irec-duster/RORO/README.md

# Project RORO

RORO is the rocket project of the swiss team DUSTER participating at the 2017 IREC rocket competition.
