irec-duster/RORO/payload/Notes/notes.txt

CBRK_AIRSPD_CHK set to max value (not to look for airspeed)
CBRK_USB_CHK set to max value
CBRK_IO_SAFETY set to max value to disable the safety switch for arming

Building the JSBSIM xml model of the plane

http://jsbsim.sourceforge.net/aeromatic2.html

Carbon Fibre lamination test

1) Sample 1 - soacking 4 times with absorber sheet
Initial conditions:

After lamination:

2) Sample 2 - soaking 2 times with absorber sheet

Initial Conditions
layer 0.3
perimeter 2
top 3
bottom 3
inflill 10%
weight 25.6 g

After lamination
