irec-duster/RORO/iac-paper/abbr.tex

\newglossaryentry{COTS}{%
name={COTS},%
description={Commercial Off The Shelf}%
}
\newglossaryentry{IREC}{%
name={IREC},%
description={Intercollegiate Rocket Competition}%
}
\newglossaryentry{UWB}{%
name={UWB},%
description={Ultrawide Band}%
}

\newglossaryentry{FEM}{%
name={FEM},%
description={Finite Element Method}%
}

\newglossaryentry{CNC}{%
name={CNC},%
description={Computer Numerical Control}%
}

\newglossaryentry{AGL}{%
name={AGL},%
description={Above Ground Level}%
}

\newglossaryentry{IB}{%
name={IB},%
description={Interface Board }%
}

\newglossaryentry{PB}{%
name={PB},%
description={Power Board}%
}
\newglossaryentry{SAW}{%
name={SAW},%
description={Surface Acoustic Waves }%
}
\newglossaryentry{AD}{%
name={AD},%
description={Avionic Drawer }%
}

\newglossaryentry{AR}{%
name={AR},%
description={Avionic Rack }%
}

\newglossaryentry{GNSS}{%
name={GNSS},%
description={Global Navigation Satellite System}%
}
\newglossaryentry{RTK}{%
name={RTK},%
description={Real Time Kinematic }%
}
\newglossaryentry{IMU}{%
name={IMU},%
description={Inertial Measurement Unit }%
}
