irec-duster/RORO/Avionics_RORO/RORO_Avionics_PCB_.docx

Interface board 3: lost capacitor C23 (automotive grade with conductive epoxy).

/!\ It seems that all the capacitor of this type are not well soldered. So one should replace them!!!
