irec-duster/RORO/Avionics_RORO/Altium/Project/Rocket_PCB_Project_2017/Project Outputs for Rocket_PCB_Project_2017/Rocket_PCB_panelized/Interface_board_Board Stack Report.pdf

Layer | Board Layer Stack | Name | Material | Thickness

# Board Stack Report

Stack Up | Layer Stack

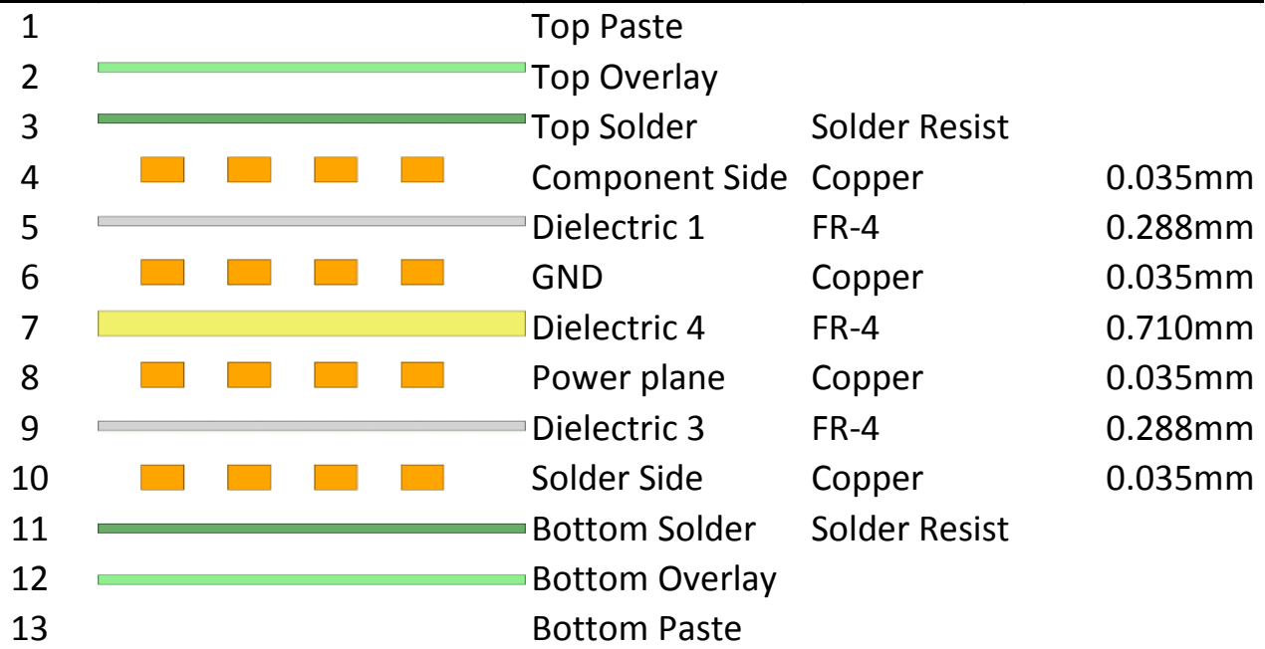
[picture p22: figure]
Top Paste; Top Overlay; Top Solder; Solder Resist; Component Side Copper; Dielectric 1; GND; Copper; Dielectric 4; Power plane; Dielectric 3; Solder Side; Bottom Solder; Bottom Overlay; Bottom Paste
