irec-duster/RORO/Avionics_RORO/Altium/Project/Rocket_PCB_Project_2017_Power_board/Project Outputs for Rocket_PCB_Project_2017_Power_board/Report Board Stack/Power_board.xls

Board Stack Report
Stack Up |  | Layer Stack
Layer | Board Layer Stack | Name | Material | Thickness | Constant
1 |  | Top Paste
2 |  | Top Overlay
3 |  | Top Solder | Solder Resist | 0.010mm | 3.5
4 |  | Component Side | Copper | 0.036mm
5 |  | Dielectric 1 | FR-4 | 0.200mm | 4.5
6 |  | GND | Copper | 0.018mm
7 |  | Dielectric 2 |  | 1.100mm | 4.5
8 |  | Power plane | Copper | 0.018mm
9 |  | Dielectric 3 | FR-4 | 0.200mm | 4.5
10 |  | Solder Side | Copper | 0.036mm
11 |  | Bottom Solder | Solder Resist | 0.010mm | 3.5
12 |  | Bottom Overlay
13 |  | Bottom Paste
 | Height : 1.626mm
