irec-duster/RORO/Avionics_RORO/TI simulation/export altium/Altium/2017-01-30_01-57-51/readme.txt

 

**********************************************************
*************  Important Instructions Follow  ************
**********************************************************
 
All files exported to: Z:\\48\\75\\4875907\\6\Altium\2017-01-30_01-57-51\2017-01-30_01-57-51

**********************************************************
***************** Schematic Instructions  ****************
**********************************************************

To import your new Schematic into Altium:

1. Unzip the downloaded folder files to a local directory and
Start the Altium program.
2. From the menu select "File"->"Open".
3. Select the file named in the path above ending with ".schdoc"
and "Open" the file.
4. Your Schematic should be viewable within Altium now.

For additional information, please visit this site:
http://www.accelerated-designs.com/help/Altium_BrdSch_import.html

**********************************************************
*******************  PCB Instructions  *******************
**********************************************************

To import your new BOARD into Altium:

1. Unzip the downloaded folder files to a local directory
	and Start the Altium program.
2. From the menu select "File"->"Open".
3. Select the file named in the path above ending with ".pcbdoc"
and "Open" the file.
4. Planes will need to be repoured to update the Copper Pour Polygons
	a. Once your board is loaded, select the Tools menu from the
	   top Menu Bar
	b. Scroll to the Polygon Pours item on the Tools Menu.
	c. The Polygon Pours item should expand to show more options
	d. Select Repour All Polygons, this will repour all of the
	   polygons.
5. Your board should be viewable within Altium now.

For additional information, please visit this site:
http://www.accelerated-designs.com/help/Altium_BrdSch_import.html

**********************************************************
*******************  LIB Instructions  *******************
**********************************************************

To import your new LIBRARY PARTS into Altium follow these steps:

1. After running the Ultra Librarian export for the first time,
you will need to copy the following files into an area where
they can be accessed for all future translations.  They are script
files that Altium will need to be able to find.
	a. UL_Form.dfm
	b. UL_Form.pas
	c. UL_Import.pas
	d. UL_Import.prjScr
2. The above script file will need to be run from within Altium.
This can be done by going to File, Open and selecting the
UL_Import.PrjScr file stored above.
3. Select the "DXP" dropdown menu in the top-left corner runfrom
the drop down menu and select "Run Script". Select "UL_Form.pas"
and click "OK"
4. When the script is run, it will ask you for the file name of the
Ultra Librarian file to run. Click "File...", select the latest file
produced with a date code (for instance 2010-02-17_23-12-34.txt), and
click "Start Import".
5. The script will open a new Integraged Library project and import
the Ultra Librarian data into it.  When complete a message box
will pop up saying that import is done.

For additional information, please visit this site:
http://www.accelerated-designs.com/help/Altium_import.html

For a video tutorial, please visit:
http://youtu.be/pih50yx9HYU

**********************************************************
**********************************************************
**********************************************************

Symbol "WB_PWL_CURRENT_LOAD" renamed to "WB_PWL_CURRENT_L"
Symbol "WB_PWL_VOLTAGE_SOURCE" renamed to "WB_PWL_VOLTAGE_S"
Symbol "WB_SOURCE_RESISTOR" renamed to "WB_SOURCE_RESIST"
Symbol "WB_PRIM_PWL_VOLTAGE_SOURCE" renamed to "WB_PRIM_PWL_VOLT"
Symbol "WB_PRIMITIVE_BATTERY" renamed to "WB_PRIMITIVE_BAT"
Symbol "WB_DIODE_SCHOTTKY" renamed to "WB_DIODE_SCHOTTK"
Symbol "WB_PRIM_AC_VOLTAGE_SOURCE" renamed to "WB_PRIM_AC_VOLTA"
Symbol "WB_SYNC_CAPACITOR" renamed to "WB_SYNC_CAPACITO"
Symbol "WB_PRIMITIVE_INDUCTOR" renamed to "WB_PRIMITIVE_IND"
Symbol "WB_PRIM_STARTUP_VOLTAGE_SOURCE" renamed to "WB_PRIM_STARTUP_"
Symbol "WB_STARTUP_VOLTAGE_SOURCE" renamed to "WB_STARTUP_VOLTA"
Component "CC0805KRX7R9BB103" renamed to "CC0805KRX7R9BB10"
Component "CL21C561JBANFNC" renamed to "CL21C561JBANFNC"
Component "CC0805JRNPO9BN820" renamed to "CC0805JRNPO9BN82"
Component "WB_CURRENT_LOAD" renamed to "WB_CURRENT_LOAD"
Component "08053C104KAT2A" renamed to "08053C104KAT2A"
Component "C3216X5R1E476M160AC" renamed to "C3216X5R1E476M16"
Component "EMK212B7105KG-T" renamed to "EMK212B7105KG-T"
Component "CDBK0520L" renamed to "CDBK0520L"
Component "WB_GND" renamed to "WB_GND"
Component "IHLP6767DZER3R3M11" renamed to "IHLP6767DZER3R3M"
Component "RJK0330DPB" renamed to "RJK0330DPB"
Component "PSMN4R0-40YS" renamed to "PSMN4R0-40YS"
Component "ERJ-6ENF1742V" renamed to "ERJ-6ENF1742V"
Component "ERJ-6ENF1004V" renamed to "ERJ-6ENF1004V"
Component "ERJ-6ENF1131V" renamed to "ERJ-6ENF1131V"
Component "RT0805BRD073K52L" renamed to "RT0805BRD073K52L"
Component "CSNL1206FT3L00" renamed to "CSNL1206FT3L00"
Component "ERJ-6ENF6191V" renamed to "ERJ-6ENF6191V"
Component "ERJ-6ENF1872V" renamed to "ERJ-6ENF1872V"
Component "LM25116MHX/NOPB" renamed to "LM25116MHX/NOPB"
Component "WB_BATTERY" renamed to "WB_BATTERY"
Component "GRM31CR60J107ME39L" renamed to "GRM31CR60J107ME3"
The Symbol WB_CONTINUATION was missing a RefDes attribute, a refdes was created for the symbol.
The Symbol WB_CONTINUATION was missing a Type attribute, a type was created for the symbol.
The Symbol WB_CONTINUATION was missing a Value attribute, a value was created for the symbol.
The Symbol WB_CURRENT_PROBE was missing a RefDes attribute, a refdes was created for the symbol.
The Symbol WB_CURRENT_PROBE was missing a Type attribute, a type was created for the symbol.
The Symbol WB_CURRENT_PROBE was missing a Value attribute, a value was created for the symbol.
The Symbol WB_PWL_CURRENT_L was missing a RefDes attribute, a refdes was created for the symbol.
The Symbol WB_PWL_CURRENT_L was missing a Type attribute, a type was created for the symbol.
The Symbol WB_PWL_CURRENT_L was missing a Value attribute, a value was created for the symbol.
The Symbol WB_BLOCK_IO was missing a RefDes attribute, a refdes was created for the symbol.
The Symbol WB_BLOCK_IO was missing a Type attribute, a type was created for the symbol.
The Symbol WB_BLOCK_IO was missing a Value attribute, a value was created for the symbol.
The Symbol WB_PWL_VOLTAGE_S was missing a RefDes attribute, a refdes was created for the symbol.
The Symbol WB_PWL_VOLTAGE_S was missing a Type attribute, a type was created for the symbol.
The Symbol WB_PWL_VOLTAGE_S was missing a Value attribute, a value was created for the symbol.
The Symbol WB_SOURCE_RESIST was missing a RefDes attribute, a refdes was created for the symbol.
The Symbol WB_SOURCE_RESIST was missing a Type attribute, a type was created for the symbol.
The Symbol WB_SOURCE_RESIST was missing a Value attribute, a value was created for the symbol.
The Symbol WB_PRIM_PWL_VOLT was missing a RefDes attribute, a refdes was created for the symbol.
The Symbol WB_PRIM_PWL_VOLT was missing a Type attribute, a type was created for the symbol.
The Symbol WB_PRIM_PWL_VOLT was missing a Value attribute, a value was created for the symbol.
The Symbol WB_PRIMITIVE_BAT was missing a RefDes attribute, a refdes was created for the symbol.
The Symbol WB_PRIMITIVE_BAT was missing a Type attribute, a type was created for the symbol.
The Symbol WB_PRIMITIVE_BAT was missing a Value attribute, a value was created for the symbol.
The Symbol WB_CAP_POLARIZED was missing a RefDes attribute, a refdes was created for the symbol.
The Symbol WB_CAP_POLARIZED was missing a Type attribute, a type was created for the symbol.
The Symbol WB_CAP_POLARIZED was missing a Value attribute, a value was created for the symbol.
The Symbol WB_N_MOSFET was missing a RefDes attribute, a refdes was created for the symbol.
The Symbol WB_N_MOSFET was missing a Type attribute, a type was created for the symbol.
The Symbol WB_N_MOSFET was missing a Value attribute, a value was created for the symbol.
The Symbol WB_LM25116 was missing a RefDes attribute, a refdes was created for the symbol.
The Symbol WB_LM25116 was missing a Type attribute, a type was created for the symbol.
The Symbol WB_LM25116 was missing a Value attribute, a value was created for the symbol.
The Symbol WB_PRIM_AC_VOLTA was missing a RefDes attribute, a refdes was created for the symbol.
The Symbol WB_PRIM_AC_VOLTA was missing a Type attribute, a type was created for the symbol.
The Symbol WB_PRIM_AC_VOLTA was missing a Value attribute, a value was created for the symbol.
The Symbol WB_SYNC_CAPACITO was missing a RefDes attribute, a refdes was created for the symbol.
The Symbol WB_SYNC_CAPACITO was missing a Type attribute, a type was created for the symbol.
The Symbol WB_SYNC_CAPACITO was missing a Value attribute, a value was created for the symbol.
The Symbol WB_PRIMITIVE_IND was missing a RefDes attribute, a refdes was created for the symbol.
The Symbol WB_PRIMITIVE_IND was missing a Type attribute, a type was created for the symbol.
The Symbol WB_PRIMITIVE_IND was missing a Value attribute, a value was created for the symbol.
The Symbol WB_VOLTAGE_PROBE was missing a RefDes attribute, a refdes was created for the symbol.
The Symbol WB_VOLTAGE_PROBE was missing a Type attribute, a type was created for the symbol.
The Symbol WB_VOLTAGE_PROBE was missing a Value attribute, a value was created for the symbol.
The Symbol WB_PRIM_STARTUP_ was missing a RefDes attribute, a refdes was created for the symbol.
The Symbol WB_PRIM_STARTUP_ was missing a Type attribute, a type was created for the symbol.
The Symbol WB_PRIM_STARTUP_ was missing a Value attribute, a value was created for the symbol.
The Symbol WB_STARTUP_VOLTA was missing a RefDes attribute, a refdes was created for the symbol.
The Symbol WB_STARTUP_VOLTA was missing a Type attribute, a type was created for the symbol.
The Symbol WB_STARTUP_VOLTA was missing a Value attribute, a value was created for the symbol.
The Symbol WB_LOAD_RESISTOR was missing a RefDes attribute, a refdes was created for the symbol.
The Symbol WB_LOAD_RESISTOR was missing a Type attribute, a type was created for the symbol.
The Symbol WB_LOAD_RESISTOR was missing a Value attribute, a value was created for the symbol.

Ultra Librarian Gold 8.1.204 Process Report

Message - Component "CC0805KRX7R9BB10" attribute "Cap" references text style "" that is not in the database.
The default pattern text style "H50s3" was substituted.
Message - Component "CC0805KRX7R9BB10" attribute "ESR" references text style "" that is not in the database.
The default pattern text style "H50s3" was substituted.
Message - Component "CC0805KRX7R9BB10" attribute "IRMS" references text style "" that is not in the database.
The default pattern text style "H50s3" was substituted.
Message - Component "CC0805KRX7R9BB10" attribute "VDC" references text style "" that is not in the database.
The default pattern text style "H50s3" was substituted.
Message - Component "CL21C561JBANFNC" attribute "Datasheet URL" references text style "" that is not in the database.
The default pattern text style "H50s3" was substituted.
Message - Component "CL21C561JBANFNC" attribute "Cap" references text style "" that is not in the database.
The default pattern text style "H50s3" was substituted.
Message - Component "CL21C561JBANFNC" attribute "ESR" references text style "" that is not in the database.
The default pattern text style "H50s3" was substituted.
Message - Component "CL21C561JBANFNC" attribute "IRMS" references text style "" that is not in the database.
The default pattern text style "H50s3" was substituted.
Message - Component "CL21C561JBANFNC" attribute "VDC" references text style "" that is not in the database.
The default pattern text style "H50s3" was substituted.
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
The default pattern text style "H50s3" was substituted.
Message - Component "GRM31CR60J107ME3" attribute "ESR" references text style "" that is not in the database.
The default pattern text style "H50s3" was substituted.
Message - Component "GRM31CR60J107ME3" attribute "IRMS" references text style "" that is not in the database.
The default pattern text style "H50s3" was substituted.
Message - Component "GRM31CR60J107ME3" attribute "VDC" references text style "" that is not in the database.
The default pattern text style "H50s3" was substituted.

TextStyle count:  24
Padstack count:   10
Pattern count:    7
Symbol count:     28
Component count:  22

Export

Footprint "0805" has no layer data mapped and will be skipped.
Component "CC0805KRX7R9BB10" requires footprint "0805" and will be skipped.
Component "CL21C561JBANFNC" requires footprint "0805" and will be skipped.
Component "CC0805JRNPO9BN82" requires footprint "0805" and will be skipped.
Component "08053C104KAT2A" requires footprint "0805" and will be skipped.
Component "EMK212B7105KG-T" requires footprint "0805" and will be skipped.
Component "ERJ-6ENF1742V" requires footprint "0805" and will be skipped.
Component "ERJ-6ENF1004V" requires footprint "0805" and will be skipped.
Component "ERJ-6ENF1131V" requires footprint "0805" and will be skipped.
Component "RT0805BRD073K52L" requires footprint "0805" and will be skipped.
Component "ERJ-6ENF6191V" requires footprint "0805" and will be skipped.
Component "ERJ-6ENF1872V" requires footprint "0805" and will be skipped.
Warning: Symbol "WB_CAPACITOR" attribute "TOL" references missing text style ""
Warning: Symbol "WB_CAPACITOR" attribute "VAL" references missing text style ""
Warning: Symbol "WB_CAPACITOR" attribute "DEV" references missing text style ""
Warning: Symbol "WB_CAPACITOR" attribute "PN" references missing text style ""
Warning: Symbol "WB_CAPACITOR" attribute "RefDes2" references missing text style ""
Warning: Symbol "WB_CAPACITOR" attribute "Cap" references missing text style ""
Warning: Symbol "WB_CAPACITOR" attribute "ESR" references missing text style ""
Warning: Symbol "WB_CAPACITOR" attribute "IRMS" references missing text style ""
Warning: Symbol "WB_CAPACITOR" attribute "VDC" references missing text style ""
Warning: Symbol "WB_DIODE_SCHOTTK" attribute "Io" references missing text style ""
Warning: Symbol "WB_DIODE_SCHOTTK" attribute "VRRM" references missing text style ""
Warning: Symbol "WB_DIODE_SCHOTTK" attribute "VFatIo" references missing text style ""
Warning: Symbol "WB_DIODE_SCHOTTK" attribute "TOL" references missing text style ""
Warning: Symbol "WB_DIODE_SCHOTTK" attribute "VAL" references missing text style ""
Warning: Symbol "WB_DIODE_SCHOTTK" attribute "DEV" references missing text style ""
Warning: Symbol "WB_DIODE_SCHOTTK" attribute "PN" references missing text style ""
Warning: Symbol "WB_INDUCTOR" attribute "L" references missing text style ""
Warning: Symbol "WB_INDUCTOR" attribute "DCR" references missing text style ""
Warning: Symbol "WB_INDUCTOR" attribute "IDC" references missing text style ""
Warning: Symbol "WB_INDUCTOR" attribute "PN" references missing text style ""
Warning: Symbol "WB_INDUCTOR" attribute "DEV" references missing text style ""
Warning: Symbol "WB_INDUCTOR" attribute "VAL" references missing text style ""
Warning: Symbol "WB_INDUCTOR" attribute "TOL" references missing text style ""
Warning: Symbol "WB_INDUCTOR" attribute "RefDes2" references missing text style ""
Warning: Symbol "RJK0330DPB" attribute "PN" references missing text style ""
Warning: Symbol "RJK0330DPB" attribute "DEV" references missing text style ""
Warning: Symbol "RJK0330DPB" attribute "VAL" references missing text style ""
Warning: Symbol "RJK0330DPB" attribute "TOL" references missing text style ""
Warning: Symbol "RJK0330DPB" attribute "RefDes2" references missing text style ""
Warning: Symbol "PSMN4R0-40YS" attribute "PN" references missing text style ""
Warning: Symbol "PSMN4R0-40YS" attribute "DEV" references missing text style ""
Warning: Symbol "PSMN4R0-40YS" attribute "VAL" references missing text style ""
Warning: Symbol "PSMN4R0-40YS" attribute "TOL" references missing text style ""
Warning: Symbol "PSMN4R0-40YS" attribute "RefDes2" references missing text style ""
Warning: Symbol "WB_RESISTOR" attribute "Resistance" references missing text style ""
Warning: Symbol "WB_RESISTOR" attribute "Power" references missing text style ""
Warning: Symbol "WB_RESISTOR" attribute "Tolerance" references missing text style ""
Warning: Symbol "WB_RESISTOR" attribute "TOL" references missing text style ""
Warning: Symbol "WB_RESISTOR" attribute "VAL" references missing text style ""
Warning: Symbol "WB_RESISTOR" attribute "DEV" references missing text style ""
Warning: Symbol "WB_RESISTOR" attribute "PN" references missing text style ""
Warning: Symbol "WB_RESISTOR" attribute "RefDes2" references missing text style ""
Warning: Symbol "LM25116MHX" attribute "PN" references missing text style ""
Warning: Symbol "LM25116MHX" attribute "DEV" references missing text style ""
Warning: Symbol "LM25116MHX" attribute "VAL" references missing text style ""
Warning: Symbol "LM25116MHX" attribute "TOL" references missing text style ""
Warning: Symbol "LM25116MHX" attribute "RefDes2" references missing text style ""
Warning: Symbol "WB_CAPACITOR" attribute "Cap" references missing text style ""
Warning: Symbol "WB_CAPACITOR" attribute "ESR" references missing text style ""
Warning: Symbol "WB_CAPACITOR" attribute "IRMS" references missing text style ""
Warning: Symbol "WB_CAPACITOR" attribute "VDC" references missing text style ""
Warning: Symbol "WB_CAPACITOR" attribute "PN" references missing text style ""
Warning: Symbol "WB_CAPACITOR" attribute "DEV" references missing text style ""
Warning: Symbol "WB_CAPACITOR" attribute "VAL" references missing text style ""
Warning: Symbol "WB_CAPACITOR" attribute "TOL" references missing text style ""
Warning: Symbol "WB_CAPACITOR" attribute "RefDes2" references missing text style ""
