irec-duster/RORO/iac-paper/main.tex

\documentclass[]{iac}
\usepackage[strings]{underscore}
\usepackage{bm} % used for bold math symbols
\usepackage{enumitem}
\usepackage{glossaries}

\DeclareMathOperator{\E}{E}
\DeclareMathOperator{\prob}{p}
\DeclareMathOperator{\tr}{tr}

\newcommand{\etalia}{\textit{et al.}}
\newcommand*{\vectornorm}[1]{\left\|#1\right\|}
\newcommand*\rfrac[2]{{{}^{#1}\!/_{#2}}} % running fraction with slash - requires math mode.
\newcommand*\T{\mathsf{T}}

\makeglossaries

\input{abbr.tex}

\glsaddall

\begin{document}

\IACpaperyear{17}
\IACpapernumber{E2.3}
\IACconference{67}
\IAClocation{Adelaide, Australia}
\IACcopyrightA{2017}{the authors}

\title{Technology demonstrator of a rocket carrying a deployable fleet of autonomous gliders}

%\author{Main~Author\\Affiliation, Country, email address\and
%		Co-Author\\Affiliation, Country, email address}
\IACauthor{Patrick Spieler}{Swiss Federal Institute of Technology, Lausanne, Switzerland, patrick.spieler@alumni.epfl.ch}

\IACauthor{Elena Sorina Lupu, Dalmir Hasic, Michael Spieler, Michael Pellet, Hassan Arif, Cyril Baumann, Quentin Talon, Emilio Lozano}{Swiss Federal Institute of Technology, Lausanne, Switzerland}

\IACauthor{Oliver Kirchhoff, Laurent Jung}{Swiss Federal Institute of Technology, Zurich, Switzerland}

\IACauthor{Stephane Teste}{John Hopkins University, United States of America}

\IACauthor{Christian Cardinaux}{Western Switzerland University of Applied Sciences - HEIG-VD, Switzerland}

\IACauthor{Dr. Anton Ivanov, Prof. Dario Floreano, Dr. Stefano Mintchev}{Swiss Federal Institute of Technology, Lausanne, Switzerland}

\abstract{%Rewrite: Dalmir, Sorina
%NOTE: Many of the structure of paper goes to the end of introduction
%The Intercollegiate Rocket Competition (IREC) aims to gather students from across the world to design and build a rocket that reaches an altitude of 3km or 10km, carrying a 4kg of payload. As part of this competition, the Team Duster, formed by students from Swiss universities developed a rocket with a payload targeting an apogee of 3km. \\ 
%Firstly, the rocket flying to 3km will be presented, along with its design and manufacturing processes. The rocket then follows a dual-event recovery process. Firstly, the drogue (small) parachute is deployed, reducing the speed of the rocket to about 30 m/s. At the same time the separation of the nosecone occurs thereby releasing the payload. After the rocket descends to an altitude of 457 meters, the second (main) parachute is deployed, reducing the speed to 6m/s. Throughout the launch, separation, and landing phases, we constantly received telemetry (information) provided by the custom-designed avionic components placed in the nosecone of the rocket. To ensure that the deployment occurs at predefined altitudes, the decision was made to use 2 redundant systems for altitude measurement -independent of the avionics placed in the recovery bay. The trajectory of the rocket was simulated in 3 varying environments, including our own developed simulator. The rocket made its first flight towards the end of March 2017 in Switzerland where its flight data was compared with the simulation data. Based on this data, the necessary trajectory corrections were performed in order to improve the competition Flight - which occured in mid-June. \\
%Secondly, an innovative payload that flew in the rocket will also be presented. A fleet of 3 gliders are deployed from the rocket at apogee using a release based on a spring mechanism. Equipped with an autopilot, differential GPS, and control surfaces using servomotors, the gliders autonomously fly in formation. Eventually, they land at a fixed point on the ground. The gliders have. During the flight, the gliders transmit information back to the groundstation and are tracked using custom-made ground station.  Potential video-recording of the flight will be investigated in the future.
%The results of the intermediary flight (end-of-March) as well as the competition flight - both in terms of rocket trajectory and flight of the gliders - is included in the paper, along with further recommendations for a more advanced technology demonstration in the future.

The Intercollegiate Rocket Competition (IREC) gathers students across the world to design and build a rocket that reaches an altitude of 10,000 ft (approximately 3 km) or 30,000 ft (approximately 9 km). The rocket needs to carry 8.8 lb (4 kg) of payload. As a part of this competition, team DUSTER, formed by students from three Swiss universities designed and built a rocket targeting an apogee of 3 km. The rocket's propulsion system is a Commercial-Off-The-Shelve solid motor. 
Custom avionics inside the rocket nosecone log and transmit telemetry back to the ground, control the ejection of the nosecone and the payload deployment.
A payload is placed in the rocket. This payload consists of an autonomous glider that is ejected at apogee.
The technology behind both the rocket and the payload, together with concepts for this year's glider and future autonomous fleet of gliders, are presented in this paper. The design process and manufacturing, along with tests done and issues faced over the course of the project are also outlined along with the solutions and recommendations for future iterations.
}

% Dalmir, can you add the abreviations? 
\maketitle
%Check for number of pages allowed, if any
\section{Introduction}

%Spaceport America Cup (formerly entitled Intercollegiate Rocket Competition (IREC)) gatheres students all over the world to participate at the biggest rocket challenge. Students are launching solid, liquid, and hybrid rockets to target altitudes of 10,000 feet (3048 meters) and 30,000 feet (9144 meters), carrying 8,8lb (3.9 kg) of payload.

%Team DUSTER, representing several Swiss universities, entered this contest to build a solid motor rocket flying to an apogee of 10,000 ft (3048 meters). The project received an honourable place 8$^th$, out of 83 teams.

%This paper contains the work developed by the team of students between November 2016 and June 2017. The first part of the article discusses the rocket design, manufacturing and flight data. The second part of the article reviews the payload placed inside the rocket. For this year, the team built a glider that was deployed at 10,000 ft and flew back to the ground. For the future, the aim is to develop a fleet of gliders that is deployed from the rocket at apogee and flies in formation back to the ground. As part of this article, the fleet of gliders will be only conceptually discussed.

Spaceport America Cup (formerly entitled Intercollegiate Rocket Competition (IREC)) gathers students from all over the world to participate at one of the biggest rocket competitions in the world. Students are launching solid, liquid, and hybrid rockets to target altitudes of 10,000 feet (3048 meters) and 30,000 feet (9144 meters), carrying 8.8 lb (4 kg) of payload. The teams are scored according to the flight performance on the competition day, technical implementation, the quality of the report and research done as a part of the project.

Team DUSTER, representing several Swiss universities, entered this contest to build a solid motor rocket flying to an apogee of 10,000 ft.
The main objective of the rocket is to achieve an apogee of 10,000 ft as accurately as possible. Deviations from this apogee result in point loss in the flight performance\cite{spaceport} category, as following:
\begin{align}
P = 350 - \frac{350}{2000}*|apogee_{target} - apogee_{actual}|
\end{align}

The rocket is designed to follow a dual-event recovery process. The first event is the rocket separation at apogee, after which the rocket descends rapidly on a drogue parachute. The second event happens at 457 meters, which is the release and opening of the main parachute.
At the apogee, shortly after separation another two other events occur: first the ejection of the nosecone followed by the payload release.

  \begin{figure}[h!]
    \centering
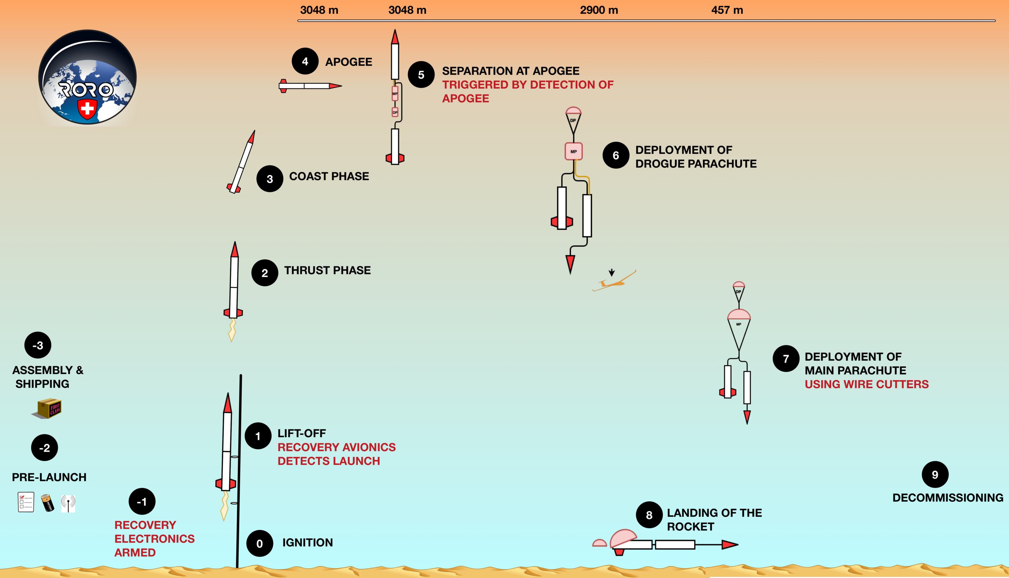
[picture p23: iac-paper/img/conops.jpg]
        
        \caption{Concept of Operations for rocket flight}
        \label{f:conops}
 \end{figure}

In the model flown at this year's competition, no control mechanisms were in place and also no air brakes were installed meaning once the rocket is launched the trajectory cannot be influenced. This increased the importance of simulation, as the only way to determine the altitude the rocket can obtain with a chosen motor and assuming  weather conditions.  The trajectory of the rocket was simulated in 3 varying environments, including our own developed simulator  \cite{sim_hassan}.

% Dalmir, we should cite the simulator of Hassan, here it is the link: https://github.com/irec-duster/RORO/blob/master/simulation/simulator%20docs/IdentificationandControlofaHighPowerRocket-HA.pdf

The second main component of the project is the payload consisting of a glider deployed at apogee. On long-term, our team wants to implement a fleet of gliders deployed from the rocket.

The structure of this paper is as follows: in Section 2 the rocket is presented together with 4 main subsystems: structure, avionics, propulsion and recovery. Section \ref{section:gliders}  covers the design and technology used in a glider and presents a concept of a fleet of gliders. Navigation and control, one of the main challenges in glider design, are briefly discussed in Section \ref{subsection:navcontrol}. The last part (Section \ref{subsection:flightTests}) contains the flight tests of the rocket and the glider. This part is followed by the conclusion and the outlook.

\section{Rocket}

\input{rocket}

\section{Gliders}
\label{section:gliders}

\input{gliders}

\input{result.tex}

\section{Conclusions}
This paper presented a technology necessary to construct a rocket capable of achieving 10,000 ft altitude and land safely on the ground. With the absence of control, the stability of the rocket was guaranteed by the extensive simulations done in 3 different simulators with one being developed by the team for the purpose of this project. The challenges with dynamic stability have also been explored and proper fins sizing done to dampen the oscillations. Throughout the subsystems presented, manufacturing process is also outlined to demonstrate the complete journey from the idea through the conceptual design to actual prototype.

The dual recovery process employed on the presented model composed of two parachutes and redundant electronics is capable of ensuring a safe landing even in presence of electronic faults. Custom made avionics, placed inside the nosecone of the rocket, provided necessary functionalities to control deployment of the payload and to log external parameters. It is designed to support further improvements such as airbrake or control system, possibly to be implemented in the following years.

Second part of the paper presented the glider constructed and placed inside the rocket as a payload. It has been deployed at the apogee with the goal of controlled landing on a fixed location and sending data to the ground station. Concepts for a fleet of autonomous gliders flying in formation and landing on a predefined position were also presented together with challenges in terms of navigation and control. Throughout the project, many tests have been performed on subsystem and system level to ensure compliance with requirements and to validate their functionalities, but due to the conciseness of this paper many results obtained are omitted.

Last but not least, Spaceport America Cup was a success for the Swiss team. The team was ranked 8$^{th}$ out of 83 teams flying rockets and 116 teams initially registered.

\section{Outlook}
The project presented above represents the first iteration and first prototype of both the rocket and the payload. The complete workload from the conceptual design to manufacturing has been done in the span of 7 months. Therefore, many of more advanced concepts which require time and thorough testing could not be implemented on this year's model. Some of those concepts are: implementation of the control system or the more simpler air brake system and the payload modifications to include the fleet of gliders. Even though they weren't implemented, many of these concepts have been researched and prototyped. The concept of the fleet of autonomous gliders has been presented in this paper, but also first iterations of the air brake systems have been developed and tested on one of the smaller models of the rocket. The test of this system was performed in a wind tunnel and subsequently the prototype was launched in Kaltbrunn, Switzerland on May the $20^{th} 2017$. Figure \ref{f:level1_airbrake} shows the smaller, so-called "Level 1" rocket with air brakes in a wind tunnel. 

  \begin{figure}[h!]
 	\centering
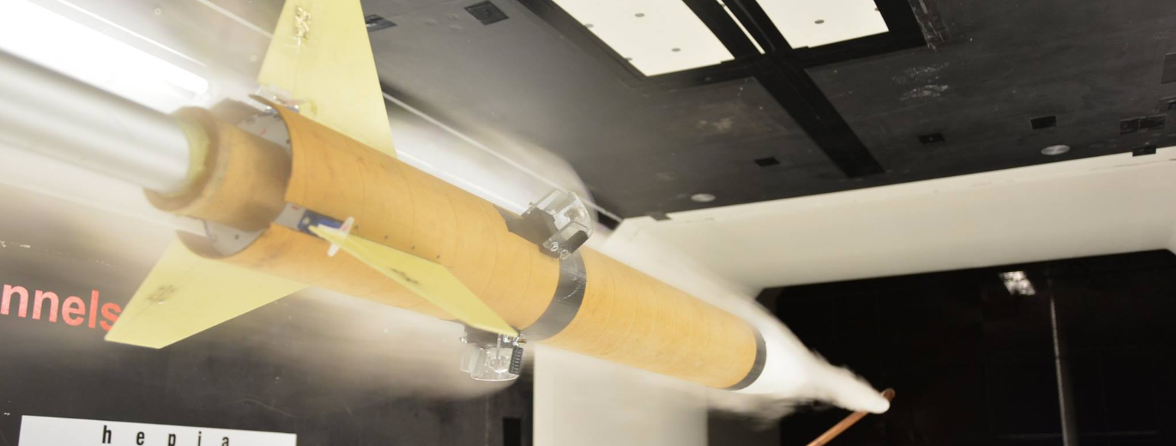
[picture p24: iac-paper/img/level1.png]
        
        \caption{Level 1 Rocket with Air Brakes in HEPIA Wind Tunnel}
        \label{f:level1_airbrake}
 \end{figure}

Following our success, there will be two Swiss teams participating at the competition next year, one from Swiss Federal Institute of Technology Lausanne (EPFL) and one from Swiss Federal Institute of Technology  Zürich (ETHZ).

\printglossary[nonumberlist] 

\bibliographystyle{ieeetr}
\bibliography{main}

\end{document}
