irec-duster/RORO/avionics/41002_GoproHero4.JPG

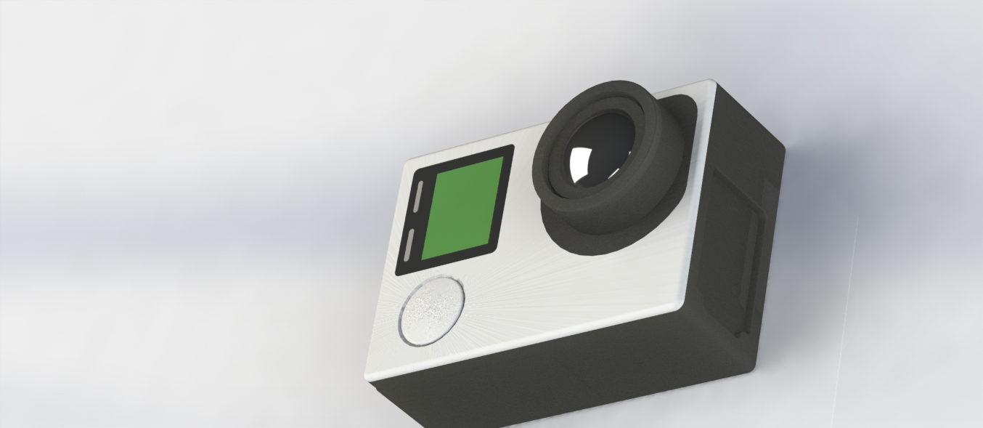
avionics/41002_GoproHero4.JPG
