irec-duster/RORO/flight-data/20170623_roro1_competition_flight/axes-definition.jpg

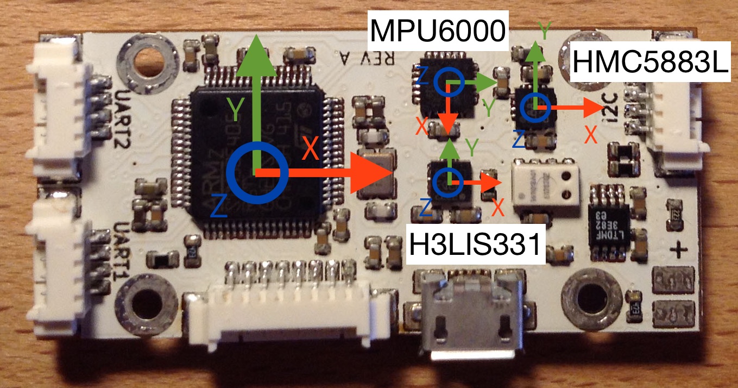
flight-data/20170623_roro1_competition_flight/axes-definition.jpg
