irec-duster/RORO/iac-paper/img/AV_FIG_CAD_lockingsystem_2.jpg

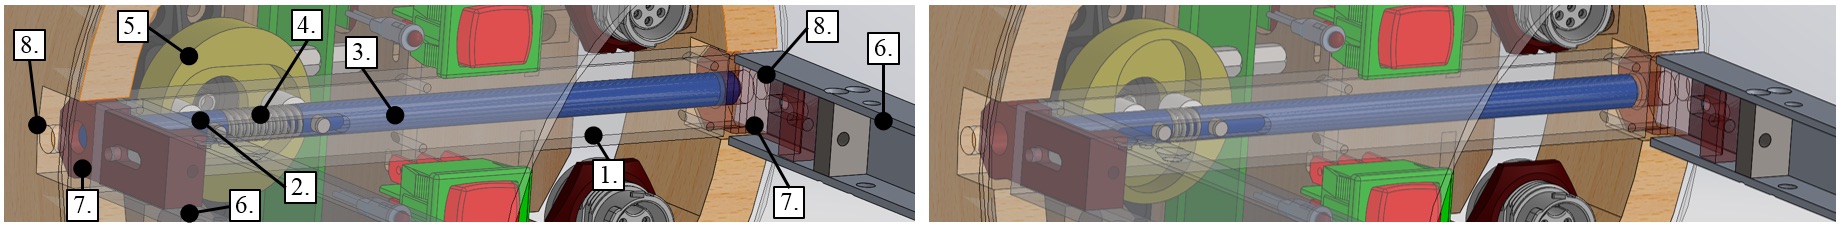
iac-paper/img/AV_FIG_CAD_lockingsystem_2.jpg
