irec-duster/RORO/iac-paper/img/prototype1.png

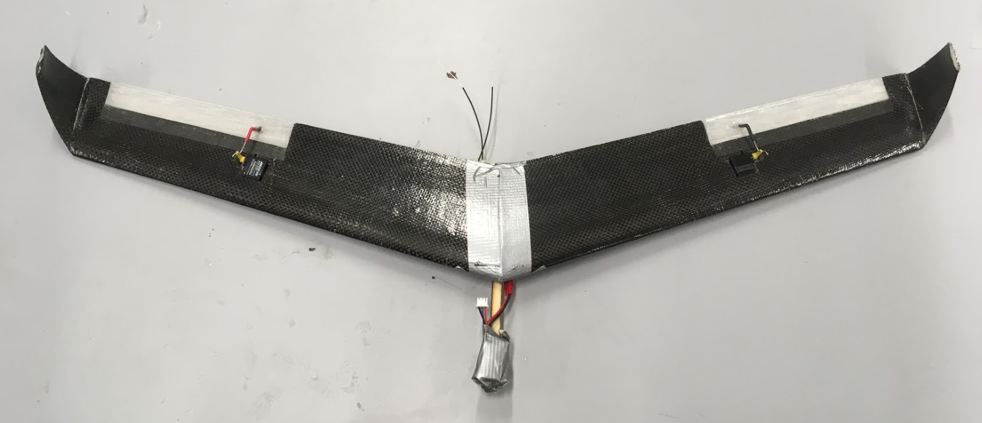
iac-paper/img/prototype1.png
