irec-duster/RORO/iac-paper/img/prototype2.png

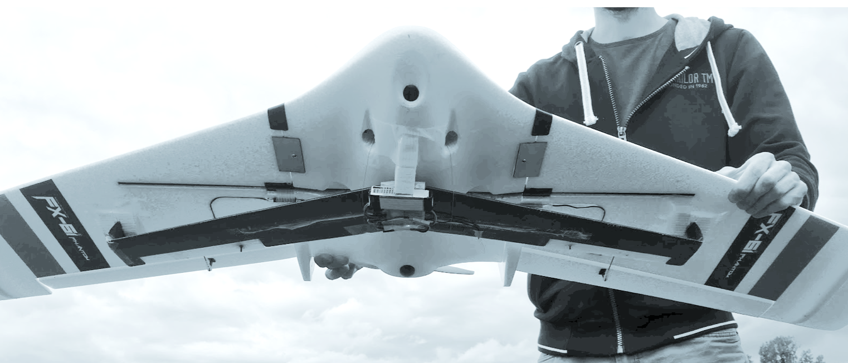
iac-paper/img/prototype2.png
