irec-duster/RORO/iac-paper/img/roro_takeoff_full.jpg

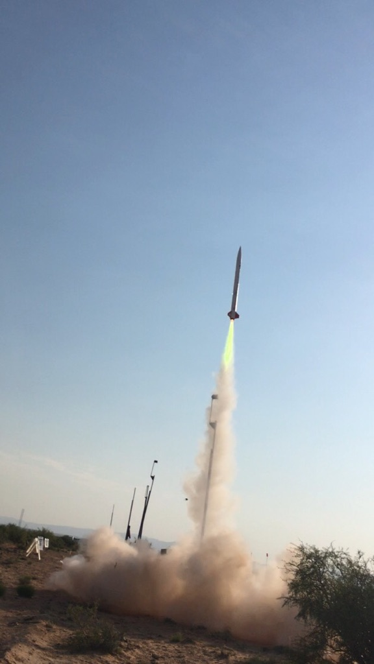
iac-paper/img/roro_takeoff_full.jpg
