irec-duster/RORO/payload/31004_tungsten_balas.PNG

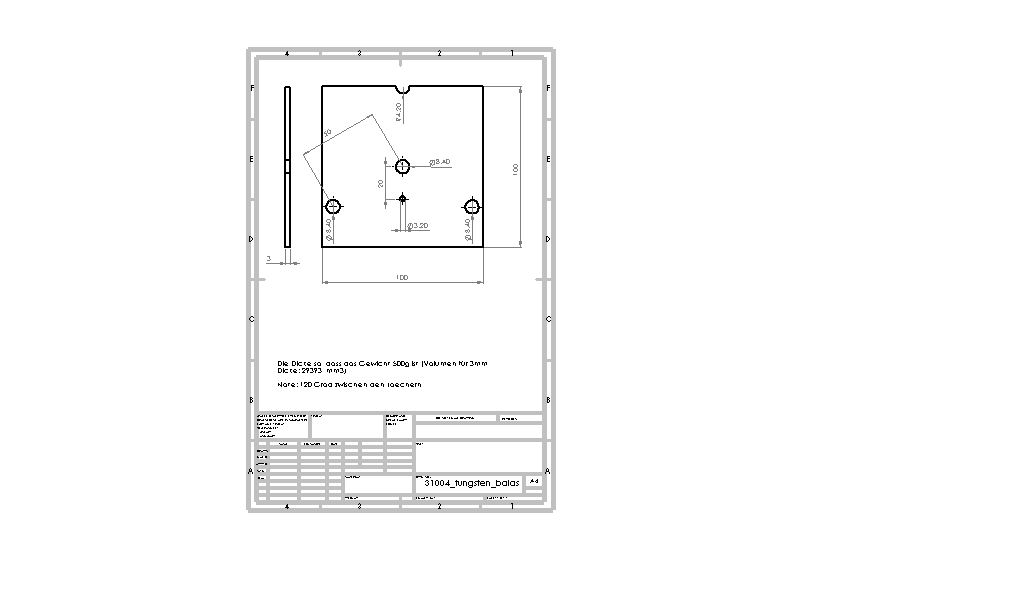
payload/31004_tungsten_balas.PNG
