irec-duster/RORO/payload/Screenshots/ejection_system.PNG

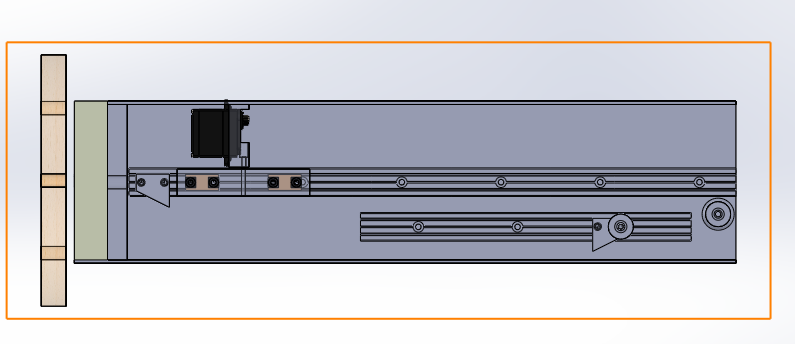
payload/Screenshots/ejection_system.PNG
