irec-duster/RORO/payload/Screenshots/ejectionsystem.png

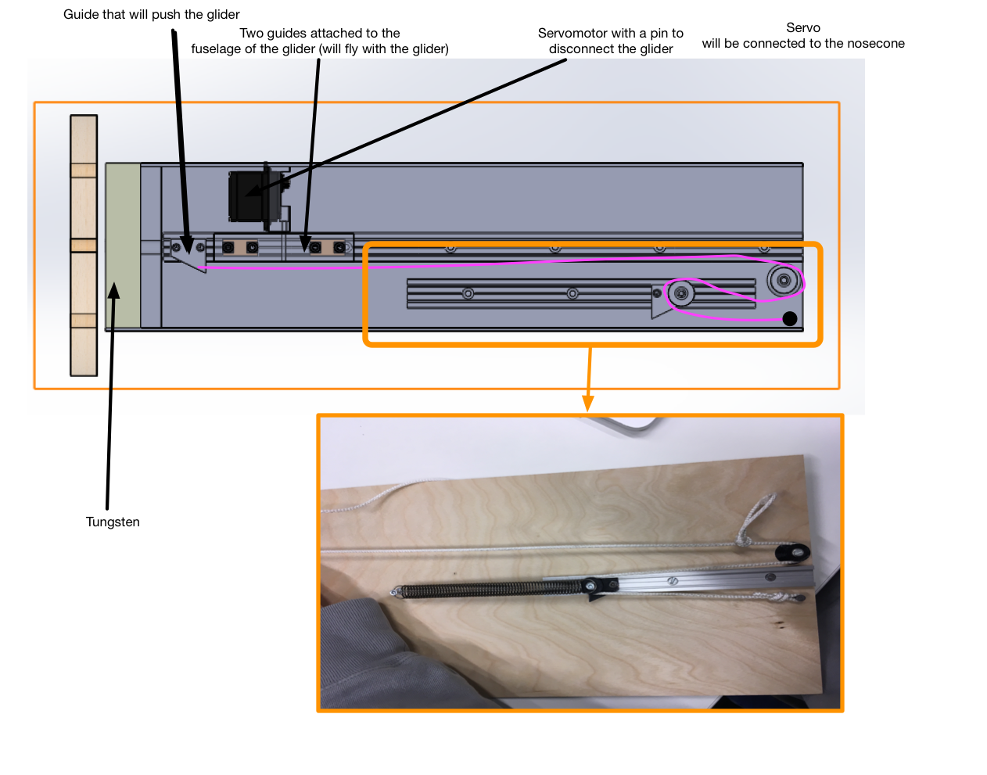
payload/Screenshots/ejectionsystem.png
