irec-duster/RORO/payload/Screenshots/glider.png

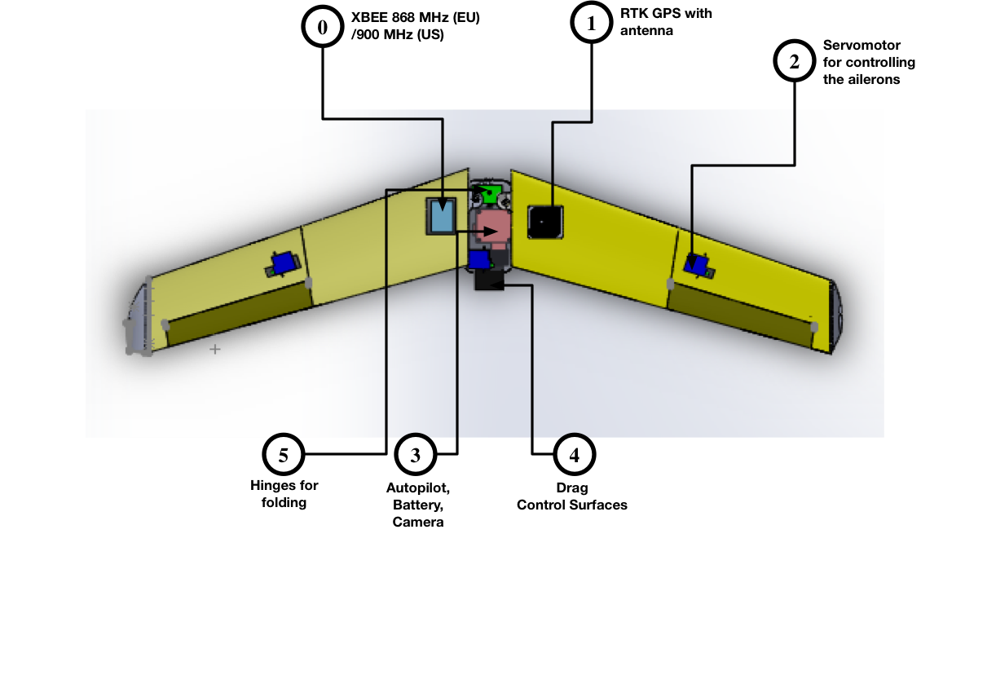
payload/Screenshots/glider.png
