irec-duster/RORO/payload/Screenshots/glider_equations.PNG

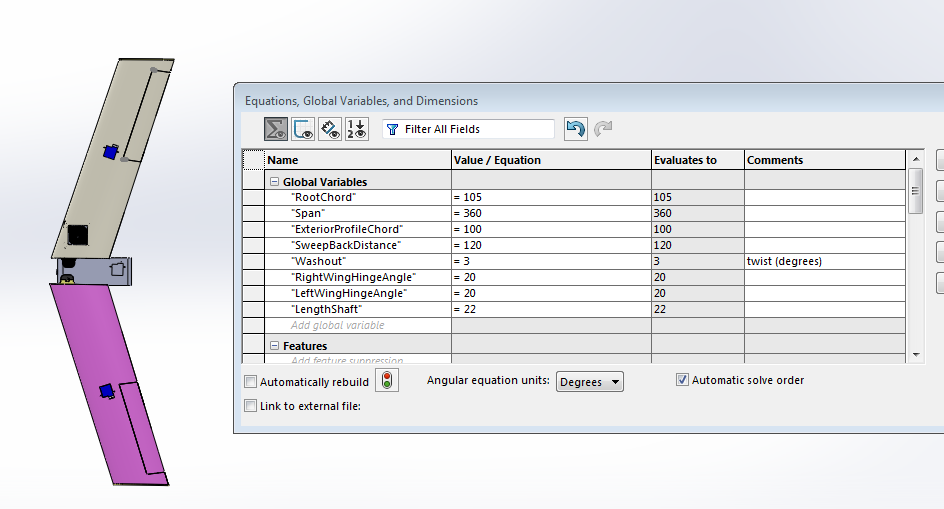
payload/Screenshots/glider_equations.PNG
