irec-duster/RORO/payload/Screenshots/glider_folded.PNG

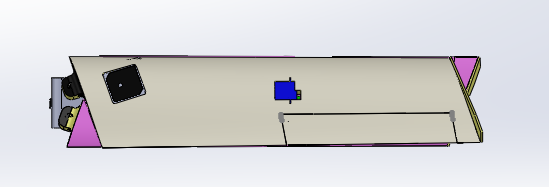
payload/Screenshots/glider_folded.PNG
