irec-duster/RORO/payload/Screenshots/glider_folded_back.PNG

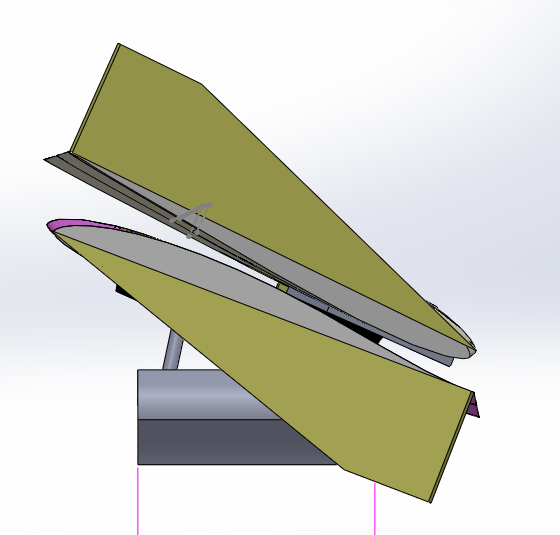
payload/Screenshots/glider_folded_back.PNG
