irec-duster/RORO/payload/Screenshots/glider_folded_lateral.PNG

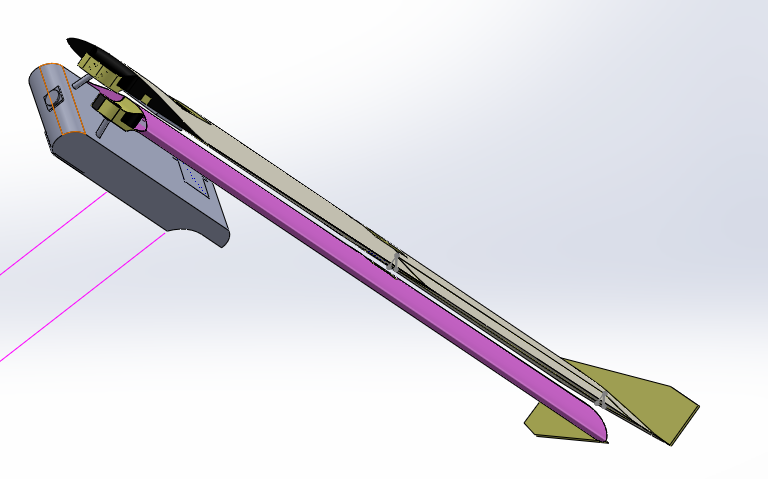
payload/Screenshots/glider_folded_lateral.PNG
