irec-duster/RORO/payload/Screenshots/glider_front_ballbearing_view.PNG

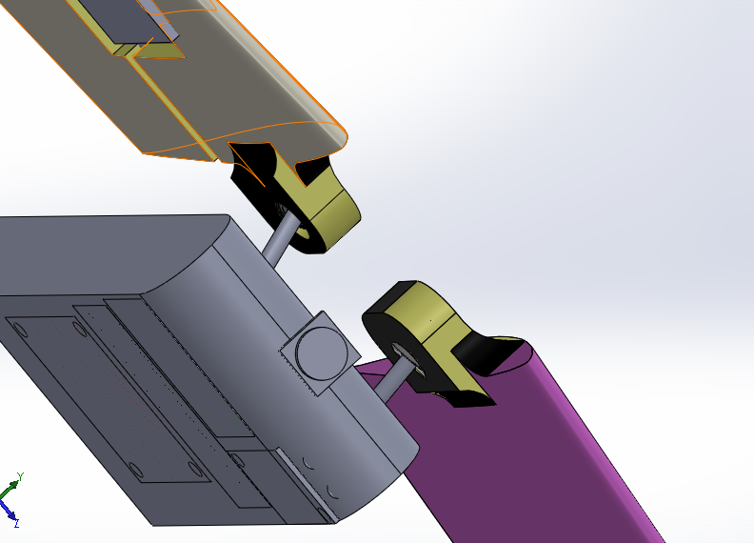
payload/Screenshots/glider_front_ballbearing_view.PNG
