irec-duster/RORO/payload/Screenshots/glider_inside_the_4U_cubesat_standard.PNG

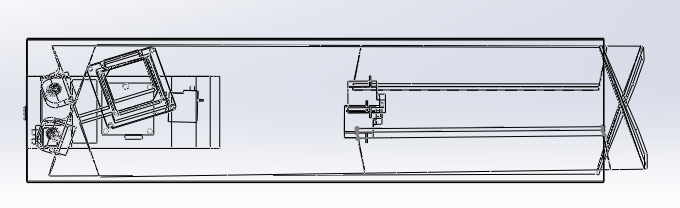
payload/Screenshots/glider_inside_the_4U_cubesat_standard.PNG
