irec-duster/RORO/payload/Screenshots/glider_lateral_view.PNG

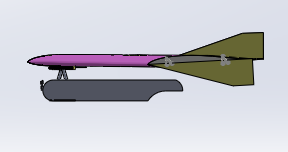
payload/Screenshots/glider_lateral_view.PNG
