irec-duster/RORO/payload/Screenshots/glider_simplified.PNG

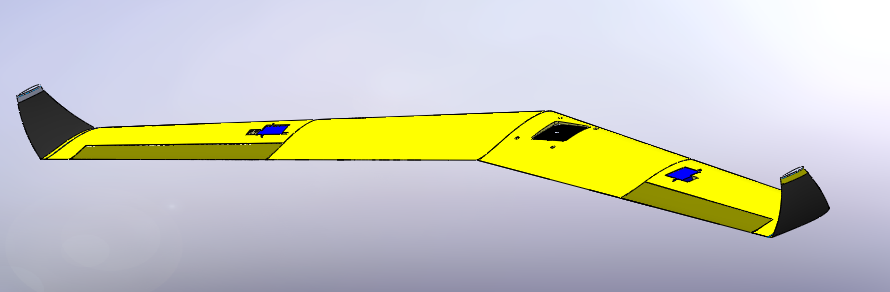
payload/Screenshots/glider_simplified.PNG
