irec-duster/RORO/payload/Screenshots/glider_span.PNG

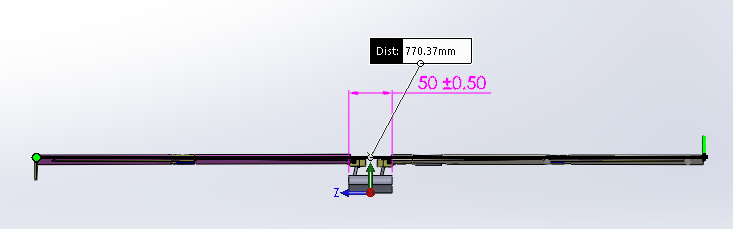
payload/Screenshots/glider_span.PNG
