irec-duster/RORO/payload/Screenshots/glider_top.PNG

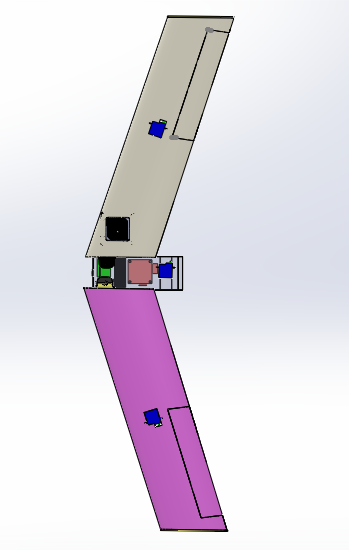
payload/Screenshots/glider_top.PNG
