irec-duster/RORO/payload/Screenshots/glider_top_span.PNG

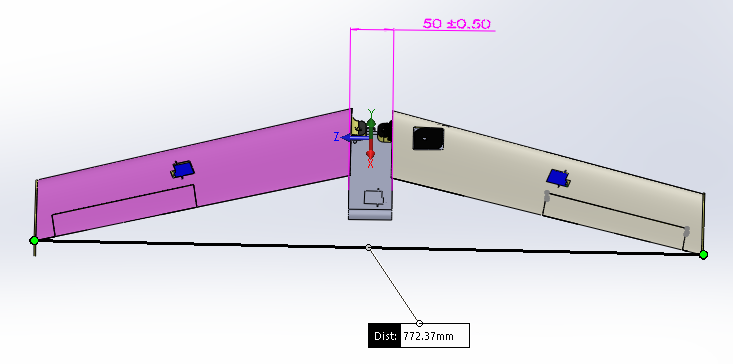
payload/Screenshots/glider_top_span.PNG
