irec-duster/RORO/payload/Screenshots/gliderFolded.PNG

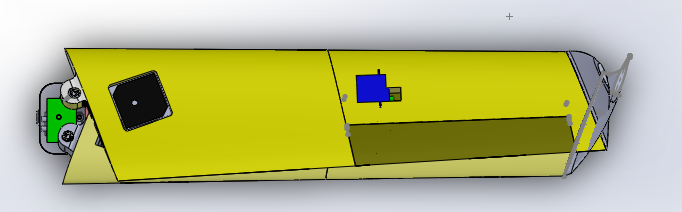
payload/Screenshots/gliderFolded.PNG
