irec-duster/RORO/payload/Screenshots/GliderIntheRocket.PNG

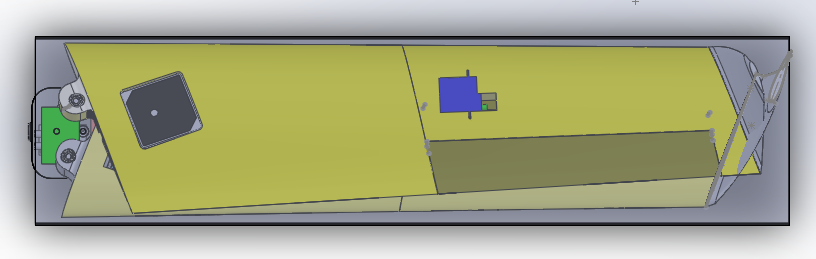
payload/Screenshots/GliderIntheRocket.PNG
