irec-duster/RORO/payload/Screenshots/winglets.PNG

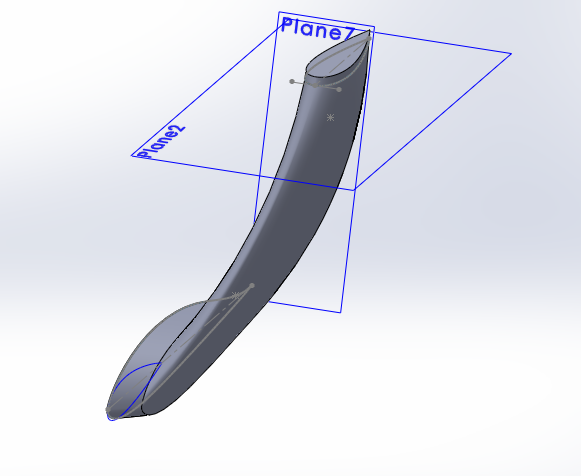
payload/Screenshots/winglets.PNG
