irec-duster/RORO/recovery/img/Parachute_opening_shock_system.jpg

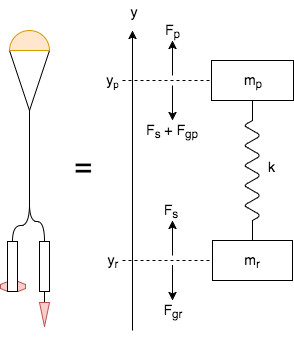
recovery/img/Parachute_opening_shock_system.jpg
