irec-duster/RORO/RORO_1/COTS drawings/80_20_rail_1515.png

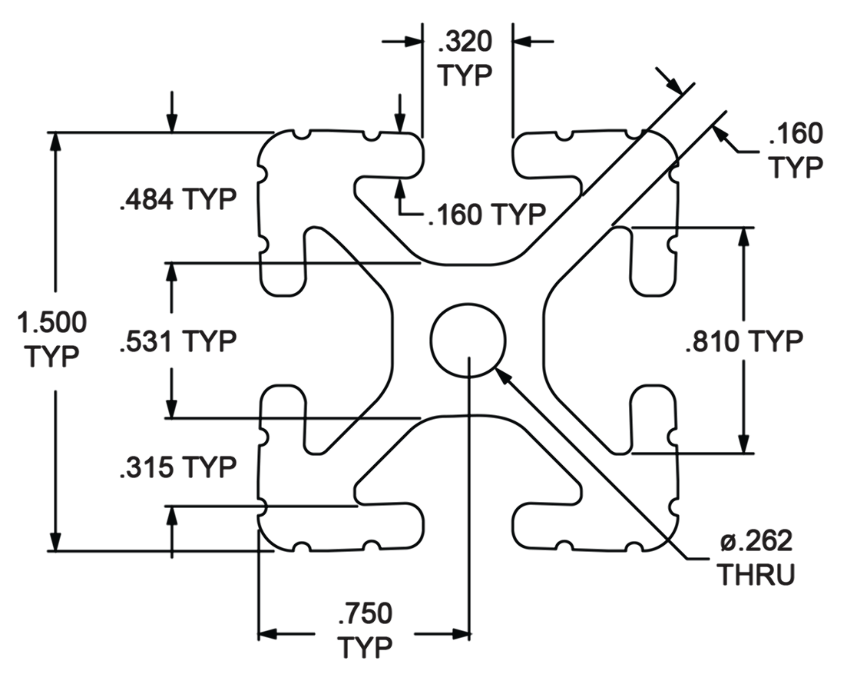
RORO_1/COTS drawings/80_20_rail_1515.png
