irec-duster/RORO/RORO_1/COTS drawings/AltimaxG3_mounting.png

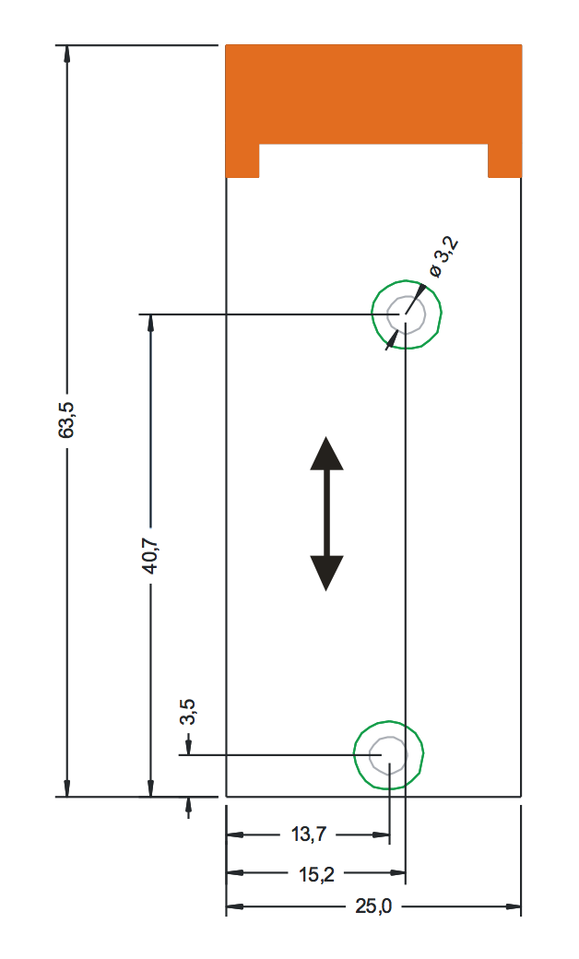
RORO_1/COTS drawings/AltimaxG3_mounting.png
