irec-duster/RORO/RORO_1/COTS drawings/RAVEN3_mounting.jpg

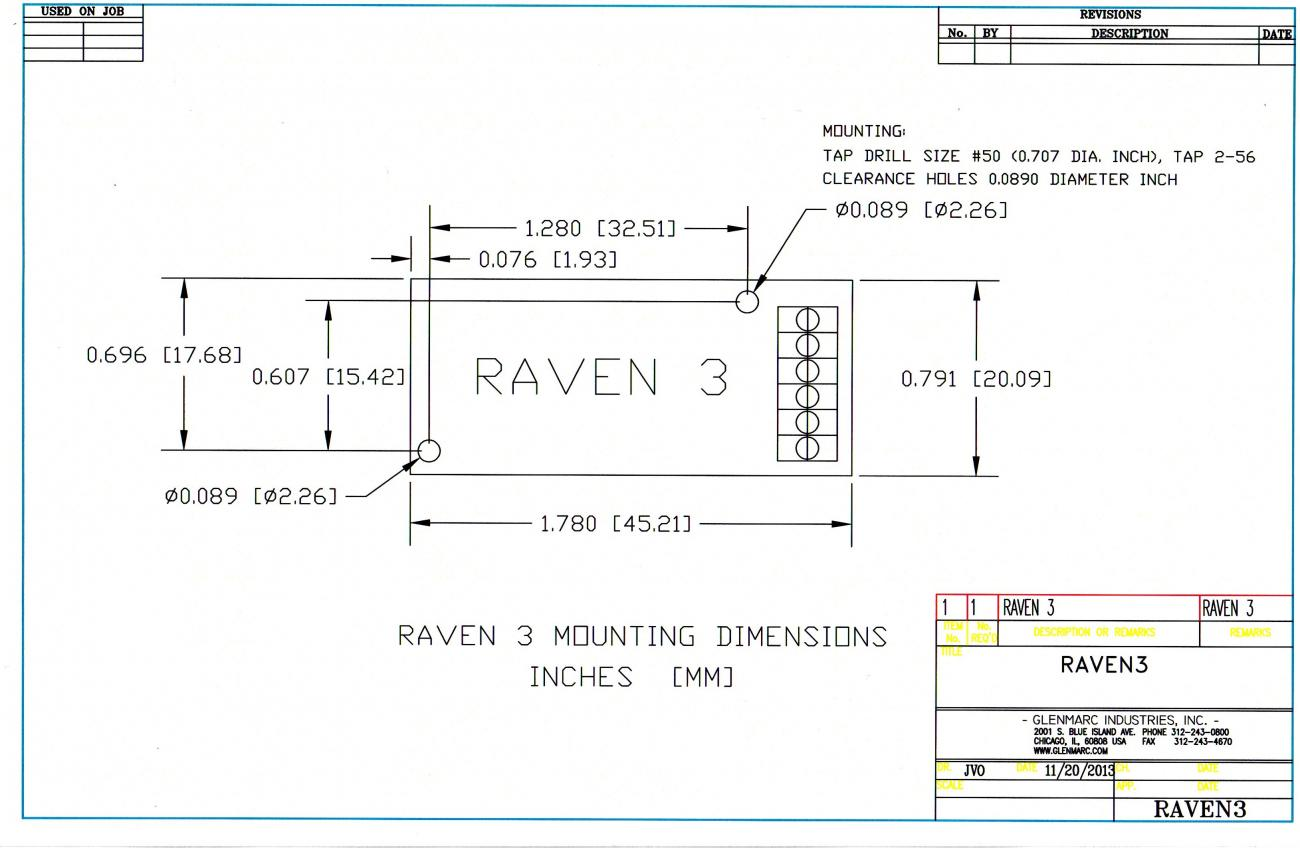
RORO_1/COTS drawings/RAVEN3_mounting.jpg
