irec-duster/RORO/RORO_1/Snapshots/lowerBody.PNG

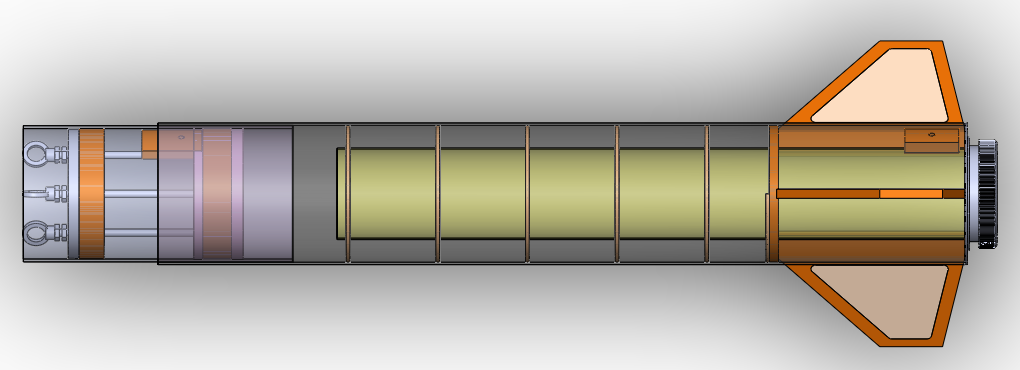
RORO_1/Snapshots/lowerBody.PNG
