irec-duster/RORO/RORO_1/Snapshots/upperandnosecone.PNG

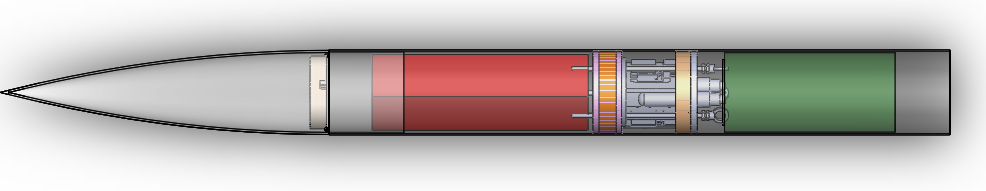
RORO_1/Snapshots/upperandnosecone.PNG
