irec-duster/RORO/NameParts.xlsx

RORO1
 | Assembly Number | Assembly Name | Subassembly Number | Subassembly Name | Part number | Part Name
 | 1000 | Lower body | 1100 | Propulsion | 1101 | Motor
 |  |  |  |  | 1102 | Thrustplate
 |  |  |  |  | 1103 | Motor Retainer
 |  |  |  |  | 1104 | Motor Retainer Lid
 |  |  | 1200 | Motor Tube | 1201 | Motor Tube
 |  |  |  |  | 1202 | Centering Ring
 |  |  |  |  | 1203 | Centering Fin
 |  |  |  |  | 1204 | Fin
 |  |  |  |  | 1001 | Lower body tube
 |  |  |  |  | 1002 | Coupling Tube
 | 2000 | Upper Body | 2100 | Recovery
 |  |  | 2200 | Payload
 | 3000 | Nosecone | 3100 | Avionics
RORO2 | 21000 | Lower body | 21100 | Propulsion | 21101 | Motor
 |  |  |  |  | 21102 | Thrustplate
 |  |  |  |  | 21103 | Motor Retainer
 |  |  |  |  | 21104 | Motor Retainer Lid
 |  |  | 21200 | Motor Tube | 21201 | Motor Tube
 |  |  |  |  | 21202 | Centering Ring
 |  |  |  |  | 21203 | Centering Fin
 |  |  |  |  | 21204 | Fin
 |  |  | 21400 | Active control | 21401 | Active control support
 |  |  |  |  | 21402 | Brake
 |  |  |  |  | 21403 | Servomotor
 |  |  |  |  | 21404 | Brake Rod
 |  |  |  |  | 21405 | Screw Rod
 |  |  |  |  | 21406 | Linear screw
 |  |  |  |  | 21407 | Linear bolt
 |  |  |  |  | 21001 | Lower body tube
 |  |  |  |  | 21002 | Coupling Tube
 | 22000 | Upper Body | 22100 | Recovery
 |  |  | 22200 | Payload
 |  |  |  |  | 22001 | Upper body tube
 | 23000 | Nosecone | 23100 | Avionics
 |  |  |  |  | 23001 | Nosecone
