irec-duster/RORO/Avionics_RORO/Altium/Project/BOM/Rocket_PCB_Project_2017.xlsx

Designator | Manufacturer 1 | Manufacturer Part Number 1 | Quantity | Supplier 1 | Supplier Currency 1 | Supplier Order Qty 1 | Supplier Part Number 1 | Supplier Stock 1 | Supplier Unit Price 1 | Comment | Footprint
P21 | JST Sales America Inc. | S02B-XASS-1(LF)(SN) | 1 | Digi-Key | CHF | 3 | 455-2044-ND | 21222 | 0.43696 |  | CON_JST_XA_ S02B-XASS-1
R51, R52 | Panasonic | ERJ-3GEY0R00V | 2 | Mouser | CHF | 10 | 667-ERJ-3GEY0R00V | 975092 | 0.012 | 0 | 0603
R29 | Panasonic | ERJ-3GEYJ105V | 1 | Mouser | CHF | 10 | 667-ERJ-3GEYJ105V | 159643 | 0.012 | 1M | 0603
C13, C26 | AVX | TAJA105K016RNJ | 2 | Mouser | CHF | 6 | 581-TAJA105K016 | 33395 | 0.591 | 1uF | CAP1206-case_A
C64, C65 | Murata Electronics | GRT188R61H105ME13D | 2 | Mouser | CHF | 10 | 81-GRT188R61H105ME3D | 3790 | 0.12 | 1uF | CAP0603R
R41, R42, R50, R72, R75 | Panasonic | ERJ-3EKF2001V | 5 | Mouser | CHF | 15 | 667-ERJ-3EKF2001V | 146623 | 0.014 | 2K | 0603
R1, R2, R6 | Panasonic | ERJ-3EKF2701V | 3 | Mouser | CHF | 10 | 667-ERJ-3EKF2701V | 108393 | 0.014 | 2K7 | 0603
C2, C3 | Murata Electronics | GCG31MR71E225JA12L | 2 | Mouser | CHF | 10 | 81-GCG31MR71E225JA2L | 2929 | 0.286 | 2.2uF | CAP1206W
R40, R77, R78, R79, R80, R81, R82 | Panasonic | ERJ-MP3PF3M0U | 7 | Mouser | CHF | 21 | 667-ERJ-MP3PF3M0U | 0 | 0.473 | 3m | 2010
D1, D2, D3, D4, D5, D6, D7, D8, D9, D10, D13, D15, D24, D26 | ON Semiconductor | MMBZ5227BLT1G | 14 | Mouser | CHF | 100 | 863-MMBZ5227BLT1G | 4362 | 0.045 | 3V6 | SOT23
L1 | Vishay / Dale | IHLP2525CZER3R3M01 | 1 | Mouser | CHF | 3 | 70-IHLP2525CZER3R3M0 | 3745 | 2.33 | 3.3uH | IHLP-2525CZ-01_Inductor
L2 | Vishay / Dale | IHLP6767DZER3R3M11 | 1 | Mouser | CHF | 3 | 70-IHLP6767DZER3R3M1 | 634 | 6.03 | 3.3uH | IHLP_Inductor
C42 | Murata Electronics | GCG188R92A472KA01D | 1 | Mouser | CHF | 3 | 81-GCG188R92A472KA1D | 7700 | 0.193 | 4.7nF | CAP0603R
C11, C12, C40, C90, C93 | Murata Electronics | GCG21BR71C475KA12L | 5 | Mouser | CHF | 15 | 81-GCG21BR71C475KA2L | 2779 | 0.243 | 4.7uF | CAP0805W
D27 | ON Semiconductor | ESD9L5.0ST5G | 1 | Mouser | CHF | 3 | 863-ESD9L5.0ST5G | 0 | 0.519 | 5V | SOD-923
R5, R37, R43 | Panasonic | ERJ-3EKF6191V | 3 | Mouser | CHF | 10 | 667-ERJ-3EKF6191V | 77434 | 0.014 | 6K19 | 0603
R4, R30, R31, R32, R69, R70, R84 | Panasonic | ERJ-PA3J100V | 7 | Mouser | CHF | 21 | 667-ERJ-PA3J100V | 18784 | 0.053 | 10 | 0603
R3, R10, R11, R12, R13, R14, R15, R17, R18, R19, R20, R21, R22, R23, R24, R25, R26, R27, R28, R36, R38, R49, R71, R74 | Panasonic | ERJ-3GEYJ103V | 24 | Mouser | CHF | 72 | 667-ERJ-3GEYJ103V | 700970 | 0.012 | 10K | 0603
C68, C71 | Murata Electronics | GCG188R91H103KA03D | 2 | Mouser | CHF | 10 | 81-GCG188R91H103KA3D | 0 | 0.098 | 10nF | CAP0603R
C5, C6, C14, C15, C20, C21, C35, C39, C58, C85, C86, C96, C98, C100, C102, C104, C106, C119 | Murata Electronics | GRT21BC81C106ME01L | 18 | Mouser | CHF | 54 | 81-GRT21BC81C106ME1L | 4767 | 0.108 | 10uF | CAP0805W
R33, R34, R35, R39, R44, R45, R48, R61, R62, R63, R64, R65, R66, R83, R89 | Panasonic | ERJ-3EKF1872V | 15 | Mouser | CHF | 100 | 667-ERJ-3EKF1872V | 76331 | 0.006 | 18K7 | 0603
D12, D14, D23, D25 | Micro Commercial Components (MCC) | SMBJ5357B-TP | 4 | Mouser | CHF | 12 | 833-SMBJ5357B-TP | 1117 | 0.632 | 20V | DO-214AA
R7, R8, R9, R16, R46, R47, R53, R54, R55, R56, R57, R58, R59, R60, R67, R68, R73, R76, R85, R86, R87, R88 | Panasonic | ERJ-PA3J220V | 22 | Mouser | CHF | 100 | 667-ERJ-PA3J220V | 357 | 0.024 | 22 | 0603
U2 | Microchip Technology / Micrel | DSC1001CI2-025.0000T | 1 | Mouser | CHF | 3 | 998-1001CI2025.0000T | 277 | 1.77 | 25MHz | SMD_3.2X2.5MM_4P
L3, L4, L5, L6 | Murata Electronics | LQG15HS27NJ02D | 4 | Mouser | CHF | 12 | 81-LQG15HS27NJ02D | 35765 | 0.05 | 27nH | 0402
C113, C114, C115 | TDK | CGA2B2C0G1H470J050BA | 3 | Mouser | CHF | 10 | 810-CGA2B2C0G1H470J | 30444 | 0.063 | 47pF | 0402
C88 | Vishay / Vitramon | VJ0603A470JXXPW1BC | 1 | Mouser | CHF | 3 | 77-VJ0603A470JXXPBC | 40983 | 0.102 | 47pF | CAP0603R
C31, C32, C33, C34, C37, C38, C43, C56, C57, C61, C75, C79, C89, C92, C107, C108, C109, C110, C111 | TDK | C3216X5R1E476M160AC | 19 | Mouser | CHF | 57 | 810-C3216X5R1E476M | 114900 | 1.05 | 47uF | CAP1206W
FB1, FB2, FB3, FB4, FB5, FB6, FB7, FB8, FB9, FB10, FB11, FB12 | Murata Electronics | BLM18KG601SZ1D | 12 | Mouser | CHF | 36 | 81-BLM18KG601SZ1D | 24648 | 0.075 | 81-BLM18KG601SZ1D | 0603
C30, C69 | Murata Electronics | GCM1885C1H820JA16D | 2 | Mouser | CHF | 10 | 81-GCM1885C1H820JA6D | 0 | 0.027 | 82pF | CAP0603R
C1, C4, C7, C8, C9, C10, C16, C17, C18, C19, C22, C23, C24, C25, C27, C28, C36, C59, C62, C63, C66, C70, C72, C73, C74, C77, C78, C81, C82, C83, C84, C91, C94, C112, C116, C117, C118, C120 | Murata Electronics | GCG188R91H104KA01D | 38 | Mouser | CHF | 114 | 81-GCG188R91H104KA1D | 3140 | 0.057 | 100nF | CAP0603R
C41, C44, C45, C46, C47, C48, C49, C50, C51, C52, C53, C54, C76, C80, C87 | Murata Electronics | GCG188R91H224KA01D | 15 | Mouser | CHF | 45 | 81-GCG188R91H224KA1D | 3978 | 0.119 | 220nF | CAP0603R
C29 | Murata Electronics | GRT188R61E474KE13D | 1 | Mouser | CHF | 3 | 81-GRT188R61E474KE3D | 15390 | 0.234 | 470nF | CAP0603R
C55, C60, C95, C97, C99, C101, C103, C105 | Nichicon | UWT1E471MNL1GS | 8 | Mouser | CHF | 24 | 647-UWT1E471MNL1S | 5196 | 0.33 | 470uF | PCV_10x10
C67 | Murata Electronics | GCM1885C1H561JA16D | 1 | Mouser | CHF | 3 | 81-GCM1885C1H561JA6D | 10192 | 0.173 | 560pF | CAP0603R
P1 | Amphenol FCI | 61082-042402LF | 1 | Mouser | CHF | 3 | 649-61082-042402LF | 737 | 4.83 | 61082-042402LF | 61082-042402LF
P25 | Amphenol FCI | 61083-043400LF | 1 | Mouser | CHF | 3 | 649-61083-043400LF | 236 | 3.94 | 61083-043400LF | 61083-043400LF
U16 | Measurement Specialties | MS563702BA03-50 | 1 | Mouser | CHF | 3 | 824-MS563702BA03-50 | 1084 | 2.73 | Abs. pres. sensor | SMD_3.0X3.0MM_4P
LS1 | CUI | CT-1205C-SMT-TR | 1 | Mouser | CHF | 3 | 490-CT-1205C-SMT-TR | 2425 | 2.91 | Buzzer | CT-1205C-SMT
U17, U18 | Honeywell | HSCMRRN001PD2A3, SSCMRNN015PG5A3 | 2 | Mouser | CHF | 6 | 785-HSCMRRN001PD2A3, 785-SSCMRNN015PG5A3 |  |  | Dif. pres. sensor | HSCMRRN060PDSA3
D11 | ON Semiconductor | NRVB0530T3G | 1 | Mouser | CHF | 3 | 863-NRVB0530T3G | 9998 | 0.448 | DS_NRVB0530T3G | SOD123
U4 | Adesto Technologies | AT25DF641A-SH-B | 1 | Mouser | CHF | 3 | 988-AT25DF641A-SH-B | 2159 | 4.18 | Flash 64MB | SOIC-8
P10, P23 |  |  | 2 |  |  |  |  |  |  | Header 2 | Con Prov 2P Power
P26, P27, P28, P29, P30, P31 | JST Sales America Inc. | B03B-XASK-1(LF)(SN) | 6 | Digi-Key | CHF | 18 | 455-1990-ND | 26459 | 0.23536 | Header 3p JST XA 3A | CON_JST_XA_ B03B-XASK
P8, P9 | JST Sales America Inc. | B04B-XASK-1(LF)(SN) | 2 | Digi-Key | CHF | 6 | 455-1994-ND | 39877 | 0.28799 | Header 4p JST XA 3A | CON_JST_XA_ B04B-XASK
P2 | JST Sales America Inc. | B06B-XASK-1(LF)(SN) | 1 | Digi-Key | CHF | 3 | 455-1996-ND | 24586 | 0.42703 | Header 6p JST XA 3A | CON_JST_XA_ B06B-XASK
P3 |  |  | 1 |  |  |  |  |  |  | Header 8 | HDR1X8
P11, P12 | Molex | 43045-0412 | 2 | Mouser | CHF | 6 | 538-43045-0412 | 8424 | 1.07 | Header MicroFit 2 | Con 2P Power and MicroFit 4P
H1, H2, H3, H4, H5, H6, H7, H8, H9, H10, H11, H12, H13, H14, H15, H16, H17, H18, H19, H20, H21, H22 |  |  | 22 |  |  |  |  |  |  | Hole_3.2mm | HOLE_3.2mm
U19 | Supplier disabled | Supplier disabled | 1 | Yost Labs | Supplier disabled |  | 3-Space!22 Embedded High-G (24g) |  |  | IMU | Yost Labs 3-Spac Embedded
D16, D17, D18, D19, D20, D21, D22, D28, D29 | Wurth Electronics | 150060GS75000 | 9 | Mouser | CHF | 27 | 710-150060GS75000 | 12636 | 0.127 | LED | WL-SMCW
P5, P6, P7, P13, P14, P15, P16, P17, P18, P19, P22, P24, P35, P36 | JST Sales America Inc. | S02B-XASS-1(LF)(SN) | 14 | Digi-Key | CHF | 42 | 455-2044-ND | 21222 | 0.40915 | LED connector | CON_JST_XA_ S02B-XASS-1
U10 | Texas Instruments | LM25116MHX/NOPB | 1 | Mouser | CHF | 3 | 926-LM25116MHX/NOPB | 4631 | 4.13 | LM25116MHX/NOPB | HTSSOP 20
U3 | Texas Instruments | LMR23630ADDAR | 1 | Mouser | CHF | 3 | 595-LMR23630ADDAR | 2378 | 3.74 | LMR23630 | HSOIC-8
U9, U11 | Linear Technology | LTC4352IMS#PBF | 2 | Digi-Key | CHF | 6 | LTC4352IMS#PBF-ND | 3310 | 6.16704 | LTC4352 | TSOP612
U7, U8 | Maxim Integrated | MAX3232EUE+ | 2 | Mouser | CHF | 6 | 700-MAX3232EUE | 1887 | 3.63 | MAX3232EUE | TSSOP 16
Q1, Q2, Q3, Q10, Q11, Q12, Q13, Q18 | Infineon Technologies | BSS816NWH6327XTSA1 | 8 | Mouser | CHF | 24 | 726-SP000917562 | 17828 | 0.214 | MOSFET_N | SOT-323-3
Q4, Q7 | Infineon Technologies | IPP029N06NAKSA1 | 2 | Mouser | CHF | 6 | 726-IPP029N06NAKSA1 | 0 | 1.79 | MOSFET_N | TO220
Q5, Q6 | Diodes Incorporated | DMTH4007LK3-13 | 2 | Mouser | CHF | 6 | 621-DMTH4007LK3-13 | 2480 | 0.927 | MOSFET_N | TO252
Q8, Q9, Q14, Q15, Q16, Q17 | Nexperia | PMV250EPEAR | 6 | Mouser | CHF | 18 | 771-PMV250EPEAR | 7190 | 0.262 | MOSFET_P | SOT23
U25 | Supplier disabled | Supplier disabled | 1 | uBlox | Supplier disabled |  | NEO_M8N |  |  | NEO_M8 | NEO-8
FL1 | Murata Electronics | NFE31PT222Z1E9L | 1 | Mouser | CHF | 3 | 81-NFE31PT222Z1E9L | 9252 | 0.55 | NFE31P Series (1206 Size) Chip EMIFILr LC Combined Type | LCL_NFE31P
U24 | Peregrine Semiconductor | 4259-63 | 1 | Digi-Key | CHF | 3 | 1046-1011-1-ND | 338083 | 0.6455 | PE4259 | SC-70
U23 | Murata Electronics North America | SF1186G | 1 | Digi-Key | CHF | 3 | 583-1198-6-ND | 6055 | 1.18177 | SF1186G | SMD_2.5X2MM_4P
P32, P33, P34 | Amphenol RF | 132291 | 3 | Mouser | CHF | 9 | 523-132291 | 25 | 6 | SMA | SMA_TH_VERTICAL_LONG
U14 | Texas Instruments | SN74LVC4245APWR | 1 | Mouser | CHF | 3 | 595-SN74LVC4245APWR | 3619 | 0.998 | SN74LVC4245A | TSSOP 24
U1 | STMicroelectronics (https://octopart-clicks.com/click/altium?sku=511-STM32F405VGT6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) | STM32F405VGT6 (https://octopart-clicks.com/click/altium?sku=511-STM32F405VGT6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) | 1 | Digi-Key | CHF | 3 | 497-11910-ND (https://octopart-clicks.com/click/altium?sku=511-STM32F405VGT6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) | 1092 | 11.19203 | STM32F405VGT6 | STM-LQFP100_N
S1, S2 |  |  | 2 |  |  |  |  |  |  | SW DPDT | SMD Slide Switches ON-ON
B1 | C&K Components | KSC461JST2LFS | 1 | Mouser | CHF | 3 | 611-KSC461JST2LFS | 10725 | 0.306 | Switch OFF-(ON) | Switch CK
TP1, TP2, TP3, TP5, TP6, TP7, TP8, TP9, TP10, TP11, TP12, TP13, TP14, TP15, TP16, TP17, TP20, TP21, TP22, TP23, TP24, TP25, TP26, TP27, TP28, TP29, TP30, TP31, TP32, TP33, TP34, TP35, TP36, TP37, TP38, TP39, TP40, TP41, TP42 |  |  | 39 |  |  |  |  |  |  | Test point | TP
U21, U22 | Texas Instruments | TPS7B6950DBVR | 2 | Mouser | CHF | 6 | 595-TPS7B6950DBVR | 4292 | 1.14 | TPS7B6950D | SOT-23-5
U5, U12, U13, U15 | STMicroelectronics | USBLC6-2SC6Y | 4 | Mouser | CHF | 12 | 511-USBLC6-2SC6Y | 0 | 0.505 | USBLC6-2SC6Y | SOT23-6L
U6 | Molex | 67643-3911 | 1 | Mouser | CHF | 3 | 538-67643-3911 | 2848 | 1.57 | USB_type_A | USB type A Right angle
U20 | Digi International | XB8-DMUS-002 | 1 | Mouser | CHF | 3 | 888-XB8-DMUS-002 | 510 | 23.58 | XBee 868LP RF Module | XBee 868LP RF Module
P20 |  |  | 1 |  |  |  |  |  |  | XBee pin | XBEE PIN
P4 | Harwin | M22-7131042 | 1 | Mouser | CHF | 3 | 855-M22-7131042 | 6581 | 1.51 | XBee receptacle | XBee receptacle
