irec-duster/RORO/Avionics_RORO/Altium/Project/BOM/Rocket_PCB_Project_2017_BOM_v230317.xlsx

Designator | Value |  | Manufacturer Part Number 1 | Quantity per PCB | Supplier Order Qty 1 | Supplier Part Number 1 | Supplier Unit Price 1 | Supplier Price for one rocket | Supplier Total Price 1 | Comment
P20 | XBee pin |  |  | 1 |  |  |  | 0 | 0
NA |  |  | XAP-06V-1 | 1 | 3 | 455-2152-ND | 0.2 | 0.2 | 0.6
NA |  |  | XAP-04V-1 | 2 | 6 | 455-2150-ND | 0.15 | 0.3 | 0.9
NA |  |  | XAP-03V-1 | 6 | 18 | 455-2149-ND | 0.11 | 0.66 | 1.98
NA |  |  | XAP-02V-1 | 12 | 36 | 455-1903-ND | 0.1 | 1.2 | 3.6
NA | 20-24 AWG |  | SXA-01T-P0.6 | 60 | 200 | 455-2051-1-ND | 0.1 | 6 | 20
P21 |  |  | S02B-XASS-1(LF)(SN) | 1 | 3 | 455-2044-ND | 0.43696 | 0.43696 | 1.31088
P26, P27, P28, P29, P30, P31 | Header 3p JST XA 3A |  | B03B-XASK-1(LF)(SN) | 6 | 18 | 455-1990-ND | 0.23536 | 1.41216 | 4.23648
P8, P9 | Header 4p JST XA 3A |  | B04B-XASK-1(LF)(SN) | 2 | 6 | 455-1994-ND | 0.28799 | 0.57598 | 1.72794
P2 | Header 6p JST XA 3A |  | B06B-XASK-1(LF)(SN) | 1 | 4 | 455-1996-ND | 0.42703 | 0.42703 | 1.70812
P5, P6, P7, P13, P14, P15, P16, P17, P18, P19, P22, P24, P35, P36 | LED connector |  | S02B-XASS-1(LF)(SN) | 14 | 42 | 455-2044-ND | 0.40915 | 5.7281 | 17.1843
U9, U11 | LTC4352 |  | LTC4352IMS#PBF | 2 | 6 | LTC4352IMS#PBF-ND | 6.16704 | 12.33408 | 37.00224
U24 | PE4259 |  | 4259-63 | 1 | 3 | 1046-1011-1-ND | 0.6455 | 0.6455 | 1.9365
U23 | SF1186G |  | SF1186G | 1 | 3 | 583-1198-6-ND | 1.18177 | 1.18177 | 3.54531
U1 | STM32F405VGT6 | https://octopart-clicks.com/click/altium?sku=511-STM32F405VGT6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 | STM32F405VGT6 (https://octopart-clicks.com/click/altium?sku=511-STM32F405VGT6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) | 1 | 3 | 497-11910-ND (https://octopart-clicks.com/click/altium?sku=511-STM32F405VGT6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) | 11.19203 | 11.19203 | 33.57609
NA | 18AWG |  | 430300038 | 10 | 50 | WM13070TR-ND | 0.05 | 0.5 | 2.5
NA | Conn 4p |  | 43025-0400 | 4 | 15 | WM1784-ND | 0.32 | 1.28 | 4.8
NA | 20-24AWG |  | 462350001 | 8 | 25 | WM7082CT-ND | 0.15 | 1.2 | 3.75
NA | CONN PLUG 4POS |  | 430200401 | 3 | 10 | WM2772-ND | 0.39 | 1.17 | 3.9
NA | MALE 20-24AWG |  | 430310002 | 10 | 30 | WM1127CT-ND | 0.16 | 1.6 | 4.8
NA | CONN HEADER 10POS 2MM VERT SMD |  | 951110-2530-AR-PR | 2 | 6 | 3M9344CT-ND | 1.93 | 3.86 | 11.58
NA | CONN SOCKET 10POS 2MM VERT T/H |  | 950510-6102-AR | 2 | 6 | 3M9405-ND | 1.7 | 3.4 | 10.2
NA |  |  | HSB-9485SH | 1 | 2 | 17941 | 119 | 119 | 238
NA |  |  | L77SDE09S | 1 | 2 | 523-L77SDE09S | 0.9 | 0.9 | 1.8
NA |  |  | GRS-4011-0140 | 2 | 4 | 629-GRS-4011-0140 | 0.9 | 1.8 | 3.6
NA |  |  | 908 | 1 | 2 | 485-908 | 4.02 | 4.02 | 8.04
NA |  |  | 558-0101-007F | 5 | 10 | 645-558-0101-007F | 1.5 | 7.5 | 15
NA |  |  | 558-0201-007F | 5 | 10 | 645-558-0201-007F | 1.5 | 7.5 | 15
NA |  |  | BD-06PMFS-QC8001 | 2 | 4 | 523-BD-06PMFS-QC8001 | 3.95 | 7.9 | 15.8
NA |  |  | A08-HASM-560 | 1 | 2 | 888-A08-HASM-560 | 9.17 | 9.17 | 18.34
NA |  |  | 43045-0200 | 6 | 20 | 538-43045-0200 | 1.5 | 9 | 30
NA |  |  | BD-06AFMM-QL8D01 | 2 | 3 | 523-BD-06AFMM-QL8D01 | 18.84 | 37.68 | 56.52
R51, R52 | 0 |  | ERJ-3GEY0R00V | 2 | 10 | 667-ERJ-3GEY0R00V | 0.012 | 0.024 | 0.12
R29 | 1M |  | ERJ-3GEYJ105V | 1 | 10 | 667-ERJ-3GEYJ105V | 0.012 | 0.012 | 0.12
C13, C26 | 1uF |  | TAJA105K016RNJ | 2 | 6 | 581-TAJA105K016 | 0.591 | 1.182 | 3.546
C64, C65 | 1uF |  | GRT188R61H105ME13D | 2 | 10 | 81-GRT188R61H105ME3D | 0.12 | 0.24 | 1.2
R41, R42, R50, R72, R75 | 2K |  | ERJ-3EKF2001V | 5 | 15 | 667-ERJ-3EKF2001V | 0.014 | 0.07 | 0.21
R1, R2, R6 | 2K7 |  | ERJ-3EKF2701V | 3 | 10 | 667-ERJ-3EKF2701V | 0.014 | 0.042 | 0.14
C2, C3 | 2.2uF |  | GCG31MR71E225JA12L | 2 | 10 | 81-GCG31MR71E225JA2L | 0.286 | 0.572 | 2.86
R40, R77, R78, R79, R80, R81, R82 | 3m |  | ERJ-MP3PF3M0U | 7 | 21 | 667-ERJ-MP3PF3M0U | 0.473 | 3.311 | 9.933
D1, D2, D3, D4, D5, D6, D7, D8, D9, D10, D13, D15, D24, D26 | 3V6 |  | MMBZ5227BLT1G | 14 | 100 | 863-MMBZ5227BLT1G | 0.045 | 0.63 | 4.5
L1 | 3.3uH |  | IHLP2525CZER3R3M01 | 1 | 3 | 70-IHLP2525CZER3R3M0 | 2.33 | 2.33 | 6.99
L2 | 3.3uH |  | IHLP6767DZER3R3M11 | 1 | 3 | 70-IHLP6767DZER3R3M1 | 6.03 | 6.03 | 18.09
C42 | 4.7nF |  | GCG188R92A472KA01D | 1 | 3 | 81-GCG188R92A472KA1D | 0.193 | 0.193 | 0.579
C11, C12, C40, C90, C93 | 4.7uF |  | GCG21BR71C475KA12L | 5 | 15 | 81-GCG21BR71C475KA2L | 0.243 | 1.215 | 3.645
D27 | 5V |  | ESD9L5.0ST5G | 1 | 3 | 863-ESD9L5.0ST5G | 0.519 | 0.519 | 1.557
R5, R37, R43 | 6K19 |  | ERJ-3EKF6191V | 3 | 10 | 667-ERJ-3EKF6191V | 0.014 | 0.042 | 0.14
R4, R30, R31, R32, R69, R70, R84 | 10 |  | ERJ-PA3J100V | 7 | 21 | 667-ERJ-PA3J100V | 0.053 | 0.371 | 1.113
R3, R10, R11, R12, R13, R14, R15, R17, R18, R19, R20, R21, R22, R23, R24, R25, R26, R27, R28, R36, R38, R49, R71, R74 | 10K |  | ERJ-3GEYJ103V | 24 | 72 | 667-ERJ-3GEYJ103V | 0.012 | 0.288 | 0.864
C68, C71 | 10nF |  | GCG188R91H103KA03D | 2 | 10 | 81-GCG188R91H103KA3D | 0.098 | 0.196 | 0.98
C5, C6, C14, C15, C20, C21, C35, C39, C58, C85, C86, C96, C98, C100, C102, C104, C106, C119 | 10uF |  | GRT21BC81C106ME01L | 18 | 54 | 81-GRT21BC81C106ME1L | 0.108 | 1.944 | 5.832
R33, R34, R35, R39, R44, R45, R48, R61, R62, R63, R64, R65, R66, R83, R89 | 18K7 |  | ERJ-3EKF1872V | 15 | 100 | 667-ERJ-3EKF1872V | 0.006 | 0.09 | 0.6
D12, D14, D23, D25 | 20V |  | SMBJ5357B-TP | 4 | 12 | 833-SMBJ5357B-TP | 0.632 | 2.528 | 7.584
R7, R8, R9, R16, R46, R47, R53, R54, R55, R56, R57, R58, R59, R60, R67, R68, R73, R76, R85, R86, R87, R88 | 22 |  | ERJ-PA3J220V | 22 | 100 | 667-ERJ-PA3J220V | 0.024 | 0.528 | 2.4
U2 | 25MHz |  | DSC1001CI2-025.0000T | 1 | 3 | 998-1001CI2025.0000T | 1.77 | 1.77 | 5.31
L3, L4, L5, L6 | 27nH |  | LQG15HS27NJ02D | 4 | 12 | 81-LQG15HS27NJ02D | 0.05 | 0.2 | 0.6
C113, C114, C115 | 47pF |  | CGA2B2C0G1H470J050BA | 3 | 10 | 810-CGA2B2C0G1H470J | 0.063 | 0.189 | 0.63
C88 | 47pF |  | VJ0603A470JXXPW1BC | 1 | 3 | 77-VJ0603A470JXXPBC | 0.102 | 0.102 | 0.306
C31, C32, C33, C34, C37, C38, C43, C56, C57, C61, C75, C79, C89, C92, C107, C108, C109, C110, C111 | 47uF |  | C3216X5R1E476M160AC | 19 | 57 | 810-C3216X5R1E476M | 1.05 | 19.95 | 59.85
FB1, FB2, FB3, FB4, FB5, FB6, FB7, FB8, FB9, FB10, FB11, FB12 | 81-BLM18KG601SZ1D |  | BLM18KG601SZ1D | 12 | 36 | 81-BLM18KG601SZ1D | 0.075 | 0.9 | 2.7
C30, C69 | 82pF |  | GCM1885C1H820JA16D | 2 | 10 | 81-GCM1885C1H820JA6D | 0.027 | 0.054 | 0.27
C1, C4, C7, C8, C9, C10, C16, C17, C18, C19, C22, C23, C24, C25, C27, C28, C36, C59, C62, C63, C66, C70, C72, C73, C74, C77, C78, C81, C82, C83, C84, C91, C94, C112, C116, C117, C118, C120 | 100nF |  | GCG188R91H104KA01D | 38 | 114 | 81-GCG188R91H104KA1D | 0.057 | 2.166 | 6.498
C41, C44, C45, C46, C47, C48, C49, C50, C51, C52, C53, C54, C76, C80, C87 | 220nF |  | GCG188R91H224KA01D | 15 | 45 | 81-GCG188R91H224KA1D | 0.119 | 1.785 | 5.355
C29 | 470nF |  | GRT188R61E474KE13D | 1 | 3 | 81-GRT188R61E474KE3D | 0.234 | 0.234 | 0.702
C55, C60, C95, C97, C99, C101, C103, C105 | 470uF |  | UWT1E471MNL1GS | 8 | 24 | 647-UWT1E471MNL1S | 0.33 | 2.64 | 7.92
C67 | 560pF |  | GCM1885C1H561JA16D | 1 | 3 | 81-GCM1885C1H561JA6D | 0.173 | 0.173 | 0.519
P1 | 61082-042402LF |  | 61082-042402LF | 1 | 3 | 649-61082-042402LF | 4.83 | 4.83 | 14.49
P25 | 61083-043400LF |  | 61083-043400LF | 1 | 3 | 649-61083-043400LF | 3.94 | 3.94 | 11.82
U16 | Abs. pres. sensor |  | MS563702BA03-50 | 1 | 3 | 824-MS563702BA03-50 | 2.73 | 2.73 | 8.19
LS1 | Buzzer |  | CT-1205C-SMT-TR | 1 | 3 | 490-CT-1205C-SMT-TR | 2.91 | 2.91 | 8.73
U17 | Dif. pres. sensor |  | HSCMRRN001PD2A3 | 1 | 2 | 785-HSCMRRN001PD2A3 |  | 0 | 0
U18 | Dif. pres. sensor |  | SSCMRNN015PG5A3 | 1 | 2 | 785-SSCMRNN015PG5A3 |  | 0 | 0
D11 | DS_NRVB0530T3G |  | NRVB0530T3G | 1 | 3 | 863-NRVB0530T3G | 0.448 | 0.448 | 1.344
U4 | Flash 64MB |  | AT25DF641A-SH-B | 1 | 3 | 988-AT25DF641A-SH-B | 4.18 | 4.18 | 12.54
P11, P12 | Header MicroFit 2 |  | 43045-0412 | 2 | 6 | 538-43045-0412 | 1.07 | 2.14 | 6.42
D16, D17, D18, D19, D20, D21, D22, D28, D29 | LED |  | 150060GS75000 | 9 | 27 | 710-150060GS75000 | 0.127 | 1.143 | 3.429
U10 | LM25116MHX/NOPB |  | LM25116MHX/NOPB | 1 | 3 | 926-LM25116MHX/NOPB | 4.13 | 4.13 | 12.39
U3 | LMR23630 |  | LMR23630ADDAR | 1 | 3 | 595-LMR23630ADDAR | 3.74 | 3.74 | 11.22
U7, U8 | MAX3232EUE |  | MAX3232EUE+ | 2 | 6 | 700-MAX3232EUE | 3.63 | 7.26 | 21.78
Q1, Q2, Q3, Q10, Q11, Q12, Q13, Q18 | MOSFET_N |  | BSS816NWH6327XTSA1 | 8 | 24 | 726-SP000917562 | 0.214 | 1.712 | 5.136
Q4, Q7 | MOSFET_N |  | IPP029N06NAKSA1 | 2 | 6 | 726-IPP029N06NAKSA1 | 1.79 | 3.58 | 10.74
Q5, Q6 | MOSFET_N |  | DMTH4007LK3-13 | 2 | 6 | 621-DMTH4007LK3-13 | 0.927 | 1.854 | 5.562
Q8, Q9, Q14, Q15, Q16, Q17 | MOSFET_P |  | PMV250EPEAR | 6 | 18 | 771-PMV250EPEAR | 0.262 | 1.572 | 4.716
FL1 | NFE31P Series (1206 Size) Chip EMIFILr LC Combined Type |  | NFE31PT222Z1E9L | 1 | 3 | 81-NFE31PT222Z1E9L | 0.55 | 0.55 | 1.65
P32, P33, P34 | SMA |  | 132291 | 3 | 9 | 523-132291 | 6 | 18 | 54
U14 | SN74LVC4245A |  | SN74LVC4245APWR | 1 | 3 | 595-SN74LVC4245APWR | 0.998 | 0.998 | 2.994
S1, S2 | SW DPDT |  | SSSS820101 | 2 | 5 | 688-SSSS820101 | 1.5 | 3 | 7.5
B1 | Switch OFF-(ON) |  | KSC461JST2LFS | 1 | 3 | 611-KSC461JST2LFS | 0.306 | 0.306 | 0.918
U21, U22 | TPS7B6950D |  | TPS7B6950DBVR | 2 | 6 | 595-TPS7B6950DBVR | 1.14 | 2.28 | 6.84
U5, U12, U13, U15 | USBLC6-2SC6Y |  | USBLC6-2SC6Y | 4 | 12 | 511-USBLC6-2SC6Y | 0.505 | 2.02 | 6.06
U6 | USB_type_A |  | 67643-3911 | 1 | 3 | 538-67643-3911 | 1.57 | 1.57 | 4.71
U20 | XBee 868LP RF Module |  | XB8-DMUS-002 | 1 | 3 | 888-XB8-DMUS-002 | 23.58 | 23.58 | 70.74
P4 | XBee receptacle |  | M22-7131042 | 1 | 3 | 855-M22-7131042 | 1.51 | 1.51 | 4.53
NA | 120 |  | CR0603-JW-121ELF | 10 | 30 | 652-CR0603-JW-121ELF | 0.016 | 0.16 | 0.48
NA |  |  | Sway-TRX LiPo 3S 11.1V 1800mAh 45C/90C TRX | 2 | 4 | 7640159368151 | 23.9 | 47.8 | 95.6
NA |  |  | ANN-MS-0 | 4 | 4 | ANN-MS-0 | 29 | 116 | 116
U25 | NEO_M8 |  | NEO-M8N | 1 | 3 | NEO-M8N | 29 | 29 | 87
U19 | IMU |  | 3-Space Embedded High-G (24g) | 1 | 3 | 3-Space Embedded High-G (24g) | 140 | 140 | 420
