irec-duster/RORO/Avionics_RORO/Datasheet/stm32373C-eval_sch/NUCLEO-144pins_Altium_Schematics-Layout/MB1137_Assembly-F207ZG.xlsx

Sheet: BOM Report
Bill of Materials
Source Data From:
Project:
Variant: |  | None
Creation Date: | 11/27/2014 | 13:33:45
Print Date: | 2016-03-03 | 16:38:18
MB1137B-01 BOM & components order and assembly
Select MCU Reference in follow list: |  |  | Select Socket option:
F207ZG |  |  | without socket
Board name:NUCLEO-F207ZG
Comment | Designator | Footprint | Quantity | Assembly | Ordered by | Comments | Description | Manufacturer 1 | Part#1 | Manufacturer 2 | Part#2 | ECCN US | ECCN EU | Info source
USER (Blue) | B1 | PB-6X6mm-Blue | 1 | Blue | Subcon | Blue | touch switch,BLUE,6*6,SMT,TD-0341X-GO0 | XIEJIA | CTSM-644B-V-T/R |  |  | NA | NA
TD-0341 [RESET/Black] | B2 | PB-6X6mm-Black | 1 | Black | Subcon | Black | touch switch,BLACK,6*6,SMT,TD-0341X-A00 | XIEJIA | CTSM-644N-V-T/R |  |  | NA | NA
100nF | C1, C2, C3, C4, C8, C10, C11, C12, C13, C19, C22, C24, C25, C26, C27, C28, C29, C30, C31, C32, C33, C34, C39, C40, C44, C47, C48, C49, C50, C53, C58 | 0603C | 31 |  | Subcon |  | capacitor,100nF,10%,16V,X7R,0603,YAGEO | YAGEO | CC0603KRX7R7BB104 |  |  | NA | NA
10pF | C5, C6 | 0603C | 2 |  | Subcon |  | capacitor,10pF,5%,50V,NPO,0603,YAGEO | YAGEO | CC0603JRNPO9BN100 |  |  | NA | NA
20pF[N/A] | C7 | 0603C | 1 | [N/A] | Subcon |  |  |  |  |  |  | NA | NA
1uF_X5R_0603 | C9, C14, C20, C23, C41, C57 | 0603C | 6 |  | Subcon |  | capacitor,1uF,0603,16V,10%,X5R,YAGEO | YAGEO | CC0603KRX5R7BB105 |  |  | NA | NA
10nF_X7R_0603 | C15 | 0603C | 1 |  | Subcon |  | capacitor,10nF,0603,50V,10%,X7R,YAGEO; | YAGEO | CC0603KRX7R9BB103 |  |  | NA | NA
4.7uF | C16, C54 | TAN-A | 2 |  | Subcon |  | TAN capacitor,4.7uF,10%,16V,Atype,AVX | AVX | TAJA475K016R |  |  | NA | NA
10uF(25V) | C17 | TAN-B | 1 |  | Subcon |  | TAN capacitor,10uF,10%,25V,Btype,AVX | AVX | TAJB106K025RNJ |  |  | NA | NA
10uF | C18, C46 | TAN-A | 2 |  | Subcon |  | TAN capacitor,10uF,10%,16V,Atype,AVX | AVX | TAJA106K016R |  |  | NA | NA
4.7uF_X5R_0603 | C21 | 0603C | 1 |  | Subcon |  | capacitor,4.7uF,16V, X5R,10%,0603 | YAGEO | CC0603KRX5R7BB475 |  |  | NA | NA
2.7pF | C35, C36 | 0603C | 2 |  | Subcon |  | capacitor,2.7PF,0603,50V,NPO,+-0.1PF,YAGEO | YAGEO | CC0603BRNPO9BN2R7 |  |  | NA | NA
4.3pF[N/A] | C37, C38 | 0603C | 2 | [N/A] | Subcon |  |  |  |  |  |  | NA | NA
470pF | C42 | 0603C | 1 |  | Subcon |  | capacitor,470pF,5%,50V,NPO,0603,YAGEO | YAGEO | CC0603JRNPO9BN471 |  |  | NA | NA
30pF | C43, C45 | 0603C | 2 |  | Subcon |  | capacitor,30pF,5%,50V,NPO,0603 | YAGEO | CC0603JRNPO9BN300 |  |  | NA | NA
TC1206KKX7RDBB102 | C51 | 1206C | 1 |  | Subcon |  | capacitor,1nF,X7R,2000V,1206,CC1206KKX7RDBB102 | YAGEO | CC1206KKX7RDBB102 |  |  | NA | NA
[N/A] | C52 | 0603C | 1 | [N/A] | Subcon |  |  |  |  |  |  | NA | NA
2.2uF_X7R | C55, C56 | TAN-A | 2 |  | Subcon | VCAP,Capacitor,2.2uF,10%,16V,X7R,1206 | capacitor,2.2uF,10%,16V,X7R,1206 | YAGEO | CC1206KKX7R7BB225 |  |  | NA | NA
1050170001 | CN1 | Molex_1050170001 | 1 |  | Subcon | USB Micro-B Connector | MicroUSB,1050170001,Btype,SMT,MOLEX | MOLEX | 1050170001 |  |  | NA | NA
 | CN2, CN3 | HDR_1x2_2R54_V_M | 2 |  | Subcon | CN2,CN3 long headers on bottom layer same as CN7-10 | pin header male,PH2.54 1*2P 6.0(2.5)6.0 PA6T 1U' | latconn | PH254102D1598 |  |  | NA | NA
Header 4 | CN4 | HDR_1x4_2R54_V_M | 1 |  | Subcon | Closed by default | pin header male,2.54mm,1*4,L=11.6,180,1U,DIP | lyconn | 313104S111116 |  |  | NA | NA
 | CN5 | HDR_1x2_2R54_V_M_S | 1 |  | Subcon |  | pin header male,2.54mm,1*2,L=11.6,180,1U,DIP | lyconn | 313102S111116 |  |  | NA | NA
Header 6X1 | CN6 | HDR_1x6_2R54_V_M | 1 |  | Subcon |  | pin header male,2.54mm,1*6,L=11.6,180,1U,DIP, | lyconn | 313106S111116 |  |  | NA | NA
Header 10X2_Female | CN7 | HDR_10x2_2R54_V_F | 1 |  | Subcon | long headers on bottom layer | long pin header female2.54 2*10P H8.5 PC9.4 PC104 0.6*0.6 PA6T | latconn | PF254210D1531 |  |  | NA | NA
Header 8X2_Female | CN8 | HDR_8x2_2R54_V_F | 1 |  | Subcon | long headers on bottom layer | long pin header female2.54 2*8P H8.5 PC9.4 PC104 0.6*0.6 PA6T | latconn | PF254208D1531 |  |  | NA | NA
Header 15X2_Female | CN9 | HDR_15x2_2R54_V_F | 1 |  | Subcon | long headers on bottom layer | long pin header female2.54 2*15P H8.5 PC9.4 PC104 0.6*0.6 PA6T | latconn | PF254215D1531 |  |  | NA | NA
Header 17X2_Female | CN10 | HDR_17x2_2R54_V_F | 1 |  | Subcon | long headers on bottom layer | long pin header female2.54 2*17P H8.5 PC9.4 PC104 0.6*0.6 PA6T | latconn | PF254217D1531 |  |  | NA | NA
Header 36X2 | CN11, CN12 | HDR_2x36_2R54_V_M | 2 | [N/A], Pin 71-72 long headers as CN2/CN3 | Subcon |  | pin header male,PH2.54 1*2P 6.0(2.5)6.0 PA6T 1U' | latconn | PH254102D1598 |  |  | NA | NA
475900001 | CN13 | MOLEX_47590001 | 1 |  | Subcon | USB Micro-AB Connector | MicroUSB-AB,47590-0001,SMT,MOLEX,MB784 | MOLEX | 47590-0001 |  |  | NA | NA
KRJ-CB4.2GYZNL | CN14 | RJ45_KRJ-CB4.2GYZNL | 1 |  | Subcon | Ethernet RJ45 Connector | RJ45,connector,KRJ-CB4.2GYZNL,DIP | DGKYD | KRJ-CB4.2GYZNL |  |  | NA | NA
BAT60JFILM | D1, D2, D3, D4, D5 | SOD-323 | 5 |  | STM |  | diode,BAT60JFILM,SOD-323,ST | STM | BAT60JFILM |  |  | EAR99 | NEC | http://tcdr.sgp.st.com:23000/tcdr/app?page=tcdr/productList
ESDA6V1BC6 | D6 | SOT23-6L | 1 |  | STM |  | TVS diode array,ESDA6V1BC6, SOT-23-6 | STM | ESDA6V1BC6 |  |  | EAR99 | NEC | http://tcdr.sgp.st.com:23000/tcdr/app?page=tcdr/productList
 | JP1, JP4, JP5, JP6, JP7 | HDR_1x2_2R54_V_M_S | 5 |  | Subcon |  | pin header male,2.54mm,1*2,L=11.6,180,1U,DIP | lyconn | 313102S111116 |  |  | NA | NA
 | JP2 | HDR_1x2_2R54_V_M_S | 1 | [N/A] | Subcon |  |  |  |  |  |  | NA | NA
Header 3X2 | JP3 | HDR_3x2_2R54_V_M | 1 |  | Subcon |  | pin header male,2.54mm,2*3,L=11.6,180,1U,DIP | lyconn |  |  |  | NA | NA
BEAD | L1, L2 | 0603L | 2 |  | Subcon |  | bead,600R,350mA,0603,FCM1608KF-601T05, | Tai-tech | FCM1608KF-601T05 |  |  | NA | NA
Green | LD1, LD6, LD8 | 0603D-G | 3 |  | Subcon |  | LED,green,0603 | everlight | 19-213SY6C/S530-E2/TR8LED |  |  | EAR99 | NEC | Sub Co
Blue | LD2 | 0603D-B | 1 |  | Subcon |  | LED,blue,0603 | everlight | 19-217/BHC-ZL1M2RY/3T |  |  | EAR99 | NEC | Sub Co
Red | LD3, LD5, LD7 | 0603D-R | 3 |  | Subcon |  | LED,red,0603 | everlight | 19-217/R6C-AL1M2VY/3T |  |  | EAR99 | NEC | Sub Co
LD_BICOLOR_CMS | LD4 | HSMF-A201 | 1 |  | Subcon |  | LED,bi-color,red-green,3.2 mm x 2.8 mm,LE-RGW35280,SMT, | everluck | LE-RGW35280 |  |  | EAR99 | NEC | Sub Co
100[N/A] | R1 | 0603R | 1 | [N/A] | Subcon |  |  |  |  |  |  | NA | NA
10K | R2, R4, R12, R27, R34, R35, R36, R39, R41, R43, R44, R47, R66, R72 | 0603R | 14 |  | Subcon |  | resistor,10K,0603,1% | YAGEO | RC0603FR-0710KL |  |  | NA | NA
10K[N/A] | R3 | 0603R | 1 | [N/A] | Subcon |  |  |  |  |  |  | NA | NA
100K | R5, R6, R11, R73 | 0603R | 4 |  | Subcon |  | resistor,100K,0603,1% | YAGEO | RC0603FR-07100KL |  |  | NA | NA
4K7 | R7, R24, R25 | 0603R | 3 |  | Subcon |  | resistor,4.7K,0603,1% | YAGEO | RC0603FR-074K7L |  |  | NA | NA
2K7 | R8, R28 | 0603R | 2 |  | Subcon |  | resistor,2.7K,0603,1%,YAGEO | YAGEO | RC0603FR-072K7L |  |  | NA | NA
1K5 | R9, R46 | 0603R | 2 |  | Subcon |  | resistor,1.5K,0603,1%,YAGEO | YAGEO | RC0603FR-071K5L |  |  | NA | NA
1K5[N/A] | R70 | 0603R | 1 | [N/A] | Subcon |  |  |  |  |  |  | NA | NA
22 | R10, R19, R22, R23 | 0603R | 4 |  | Subcon |  | resistor,22R,0603,1% | YAGEO | RC0603FR-0722RL |  |  | NA | NA
100 | R13, R15, R17, R20, R26, R60 | 0603R | 6 |  | Subcon |  | resistor,100R,0603,1% | YAGEO | RC0603FR-07100RL |  |  | NA | NA
0 | R14, R37, R38 | 0603R | 3 |  | Subcon |  | resistor,0R,0603,5%,YAGEO | YAGEO | RC0603JR-070RL |  |  | NA | NA
36K | R16 | 0603R | 1 |  | Subcon |  | resistor,36K,0603,1% | YAGEO | RC0603FR-0736KL |  |  | NA | NA
[N/A] | R18 | 0603R | 1 | [N/A] | Subcon |  |  |  |  |  |  | NA | NA
1K | R21, R29, R30 | 0603R | 3 |  | Subcon |  | resistor,1K,0603,1%,YAGEO | YAGEO | RC0603FR-071KL |  |  | NA | NA
680 | R31 | 0603R | 1 |  | Subcon |  | resistor,680R,0603,1% | YAGEO | RC0603FR-07680RL |  |  | NA | NA
510 | R32 | 0603R | 1 |  | Subcon |  | resistor,510R,0603,1% | YAGEO | RC0603FR-07510RL |  |  | NA | NA
200K | R33 | 0603R | 1 |  | Subcon |  | resistor,200K,0603,1%,YAGEO | YAGEO | RC0603FR-07200KL |  |  | NA | NA
33 | R40, R42, R45, R48 | 0603R | 4 |  | Subcon |  | resistor,33R,0603,1%,YAGEO | YAGEO | RC0603FR-0733RL |  |  | NA | NA
12K1 | R49 | 0603R | 1 |  | Subcon |  | resistor,12.1K,0603,1% | YAGEO | RC0603FR-0712K1L |  |  | NA | NA
50 | R50, R51, R52, R53 | 0603R | 4 |  | Subcon |  | resistor,49.9R,0603,1%,YAGEO | YAGEO | RC0603FR-0749R9L |  |  | NA | NA
75 | R54, R55, R56, R57 | 0603R | 4 |  | Subcon |  | resistor,75R,0603,1% | YAGEO | RC0603FR-0775RL |  |  | NA | NA
220K | R58 | 0603R | 1 |  | Subcon |  | resistor,220K,0603,1% | YAGEO | RC0603FR-07220KL |  |  | NA | NA
330 | R59, R64 | 0603R | 2 |  | Subcon |  | resistor,330R,0603,1% | YAGEO | RC0603FR-07330RL |  |  | NA | NA
620 | R61 | 0603R | 1 |  | Subcon |  | resistor,620R,0603,1% | YAGEO | RC0603FR-07620RL |  |  | NA | NA
430K[N/A] | R62 | 0603R | 1 |  | Subcon |  |  |  |  |  |  | NA | NA
620K[N/A] | R63 | 0603R | 1 |  | Subcon |  |  |  |  |  |  | NA | NA
270 | R65, R67 | 0603R | 2 |  | Subcon |  | resistor,270R,0603,1% | YAGEO | RC0603FR-07270RL |  |  | NA | NA
47K | R68, R71 | 0603R | 2 |  | Subcon |  | resistor,47K,0603,1%,YAGEO | YAGEO | RC0603FR-0747KL |  |  | NA | NA
22K | R69 | 0603R | 1 |  | Subcon |  | resistor,22K,0603,1% | YAGEO | RC0603FR-0722KL |  |  | NA | NA
Open | SB1, SB8, SB9, SB16, SB17, SB102, SB104, SB106, SB107, SB109, SB113, SB119, SB122, SB138, SB142, SB143, SB144, SB145, SB148, SB152, SB180 | SB_0603 | 21 | [N/A] | Subcon |  |  |  |  |  |  | NA | NA
Closed | SB2, SB3, SB4, SB5, SB6, SB7, SB12, SB13, SB101, SB103, SB105, SB108, SB110, SB111, SB112, SB114, SB116, SB117, SB118, SB120, SB121, SB132, SB133, SB139, SB149, SB155, SB156, SB160, SB162, SB163, SB164, SB173, SB177, SB178, SB179, SB181, SB182, SB183 | SB_0603 | 38 |  | Subcon |  | resistor,0R,0603,5%,YAGEO | YAGEO | RC0603JR-070RL |  |  | NA | NA
Circuit Breaker | SB10, SB11, SB14, SB15, SB115, SB123, SB124, SB126, SB128, SB129, SB130, SB135, SB136, SB137, SB140, SB141, SB150, SB151, SB153, SB154, SB159, SB165, SB166, SB167, SB171, SB174, SB184, SB186 | SB_0603 | 28 | [N/A] | Subcon |  |  |  |  |  |  | NA | NA
Circuit Breaker | SB125, SB127, SB131, SB134, SB146, SB147, SB157, SB158, SB161, SB168, SB169, SB170, SB172, SB175, SB176, SB185, SB187 | SB_0603 | 17 |  | Subcon |  | resistor,0R,0603,5%,YAGEO | YAGEO | RC0603JR-070RL |  |  | NA | NA
9013 | T1, T2 | SOT-23 | 2 |  | Subcon |  | transistor,MMBT9013,SOT-23, | ST | MMBT9013 |  |  | EAR99 | NEC | Sub Co
USB_SOF | TP1 | TP | 1 | [N/A] | Subcon |  |  |  |  |  |  | NA | NA
USBLC6-2SC6 | U1 | SOT23-6L | 1 |  | STM |  | diode,USBLC6-2SC6,SOT23-6L | STM | USBLC6-2SC6 |  |  | EAR99 | NEC | http://tcdr.sgp.st.com:23000/tcdr/app?page=tcdr/productList
STM32F103CBT6 | U2 | LQFP48_0R5_7x7 | 1 |  | STM |  | ARM microcontroller, STM32F103CBT6, LQFP-48 | STM | STM32F103CBT6 |  |  | 3A991A2 | NEC | http://tcdr.sgp.st.com:23000/tcdr/app?page=tcdr/productList
LD3985M33R | U3 | SOT-23-5L | 1 |  | STM |  | LDO Regulator,LD3985M33R,SOT23-5 | STM | LD3985M33R |  |  | EAR99 | NEC | http://tcdr.sgp.st.com:23000/tcdr/app?page=tcdr/productList
ST890CDR | U4 | SOIC8_1R27_4R9X6 | 1 |  | STM |  | IC PWR SWITCH MOSFET,ST890CDR,SO-8 | STM | ST890CDR |  |  | EAR99 | NEC | http://tcdr.sgp.st.com:23000/tcdr/app?page=tcdr/productList
LD1117S50TR | U5 | SOT-223 | 1 |  | STM |  | LDO Regulator IC,LD1117S50TR,SOT-223 | STM | LD1117S50TR |  |  | EAR99 | NEC | http://tcdr.sgp.st.com:23000/tcdr/app?page=tcdr/productList
LD39050PU33R | U6 | DFN6_0R95_3x3_TP | 1 |  | STM |  | LDO Regulator IC,LD39050PU33R,DFN6 | STM | LD39050PU33R |  |  | EAR99 | NEC | http://tcdr.sgp.st.com:23000/tcdr/app?page=tcdr/productList
TSV631AILT | U7 | SOT-23-5L | 1 |  | STM |  | IC OPAMP GP 880KHZ,TSV631AILT,SOT-23-5L | STM | TSV631AILT |  |  | EAR99 | NEC | http://tcdr.sgp.st.com:23000/tcdr/app?page=tcdr/productList
STM32F207ZGT6 | U8 | LQFP144_0R5_SKT | 1 |  | STM |  | IC,STM32F207ZGT6,LQFP144 | STM | STM32F207ZGT6 |  |  | 3A991A2 | NEC | http://tcdr.sgp.st.com:23000/tcdr/app?page=tcdr/productList
LAN8742A-CZ-TR | U9 | QFN24_0R5_4X4 | 1 |  | Subcon |  | internet IC,LAN8742A-CZ-TR,SQFN-24,MICROCHIP | MICROCHIP | LAN8742A-CZ-TR |  |  | EAR99 | NEC | Avnet express
USBLC6-4SC6 | U10 | SOT23-6L | 1 |  | STM |  | diode array,USBLC6-4SC6,SOT23-6L | STM | USBLC6-4SC6 |  |  | EAR99 | NEC | http://tcdr.sgp.st.com:23000/tcdr/app?page=tcdr/productList
KMS-1102NL | U11 | Transformer | 1 |  | Subcon |  | transformer,KMS-1102NL,SMT | DGKYD | KMS-1102NL |  |  | NA | NA
STMPS2151STR | U12 | SOT-23-5L | 1 |  | STM |  | IC PWR SWITCH,STMPS2151STR,SOT23-5 | STM | STMPS2151STR |  |  | EAR99 | NEC | http://tcdr.sgp.st.com:23000/tcdr/app?page=tcdr/productList
NX3225GD-8.000M-EXS00A-CG04874 | X1 | OSC_2SM_3R2x2R5 | 1 |  | STM |  | Osccillator,NX3225GD-8MHz-EXS00A-CG04874,8MHz,8pF,SMT | NDK | NX3225GD-8MHz-EXS00A-CG04874 |  |  | NA | NA
NX3215SA-32.768KHZ-EXS00A-MU00525 | X2 | XTAL_2SM_3R2X1R5 | 1 |  | STM |  | Cystal,NX3215SA-32.768KHZ-EXS00A-MU00525,32.768K,6PF,3215,20PPM | NDK | NX3215SA-32.768KHZ-EXS00A-MU00525 |  |  | NA | NA
NX3225GD-8.000M-EXS00A-CG04874[N/A] | X3 | OSC_2SM_3R2x2R5 | 1 | [N/A] | STM |  |  |  |  |  |  | NA | NA
X53T-C20SSA-25.000MHz | X4 | XTAL_2SM_5R0X3R2 | 1 |  | Subcon |  | Cystal,5032,25MHZ,20PF,30PPM,ESR<30R,X53T-C20SSA-25.000MHz,SMT | Jfvny | X53T-C20SSA-25.000MHz |  |  | NA | NA
IC149-144-045-B5 | MCU socket |  | 1 | [N/A] | Subcon |  |  |  |  |  |  | NA | NA
Stick for Board name |  |  | 1 | Board name:NUCLEO-F207ZG | Subcon |  | serils label,6mm width,8m long | brother |  |  |  | NA | NA
blister |  |  | 1 |  | Subcon |  | blister,MB1137,25.3cm*2*16.5cm |  |  |  |  | NA | NA
insert card |  |  | 1 |  | Subcon |  | insert card,MB1137,20cm*13.5cm |  |  |  |  | NA | NA
short linker |  |  | 10 |  | Subcon |  | short linker,2.54MM,1U, | Harwin | M7566-05/M7571-05 |  |  | NA | NA
PCB |  |  | 1 |  | Subcon |  | PCB,MB1137,RevB,6layers,70*134mm, white solder,blue silkscreen | HopeSearch |  |  |  | NA | NA
button hat,BLUE, |  |  | 1 |  | Subcon |  | button hat,BLUE, |  |  |  |  | NA | NA
button hat,BLACK, |  |  | 1 |  | Subcon |  | button hat,BLACK, |  |  |  |  | NA | NA
test label |  |  | 1 |  | Subcon |  | test label,five cells, T1,T2,T3,T4,QA, |  |  |  |  | NA | NA

Sheet: Assembly req.
Bill of Materials
Source Data From:
Project:
Variant: |  | None
Creation Date: | 08/27/2012 | 13:33:45
Print Date: | 2016-03-03 | 16:38:18
MB1137B-01 Assembly Requirement
Comment | Designator | Footprint | Quantity | Assembly | Ordered by | Comments
 | JP1 | HDR_1x2_2R54_V_M_S | 1 | open | Subcon | PWR_EXT not connected to 3.3V STLINK
 | JP3 | HDR_3x2_2R54_V_M | 1 | 3<->4 | Subcon | Power source from U5V
 | JP4 | HDR_1x2_2R54_V_M_S | 1 | close | Subcon | USB GPIO on PG7
 | JP5 | HDR_1x2_2R54_V_M_S | 1 | close | Subcon | Idd measurment disable
 | JP6 | HDR_1x2_2R54_V_M_S | 1 | close | Subcon | RMII or COMP function on PA7
 | JP7 | HDR_1x2_2R54_V_M_S | 1 | close | Subcon | RMII_TXD1 on PB13
 | CN2, CN3 | HDR_1x2_2R54_V_M | 2 | close on bottom side | Subcon | GOUND PINS
 | CN4 | HDR_1x4_2R54_V_M | 1 | close | Subcon | Nucleo selected
 | CN11, CN12 | HDR_2x36_2R54_V_M | 2 | Pin71,72 closed | Subcon | GOUND PINS, as CN2,CN3
