irec-duster/RORO/mass-budget.xlsx

Sheet: Measured Mass budget RORO1
 |  | weitght [kg] |  | margin | weight with margin [kg]
Nosecone | nosecone | 0.915 | measured | 1 | 0.915 |  | 3.341 | nose
 | electronics | 1.611 | measured | 1 | 1.611
 | cable with connector | 0.15 | measured | 1 | 0.15
 | rail | 0.442 | measured | 1 | 0.442
 | slider | 0.169 | measured | 1 | 0.169
 | central M8 bolt with nuts | 0.054 | measured | 1 | 0.054
Upper body | Upper body with threaded rods | 2.455 | measured | 1 | 2.455 |  | 6.258 | upper
 | parachute | 1.6 | measured | 1 | 1.6
 | payload box | 0.611 | measured | 1 | 0.611 |  | 1.017 | payload glider
 | payload glider | 0.406 | measured | 1 | 0.406
 | Recovery bay with batteries & co2 | 0.994 | measured | 1 | 0.994
 | Recovery bulkhead screws and parachute eyebolts | 0.192 | measured | 1 | 0.192
lower body | Lower Body with retainer, threaded rods | 4.292 | measured | 1 | 4.292 |  | 8.316 | lower
 | gopro bulkhead with gopro and backup battery | 0.354 | measured | 1 | 0.354
 | gopro bulkhead screws | 0.04 | measured | 1 | 0.04
 | eybolts for recovery | 0.152 | measured | 1 | 0.152
 | payload tungsten block | 3.089 | measured | 1 | 3.089 |  | 3.333 | 1U payload total
 | payload battery & imu | 0.217 | measured | 1 | 0.217
 | payload nuts | 0.015 | measured | 1 | 0.015
 | small camera | 0.012 | measured | 1 | 0.012
 | railguides | 0.04 | measured | 1 | 0.04
Color |  | 0.105 | measured | 1 | 0.105
 | Total | 17.915 |  |  | 17.9 | total with margin
 |  |  |  |  | 1.05 | system margin
 |  |  |  |  | 18.8 | total with system margin
 |  |  |  |  | 0.9 | estimated trim weight
 |  |  |  |  |  |  |  |  | RockSim | Thurstcurve.org
 |  |  |  | M2400T | 20 | ideal weight |  | Motor weight | 6.483 | 6.451
 |  |  |  |  | 1.19 | trim weight |  | propellant weight | 3.693 | 3.693
 |  |  |  |  | 2.09 | trim weight plus margin |  | case (difference) | 2.79 | 2.758
 |  |  |  |  | 26.48 | Lift off weight
 |  |  |  |  | 22.79 | After burnout
 |  |  |  |  |  |  |  |  | RockSim | Thurstcurve.org
 | Total weight without payload & motor | 18.983 |  | M2100G |  |  |  | Motor weight | 7.030 | 6.918
 |  |  |  |  |  |  |  | Propellant weight | 3.000 | 3.948
 |  |  |  |  |  |  |  | burnout weight | 4.030 | 2.970

Sheet: Initial Mass budget RORO1
Component | weight | source
Nose | 1.994
Structure | 0.994
Nosecone | 0.594 | measured
Nosecone Bulkhead & electronics mount | 0.4 | estimate
Avionics | 1
total with batteries | 1 | estimate, TBC
Upper Body | 9.563
Structure | 2.143
Phenolic tube, 115cm with carbon reinforcement | 1.563 | measured
Recovery/payload bulkhead | 0.48 | estimated
Nosecone release bars | 0.1 | estimated
Recovery | 1.42
Recovery structure/bulkhead | 0.3 | estimate
Recovery batteries 4x 2s 300mAh | 0.1 | estimated based on 2200mAh battery
Recovery avionics (altimax & Raven) | 0.02 | datasheet
Cables, including cables going to wirecutter | 0.1 | estimate
CO2 system 25g CO2, 2x | 0.2 | estimate based on measured 12g CO2 cartridge
Parachutes Main + drogue + bag | 0.7 | measured
Payload | 4 | Requirement
Trim Weight | 2
Lower Body
Structure | 3.323
Phenolic tube, 90cm with carbon reinforcement | 1.154 | measured
upper bulkhead | 0.441 | measured
coupler tube with carbon reinforcement | 0.46 | measured
motor tube 70cm | 0.311 | measured, scaled
centering rings 5x, 4mm plywood | 0.07 | measured
fin forward bulkhead 12mm plywood (with nuts) | 0.116 | measured
thrust plate 3mm aluminium | 0.08 | measured
fins, 9mm plywood with balsa core, + cfrp reinforcemnt | 0.371 | measured | 124, 125, 122g
fins carbon fiber reinforced attachement | 0.2 | estimated
aeropack retainer with screws | 0.12 | forum, scaled
Total (without motor) | 14.880
Motor options: |  | http://www.aerotech-rocketry.com/images/09-10_aerotech_catalog.pdf
K1999N-PS | 2.989
propellant | 1.195
RMS-98/2560 | 1.794 | 1.14 | 0.654
L1300R-PS | 4.884
propellant | 2.508
RMS-98/5120 | 2.376 | 1.53 | 0.846
M2100G-PS | 6.912
propellant | 3.948
RMS-98/7680 | 2.964 | 1.926 | 1.038
 |  | tube weights | rest

Sheet: Payload Budget
Component | Mass (g) | Cost (EUR)
Autopilot | 10.54 | 100
Pitot tube | 6 | 20
Servomotors x 3 | 13.5 | 90
UBLOX | 23 | 350 | https://drotek.com/shop/en/drotek-parts/792-xl-rtk-gps-neo-m8p-rover.html
Xbee | 4 | 50 | http://www.mouser.ch/ProductDetail/Digi-International/XB8-DMUS-002/
Battery | 36 | 5
Cabling | 2 | 2
Mounting | 10 | 3
Antenna | 1 | 10
Wing | 100 | 30
Hinges + locking mech | 10 | 4
Camera | 20 | 30
Total without margin | 236.04 | 694
Total with 20% margin | 283.248 | 832.8
Ground Station GPS RTK |  | 350

Sheet: Component weights
Component | weight (kg) | how | comments/dimensions
Structure
tube 10cm | 0.407 | measured | 91.5cm long
tube 10cm gfk reinforced | 0.8 | measured | 91.5cm long
tube 15cm | 1.022 | measured | 122cm long
nosecone 15cm gfk | 0.594 | measured
nosecone bulkhead with lug | 0.232 | measured
coupler 15cm | 0.301 | measured | 30cm long
coupler 10 | 0.072 | measured | 18cm long
nosecone 10chm plastic | 0.295 | measured
lipo 2cell 2200mAh | 0.13 | measured | found at espace
Aeropack Retainer 75mm | 0.09 | http://www.rocketryforum.com/showthread.php?131551-Aero-Pack-75mm-Retainer-P
Recovery
parachute assembly (main+drogue) | 0.721 | measured | with 2 rings, 1 coupler, 1cable cutter
CO2 charge
Recovery System (Altimax G3) | 0.013 | datasheet
Backup recovery system (Raven3) | 0.0066 | datasheet
Chord 3m | 0.038 | measured
Chord 5m | 0.062 | measured
16g CO2 | 0.059 | measured
m8 threaded rod: 87.3g / 283mm | 0.3084805654 | g/mm
plywood birch (thick) | 0.000654929855 | g/mm3
