irec-duster/RORO/RORO_1/Snapshots/PartsOfRocket.png

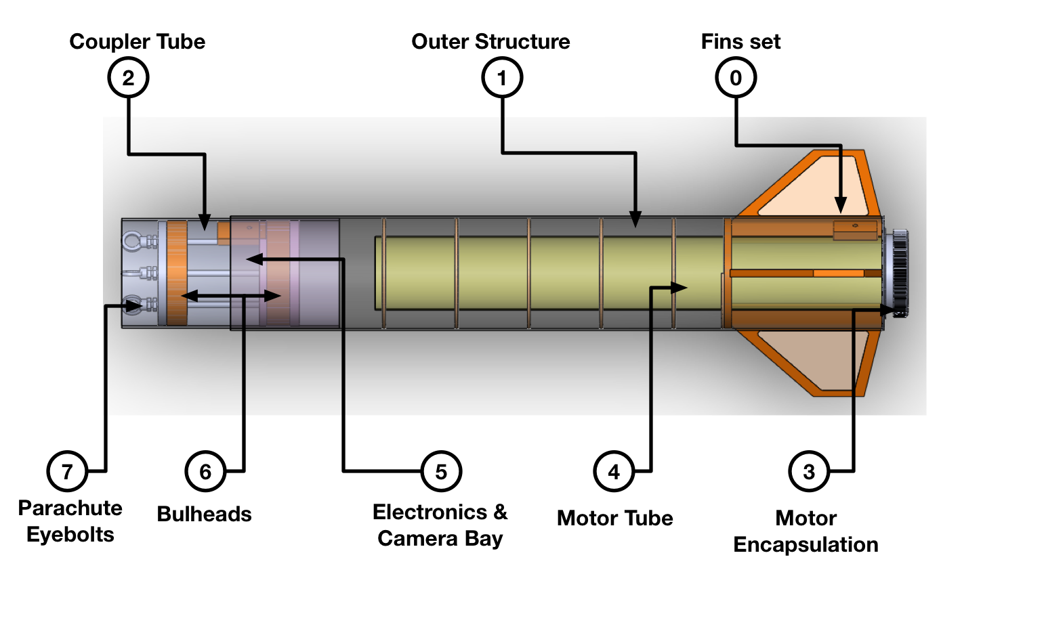
RORO_1/Snapshots/PartsOfRocket.png
