irec-duster/RORO/Avionics_RORO/CAD/Nosecone/3100_Locking system/3100_Assembly_locking_system.SLDASM

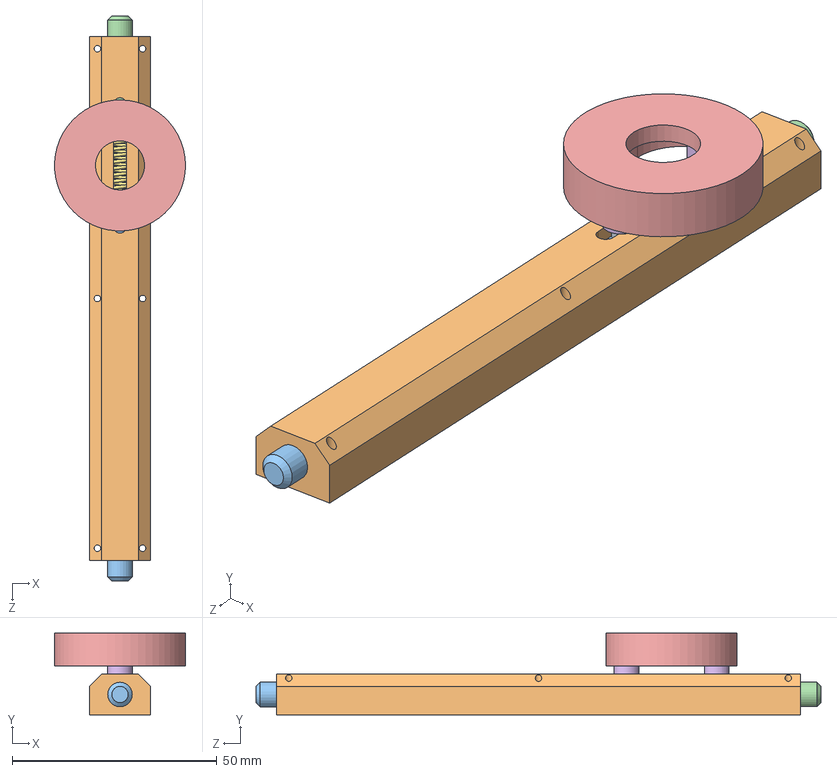
[picture p56: CAD file, 2017-05-22]
Avionics_RORO/CAD/Nosecone/3100_Locking system/3100_Assembly_locking_system.SLDASM
32.0 x 20.0 x 138.0 mm
parallel pin hardened_din x 2
3101_Guide
3102_Rod_big
3103_Rod_small
3104_Came
3105_Wheel x 2
compression_spring_d21680-x
