irec-duster/RORO/Avionics_RORO/CAD/Nosecone/3400_Rail/3400_Assembly_rail.SLDASM

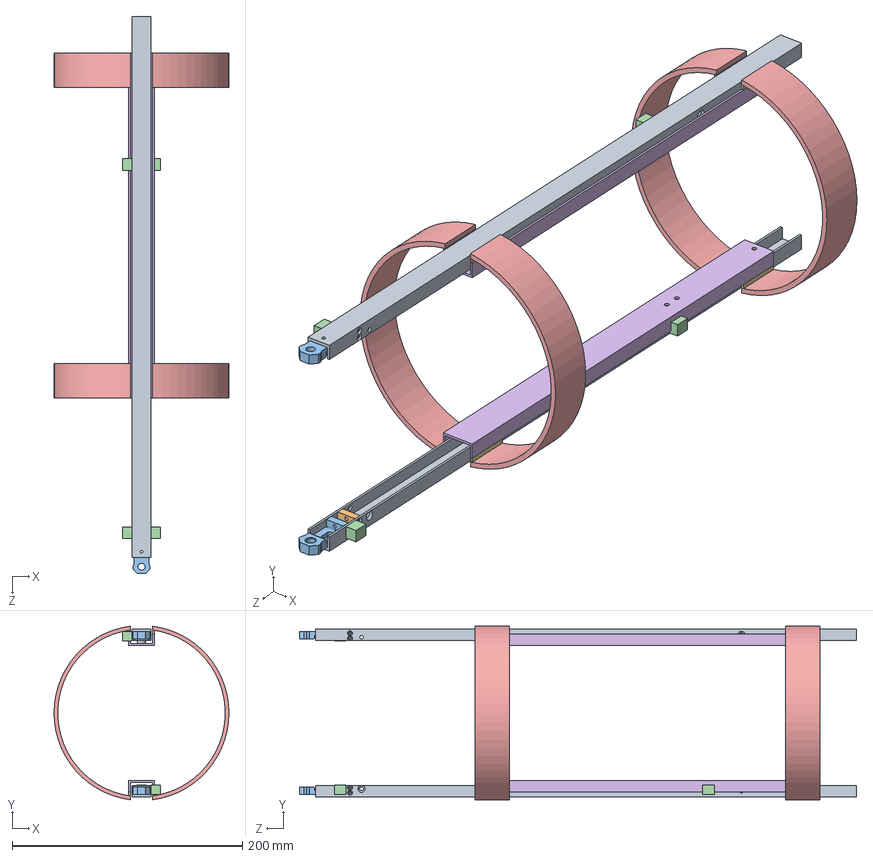
[picture p57: CAD file, 2017-05-22]
Avionics_RORO/CAD/Nosecone/3400_Rail/3400_Assembly_rail.SLDASM
152.0 x 150.7 x 484.0 mm
3401_U_rail x 2
3403_Suport_hook x 2
3404_Hook x 2
Upper rail screws mass x 4
3501_Coupler x 2
3503_Support_2 x 2
3504_woodplate x 8
3502_Support_1 x 2
nylon_bumper
flat head screw_am x 2
hex nut style 1_am
