irec-duster/RORO/Avionics_RORO/CAD/Nosecone/3500_Gliding_structure/3550_gliding_structure_assembly.SLDASM

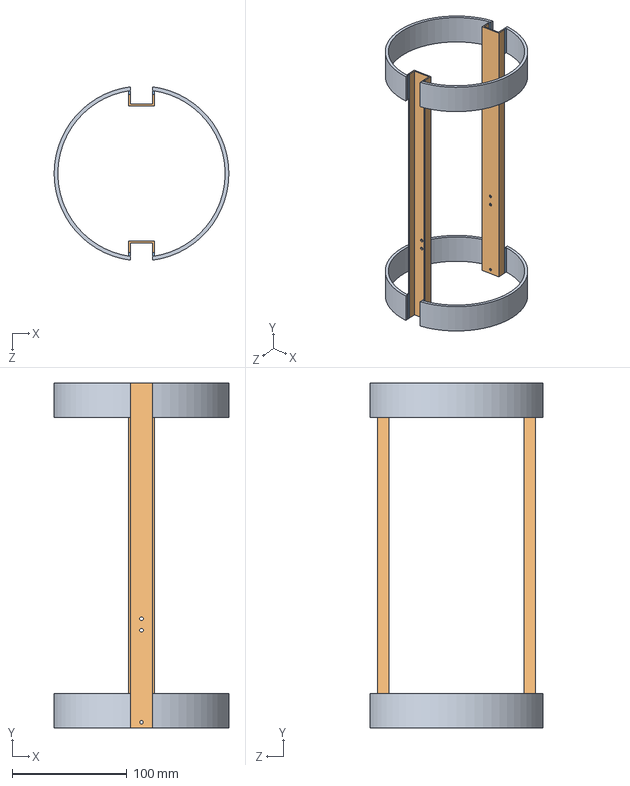
[picture p58: CAD file, 2017-05-19]
Avionics_RORO/CAD/Nosecone/3500_Gliding_structure/3550_gliding_structure_assembly.SLDASM
152.0 x 300.0 x 150.7 mm
3501_Coupler x 2
3503_Support_2 x 2
3504_woodplate x 8
