irec-duster/RORO/payload/for3dprinting/10May/assembly_trailing_edge.SLDASM

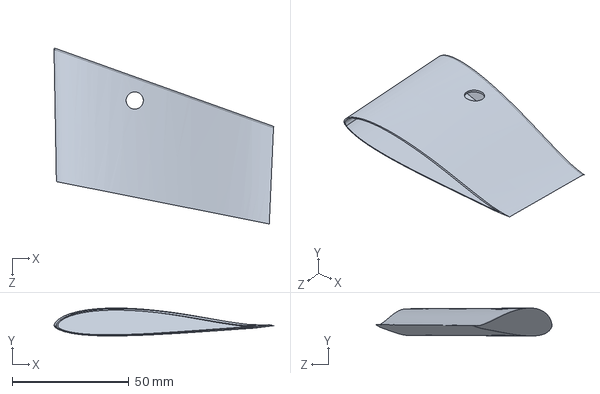
[picture p59: CAD file, 2017-05-12]
payload/for3dprinting/10May/assembly_trailing_edge.SLDASM
94.4 x 12.0 x 75.5 mm
