irec-duster/RORO/RORO_1/GoPro_Hero5_SW/GoPro_Hero5_1.SLDASM

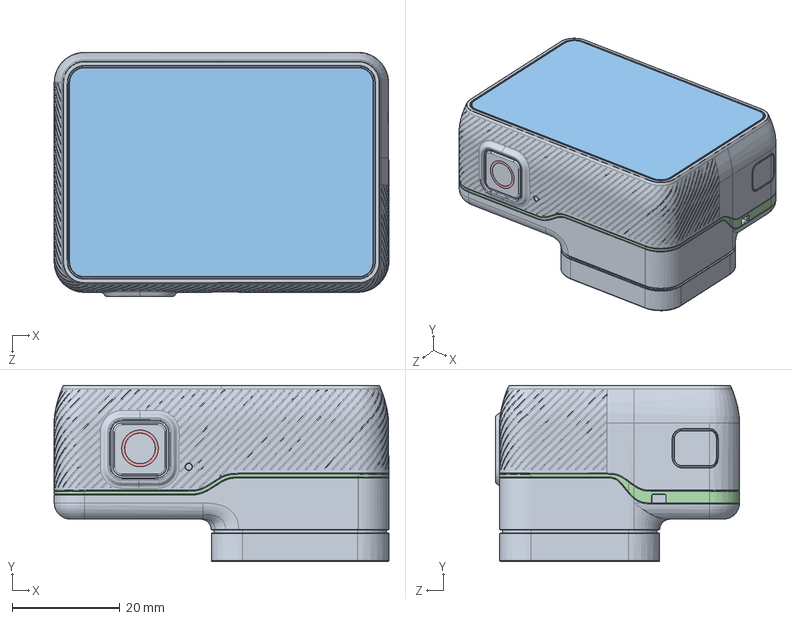
[picture p61: CAD file, 2017-05-17]
RORO_1/GoPro_Hero5_SW/GoPro_Hero5_1.SLDASM
62.1 x 32.7 x 45.3 mm
GoPro_Hero5Hero5
GoPro_Hero5Hero5_LCD
GoPro_Hero5Hero5_screen
GoPro_Hero5Hero5_seal
GoPro_Hero5Hero5_shotring
