irec-duster/RORO/RORO_2/GA_RORO2.SLDASM

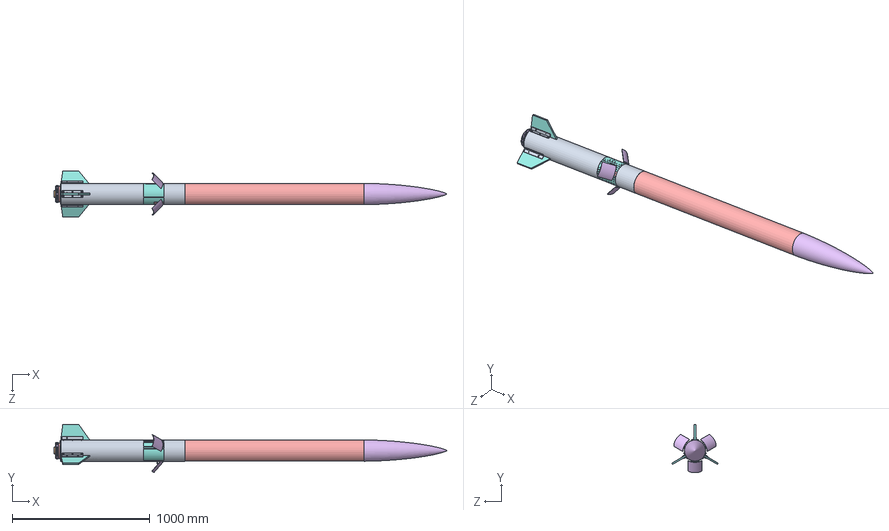
[picture p62: CAD file, 2017-03-23]
RORO_2/GA_RORO2.SLDASM
2849.2 x 351.5 x 336.3 mm
21001_LOWER BODY TUBE
21101_MOTOR
21201_MOTOR TUBE
21106_thrust-plate-custom
21103_MOTOR RETAINER
21104 _MOTOR RETAINER LID
21002_COUPLING TUBE
Fin_2 x 3
Fin guide x 6
Under fin part x 3
socket countersunk head screw_din x 24
socket head cap screw 4762_din x 5
21401_BRAKE x 3
21402_ACTIVE CONTROL INNER SUPPORT
21405_Screw Rod x 3
21403_SERVOMOTOR
21406_LINEAR SCREW
21407_LINEAR BOLT
22001_UPPER BODY TUBE
23001_NOSECONE
