irec-duster/RORO/payload/BallBearingMacros/W 619_3-2Z.sldasm

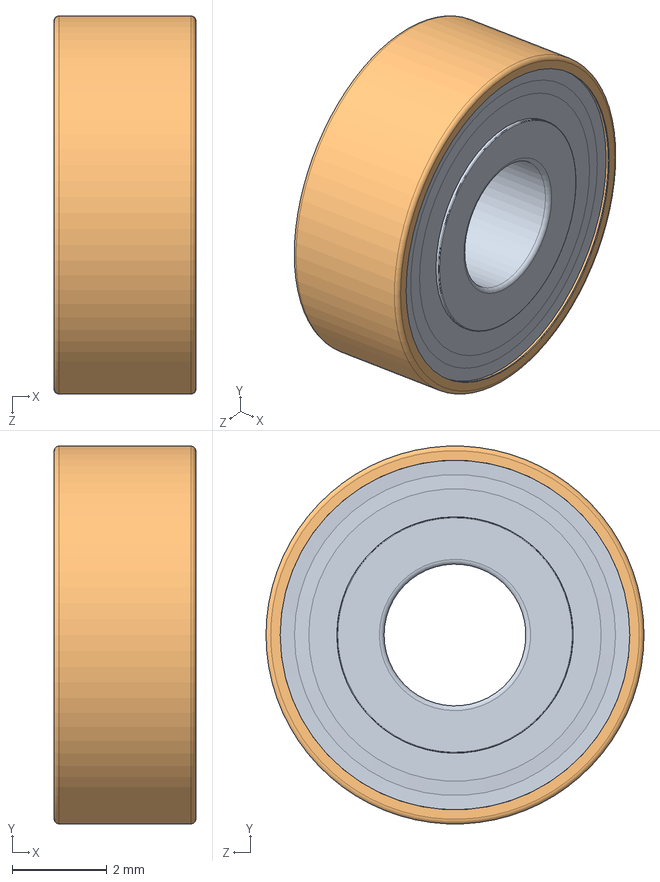
[picture p63: CAD file, 2017-04-27]
payload/BallBearingMacros/W 619_3-2Z.sldasm
3.00 x 7.99 x 8.00 mm
W 619_3-2Z_PART1
W 619_3-2Z_PART2
W 619_3-2Z_PART3 x 7
