irec-duster/RORO/payload/forTesting(Simplifiedmodels)/test1_main.SLDPRT

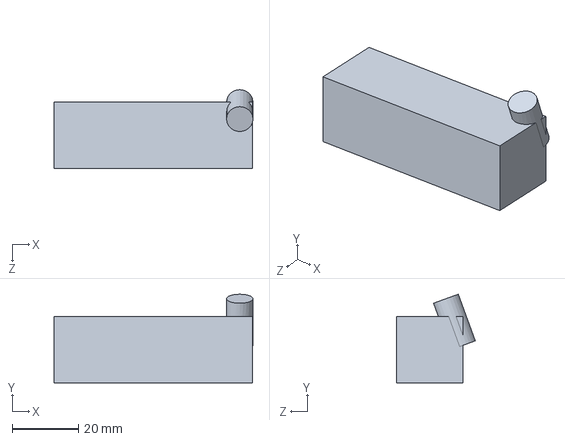
[picture p64: CAD file, 2017-04-11]
payload/forTesting(Simplifiedmodels)/test1_main.SLDPRT
60.1 x 26.8 x 23.8 mm
