irec-duster/RORO/payload/forTesting(Simplifiedmodels)/test_assembly.SLDASM

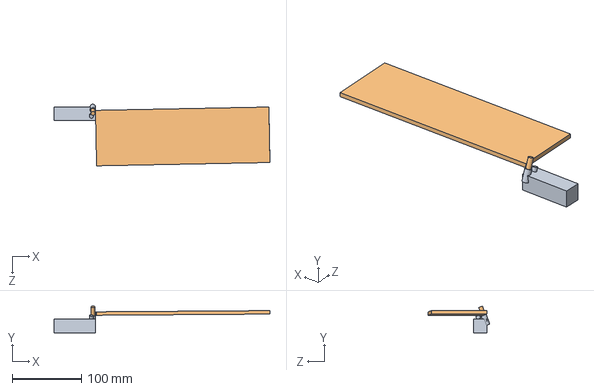
[picture p65: CAD file, 2017-04-11]
payload/forTesting(Simplifiedmodels)/test_assembly.SLDASM
311.3 x 38.7 x 88.9 mm
test1_main
test1
