irec-duster/RORO/payload/prototyping/wing_bb_asm.SLDASM

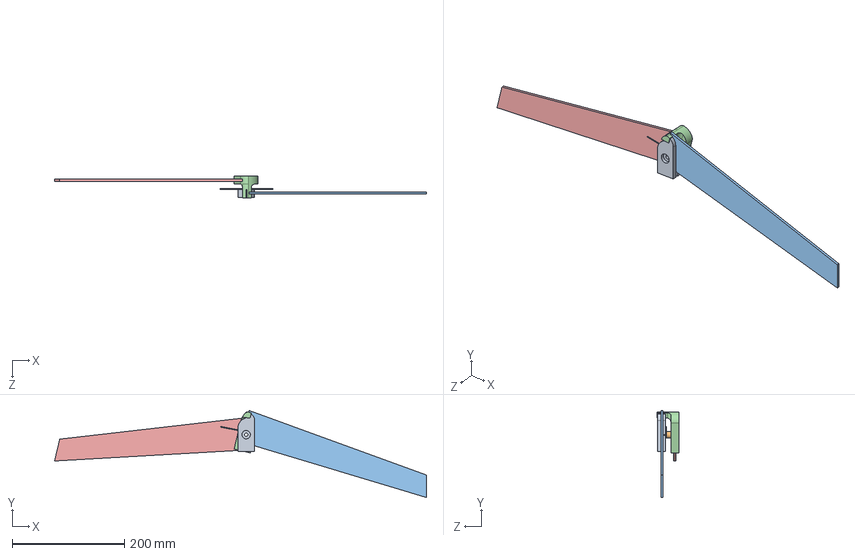
[picture p66: CAD file, 2017-06-02]
payload/prototyping/wing_bb_asm.SLDASM
662.3 x 155.0 x 40.0 mm
wing_up
spring
wing_right
wing_down
wing_left
