irec-duster/RORO/RORO_1/3000_nose.SLDASM

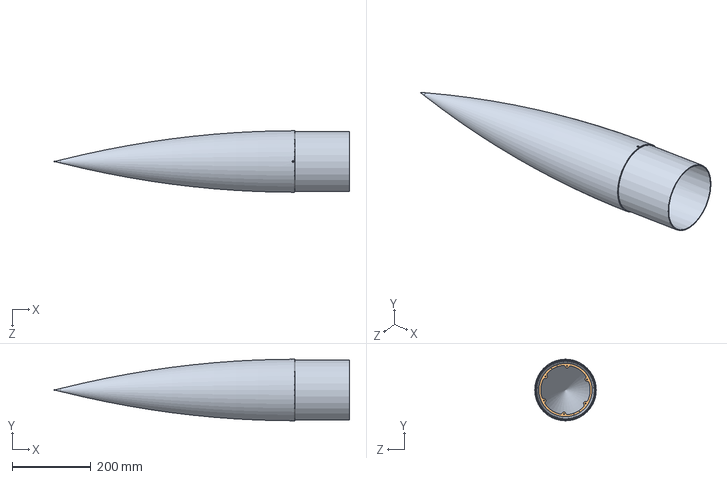
[picture p67: CAD file, 2017-07-04]
RORO_1/3000_nose.SLDASM
747.6 x 156.0 x 156.0 mm
3001_NOSECONE
3002_bulkhead
