irec-duster/RORO/Avionics_RORO/CAD/Nosecone/3500_Gliding_structure/3500_Gliding_structure_assembly.SLDASM

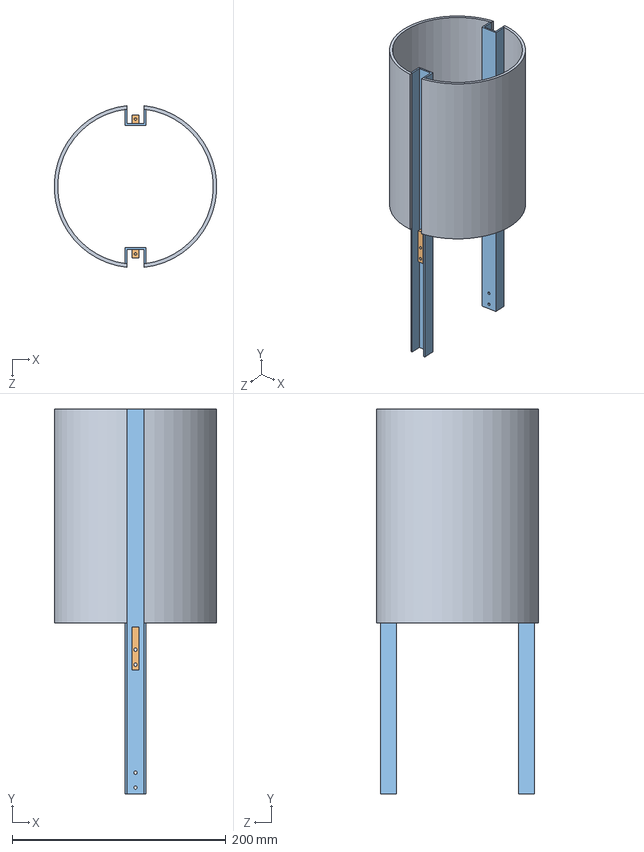
[picture p68: CAD file, 2017-05-07]
Avionics_RORO/CAD/Nosecone/3500_Gliding_structure/3500_Gliding_structure_assembly.SLDASM
151.7 x 360.0 x 151.2 mm
3501_Coupler
3502_Support_1 x 2
3503_Support_2 x 2
