irec-duster/RORO/payload/HS85MG/HS85MG.SLDASM

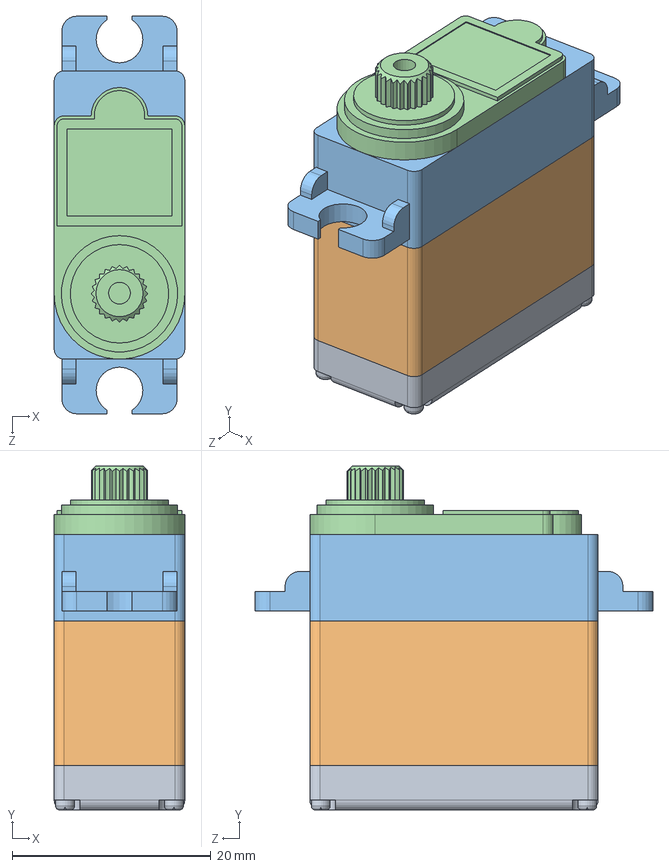
[picture p69: CAD file, 2017-05-07]
payload/HS85MG/HS85MG.SLDASM
13.1 x 34.6 x 40.0 mm
HS85MG_bottom
HS85MG_midle
HS85MG_upper
HS85MG_top
