irec-duster/RORO/RORO_2/Active control/1400_ACTIVE CONTROL.SLDASM

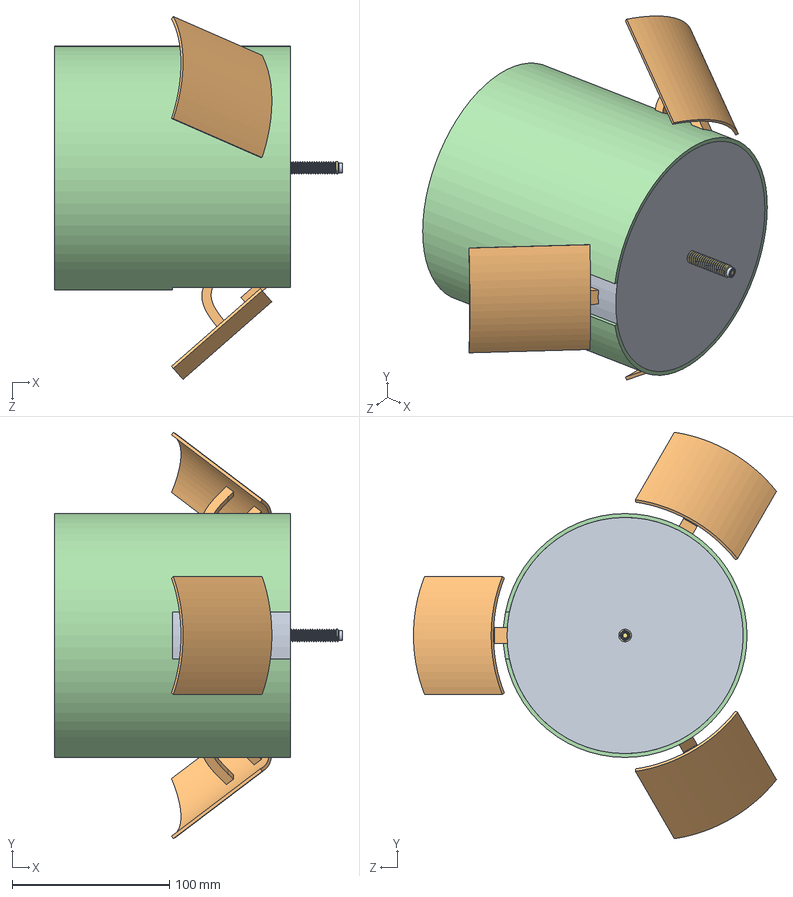
[picture p70: CAD file, 2017-05-17]
RORO_2/Active control/1400_ACTIVE CONTROL.SLDASM
183.0 x 258.2 x 230.6 mm
21401_BRAKE x 3
21402_ACTIVE CONTROL INNER SUPPORT
21405_Screw Rod x 3
21403_SERVOMOTOR
21406_LINEAR SCREW
21407_LINEAR BOLT
instrument ball bearing_ai x 2
