irec-duster/RORO/RORO_1/1100_PROPULSION.sldasm

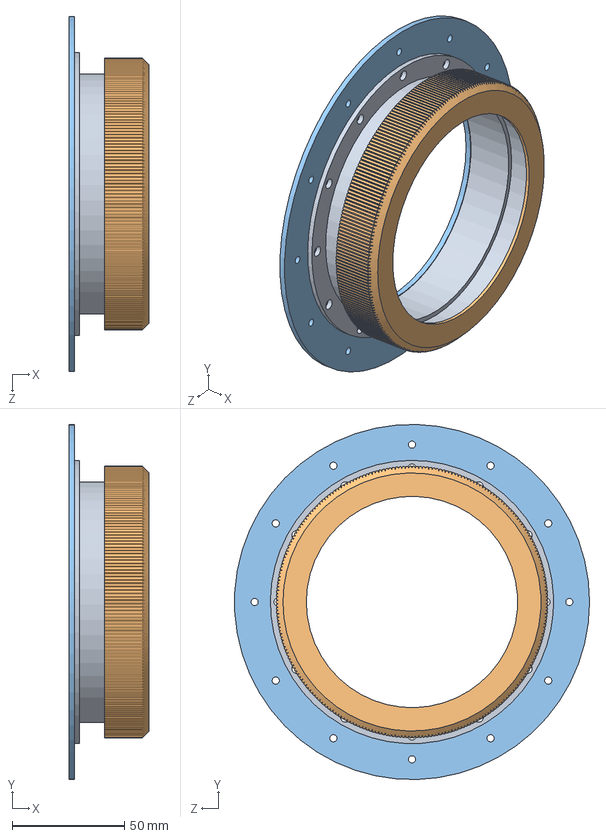
[picture p71: CAD file, 2017-07-04]
RORO_1/1100_PROPULSION.sldasm
35.8 x 157.9 x 158.0 mm
1103_MOTOR RETAINER
1104 _MOTOR RETAINER LID
1107_thrust-plate-custom-with-retainer-holes
