irec-duster/RORO/payload/BallBearingMacros/604-2Z.sldasm

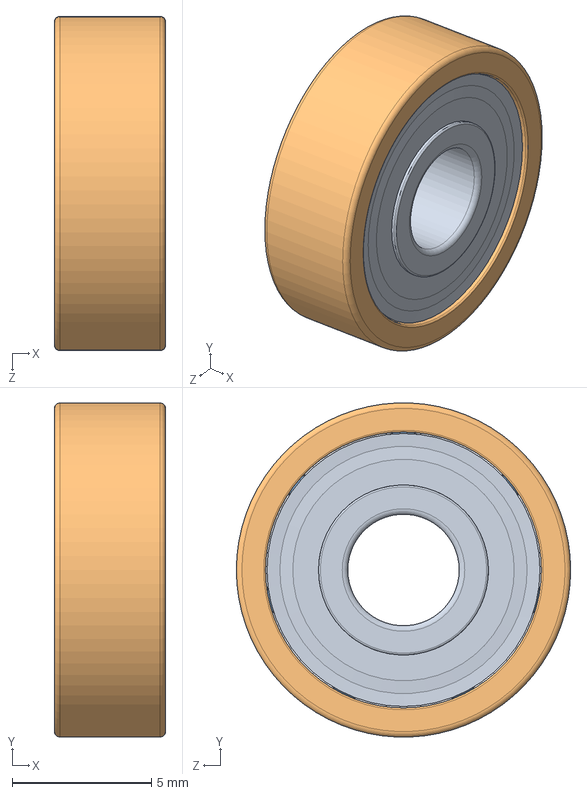
[picture p72: CAD file, 2017-04-16]
payload/BallBearingMacros/604-2Z.sldasm
4.00 x 12.0 x 12.0 mm
604-2Z_PART1
604-2Z_PART2
604-2Z_PART3 x 7
