irec-duster/RORO/RORO_1/0000_RORO1.SLDASM

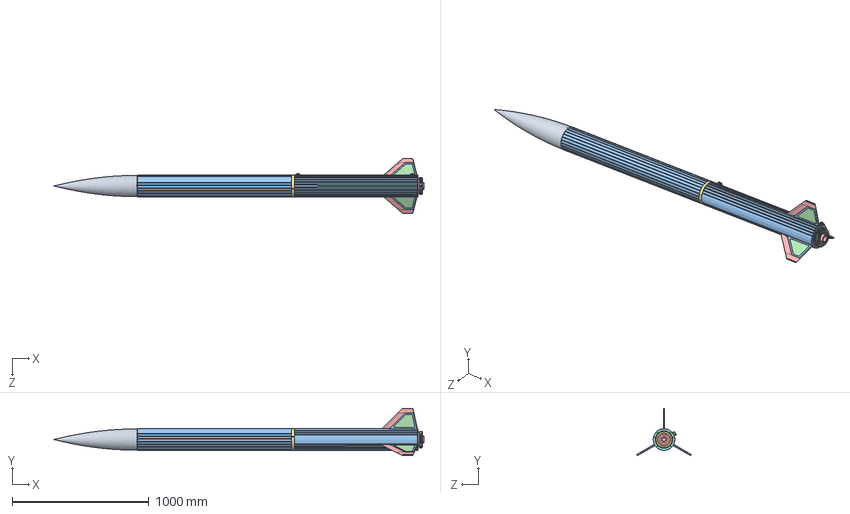
[picture p73: CAD file, 2017-07-04]
RORO_1/0000_RORO1.SLDASM
2707.8 x 347.3 x 400.6 mm
3001_NOSECONE
3002_bulkhead
2001_upper-body-tube
2002_parachutes
2003_upper_body_bulkhead
bulkhead glue & reinforcement^2000_upper_body
2101_Recovery_bulkhead
2103_Peregrine_Raptor_CO2 x 2
2105_AltimaxG3_avionics
2107_AltimaxG3_mount
2106_Raven3_avionics
2110_Switch_SCHURTER_33-4504 x 3
2109_9V_battery x 4
2113_upper_mountign_plate
2108_Raven3_mount
2111_Switch_mount
2114_mounting_reinforcement
2004_threaded_rod_recovery_attachment x 3
2005_parachute_eyebolt x 6
2102_Recovery_bulkhead_mount
2006_payload_placeholder
carbon reinforcement^2000_upper_body
1001_LOWER BODY TUBE
1201_MOTOR TUBE
1202_CENTERING RING x 5
1302_CENTERING RING M
1303_fin_forward_bulkhead_nuts_fixation
1101_AeroTech_RM98_7680
1103_MOTOR RETAINER
1104 _MOTOR RETAINER LID
1107_thrust-plate-custom-with-retainer-holes
1401_coupler_tube
1402_lower-body-bulkhead
1403_coupler_lid
1407_GoPro_case
1406_coupler_lid_mount
1003_upper_launch_lug_attachment
1409_threaded_rod_recovery_attachment x 3
lower-body-bulkhead-glue^1400_coupler
1405_lower-body-bulkhead-nut-fixation
1506_payload_1U_weight
1204_FIN x 3
1205_fin_core x 3
1206_fin_extension x 3
1002_lower_launch_lug_attachment
coupler glue^1000_lower_body
fin_glue_and_reinforcement^1000_lower_body
1108_thrust_plate_inner_alignment x 3
1004_launch_lug x 2
paint^0000_RORO1
