irec-duster/RORO/payload/prototyping/wing_bb_cutout_gps.SLDASM

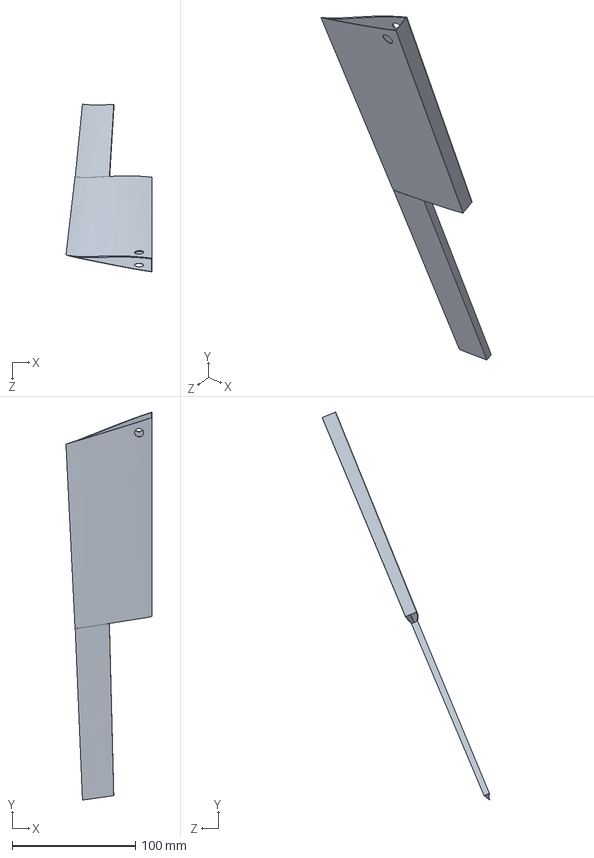
[picture p74: CAD file, 2017-05-31]
payload/prototyping/wing_bb_cutout_gps.SLDASM
70.0 x 315.4 x 136.4 mm
