irec-duster/RORO/RORO_2/Fin assembly_2.SLDASM

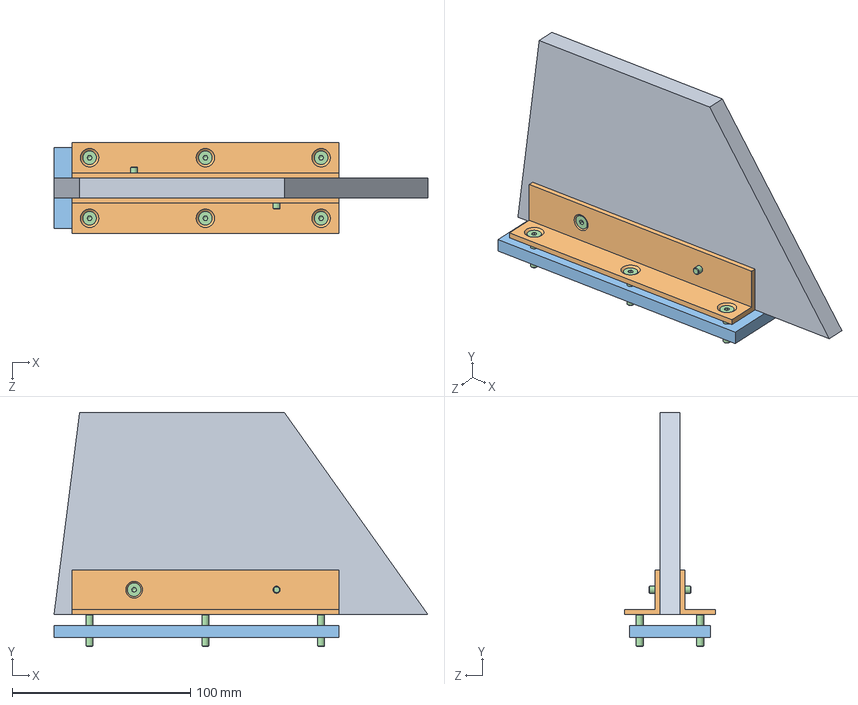
[picture p75: CAD file, 2017-03-22]
RORO_2/Fin assembly_2.SLDASM
210.0 x 131.4 x 51.0 mm
Fin_2
Fin guide x 2
Under fin part
socket countersunk head screw_din x 8
