irec-duster/RORO/payload/for3dprinting/10May/assembly_leading_edge.SLDASM

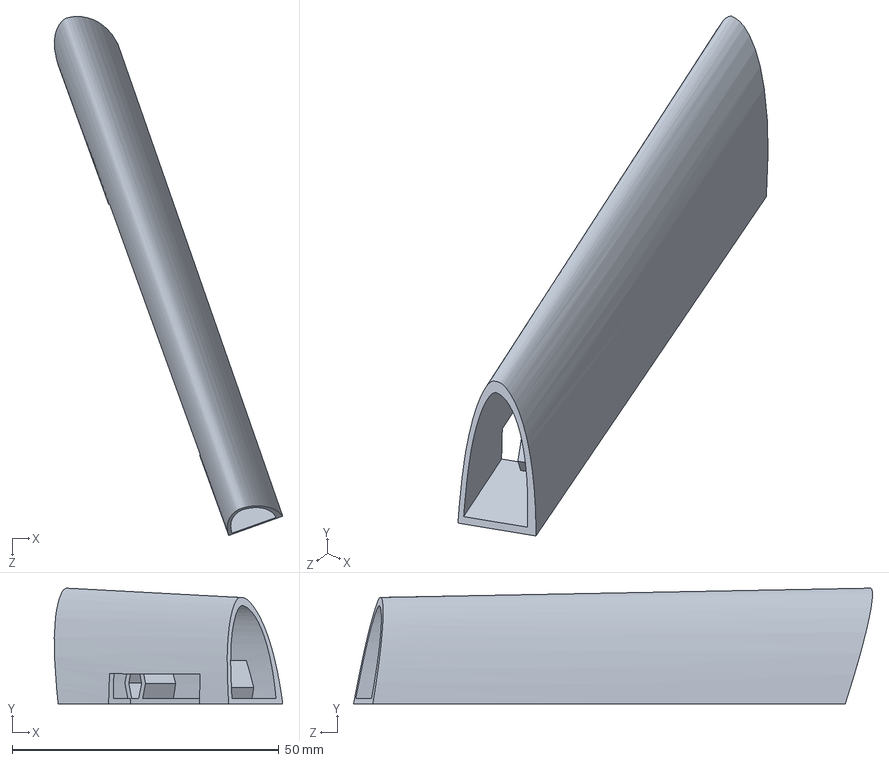
[picture p76: CAD file, 2017-05-12]
payload/for3dprinting/10May/assembly_leading_edge.SLDASM
42.9 x 21.7 x 97.4 mm
