irec-duster/RORO/payload/prototyping/trailing_edge_fixed_on_planes.SLDASM

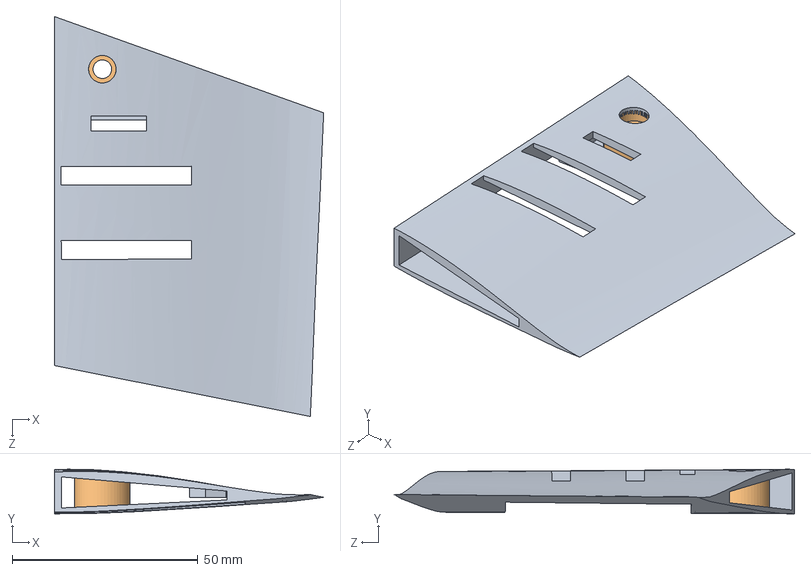
[picture p77: CAD file, 2017-05-31]
payload/prototyping/trailing_edge_fixed_on_planes.SLDASM
72.4 x 12.0 x 107.6 mm
32001_wing_left
320023_two_bb_mounting_in_the_wing
