irec-duster/RORO/RORO_2/active control/active control fin.SLDASM

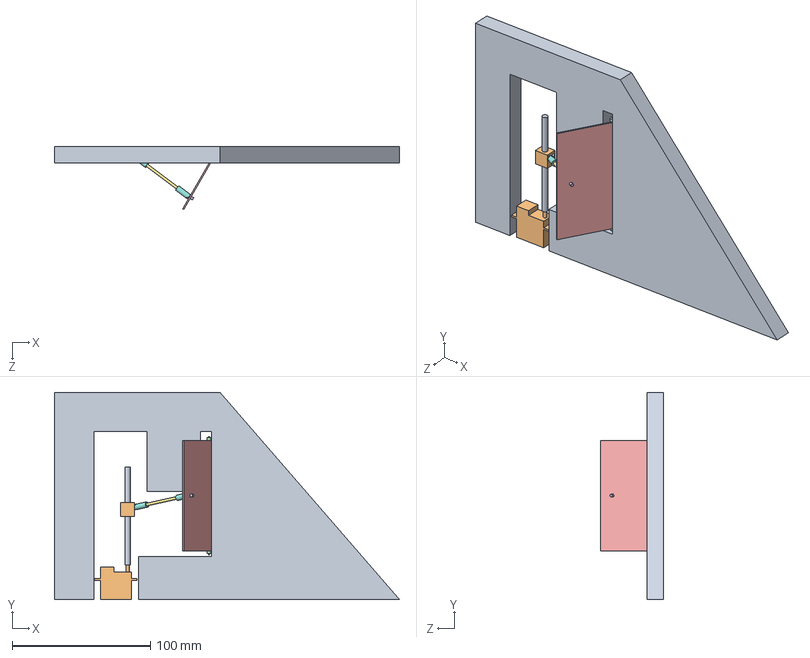
[picture p78: CAD file, 2017-03-07]
RORO_2/active control/active control fin.SLDASM
250.0 x 150.0 x 45.6 mm
fin empty
Servo motor MKS DS6100
Pièce5 x 2
Copie de Pièce1 x 2
flaps_symetry
tête à bille x 2
tige d'ouverture
rotule x 2
vis sans fin
écrou mobile
