irec-duster/RORO/RORO_1/2000_upper_body.SLDASM

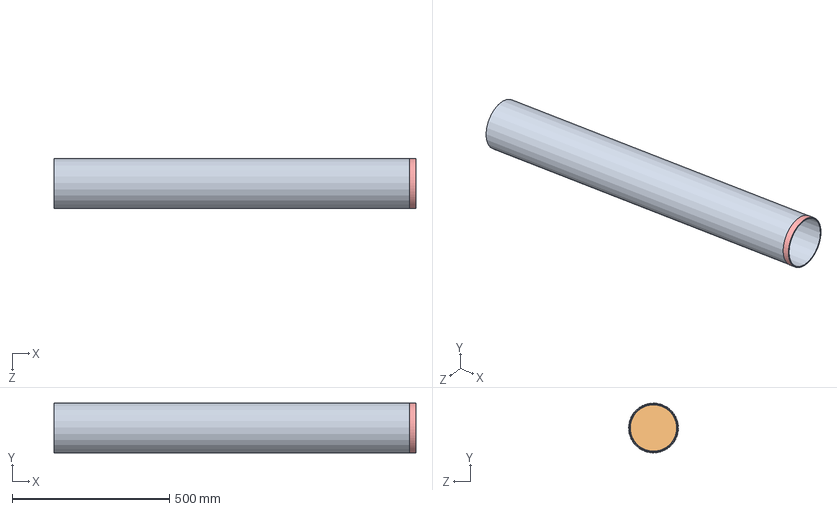
[picture p79: CAD file, 2017-07-04]
RORO_1/2000_upper_body.SLDASM
1150.0 x 158.5 x 158.5 mm
2001_upper-body-tube
2002_parachutes
2003_upper_body_bulkhead
bulkhead glue & reinforcement^2000_upper_body
2101_Recovery_bulkhead
2103_Peregrine_Raptor_CO2 x 2
2105_AltimaxG3_avionics
2107_AltimaxG3_mount
2106_Raven3_avionics
2110_Switch_SCHURTER_33-4504 x 3
2109_9V_battery x 4
2113_upper_mountign_plate
2108_Raven3_mount
2111_Switch_mount
2114_mounting_reinforcement
2004_threaded_rod_recovery_attachment x 3
2005_parachute_eyebolt x 3
2102_Recovery_bulkhead_mount
2006_payload_placeholder
carbon reinforcement^2000_upper_body
