irec-duster/RORO/RORO_1/1200_fin.SLDASM

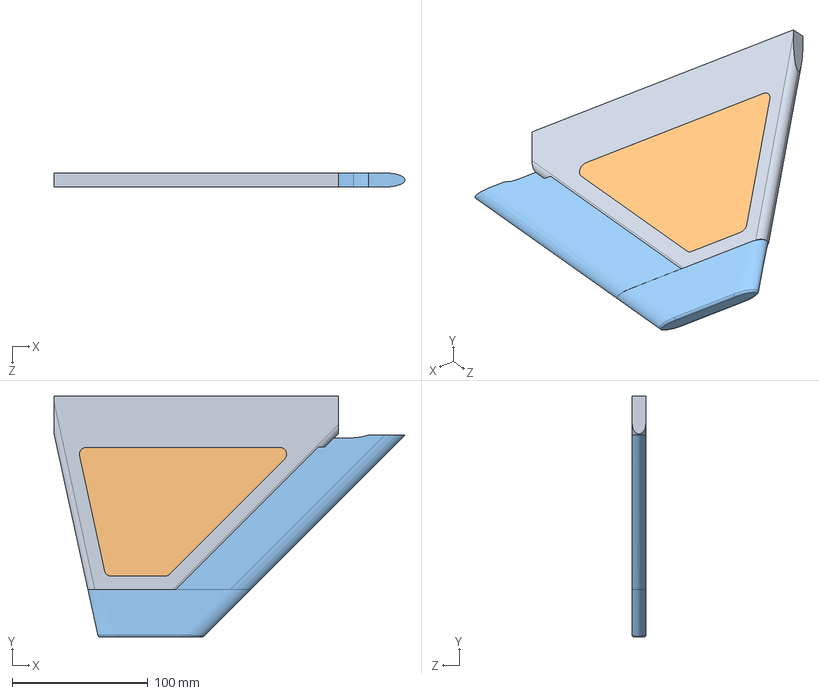
[picture p80: CAD file, 2017-06-10]
RORO_1/1200_fin.SLDASM
259.0 x 177.8 x 10.5 mm
1204_FIN
1205_fin_core
1206_fin_extension
