irec-duster/RORO/RORO_1/1400_coupler.SLDASM

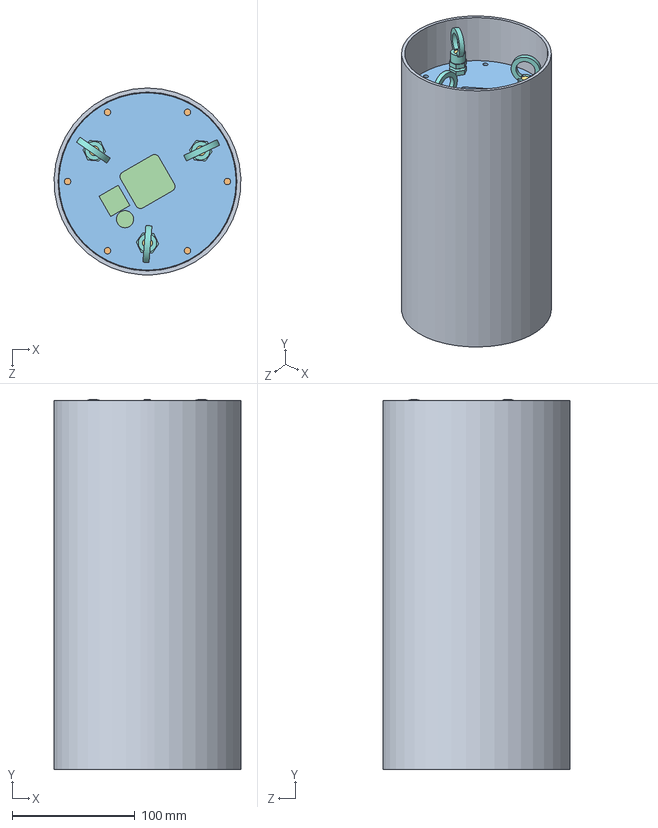
[picture p81: CAD file, 2017-06-10]
RORO_1/1400_coupler.SLDASM
151.9 x 300.9 x 152.0 mm
1401_coupler_tube
1402_lower-body-bulkhead
1403_coupler_lid
1407_GoPro_case
1406_coupler_lid_mount
1003_upper_launch_lug_attachment
1409_threaded_rod_recovery_attachment x 3
2005_parachute_eyebolt x 3
lower-body-bulkhead-glue^1400_coupler
1405_lower-body-bulkhead-nut-fixation
1506_payload_1U_weight
