irec-duster/RORO/RORO_1/1300_CENTERING FIN.SLDASM

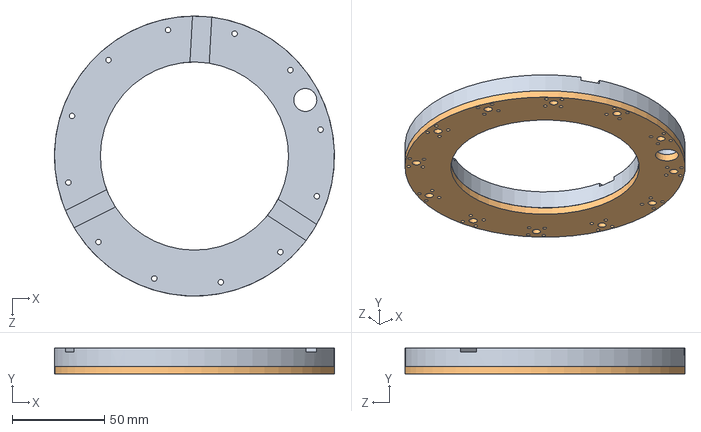
[picture p82: CAD file, 2017-05-22]
RORO_1/1300_CENTERING FIN.SLDASM
152.1 x 14.0 x 152.1 mm
1302_CENTERING RING M
1303_fin_forward_bulkhead_nuts_fixation
