irec-duster/RORO/Avionics_RORO/CAD/Nosecone/3300_Assemblage_PCB_power_board.SLDPRT

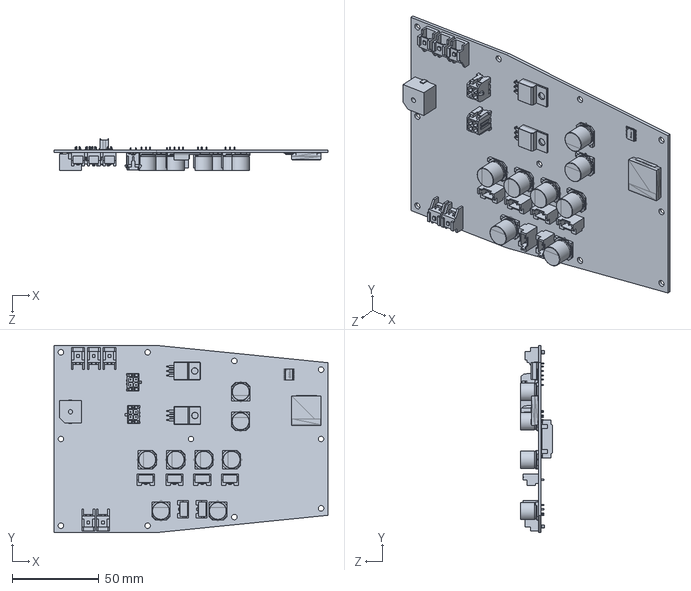
[picture p83: CAD file, 2017-04-27]
Avionics_RORO/CAD/Nosecone/3300_Assemblage_PCB_power_board.SLDPRT
158.0 x 108.0 x 18.6 mm
