irec-duster/RORO/RORO_1/1500_logging_electronics_lower_body.SLDASM

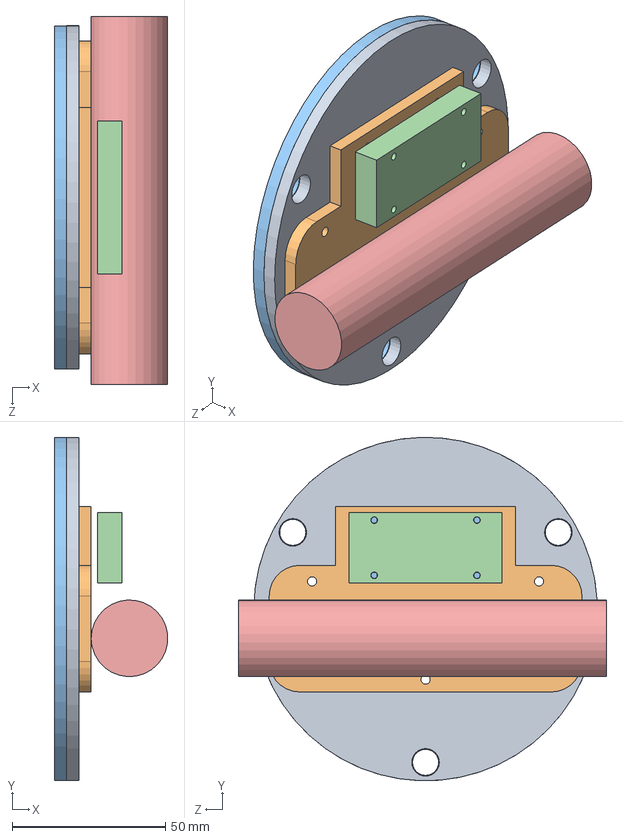
[picture p84: CAD file, 2017-05-22]
RORO_1/1500_logging_electronics_lower_body.SLDASM
36.9 x 112.0 x 120.0 mm
1501_gopro_and_avionics_bulkhead
1503_avionics_with_battery
1502_gopro_and_avionics_bulkhead_with_hexagon_holes
1504_ins_board
1505_5V_battery
