irec-duster/RORO/RORO_1/2200_payload_dummy.SLDASM

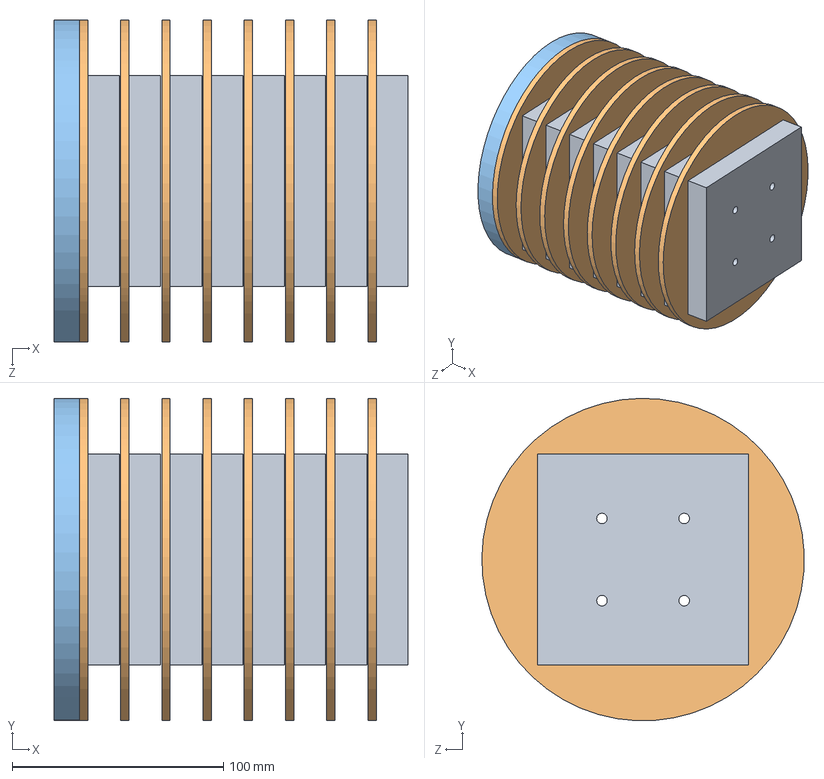
[picture p85: CAD file, 2017-05-22]
RORO_1/2200_payload_dummy.SLDASM
167.5 x 152.5 x 152.5 mm
2201_alu_weight x 8
2202_wood_separator_between_alu_weights x 8
2203_adapter_3holes_to_4holes
