irec-duster/RORO/RORO_1/GoPro Mount.SLDASM

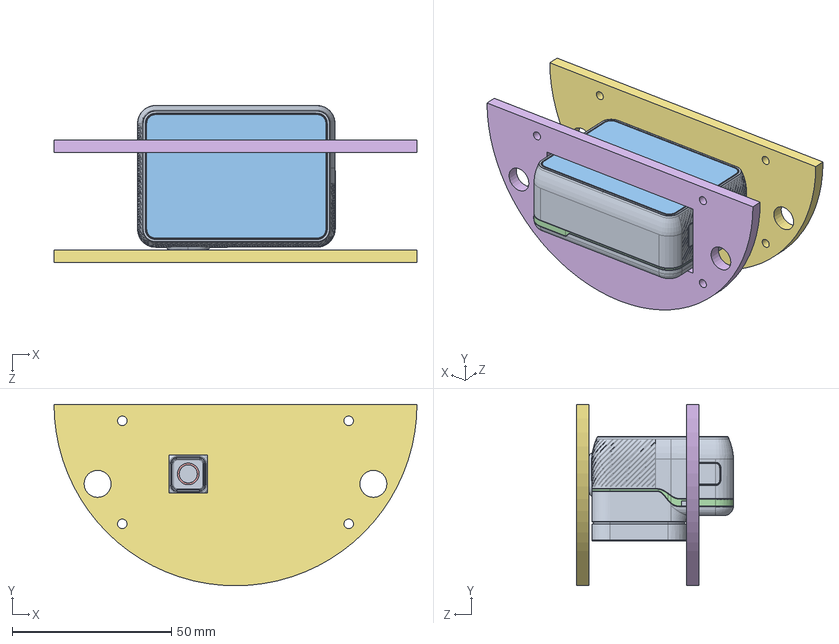
[picture p86: CAD file, 2017-05-17]
RORO_1/GoPro Mount.SLDASM
114.0 x 57.0 x 49.3 mm
GoPro_Hero5Hero5
GoPro_Hero5Hero5_LCD
GoPro_Hero5Hero5_screen
GoPro_Hero5Hero5_seal
GoPro_Hero5Hero5_shotring
GoPro Under Mount_2
GoPro Upper Mount_2
