irec-duster/RORO/Avionics_RORO/CAD/Nosecone/3006_Support_PCB_1.SLDPRT

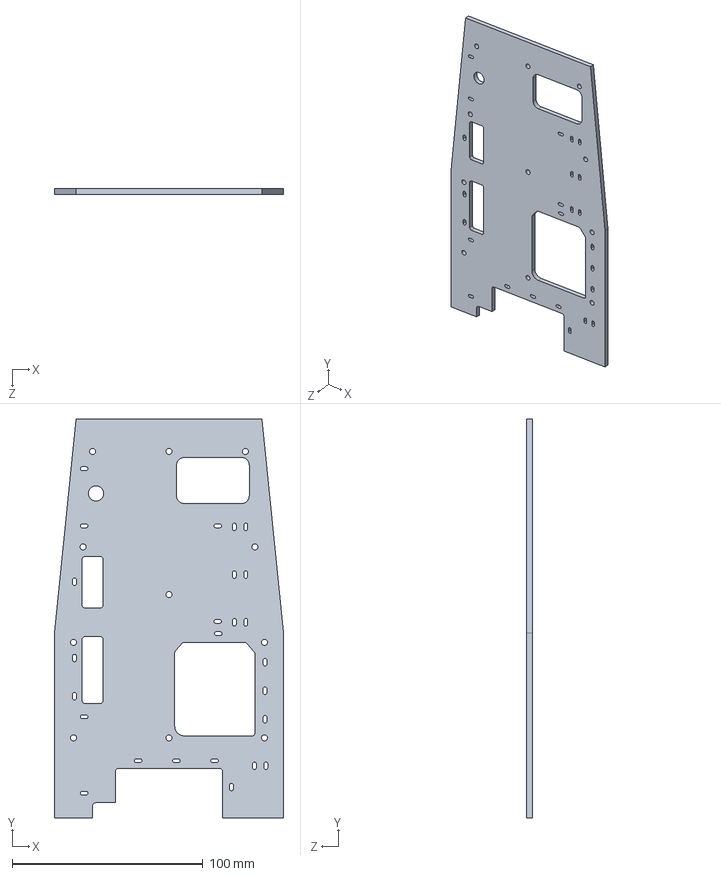
[picture p87: CAD file, 2017-05-22]
Avionics_RORO/CAD/Nosecone/3006_Support_PCB_1.SLDPRT
120.0 x 209.0 x 3.00 mm
