irec-duster/RORO/Avionics_RORO/CAD/Nosecone/3100_Locking system/Part/compression_spring_d21680-x.SLDPRT

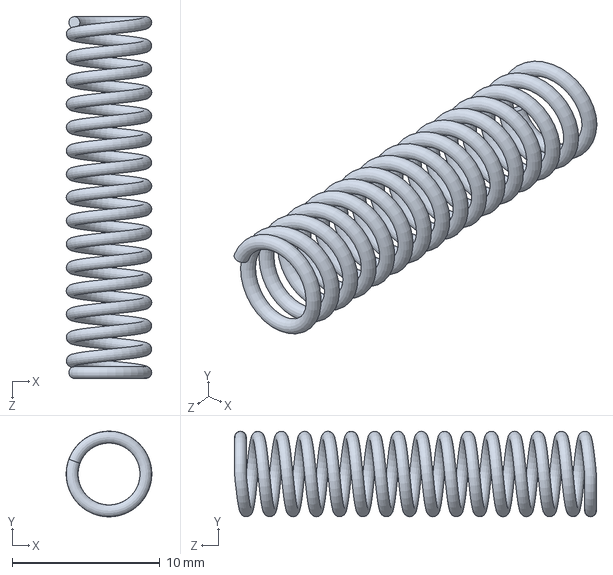
[picture p88: CAD file, 2017-04-27]
Avionics_RORO/CAD/Nosecone/3100_Locking system/Part/compression_spring_d21680-x.SLDPRT
5.80 x 5.80 x 24.5 mm
