irec-duster/RORO/Avionics_RORO/CAD/Nosecone/Mass budget parts/Flex_tube+tube connextion.SLDPRT

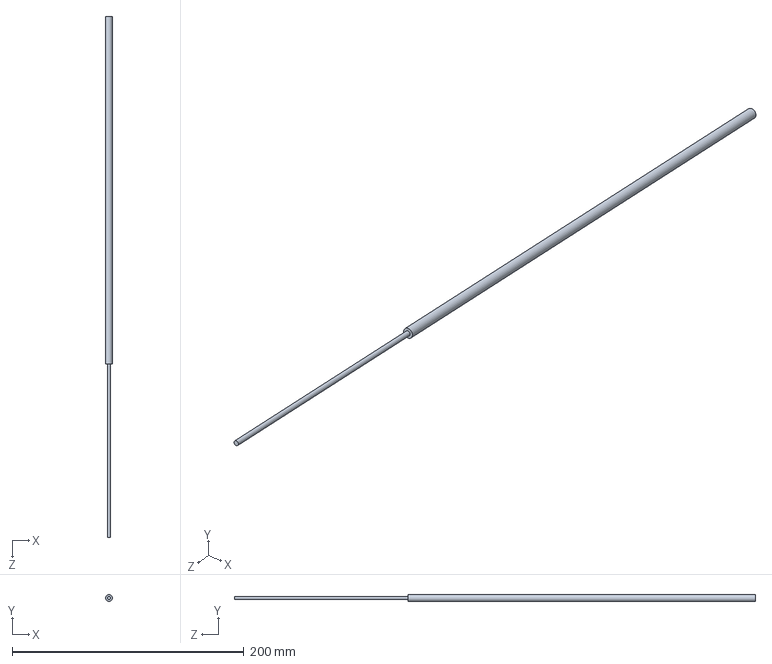
[picture p89: CAD file, 2017-04-27]
Avionics_RORO/CAD/Nosecone/Mass budget parts/Flex_tube+tube connextion.SLDPRT
6.00 x 6.00 x 450.0 mm
