irec-duster/RORO/Avionics_RORO/TI simulation/export altium/Altium/2017-01-30_01-57-48/1206_190.stp

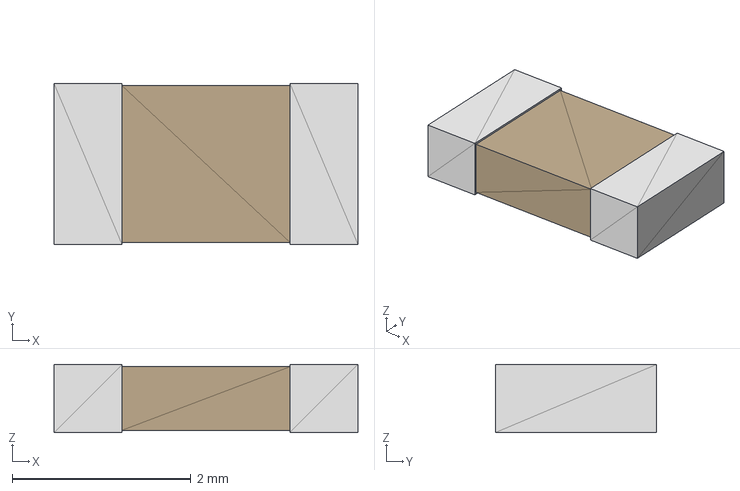
[picture p90: CAD file, 2017-04-09]
Avionics_RORO/TI simulation/export altium/Altium/2017-01-30_01-57-48/1206_190.stp
3.40 x 1.80 x 0.762 mm
