irec-duster/RORO/Avionics_RORO/TI simulation/export altium/Altium/2017-01-30_01-57-51/0805.stp

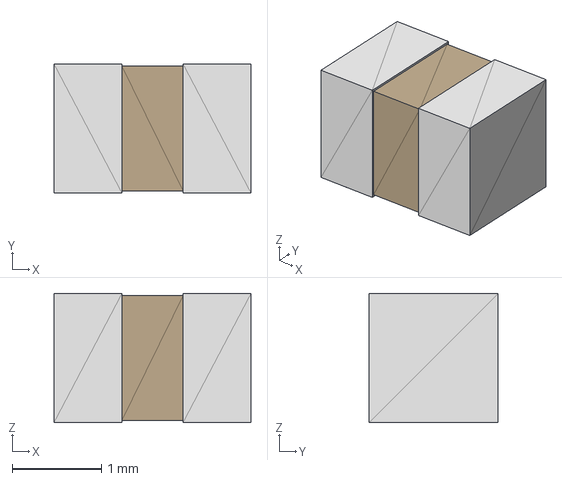
[picture p91: CAD file, 2017-04-09]
Avionics_RORO/TI simulation/export altium/Altium/2017-01-30_01-57-51/0805.stp
2.21 x 1.45 x 1.45 mm
