irec-duster/RORO/misc/YAGI-connection.SLDPRT

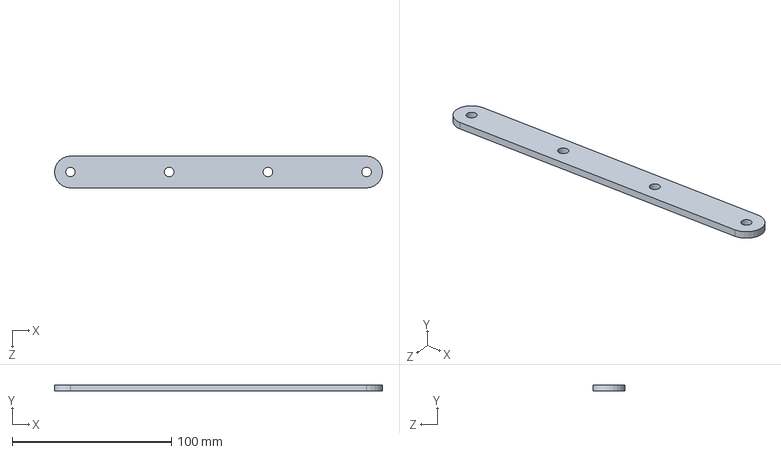
[picture p92: CAD file, 2017-06-16]
misc/YAGI-connection.SLDPRT
206.1 x 4.00 x 20.0 mm
