irec-duster/RORO/payload/BallBearingMacros/W 619_3-2Z_PART2.sldprt

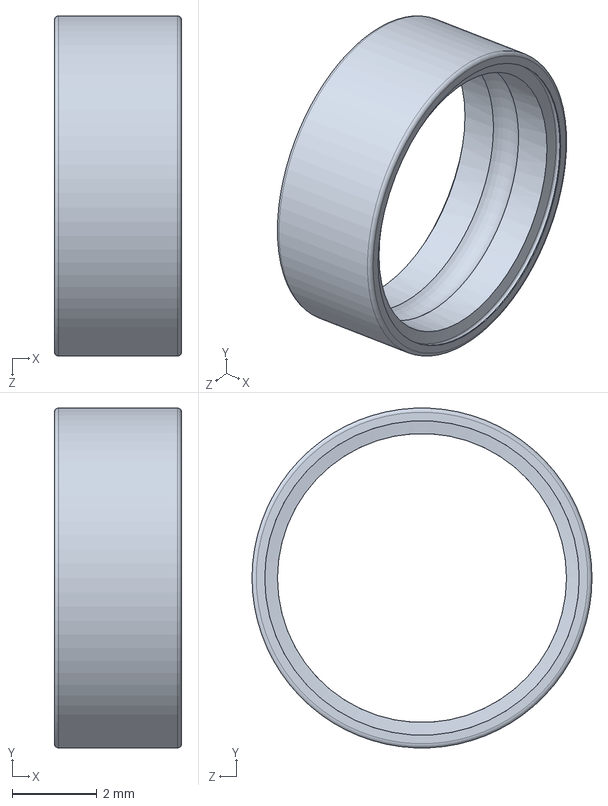
[picture p93: CAD file, 2017-04-27]
payload/BallBearingMacros/W 619_3-2Z_PART2.sldprt
3.00 x 7.99 x 8.00 mm
