irec-duster/RORO/payload/for3dprinting/11May/motor_mounting.STL

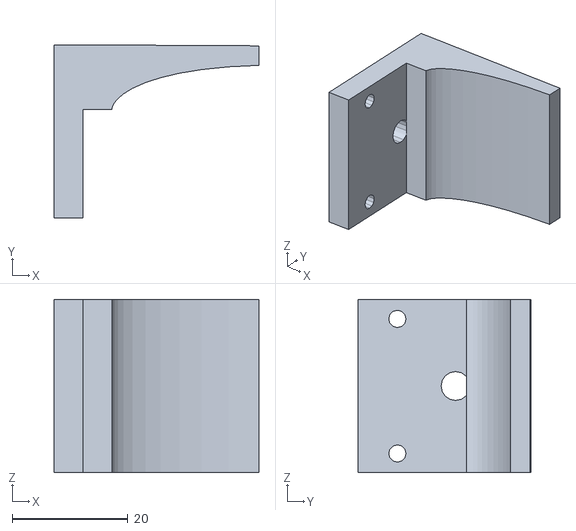
[picture p94: CAD file, 2017-05-12]
payload/for3dprinting/11May/motor_mounting.STL
35.5 x 30.0 x 30.0
