irec-duster/RORO/payload/forTesting(Simplifiedmodels)/test1.SLDPRT

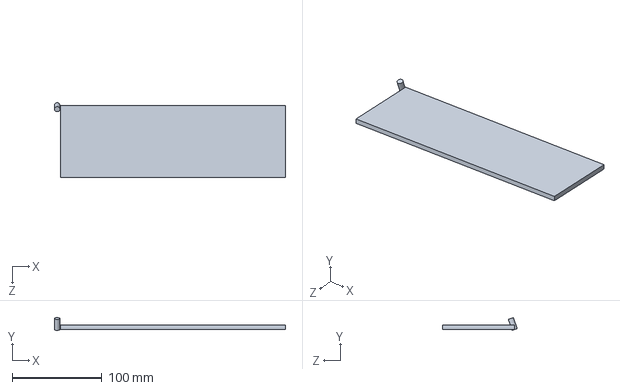
[picture p97: CAD file, 2017-04-11]
payload/forTesting(Simplifiedmodels)/test1.SLDPRT
256.7 x 14.3 x 83.0 mm
