irec-duster/RORO/payload/HS85MG/HS85MG_bottom.SLDPRT

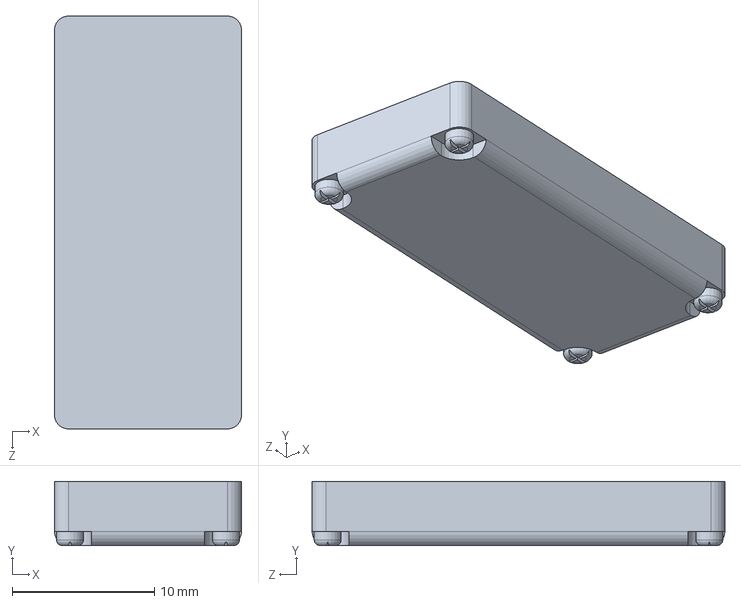
[picture p98: CAD file, 2017-05-07]
payload/HS85MG/HS85MG_bottom.SLDPRT
13.1 x 4.50 x 29.0 mm
