irec-duster/RORO/payload/prototyping/ball_bearing_block.SLDPRT

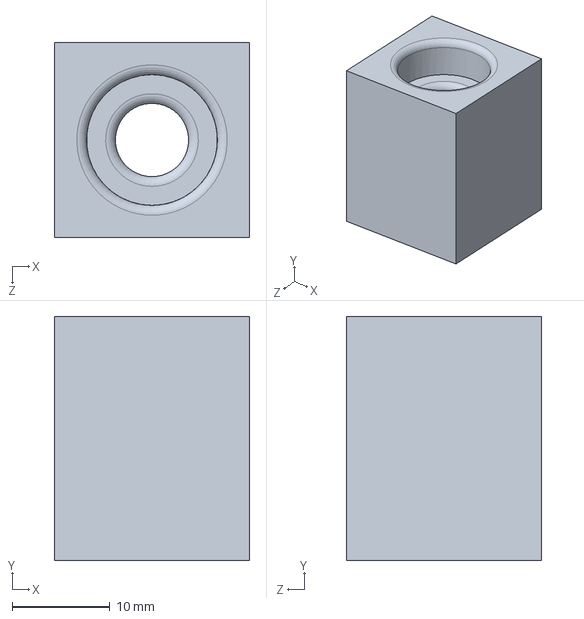
[picture p99: CAD file, 2017-06-08]
payload/prototyping/ball_bearing_block.SLDPRT
20.0 x 25.0 x 20.0 mm
