irec-duster/RORO/payload/Software/Datalogging/pythonScript3dAnimation/plane.STL

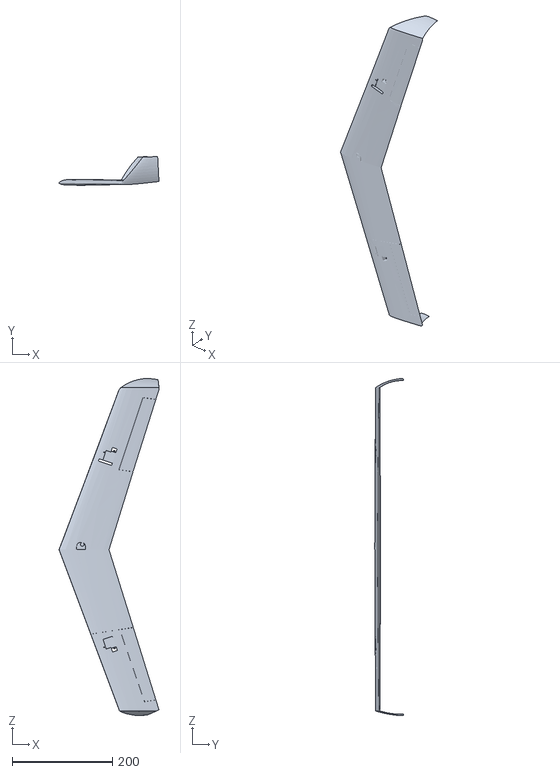
[picture p100: CAD file, 2017-05-15]
payload/Software/Datalogging/pythonScript3dAnimation/plane.STL
199.9 x 58.1 x 673.8
