irec-duster/RORO/RORO_1/3dprint/1206_fin_extension_upper.STL

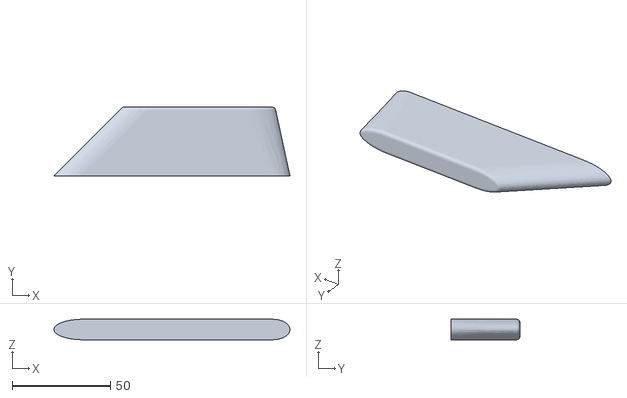
[picture p101: CAD file, 2017-06-12]
RORO_1/3dprint/1206_fin_extension_upper.STL
119.9 x 34.9 x 10.5
