irec-duster/RORO/RORO_1/cnc/2101_Recovery_bulkhead_v2_mirrored.DXF

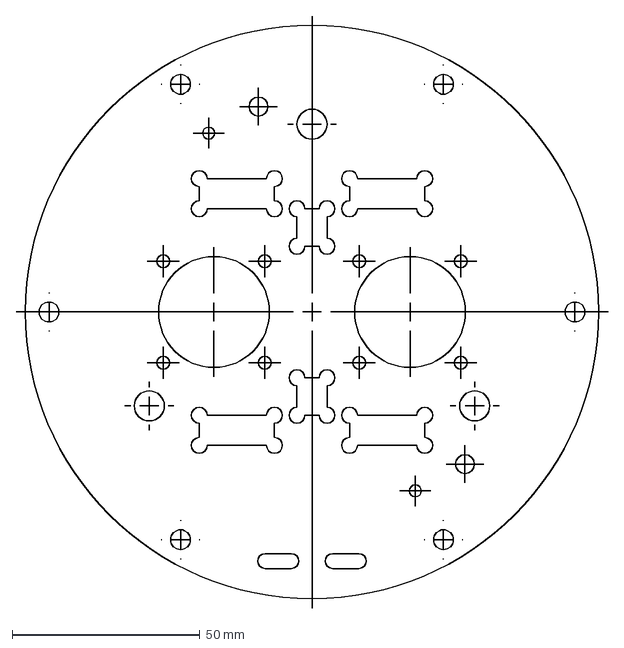
[picture p102: CAD file, 2017-06-15]
RORO_1/cnc/2101_Recovery_bulkhead_v2_mirrored.DXF
157.6 x 157.6 mm
