irec-duster/RORO/RORO_1/Lasercutter/lower-body-bulkhead-drill-alignment.SLDPRT

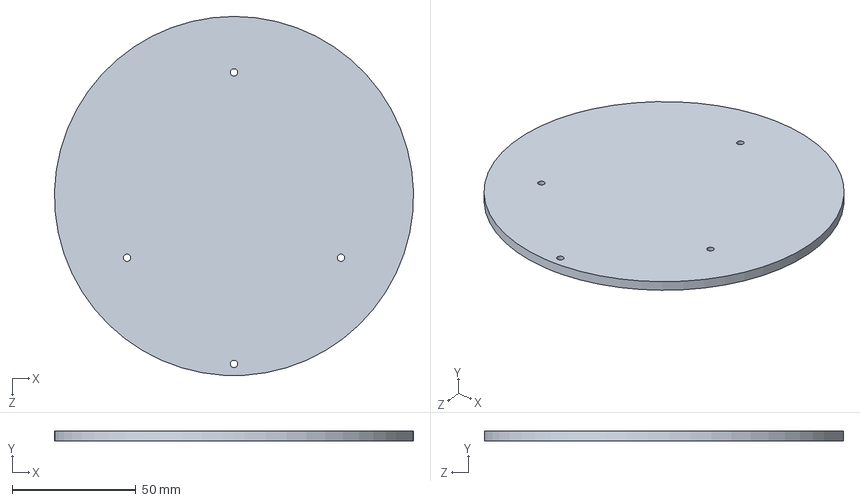
[picture p103: CAD file, 2017-03-27]
RORO_1/Lasercutter/lower-body-bulkhead-drill-alignment.SLDPRT
145.3 x 4.00 x 145.4 mm
