irec-duster/RORO/Avionics_RORO/CAD/Nosecone/3007_Battery_Cover.SLDPRT

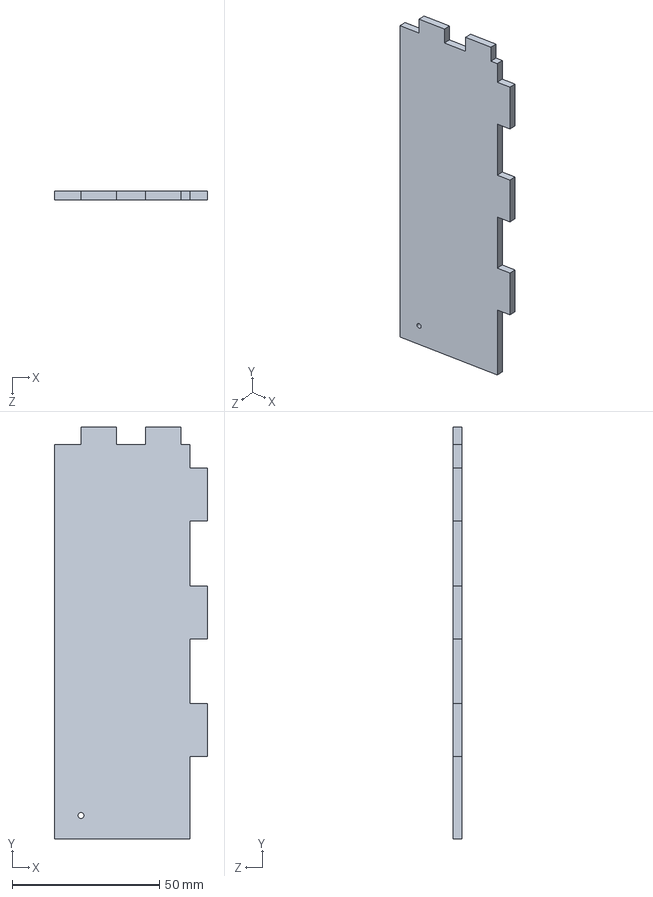
[picture p104: CAD file, 2017-05-22]
Avionics_RORO/CAD/Nosecone/3007_Battery_Cover.SLDPRT
52.0 x 140.0 x 3.00 mm
