irec-duster/RORO/Avionics_RORO/CAD/Nosecone/3100_Locking system/Part/3102_Rod_big.SLDPRT

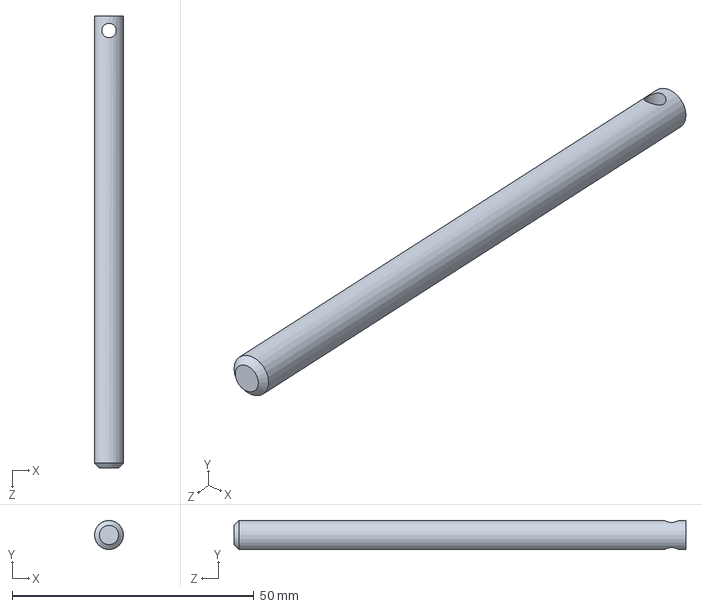
[picture p105: CAD file, 2017-04-27]
Avionics_RORO/CAD/Nosecone/3100_Locking system/Part/3102_Rod_big.SLDPRT
6.00 x 6.00 x 93.5 mm
