irec-duster/RORO/Avionics_RORO/CAD/Nosecone/3400_Rail/3404_Hook.SLDPRT

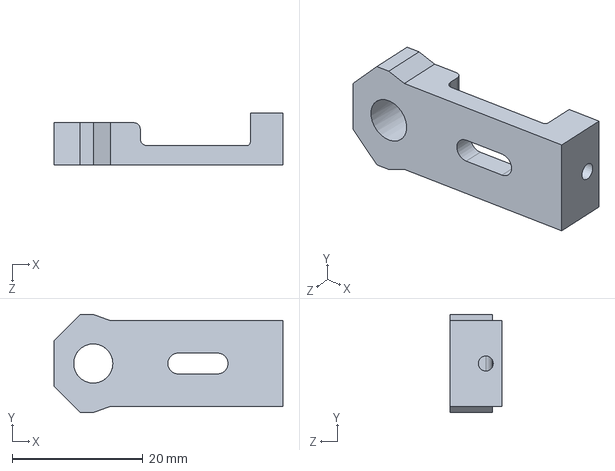
[picture p106: CAD file, 2017-05-19]
Avionics_RORO/CAD/Nosecone/3400_Rail/3404_Hook.SLDPRT
35.0 x 15.0 x 8.00 mm
