irec-duster/RORO/Avionics_RORO/CAD/Nosecone/3500_Gliding_structure/3503_Support_2.SLDPRT

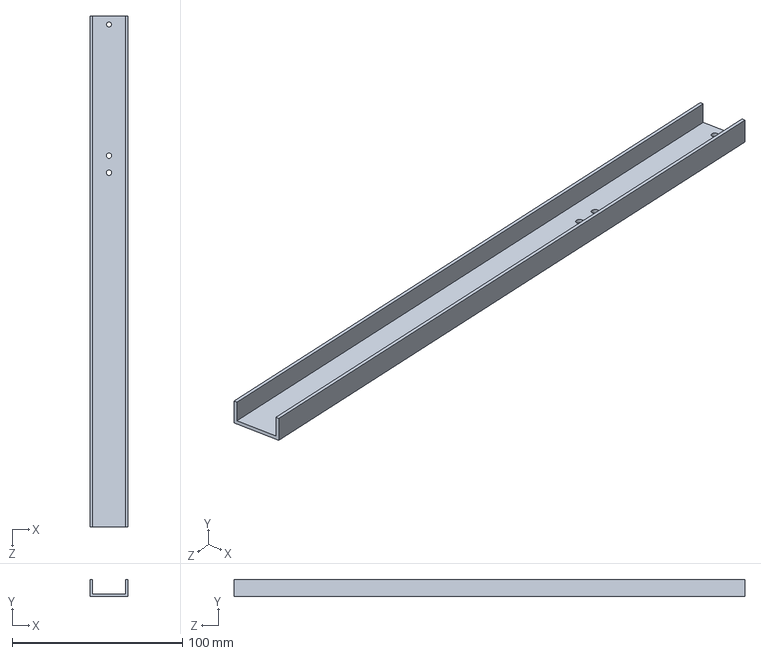
[picture p107: CAD file, 2017-05-19]
Avionics_RORO/CAD/Nosecone/3500_Gliding_structure/3503_Support_2.SLDPRT
22.5 x 10.0 x 300.0 mm
