irec-duster/RORO/payload/for3dprinting/11May/0-3mmthickoffsetwing.STL

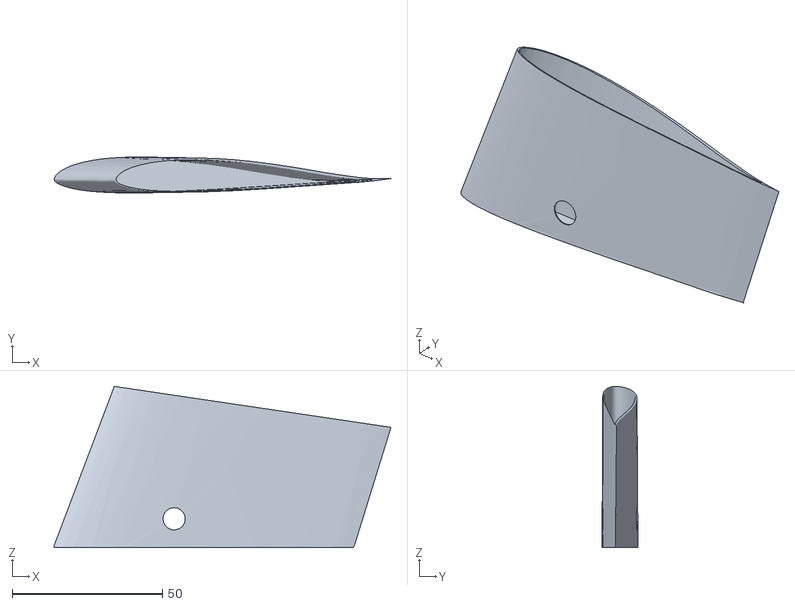
[picture p108: CAD file, 2017-05-12]
payload/for3dprinting/11May/0-3mmthickoffsetwing.STL
112.2 x 12.0 x 53.7
