irec-duster/RORO/payload/for3dprinting/27April/hinge_left_wing.STL

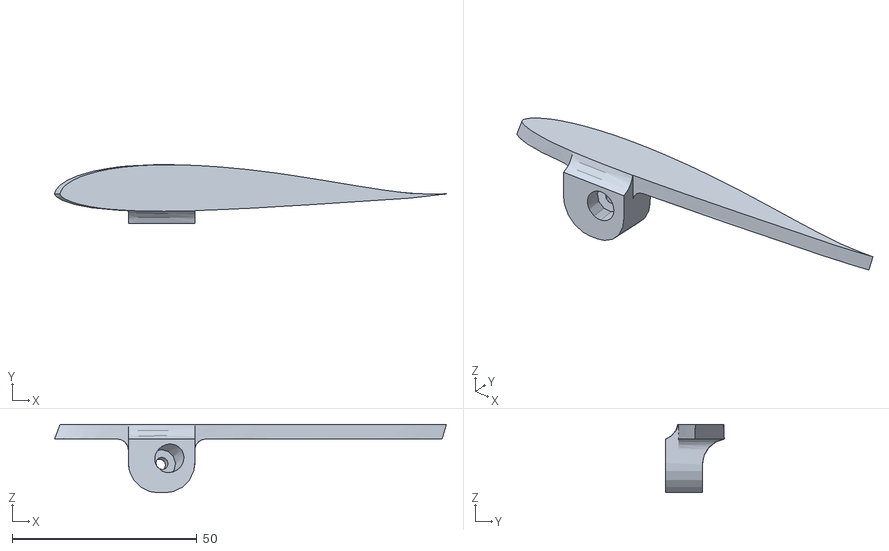
[picture p109: CAD file, 2017-04-27]
payload/for3dprinting/27April/hinge_left_wing.STL
106.2 x 15.9 x 18.5
