irec-duster/RORO/payload/for3dprinting/5may/motormounting.STL

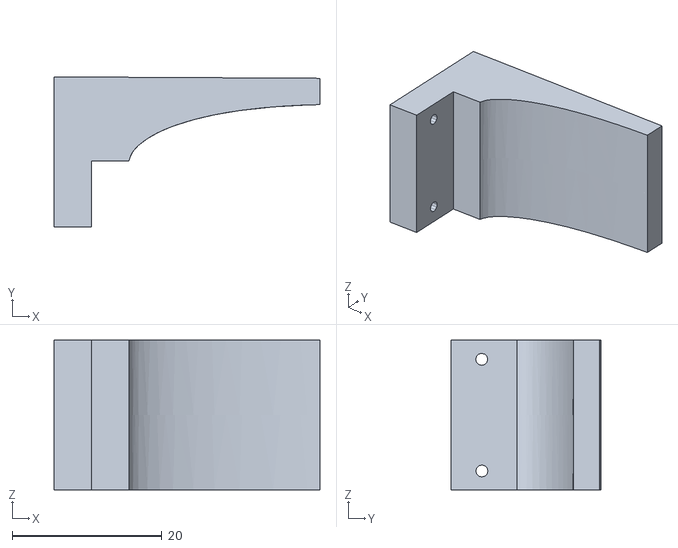
[picture p110: CAD file, 2017-05-08]
payload/for3dprinting/5may/motormounting.STL
35.5 x 20.0 x 20.0
