irec-duster/RORO/payload/for3dprinting/ball_bearing_block.STL

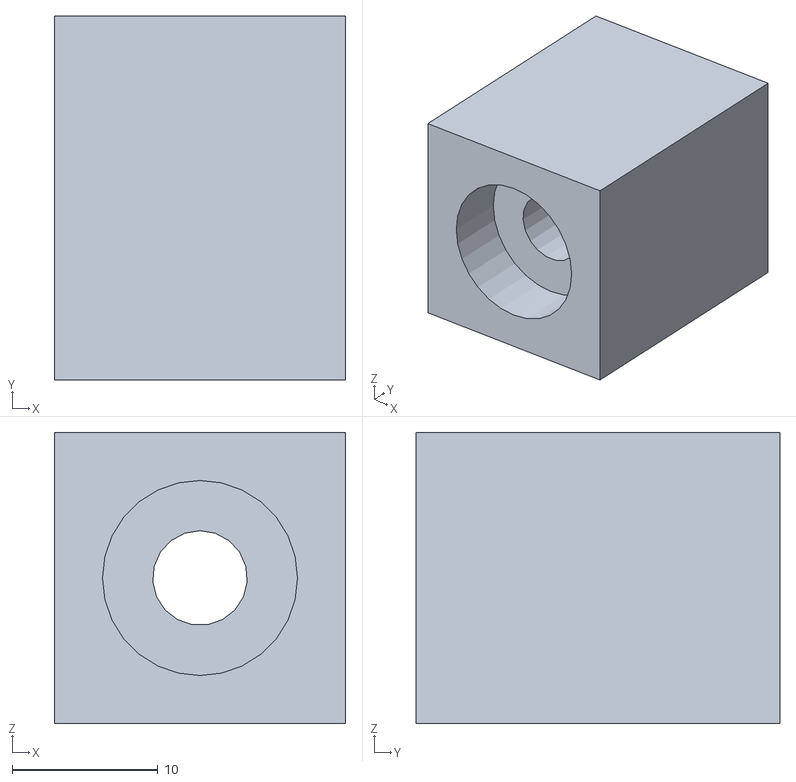
[picture p111: CAD file, 2017-06-08]
payload/for3dprinting/ball_bearing_block.STL
20.0 x 25.0 x 20.0
