irec-duster/RORO/payload/HS85MG/HS85MG - HS85MG_top-1.STL

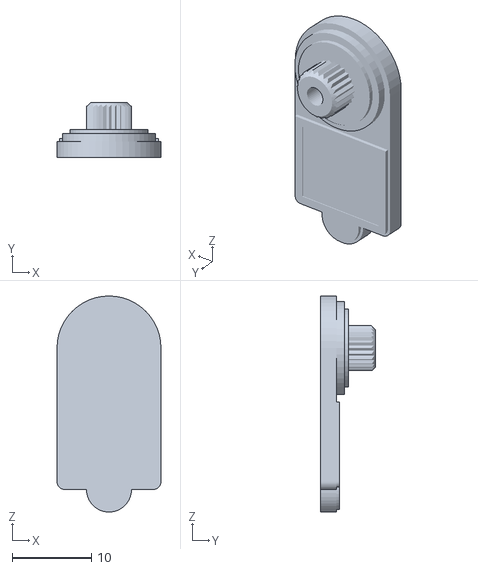
[picture p112: CAD file, 2017-05-07]
payload/HS85MG/HS85MG - HS85MG_top-1.STL
13.2 x 6.90 x 27.3
