irec-duster/RORO/payload/prototyping/ball_bearing_spacer_tube.SLDPRT

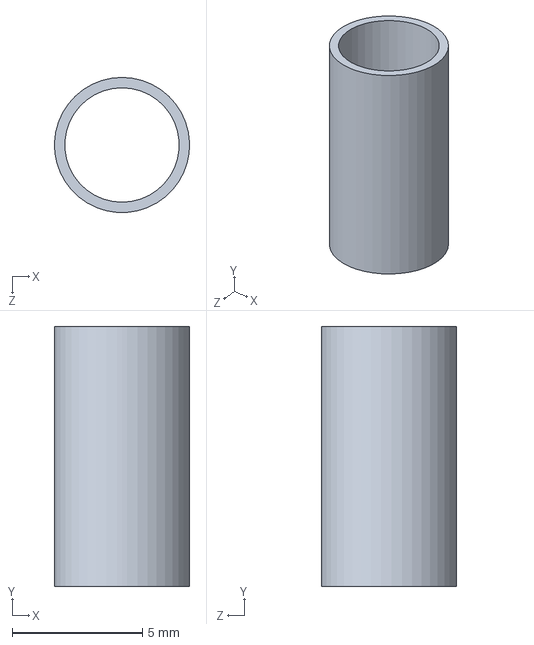
[picture p113: CAD file, 2017-06-08]
payload/prototyping/ball_bearing_spacer_tube.SLDPRT
5.20 x 10.0 x 5.20 mm
