irec-duster/RORO/RORO_1/1506_payload_1U_weight.SLDPRT

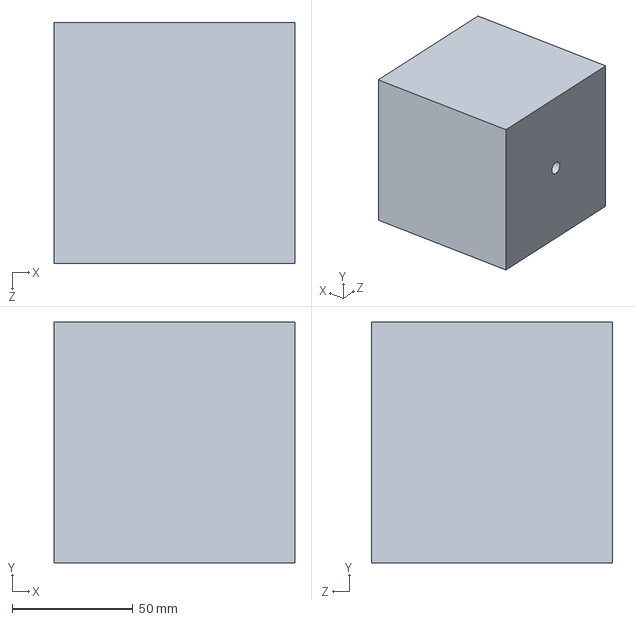
[picture p114: CAD file, 2017-07-04]
RORO_1/1506_payload_1U_weight.SLDPRT
100.0 x 100.0 x 100.0 mm
