irec-duster/RORO/RORO_1/3dprint/fin_core.STL

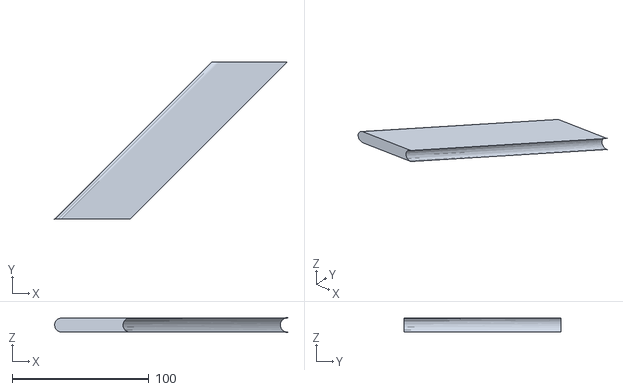
[picture p115: CAD file, 2017-06-12]
RORO_1/3dprint/fin_core.STL
170.2 x 115.0 x 10.5
