irec-duster/RORO/RORO_1/cnc/2101_Recovery_bulkhead_v2.DXF

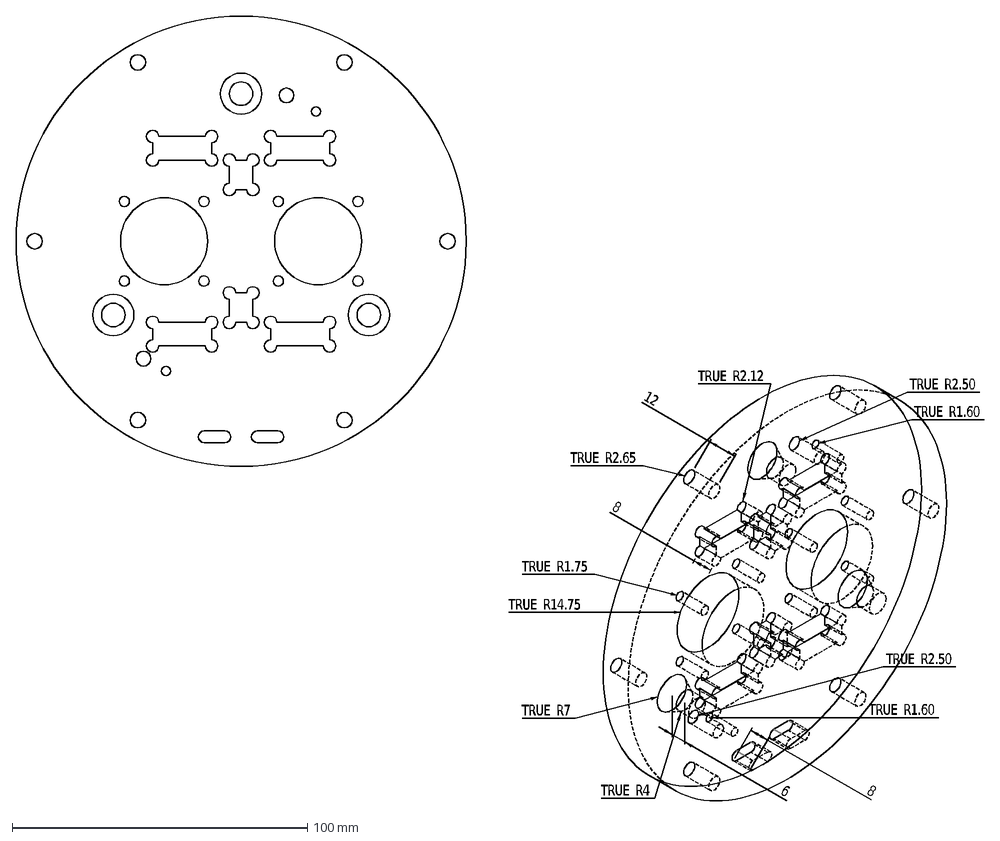
[picture p116: CAD file, 2017-06-12]
RORO_1/cnc/2101_Recovery_bulkhead_v2.DXF
TRUE
R2.65
R14.75
R1.75
8
12
R2.12
R7
R4
6
R2.50
R1.60
