irec-duster/RORO/RORO_1/GoPro_Hero5_SW/GoPro_Hero5Hero5_screen.SLDPRT

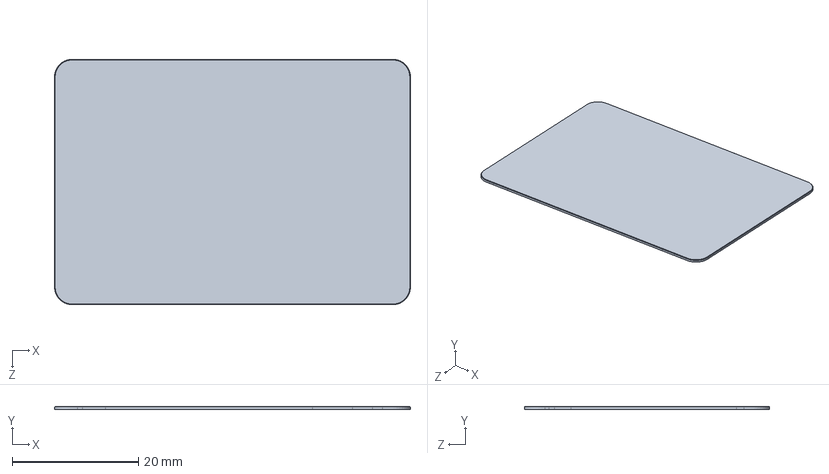
[picture p117: CAD file, 2017-05-17]
RORO_1/GoPro_Hero5_SW/GoPro_Hero5Hero5_screen.SLDPRT
56.5 x 0.5 x 38.9 mm
