irec-duster/RORO/RORO_1/Lasercutter/thrust_plate_retainer_drill_positioning.SLDPRT

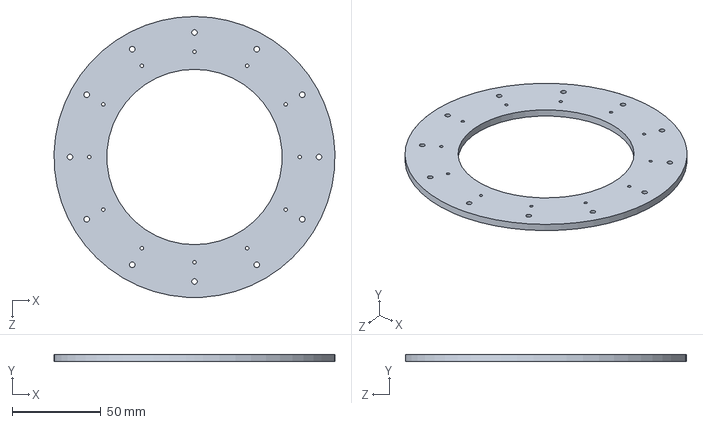
[picture p118: CAD file, 2017-03-26]
RORO_1/Lasercutter/thrust_plate_retainer_drill_positioning.SLDPRT
157.9 x 4.00 x 158.0 mm
