irec-duster/RORO/Avionics_RORO/CAD/Nosecone/3007_Support_PCB_4.SLDPRT

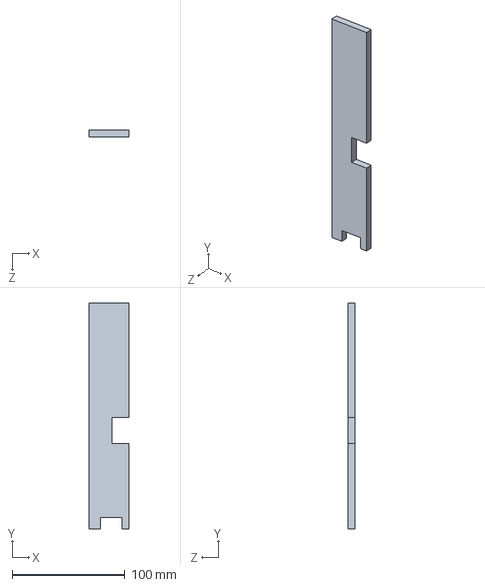
[picture p119: CAD file, 2017-05-22]
Avionics_RORO/CAD/Nosecone/3007_Support_PCB_4.SLDPRT
35.0 x 200.0 x 6.00 mm
