irec-duster/RORO/Avionics_RORO/CAD/Nosecone/3100_Locking system/Part/3103_Rod_small.SLDPRT

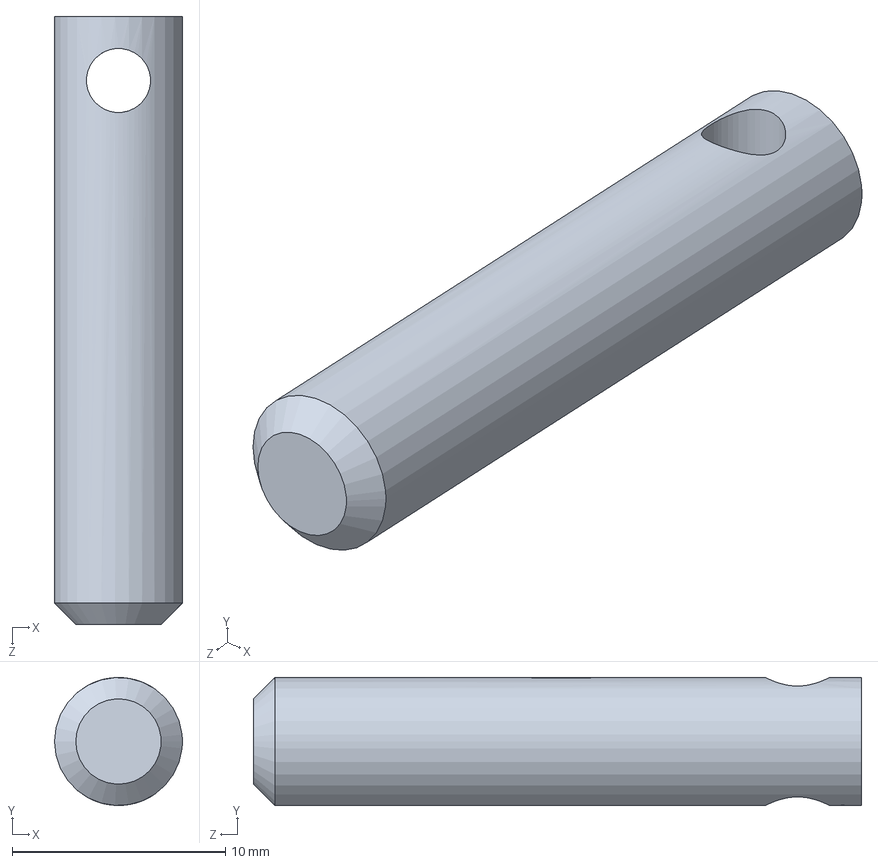
[picture p120: CAD file, 2017-04-27]
Avionics_RORO/CAD/Nosecone/3100_Locking system/Part/3103_Rod_small.SLDPRT
6.00 x 6.00 x 28.5 mm
