irec-duster/RORO/Avionics_RORO/CAD/Nosecone/3400_Rail/3401_U_rail.SLDPRT

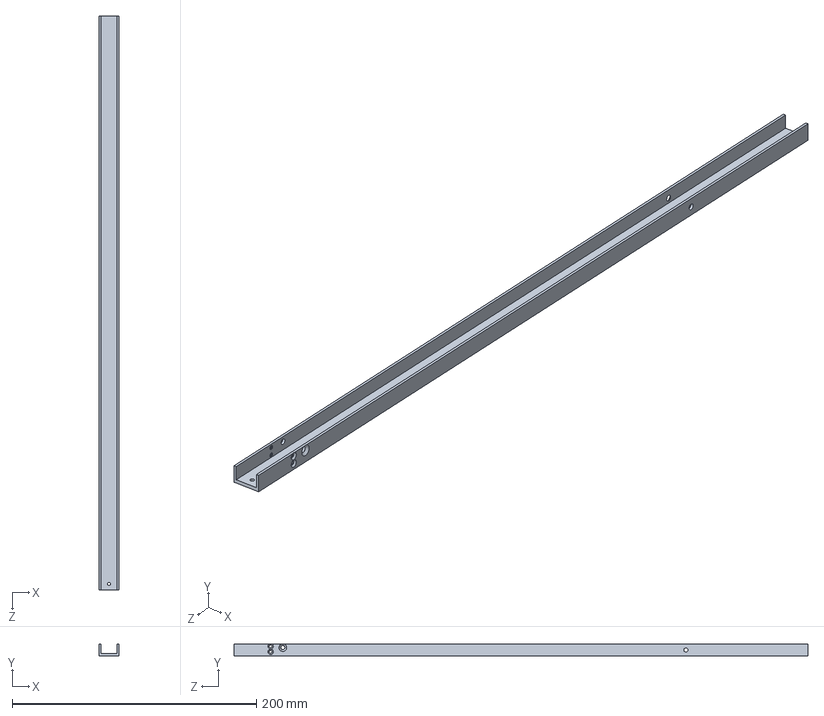
[picture p121: CAD file, 2017-05-19]
Avionics_RORO/CAD/Nosecone/3400_Rail/3401_U_rail.SLDPRT
16.5 x 10.0 x 470.0 mm
