irec-duster/RORO/Avionics_RORO/CAD/Nosecone/3500_Gliding_structure/3502_Support_1.SLDPRT

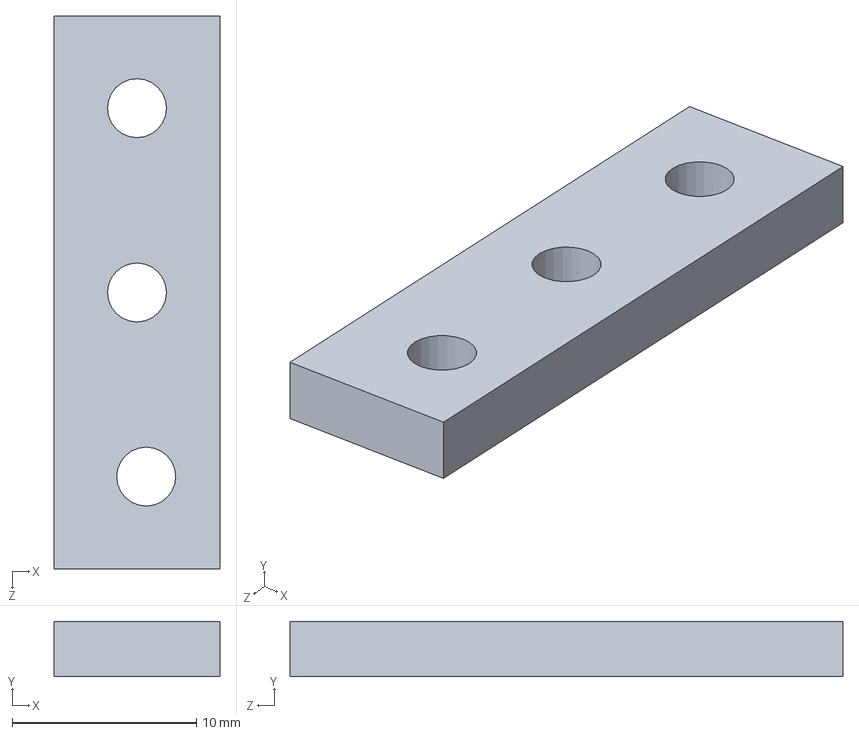
[picture p122: CAD file, 2017-05-07]
Avionics_RORO/CAD/Nosecone/3500_Gliding_structure/3502_Support_1.SLDPRT
9.00 x 3.00 x 30.0 mm
