irec-duster/RORO/Avionics_RORO/TI simulation/export altium/Altium/2017-01-30_01-57-48/MXA20A.stp

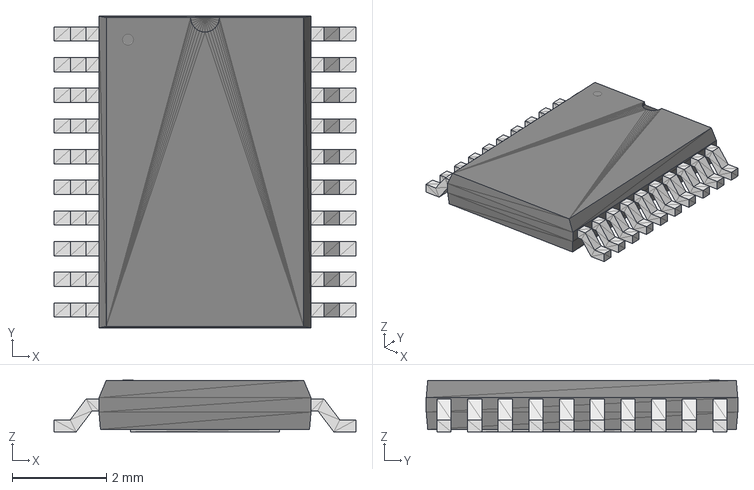
[picture p123: CAD file, 2017-04-09]
Avionics_RORO/TI simulation/export altium/Altium/2017-01-30_01-57-48/MXA20A.stp
6.40 x 6.60 x 1.09 mm
