irec-duster/RORO/payload/BallBearingMacros/W 619_3-2Z_PART1.sldprt

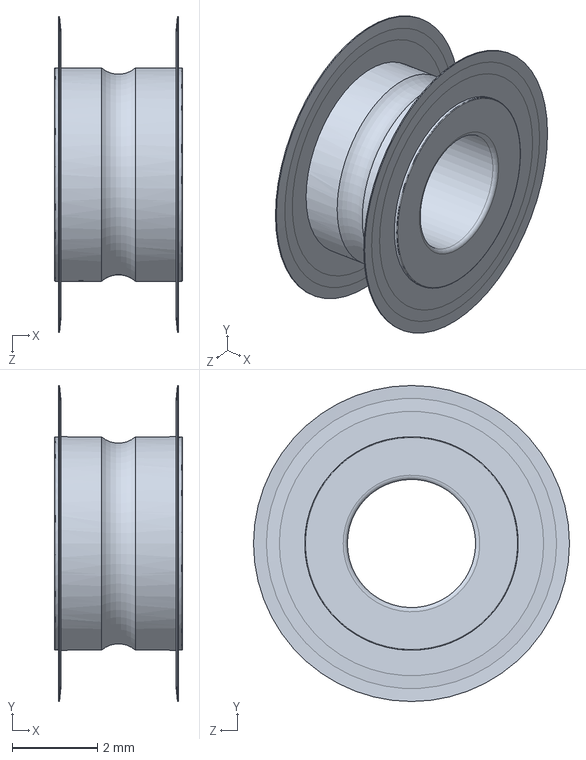
[picture p124: CAD file, 2017-04-17]
payload/BallBearingMacros/W 619_3-2Z_PART1.sldprt
3.00 x 7.40 x 7.40 mm
