irec-duster/RORO/payload/for3dprinting/17June/Cut-Extrude13.sldprt

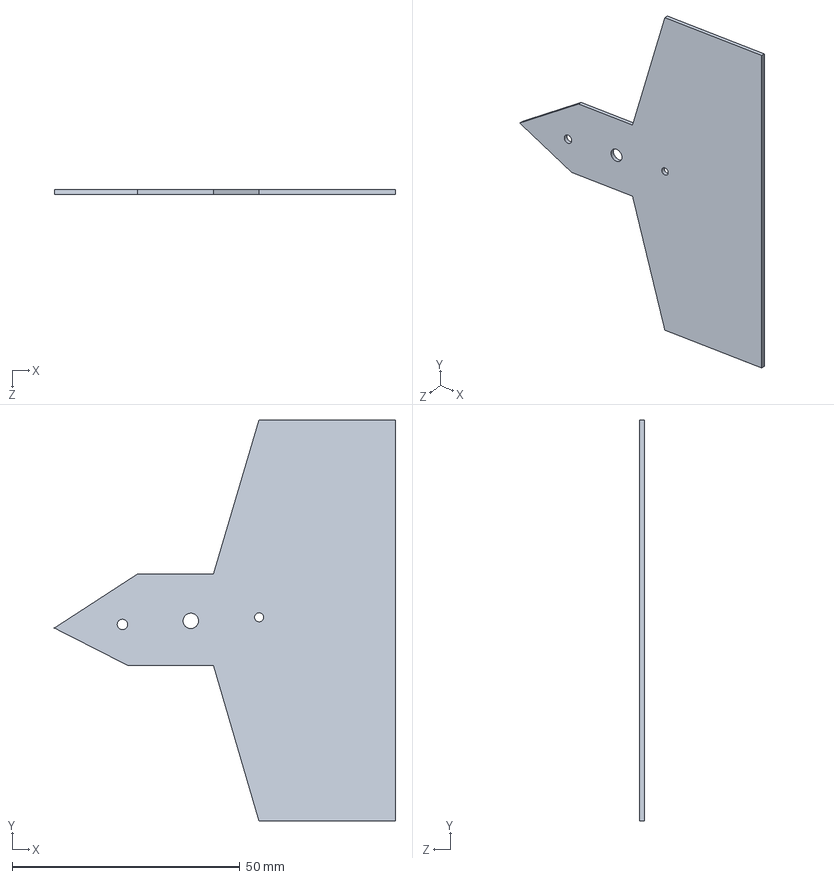
[picture p125: CAD file, 2017-06-16]
payload/for3dprinting/17June/Cut-Extrude13.sldprt
74.9 x 88.0 x 1 mm
