irec-duster/RORO/payload/for3dprinting/ball_bearing_spacer_tube.STL

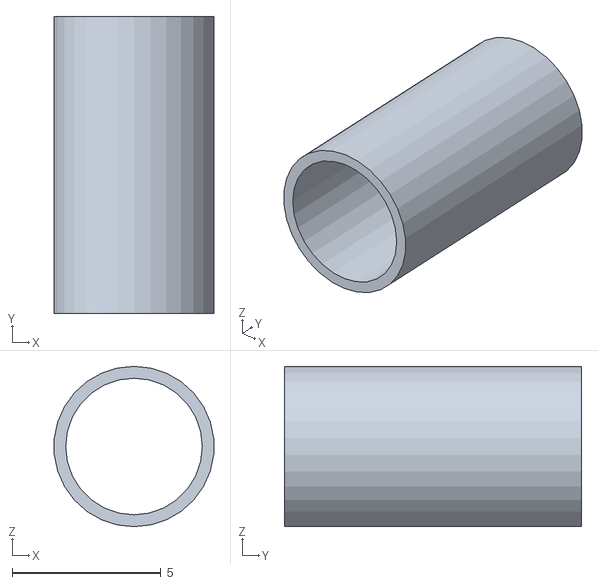
[picture p126: CAD file, 2017-06-08]
payload/for3dprinting/ball_bearing_spacer_tube.STL
5.37 x 10.0 x 5.40
