irec-duster/RORO/payload/HS85MG/HS85MG_midle.SLDPRT

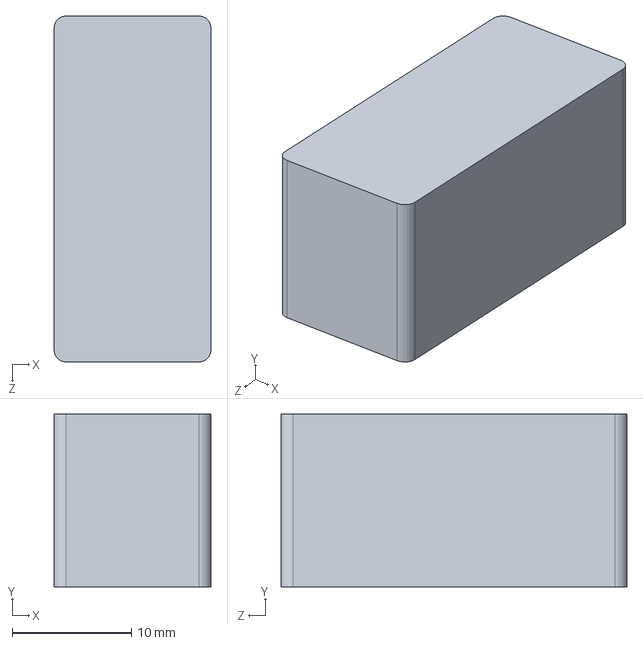
[picture p127: CAD file, 2017-05-07]
payload/HS85MG/HS85MG_midle.SLDPRT
13.1 x 14.5 x 29.0 mm
