irec-duster/RORO/RORO_1/3dprint/1206_fin_extension_lower.STL

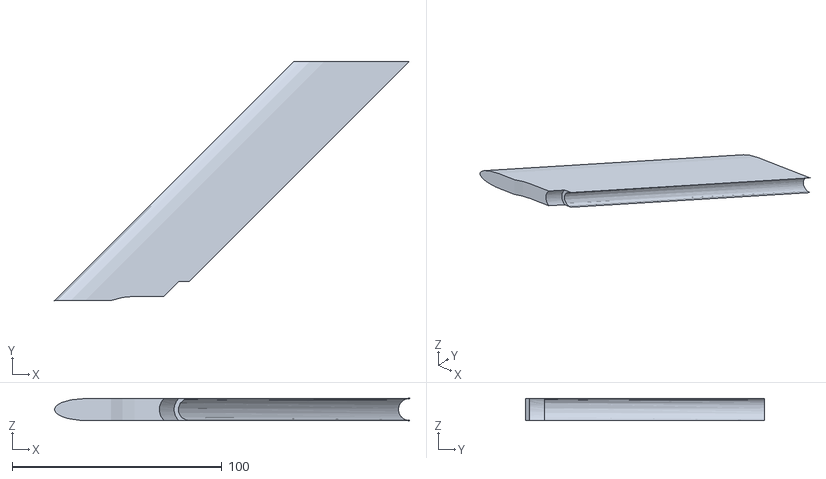
[picture p128: CAD file, 2017-06-12]
RORO_1/3dprint/1206_fin_extension_lower.STL
169.2 x 114.0 x 10.5
