irec-duster/RORO/RORO_1/GoPro_Hero5_SW/GoPro_Hero5Hero5_LCD.SLDPRT

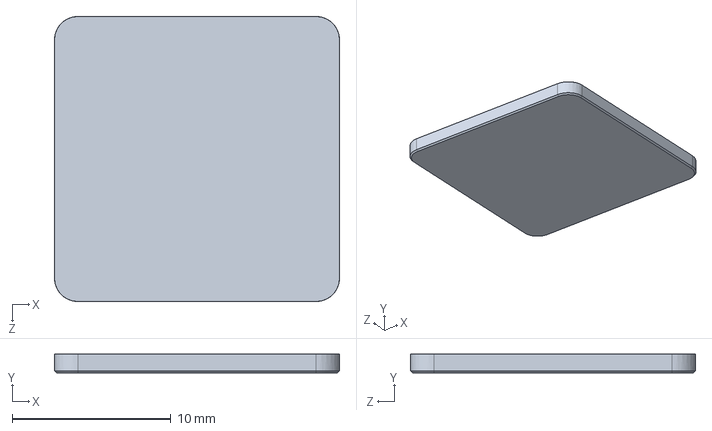
[picture p129: CAD file, 2017-05-17]
RORO_1/GoPro_Hero5_SW/GoPro_Hero5Hero5_LCD.SLDPRT
17.9 x 1.18 x 17.9 mm
