irec-duster/RORO/RORO_1/Lasercutter/FinsRoundingThingy.SLDPRT

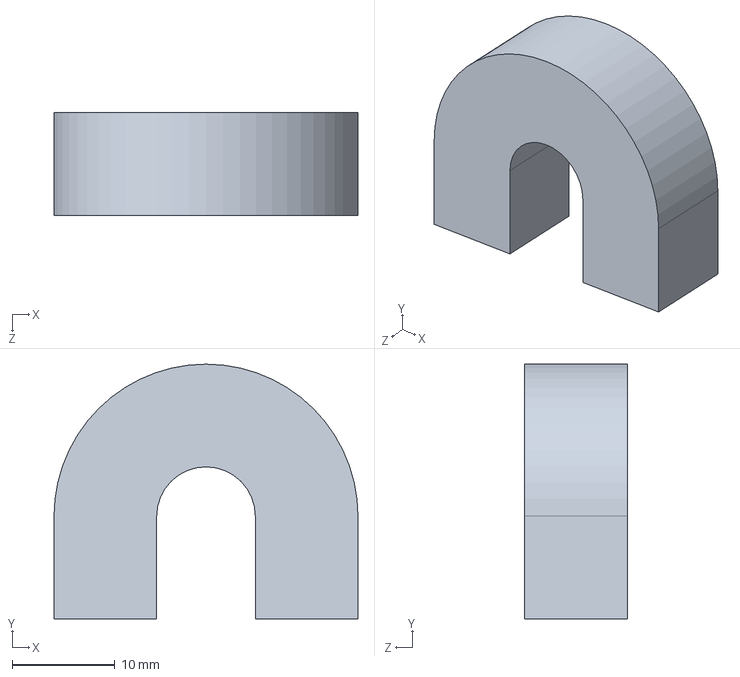
[picture p130: CAD file, 2017-03-22]
RORO_1/Lasercutter/FinsRoundingThingy.SLDPRT
29.6 x 24.8 x 10.0 mm
