irec-duster/RORO/Avionics_RORO/CAD/Nosecone/3007_Support_PCB_6.SLDPRT

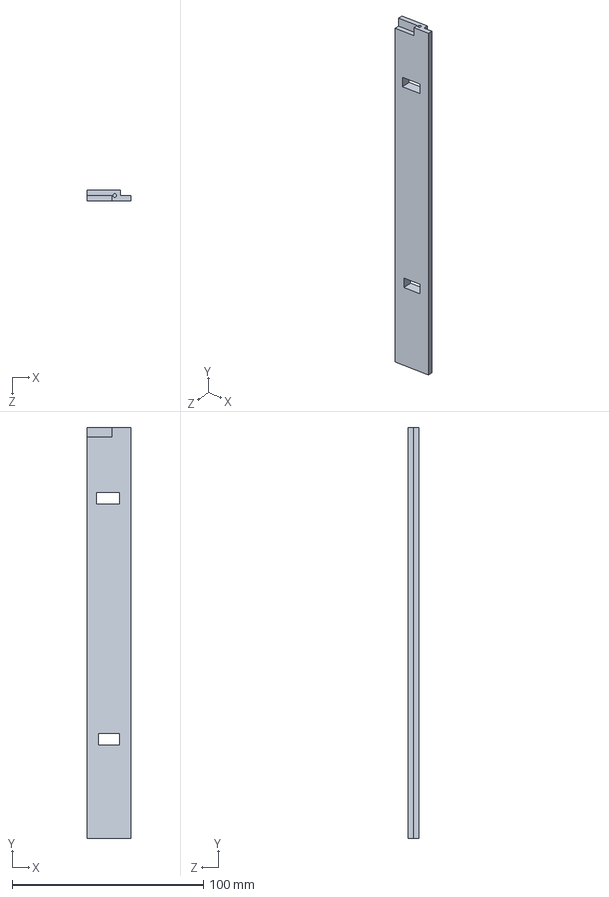
[picture p131: CAD file, 2017-05-22]
Avionics_RORO/CAD/Nosecone/3007_Support_PCB_6.SLDPRT
23.0 x 215.0 x 6.00 mm
