irec-duster/RORO/Avionics_RORO/CAD/Nosecone/3100_Locking system/Part/Small Servo.SLDPRT

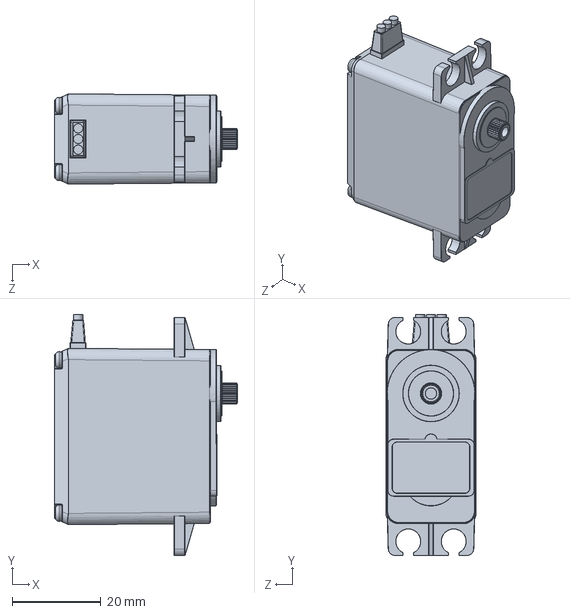
[picture p132: CAD file, 2017-04-27]
Avionics_RORO/CAD/Nosecone/3100_Locking system/Part/Small Servo.SLDPRT
41.3 x 54.2 x 20.3 mm
