irec-duster/RORO/Avionics_RORO/CAD/Nosecone/3400_Rail/3403_Suport_hook.SLDPRT

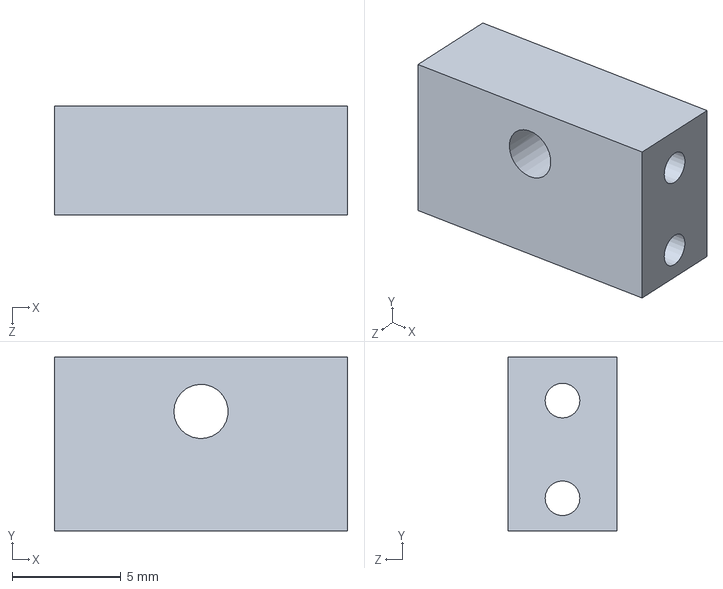
[picture p133: CAD file, 2017-05-07]
Avionics_RORO/CAD/Nosecone/3400_Rail/3403_Suport_hook.SLDPRT
13.5 x 8.00 x 5.00 mm
