irec-duster/RORO/Avionics_RORO/CAD/Nosecone/Mass budget parts/Wire and glue mass.SLDPRT

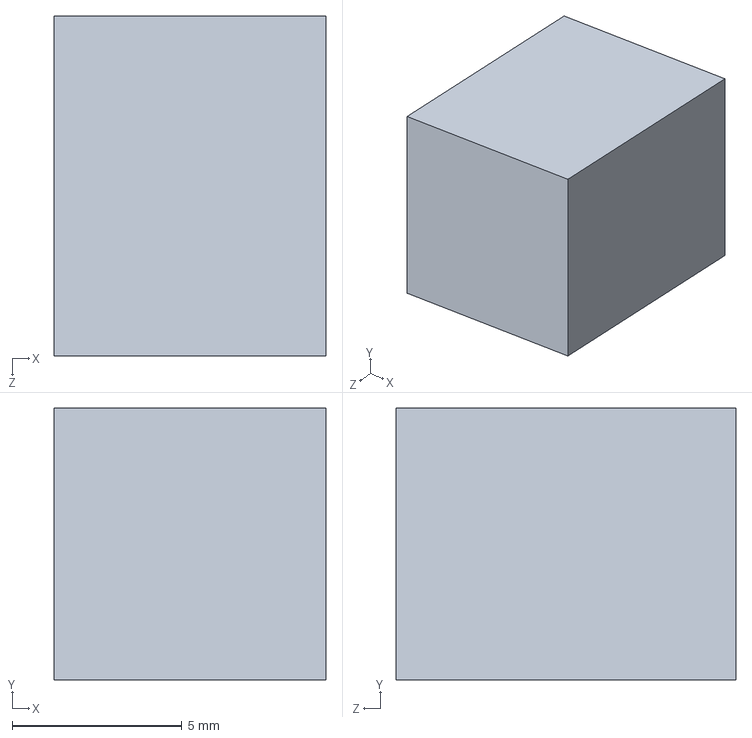
[picture p134: CAD file, 2017-04-27]
Avionics_RORO/CAD/Nosecone/Mass budget parts/Wire and glue mass.SLDPRT
8.00 x 8.00 x 10.0 mm
