irec-duster/RORO/Avionics_RORO/TI simulation/export altium/Altium/2017-01-30_01-57-48/IHLP-6767DZ.stp

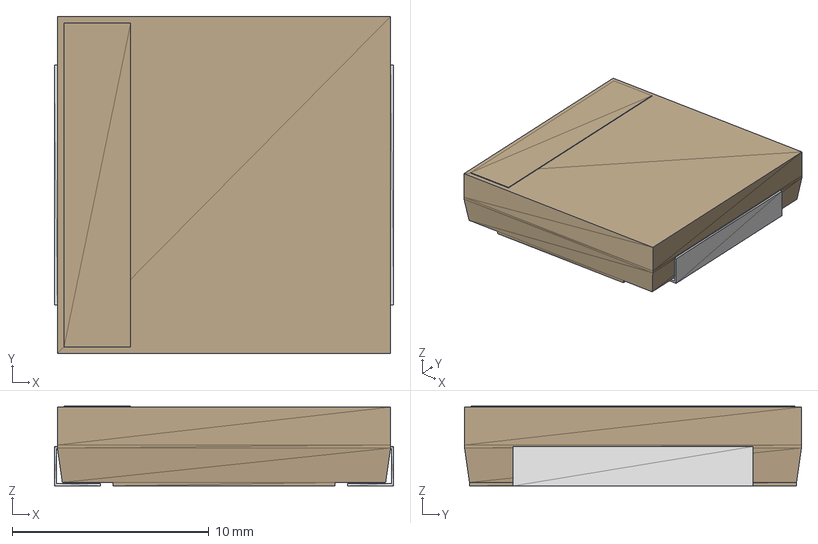
[picture p135: CAD file, 2017-04-09]
Avionics_RORO/TI simulation/export altium/Altium/2017-01-30_01-57-48/IHLP-6767DZ.stp
17.3 x 17.1 x 4.06 mm
