irec-duster/RORO/payload/BallBearingMacros/W 619_3-2Z_PART3.sldprt

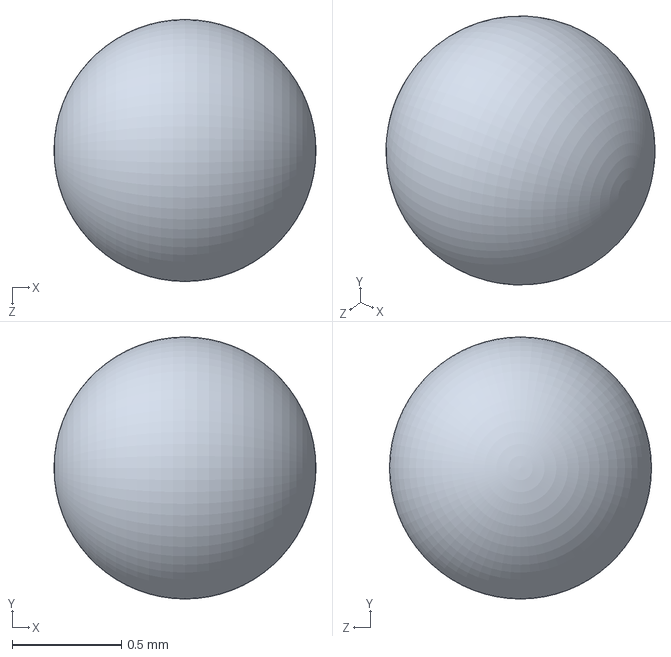
[picture p136: CAD file, 2017-04-17]
payload/BallBearingMacros/W 619_3-2Z_PART3.sldprt
1.20 x 1.20 x 1.20 mm
