irec-duster/RORO/payload/for3dprinting/10May/Cut-Extrude11.sldprt

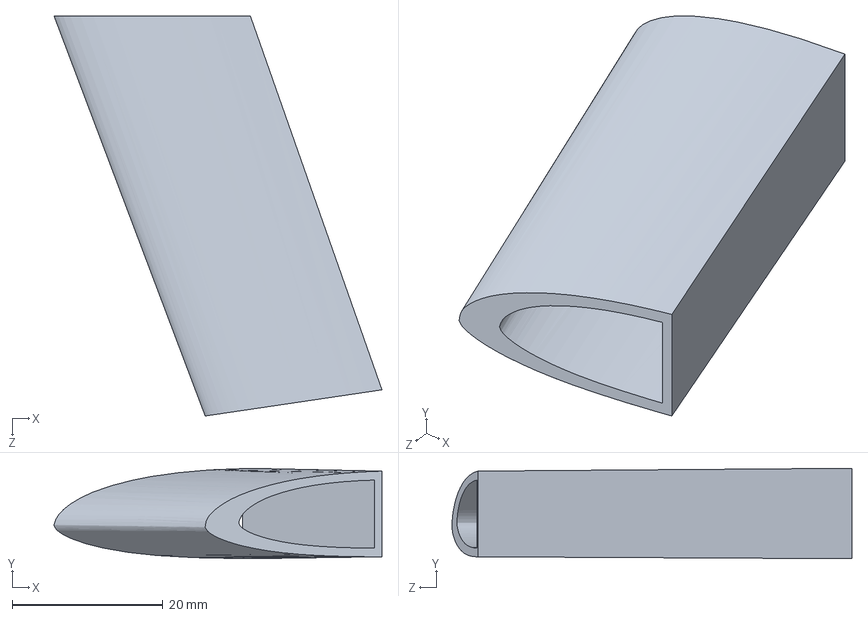
[picture p137: CAD file, 2017-05-12]
payload/for3dprinting/10May/Cut-Extrude11.sldprt
43.5 x 12.0 x 53.1 mm
