irec-duster/RORO/payload/for3dprinting/11May/trailing edge.STL

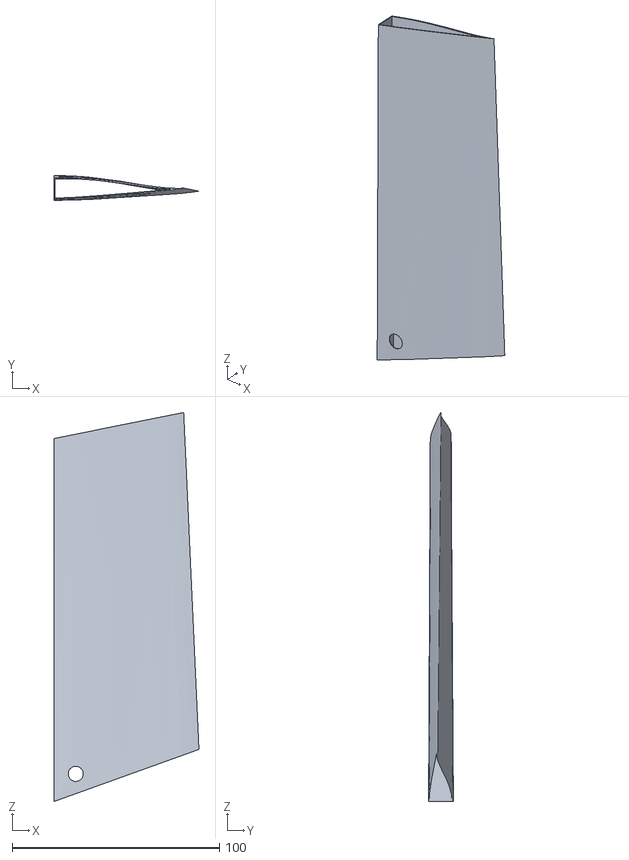
[picture p138: CAD file, 2017-05-12]
payload/for3dprinting/11May/trailing edge.STL
70.0 x 12.0 x 187.9
