irec-duster/RORO/payload/for3dprinting/14June/Part10.SLDPRT

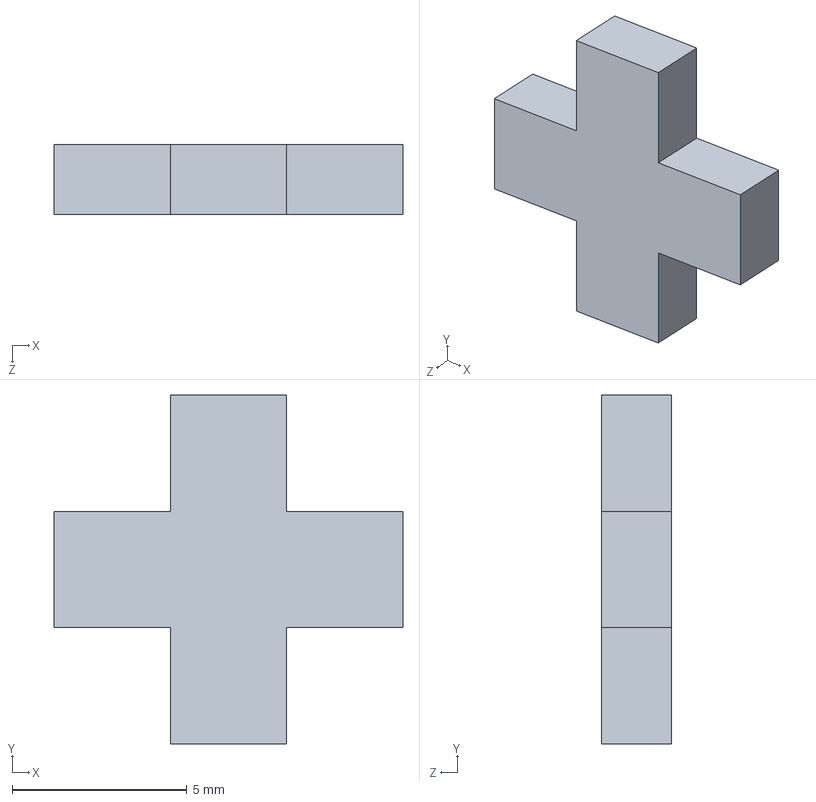
[picture p139: CAD file, 2017-06-14]
payload/for3dprinting/14June/Part10.SLDPRT
10.0 x 10.0 x 2.00 mm
