irec-duster/RORO/payload/prototyping/wing_down.SLDPRT

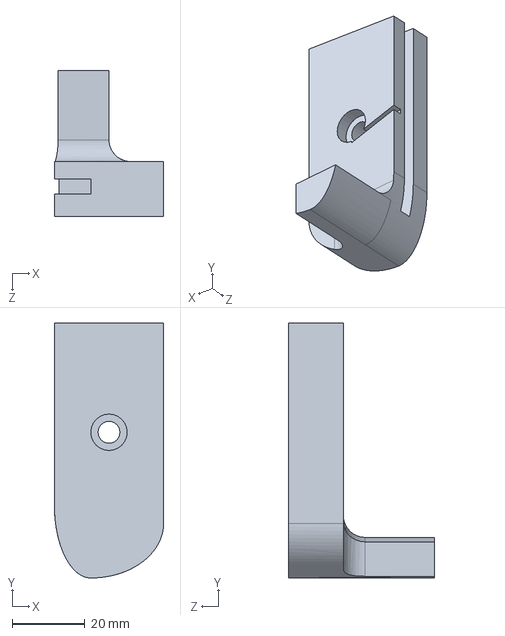
[picture p140: CAD file, 2017-06-02]
payload/prototyping/wing_down.SLDPRT
30.0 x 70.0 x 40.0 mm
