irec-duster/RORO/RORO_1/2113_upper_mountign_plate.SLDPRT

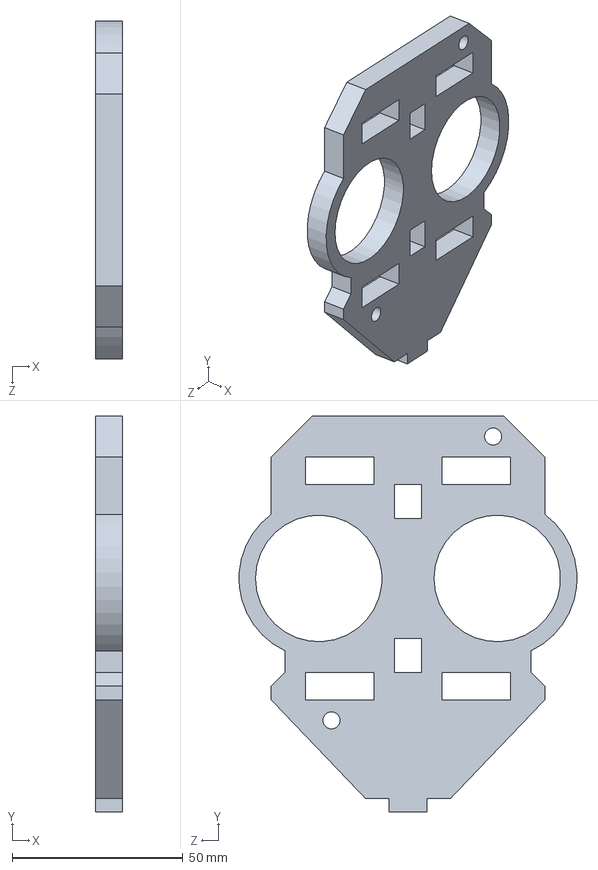
[picture p141: CAD file, 2017-07-04]
RORO_1/2113_upper_mountign_plate.SLDPRT
8.00 x 115.8 x 98.8 mm
