irec-duster/RORO/RORO_1/GoPro_Hero5_SW/GoPro_Hero5Hero5_shotring.SLDPRT

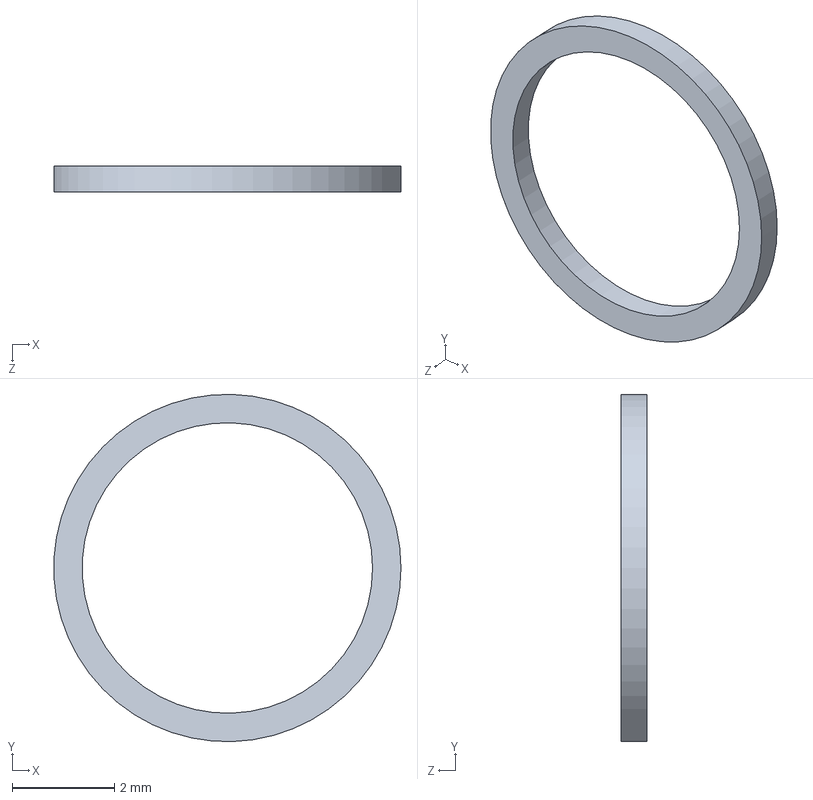
[picture p142: CAD file, 2017-05-17]
RORO_1/GoPro_Hero5_SW/GoPro_Hero5Hero5_shotring.SLDPRT
6.80 x 6.80 x 0.5 mm
