irec-duster/RORO/Avionics_RORO/CAD/Nosecone/3003_Control_panel.SLDPRT

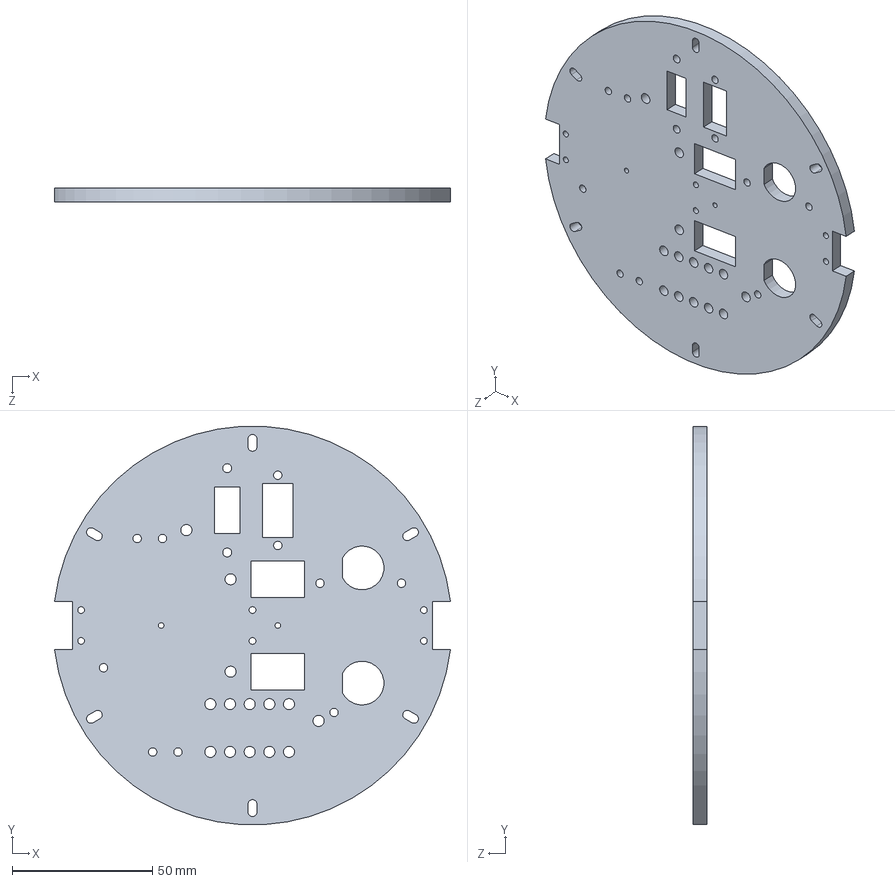
[picture p143: CAD file, 2017-05-22]
Avionics_RORO/CAD/Nosecone/3003_Control_panel.SLDPRT
141.0 x 141.8 x 5.00 mm
