irec-duster/RORO/Avionics_RORO/CAD/Nosecone/3100_Locking system/Part/Horn.SLDPRT

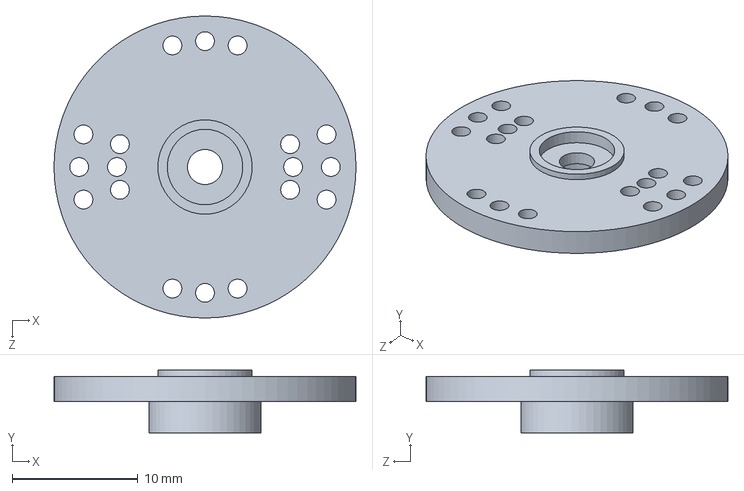
[picture p144: CAD file, 2017-04-27]
Avionics_RORO/CAD/Nosecone/3100_Locking system/Part/Horn.SLDPRT
24.0 x 5.00 x 24.0 mm
