irec-duster/RORO/Avionics_RORO/CAD/Nosecone/3400_Rail/nylon_bumper.SLDPRT

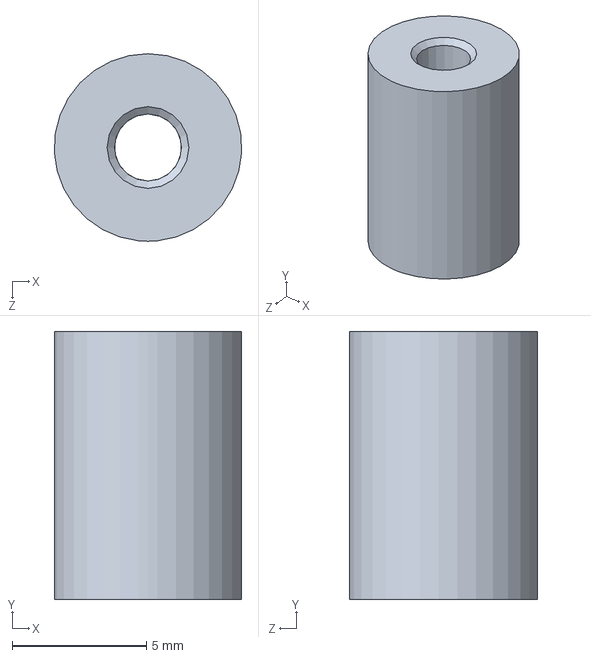
[picture p145: CAD file, 2017-05-07]
Avionics_RORO/CAD/Nosecone/3400_Rail/nylon_bumper.SLDPRT
6.99 x 10.0 x 7.00 mm
