irec-duster/RORO/Avionics_RORO/CAD/Nosecone/3500_Gliding_structure/3504_woodplate.SLDPRT

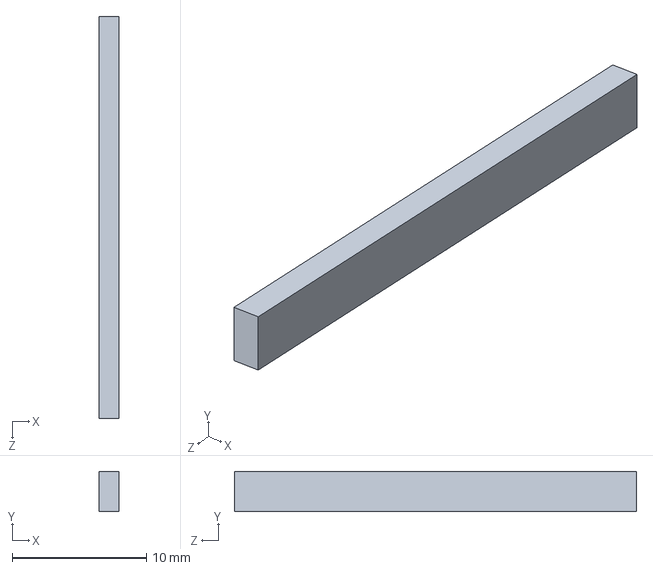
[picture p146: CAD file, 2017-05-07]
Avionics_RORO/CAD/Nosecone/3500_Gliding_structure/3504_woodplate.SLDPRT
1.50 x 3.00 x 30.0 mm
