irec-duster/RORO/payload/BallBearingMacros/604-2Z_PART3.sldprt

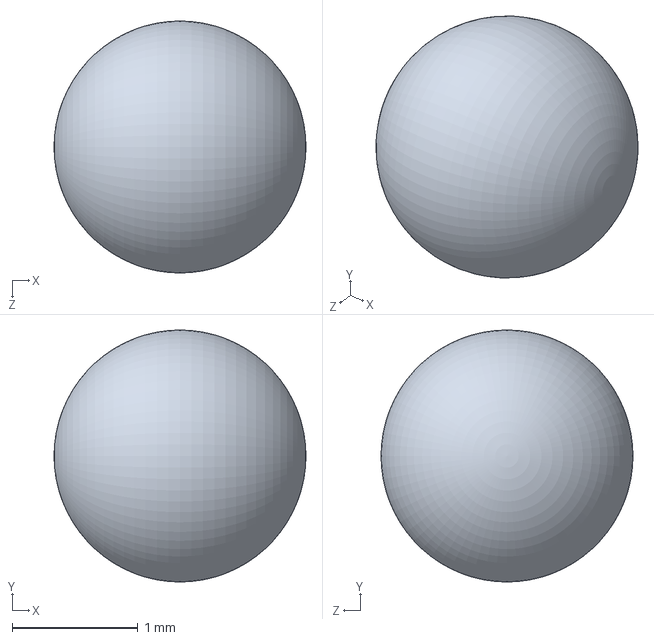
[picture p147: CAD file, 2017-04-16]
payload/BallBearingMacros/604-2Z_PART3.sldprt
2.00 x 2.00 x 2.00 mm
