irec-duster/RORO/payload/HS85MG/HS85MG_upper.SLDPRT

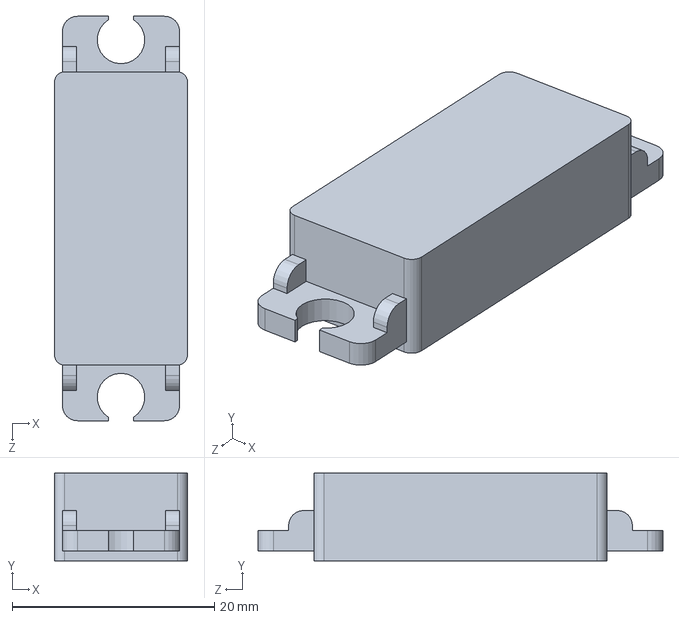
[picture p148: CAD file, 2017-05-07]
payload/HS85MG/HS85MG_upper.SLDPRT
13.1 x 8.70 x 40.0 mm
