irec-duster/RORO/payload/prototyping/wing_up.SLDPRT

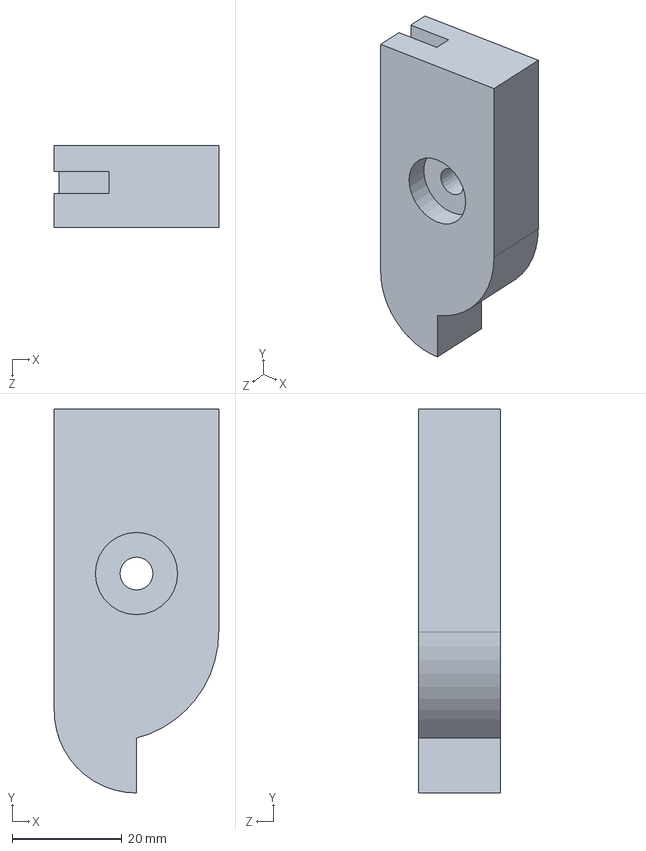
[picture p149: CAD file, 2017-06-02]
payload/prototyping/wing_up.SLDPRT
30.0 x 70.0 x 15.0 mm
