irec-duster/RORO/RORO_1/1101_AeroTech_RM98_7680.SLDPRT

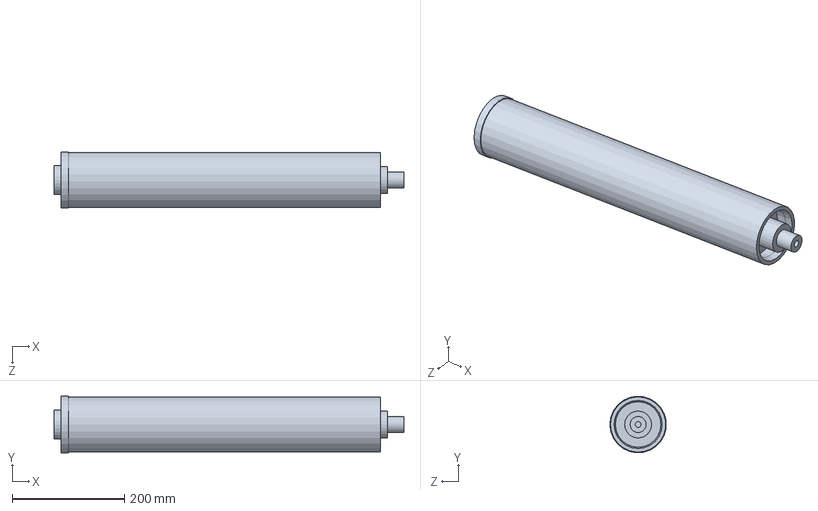
[picture p150: CAD file, 2017-07-04]
RORO_1/1101_AeroTech_RM98_7680.SLDPRT
623.3 x 100.6 x 100.4 mm
