irec-duster/RORO/RORO_1/GoPro_Hero5_SW/GoPro_Hero5Hero5_seal.SLDPRT

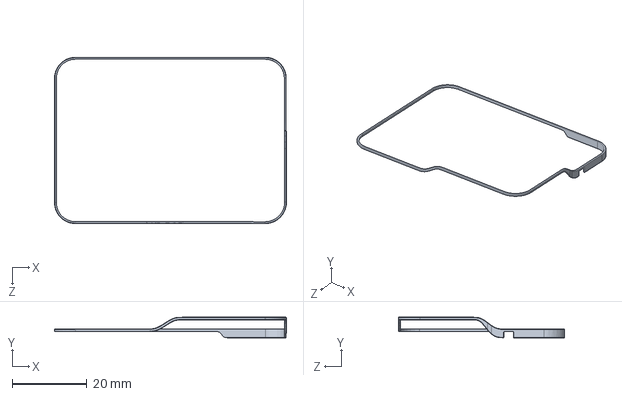
[picture p151: CAD file, 2017-05-17]
RORO_1/GoPro_Hero5_SW/GoPro_Hero5Hero5_seal.SLDPRT
62.1 x 5.49 x 44.5 mm
