irec-duster/RORO/Avionics_RORO/CAD/Nosecone/3007_Support_Battery_1.SLDPRT

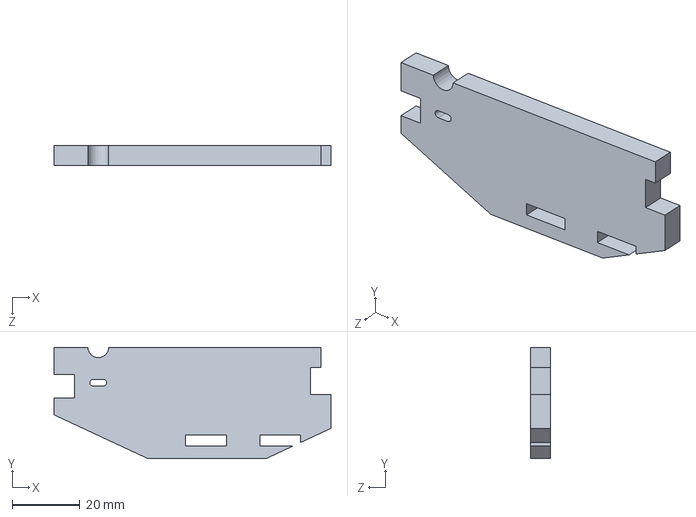
[picture p152: CAD file, 2017-05-22]
Avionics_RORO/CAD/Nosecone/3007_Support_Battery_1.SLDPRT
82.0 x 33.0 x 6.00 mm
