irec-duster/RORO/Avionics_RORO/CAD/Nosecone/3100_Locking system/Part/Support_servo_1.SLDPRT

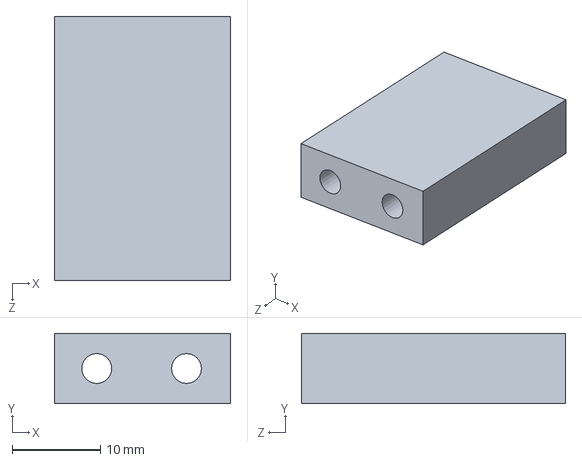
[picture p153: CAD file, 2017-04-27]
Avionics_RORO/CAD/Nosecone/3100_Locking system/Part/Support_servo_1.SLDPRT
20.0 x 8.00 x 30.0 mm
