irec-duster/RORO/Avionics_RORO/CAD/Nosecone/3400_Rail/3406_Lower_link.SLDPRT

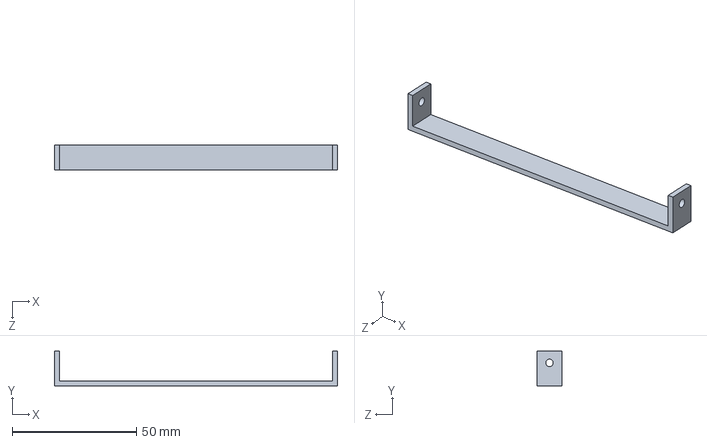
[picture p154: CAD file, 2017-05-07]
Avionics_RORO/CAD/Nosecone/3400_Rail/3406_Lower_link.SLDPRT
114.0 x 14.0 x 10.0 mm
