irec-duster/RORO/Avionics_RORO/CAD/Nosecone/3500_Gliding_structure/3501_Coupler.SLDPRT

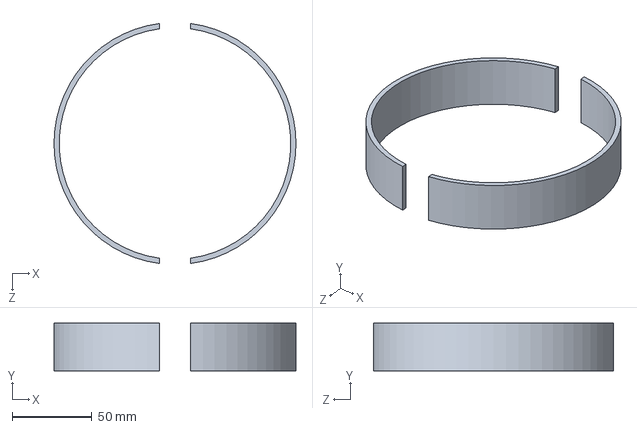
[picture p155: CAD file, 2017-05-07]
Avionics_RORO/CAD/Nosecone/3500_Gliding_structure/3501_Coupler.SLDPRT
152.0 x 30.0 x 150.7 mm
