irec-duster/RORO/payload/BallBearingMacros/604-2Z_PART2.sldprt

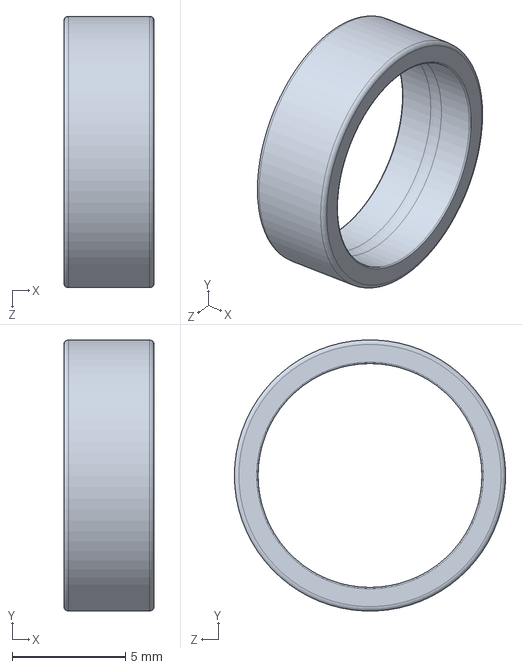
[picture p156: CAD file, 2017-04-16]
payload/BallBearingMacros/604-2Z_PART2.sldprt
4.00 x 12.0 x 12.0 mm
