irec-duster/RORO/payload/for3dprinting/11May/Cut-Extrude16[1].sldprt

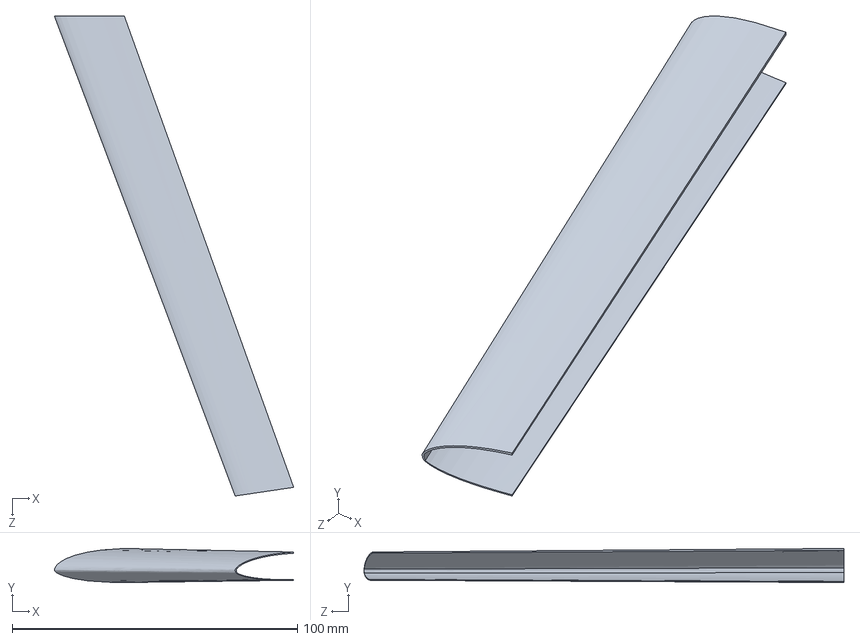
[picture p157: CAD file, 2017-05-12]
payload/for3dprinting/11May/Cut-Extrude16[1].sldprt
83.9 x 12.0 x 168.2 mm
