irec-duster/RORO/RORO_2/Active control/enveloppe active control.SLDPRT

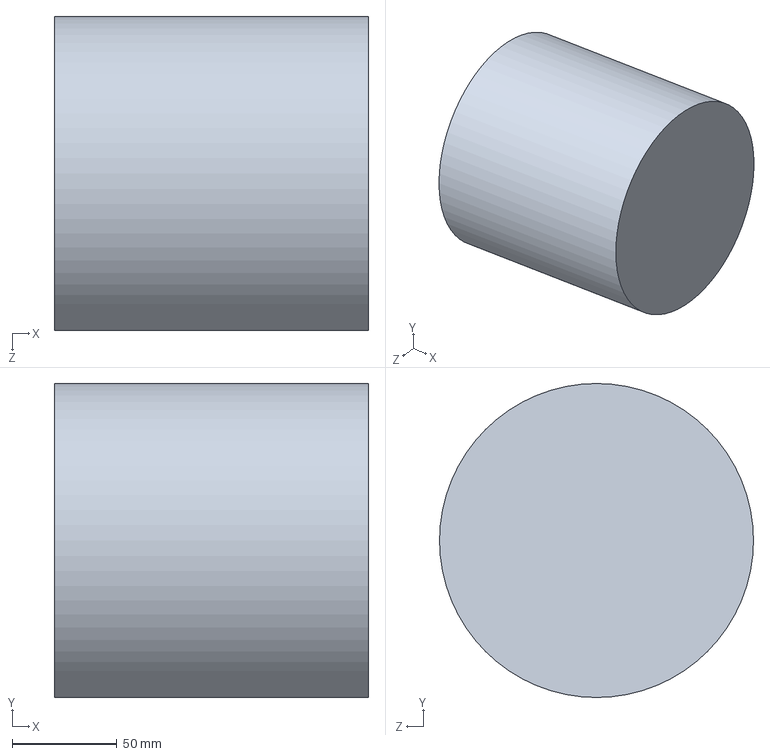
[picture p158: CAD file, 2017-03-22]
RORO_2/Active control/enveloppe active control.SLDPRT
150.0 x 150.0 x 150.0 mm
