irec-duster/RORO/Avionics_RORO/CAD/Nosecone/3008_Support_PCB_foam_3.SLDPRT

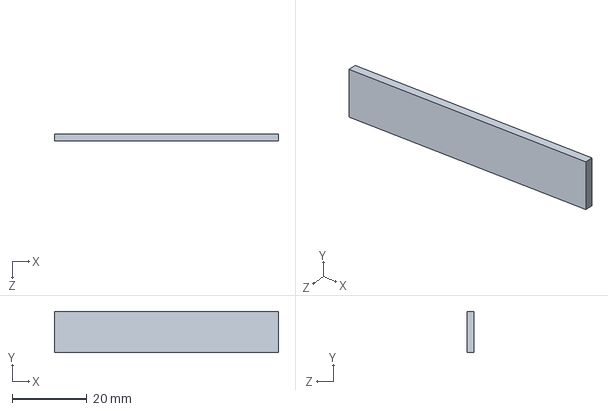
[picture p159: CAD file, 2017-05-22]
Avionics_RORO/CAD/Nosecone/3008_Support_PCB_foam_3.SLDPRT
60.0 x 11.0 x 2.00 mm
