irec-duster/RORO/Avionics_RORO/CAD/Nosecone/3100_Locking system/Part/Spline.SLDPRT

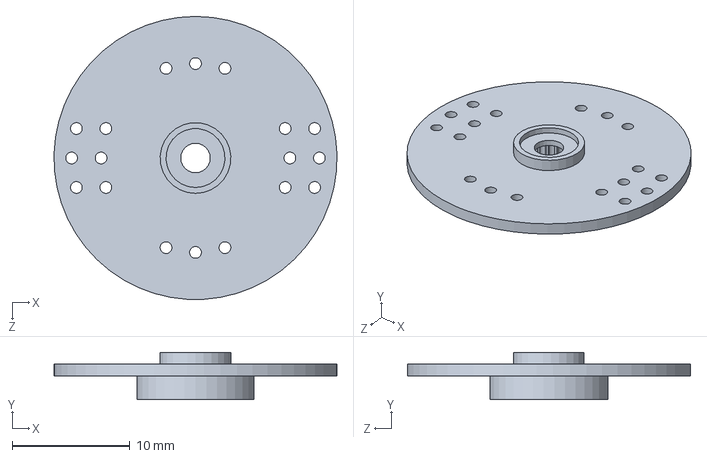
[picture p160: CAD file, 2017-04-27]
Avionics_RORO/CAD/Nosecone/3100_Locking system/Part/Spline.SLDPRT
24.0 x 4.00 x 24.0 mm
