irec-duster/RORO/Avionics_RORO/CAD/Nosecone/Mass budget parts/USB cable.SLDPRT

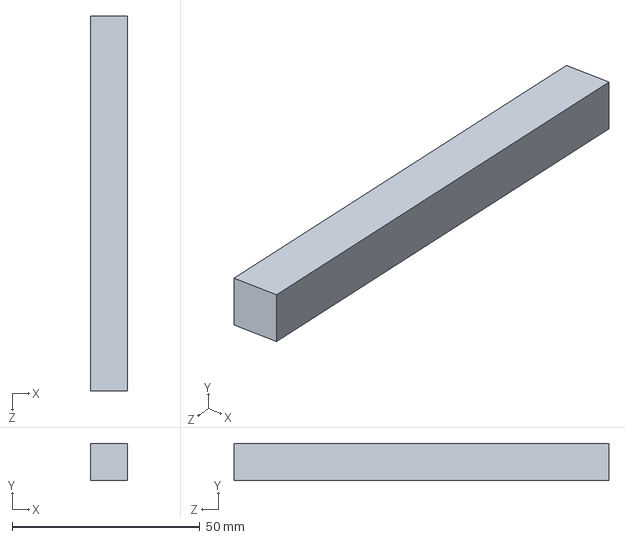
[picture p161: CAD file, 2017-04-27]
Avionics_RORO/CAD/Nosecone/Mass budget parts/USB cable.SLDPRT
10.0 x 10.0 x 100.0 mm
