irec-duster/RORO/payload/for3dprinting/11May/leading edge.STL

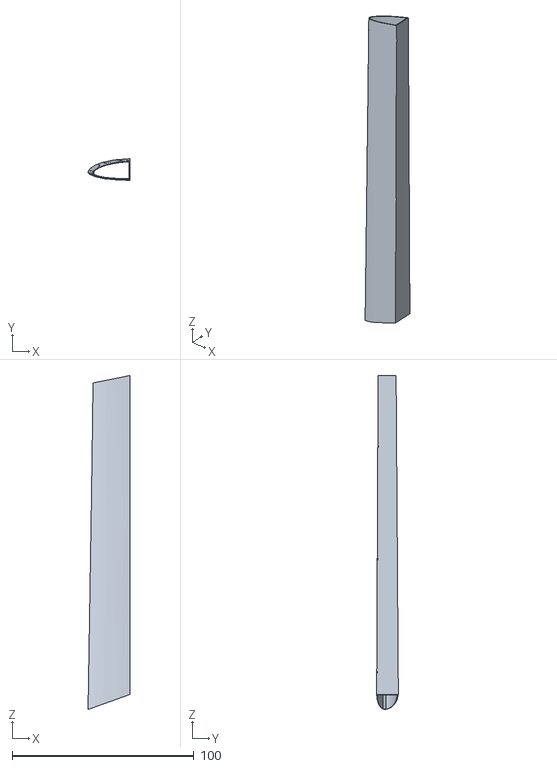
[picture p162: CAD file, 2017-05-12]
payload/for3dprinting/11May/leading edge.STL
23.1 x 12.0 x 183.8
