irec-duster/RORO/payload/prototyping/spring.SLDPRT

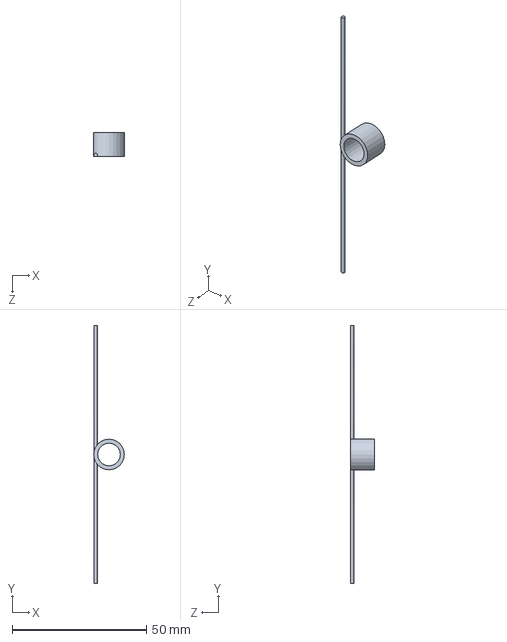
[picture p163: CAD file, 2017-05-31]
payload/prototyping/spring.SLDPRT
11.4 x 96.0 x 9.10 mm
