irec-duster/RORO/RORO_1/cnc/1302_CENTERING RING M.DXF

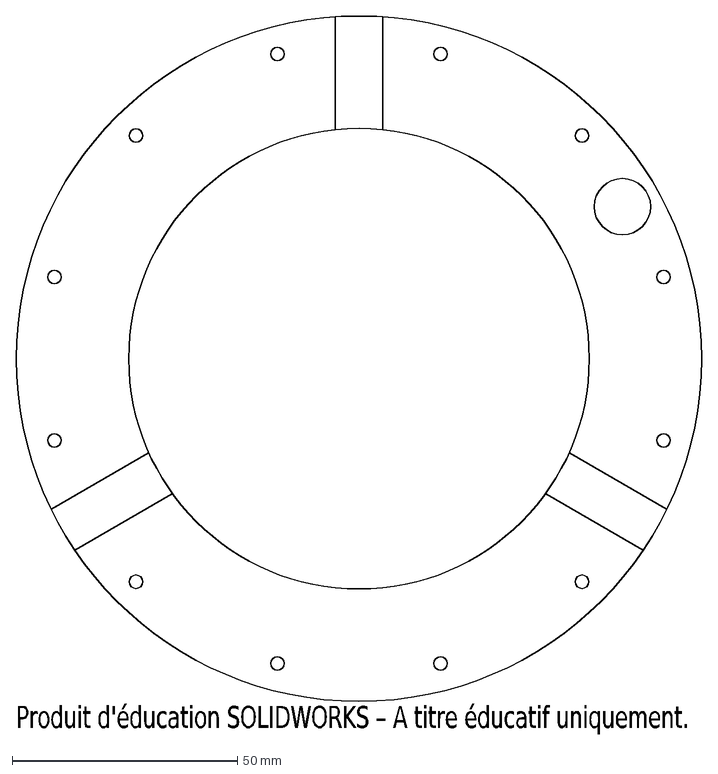
[picture p164: CAD file, 2017-03-27]
RORO_1/cnc/1302_CENTERING RING M.DXF
Produit d'éducation SOLIDWORKS – A titre éducatif uniquement.
