irec-duster/RORO/Avionics_RORO/CAD/Nosecone/3007_Support_PCB_9.SLDPRT

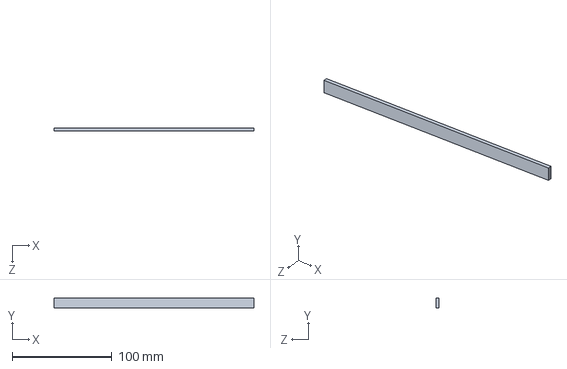
[picture p165: CAD file, 2017-05-22]
Avionics_RORO/CAD/Nosecone/3007_Support_PCB_9.SLDPRT
200.0 x 10.0 x 3.00 mm
