irec-duster/RORO/Avionics_RORO/CAD/Nosecone/3100_Locking system/Part/3104_Came.SLDPRT

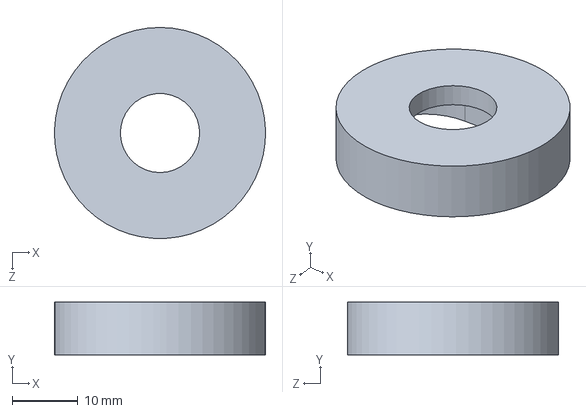
[picture p166: CAD file, 2017-04-27]
Avionics_RORO/CAD/Nosecone/3100_Locking system/Part/3104_Came.SLDPRT
32.0 x 8.00 x 32.0 mm
