irec-duster/RORO/Avionics_RORO/CAD/Nosecone/3400_Rail/3405_Hook_holder.SLDPRT

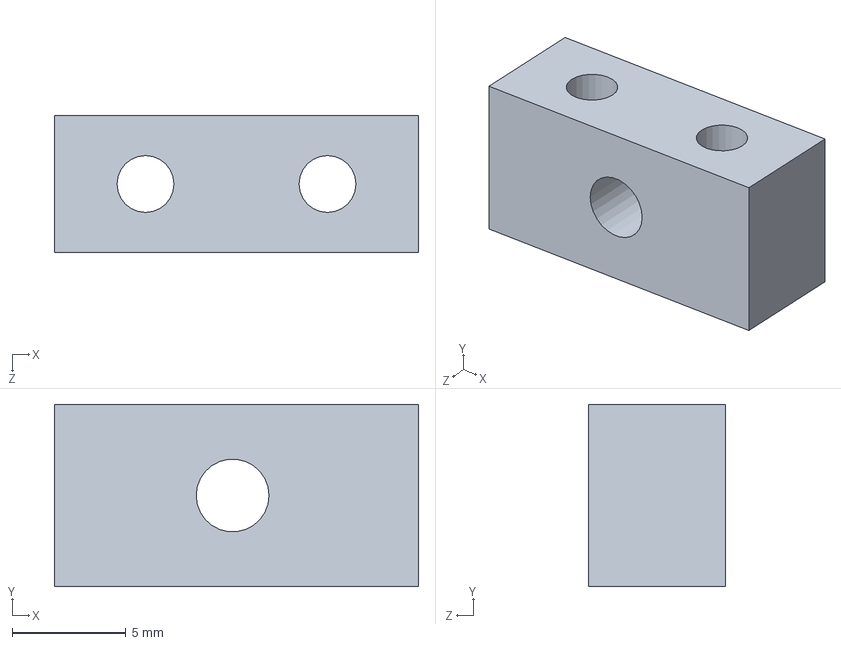
[picture p167: CAD file, 2017-04-27]
Avionics_RORO/CAD/Nosecone/3400_Rail/3405_Hook_holder.SLDPRT
16.0 x 8.00 x 6.00 mm
