irec-duster/RORO/payload/BallBearingMacros/604-2Z_PART1.sldprt

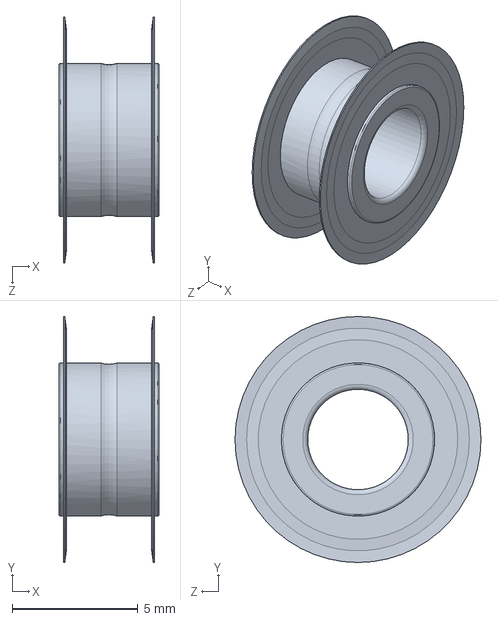
[picture p168: CAD file, 2017-04-16]
payload/BallBearingMacros/604-2Z_PART1.sldprt
4.00 x 9.80 x 9.80 mm
