irec-duster/RORO/payload/for3dprinting/10May/Cut-Extrude10[1].sldprt

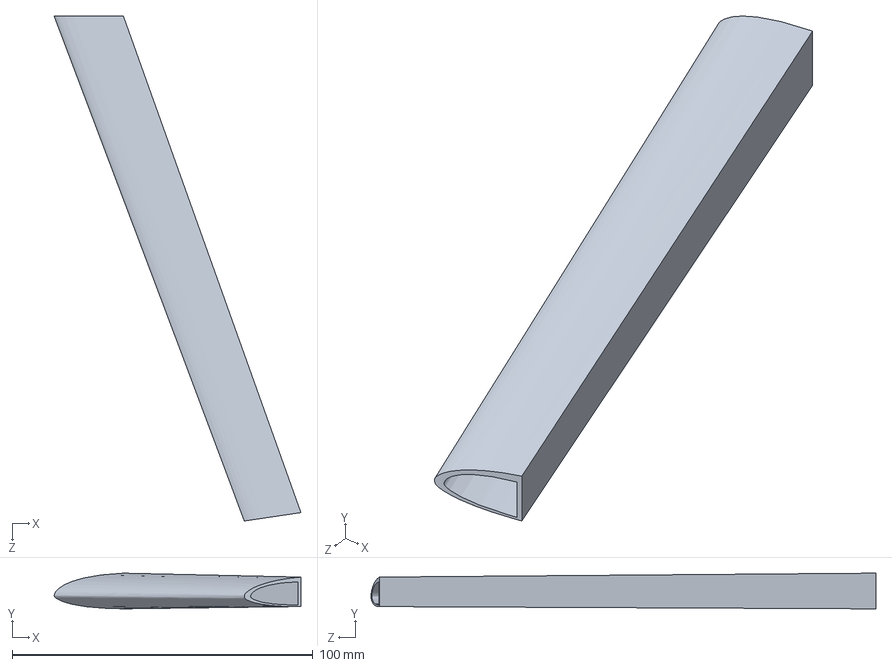
[picture p169: CAD file, 2017-05-12]
payload/for3dprinting/10May/Cut-Extrude10[1].sldprt
82.1 x 11.9 x 168.0 mm
