irec-duster/RORO/RORO_1/1105_AeroTech_M2100G.sldprt

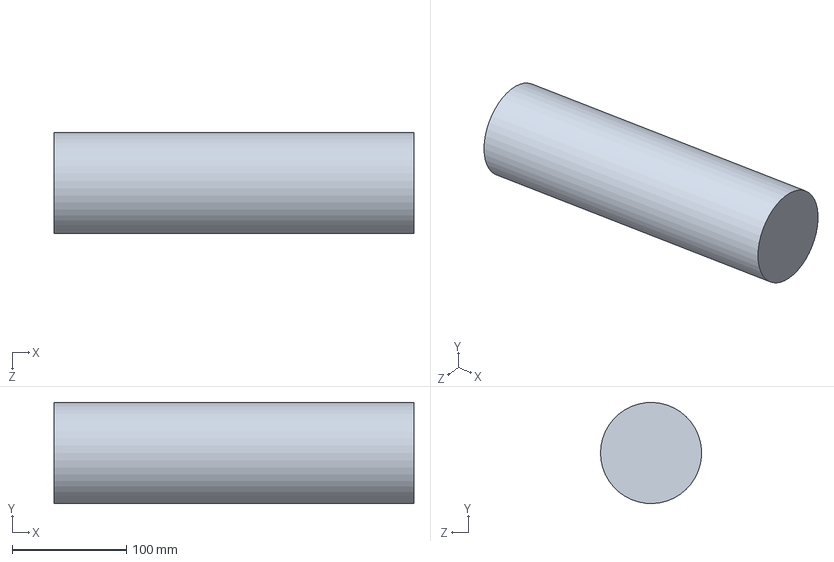
[picture p170: CAD file, 2017-07-04]
RORO_1/1105_AeroTech_M2100G.sldprt
315.2 x 88.5 x 88.4 mm
