irec-duster/RORO/Avionics_RORO/CAD/Nosecone/3007_Support_PCB_2.SLDPRT

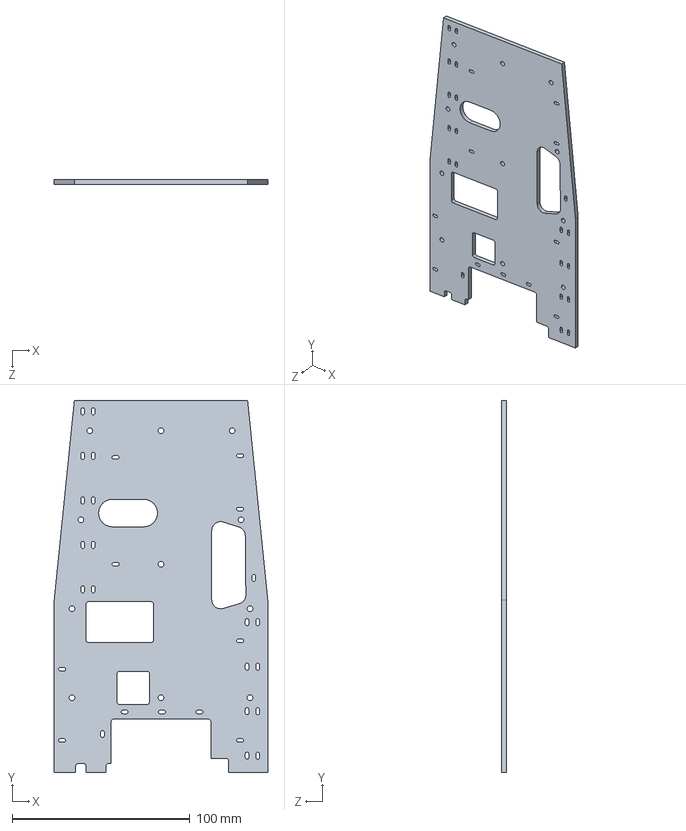
[picture p171: CAD file, 2017-05-22]
Avionics_RORO/CAD/Nosecone/3007_Support_PCB_2.SLDPRT
120.0 x 209.0 x 3.00 mm
