irec-duster/RORO/Avionics_RORO/CAD/Nosecone/3100_Locking system/Part/3101_Guide.SLDPRT

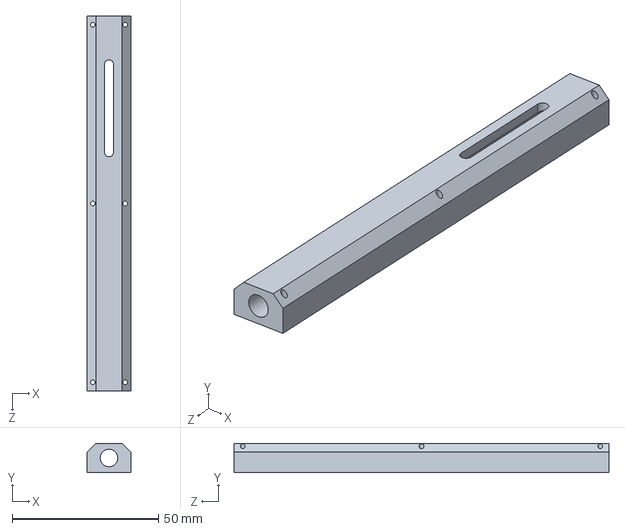
[picture p172: CAD file, 2017-04-27]
Avionics_RORO/CAD/Nosecone/3100_Locking system/Part/3101_Guide.SLDPRT
15.0 x 10.0 x 128.0 mm
