irec-duster/RORO/payload/for3dprinting/wing_left_outer_side.sldprt

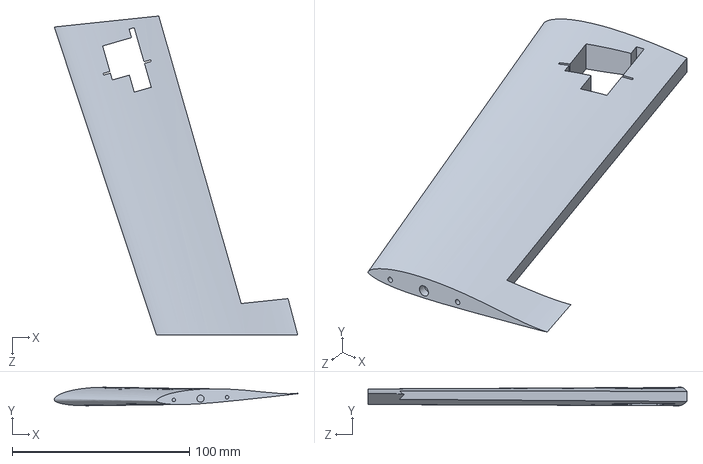
[picture p173: CAD file, 2017-04-21]
payload/for3dprinting/wing_left_outer_side.sldprt
137.6 x 10.5 x 180.2 mm
