irec-duster/RORO/payload/HS85MG/HS85MG - HS85MG_midle-1.STL

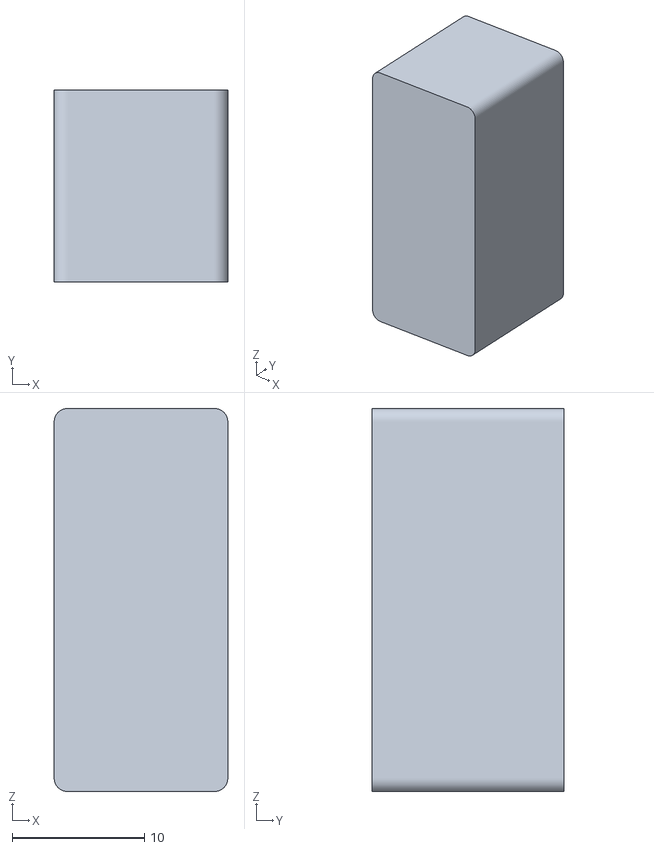
[picture p174: CAD file, 2017-05-07]
payload/HS85MG/HS85MG - HS85MG_midle-1.STL
13.2 x 14.5 x 29.0
