irec-duster/RORO/payload/prototyping/wing_left.SLDPRT

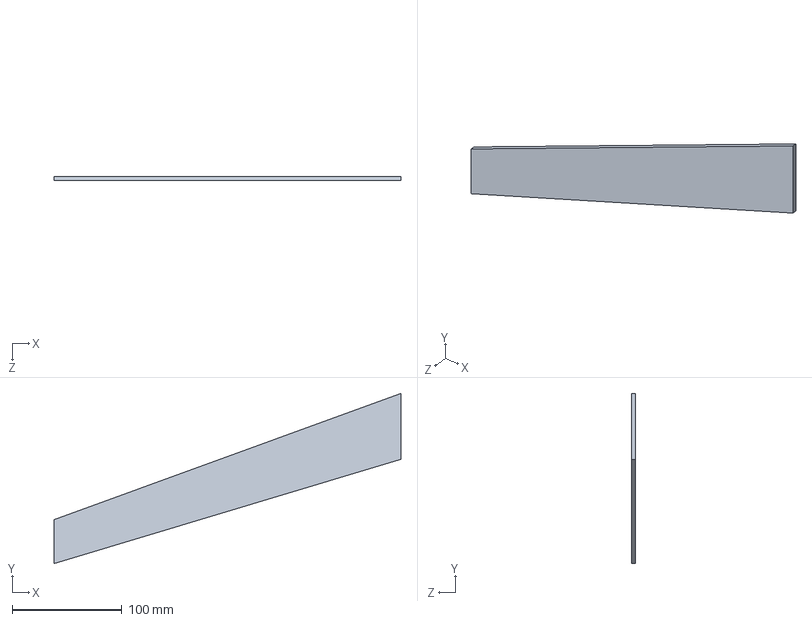
[picture p175: CAD file, 2017-05-31]
payload/prototyping/wing_left.SLDPRT
316.0 x 155.0 x 4.00 mm
