irec-duster/RORO/RORO_1/2006_payload_placeholder.SLDPRT

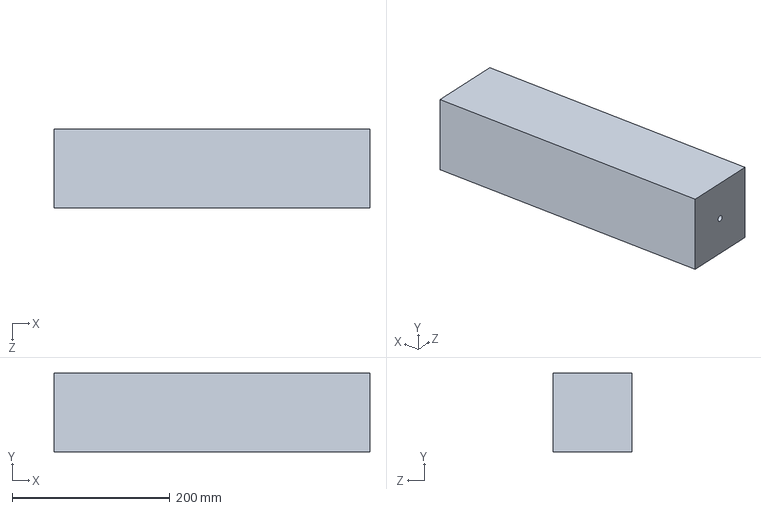
[picture p176: CAD file, 2017-07-04]
RORO_1/2006_payload_placeholder.SLDPRT
400.0 x 100.0 x 100.0 mm
