irec-duster/RORO/Avionics_RORO/CAD/Nosecone/3007_Support_PCB_7.SLDPRT

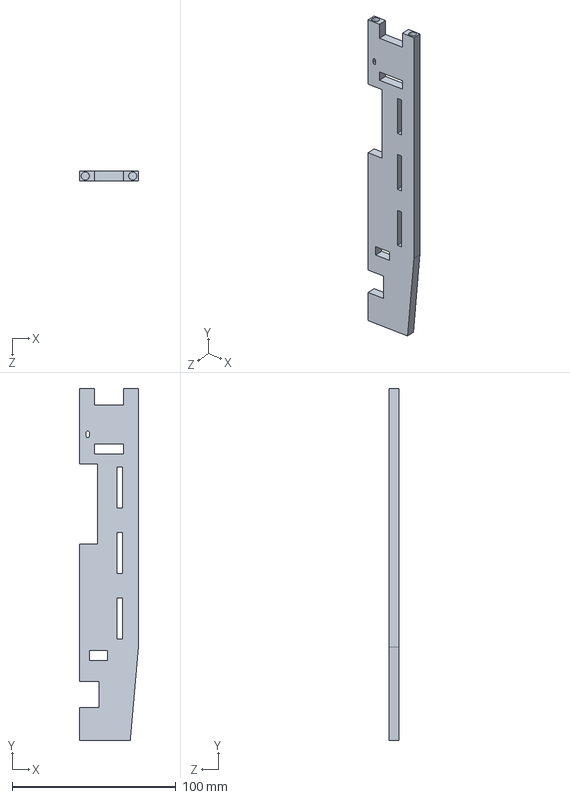
[picture p177: CAD file, 2017-05-22]
Avionics_RORO/CAD/Nosecone/3007_Support_PCB_7.SLDPRT
36.0 x 215.0 x 6.00 mm
