irec-duster/RORO/payload/for3dprinting/Boss-Extrude2.sldprt

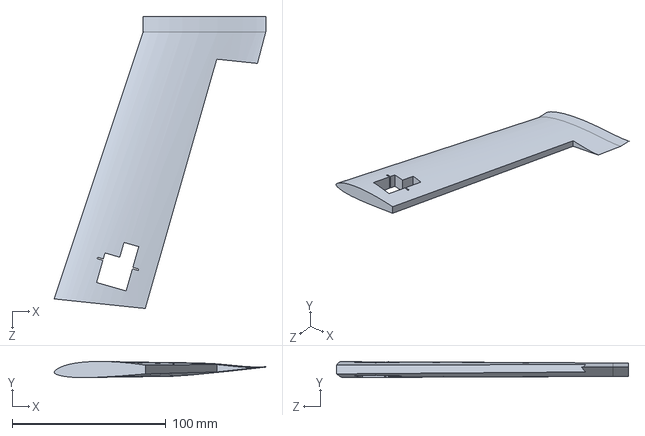
[picture p178: CAD file, 2017-04-21]
payload/for3dprinting/Boss-Extrude2.sldprt
137.8 x 10.5 x 190.2 mm
