irec-duster/RORO/RORO_1/1407_GoPro_case.SLDPRT

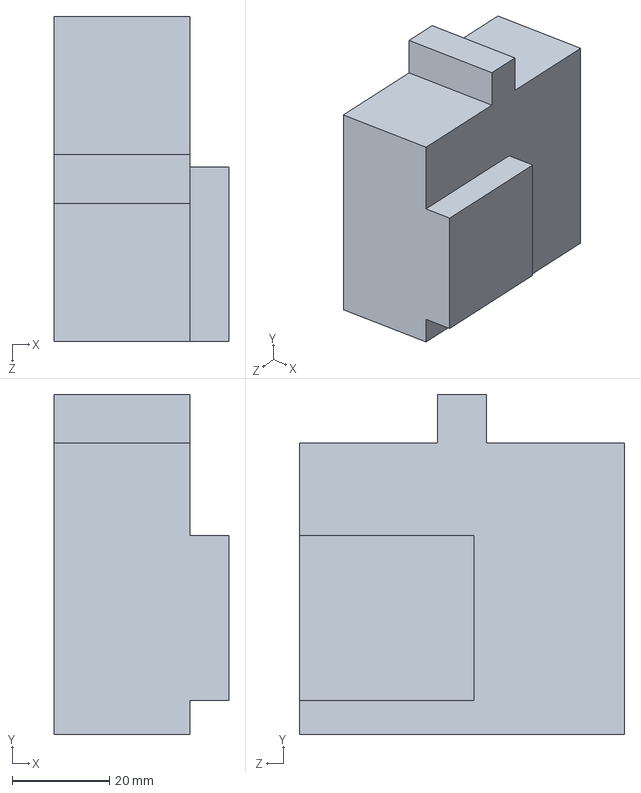
[picture p179: CAD file, 2017-07-04]
RORO_1/1407_GoPro_case.SLDPRT
36.0 x 70.0 x 67.0 mm
