irec-duster/RORO/Avionics_RORO/CAD/Nosecone/3007_Support_PCB_5_1.DXF

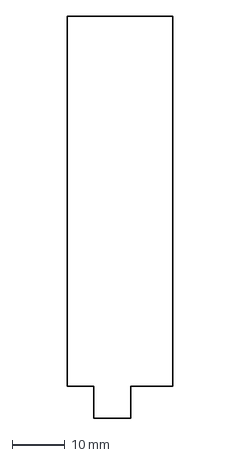
[picture p180: CAD file, 2017-05-22]
Avionics_RORO/CAD/Nosecone/3007_Support_PCB_5_1.DXF
20.0 x 76.0 mm
