irec-duster/RORO/Avionics_RORO/CAD/Nosecone/3100_Locking system/Part/3105_Wheel.SLDPRT

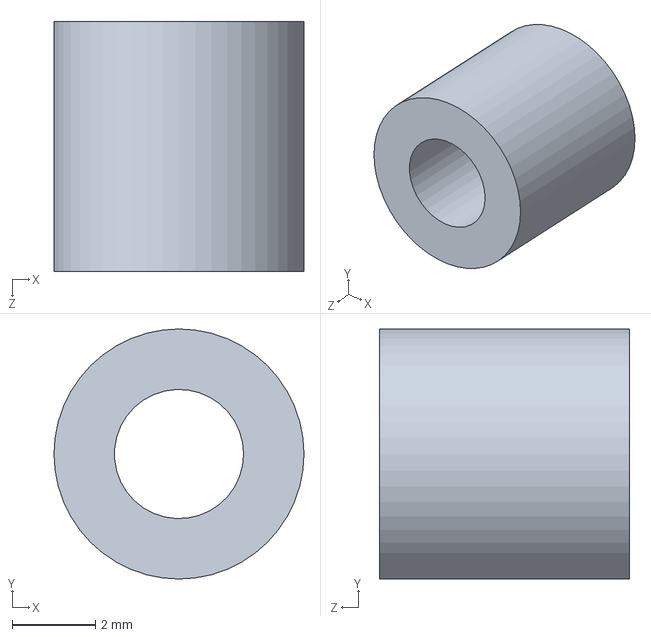
[picture p181: CAD file, 2017-04-27]
Avionics_RORO/CAD/Nosecone/3100_Locking system/Part/3105_Wheel.SLDPRT
6.00 x 6.00 x 6.00 mm
