irec-duster/RORO/payload/for3dprinting/10May/Cut-Extrude14[1].sldprt

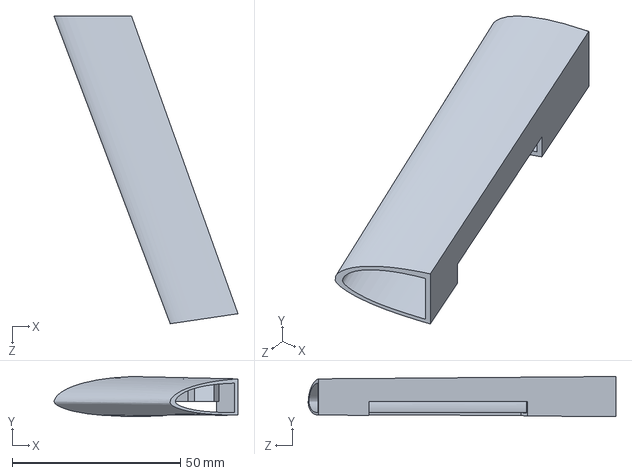
[picture p182: CAD file, 2017-05-12]
payload/for3dprinting/10May/Cut-Extrude14[1].sldprt
54.7 x 11.9 x 91.4 mm
