irec-duster/RORO/payload/for3dprinting/winglet_left_wing.STL

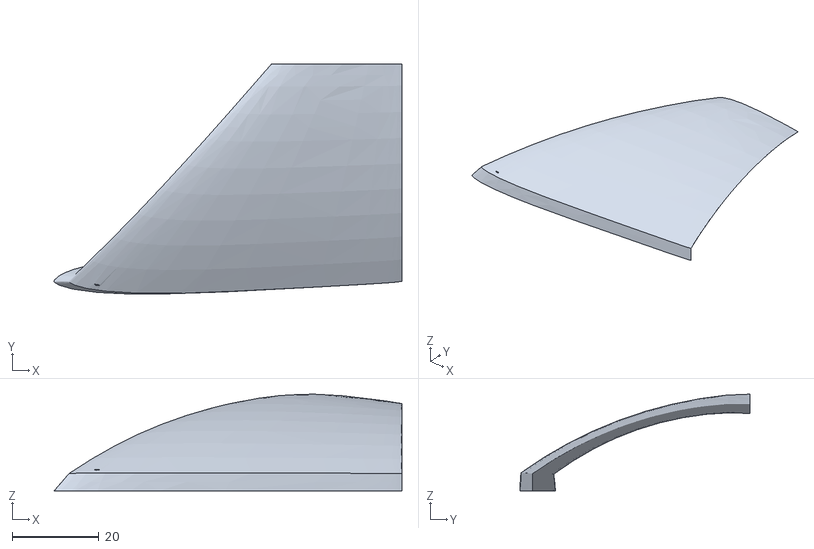
[picture p183: CAD file, 2017-04-21]
payload/for3dprinting/winglet_left_wing.STL
80.0 x 52.9 x 22.2
