irec-duster/RORO/RORO_2/active control/flaps_symetry.SLDPRT

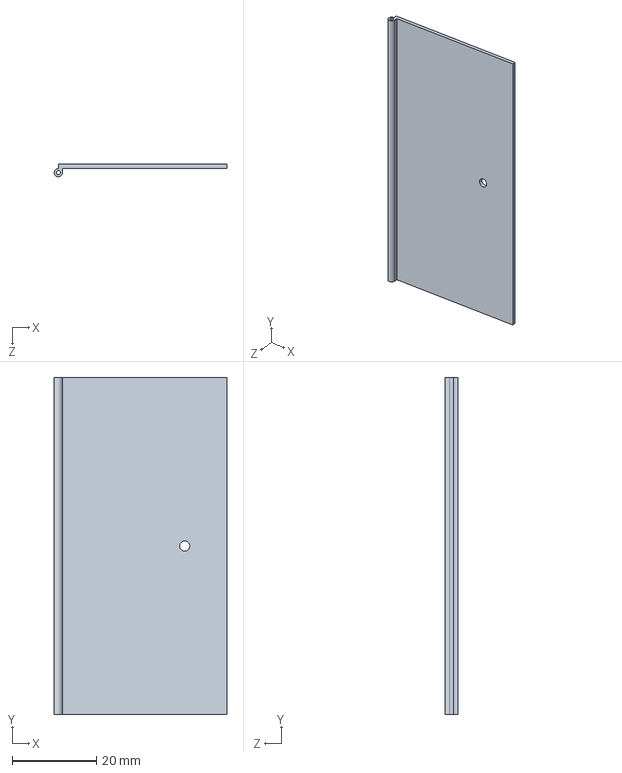
[picture p184: CAD file, 2017-03-07]
RORO_2/active control/flaps_symetry.SLDPRT
41.0 x 80.0 x 3.00 mm
