irec-duster/RORO/(list of files, cad)

Other CAD files:
RORO_1/1600_1U_weight_payload.SLDASM
payload/Airfoil/mh60.SLDPRT
payload/for3dprinting/14June/outer_leading.sldprt
Avionics_RORO/TI simulation/export altium/Altium/2017-01-30_01-57-48/0805.stp
Avionics_RORO/TI simulation/export altium/Altium/2017-01-30_01-57-51/1206_190.stp
payload/for3dprinting/14June/aileron.sldprt
Avionics_RORO/TI simulation/export altium/Altium/2017-01-30_01-57-51/MXA20A.stp
payload/for3dprinting/11May/Cut-Loft2.sldprt
RORO_1/cnc/1403_coupler_lid.DXF
RORO_1/cnc/1406_coupler_lid_mount.DXF
payload/for3dprinting/11May/0-3mmthickoffsetwing2.STL
payload/for3dprinting/14June/outer_trailing.sldprt
RORO_1/cnc/2102_Recovery_bulkhead_mount.DXF
payload/HS85MG/HS85MG - HS85MG_upper-1.STL
Avionics_RORO/CAD/Nosecone/3400_Rail/3402_Rail_drylin_N.sldprt
Avionics_RORO/CAD/Nosecone/3500_Gliding_structure/Gliding element.sldprt
payload/HS85MG/HS85MG_top.SLDPRT
payload/HS85MG/HS85MG - HS85MG_bottom-1.STL
RORO_1/cnc/1204_FIN.DXF
Avionics_RORO/CAD/Nosecone/3100_Locking system/Part/HiTEC HS-5645MG.SLDPRT
payload/prototyping/wing_right.SLDPRT
Avionics_RORO/CAD/For laser cutter/Support pitot tube.SLDDRW
Avionics_RORO/CAD/Nosecone/3001_Nosecone.SLDPRT
Avionics_RORO/CAD/Nosecone/3002_Crown.SLDPRT
Avionics_RORO/CAD/Nosecone/3004_Front_GNSS_ant_plane.SLDPRT
Avionics_RORO/CAD/Nosecone/3005_Pitot_tube.SLDPRT
Avionics_RORO/CAD/Nosecone/3007_Support_Battery_2.SLDPRT
Avionics_RORO/CAD/Nosecone/3007_Support_PCB_3.SLDPRT
Avionics_RORO/CAD/Nosecone/3007_Support_PCB_5.SLDPRT
Avionics_RORO/CAD/Nosecone/3007_Support_PCB_8.SLDPRT
Avionics_RORO/CAD/Nosecone/3007_Support_Servo.SLDPRT
Avionics_RORO/CAD/Nosecone/3008_Support_PCB_foam_1.SLDPRT
Avionics_RORO/CAD/Nosecone/3008_Support_PCB_foam_2.SLDPRT
Avionics_RORO/CAD/Nosecone/Bought/4000 full assembly_4-05-13.SLDPRT
Avionics_RORO/CAD/Nosecone/Bought/430250400.SLDPRT
Avionics_RORO/CAD/Nosecone/Bought/430250400.stp
Avionics_RORO/CAD/Nosecone/Bought/Battery 3S 1.8Ah.SLDPRT
Avionics_RORO/CAD/Nosecone/Bought/DB9RA_F.SLDPRT
Avionics_RORO/CAD/Nosecone/Bought/DB9RA_M.SLDPRT
Avionics_RORO/CAD/Nosecone/Bought/DB9_M.SLDPRT
Avionics_RORO/CAD/Nosecone/Bought/DryLin__NK_02_17_2__500_1.SLDASM
Avionics_RORO/CAD/Nosecone/Bought/Equerre_Keystone_4335.SLDPRT
Avionics_RORO/CAD/Nosecone/Bought/GNSS_Ant.SLDPRT
Avionics_RORO/CAD/Nosecone/Bought/Hex Spacer FF M3 L11mm.SLDPRT
Avionics_RORO/CAD/Nosecone/Bought/Hex Spacer MF M3 L8mm.SLDPRT
Avionics_RORO/CAD/Nosecone/Bought/LED_558XXXX007F.SLDPRT
Avionics_RORO/CAD/Nosecone/Bought/Tige_filtee.SLDPRT
Avionics_RORO/CAD/Nosecone/Bought/bd-06pmfs-qc8001_sw0001.SLDPRT
Avionics_RORO/CAD/Nosecone/Bought/kq2l08-99a.SLDPRT
Avionics_RORO/CAD/Nosecone/Dim_Ressort_E03600456000S.SLDPRT
Avionics_RORO/CAD/Nosecone/Drawing/3003_Control_panel.SLDDRW
Avionics_RORO/CAD/Nosecone/Drawing/3004_Front_GNSS_ant_plane.SLDDRW
Avionics_RORO/CAD/Nosecone/Drawing/3101_Guide.SLDDRW
Avionics_RORO/CAD/Nosecone/Drawing/3103_Rod_small.SLDDRW
Avionics_RORO/CAD/Nosecone/GNSS_Ant.SLDPRT
Avionics_RORO/CAD/Nosecone/Half tube upper boddy.SLDPRT
Avionics_RORO/CAD/Nosecone/HiTEC HS-5645MG.SLDPRT
Avionics_RORO/CAD/Nosecone/Mass budget parts/Control panel screws mass.SLDPRT
Avionics_RORO/CAD/Nosecone/Mass budget parts/GND plane screws mass.SLDPRT
Avionics_RORO/CAD/Nosecone/Mass budget parts/PCB screws mass.SLDPRT
Avionics_RORO/CAD/Nosecone/Mass budget parts/Upper rail screws mass.SLDPRT
Avionics_RORO/CAD/Nosecone/Playload_vol.SLDPRT
Avionics_RORO/CAD/Nosecone/Rail.SLDPRT
Avionics_RORO/CAD/Nosecone/Spiral_flex_tube.SLDPRT
Avionics_RORO/CAD/Nosecone/Support pitot tube.SLDPRT
Avionics_RORO/CAD/Nosecone/Support_flextube_1.SLDPRT
Avionics_RORO/CAD/Nosecone/Support_flextube_2.SLDPRT
Avionics_RORO/CAD/Nosecone/Switch_cover.SLDPRT
Avionics_RORO/CAD/Nosecone/Tube_brass.SLDPRT
Avionics_RORO/CAD/Nosecone/U_rail.SLDPRT
Avionics_RORO/CAD/Nosecone/XBee_Ant.SLDPRT
Avionics_RORO/CAD/Nosecone/spacer_m3_2mm.SLDPRT
Avionics_RORO/CAD/Nosecone/spacer_m3_5mm.SLDPRT
Avionics_RORO/CAD/Nosecone/spacer_rail_tube.SLDPRT
RORO-II/20000_RORO-II.SLDASM
RORO-II/21000_LOWER BODY RORO-II.SLDASM
RORO-II/21001_LOWER BODY TUBE.SLDPRT
RORO-II/21002_Lower launch lug attachment.SLDPRT
RORO-II/21003_Upper Launch Lug Attachment.SLDPRT
RORO-II/21004_launch_lug.SLDPRT
RORO-II/21100_PROPULSION ASSEMBLY.SLDASM
RORO-II/21100_PROPULSION.sldasm
RORO-II/21101_Motor Housing Aerotech RM98 7680.SLDPRT
RORO-II/21103_MOTOR RETAINER.SLDPRT
RORO-II/21104 _MOTOR RETAINER LID.sldprt
RORO-II/21105_Motor Aerotech M2400 T.sldprt
RORO-II/21107_Thrust Plate.SLDPRT
RORO-II/21108_Centering Ring Thrust Plate.SLDPRT
RORO-II/21109_Threaded_rod_M3.SLDPRT
RORO-II/21110_Nut_M3.SLDPRT
RORO-II/21111_M4 x 25 Screw.SLDPRT
RORO-II/21112_M4 Nut.SLDPRT
RORO-II/21200_FIN ASSEMBLY.SLDASM
RORO-II/21200_FIN.SLDASM
RORO-II/21201_MOTOR TUBE.sldprt
RORO-II/21202_CENTERING RING.sldprt
RORO-II/21204_FIN.SLDPRT
RORO-II/21205_fin_core.SLDPRT
RORO-II/21206_Fin Glue.SLDPRT
RORO-II/21206_fin_alignment.SLDPRT
RORO-II/21207_FIN_SW-Panel RORO II.SLDPRT
RORO-II/21300_CENTERING FIN.SLDASM
RORO-II/21302_CENTERING RING M.sldprt
RORO-II/21400_COUPLER.SLDASM
RORO-II/21401_Coupler Tube.SLDPRT
RORO-II/21402_Bulkhead lower body.SLDPRT
RORO-II/21403_Coupler Lid.SLDPRT
RORO-II/21404_Glue Lower Bulkhead.SLDPRT
RORO-II/21406_Lid Mount Coupler_1.SLDPRT
RORO-II/21406_Lid Mount Coupler_2.SLDPRT
RORO-II/21407_GoPro Fixation Assembly.SLDASM
RORO-II/21407_GoPro_case.SLDPRT
RORO-II/21408_Body Coupler Glue.SLDPRT
RORO-II/21409_M8 Threaded Rod_Recovery.SLDPRT
RORO-II/21410_Bulkhead support disk lower body.SLDPRT
RORO-II/21410_Lower Body Bulkhead Fixation.SLDPRT
RORO-II/21410_trim_weight_coupler.SLDPRT
RORO-II/21411_GoPro-Attachment_lower plate.SLDPRT
RORO-II/21412_Plastic Tube Piece - Damper.SLDPRT
RORO-II/21413_M3 x 30 Screw Hexagonal.SLDPRT
RORO-II/21500_logging_electronics_lower_body.SLDASM
RORO-II/21501_gopro_and_avionics_bulkhead.SLDPRT
RORO-II/21502_gopro_and_avionics_bulkhead_with_hexagon_holes.SLDPRT
RORO-II/21503_avionics_with_battery.SLDPRT
RORO-II/21504_ins_board.SLDPRT
RORO-II/21505_5V_battery.SLDPRT
RORO-II/22000_Upper_Body.SLDASM
RORO-II/22001_Upper Body Tube.SLDPRT
RORO-II/22002_parachutes.SLDPRT
RORO-II/22003_Upper_Body_Bulkhead.SLDPRT
RORO-II/22005_Threaded Rod.SLDPRT
RORO-II/22006_Parachute_Eyebolt.SLDPRT
RORO-II/22006_payload_placeholder.SLDPRT
RORO-II/22007_M8 Nut.SLDPRT
RORO-II/22008_Bulkhead Support.SLDPRT
RORO-II/22100_RECOVERY_BAY.SLDASM
RORO-II/22101_Recovery_bulkhead.SLDPRT
RORO-II/22102_Recovery_bulkhead_mount.SLDPRT
RORO-II/22103_Peregrine_Raptor_CO2.SLDPRT
RORO-II/22104_CO2_Cartridge_23g.SLDPRT
RORO-II/22105_AltimaxG3_avionics.SLDPRT
RORO-II/22106_Raven3_avionics.SLDPRT
RORO-II/22107_AltimaxG3_mount.SLDPRT
RORO-II/22108_Raven3_mount.SLDPRT
RORO-II/22109_9V_battery.SLDPRT
RORO-II/22110_Switch_SCHURTER_33-4504.sldprt
RORO-II/22111_Switch_mount.SLDPRT
RORO-II/22113_Upper_mounting_plate.SLDPRT
RORO-II/22114_Mounting_Reinforcement.SLDPRT
RORO-II/22200_payload_dummy.SLDASM
RORO-II/22201_alu_weight.SLDPRT
RORO-II/22202_wood_separator_between_alu_weights.SLDPRT
RORO-II/22203_adapter_3holes_to_4holes.SLDPRT
RORO-II/23000_Nosecone.SLDASM
RORO-II/23025_Nosecone Coupler.SLDPRT
RORO-II/23100_Nosecone.SLDPRT
RORO-II/23101_NC-Crown.SLDPRT
RORO-II/240000_avionics.SLDASM
RORO-II/240001_mounting_plate.SLDPRT
RORO-II/240002_tube.SLDPRT
RORO-II/240003_ins_board.SLDPRT
RORO-II/240004_pixracer.SLDPRT
RORO-II/240005_xbee_parallax_adapter.SLDPRT
RORO-II/240006_battery.SLDPRT
RORO-II/240007_mounting_plate_for_screwing.SLDPRT
RORO-II/240008_mounting_battery.SLDPRT
RORO-II/240009_bulkhead.SLDPRT
RORO-II/24007_switch.SLDPRT
RORO_1/0000_RORO1.STL
RORO_1/0000_RORO1_simple.STL
RORO_1/1001_LOWER BODY TUBE.SLDPRT
RORO_1/1002_lower_launch_lug_attachment.SLDPRT
RORO_1/1003_upper_launch_lug_attachment.SLDPRT
RORO_1/1004_launch_lug.SLDPRT
RORO_1/1005_downward_camera_holder.SLDPRT
RORO_1/1102_THRUSTPLATE.sldprt
RORO_1/1103_MOTOR RETAINER.SLDPRT
RORO_1/1104 _MOTOR RETAINER LID.sldprt
RORO_1/1106_thrust-plate-custom.SLDPRT
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
