irec-duster/RORO/simulation/ROROsim/rocket_prop_test.txt

Lenght,         2.626
Cone Lenght, 	0.61
Diameter,       0.158
Number of Fins, 3
Fin height, 	11.5e-2
Fin base length,21e-2
Fin top length,	7e-2
Fin Sweep angle,45
Fin thickness, 	1e-2
Mass,           16.7
Ixx,            0.056 
Iyy,            7.422
Izz,            7.422
Xcm,            1.490
Launchpin height, 17e-3
Launchpin Dia,    30e-3
Rail angle,       84
AeroTech_K1275.eng, 0
