irec-duster/RORO/payload/Software/Datalogging/log14MayStaticTest_1.csv

ATT_qw | ATT_qx | ATT_qy | ATT_qz | ATT_Roll | ATT_Pitch | ATT_Yaw | ATT_RollRate | ATT_PitchRate | ATT_YawRate | ATSP_RollSP | ATSP_PitchSP | ATSP_YawSP | ATSP_ThrustSP | ATSP_qw | ATSP_qx | ATSP_qy | ATSP_qz | IMU_AccX | IMU_AccY | IMU_AccZ | IMU_GyroX | IMU_GyroY | IMU_GyroZ | IMU_MagX | IMU_MagY | IMU_MagZ | IMU_tA | IMU_tG | IMU_tM | IMU1_AccX | IMU1_AccY | IMU1_AccZ | IMU1_GyroX | IMU1_GyroY | IMU1_GyroZ | IMU1_MagX | IMU1_MagY | IMU1_MagZ | IMU1_tA | IMU1_tG | IMU1_tM | IMU2_AccX | IMU2_AccY | IMU2_AccZ | IMU2_GyroX | IMU2_GyroY | IMU2_GyroZ | IMU2_MagX | IMU2_MagY | IMU2_MagZ | IMU2_tA | IMU2_tG | IMU2_tM | SENS_BaroPres | SENS_BaroAlt | SENS_BaroTemp | AIR1_BaroPa | AIR1_BaroAlt | AIR1_BaroTmp
0.617181063 | 0.299082845 | -0.620436549 | 0.380388647 | -1.108728051 | -1.455657244 | 2.112902641 | 0.002756862 | 0.001043495 | -4.39E-05 |  |  |  |  |  |  |  |  | -9.75057888 | 0.993001819 | -0.219359383 | 0.002015273 | 0.000250027 | -0.002272002 | 0.812029243 | -0.169399232 | 0.013546076 | 0 | 0 | 0 |  |  |  |  |  |  |  |  |  |  |  |  |  |  |  |  |  |  |  |  |  |  |  |  | 0 | 305.0170288 | 38.77000046
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
