irec-duster/RORO/payload/Software/Datalogging/log15MayStaticTest_1.csv

ATT_qw | ATT_qx | ATT_qy | ATT_qz | ATT_Roll | ATT_Pitch | ATT_Yaw | ATT_RollRate | ATT_PitchRate | ATT_YawRate | ATSP_RollSP | ATSP_PitchSP | ATSP_YawSP | ATSP_ThrustSP | ATSP_qw | ATSP_qx | ATSP_qy | ATSP_qz | IMU_AccX | IMU_AccY | IMU_AccZ | IMU_GyroX | IMU_GyroY | IMU_GyroZ | IMU_MagX | IMU_MagY | IMU_MagZ | IMU_tA | IMU_tG | IMU_tM | IMU1_AccX | IMU1_AccY | IMU1_AccZ | IMU1_GyroX | IMU1_GyroY | IMU1_GyroZ | IMU1_MagX | IMU1_MagY | IMU1_MagZ | IMU1_tA | IMU1_tG | IMU1_tM | IMU2_AccX | IMU2_AccY | IMU2_AccZ | IMU2_GyroX | IMU2_GyroY | IMU2_GyroZ | IMU2_MagX | IMU2_MagY | IMU2_MagZ | IMU2_tA | IMU2_tG | IMU2_tM | SENS_BaroPres | SENS_BaroAlt | SENS_BaroTemp | AIR1_BaroPa | AIR1_BaroAlt | AIR1_BaroTmp
 |  |  |  |  |  |  |  |  |  |  |  |  |  |  |  |  |  | 9.3563337326 | 1.16142332554 | -2.98214459419 | -0.0435339286923 | 0.153394564986 | 0.0136913629249 | -0.288672506809 | -0.301578491926 | -0.0831451937556 | 0.0 | 0.0 | 0.0 |  |  |  |  |  |  |  |  |  |  |  |  |  |  |  |  |  |  |  |  |  |  |  |  | 0.0 | 258.744171143 | 40.3899993896
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
