irec-duster/RORO/flight-data/20170520_roro1_testflight/axes_rocket.jpg

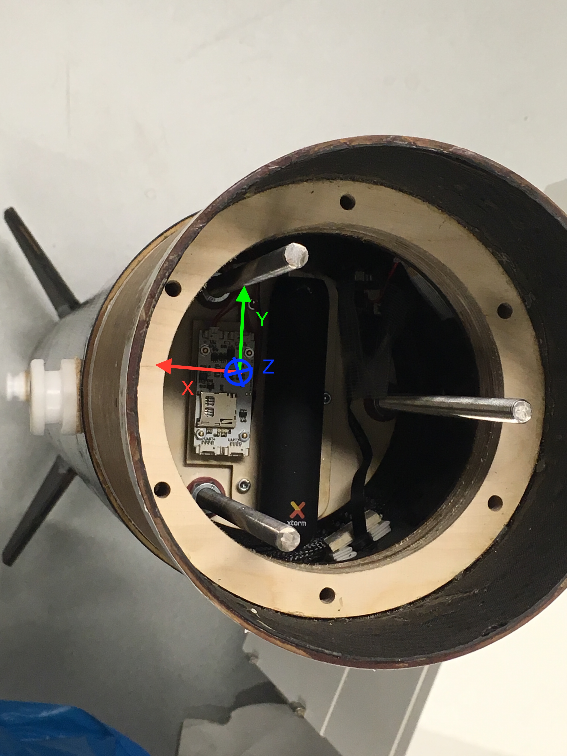
flight-data/20170520_roro1_testflight/axes_rocket.jpg
