irec-duster/RORO/payload/XFLR Simulations/MH-60/Graphs_performance.png

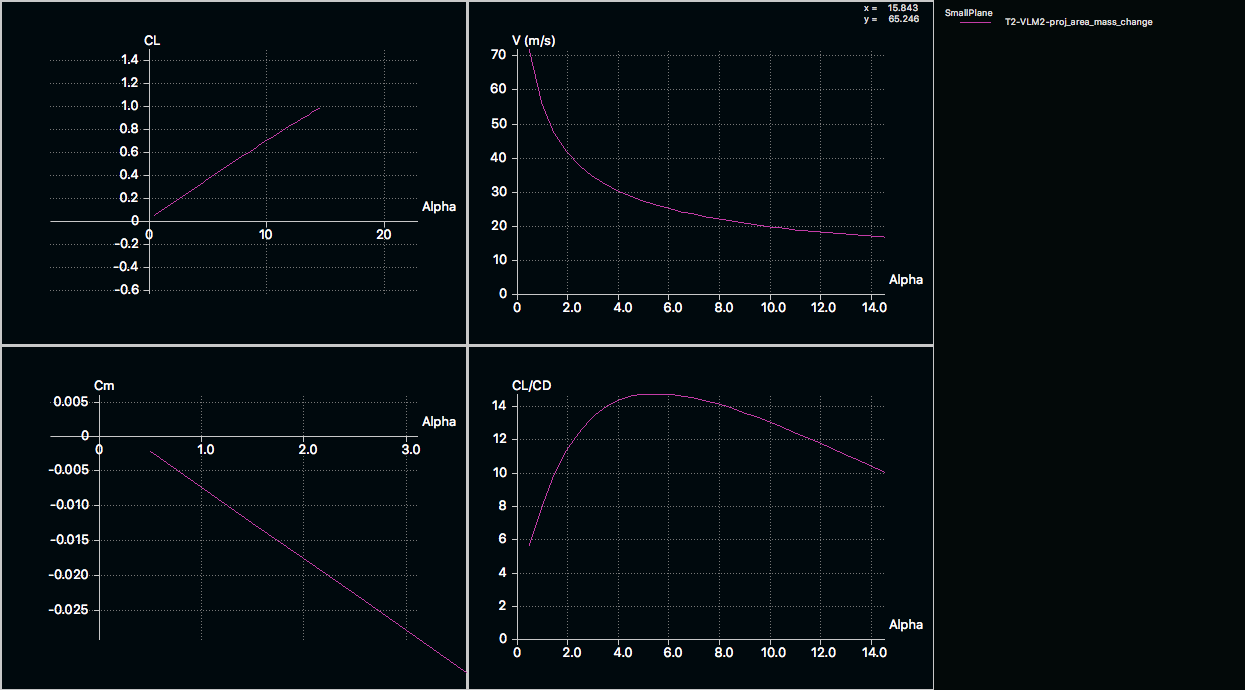
payload/XFLR Simulations/MH-60/Graphs_performance.png
