irec-duster/RORO/payload/XFLR Simulations/Results_comparision_MH_60_E_186.png

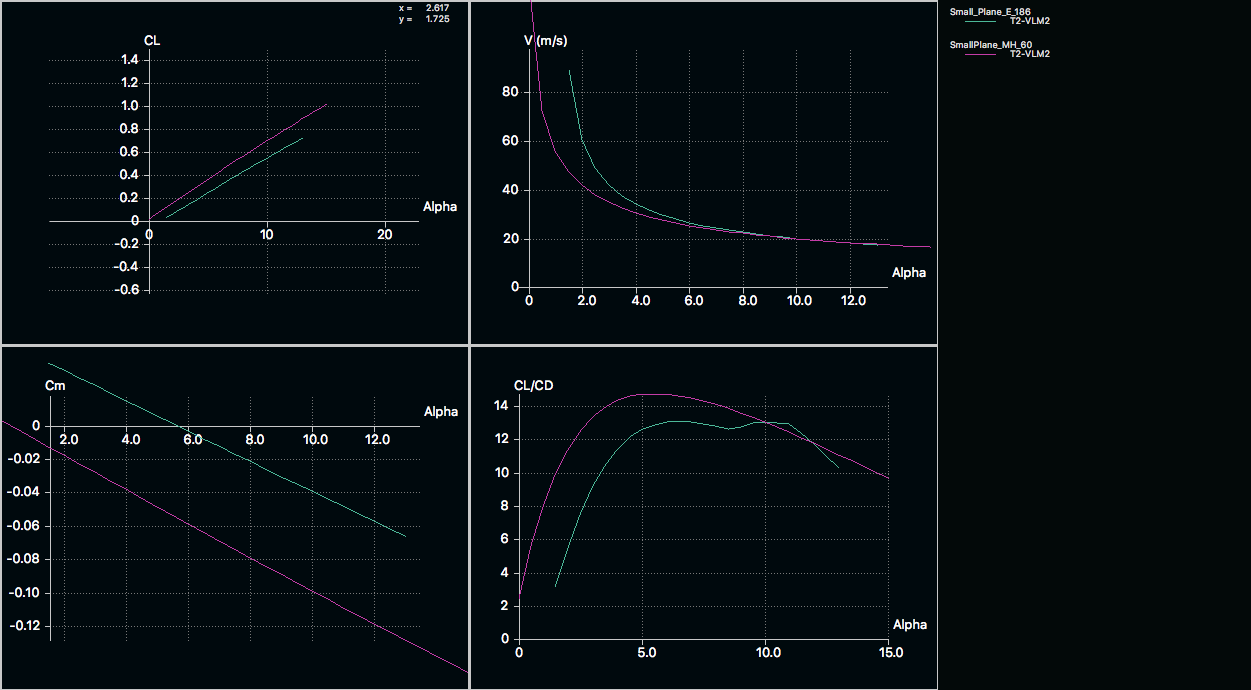
payload/XFLR Simulations/Results_comparision_MH_60_E_186.png
