irec-duster/RORO/Avionics_RORO/TI simulation/webench_design_17V-6V to 5V at 15A.pdf

## WEBENCH ® Design Report

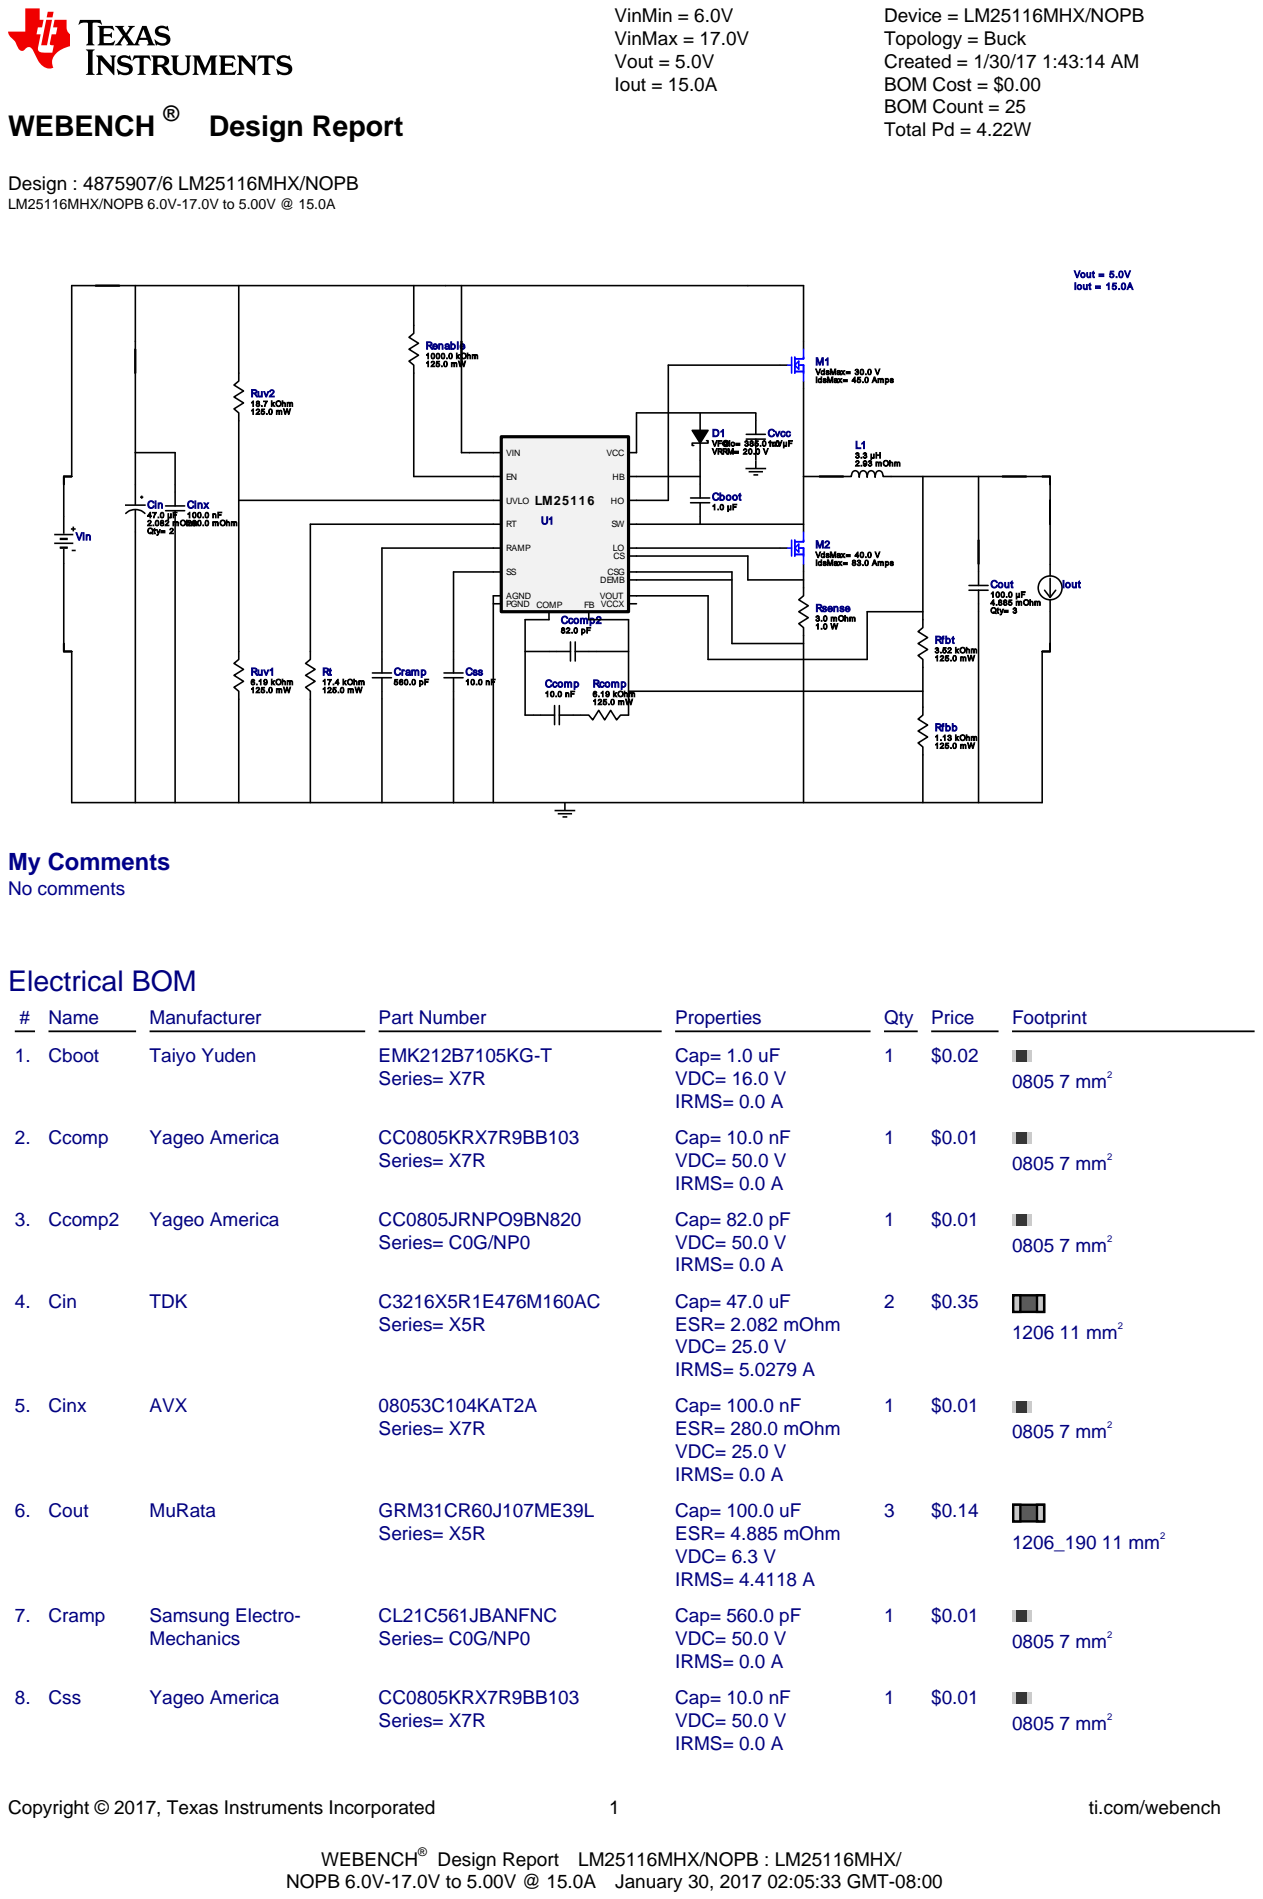
[picture p196: page 1]
Copyright © 2017, Texas Instruments Incorporated; ti.com/webench; Design : 4875907/6 LM25116MHX/NOPB LM25116MHX/NOPB 6.0V-17.0V to 5.00V @ 15.0A; VinMin = 6.0V VinMax = 17.0V Vout = 5.0V Iout = 15.0A; Device = LM25116MHX/NOPB Topology = Buck Created = 1/30/17 1:43:14 AM BOM Cost = $0.00 BOM Count = 25 Total Pd = 4.22W; Cboot 1.0 µF; Ccomp 10.0 nF; Ccomp2 82.0 pF; Cin 47.0 µF 2.082 mOhm Qty= 2; Cinx 100.0 nF 280.0 mOhm; Cout 100.0 µF; 4.885 mOhm Qty= 3; Cramp; Css; Cvcc; VRRM= 20.0 V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

WEBENCH®
NOPB 6.0V-17.0V to 5.00V @ 15.0A January 30, 2017 02:05:33 GMT-08:00

Design Report LM25116MHX/NOPB : LM25116MHX/

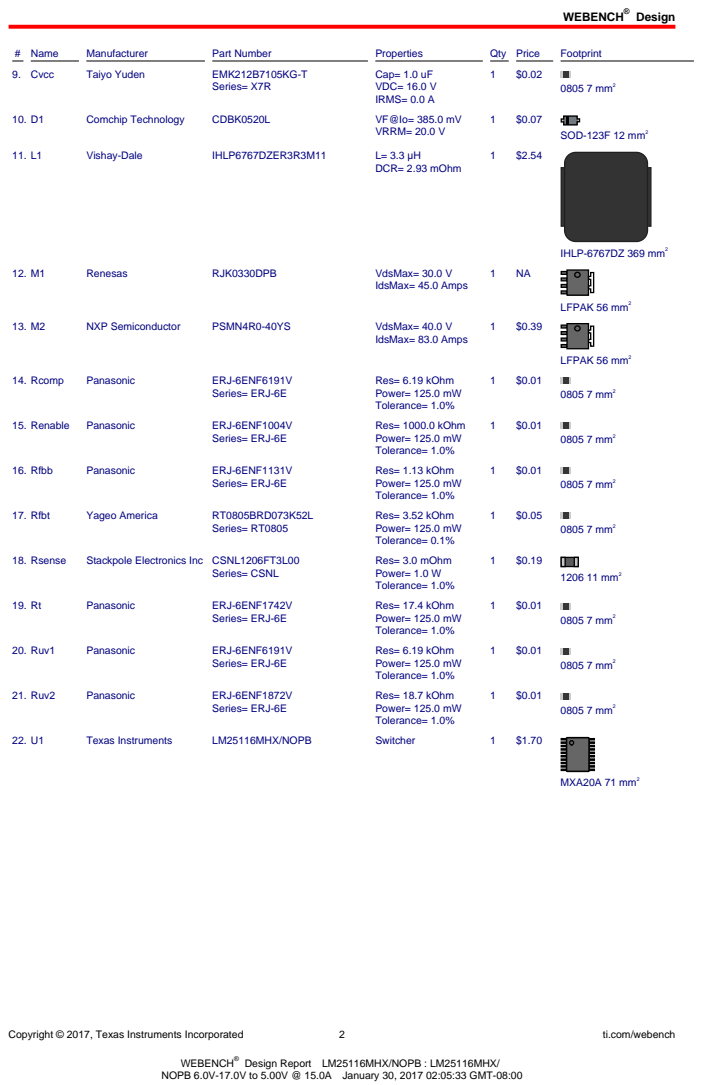
[picture p197: page 2]
Design; Copyright © 2017, Texas Instruments Incorporated; ti.com/webench; # Name; Manufacturer; Part Number; Properties; Qty Price; Footprint; 9. Cvcc; Taiyo Yuden; EMK212B7105KG-T; Series= X7R; Cap= 1.0 uF VDC= 16.0 V IRMS= 0.0 A; 0805 7 mm²; Comchip Technology; CDBK0520L; VRRM= 20.0 V; SOD-123F 12 mm²; Vishay-Dale; IHLP6767DZER3R3M11; DCR= 2.93 mOhm; IHLP-6767DZ 369 mm²; Renesas; RJK0330DPB; VdsMax= 30.0 V; IdsMax= 45.0 Amps; LFPAK 56 mm²; NXP Semiconductor; PSMN4R0-40YS; VdsMax= 40.0 V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

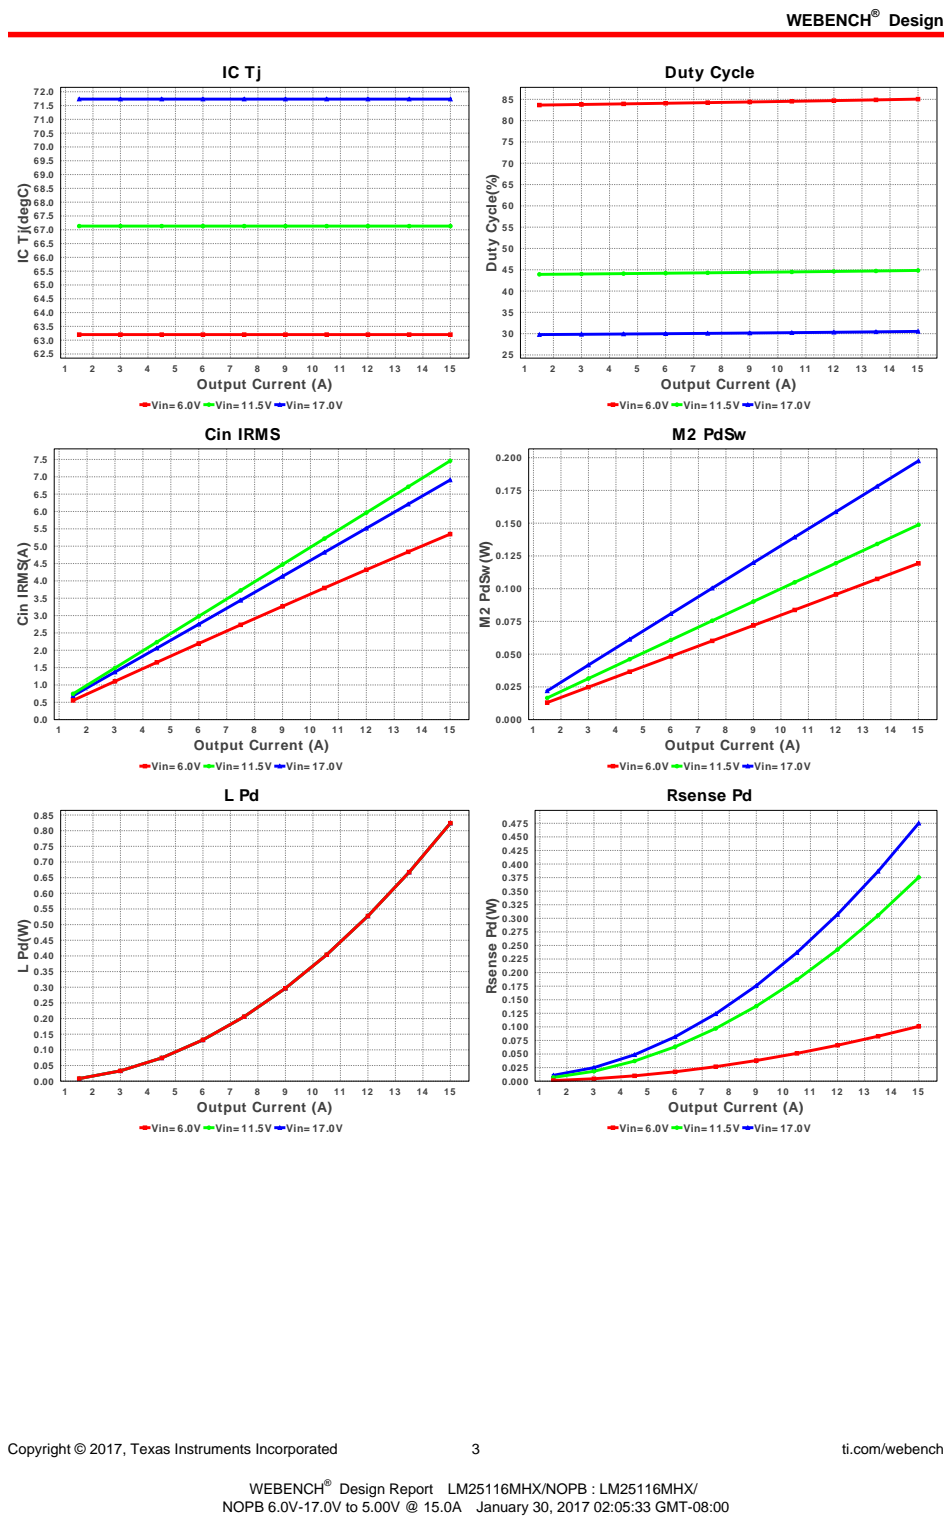
[picture p198: page 3]
Copyright © 2017, Texas Instruments Incorporated; ti.com/webench; 15 Output Current (A); Duty Cycle; Duty Cycle(%); Cin IRMS(A); M2 PdSw(W); Rsense Pd(W)

IC Tj(degC)

Vin= 6.0V Vin= 11.5V Vin= 17.0V
Cin IRMS

M2 PdSw

Rsense Pd

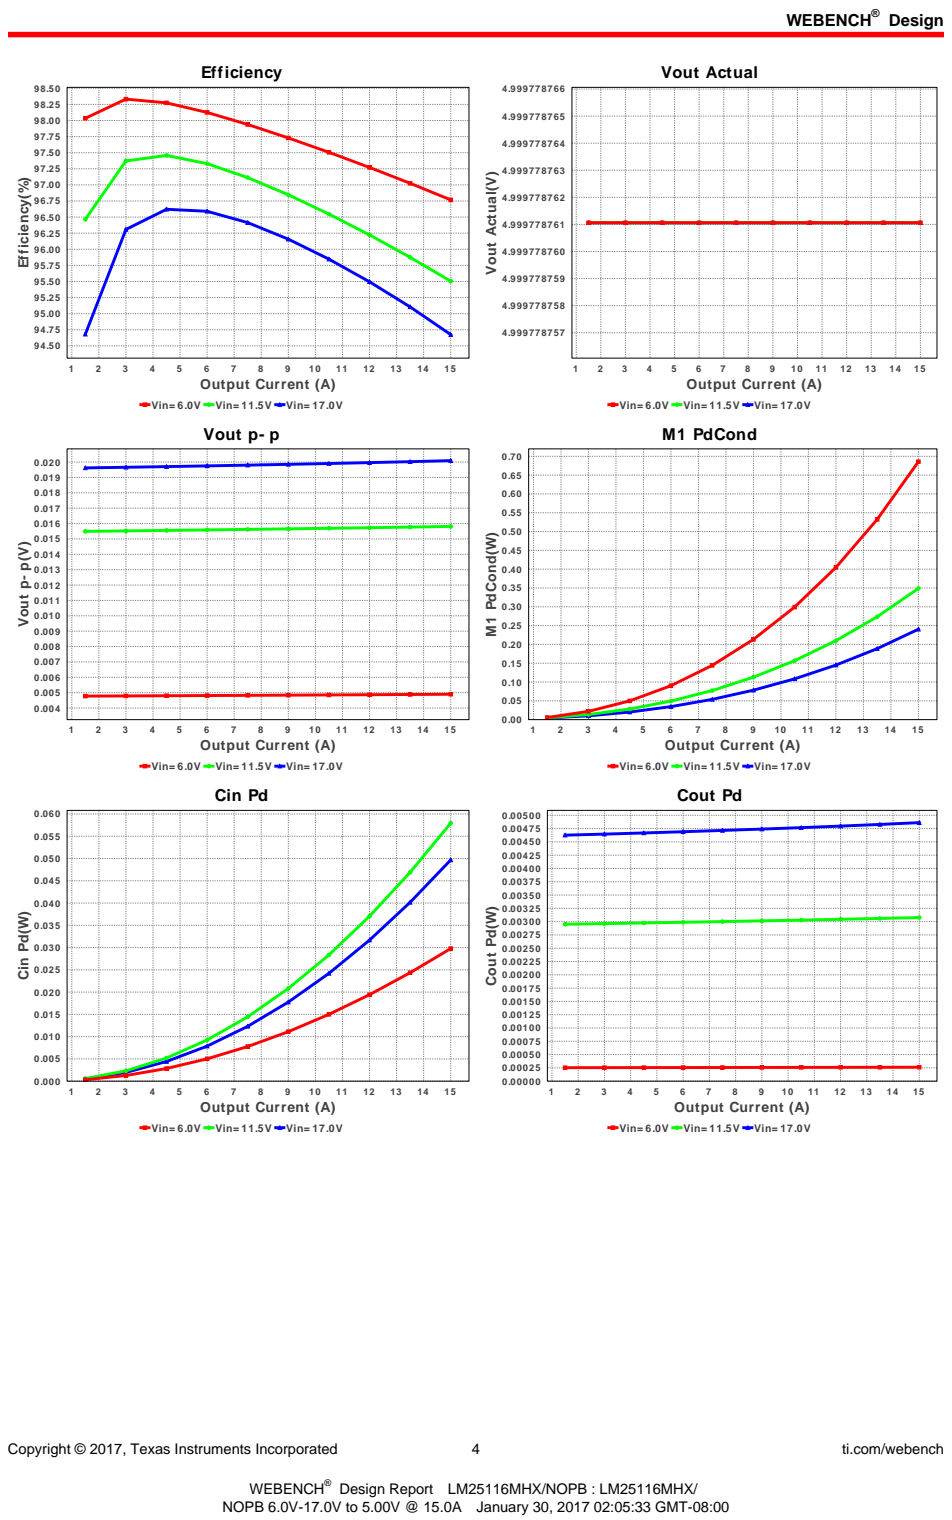
[picture p199: page 4]
Copyright © 2017, Texas Instruments Incorporated; ti.com/webench; Efficiency; 15 Output Current (A); Efficiency(%); Vout Actual; 10 11 12 13 14 15 Output Current (A); Vout Actual(V); Vout p- p(V); M1 PdCond(W); Cin Pd; Cin Pd(W); Cout Pd(W)

Vin= 6.0V Vin= 11.5V Vin= 17.0V
Vout p- p

M1 PdCond

Cout Pd

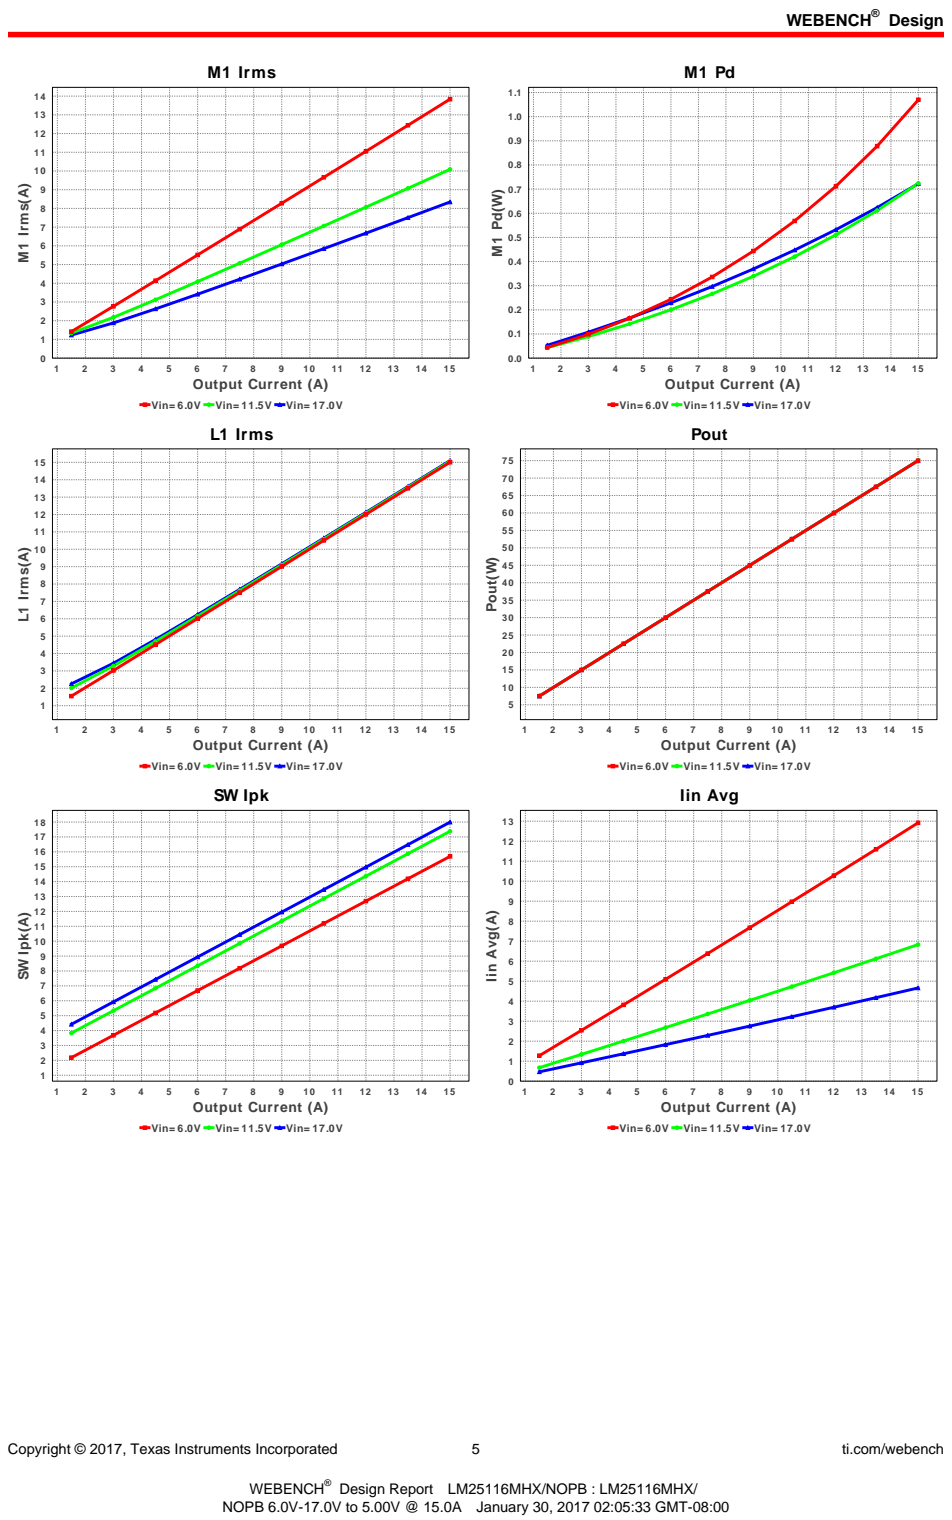
[picture p200: page 5]
Copyright © 2017, Texas Instruments Incorporated; ti.com/webench; M1 Irms; 15 Output Current (A); M1 Irms(A); L1 Irms; L1 Irms(A); Pout; Pout(W); SW Ipk; SW Ipk(A); Iin Avg; Iin Avg(A)

Vin= 6.0V Vin= 11.5V Vin= 17.0V

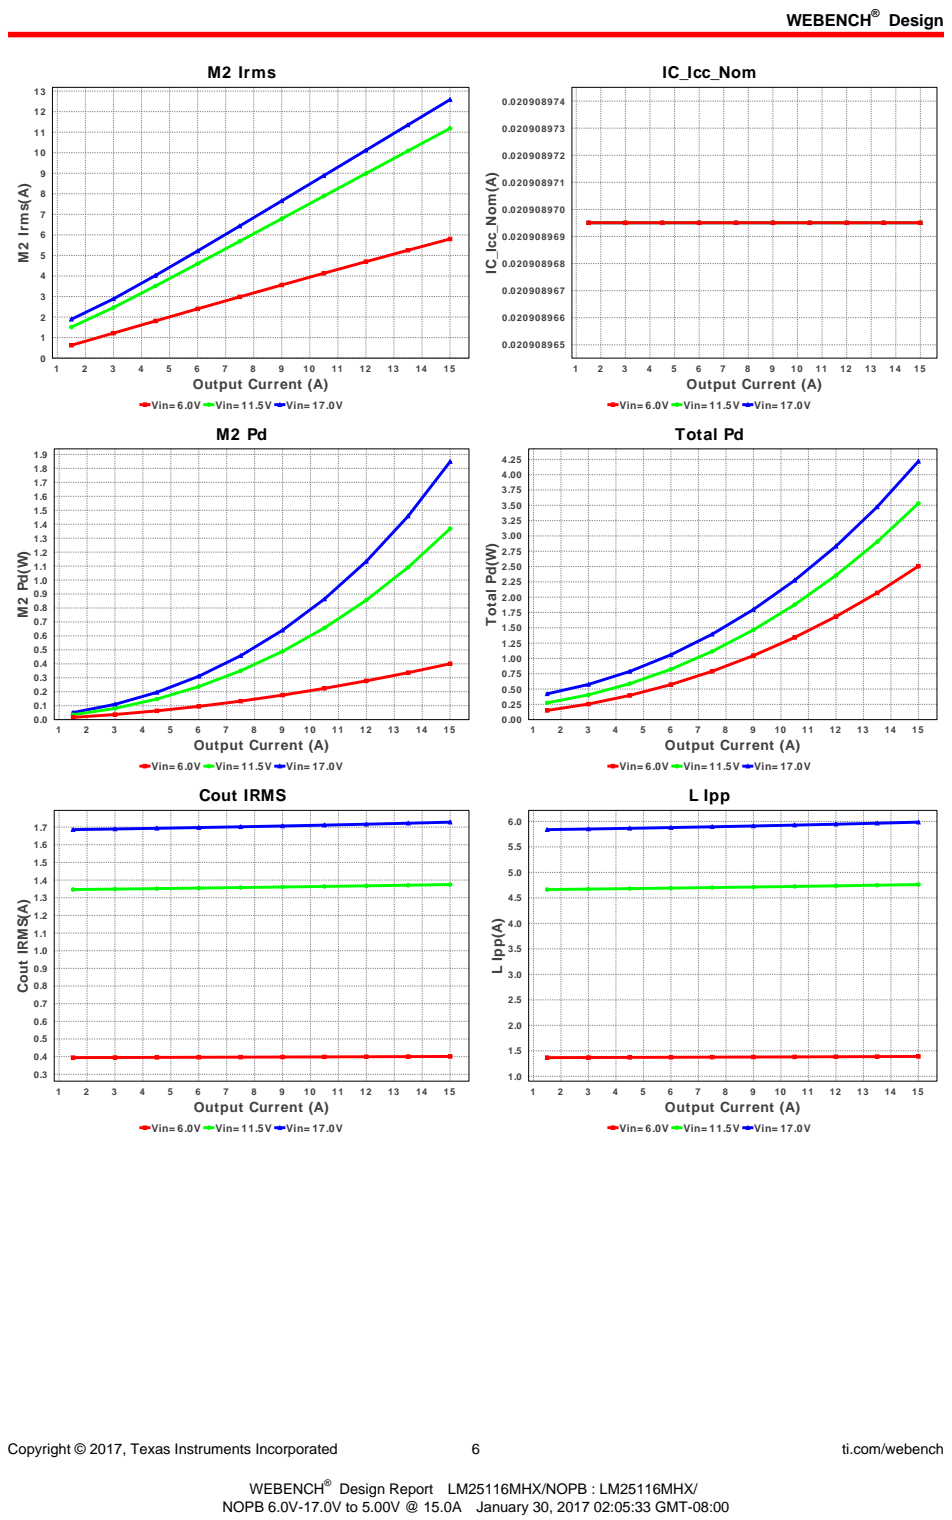
[picture p201: page 6]
Copyright © 2017, Texas Instruments Incorporated; ti.com/webench; M2 Irms; 15 Output Current (A); M2 Irms(A); IC_Icc_Nom; 10 11 12 13 14 15 Output Current (A); IC_Icc_Nom(A); Total Pd(W); Cout IRMS(A); L Ipp; L Ipp(A)

Vin= 6.0V Vin= 11.5V Vin= 17.0V

Total Pd

Cout IRMS

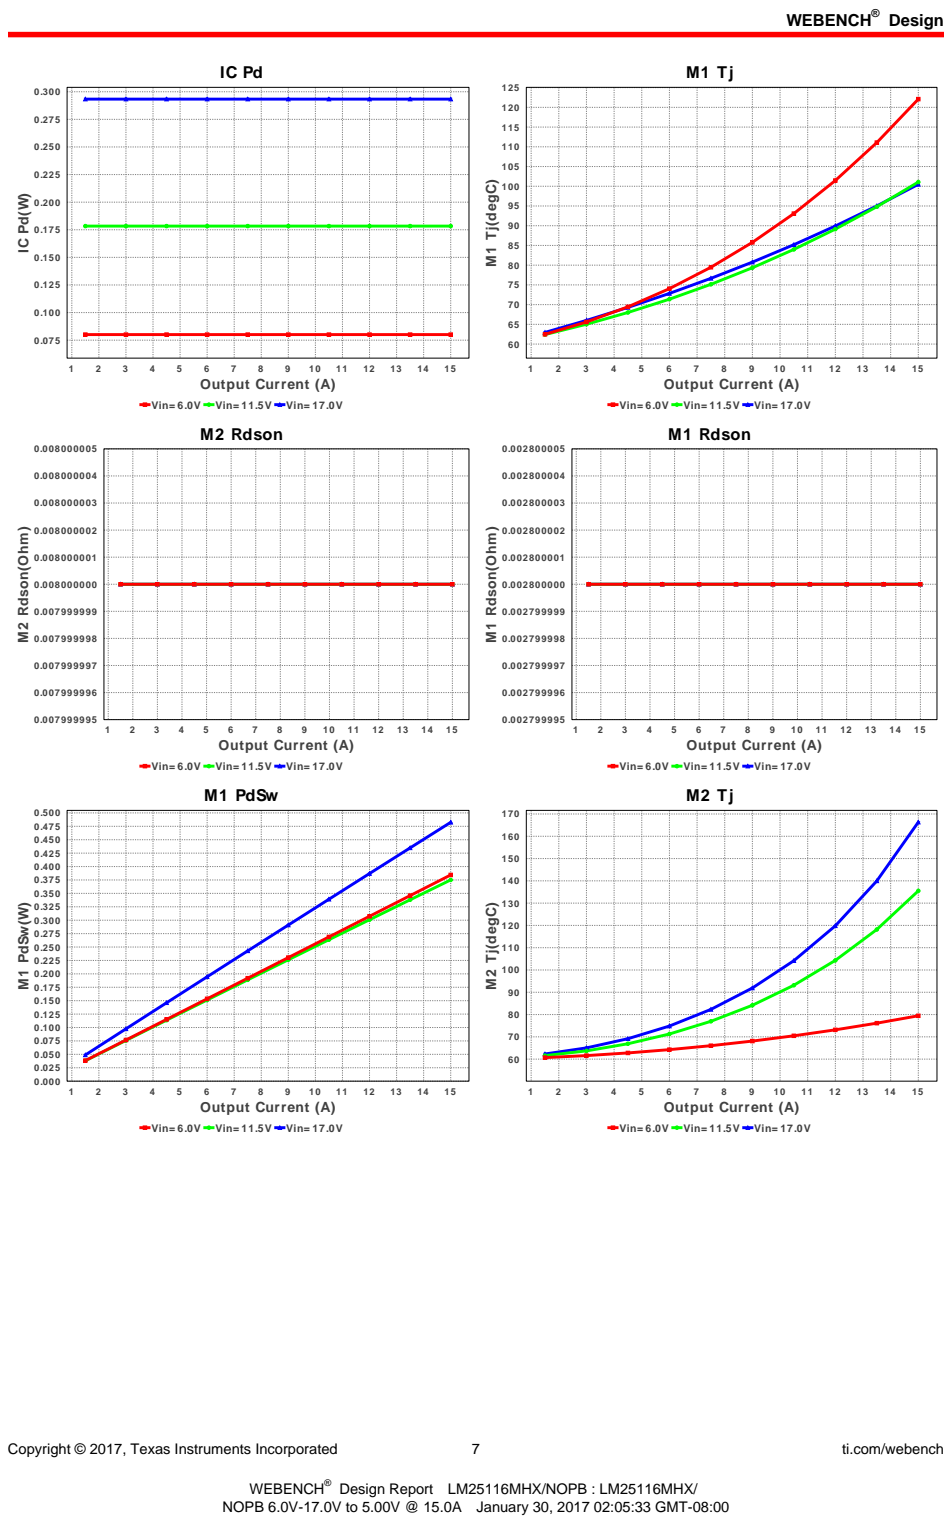
[picture p202: page 7]
Copyright © 2017, Texas Instruments Incorporated; ti.com/webench; 15 Output Current (A); M1 Tj(degC); 10 11 12 13 14 15 Output Current (A); M2 Rdson(Ohm); M1 Rdson(Ohm); M1 PdSw(W); M2 Tj(degC)

Vin= 6.0V Vin= 11.5V Vin= 17.0V
M2 Rdson

M1 Rdson

M1 PdSw

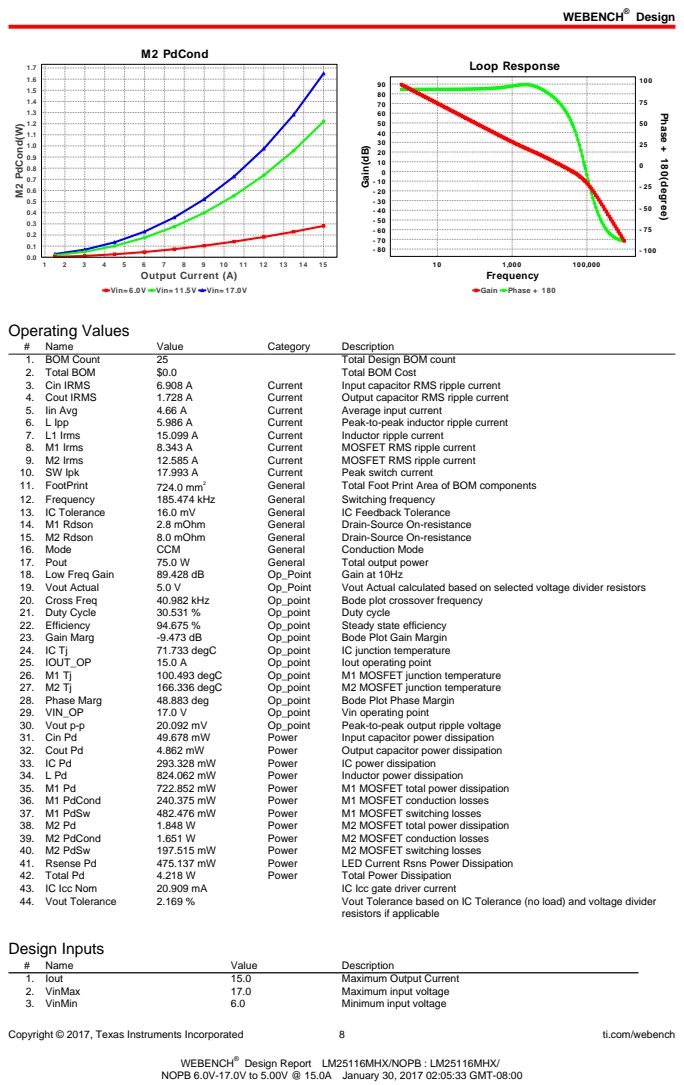
[picture p203: page 8]
Copyright © 2017, Texas Instruments Incorporated; ti.com/webench; M2 PdCond; 15 Output Current (A); M2 PdCond(W); Loop Response; Gain Phase + 180; 100,000 Frequency; Gain(dB); Phase + 180(degree); Operating Values; Name; Value; Category; Description; 1. BOM Count; Total Design BOM count; 2. Total BOM; Total BOM Cost; 3. Cin IRMS; Current; Input capacitor RMS ripple current; 4. Cout IRMS; Output capacitor RMS ripple current; 5. Iin Avg; Average input current; 6. L Ipp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

Vin= 6.0V Vin= 11.5V Vin= 17.0V

resistors if applicable

Copyright © 2017, Texas Instruments Incorporated | 9 | ti.com/webench
# | Name | Value | Description

4. Vout | 5.0 | Output Voltage
5. base_pn | LM25116 | Base Product Number
6. source | DC | Input Source Type
7. Ta | 60.0 | Ambient temperature

## Design Assistance

1. LM25116 Product Folder : http://www.ti.com/product/LM25116 : contains the data sheet and other resources.

Texas Instruments' WEBENCH simulation tools attempt to recreate the performance of a substantially equivalent physical implementation
of the design. Simulations are created using Texas Instruments' published specifications as well as the published specifications of other device manufacturers. While Texas Instruments does update this information periodically, this information may not be current at the time the simulation is built. Texas Instruments does not warrant the accuracy or completeness of the specifications or any information contained therein. Texas Instruments does not warrant that any designs or recommended parts will meet the specifications you entered, will be suitable for your application or fit for any particular purpose, or will operate as shown in the simulation in a physical implementation. Texas Instruments does not warrant that the designs are production worthy.
You should completely validate and test your design implementation to confirm the system functionality for your application prior to production.
Use of Texas Instruments' WEBENCH simulation tools is subject to Texas Instruments' Site Terms and Conditions of Use. (http://www.ti.com/corp/docs/legal/termsofuse.shtml) Prototype boards based on WEBENCH created designs are provided AS IS without warranty of any kind for evaluation and testing purposes and are subject to the terms of the Evaluation License Agreement. (http://www.ti.com/corp/docs/legal/termsofuse_estore.shtml)
