irec-duster/RORO/Avionics_RORO/TI simulation/webench_design_4875907_3_664624753.pdf

## WEBENCH ® Design Report

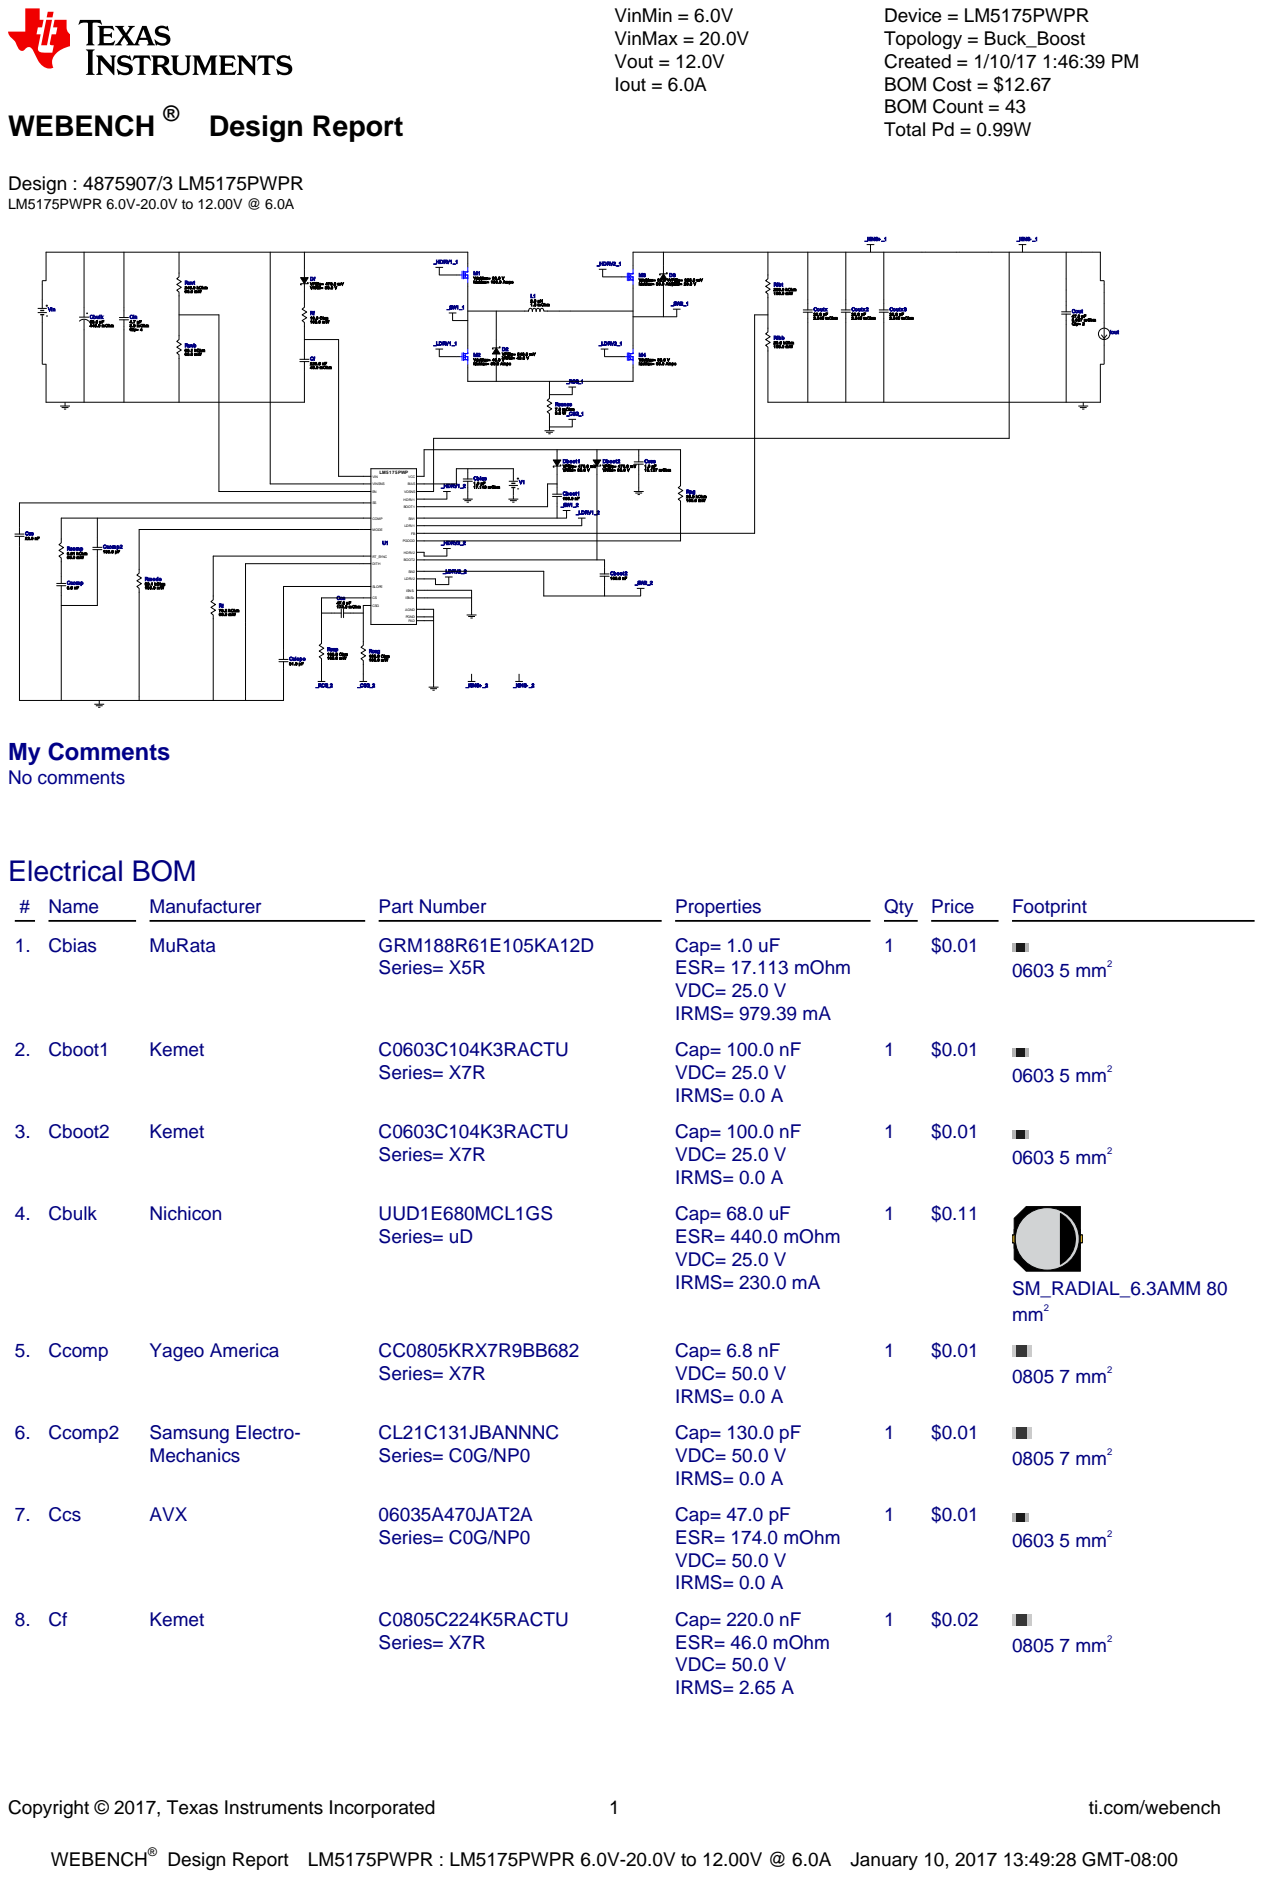
[picture p204: page 1]
Copyright © 2017, Texas Instruments Incorporated; ti.com/webench; WEBENCH®; Design : 4875907/3 LM5175PWPR LM5175PWPR 6.0V-20.0V to 12.00V @ 6.0A; VinMin = 6.0V VinMax = 20.0V Vout = 12.0V Iout = 6.0A; Device = LM5175PWPR Topology = Buck_Boost Created = 1/10/17 1:46:39 PM BOM Cost = $12.67 BOM Count = 43 Total Pd = 0.99W; Cbias 1.0 µF; 17.113 mOhm; Cboot1; Cboot2 100.0 nF; Cbulk 68.0 µF 440.0 mOhm; Ccomp 6.8 nF; Ccomp2 130.0 pF; Ccs 47.0 pF 174.0 mOhm; 46.0 mOhm; Cin 4.7 µF 3.0 mOhm Qty= 4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

Dboot1

VRRM= 30.0 V

Design Report LM5175PWPR : LM5175PWPR 6.0V-20.0V to 12.00V @ 6.0A January 10, 2017 13:49:28 GMT-08:00

Design

Copyright © 2017, Texas Instruments Incorporated | 2 | ti.com/webench
# Name | Manufacturer | Part Number | Properties | Qty Price | Footprint

9. Cin | MuRata | GRM31CR71H475KA12L (http://search.murata.co.jp/Ceramy/PnsearchViewAction.do) Series= X7R | Cap= 4.7 uF ESR= 3.0 mOhm VDC= 50.0 V IRMS= 4.98 A
4 | $0.07
| | | | | 1206 11 mm²
10. Cout | MuRata | GRM32ER61C476ME15L (http://psearch.en.murata.com/capacitor/result/smd/?status%3Dall%26pid%3DGRM32ER61C476ME15L) Series= X5R | Cap= 47.0 uF ESR= 3.037 mOhm VDC= 16.0 V IRMS= 4.59346 A
2 | $0.24
| | | | | 1210_280 15 mm²
11. Coutx | TDK | C3216JB1E226M (http://www.tdk.co.jp/tefe02/e3892%5Fc.pdf) Series= JB | Cap= 22.0 uF ESR= 2.246 mOhm VDC= 25.0 V IRMS= 0.0 A
1 | $0.55
| | | | | 1206 11 mm²
12. Coutx2 | TDK | C3216JB1E226M (http://www.tdk.co.jp/tefe02/e3892%5Fc.pdf) Series= JB | Cap= 22.0 uF ESR= 2.246 mOhm VDC= 25.0 V IRMS= 0.0 A
1 | $0.55
| | | | | 1206 11 mm²
13. Coutx3 | TDK | C3216JB1E226M (http://www.tdk.co.jp/tefe02/e3892%5Fc.pdf) Series= JB | Cap= 22.0 uF ESR= 2.246 mOhm VDC= 25.0 V IRMS= 0.0 A
1 | $0.55
| | | | | 1206 11 mm²
14. Cslope | Samsung Electro- Mechanics | CL10C910JB8NCNC (http://www.samsungsem.com/servlet/FileDownload?type%3Dspec%26file%3DCL10C910JB8NCNC.pdf) Series= C0G/NP0 | Cap= 91.0 pF VDC= 50.0 V IRMS= 0.0 A
1 | $0.01
| | | | | 0603 5 mm²
15. Css | Kemet | C0603C223K3RACTU (http://www.kemet.com/kemet/web/homepage/kechome.nsf/vapubfiles/F3102%5FY5V.pdf/%24file/F3102%5FY5V.pdf) Series= X7R | Cap= 22.0 nF VDC= 25.0 V IRMS= 0.0 A
1 | $0.01
| | | | | 0603 5 mm²
16. Cvcc | MuRata | GRM188R61C105KA93D (http://psearch.en.murata.com/capacitor/result/smd/?status%3Dall%26pid%3DGRM188R61C105KA93D) Series= X5R | Cap= 1.0 uF ESR= 10.127 mOhm VDC= 16.0 V IRMS= 994.63 mA
1 | $0.01
| | | | | 0603 5 mm²
17. D2 | Torex USA Corporation | XBS104S13R-G | VF@Io= 540.0 mV VRRM= 40.0 V
1 | $0.12
SOD-323 9 mm²
18. D3 | Comchip Technology | CDBK0520L (http://www.comchiptech.com/cms/UserFiles/CDBK0520L%2DRevA795741.pdf) | VF@Io= 385.0 mV VRRM= 20.0 V
1 | $0.07
SOD-123F 12 mm²
19. Dboot1 | Torex USA Corporation | XBS053V15R-G | VF@Io= 470.0 mV VRRM= 30.0 V
1 | $0.12
SOD-523 5 mm²
20. Dboot2 | Torex USA Corporation | XBS053V15R-G | VF@Io= 470.0 mV VRRM= 30.0 V
1 | $0.12
SOD-523 5 mm²
21. Df | Torex USA Corporation | XBS053V15R-G | VF@Io= 470.0 mV VRRM= 30.0 V
1 | $0.12
SOD-523 5 mm²
22. L1 | Wurth Elektronik | 7443556260 (http://www.we%2Donline.com/eisos/pdf/7443556260.pdf) | L= 2.6 µH DCR= 1.6 mOhm
1 | $4.43

WE-HCB-18X8.9 410 mm²
23. M1 | Texas Instruments | CSD17310Q5A (http://www.ti.com/lit/ds/symlink/csd17310q5a.pdf) | VdsMax= 30.0 V IdsMax= 100.0 Amps
1 | $0.31

TRANS_NexFET_Q5A 55
mm²
24. M2 | Texas Instruments | CSD18504Q5A (http://www.ti.com/lit/ds/symlink/csd18504q5a.pdf) | VdsMax= 40.0 V IdsMax= 50.0 Amps
1 | $0.33

TRANS_NexFET_Q5A 55
mm²
25. M3 | Texas Instruments | CSD17577Q3A (http://www.ti.com/lit/ds/symlink/csd17577q3a.pdf) | VdsMax= 30.0 V IdsMax= 35.0 Amps
1 | $0.21

DNH0008A 18 mm²

Copyright © 2017, Texas Instruments Incorporated | 3 | ti.com/webench
# Name | Manufacturer | Part Number | Properties | Qty Price | Footprint

26. M4 | Texas Instruments | CSD17575Q3 (http://www.ti.com/lit/ds/symlink/csd17575q3.pdf) | VdsMax= 30.0 V IdsMax= 60.0 Amps
1 | $0.35
| | | | | DQG0008A 18 mm²
27. Rcomp | Vishay-Dale | CRCW04026K81FKED (http://www.vishay.com/docs/20035/dcrcwe3.pdf) Series= CRCW..e3 | Res= 6.81 kOhm Power= 63.0 mW Tolerance= 1.0%
1 | $0.01
| | | | | 0402 3 mm²
28. Rcsg | Vishay-Dale | CRCW0603100RFKEA (http://www.vishay.com/docs/20035/dcrcwe3.pdf) Series= CRCW..e3 | Res= 100.0 Ohm Power= 100.0 mW Tolerance= 1.0%
1 | $0.01
| | | | | 0603 5 mm²
29. Rcsp | Vishay-Dale | CRCW0603100RFKEA (http://www.vishay.com/docs/20035/dcrcwe3.pdf) Series= CRCW..e3 | Res= 100.0 Ohm Power= 100.0 mW Tolerance= 1.0%
1 | $0.01
| | | | | 0603 5 mm²
30. Rf | Vishay-Dale | CRCW060310R0FKEA (http://www.vishay.com/docs/20035/dcrcwe3.pdf) Series= CRCW..e3 | Res= 10.0 Ohm Power= 100.0 mW Tolerance= 1.0%
1 | $0.01
| | | | | 0603 5 mm²
31. Rfbb | Vishay-Dale | CRCW060320K0FKEA (http://www.vishay.com/docs/20035/dcrcwe3.pdf) Series= CRCW..e3 | Res= 20.0 kOhm Power= 100.0 mW Tolerance= 1.0%
1 | $0.01
| | | | | 0603 5 mm²
32. Rfbt | Vishay-Dale | CRCW0603280KFKEA (http://www.vishay.com/docs/20035/dcrcwe3.pdf) Series= CRCW..e3 | Res= 280.0 kOhm Power= 100.0 mW Tolerance= 1.0%
1 | $0.01
| | | | | 0603 5 mm²
33. Rmode | Vishay-Dale | CRCW060393K1FKEA (http://www.vishay.com/docs/20035/dcrcwe3.pdf) Series= CRCW..e3 | Res= 93.1 kOhm Power= 100.0 mW Tolerance= 1.0%
1 | $0.01
| | | | | 0603 5 mm²
34. Rpg | Vishay-Dale | CRCW060320K0FKEA (http://www.vishay.com/docs/20035/dcrcwe3.pdf) Series= CRCW..e3 | Res= 20.0 kOhm Power= 100.0 mW Tolerance= 1.0%
1 | $0.01
| | | | | 0603 5 mm²
35. Rsense | Vishay-Dale | WSR37L000FEA (http://www.vishay.com/doc?30101) Series= WSR | Res= 7.0 mOhm Power= 3.0 W Tolerance= 1.0%
1 | $0.64

4527 122 mm²
36. Rt | Vishay-Dale | CRCW040273K2FKED (http://www.vishay.com/docs/20035/dcrcwe3.pdf) Series= CRCW..e3 | Res= 73.2 kOhm Power= 63.0 mW Tolerance= 1.0% | 1 | $0.01
0402 3 mm²
37. Ruvb | Vishay-Dale | CRCW040268K1FKED (http://www.vishay.com/docs/20035/dcrcwe3.pdf) Series= CRCW..e3 | Res= 68.1 kOhm Power= 63.0 mW Tolerance= 1.0% | 1 | $0.01
0402 3 mm²
38. Ruvt | Vishay-Dale | CRCW0402249KFKED (http://www.vishay.com/docs/20035/dcrcwe3.pdf) Series= CRCW..e3 | Res= 249.0 kOhm Power= 63.0 mW Tolerance= 1.0% | 1 | $0.01
0402 3 mm²
39. U1 | Texas Instruments | LM5175PWPR (http://www.ti.com/product/LM5175) | Switcher | 1 | $3.10

PWP0028F_N 98 mm²

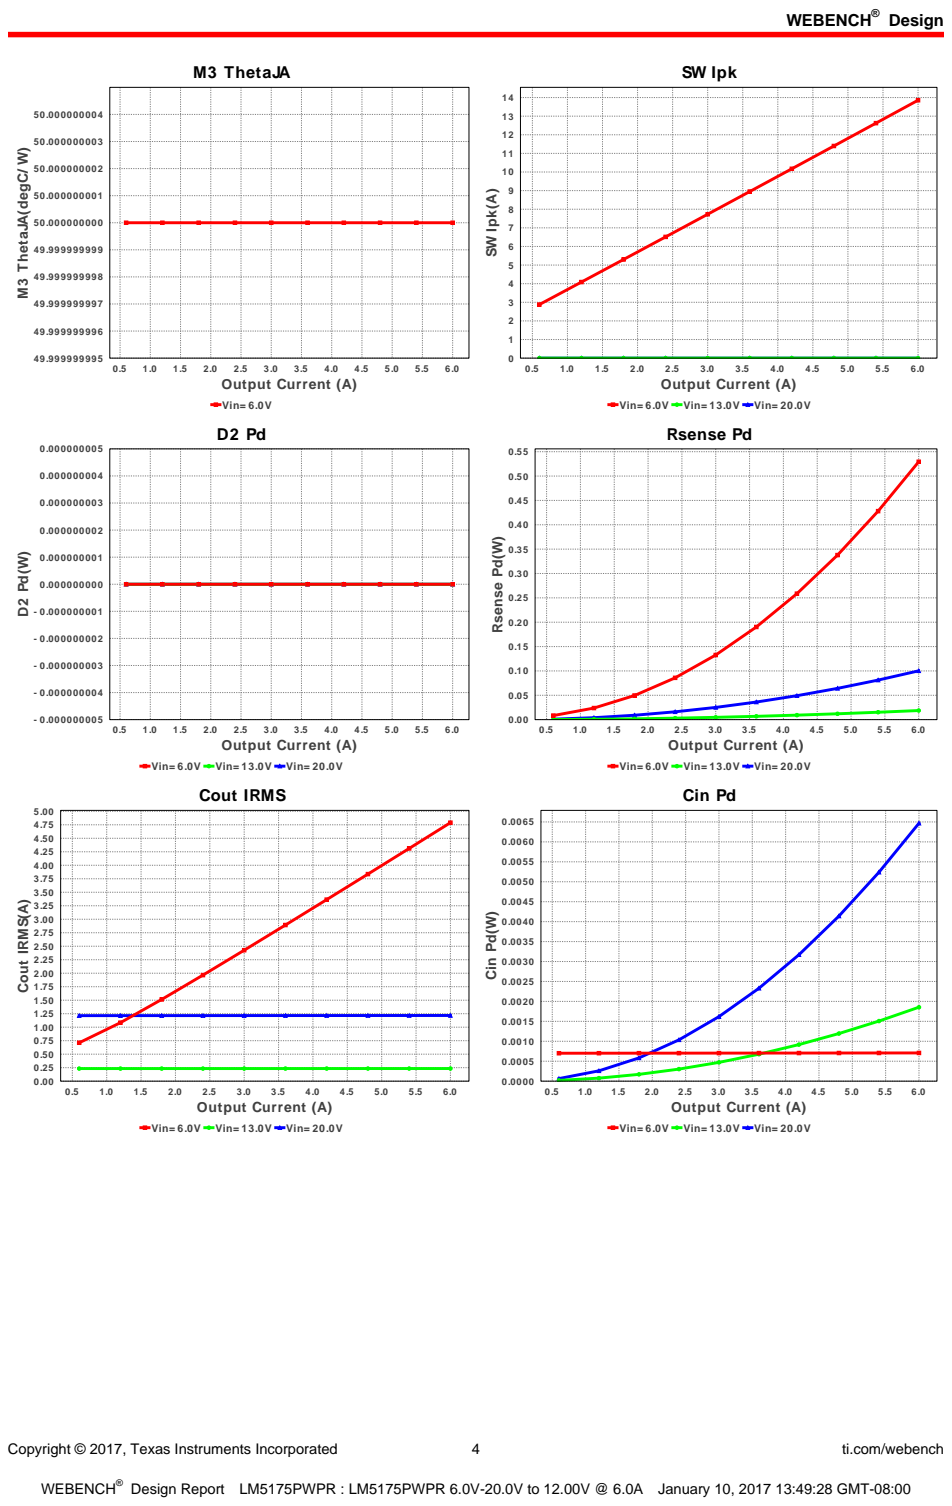
[picture p205: page 4]
Copyright © 2017, Texas Instruments Incorporated; ti.com/webench; M3 ThetaJA; Vin= 6.0V; 6.0 Output Current (A); M3 ThetaJA(degC/ W); SW Ipk; SW Ipk(A); Rsense Pd(W); Cout IRMS(A); Cin Pd; Cin Pd(W)

Vin= 6.0V Vin= 13.0V Vin= 20.0V
Rsense Pd

Cout IRMS

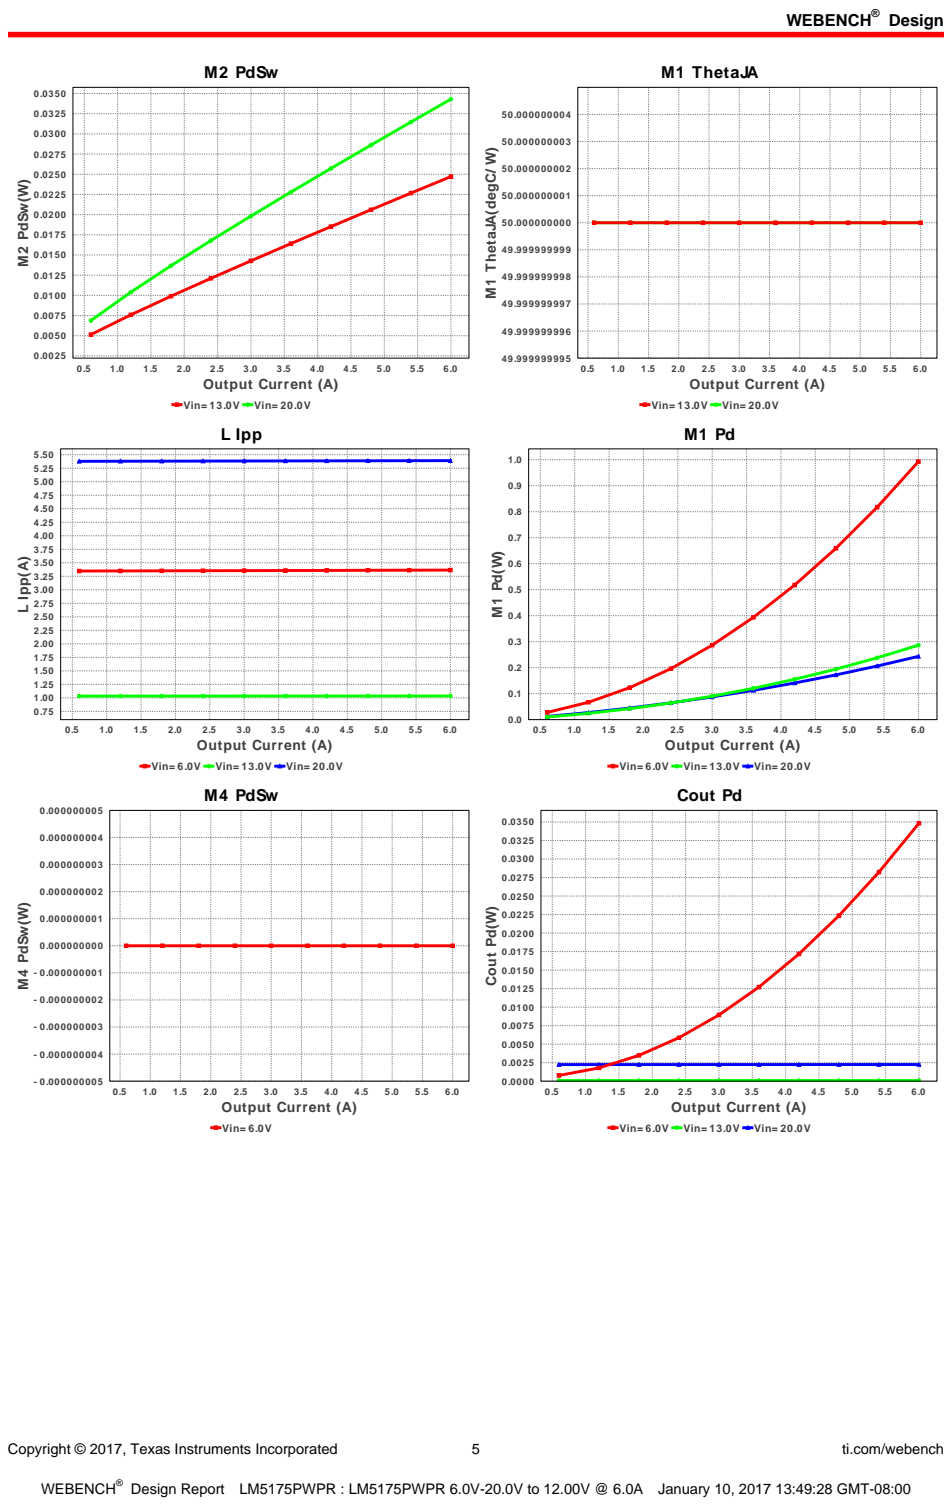
[picture p206: page 5]
Copyright © 2017, Texas Instruments Incorporated; ti.com/webench; M2 PdSw; Vin= 13.0V Vin= 20.0V; 6.0 Output Current (A); M2 PdSw(W); M1 ThetaJA; M1 ThetaJA(degC/ W); L Ipp; L Ipp(A); Vin= 6.0V; M4 PdSw(W); Cout Pd(W)

Vin= 6.0V Vin= 13.0V Vin= 20.0V
M4 PdSw

Cout Pd

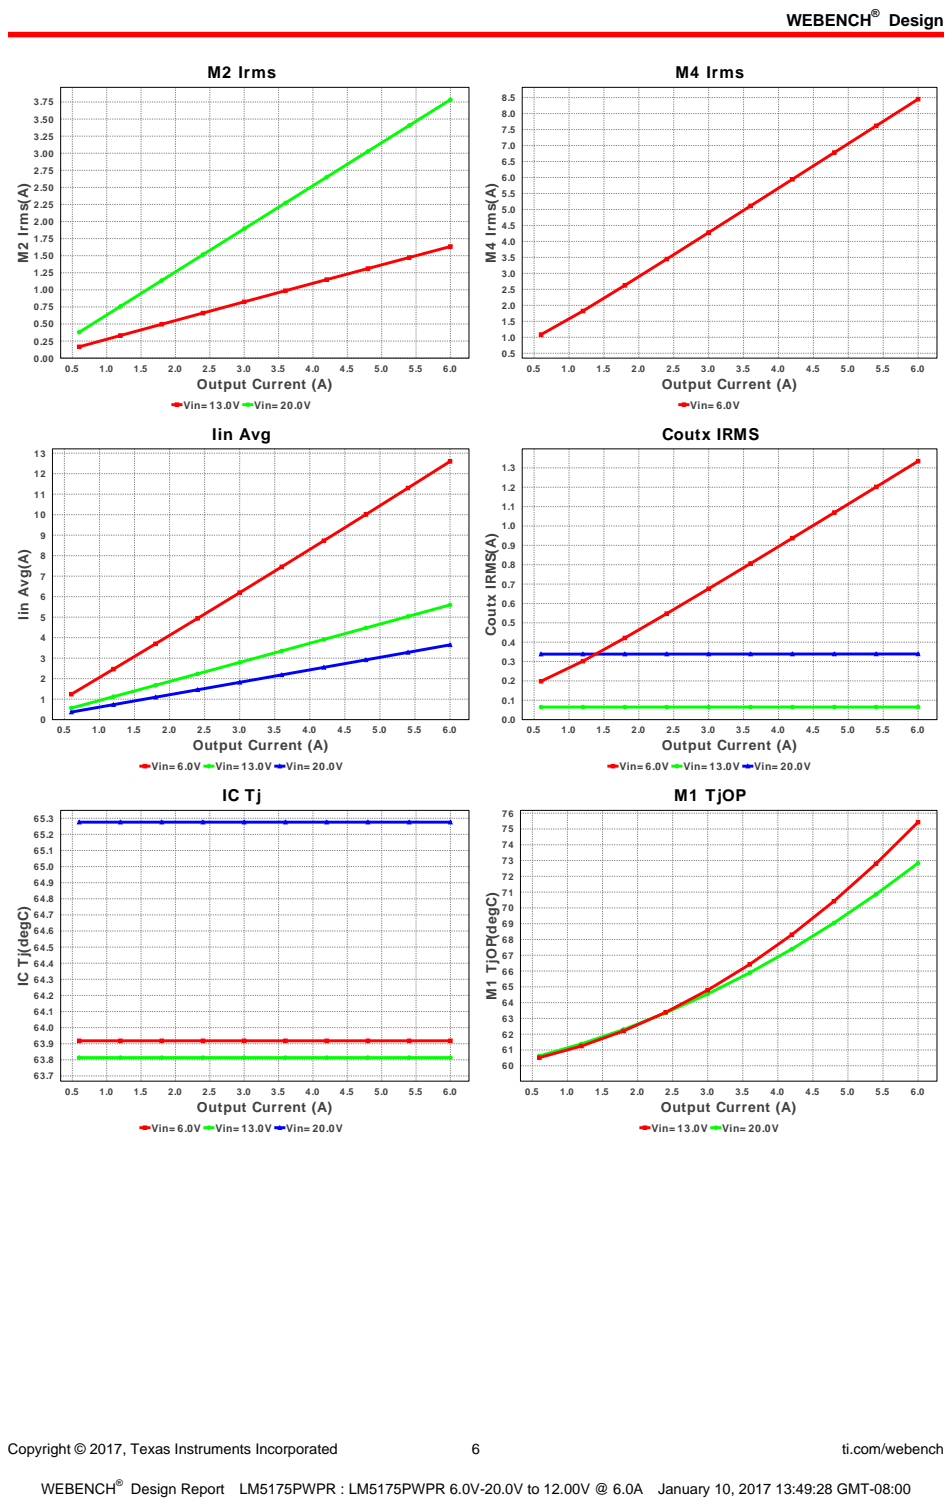
[picture p207: page 6]
Copyright © 2017, Texas Instruments Incorporated; ti.com/webench; M2 Irms; Vin= 13.0V Vin= 20.0V; 6.0 Output Current (A); M2 Irms(A); M4 Irms; Vin= 6.0V; M4 Irms(A); Iin Avg; Iin Avg(A); Coutx IRMS; Coutx IRMS(A); M1 TjOP(degC)

Vin= 6.0V Vin= 13.0V Vin= 20.0V

M1 TjOP

IC Tj(degC)

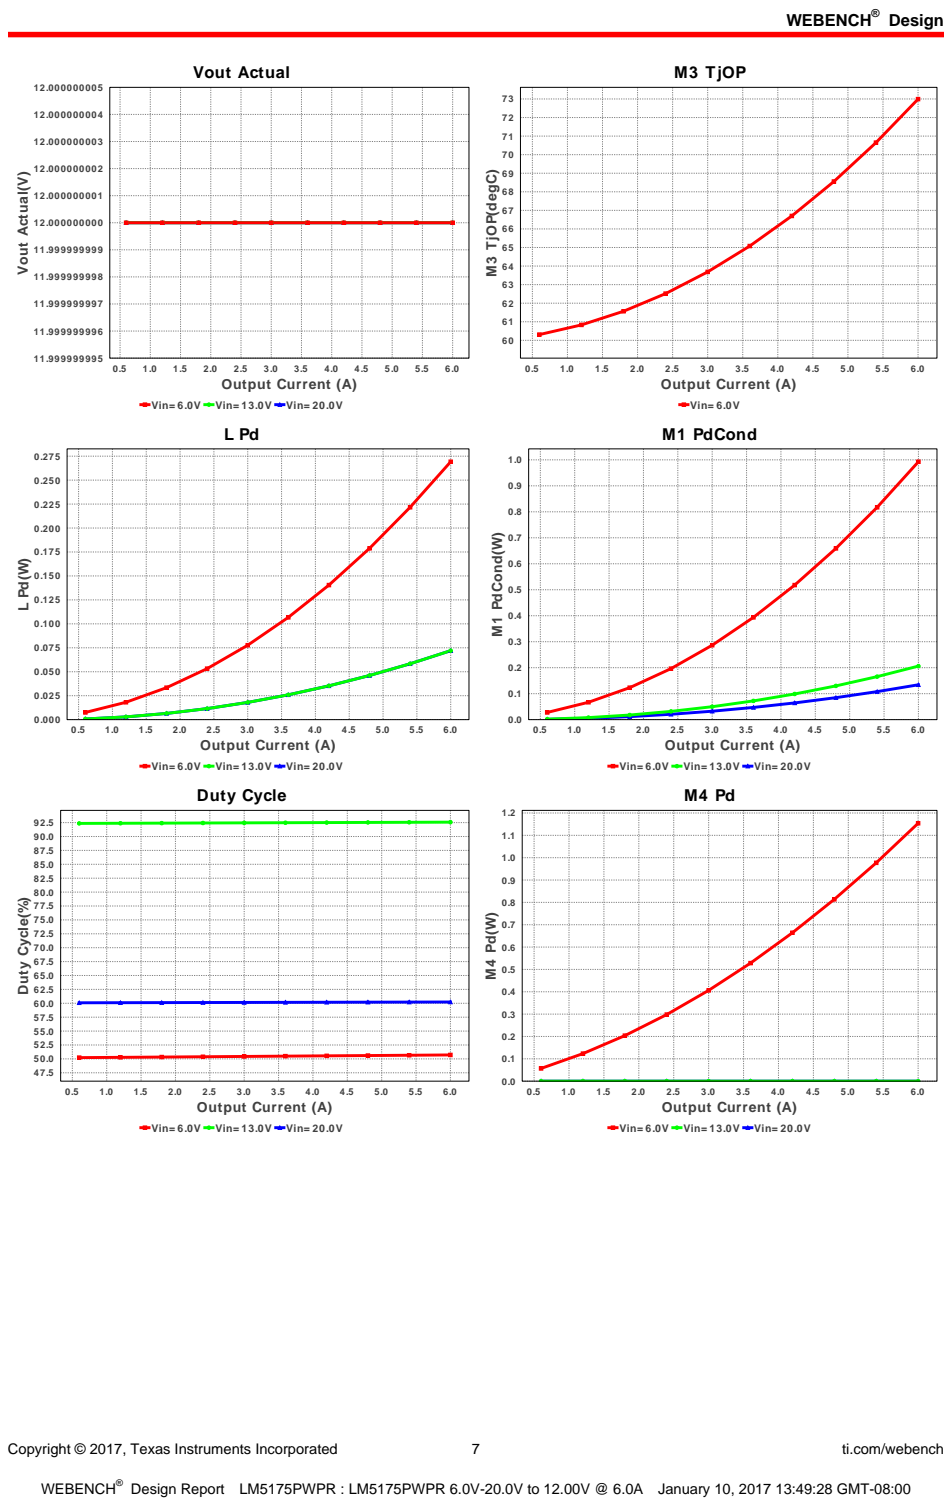
[picture p208: page 7]
Copyright © 2017, Texas Instruments Incorporated; ti.com/webench; Vout Actual; 6.0 Output Current (A); Vout Actual(V); M3 TjOP; Vin= 6.0V; M3 TjOP(degC); M1 PdCond; M1 PdCond(W); Duty Cycle(%)

Vin= 6.0V Vin= 13.0V Vin= 20.0V

Duty Cycle

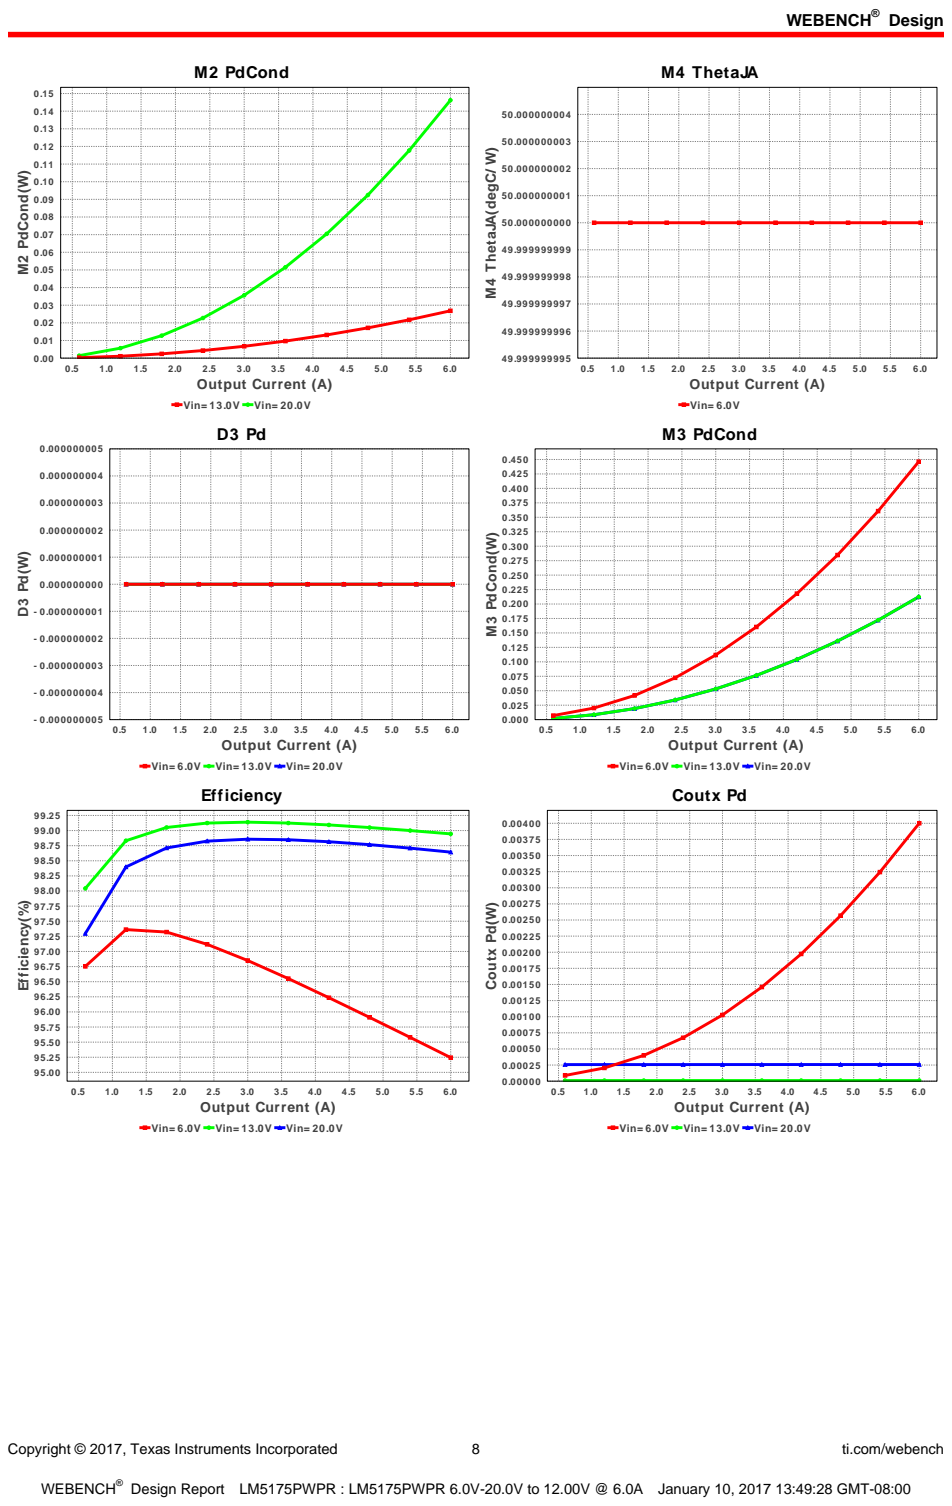
[picture p209: page 8]
Copyright © 2017, Texas Instruments Incorporated; ti.com/webench; M2 PdCond; Vin= 13.0V Vin= 20.0V; 6.0 Output Current (A); M2 PdCond(W); M4 ThetaJA; Vin= 6.0V; M4 ThetaJA(degC/ W); M3 PdCond; M3 PdCond(W); Efficiency(%); Coutx Pd(W)

Vin= 6.0V Vin= 13.0V Vin= 20.0V
Efficiency

Coutx Pd

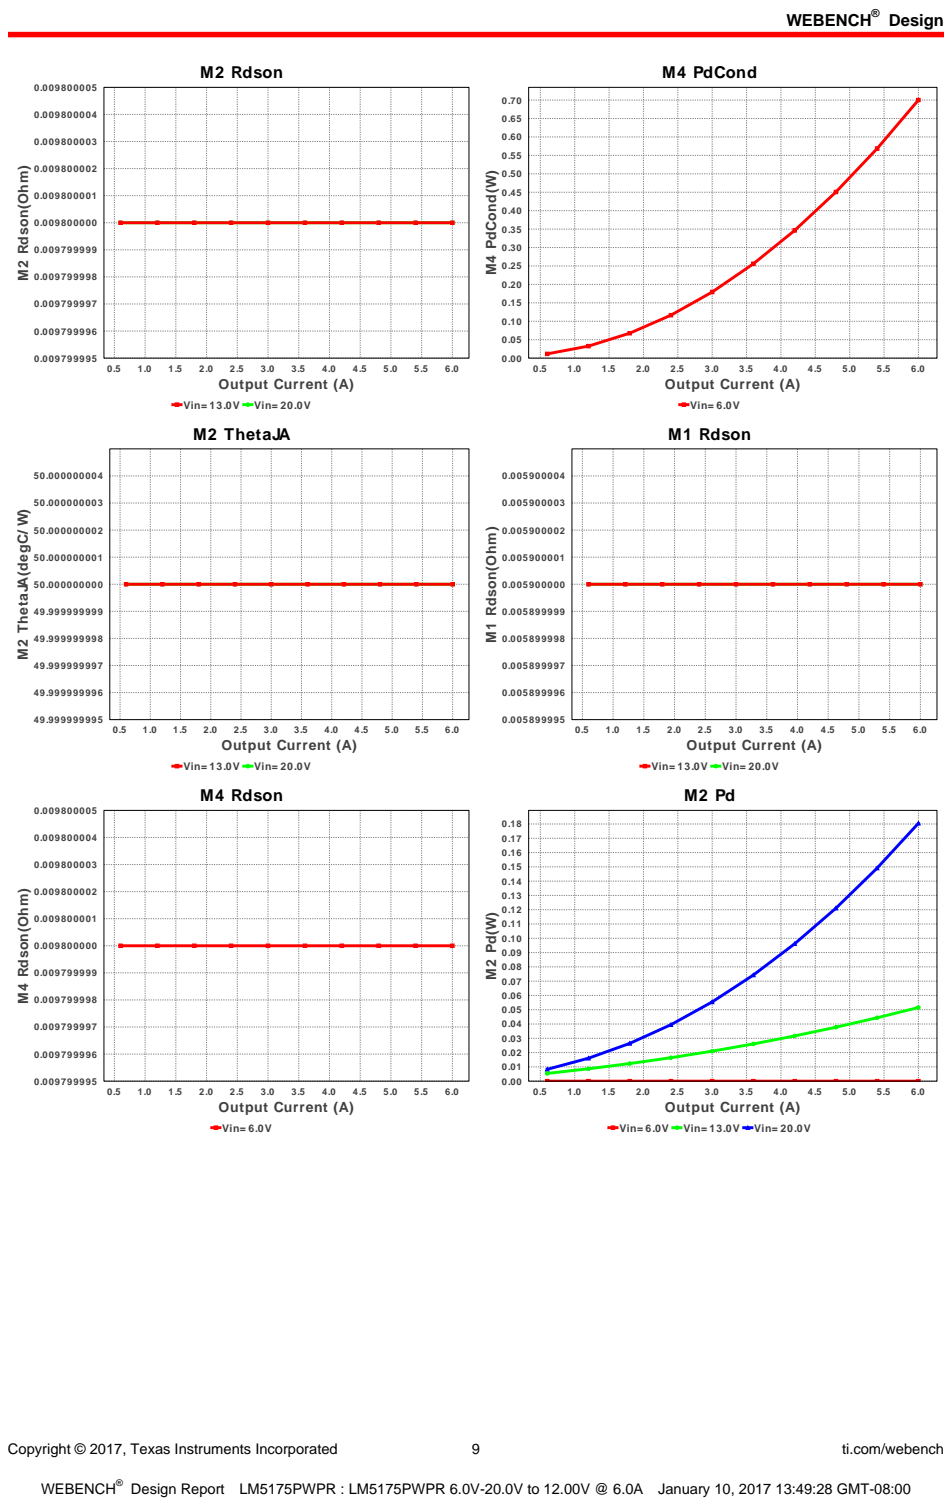
[picture p210: page 9]
Copyright © 2017, Texas Instruments Incorporated; ti.com/webench; M2 Rdson; Vin= 13.0V Vin= 20.0V; 6.0 Output Current (A); M2 Rdson(Ohm); M4 PdCond; Vin= 6.0V; M4 PdCond(W); M2 ThetaJA; M2 ThetaJA(degC/ W); M1 Rdson; M1 Rdson(Ohm); M4 Rdson; M4 Rdson(Ohm)

Vin= 6.0V Vin= 13.0V Vin= 20.0V

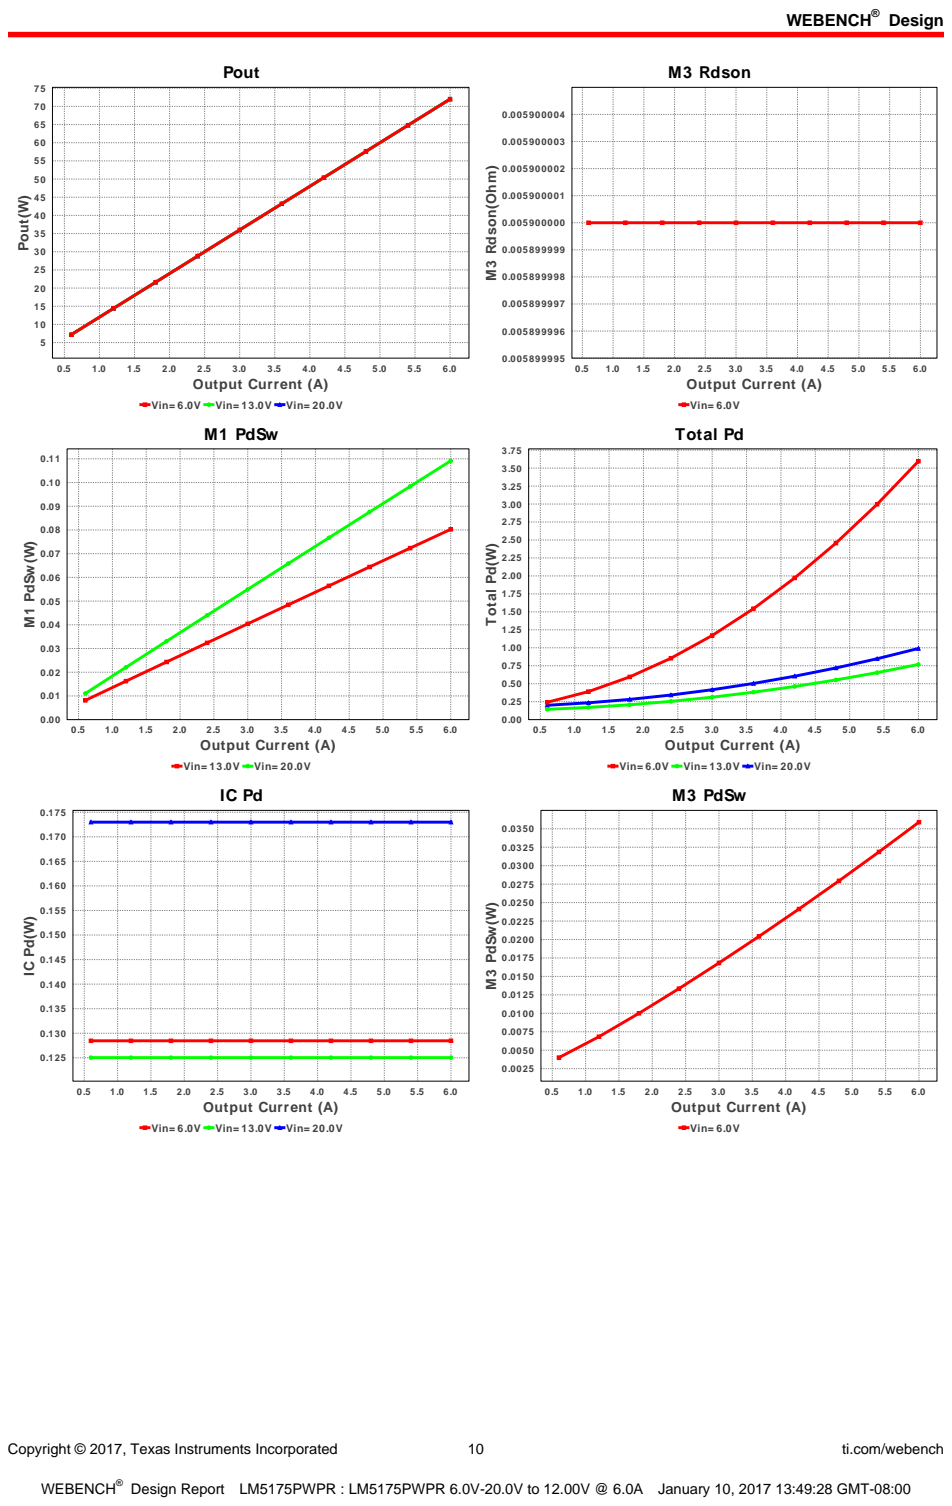
[picture p211: page 10]
Copyright © 2017, Texas Instruments Incorporated; ti.com/webench; Pout; 6.0 Output Current (A); Pout(W); M3 Rdson; Vin= 6.0V; M3 Rdson(Ohm); Vin= 13.0V Vin= 20.0V; M1 PdSw(W); Total Pd; Total Pd(W); M3 PdSw(W)

Vin= 6.0V Vin= 13.0V Vin= 20.0V
M1 PdSw

M3 PdSw

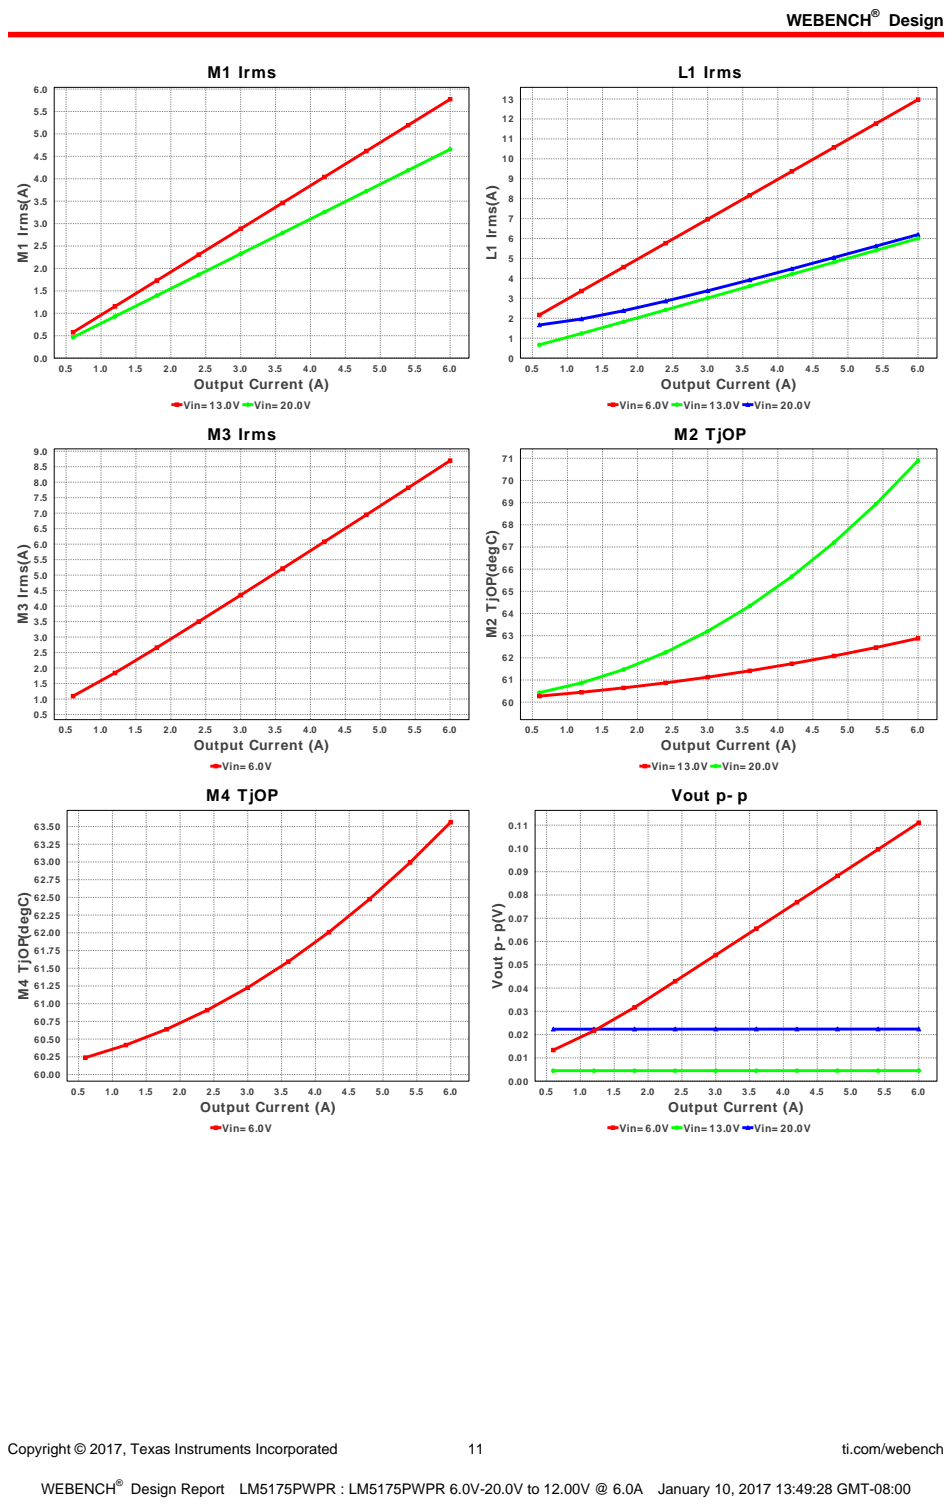
[picture p212: page 11]
Copyright © 2017, Texas Instruments Incorporated; ti.com/webench; M1 Irms; Vin= 13.0V Vin= 20.0V; 6.0 Output Current (A); M1 Irms(A); L1 Irms; L1 Irms(A); M3 Irms; Vin= 6.0V; M3 Irms(A); M2 TjOP(degC); M4 TjOP; M4 TjOP(degC); Vout p- p; Vout p- p(V)

Vin= 6.0V Vin= 13.0V Vin= 20.0V
M2 TjOP

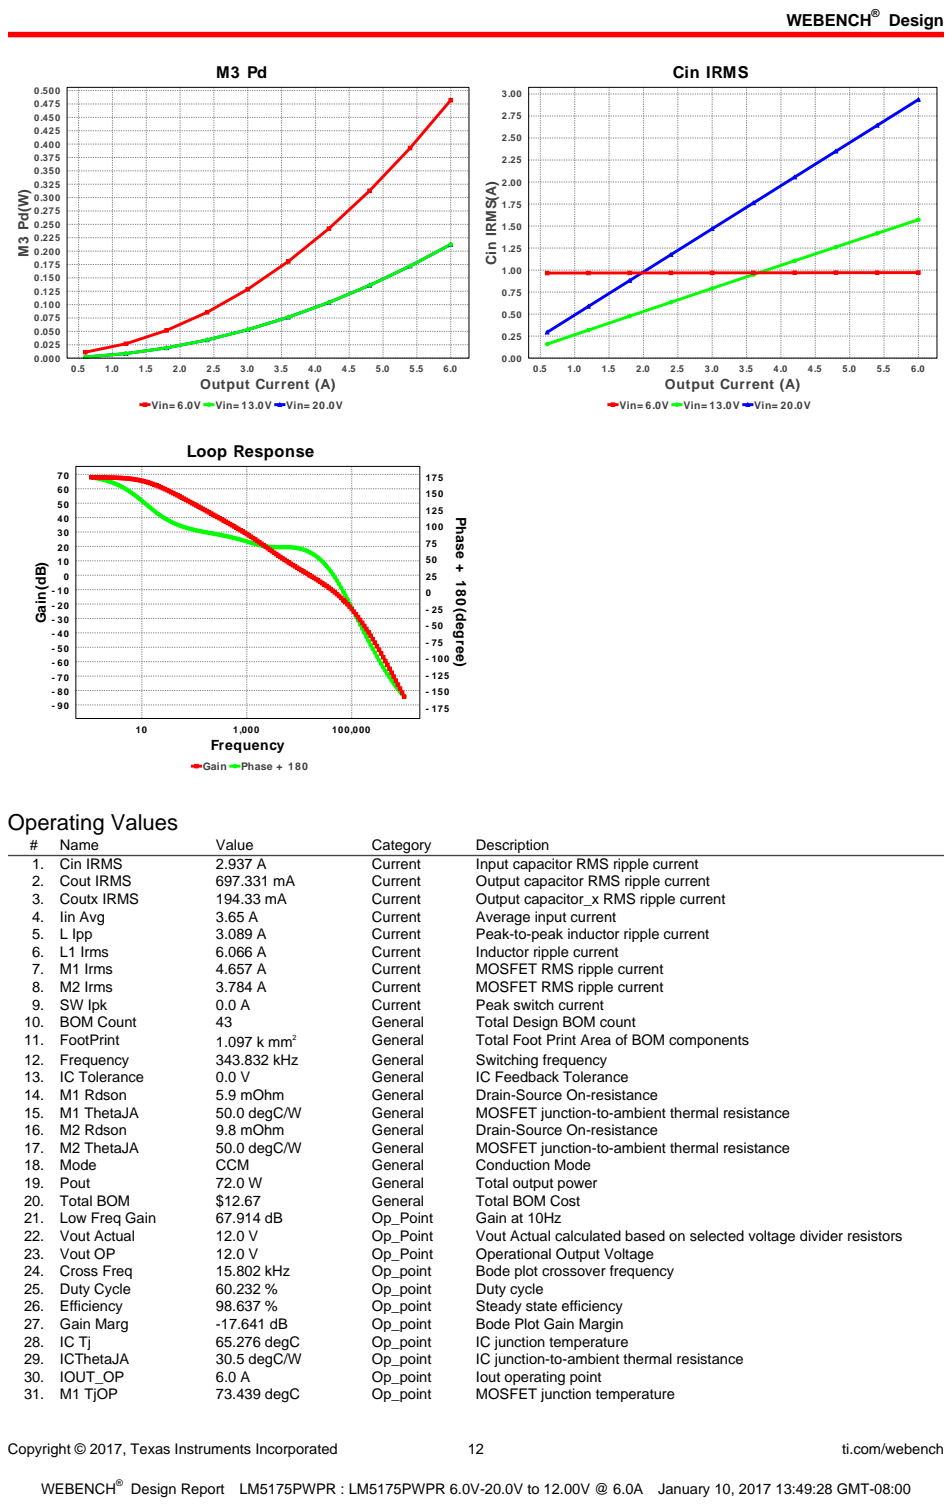
[picture p213: page 12]
Copyright © 2017, Texas Instruments Incorporated; ti.com/webench; 6.0 Output Current (A); Cin IRMS; Cin IRMS(A); Loop Response; Gain Phase + 180; 100,000 Frequency; Gain(dB); Phase + 180(degree); Operating Values; Name; Value; Category; Description; 1. Cin IRMS; Current; Input capacitor RMS ripple current; 2. Cout IRMS; Output capacitor RMS ripple current; 3. Coutx IRMS; Output capacitor_x RMS ripple current; 4. Iin Avg; Average input current; 5. L Ipp; Peak-to-peak inductor ripple current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

Vin= 6.0V Vin= 13.0V Vin= 20.0V

Copyright © 2017, Texas Instruments Incorporated | 13 | ti.com/webench
# | Name | Value | Category | Description

32. M2 TjOP | 70.558 degC | Op_point | MOSFET junction temperature
33. Operating Topology | Buck | Op_point | The current operating topology of the device
34. Phase Marg | 61.42 deg | Op_point | Bode Plot Phase Margin
35. VIN_OP | 20.0 V | Op_point | Vin operating point
36. Vout p-p | 12.827 mV | Op_point | Peak-to-peak output ripple voltage
37. Cin Pd | 6.467 mW | Power | Input capacitor power dissipation
38. Cout Pd | 738.401 µW | Power | Output capacitor power dissipation
39. Coutx Pd | 84.819 µW | Power | Output capacitor_x power loss
40. D2 Pd | 0.0 W | Power | Diode power dissipation
41. D3 Pd | 0.0 W | Power | Diode power dissipation
42. IC Pd | 172.983 mW | Power | IC power dissipation
43. L Pd | 72.0 mW | Power | Inductor power dissipation
44. M1 Pd | 256.509 mW | Power | MOSFET power dissipation
45. M1 PdCond | 135.488 mW | Power | M1 MOSFET conduction losses
46. M1 PdSw | 121.021 mW | Power | M1 MOSFET switching losses
47. M2 Pd | 173.793 mW | Power | MOSFET power dissipation
48. M2 PdCond | 145.891 mW | Power | M2 MOSFET conduction losses
49. M2 PdSw | 27.902 mW | Power | M2 MOSFET switching losses
50. M3 Pd | 212.4 mW | Power | M3 MOSFET total power dissipation
51. M3 PdCond | 212.4 mW | Power | M3 MOSFET conduction losses
52. M4 Pd | 0.0 W | Power | M4 MOSFET total power dissipation
53. Rsense Pd | 100.216 mW | Power | LED Current Rsns Power Dissipation
54. Total Pd | 994.935 mW | Power | Total Power Dissipation
55. Vout Tolerance | 1.886 % | Vout Tolerance based on IC Tolerance (no load) and voltage divider
| | | | resistors if applicable

## Design Inputs

# | Name | Value | Description

1. Iout | 6.0 | Maximum Output Current
2. VinMax | 20.0 | Maximum input voltage
3. VinMin | 6.0 | Minimum input voltage
4. Vout | 12.0 | Output Voltage
5. base_pn | LM5175 | Base Product Number
6. source | DC | Input Source Type
7. Ta | 60.0 | Ambient temperature

## Design Assistance

1. Tip: Snubbers and/or gate resistors may be required to limit the SW1,2 node switching spikes below the IC and FET abs max ratings.
2. Tip: Slope Capacitor: smaller slope capacitors provide better transition region behavior.
3. LM5175 Product Folder : http://www.ti.com/product/LM5175 : contains the data sheet and other resources.

Texas Instruments' WEBENCH simulation tools attempt to recreate the performance of a substantially equivalent physical implementation
of the design. Simulations are created using Texas Instruments' published specifications as well as the published specifications of other device manufacturers. While Texas Instruments does update this information periodically, this information may not be current at the time the simulation is built. Texas Instruments does not warrant the accuracy or completeness of the specifications or any information contained therein. Texas Instruments does not warrant that any designs or recommended parts will meet the specifications you entered, will be suitable for your application or fit for any particular purpose, or will operate as shown in the simulation in a physical implementation. Texas Instruments does not warrant that the designs are production worthy.
You should completely validate and test your design implementation to confirm the system functionality for your application prior to production.
Use of Texas Instruments' WEBENCH simulation tools is subject to Texas Instruments' Site Terms and Conditions of Use. (http://www.ti.com/corp/docs/legal/termsofuse.shtml) Prototype boards based on WEBENCH created designs are provided AS IS without warranty of any kind for evaluation and testing purposes and are subject to the terms of the Evaluation License Agreement. (http://www.ti.com/corp/docs/legal/termsofuse_estore.shtml)
