irec-duster/RORO/Avionics_RORO/TI simulation/webench_design_5.5V-4.5V to 3.3V at 3A_v2.pdf

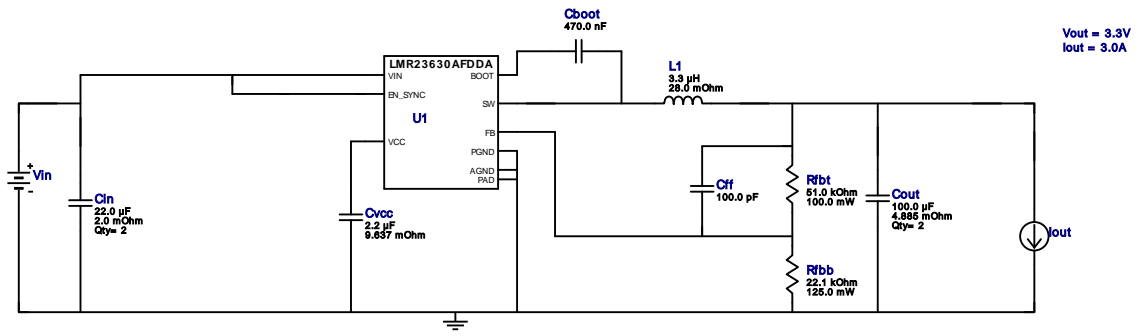
[picture p219: figure]
Cboot 470.0 nF; Cin 22.0 µF 2.0 mOhm Qty= 2; Cout 100.0 µF 4.885 mOhm; Qty= 2 Cvcc 2.2 µF 9.637 mOhm; L1 3.3 µH 28.0 mOhm; Rfbb 22.1 kOhm 125.0 mW; Rfbt 51.0 kOhm 100.0 mW; LMR23630AFDDA; BOOT; VCC; EN_SYNC; AGND; VIN; PGND; PAD; Vout = 3.3V Iout = 3.0A; Cff 100.0 pF; Vin; Iout

Copyright © 2017, Texas Instruments Incorporated | 1 | ti.com/webench

WEBENCH®
Design Report LMR23630AFDDAR : LMR23630AFDDAR 4.5V-5.5V to 3.30V @ 3.0A February 2, 2017 03:20:38 GMT-08:00

## WEBENCH ® Design Report

Design : 4875907/22 LMR23630AFDDAR
LMR23630AFDDAR 4.5V-5.5V to 3.30V @ 3.0A

VinMin = 4.5V
VinMax = 5.5V
Vout = 3.3V
Iout = 3.0A

Device = LMR23630AFDDAR
Topology = Buck
Created = 2/2/17 3:16:08 AM BOM Cost = $2.94
BOM Count = 11
Total Pd = 1.83W
1. The input capacitor included in the BOM only contains a small filter capacitor that should be placed near the IC. Depending on where the power supply is laid out in the system additional bulk capacitance may need to be added to filter the line ripple.
2. If there is no VinTyp specified, WEBENCH will use the VinMax value. To change the VinTyp value, click on the "Change Design Inputs" button under the Optimization Tuning knob. In some applications, while the design requires the input voltage to be a wide range, for a majority of the time, it is operating at a much lower voltage than the maximum input voltage. Sizing the inductor based on the maximum input voltage may yield an inductance much larger than typically needed, causing a larger footprint for the overall design. At the same time, components such as the input capacitor must be rated based on the maximum input voltage. WEBENCH now supports the use of this additional input voltage specification.

### My Comments

No comments

## Electrical BOM

# Name | Manufacturer | Part Number | Properties | Qty Price | Footprint

1. Cboot | Kemet | C0603C474K8PACTU (http://www.kemet.com/kemet/web/homepage/kechome.nsf/vapubfiles/F3102%5FY5V.pdf/%24file/F3102%5FY5V.pdf) Series= X5R | Cap= 470.0 nF VDC= 10.0 V IRMS= 0.0 A
1 | $0.02
| | | | | 0603 5 mm²
2. Cff | Kemet | C0603C101J3GACTU (http://www.kemet.com/docfinder?Partnumber%3DC0603C101J3GACTU) Series= C0G/NP0 | Cap= 100.0 pF VDC= 25.0 V IRMS= 0.0 A
1 | $0.01
| | | | | 0603 5 mm²
3. Cin | MuRata | GRM32ER61C226KE20L (http://search.murata.co.jp/Ceramy/PnsearchViewAction.do) Series= X5R | Cap= 22.0 uF ESR= 2.0 mOhm VDC= 16.0 V IRMS= 3.68 A
2 | $0.12
| | | | | 1210 15 mm²
4. Cout | MuRata | GRM31CR60J107ME39L (http://psearch.en.murata.com/capacitor/result/smd/?status%3Dall%26pid%3DGRM31CR60J107ME39L) Series= X5R | Cap= 100.0 uF ESR= 4.885 mOhm VDC= 6.3 V IRMS= 4.4118 A
2 | $0.14
| | | | | 1206_190 11 mm²
5. Cvcc | MuRata | GRM188R60J225KE19D (http://psearch.en.murata.com/capacitor/result/smd/?status%3Dall%26pid%3DGRM188R60J225KE19D) Series= X5R | Cap= 2.2 uF ESR= 9.637 mOhm VDC= 6.3 V IRMS= 1.32271 A
1 | $0.02
| | | | | 0603 5 mm²
6. L1 | Vishay-Dale | IHLP2525CZER3R3M01 (http://www.vishay.com/docs/34104/lp25cz01.pdf) | L= 3.3 µH DCR= 28.0 mOhm
1 | $0.95

IHLP-2525CZ 75 mm²
7. Rfbb | Panasonic | ERJ-6ENF2212V (http://www.panasonic.com/industrial/components/pdf/AOA0000CE2.pdf) Series= ERJ-6E | Res= 22.1 kOhm Power= 125.0 mW Tolerance= 1.0%
1 | $0.01
0805 7 mm²
8. Rfbt | Yageo America | RC0603FR-0751KL (http://www.yageo.com/documents/recent/PYu%2DRC0603%5F51%5FRoHS%5FL%5F7.pdf) Series= ? | Res= 51.0 kOhm Power= 100.0 mW Tolerance= 1.0%
1 | $0.01
0603 5 mm²

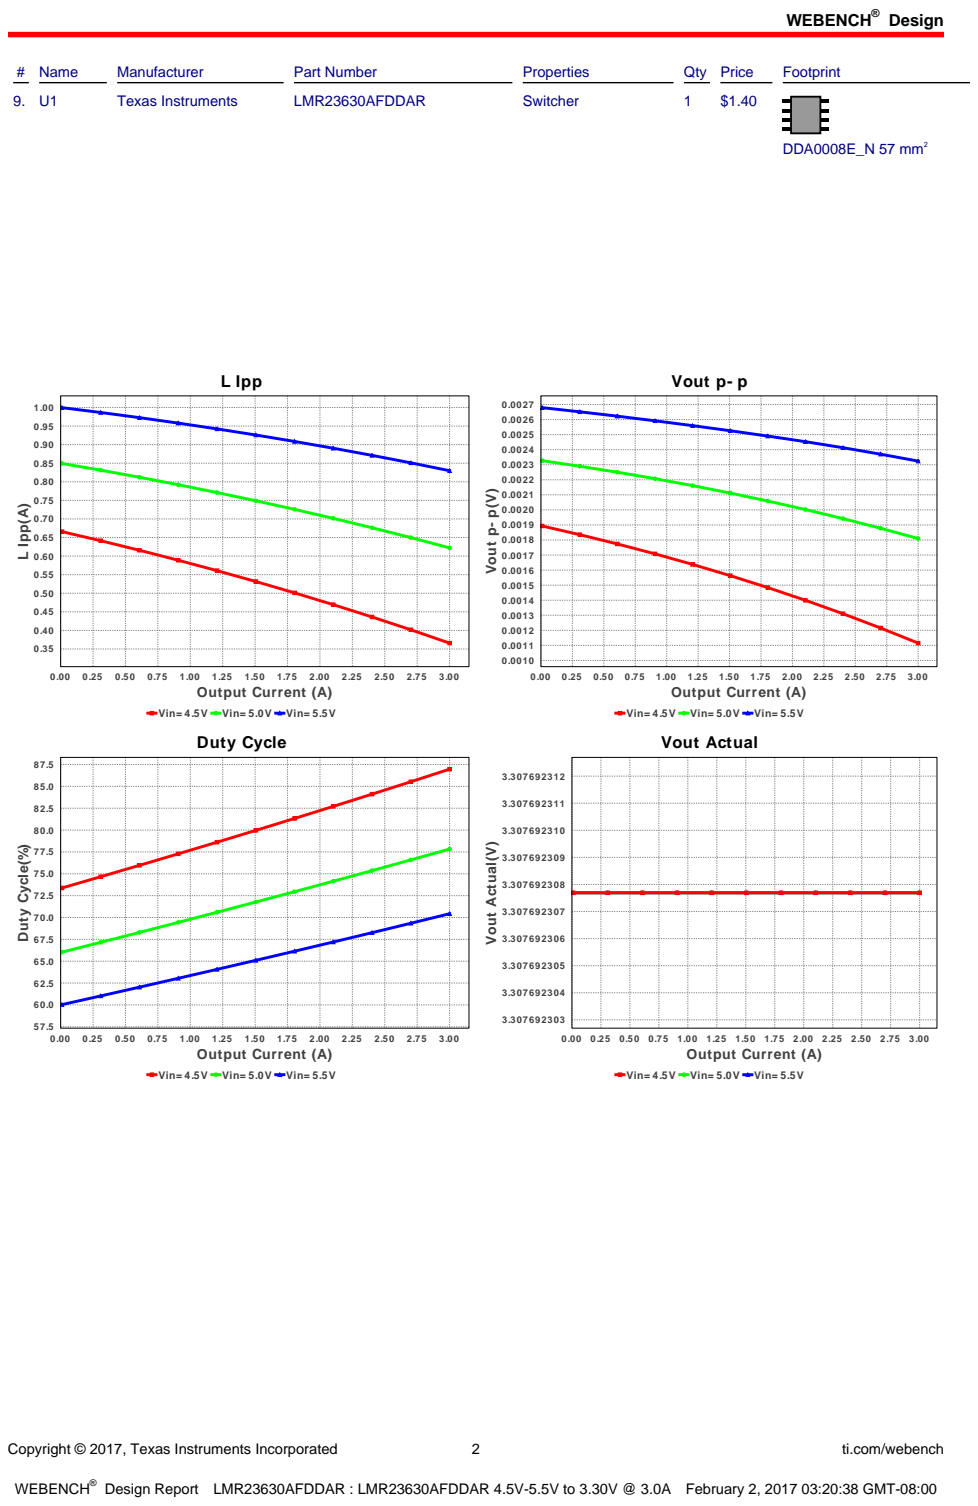
[picture p220: page 2]
Design; Copyright © 2017, Texas Instruments Incorporated; ti.com/webench; # Name; Manufacturer; Part Number; Properties; Qty Price; Footprint; Texas Instruments; LMR23630AFDDAR; Switcher; DDA0008E_N 57 mm²; L Ipp; 0.00 0.25 0.50 0.75 1.00 1.25 1.50 1.75 2.00 2.25 2.50 2.75 3.00 Output Current (A); L Ipp(A); Vout p- p; Vout p- p(V); Duty Cycle(%); Vout Actual(V)

Vin= 4.5V Vin= 5.0V Vin= 5.5V
Duty Cycle

Vout Actual

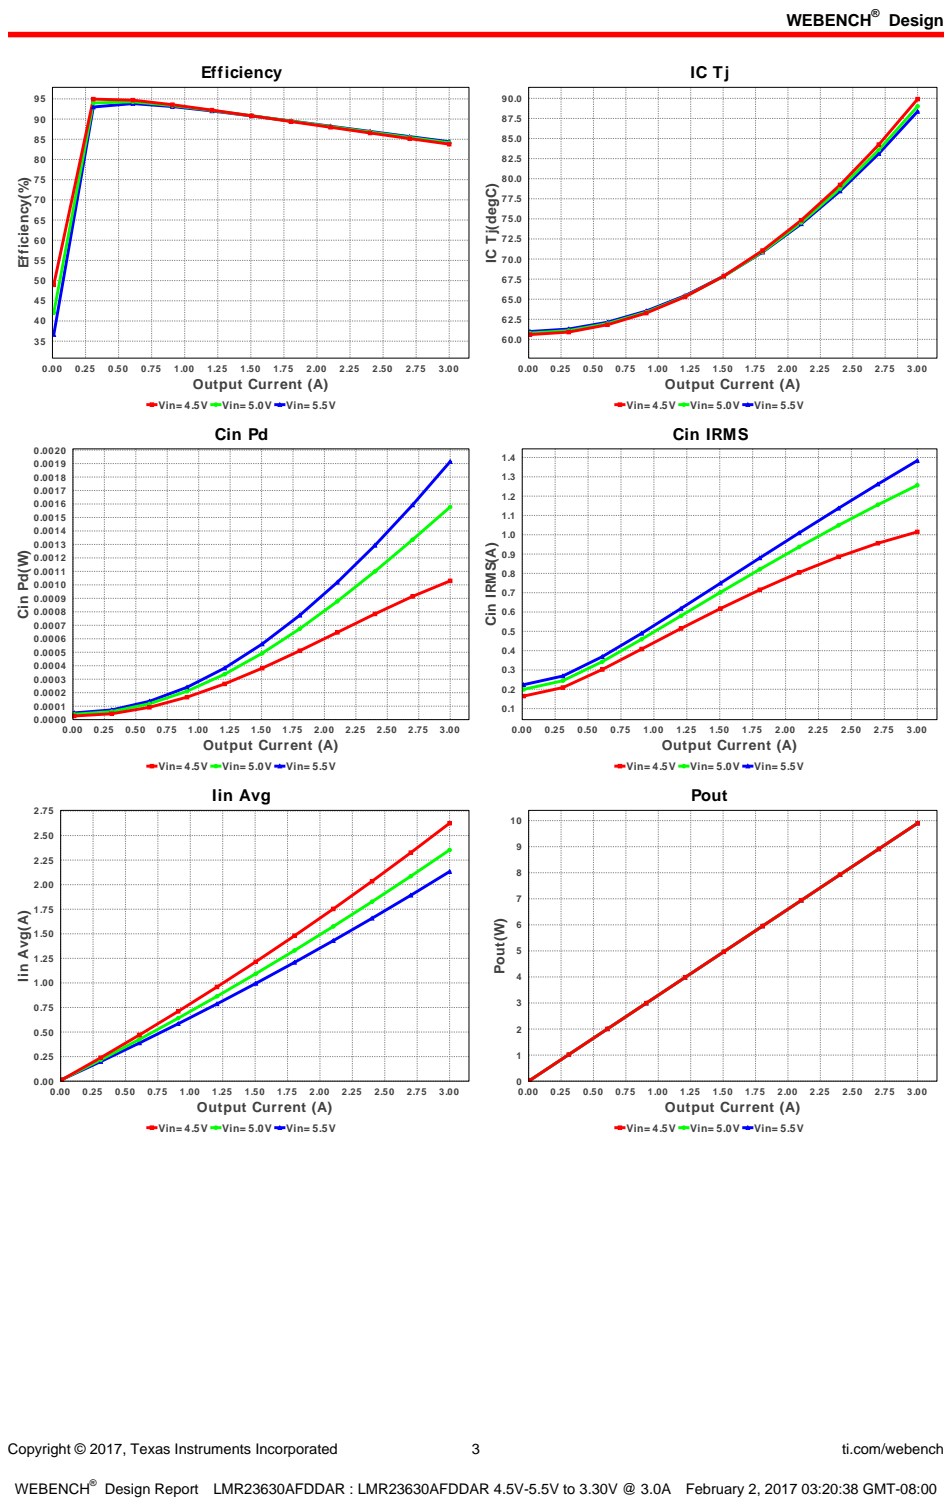
[picture p221: page 3]
Copyright © 2017, Texas Instruments Incorporated; ti.com/webench; Efficiency; 0.00 0.25 0.50 0.75 1.00 1.25 1.50 1.75 2.00 2.25 2.50 2.75 3.00 Output Current (A); Efficiency(%); Cin Pd(W); Cin IRMS(A); Iin Avg(A); Pout; Pout(W)

IC Tj(degC)

Vin= 4.5V Vin= 5.0V Vin= 5.5V
Cin Pd

Cin IRMS

Iin Avg

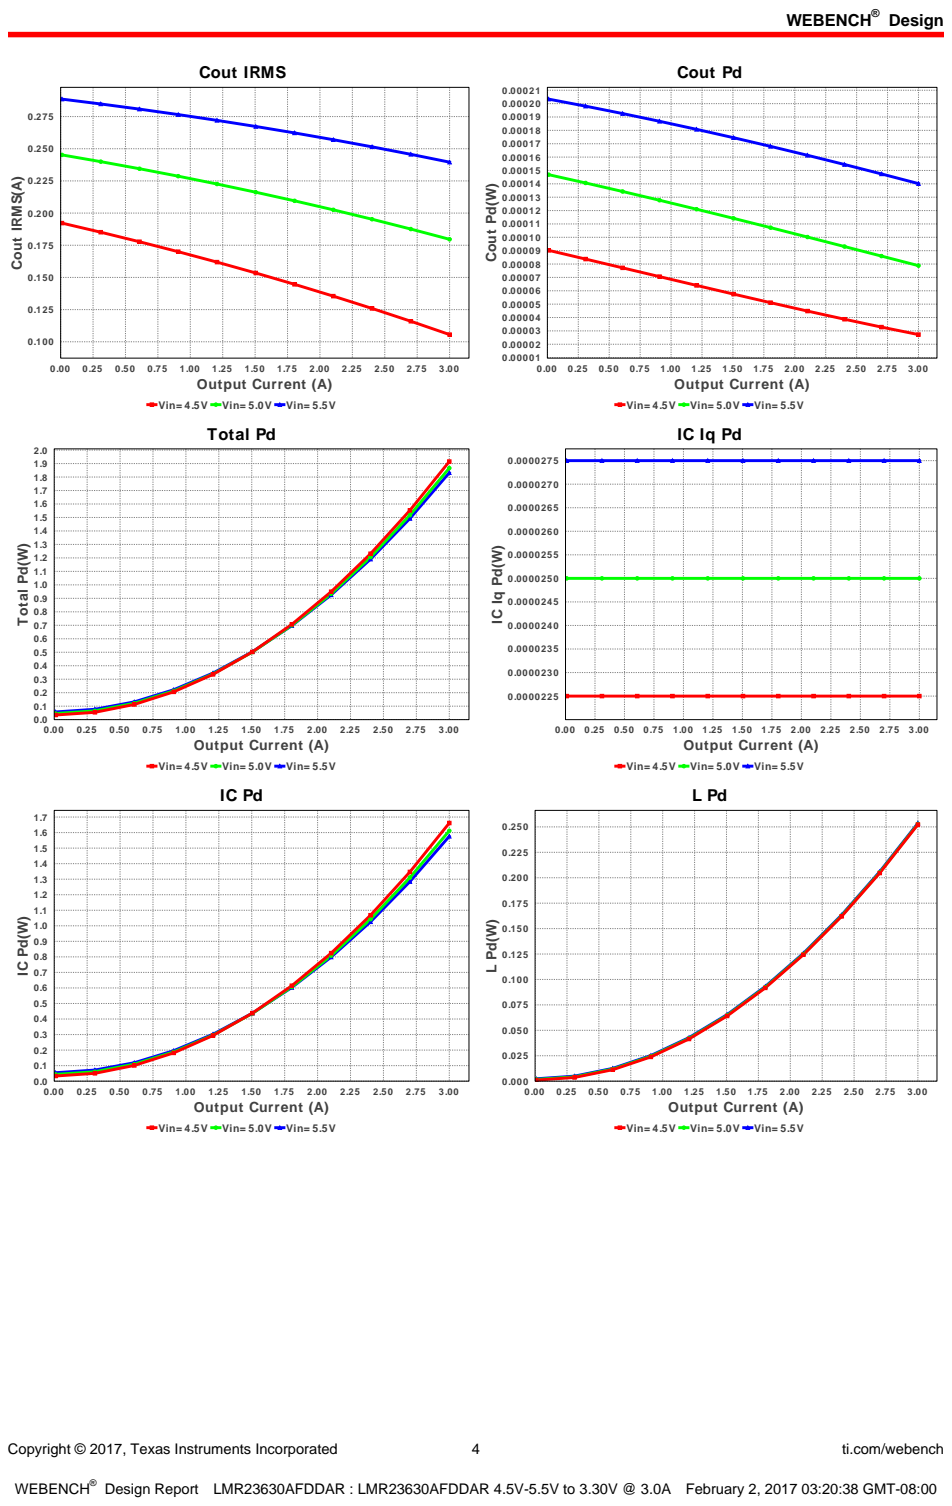
[picture p222: page 4]
Copyright © 2017, Texas Instruments Incorporated; ti.com/webench; Cout IRMS; 0.00 0.25 0.50 0.75 1.00 1.25 1.50 1.75 2.00 2.25 2.50 2.75 3.00 Output Current (A); Cout IRMS(A); Cout Pd; Cout Pd(W); Total Pd(W)

Vin= 4.5V Vin= 5.0V Vin= 5.5V
Total Pd

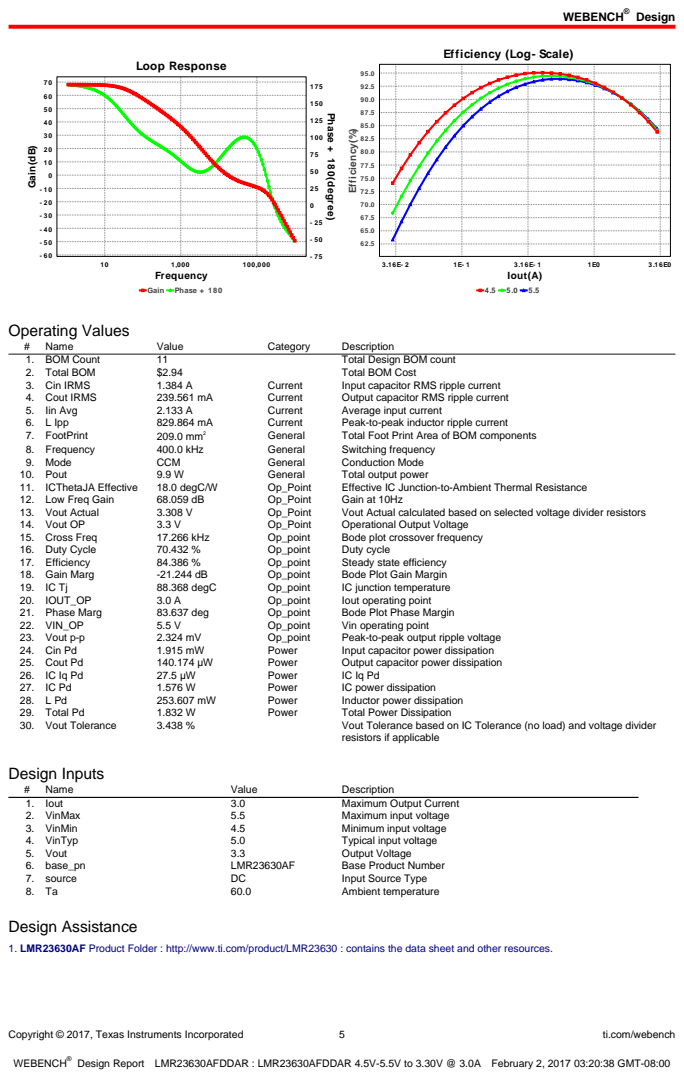
[picture p223: page 5]
Copyright © 2017, Texas Instruments Incorporated; ti.com/webench; Loop Response; Gain Phase + 180; 100,000 Frequency; Gain(dB); Phase + 180(degree); Iout(A); Efficiency(%); Operating Values; Name; Value; Category; Description; 1. BOM Count; Total Design BOM count; 2. Total BOM; Total BOM Cost; 3. Cin IRMS; Current; Input capacitor RMS ripple current; 4. Cout IRMS; Output capacitor RMS ripple current; 5. Iin Avg; Average input current; 6. L Ipp; Peak-to-peak inductor ripple current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

Efficiency (Log- Scale)

resistors if applicable

1. LMR23630AF Product Folder : http://www.ti.com/product/LMR23630 : contains the data sheet and other resources.

Copyright © 2017, Texas Instruments Incorporated | 6 | ti.com/webench

Texas Instruments' WEBENCH simulation tools attempt to recreate the performance of a substantially equivalent physical implementation
of the design. Simulations are created using Texas Instruments' published specifications as well as the published specifications of other device manufacturers. While Texas Instruments does update this information periodically, this information may not be current at the time the simulation is built. Texas Instruments does not warrant the accuracy or completeness of the specifications or any information contained therein. Texas Instruments does not warrant that any designs or recommended parts will meet the specifications you entered, will be suitable for your application or fit for any particular purpose, or will operate as shown in the simulation in a physical implementation. Texas Instruments does not warrant that the designs are production worthy.
You should completely validate and test your design implementation to confirm the system functionality for your application prior to production.
Use of Texas Instruments' WEBENCH simulation tools is subject to Texas Instruments' Site Terms and Conditions of Use. (http://www.ti.com/corp/docs/legal/termsofuse.shtml) Prototype boards based on WEBENCH created designs are provided AS IS without warranty of any kind for evaluation and testing purposes and are subject to the terms of the Evaluation License Agreement. (http://www.ti.com/corp/docs/legal/termsofuse_estore.shtml)
