irec-duster/RORO/Avionics_RORO/TI simulation/webench_design_5.5V-4.5V to 3.3V at 5A.pdf

## WEBENCH ® Design Report

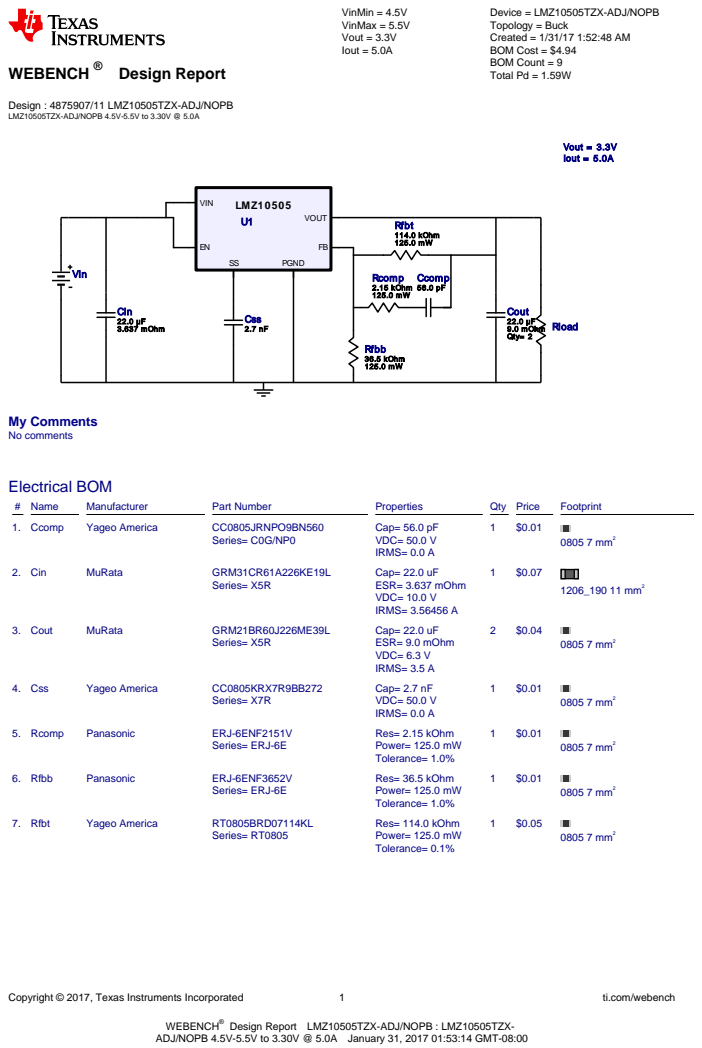
[picture p224: page 1]
Copyright © 2017, Texas Instruments Incorporated; ti.com/webench; VinMin = 4.5V VinMax = 5.5V Vout = 3.3V Iout = 5.0A; Ccomp 56.0 pF; Cin 22.0 µF 3.637 mOhm; Cout 22.0 µF 9.0 mOhm Qty= 2; Css 2.7 nF; Rcomp 2.15 kOhm 125.0 mW; Rfbb 36.5 kOhm 125.0 mW; Rfbt 114.0 kOhm 125.0 mW; LMZ10505; VOUT; VIN; PGND; Vout = 3.3V Iout = 5.0A; Vin; Rload; My Comments No comments; Electrical BOM; # Name; Manufacturer; Part Number; Properties; Qty Price; Footprint; 1. Ccomp; Yageo America; CC0805JRNPO9BN560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

Device = LMZ10505TZX-ADJ/NOPB
Topology = Buck
Created = 1/31/17 1:52:48 AM
BOM Cost = $4.94
BOM Count = 9
Total Pd = 1.59W

Design : 4875907/11 LMZ10505TZX-ADJ/NOPB
LMZ10505TZX-ADJ/NOPB 4.5V-5.5V to 3.30V @ 5.0A

WEBENCH®
ADJ/NOPB 4.5V-5.5V to 3.30V @ 5.0A January 31, 2017 01:53:14 GMT-08:00

Design Report LMZ10505TZX-ADJ/NOPB : LMZ10505TZX-

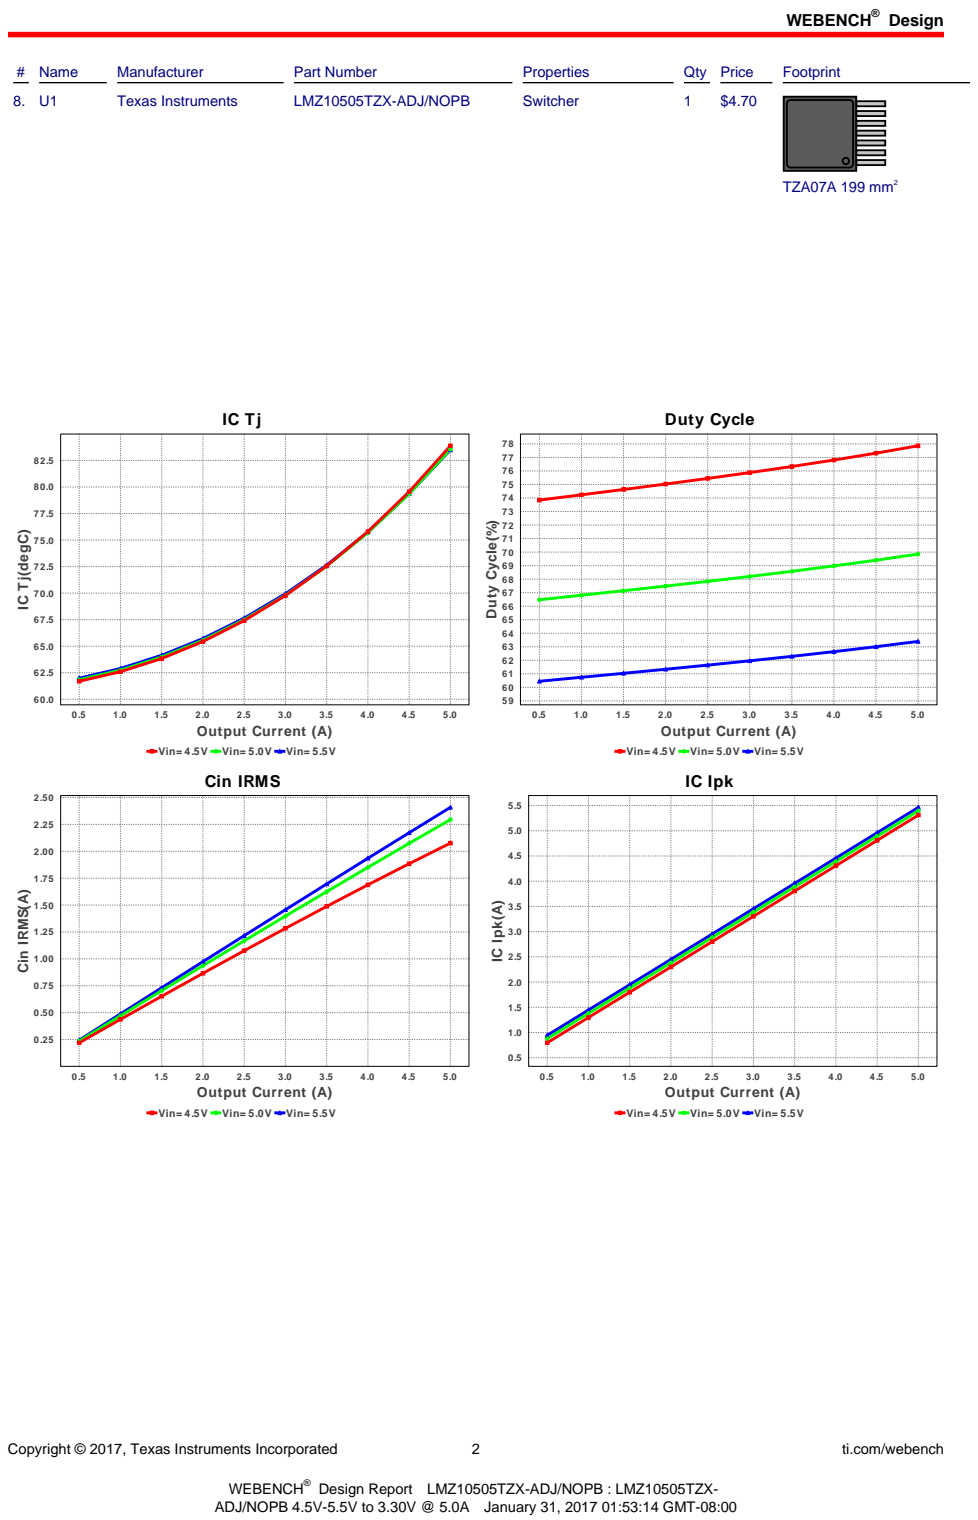
[picture p225: page 2]
Design; Copyright © 2017, Texas Instruments Incorporated; ti.com/webench; # Name; Manufacturer; Part Number; Properties; Qty Price; Footprint; Texas Instruments; LMZ10505TZX-ADJ/NOPB; Switcher; TZA07A 199 mm²; 5.0 Output Current (A); Duty Cycle; Duty Cycle(%); Cin IRMS(A); IC Ipk; IC Ipk(A)

IC Tj(degC)

Vin= 4.5V Vin= 5.0V Vin= 5.5V
Cin IRMS

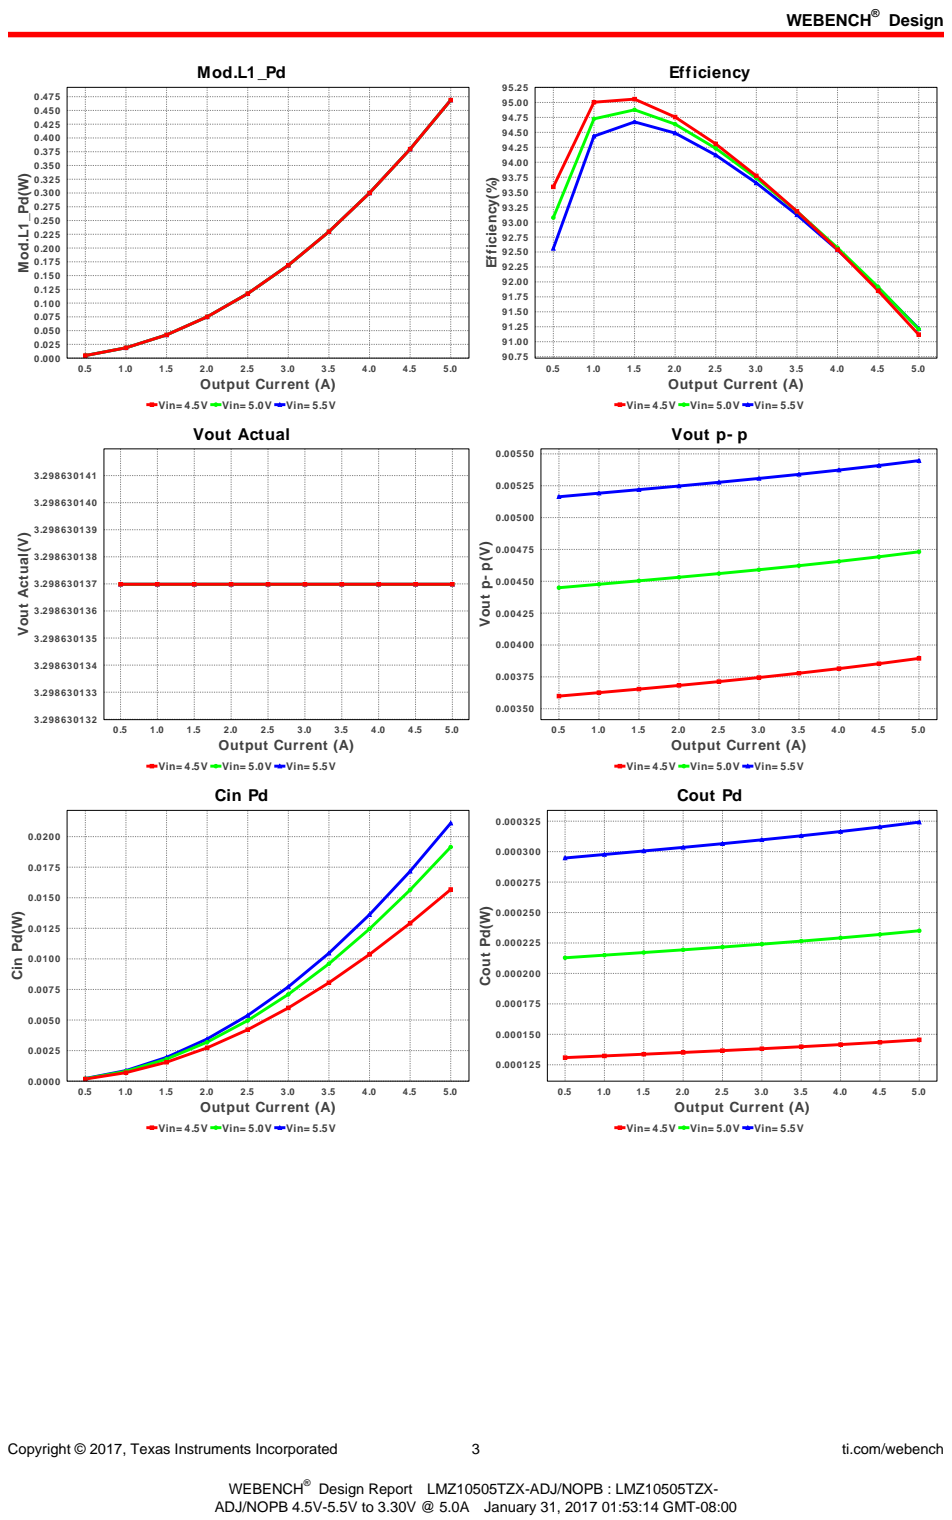
[picture p226: page 3]
Copyright © 2017, Texas Instruments Incorporated; ti.com/webench; Mod.L1_Pd; 5.0 Output Current (A); Mod.L1_Pd(W); Efficiency; Efficiency(%); Vout Actual(V); Vout p- p(V); Cin Pd(W); Cout Pd(W)

Vin= 4.5V Vin= 5.0V Vin= 5.5V
Vout Actual

Vout p- p

Cin Pd

Cout Pd

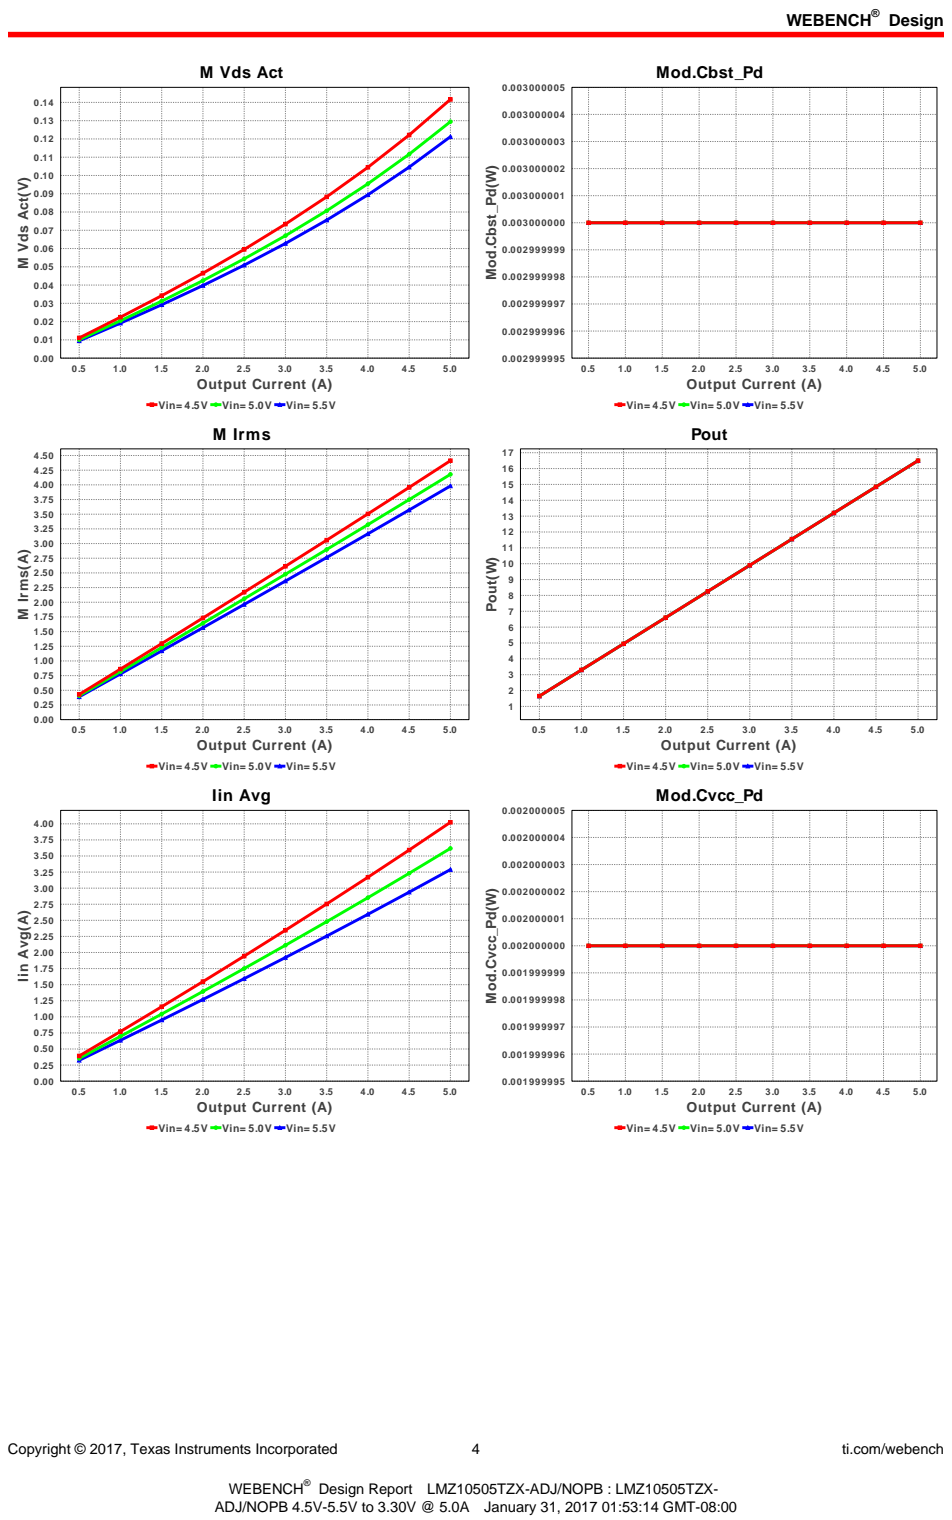
[picture p227: page 4]
Copyright © 2017, Texas Instruments Incorporated; ti.com/webench; M Vds Act; 5.0 Output Current (A); M Vds Act(V); Mod.Cbst_Pd; Mod.Cbst_Pd(W); M Irms(A); Pout; Pout(W); Iin Avg(A); Mod.Cvcc_Pd(W)

Vin= 4.5V Vin= 5.0V Vin= 5.5V
M Irms

Iin Avg

Mod.Cvcc_Pd

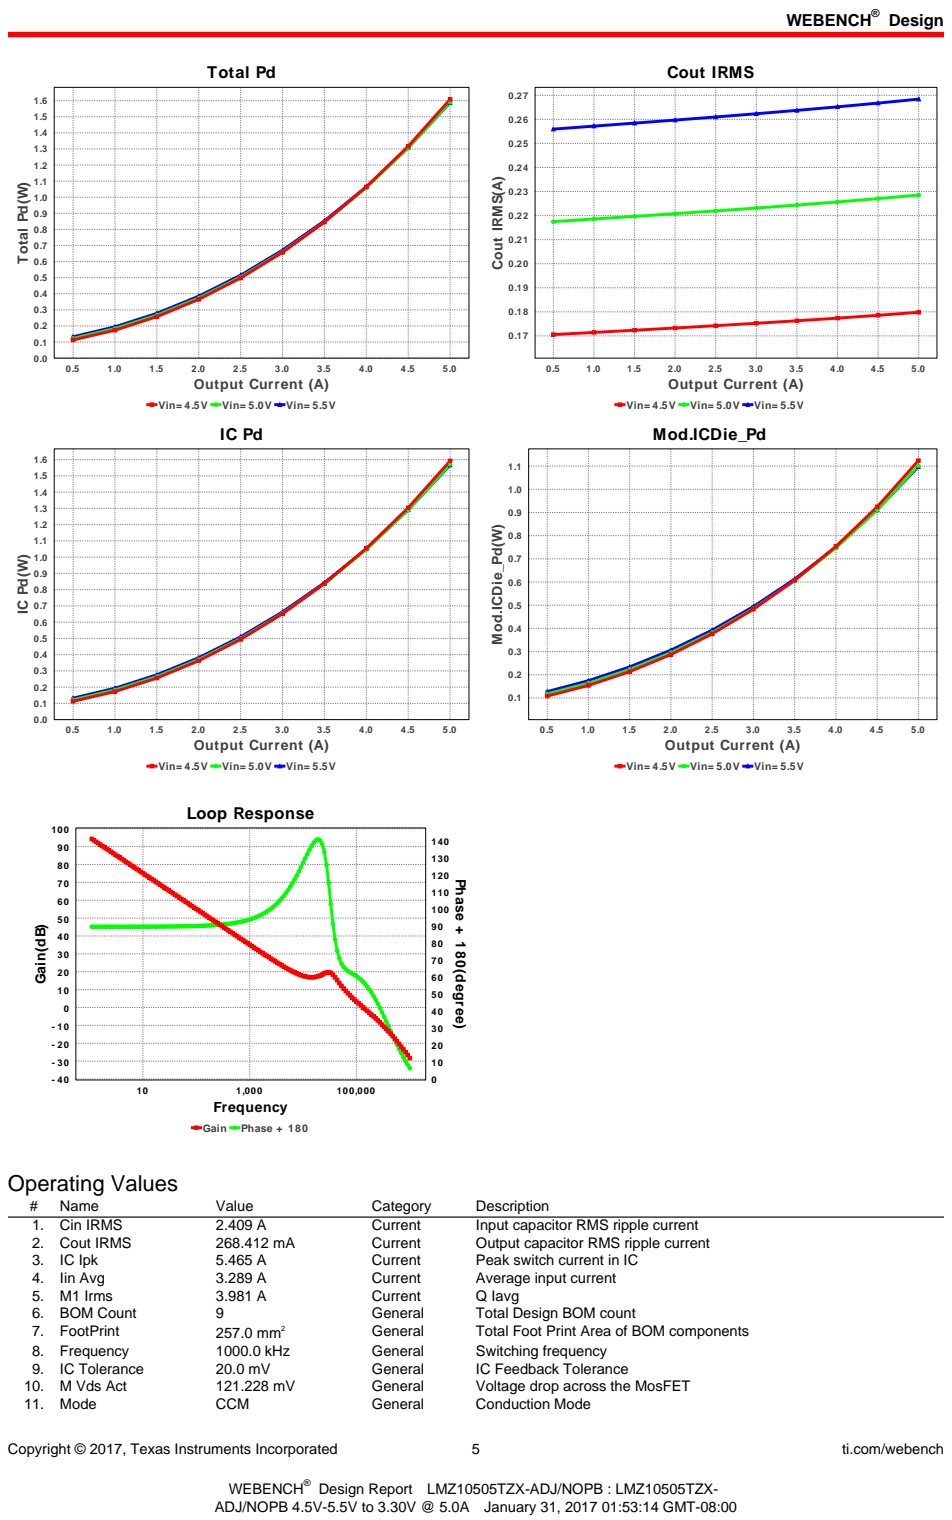
[picture p228: page 5]
Copyright © 2017, Texas Instruments Incorporated; ti.com/webench; Total Pd; 5.0 Output Current (A); Total Pd(W); Cout IRMS; Cout IRMS(A); Mod.ICDie_Pd(W); Loop Response; Gain Phase + 180; 100,000 Frequency; Gain(dB); Phase + 180(degree); Operating Values; Name; Value; Category; Description; 1. Cin IRMS; Current; Input capacitor RMS ripple current; 2. Cout IRMS; Output capacitor RMS ripple current; 3. IC Ipk; Peak switch current in IC; 4. Iin Avg; Average input current; 5. M1 Irms; Q Iavg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

Vin= 4.5V Vin= 5.0V Vin= 5.5V

Mod.ICDie_Pd

Copyright © 2017, Texas Instruments Incorporated | 6 | ti.com/webench
# | Name | Value | Category | Description

12. Pout | 16.5 W | General | Total output power
13. Total BOM | $4.94 | General | Total BOM Cost
14. Low Freq Gain | 94.316 dB | Op_Point | Gain at 10Hz
15. Vout Actual | 3.299 V | Op_Point | Vout Actual calculated based on selected voltage divider resistors
16. Vout OP | 3.3 V | Op_Point | Operational Output Voltage
17. Cross Freq | 134.424 kHz | Op_point | Bode plot crossover frequency
18. Duty Cycle | 63.396 % | Op_point | Duty cycle
19. Efficiency | 91.22 % | Op_point | Steady state efficiency
20. Gain Marg | -33.226 dB | Op_point | Bode Plot Gain Margin
21. IC Tj | 83.5 degC | Op_point | IC junction temperature
22. ICThetaJA | 15.0 degC/W | Op_point | IC junction-to-ambient thermal resistance
23. IOUT_OP | 5.0 A | Op_point | Iout operating point
24. Phase Marg | 57.539 deg | Op_point | Bode Plot Phase Margin
25. VIN_OP | 5.5 V | Op_point | Vin operating point
26. Vout p-p | 5.447 mV | Op_point | Peak-to-peak output ripple voltage
27. Cin Pd | 21.1 mW | Power | Input capacitor power dissipation
28. Cout Pd | 324.203 µW | Power | Output capacitor power dissipation
29. IC Pd | 1.567 W | Power | IC power dissipation
30. Module CbstPd | 3.0 mW | Power | Internal Module Cbst Power Dissipation
31. Module CvccPd | 2.0 mW | Power | Internal Module Cvcc Power Dissipation
32. Module ICPd | 1.098 W | Power | Internal Module IC Power Dissipation
33. Module L1Pd | 468.75 mW | Power | Internal Module Inductor Power Dissipation
34. Total Pd | 1.588 W | Power | Total Power Dissipation
35. Vout Tolerance | 3.363 % | Vout Tolerance based on IC Tolerance (no load) and voltage divider
| | | | resistors if applicable

## Design Inputs

# | Name | Value | Description

1. Iout | 5.0 | Maximum Output Current
2. SoftStart | 1.0 ms | Soft Start Time (ms)
3. VinMax | 5.5 | Maximum input voltage
4. VinMin | 4.5 | Minimum input voltage
5. Vout | 3.3 | Output Voltage
6. base_pn | LMZ10505 | Base Product Number
7. source | DC | Input Source Type
8. Ta | 60.0 | Ambient temperature

## Design Assistance

1. LMZ10505 Product Folder : http://www.ti.com/product/LMZ10505 : contains the data sheet and other resources.

Texas Instruments' WEBENCH simulation tools attempt to recreate the performance of a substantially equivalent physical implementation
of the design. Simulations are created using Texas Instruments' published specifications as well as the published specifications of other device manufacturers. While Texas Instruments does update this information periodically, this information may not be current at the time the simulation is built. Texas Instruments does not warrant the accuracy or completeness of the specifications or any information contained therein. Texas Instruments does not warrant that any designs or recommended parts will meet the specifications you entered, will be suitable for your application or fit for any particular purpose, or will operate as shown in the simulation in a physical implementation. Texas Instruments does not warrant that the designs are production worthy.
You should completely validate and test your design implementation to confirm the system functionality for your application prior to production.
Use of Texas Instruments' WEBENCH simulation tools is subject to Texas Instruments' Site Terms and Conditions of Use. (http://www.ti.com/corp/docs/legal/termsofuse.shtml) Prototype boards based on WEBENCH created designs are provided AS IS without warranty of any kind for evaluation and testing purposes and are subject to the terms of the Evaluation License Agreement. (http://www.ti.com/corp/docs/legal/termsofuse_estore.shtml)
