irec-duster/RORO/Avionics_RORO/CAD/Nosecone/Drawing/3101_Guide.PDF

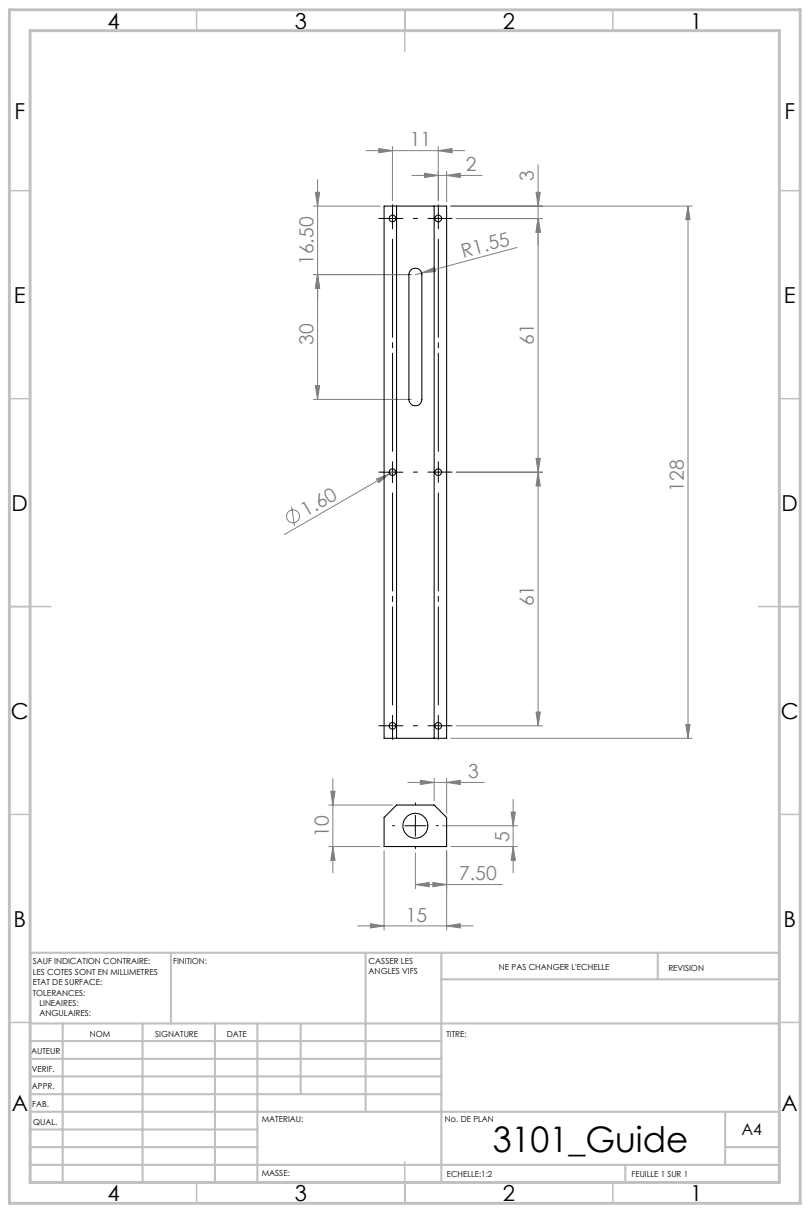
[picture p229: page 1]
FINITION:; CASSER LES; ANGLES VIFS; NE PAS CHANGER L'ECHELLE; REVISION; ECHELLE:1:2; FEUILLE 1 SUR 1

SAUF INDICATION CONTRAIRE:
LES COTES SONT EN MILLIMETRES
ETAT DE SURFACE:
TOLERANCES:
LINEAIRES:
ANGULAIRES:

NOM | SIGNATURE | DATE | | | | TITRE:

AUTEUR
VERIF.
APPR.
FAB.
QUAL. | | | | MATERIAU: | No. DE PLAN 3101_Guide | A4
