irec-duster/RORO/Avionics_RORO/Altium/Project/Rocket_PCB_Project_2017/Avionics_electrical_schematics.pdf

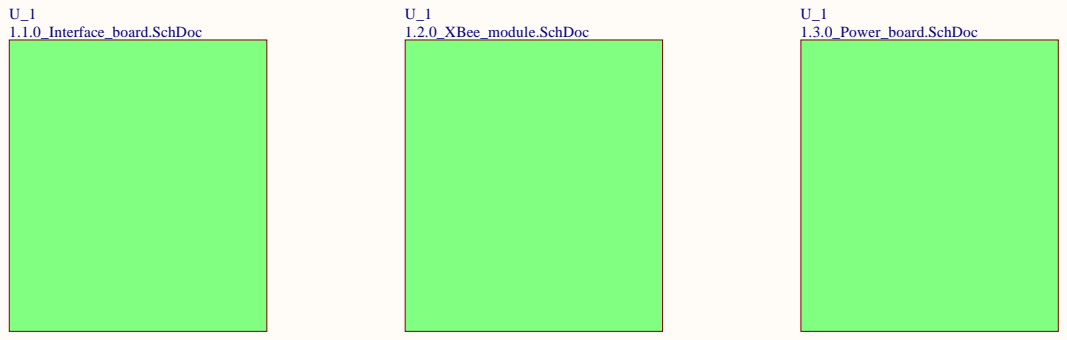
[picture p230: page 1]

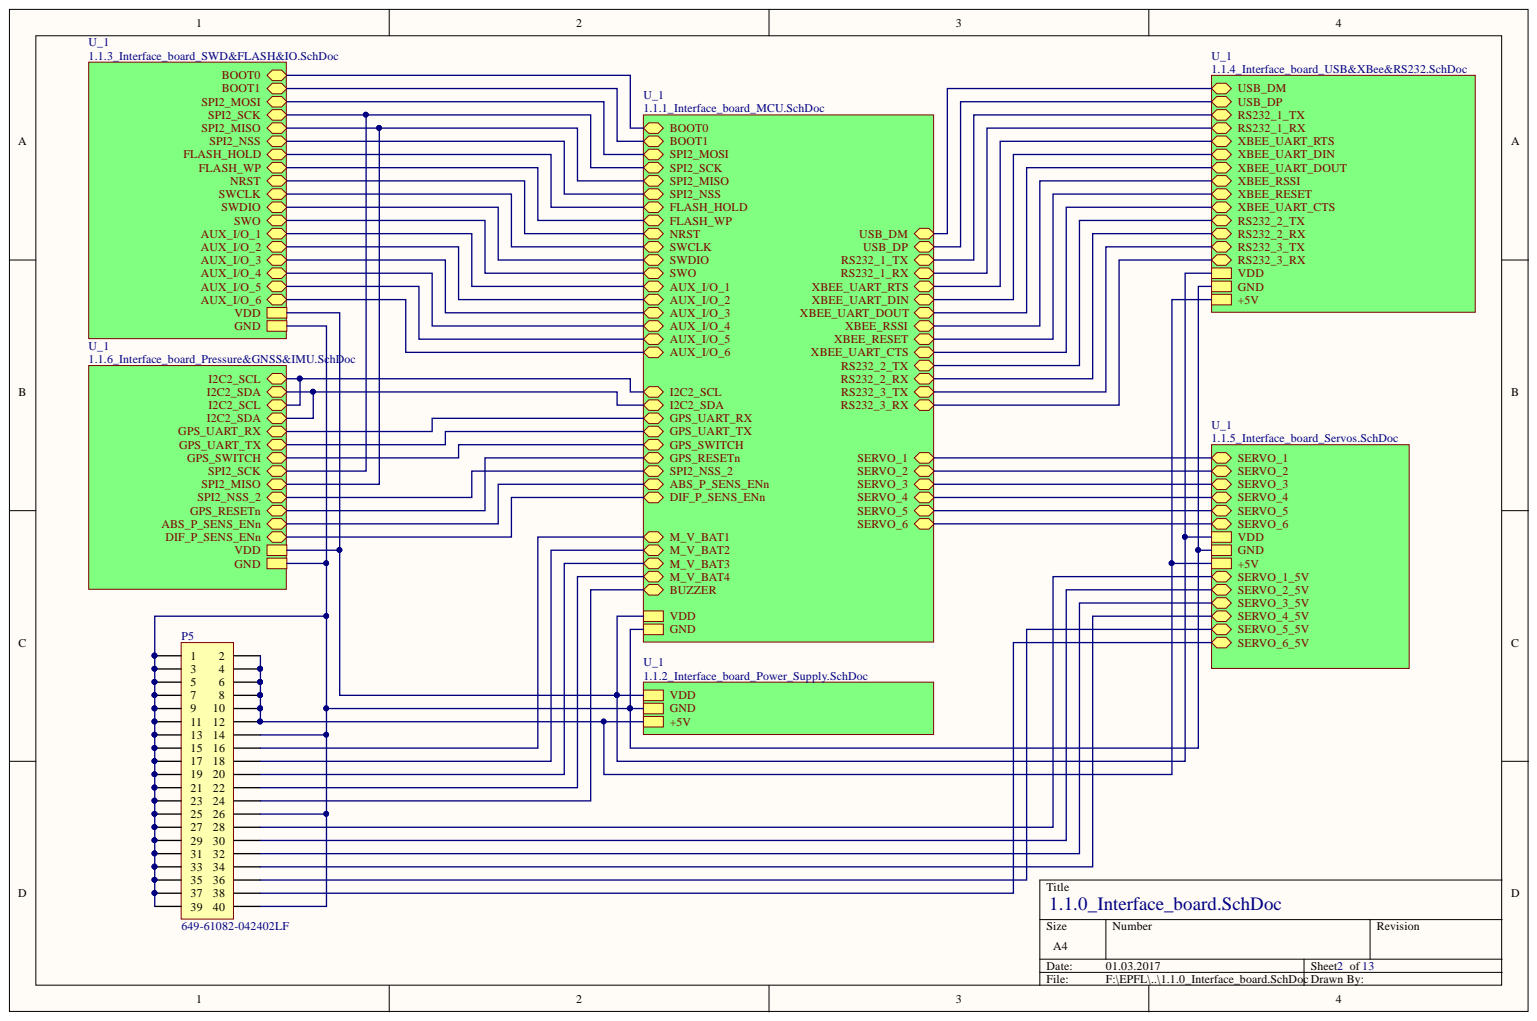
[picture p231: page 2]

M_V_BAT1 M_V_BAT2

M_V_BAT3 M_V_BAT4

BUZZER

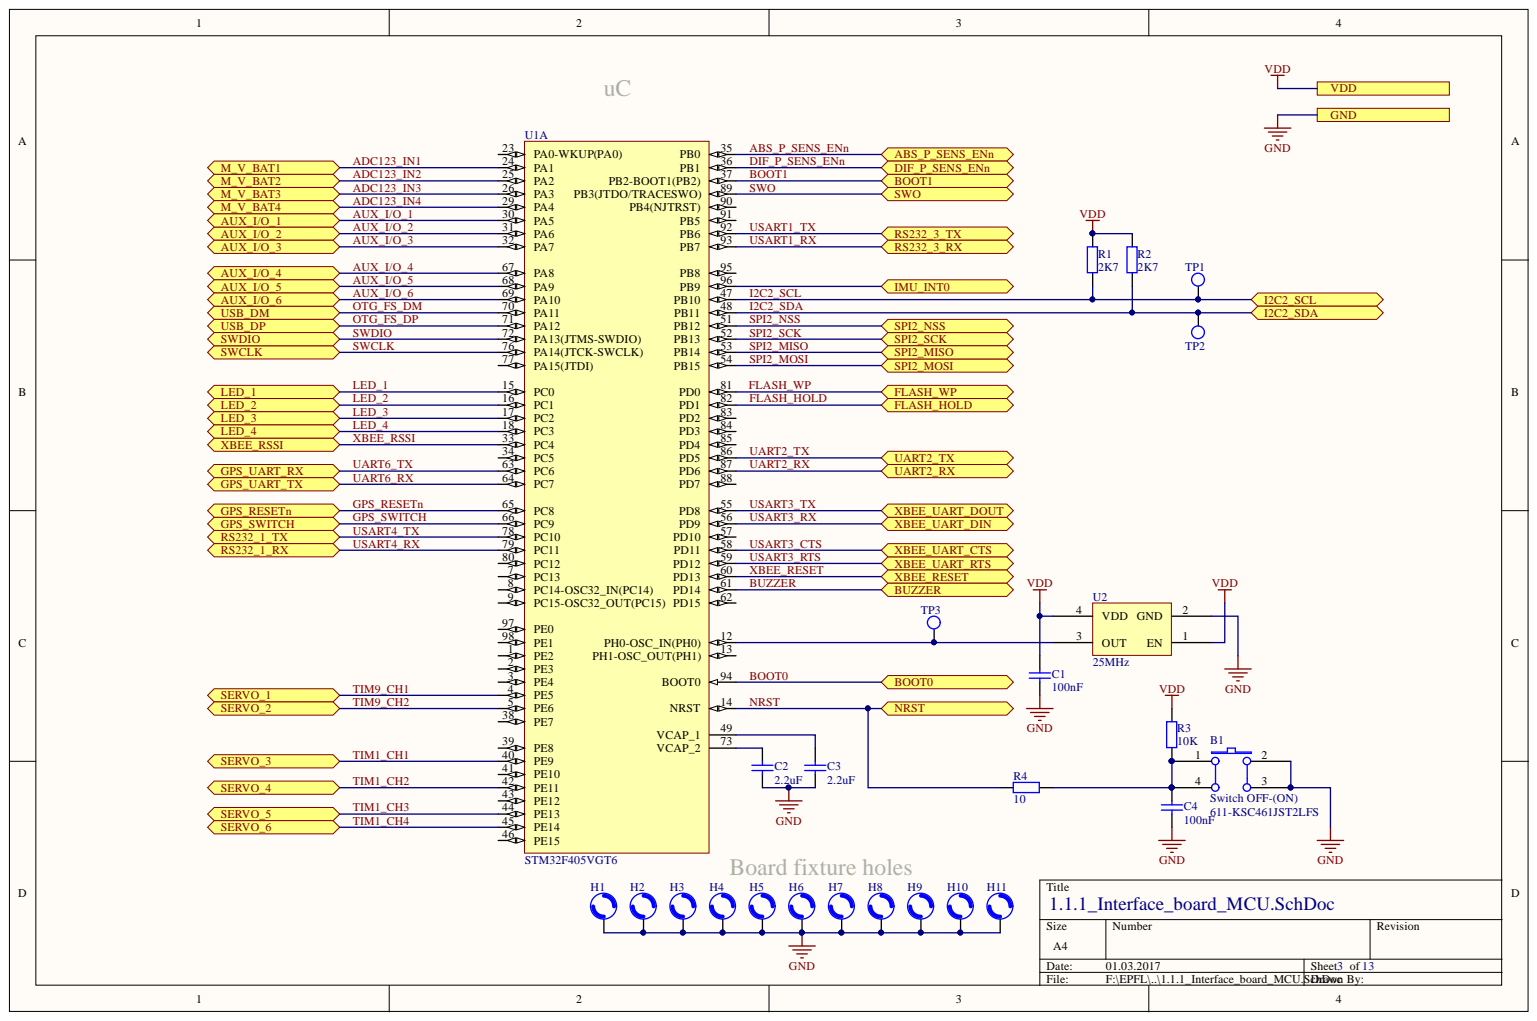
[picture p232: page 3]

4 9
7 3

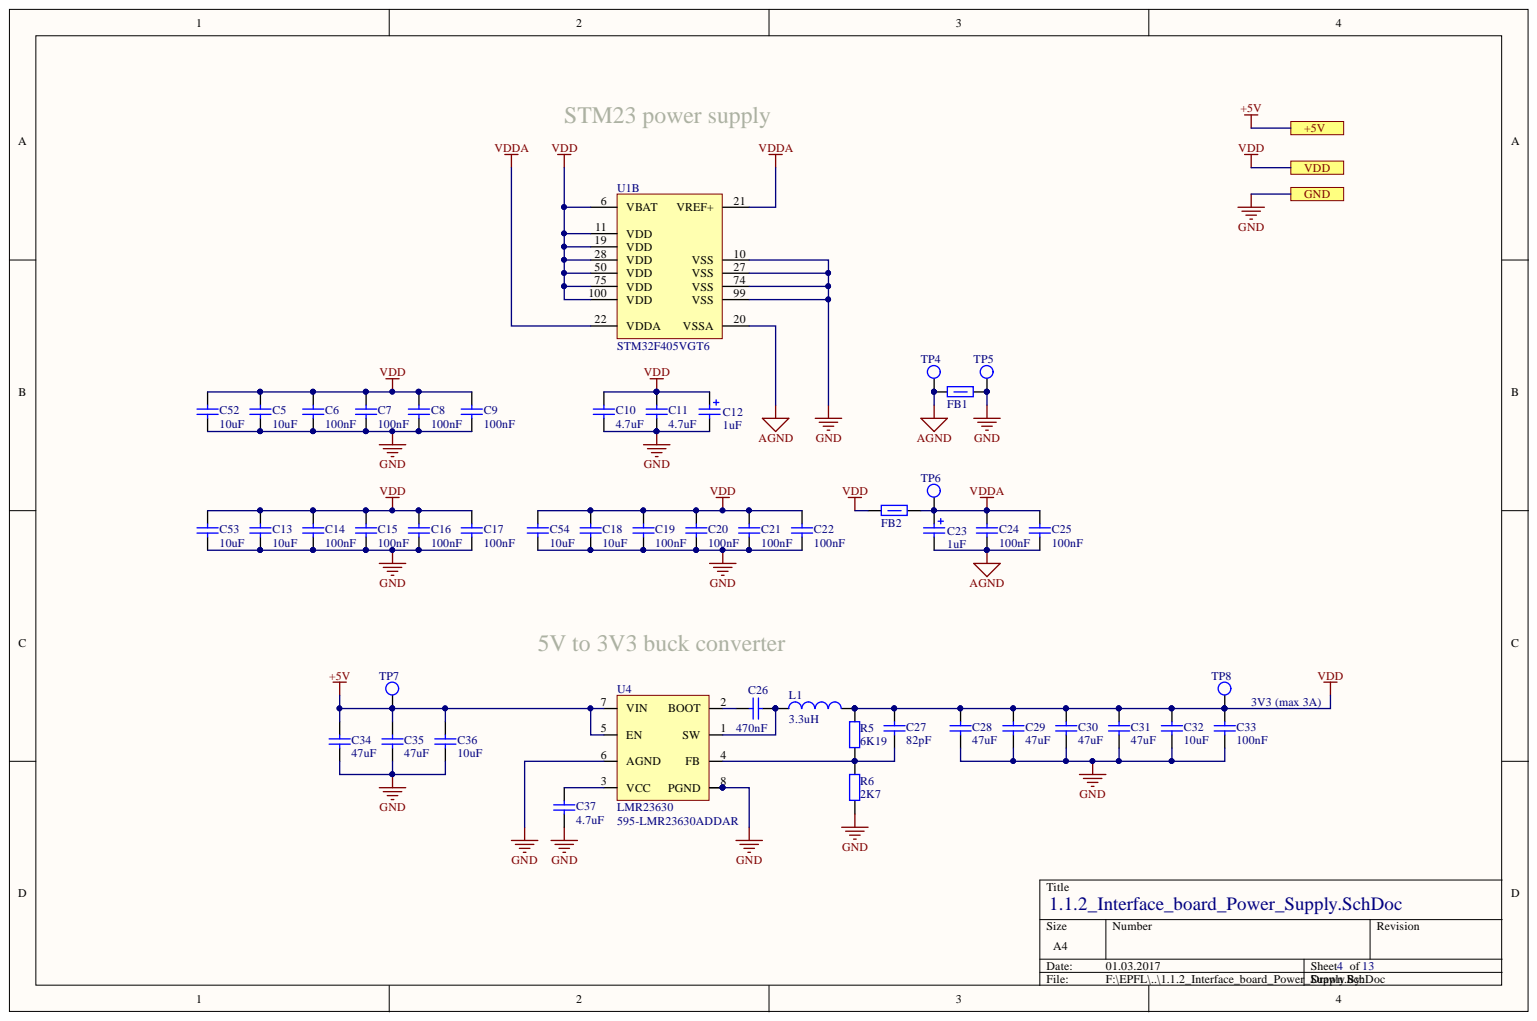
[picture p233: page 4]

VDD 19

VDD 50

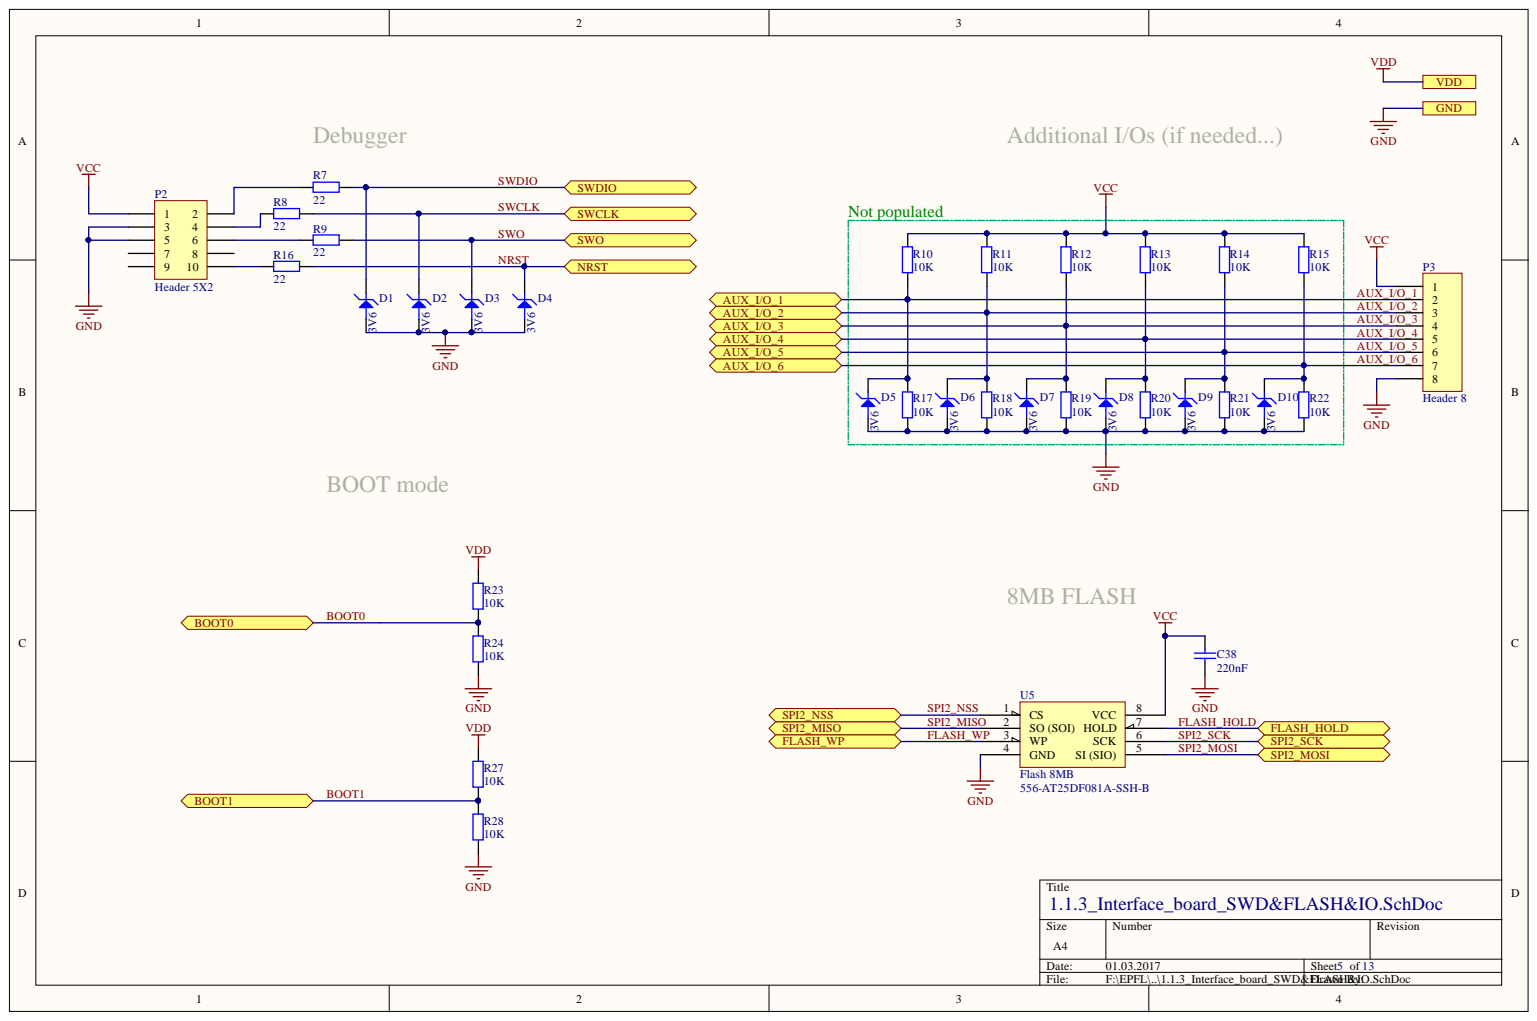
[picture p234: page 5]

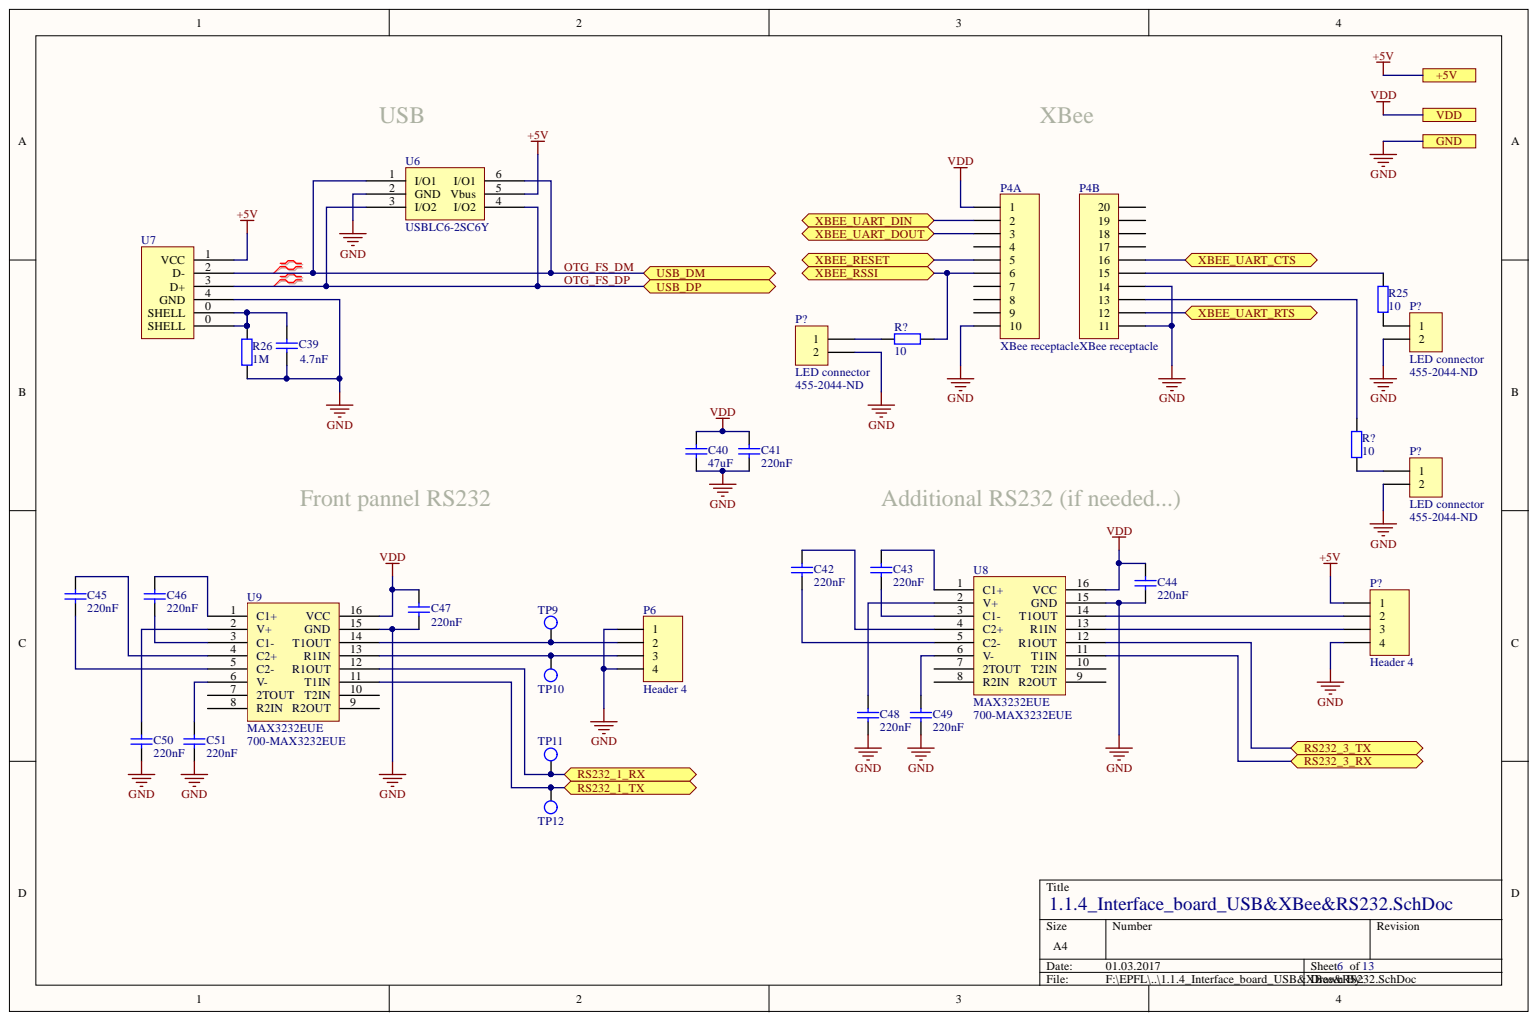
[picture p235: page 6]

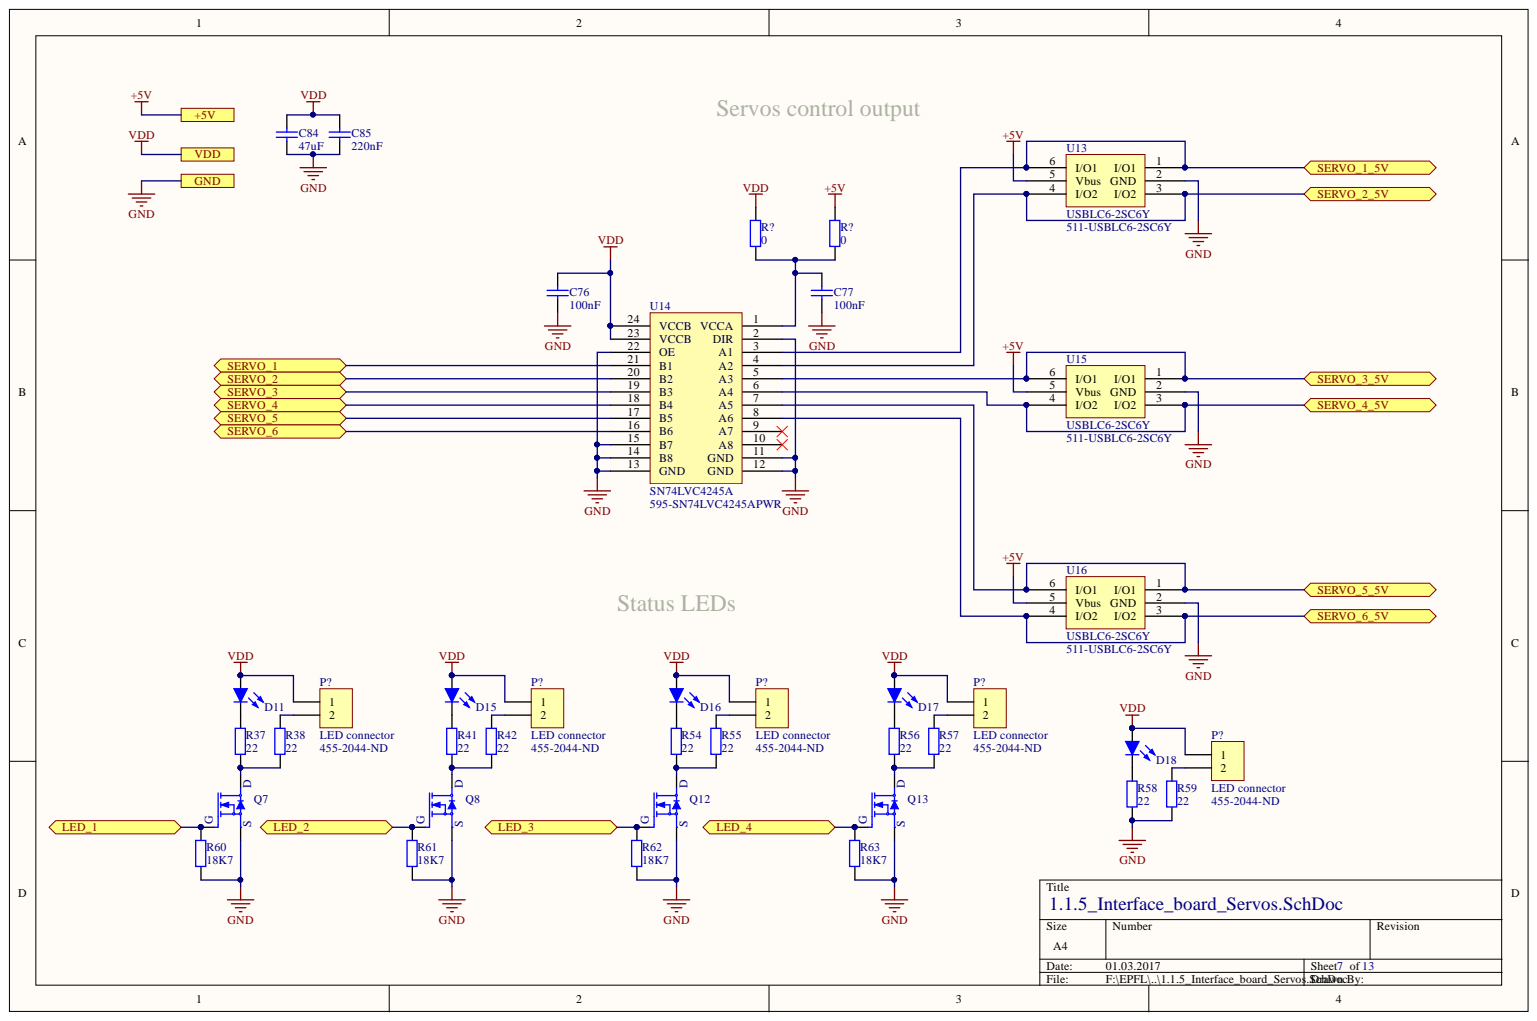
[picture p236: page 7]

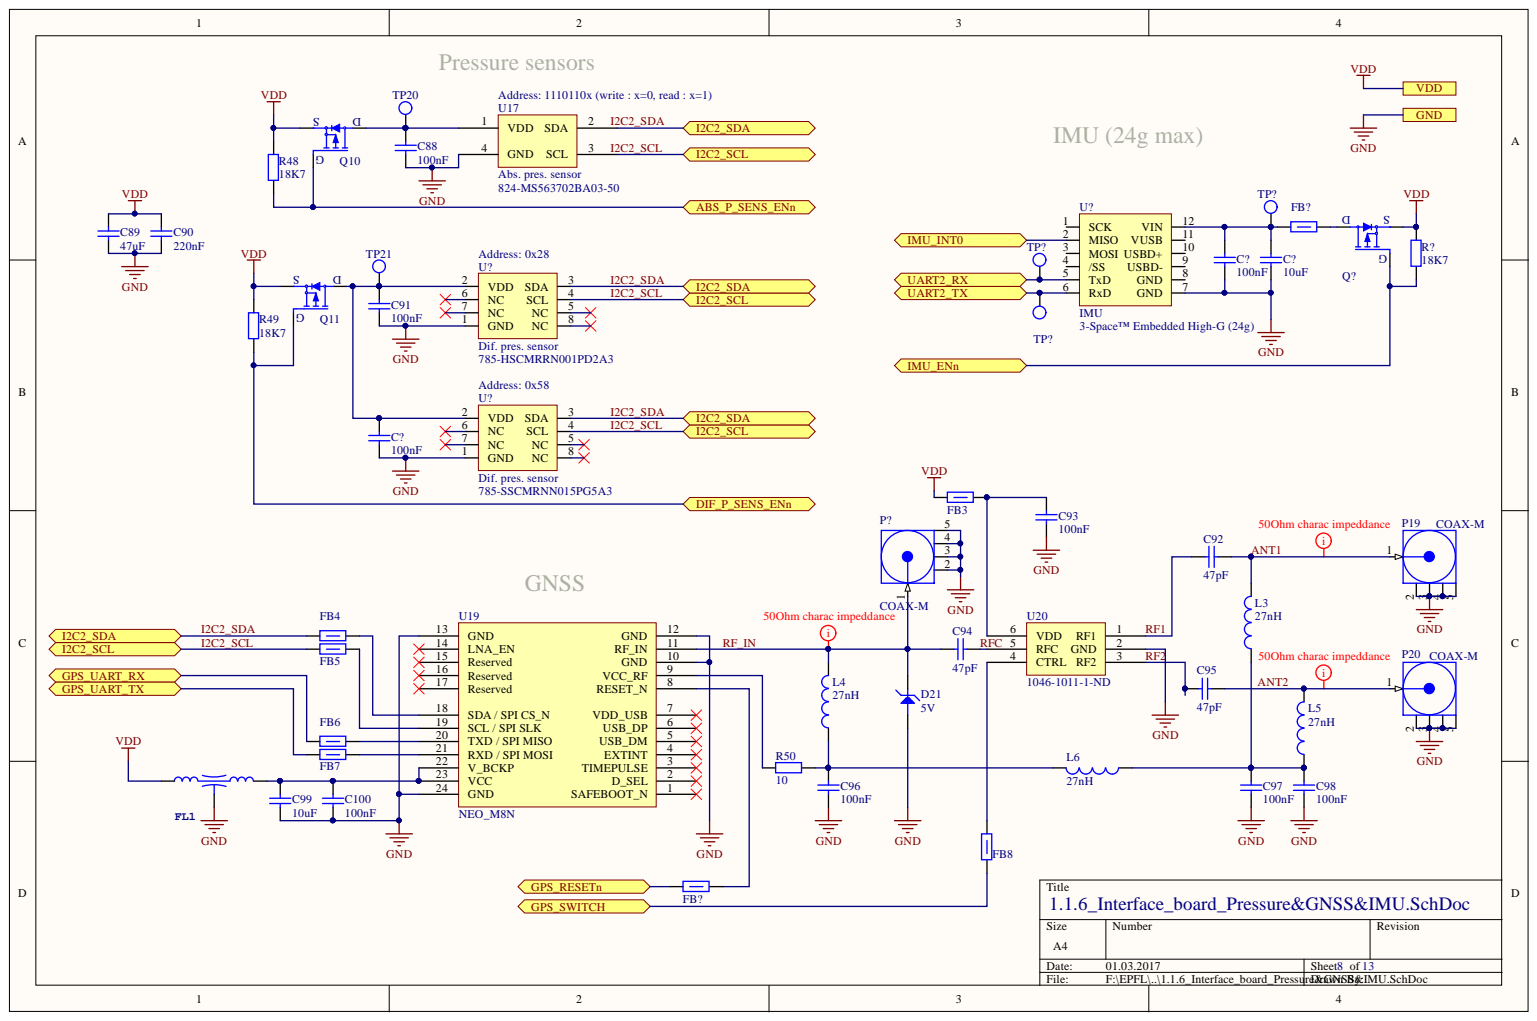
[picture p237: page 8]

SCL / SPI SLK 19

RXD / SPI MOSI 21
V_BCKP 22
VCC 23
GND 24

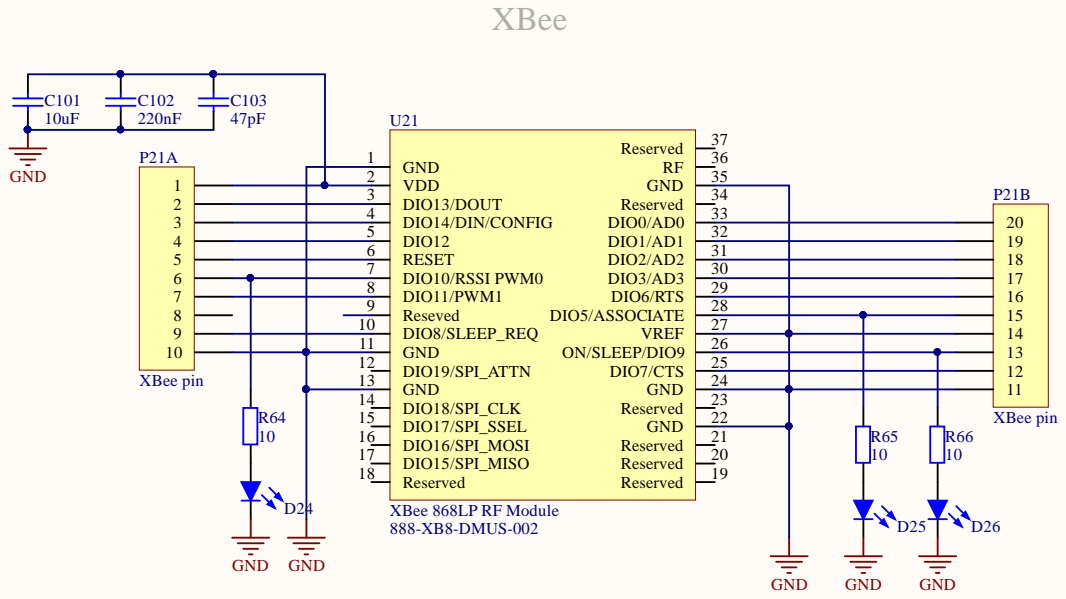
[picture p238: page 9]

5 | | 3 2
6 | | 3 1
7 | | 3 0
8 | | 2 9
1 | 9 0 | | 2 8

1 | 1 | | 2 6
1 1 | 2 | | 2 5

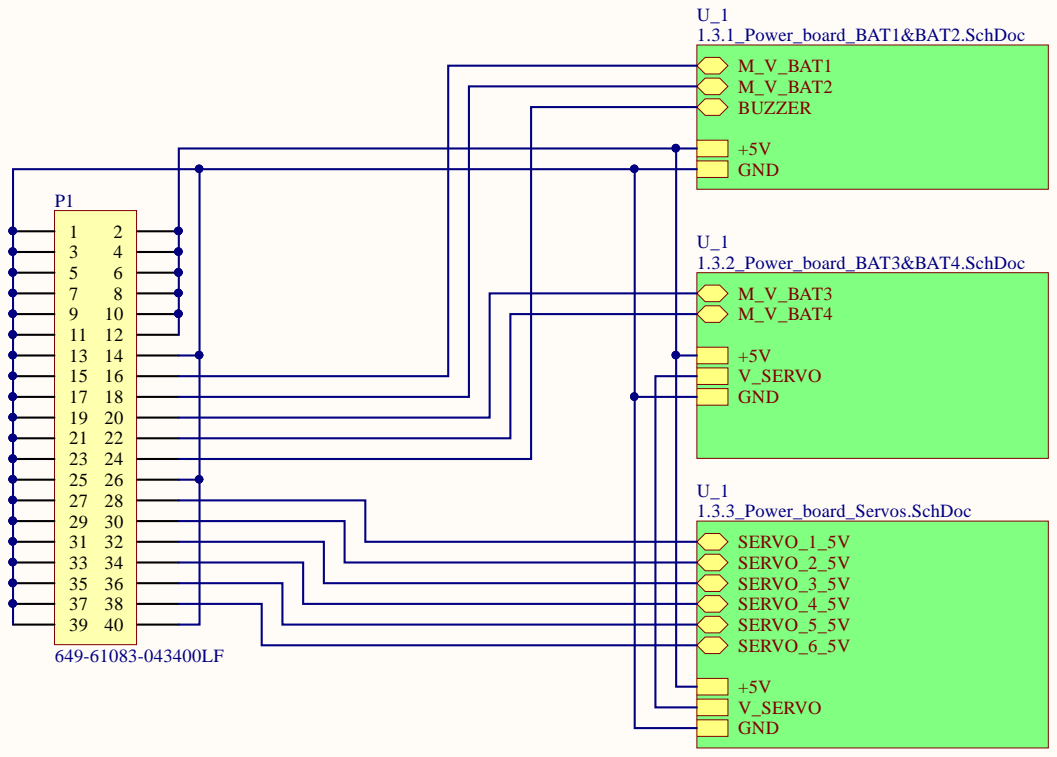
[picture p239: page 10]

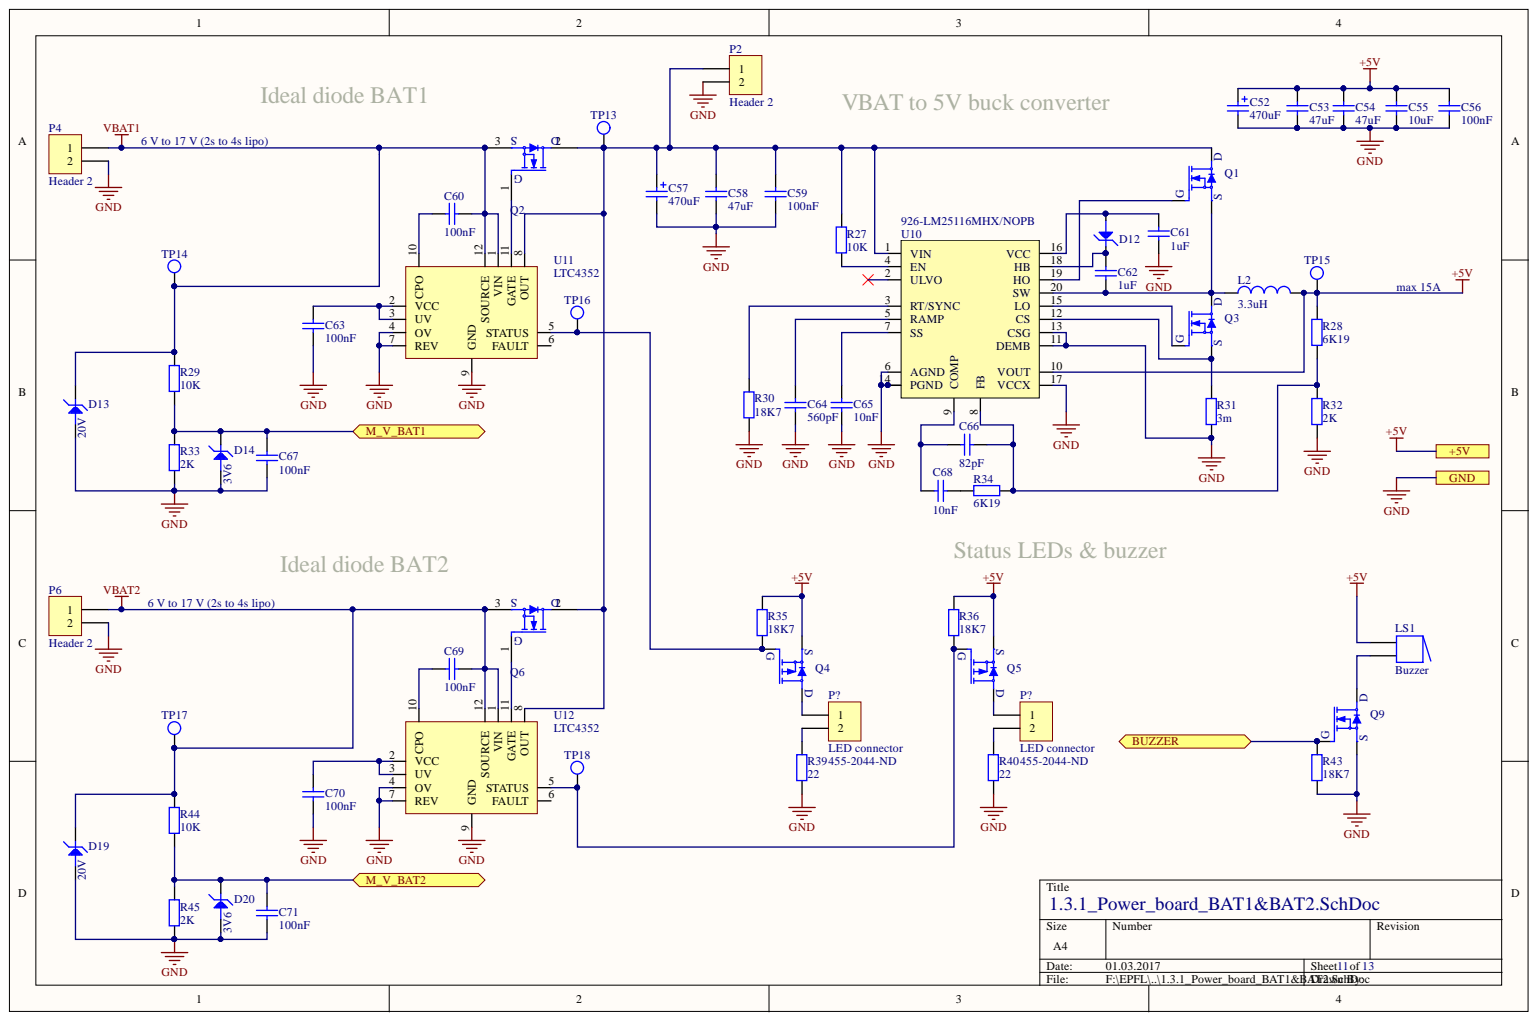
[picture p240: page 11]

VBAT to 5V buck converter

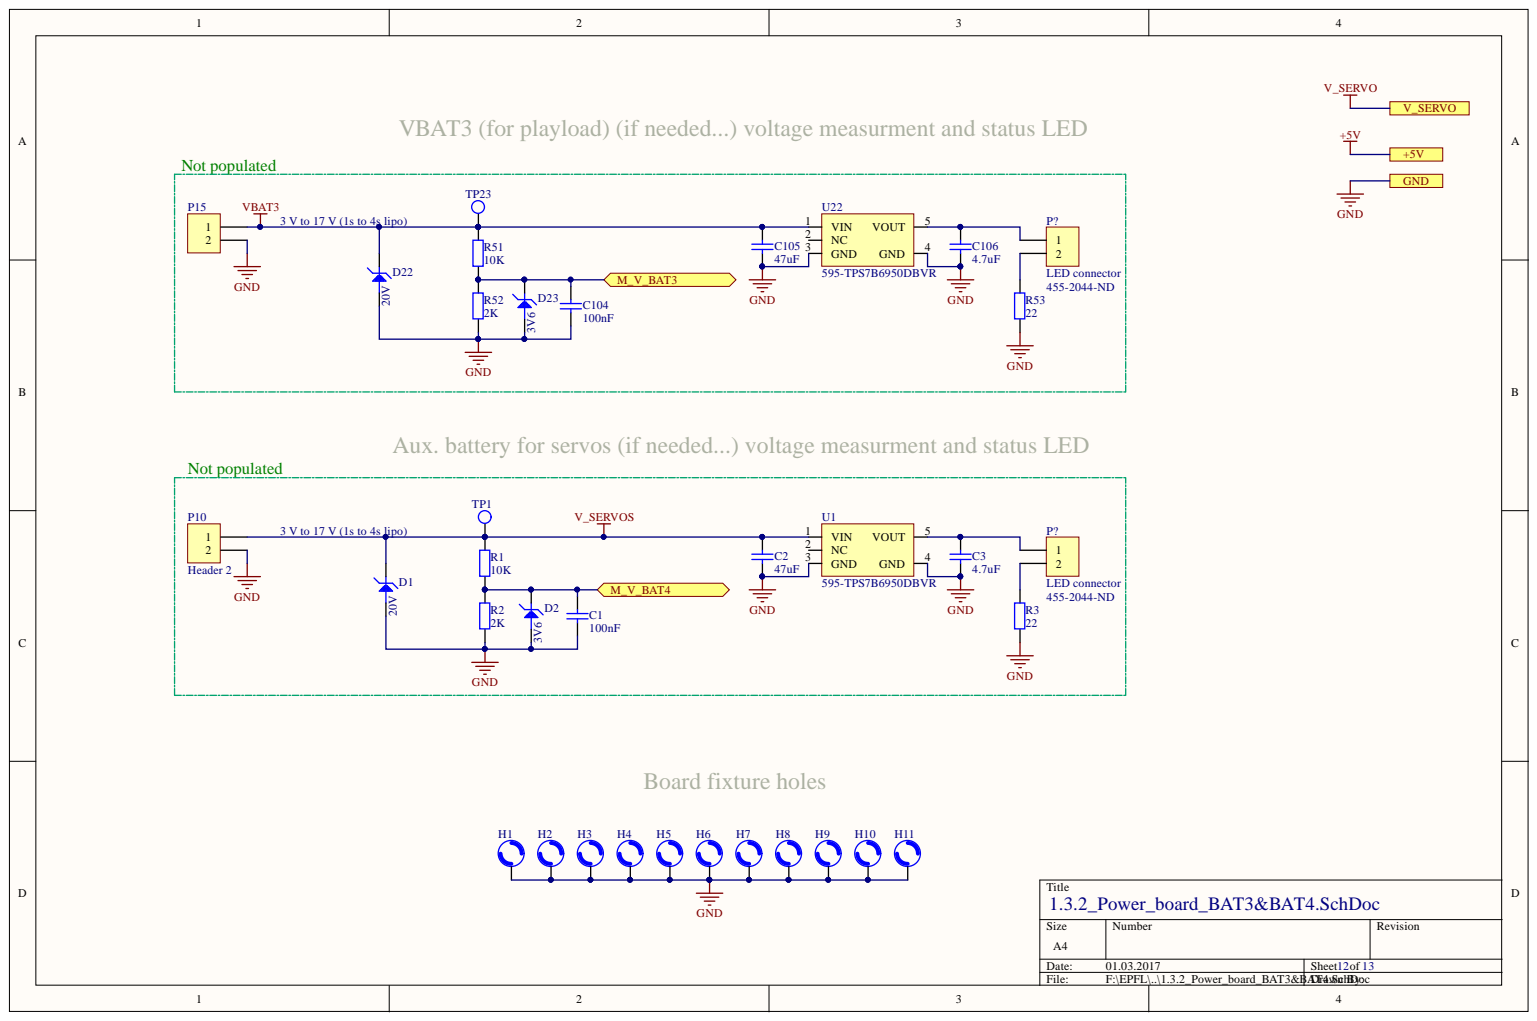
[picture p241: page 12]

VBAT3 (for playload) (if needed...) voltage measurment and status LED

Aux. battery for servos (if needed...) voltage measurment and status LED

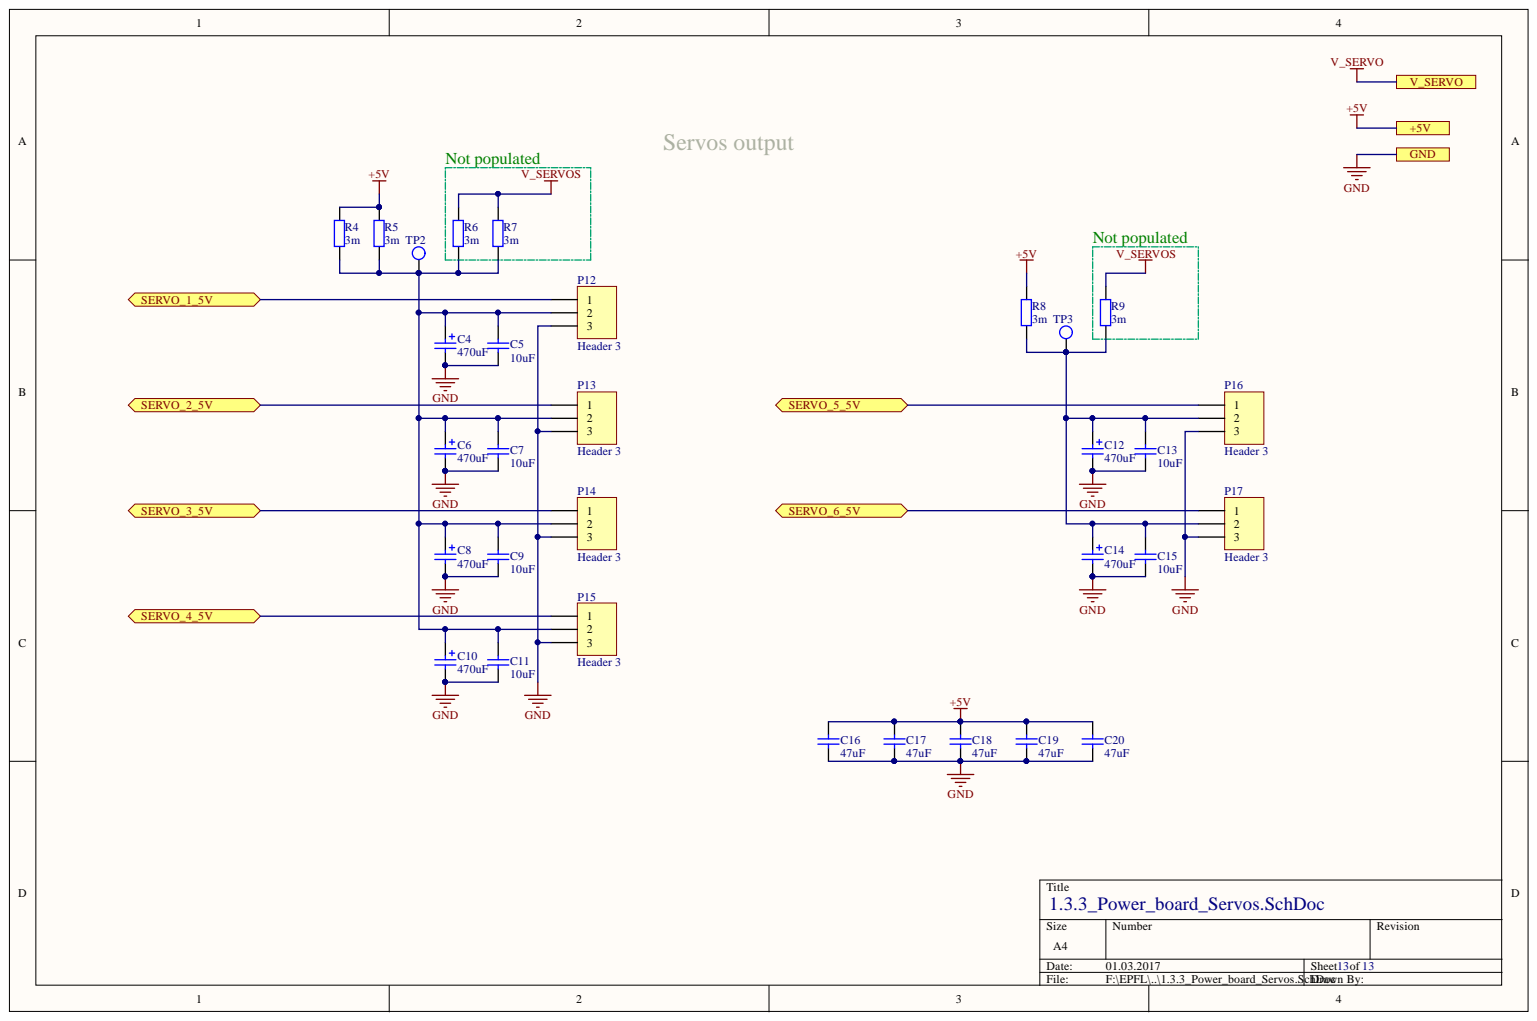
[picture p242: page 13]
