irec-duster/RORO/RORO_2/Body Tube .PDF

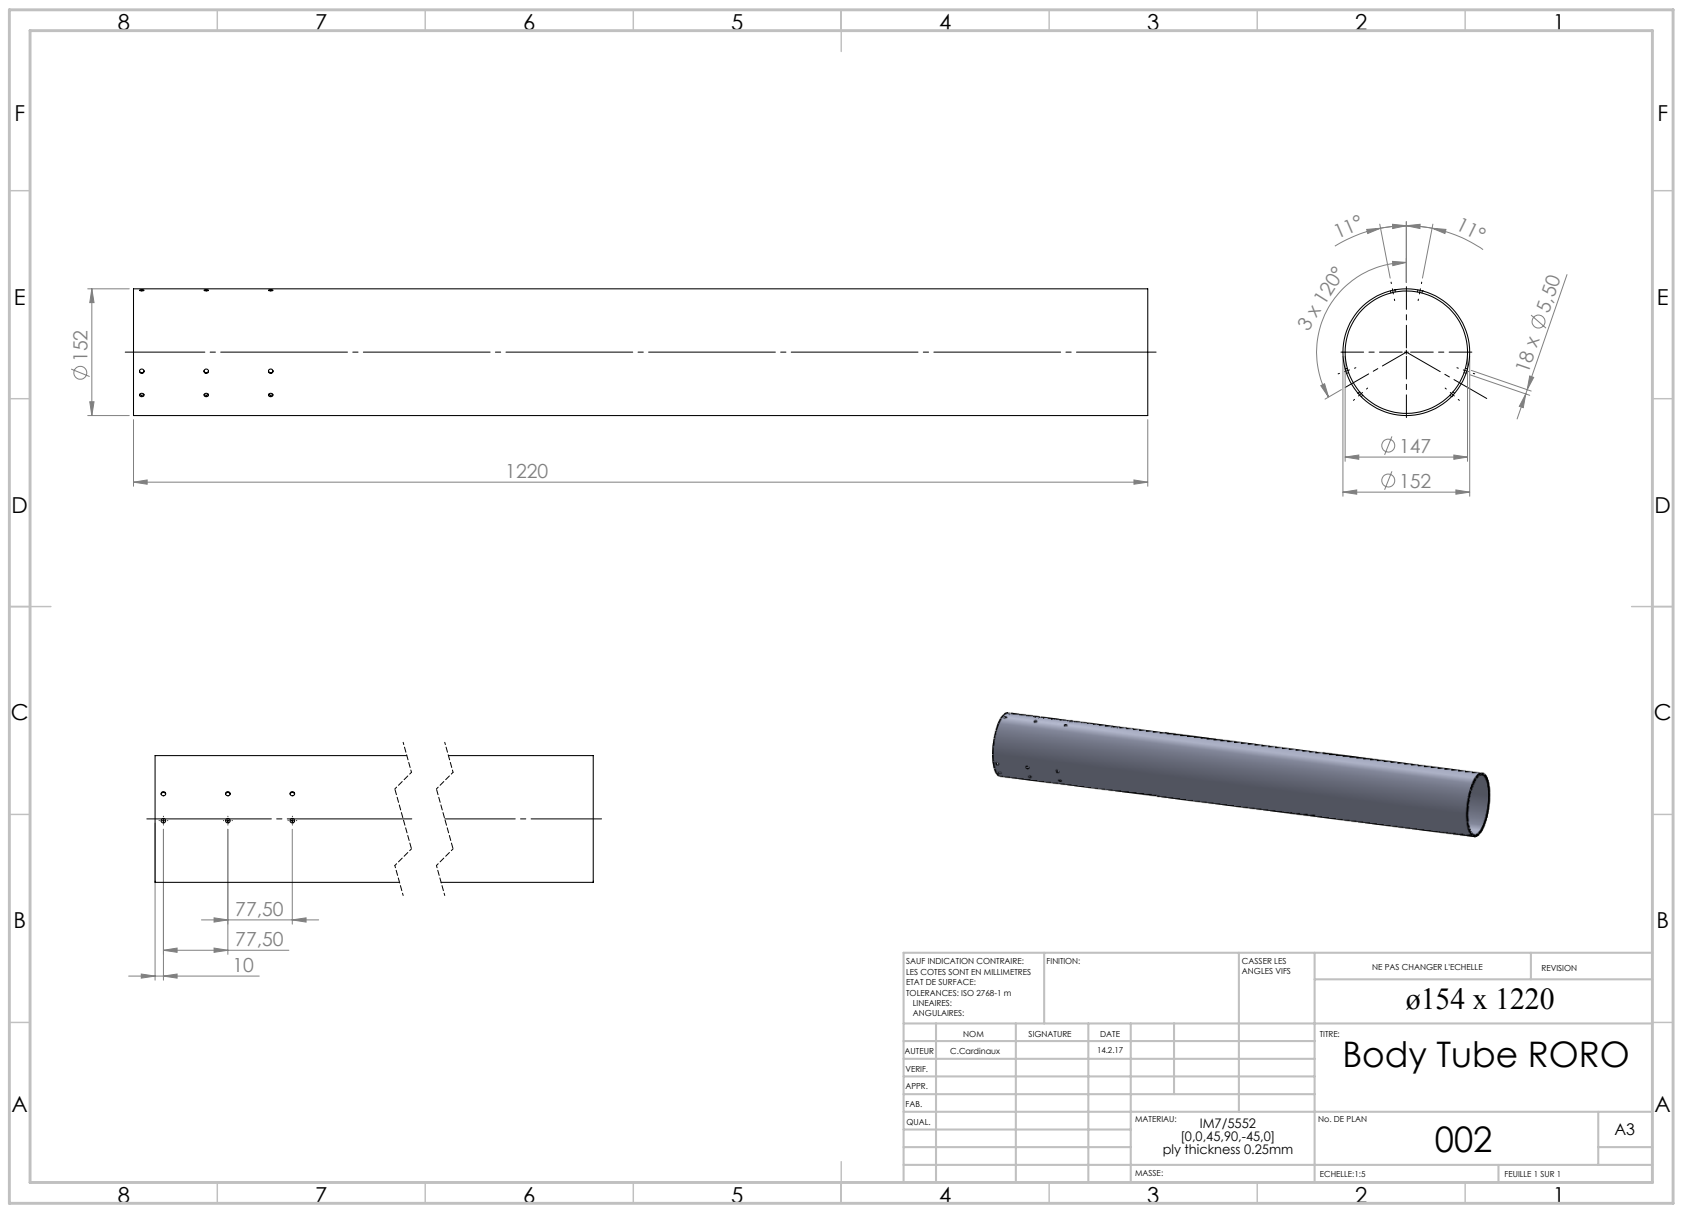
[picture p243: page 1]
FINITION:; CASSER LES; ANGLES VIFS; NE PAS CHANGER L'ECHELLE; REVISION; ECHELLE:1:5; FEUILLE 1 SUR 1

SAUF INDICATION CONTRAIRE:
LES COTES SONT EN MILLIMETRES
ETAT DE SURFACE:
TOLERANCES: ISO 2768-1 m
LINEAIRES:
ANGULAIRES:

NOM | SIGNATURE | DATE | | | | TITRE: Body Tube RORO

AUTEUR | C.Cardinaux | | 14.2.17
VERIF.
APPR.
FAB.
QUAL. | | | | MATERIAU: IM7/5552 [0,0,45,90,-45,0] ply thickness 0.25mm | No. DE PLAN 002 | A3
