irec-duster/RORO/RORO_2/Fin_001.PDF

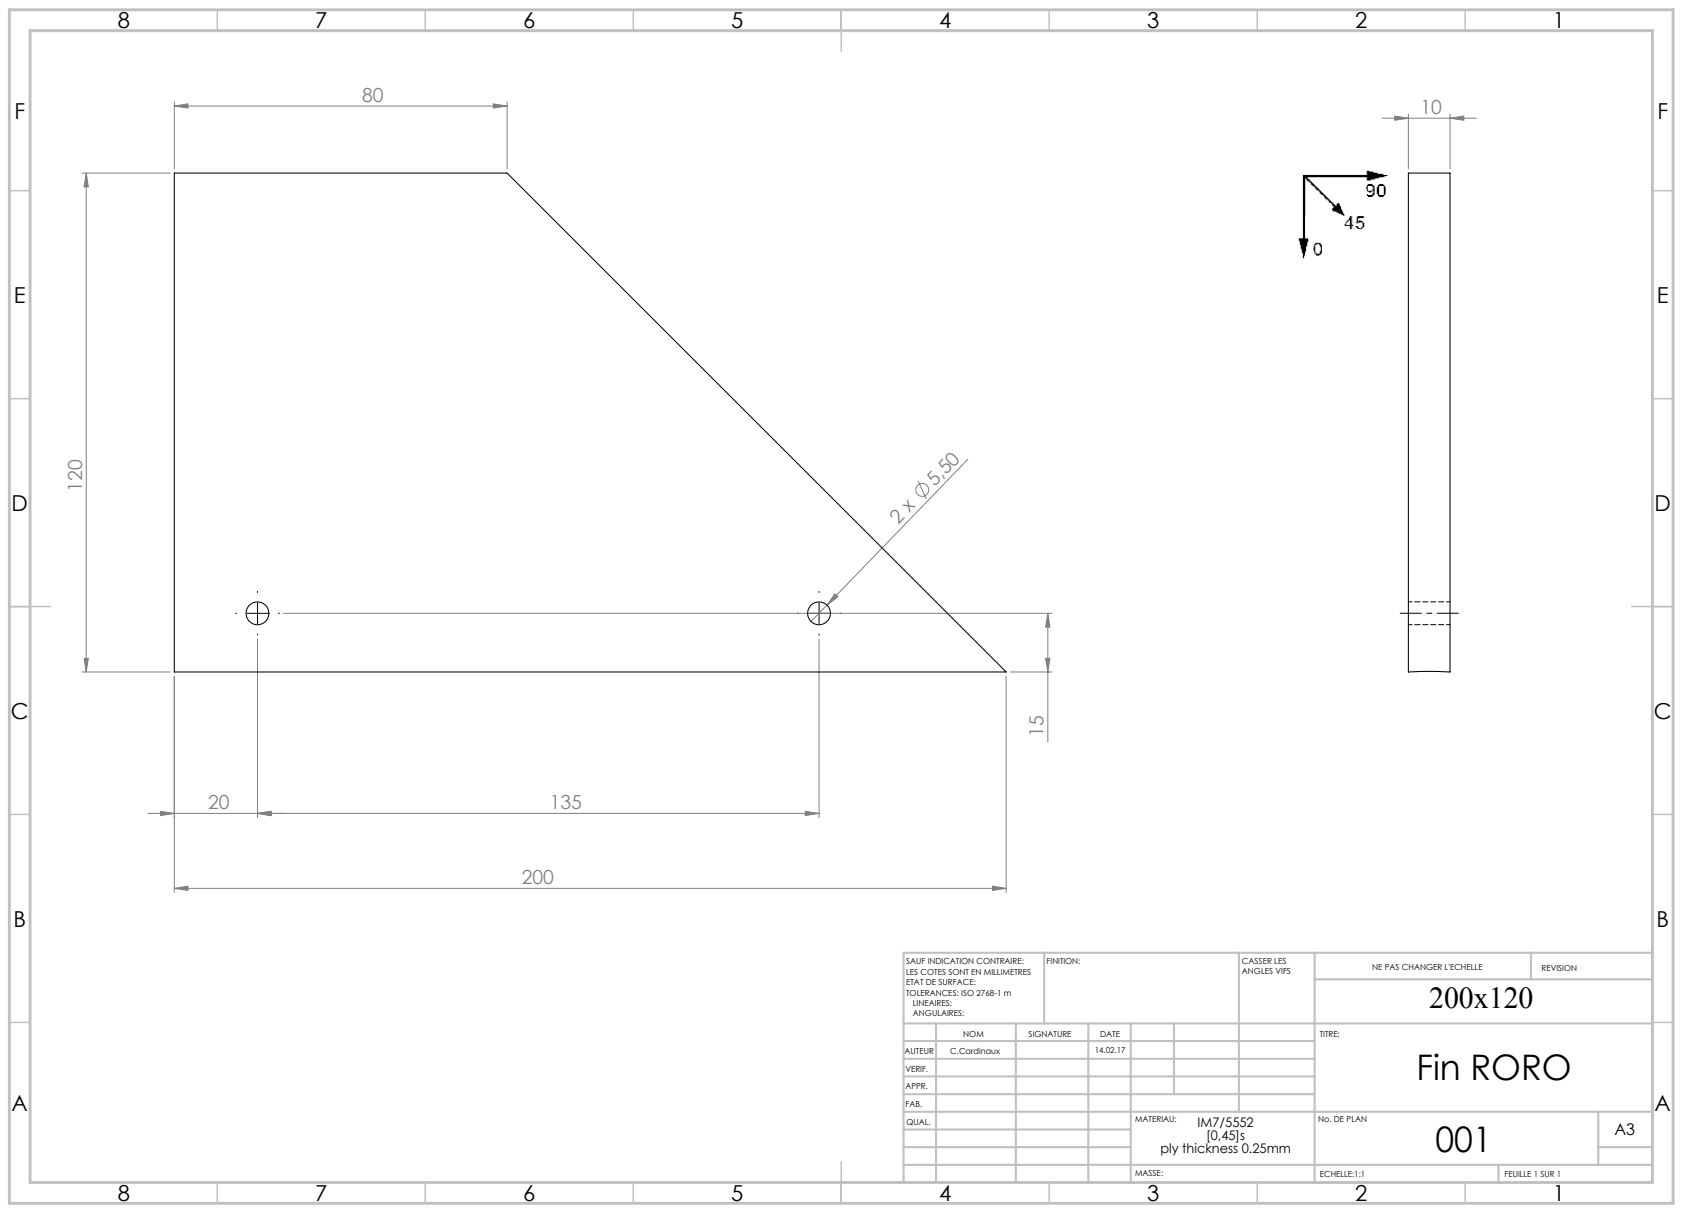
[picture p244: page 1]
FINITION:; CASSER LES; ANGLES VIFS; NE PAS CHANGER L'ECHELLE; REVISION; ECHELLE:1:1; FEUILLE 1 SUR 1

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

NOM | SIGNATURE | DATE | | | | TITRE: Fin RORO

AUTEUR | C.Cardinaux | | 14.02.17
VERIF.
APPR.
FAB.
QUAL. | | | | MATERIAU: [0,45]s ply thickness 0.25mm | No. DE PLAN 001 | A3 IM7/5552
