irec-duster/RORO/payload/for3dprinting/31004_tungsten.pdf

8.40

E E

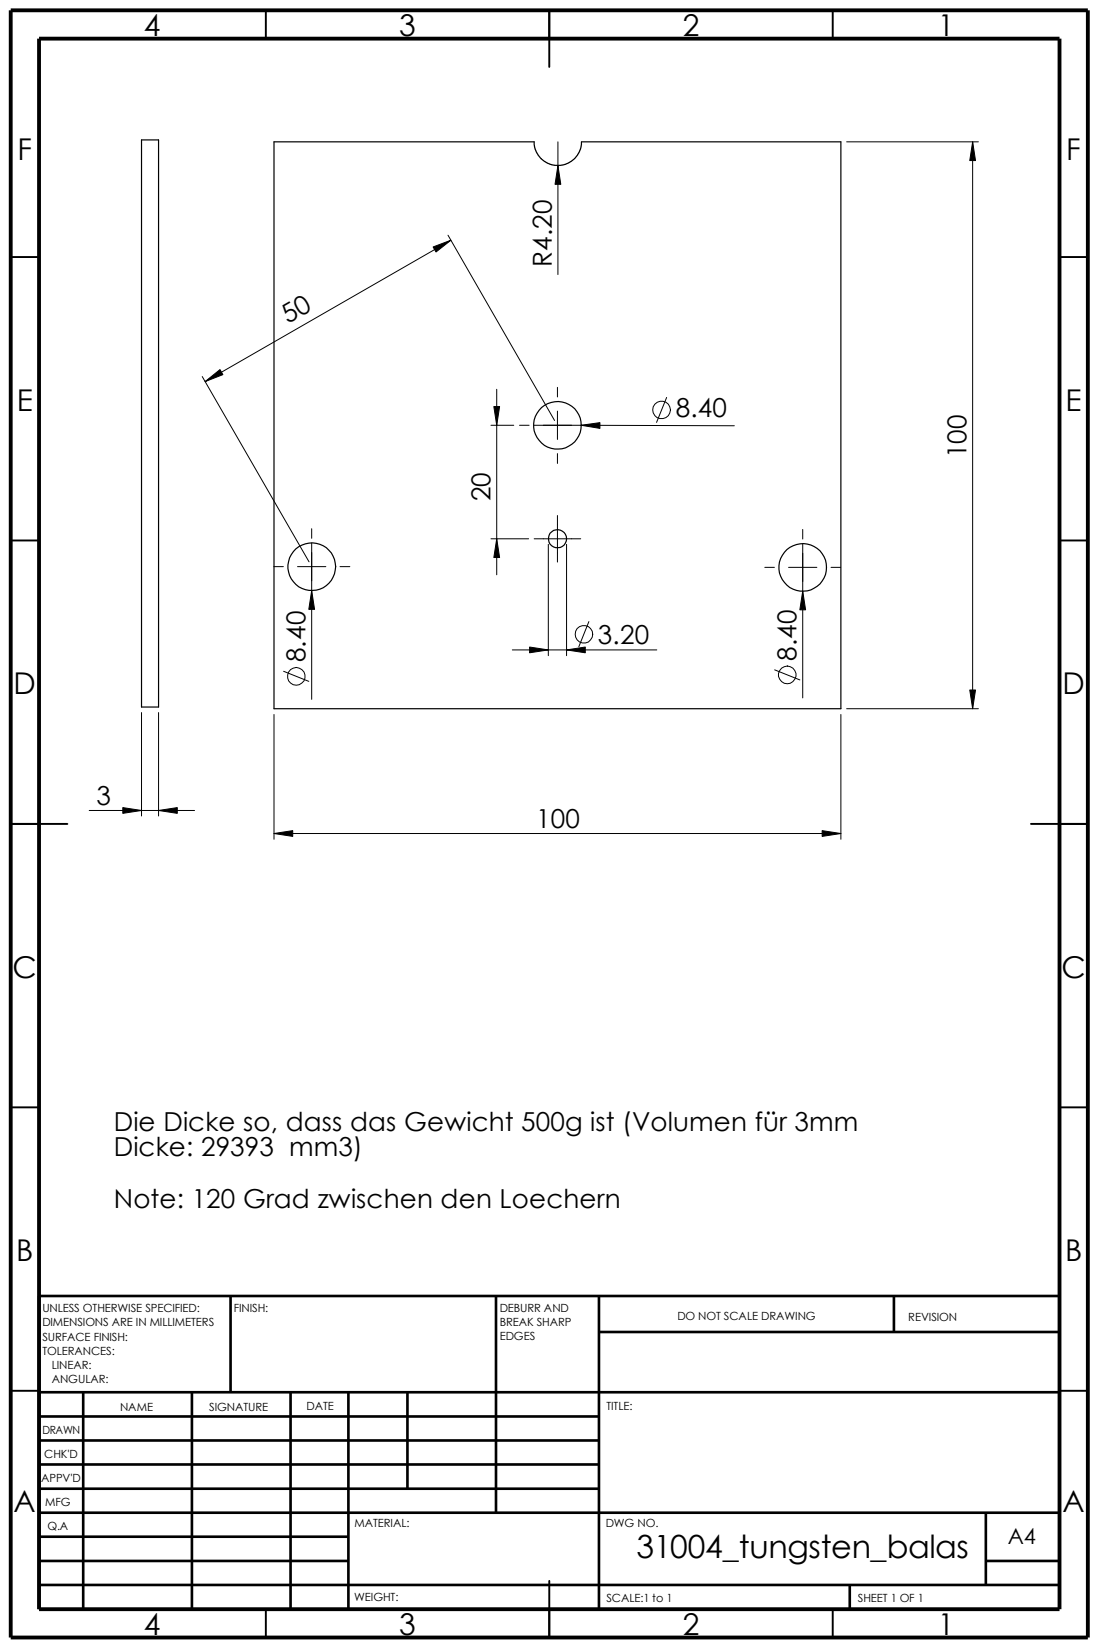
[picture p245: page 1]
WEIGHT:; MFG; SCALE:1 to 1; SHEET 1 OF 1; DWG NO.; FINISH:; EDGES; MATERIAL:; DO NOT SCALE DRAWING; REVISION; DEBURR AND BREAK SHARP; 31004_tungsten_balas

Die Dicke so, dass das Gewicht 500g ist (Volumen für 3mm
Dicke: 29393 mm3)

Note: 120 Grad zwischen den Loechern

UNLESS OTHERWISE SPECIFIED:
DIMENSIONS ARE IN MILLIMETERS
SURFACE FINISH:
TOLERANCES:
LINEAR:
ANGULAR:

NAME | SIGNATURE | DATE | TITLE:

DRAWN

CHK'D

APPV'D
