irec-duster/RORO/payload/forLaserCut/31004_tungsten_balas - Blatt1.pdf

8.40

E E

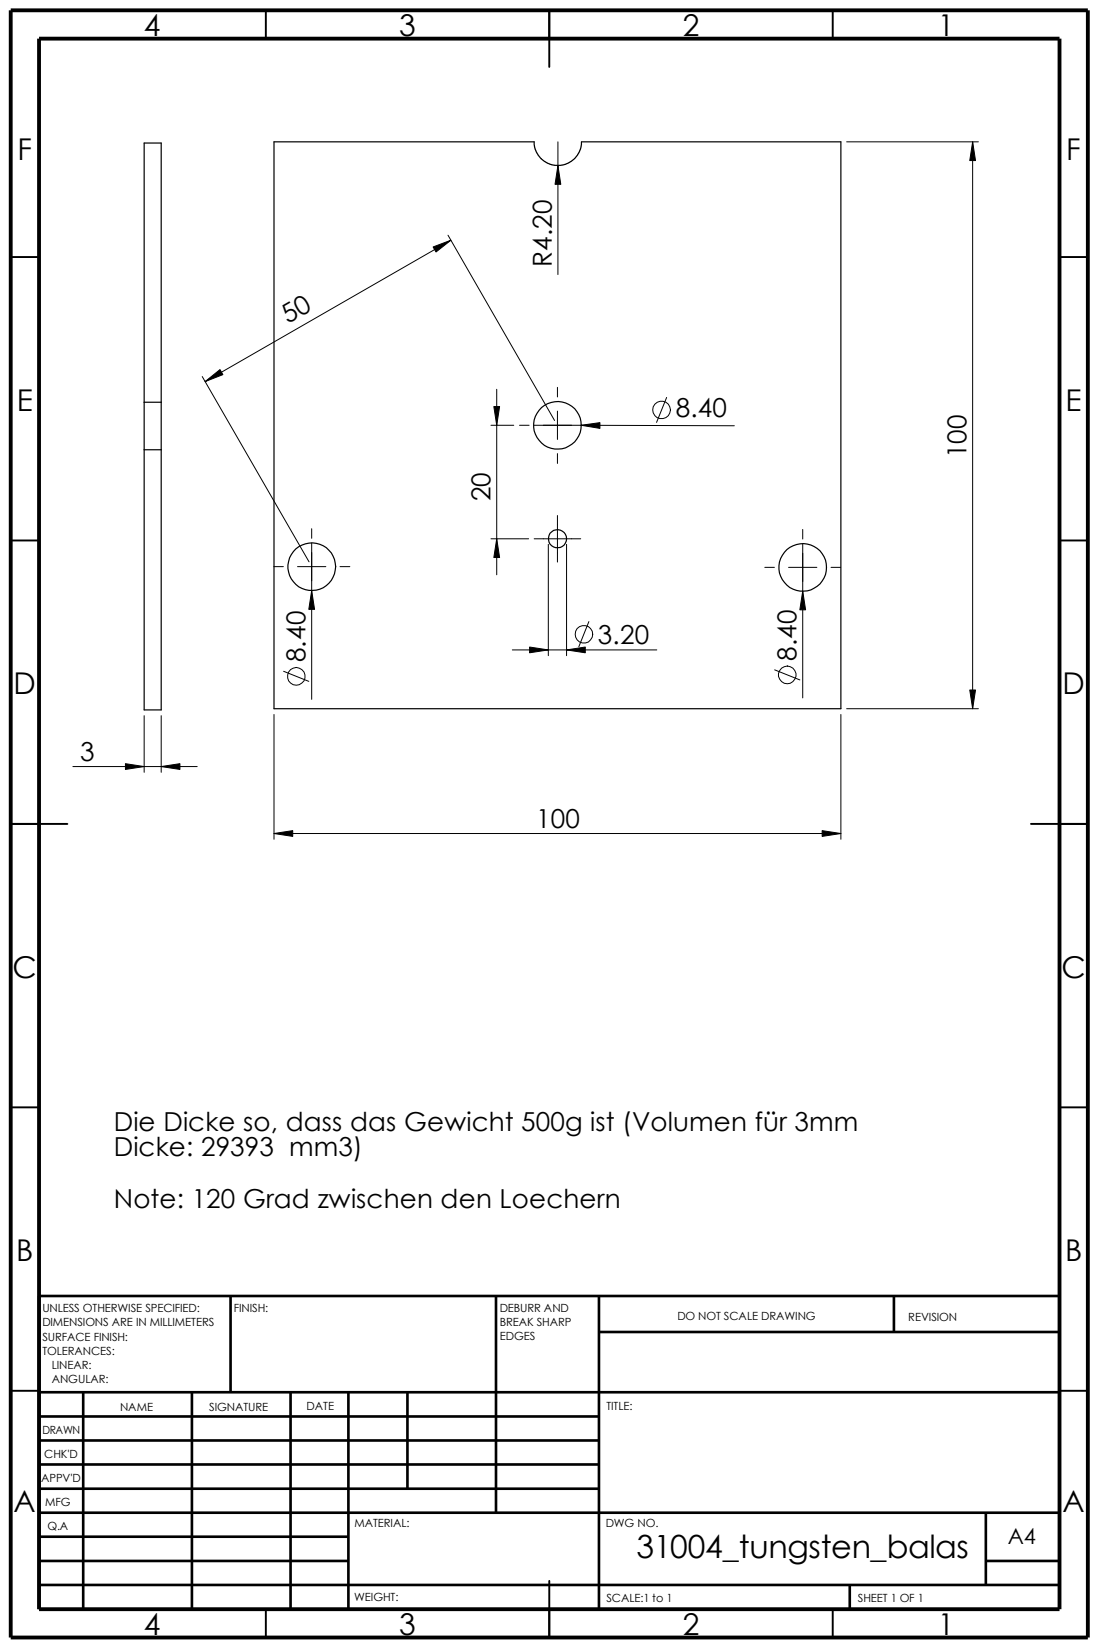
[picture p246: page 1]
DWG NO.; SCALE:1 to 1; SHEET 1 OF 1; WEIGHT:; REVISION; MATERIAL:; MFG; FINISH:; EDGES; DEBURR AND BREAK SHARP; 31004_tungsten_balas

Die Dicke so, dass das Gewicht 500g ist (Volumen für 3mm
Dicke: 29393 mm3)

Note: 120 Grad zwischen den Loechern

UNLESS OTHERWISE SPECIFIED:
DIMENSIONS ARE IN MILLIMETERS
SURFACE FINISH:
TOLERANCES:
LINEAR:
ANGULAR:

DO NOT SCALE DRAWING

NAME | SIGNATURE | DATE | TITLE:

DRAWN

CHK'D

APPV'D
