irec-duster/RORO/Avionics_RORO/CAD/Nosecone/Drawing/3004_Front_GNSS_ant_plane.PDF

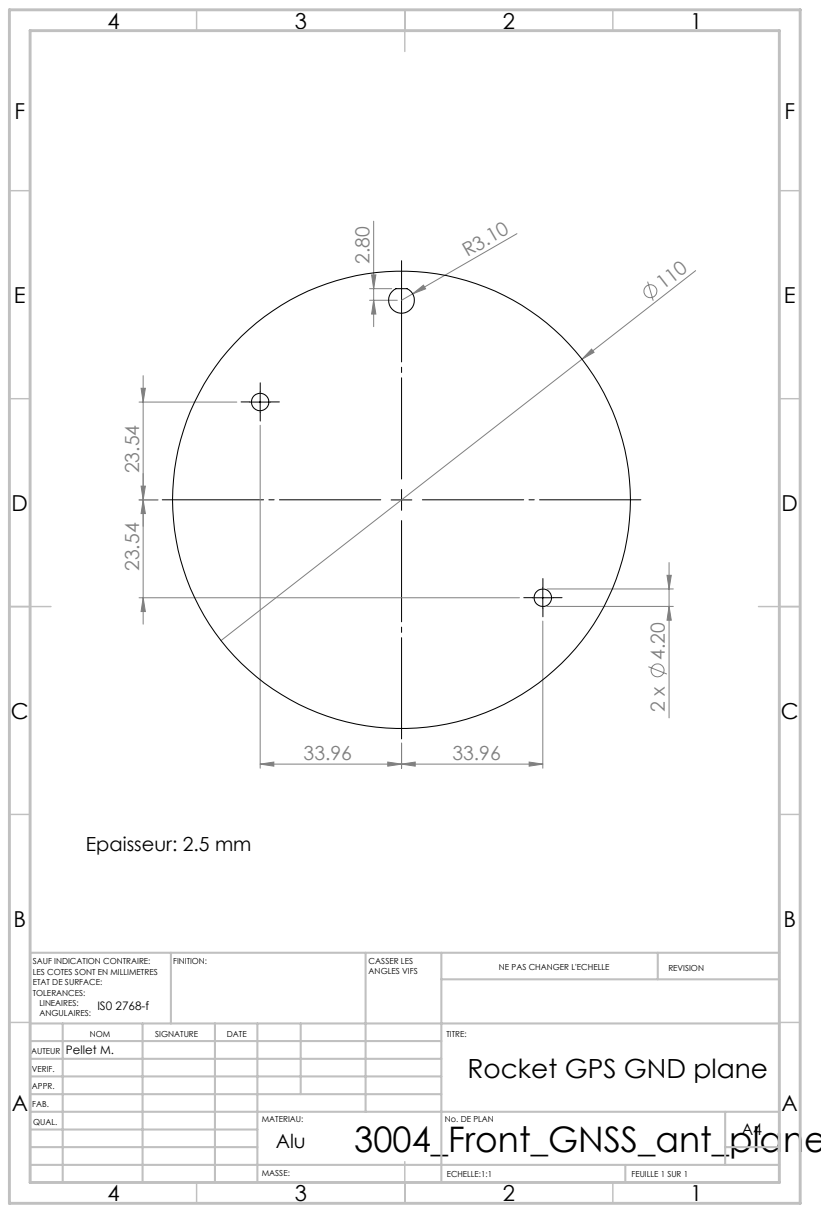
[picture p247: page 1]
Epaisseur: 2.5 mm; FINITION:; CASSER LES; ANGLES VIFS; NE PAS CHANGER L'ECHELLE; REVISION; ECHELLE:1:1; FEUILLE 1 SUR 1

SAUF INDICATION CONTRAIRE:
LES COTES SONT EN MILLIMETRES
ETAT DE SURFACE:
TOLERANCES:
LINEAIRES:
ANGULAIRES:

NOM | SIGNATURE | DATE | | | | TITRE: Rocket GPS GND plane

AUTEUR | Pellet M.

VERIF.
APPR.
FAB.
QUAL. | | | | MATERIAU: Alu | No. DE PLAN | A4
