irec-duster/RORO/Avionics_RORO/Altium/Project/Rocket_PCB_Project_2017/Rocket_PCB_Project_2017_v020217.pdf

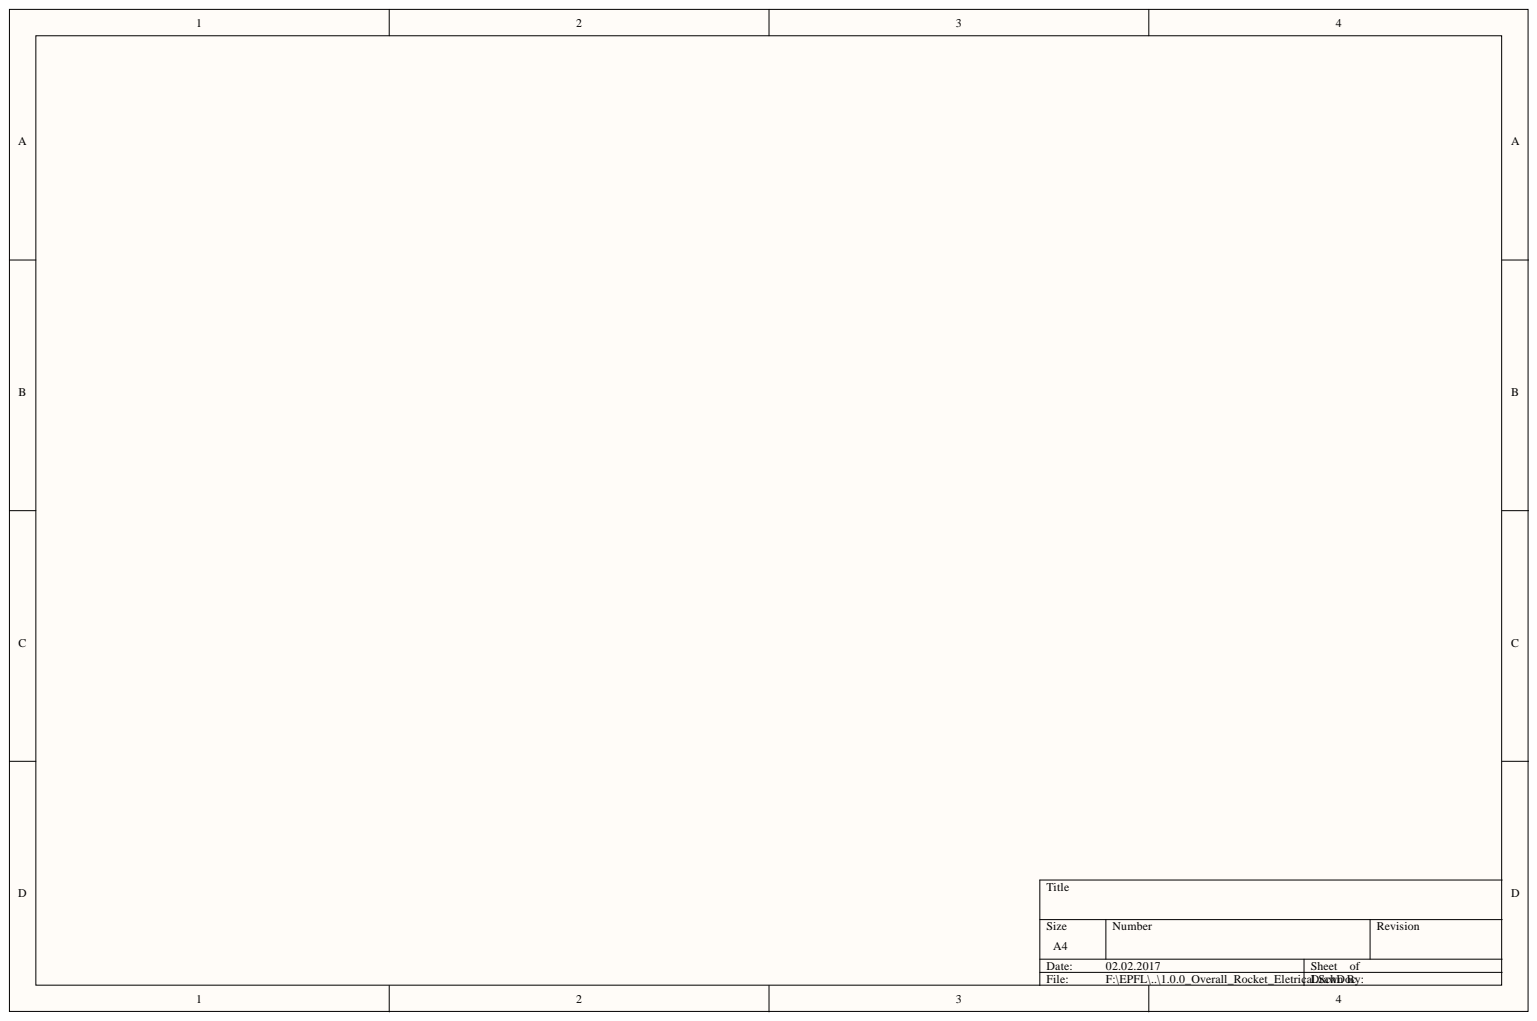
[picture p248: page 1]

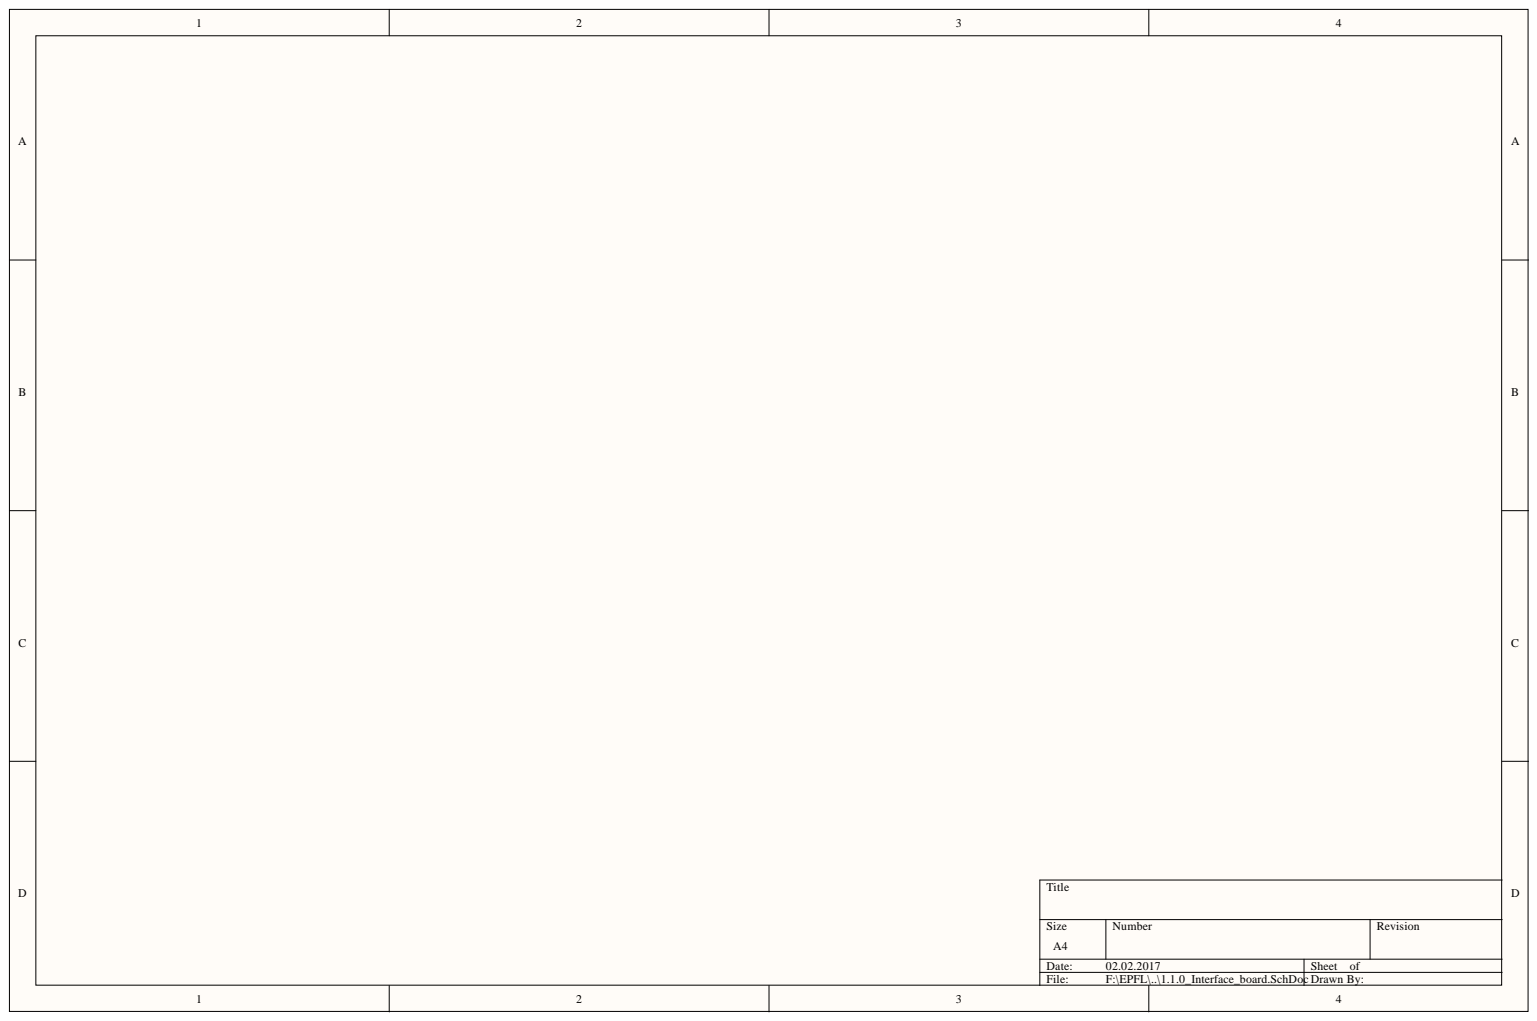
[picture p249: page 2]

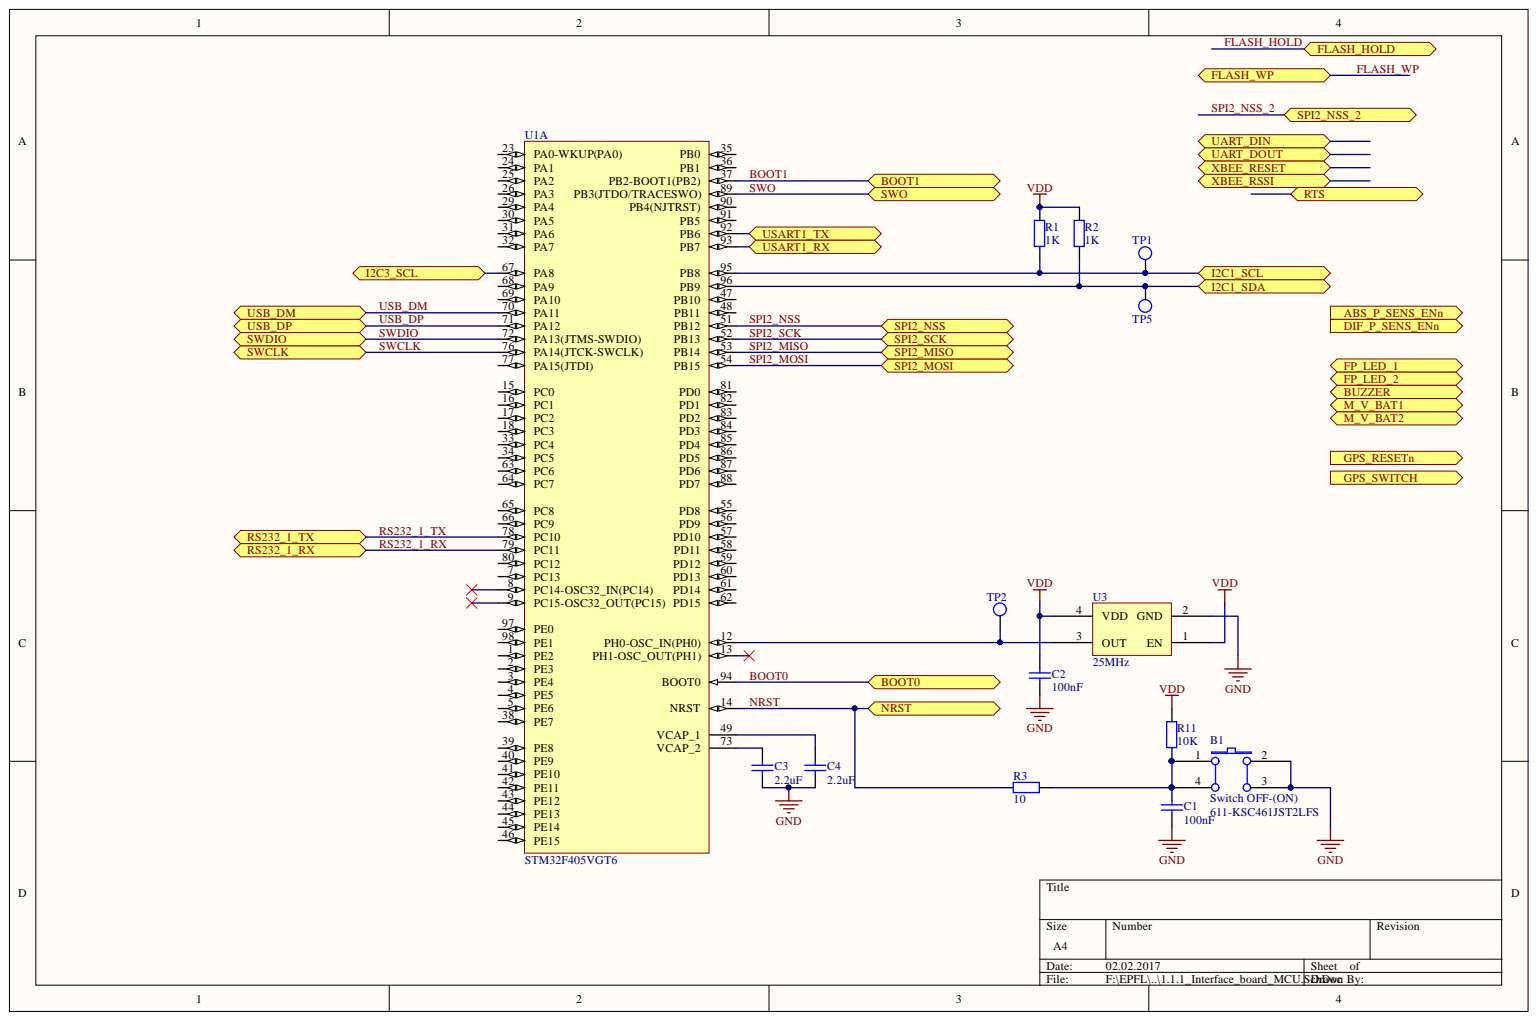
[picture p250: page 3]

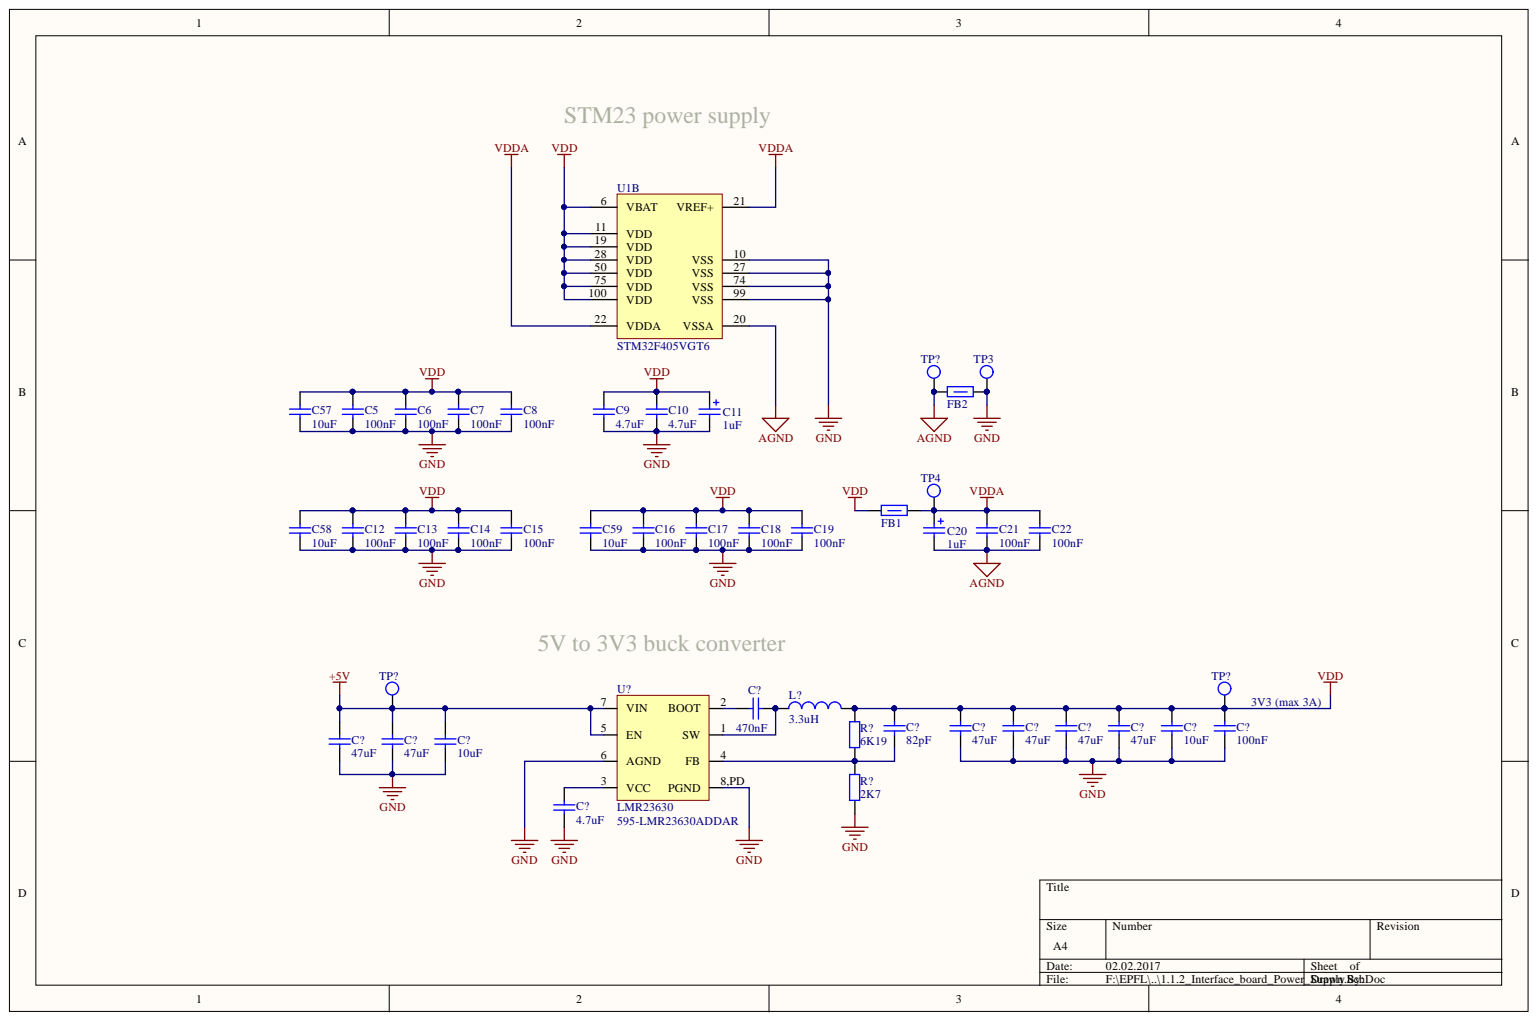
[picture p251: page 4]

VDD 19

VDD 50

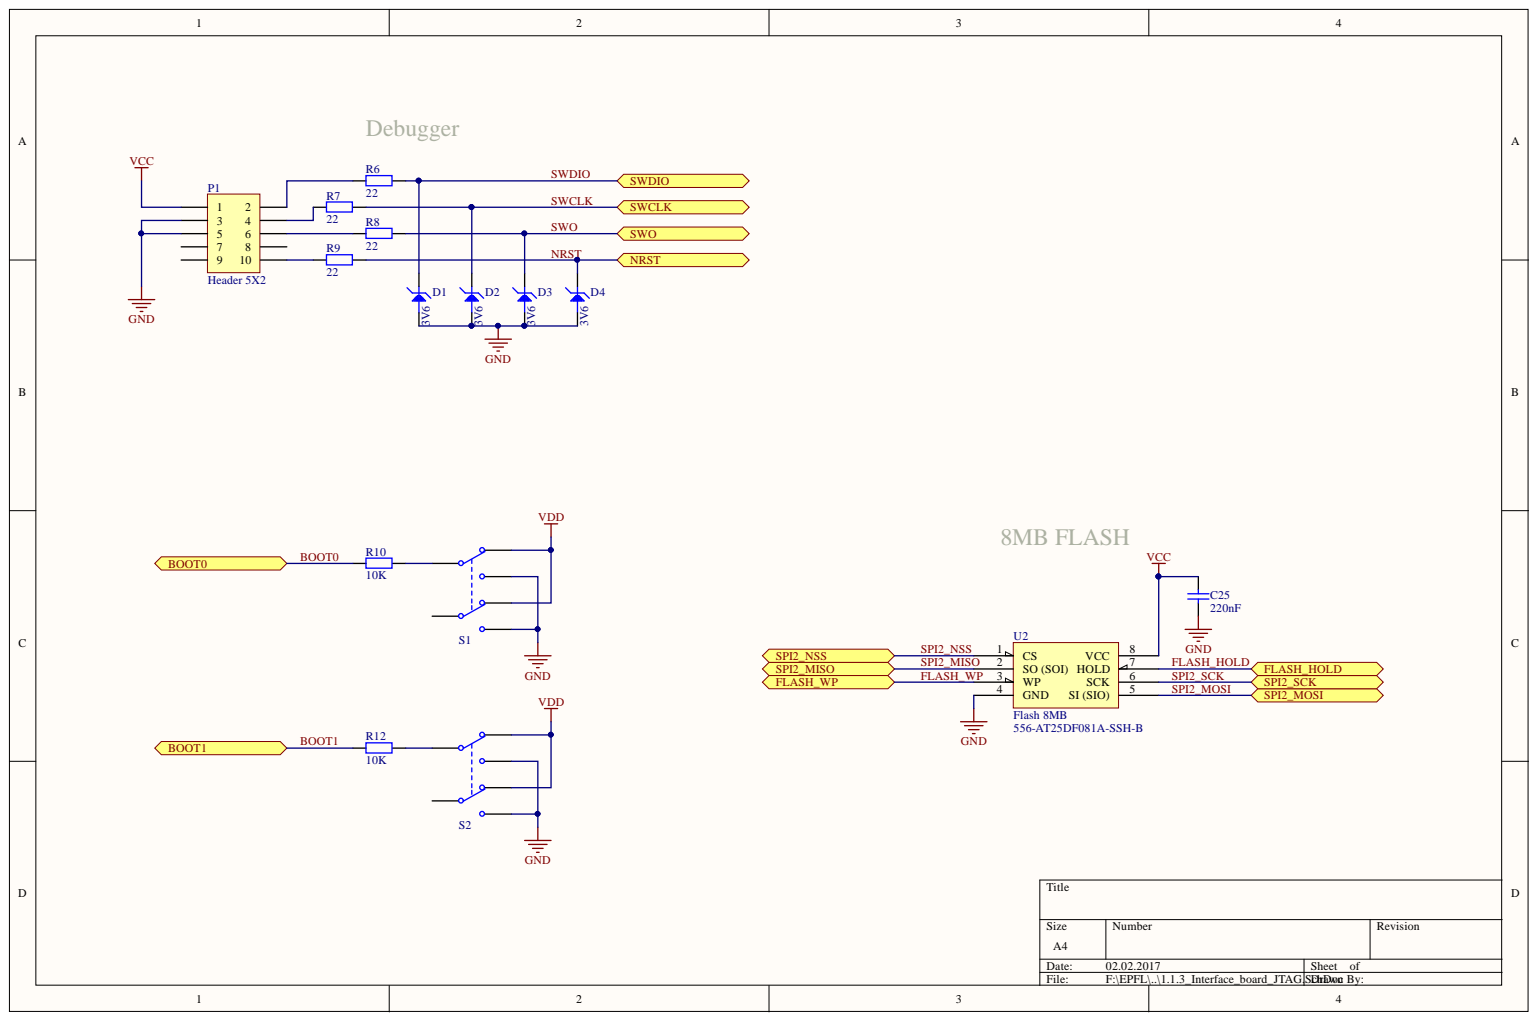
[picture p252: page 5]

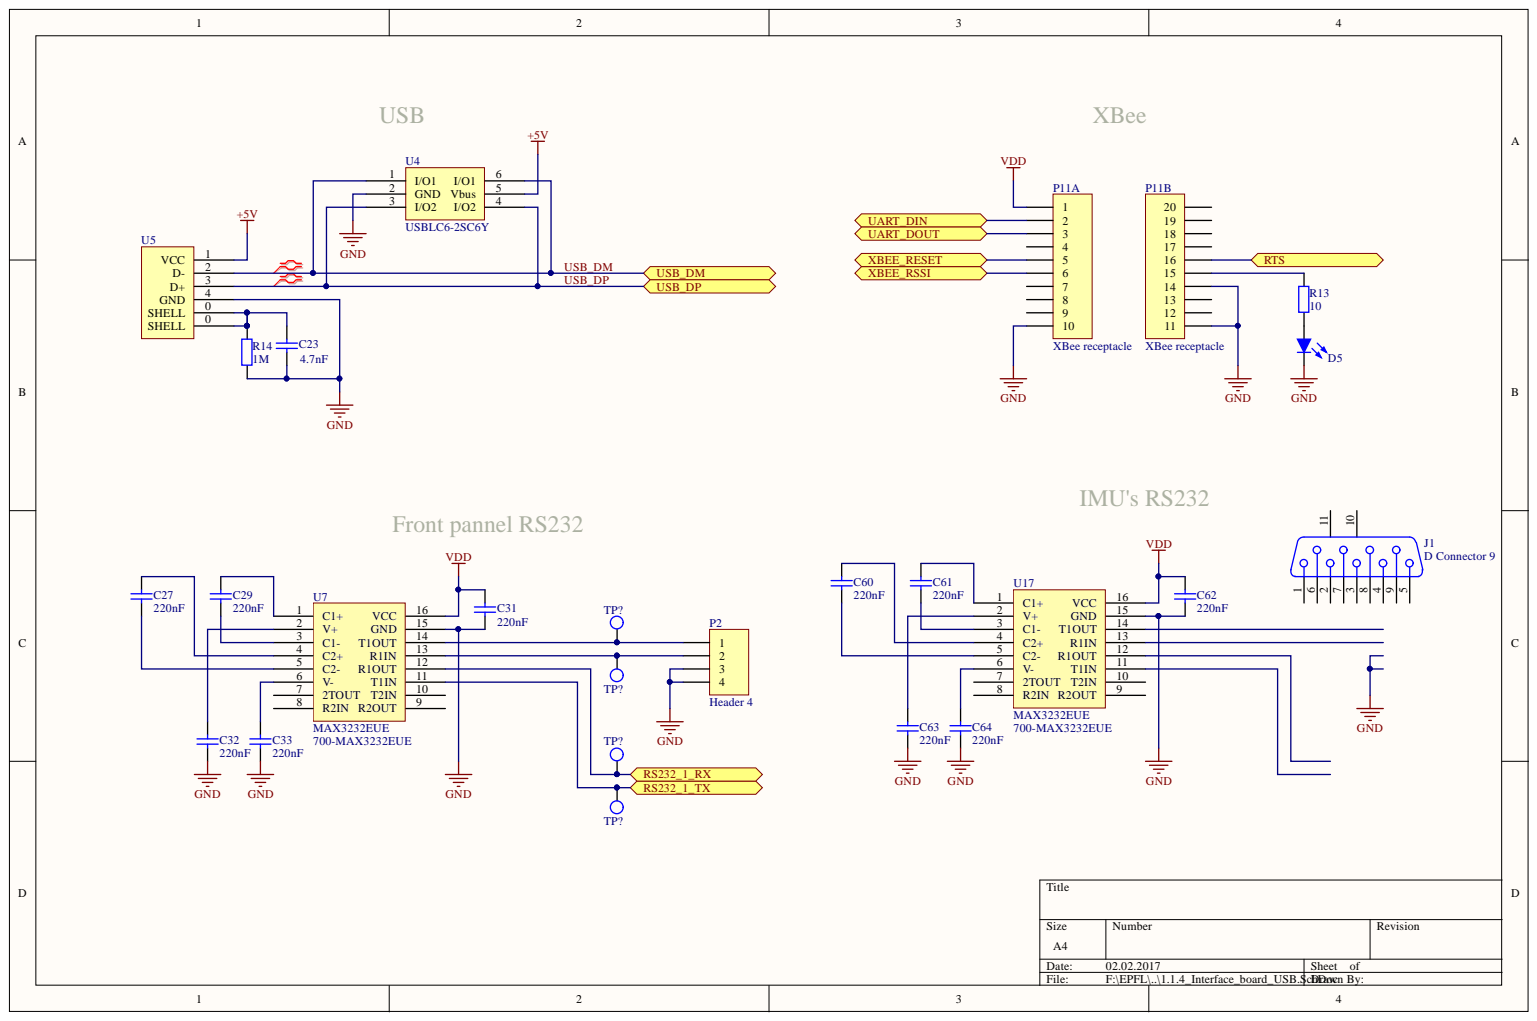
[picture p253: page 6]

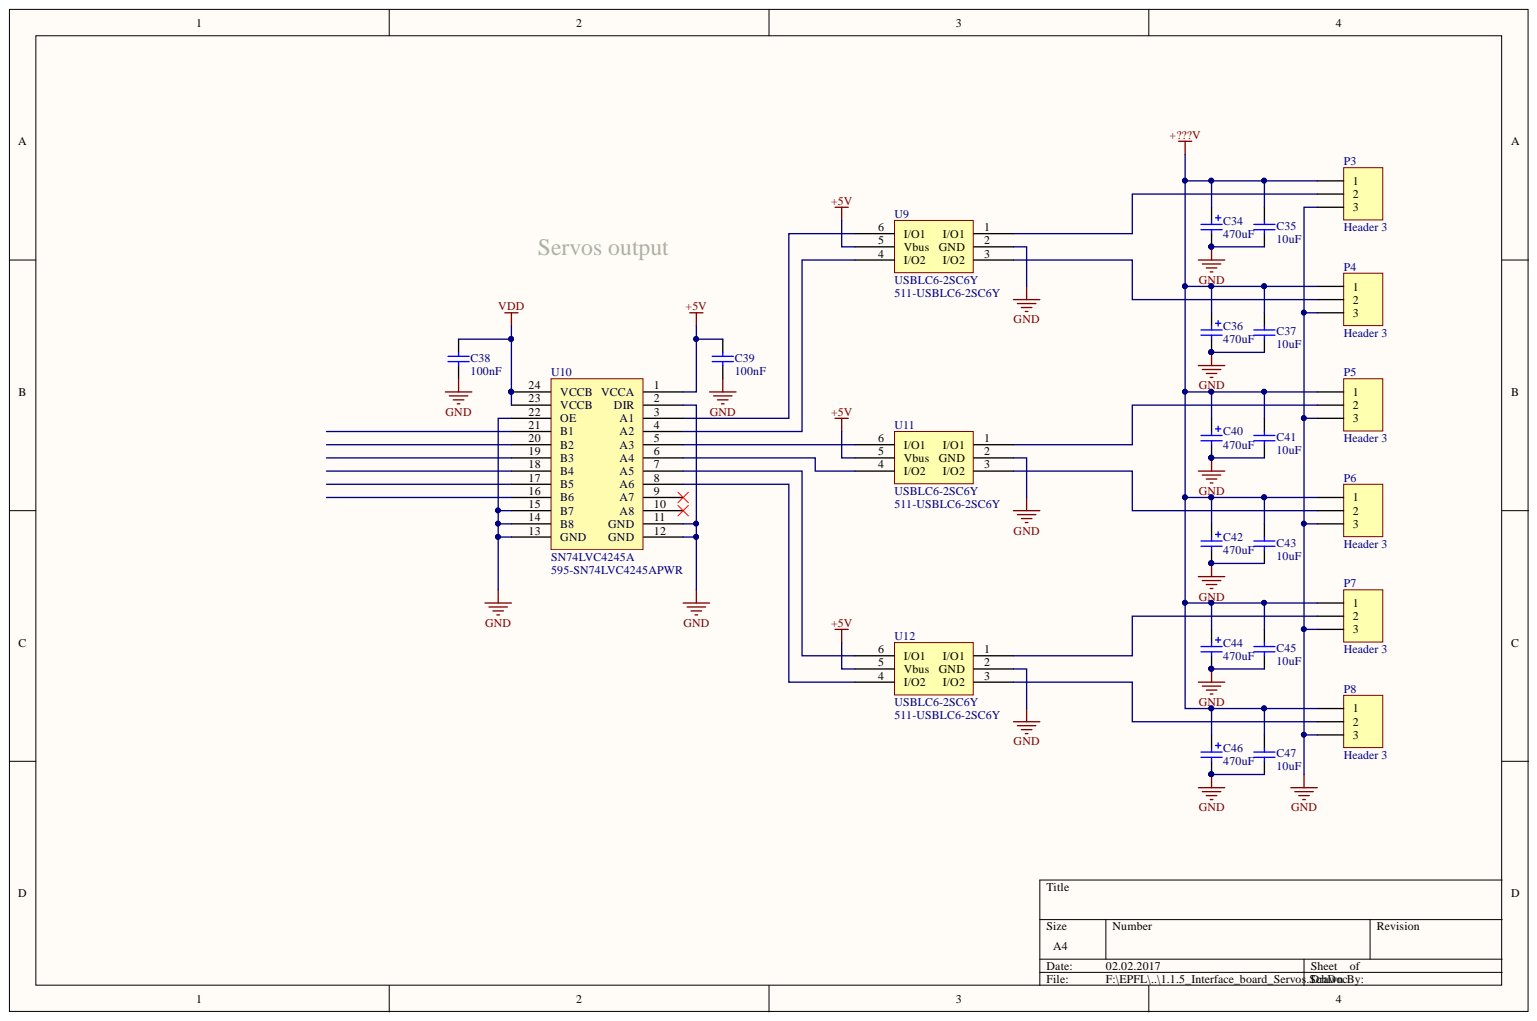
[picture p254: page 7]

8 | | | G N D
9 | D +5 V

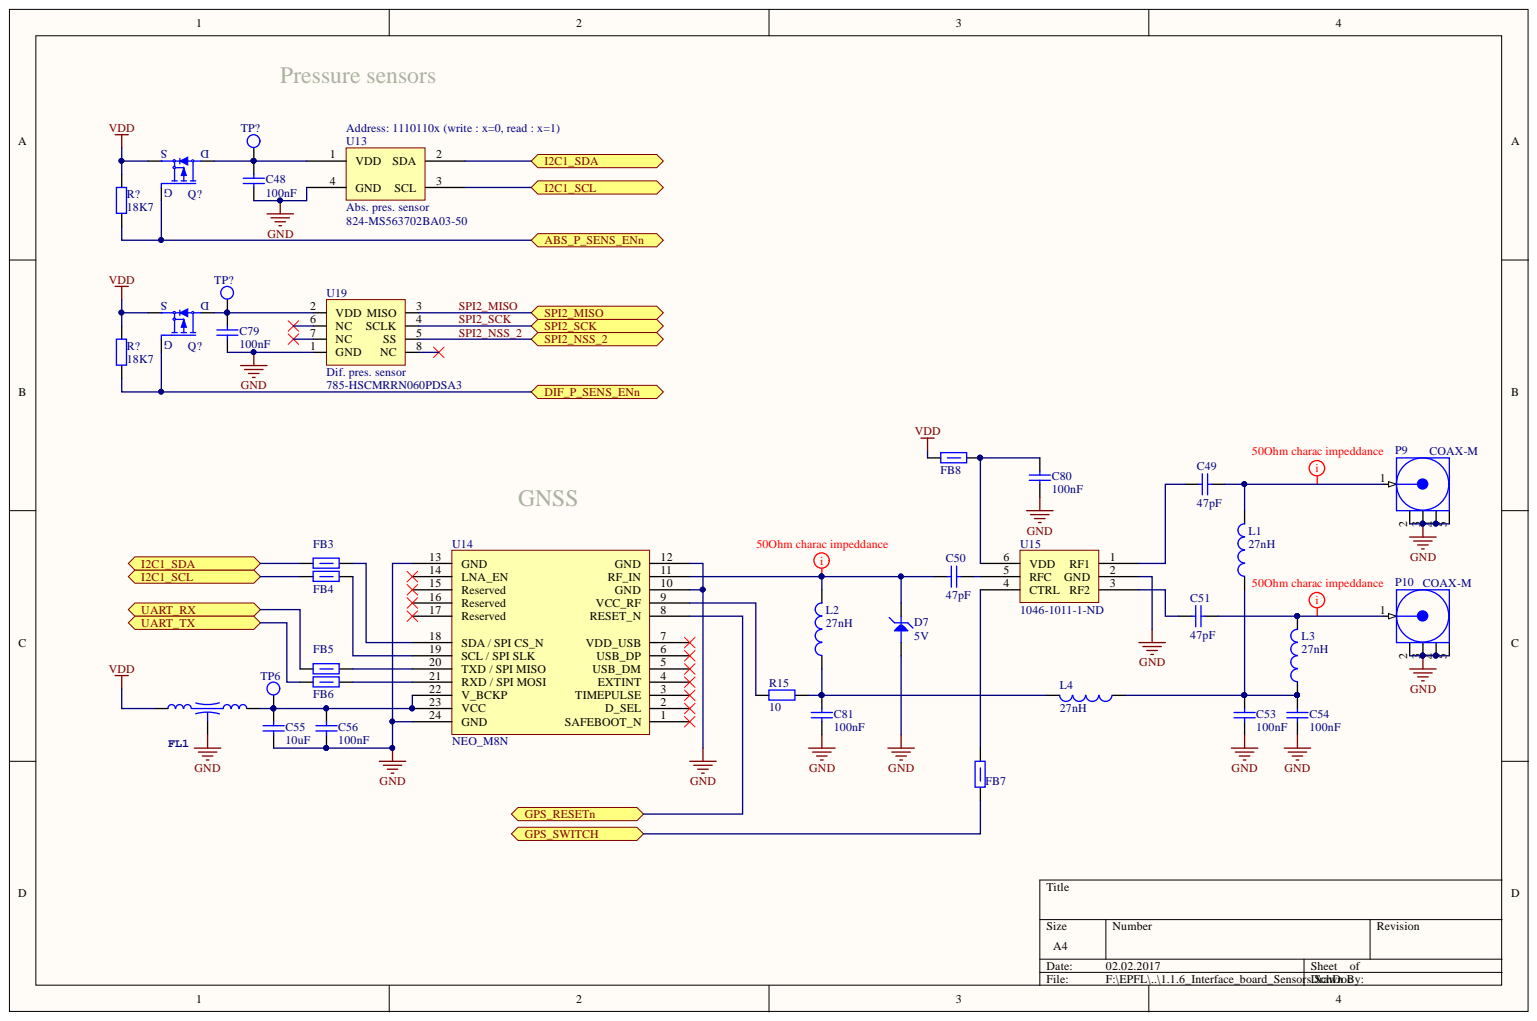
[picture p255: page 8]

SCL / SPI SLK 19
TXD / SPI MISO 20

TP6 | | RXD / SPI MOSI 21

V_BCKP 22
VCC 23 GND 24

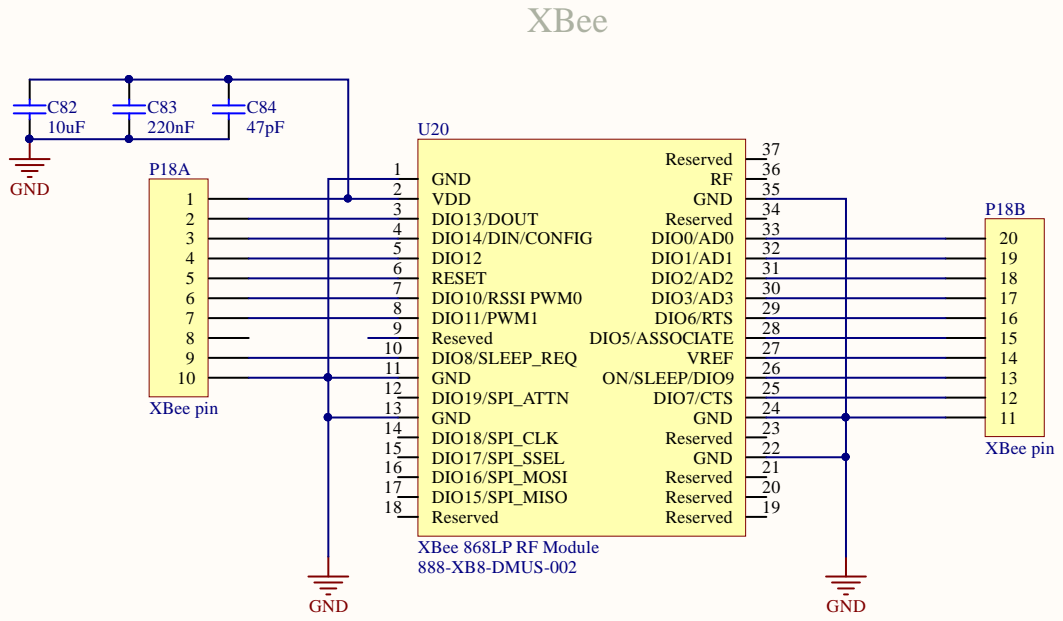
[picture p256: page 9]

5 | 3 2
6 | 3 1
7 | 3 0
8 | 2 9
1 | 9 0 | 2 8

1 | 1 | 2 6
1 1 | 2 | 2 5
1 1 1 1 1 | 4 | 24

5 | 20 Reserved 21 GND 22 Reserved 23 GND 9 Reserved

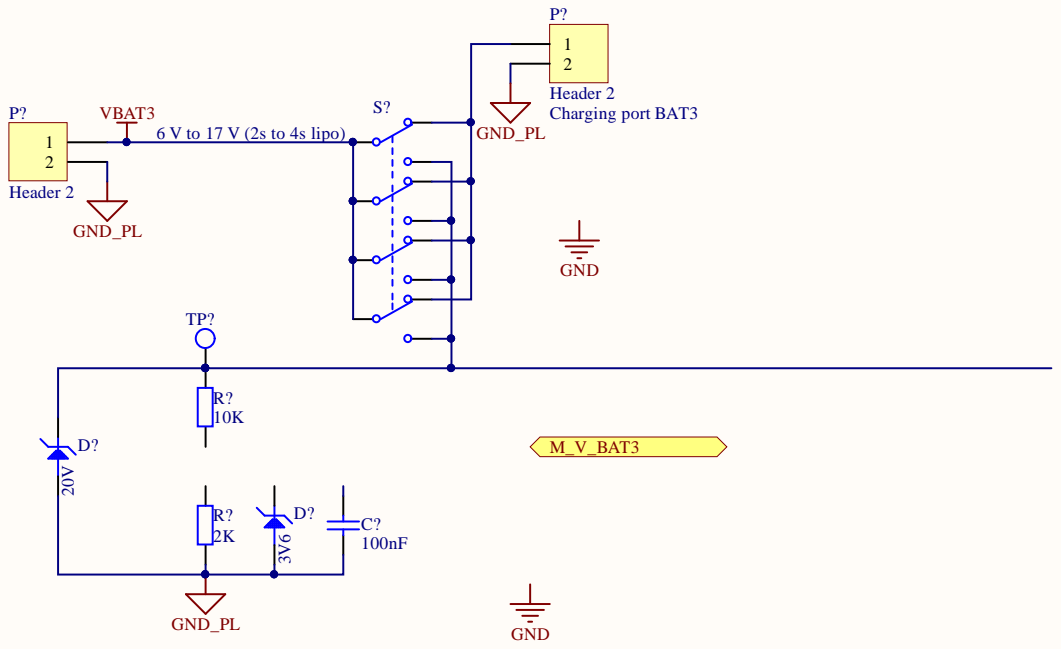
[picture p257: page 10]

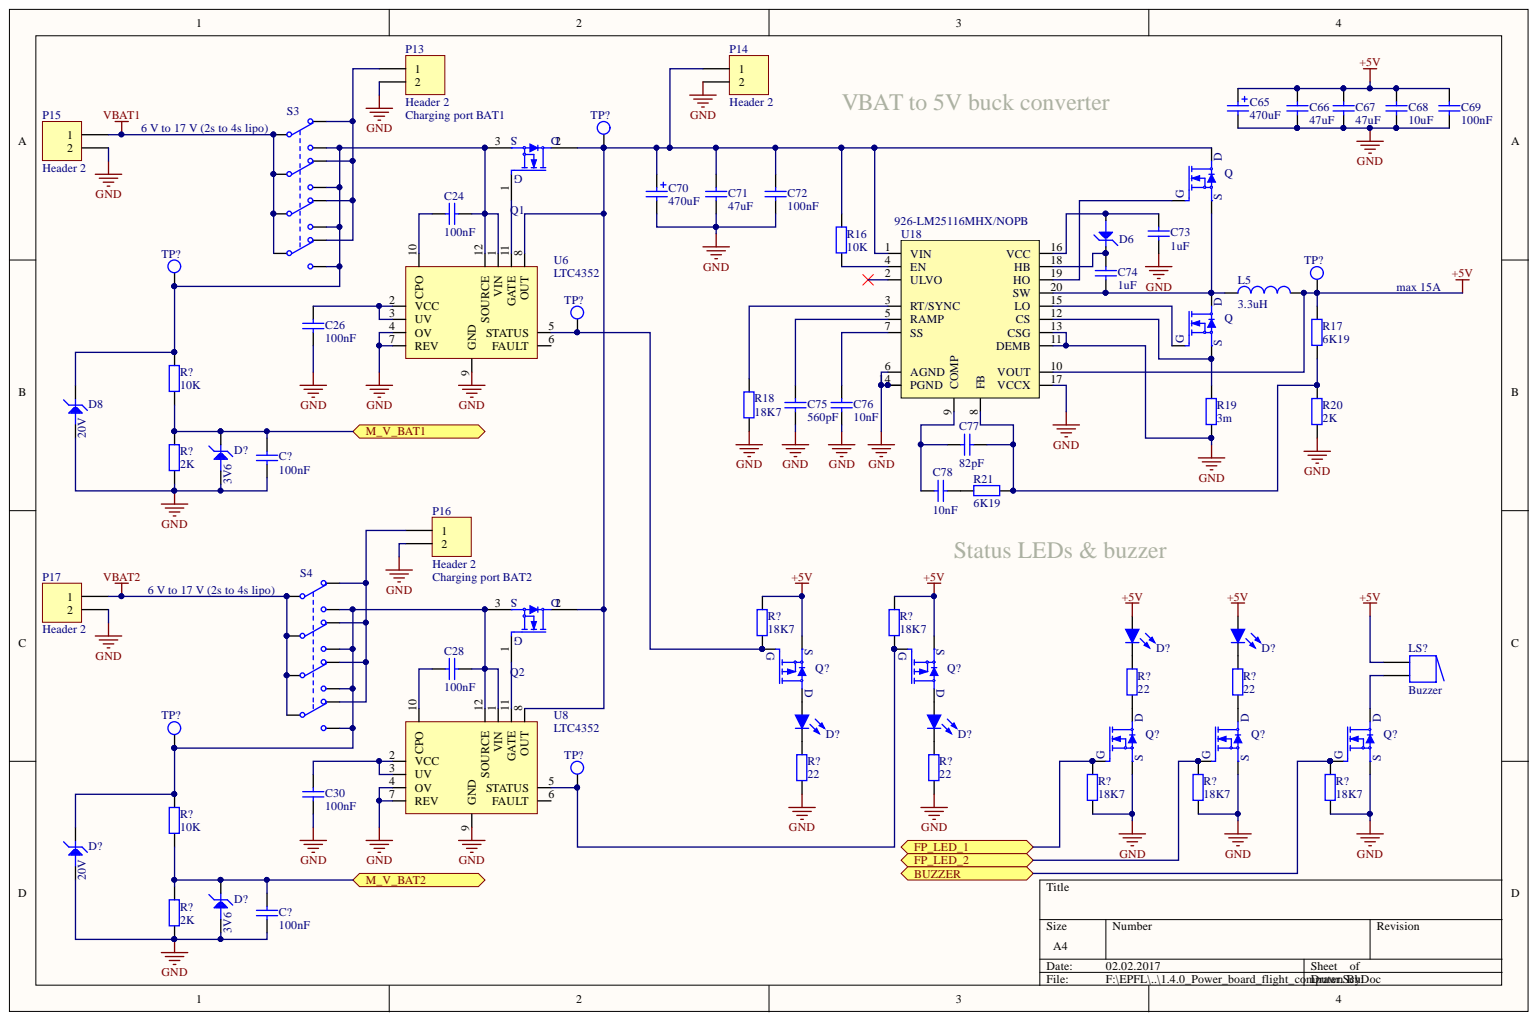
[picture p258: page 11]

VBAT to 5V buck converter

2 0 | 1 u F G N D
1 5
