irec-duster/RORO/Avionics_RORO/Altium/Project/Rocket_PCB_Project_2017/Rocket_PCB_Project_2017_v090217.pdf

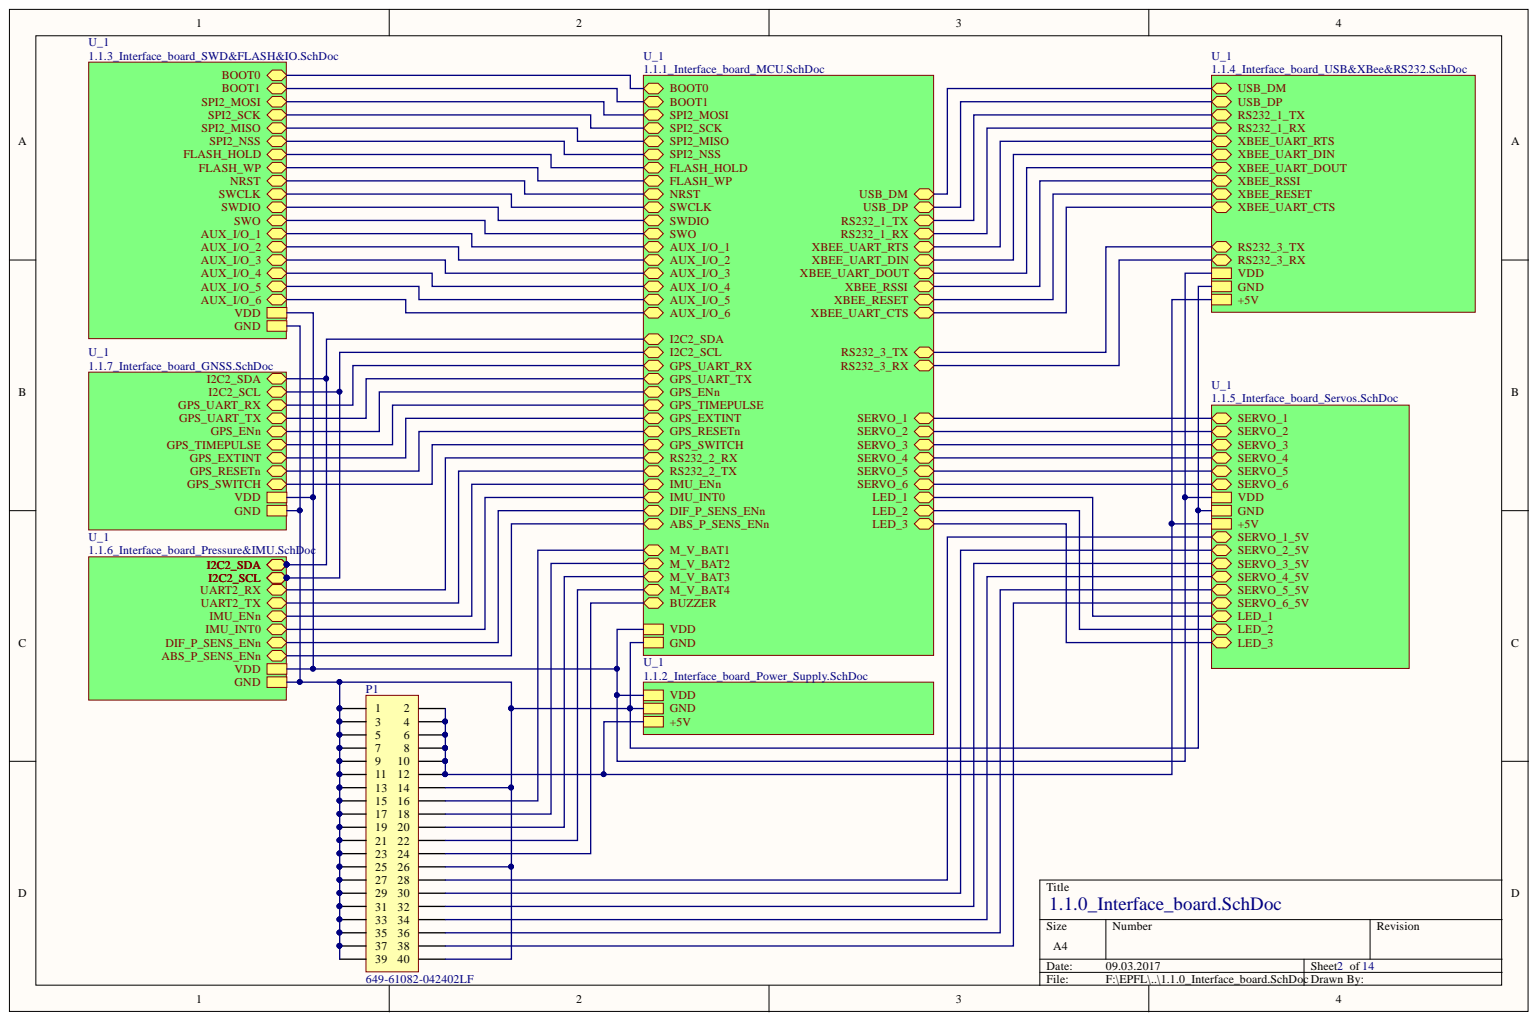
[picture p271: page 2]

DIF_P_SENS_ENn LED_2
ABS_P_SENS_ENn LED_3

M_V_BAT1
M_V_BAT2
M_V_BAT3
M_V_BAT4
BUZZER

U_1 1.1.2_Interface_board_Power_Supply.SchDoc

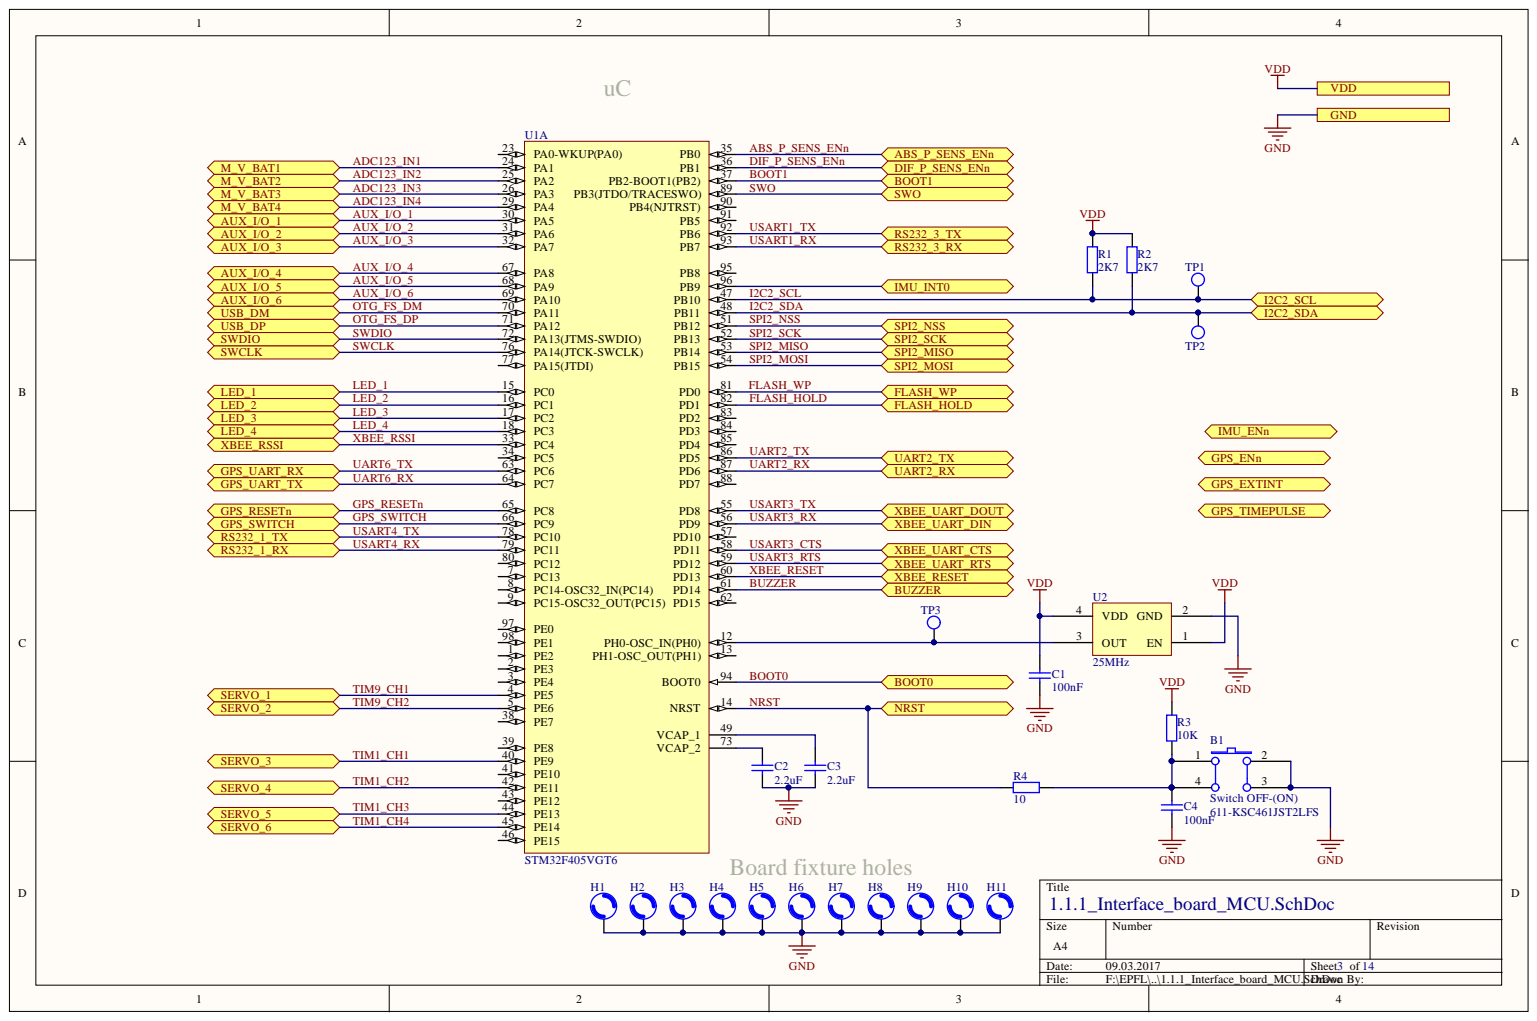
[picture p272: page 3]

4 9
7 3

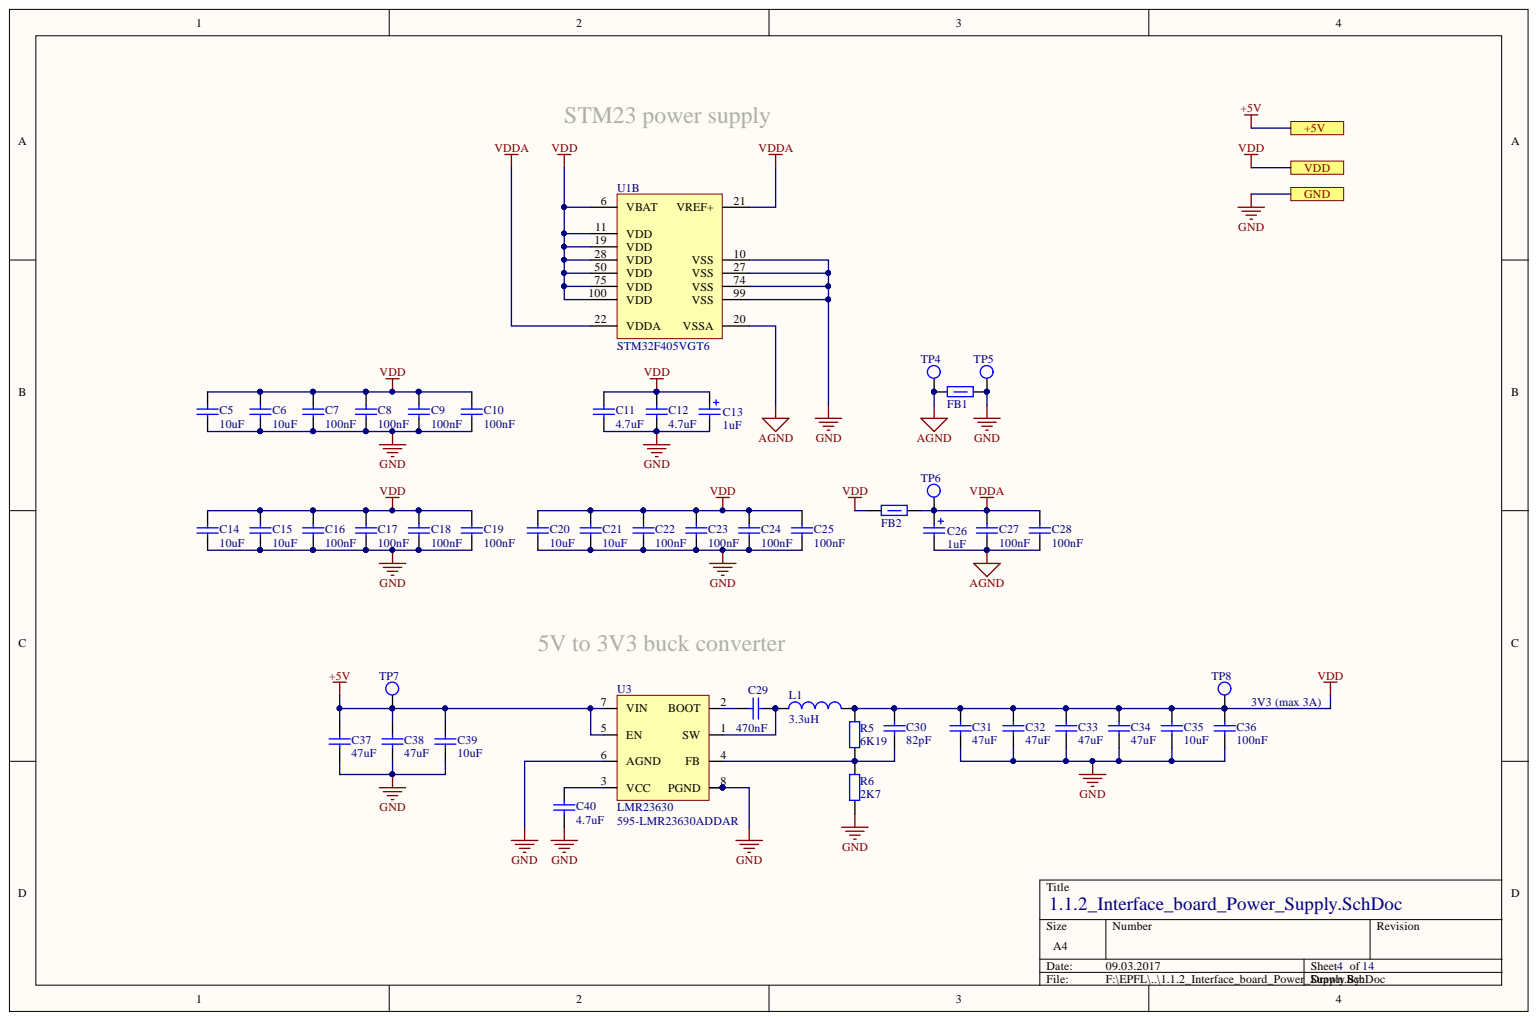
[picture p273: page 4]

VDD 19

VDD 50

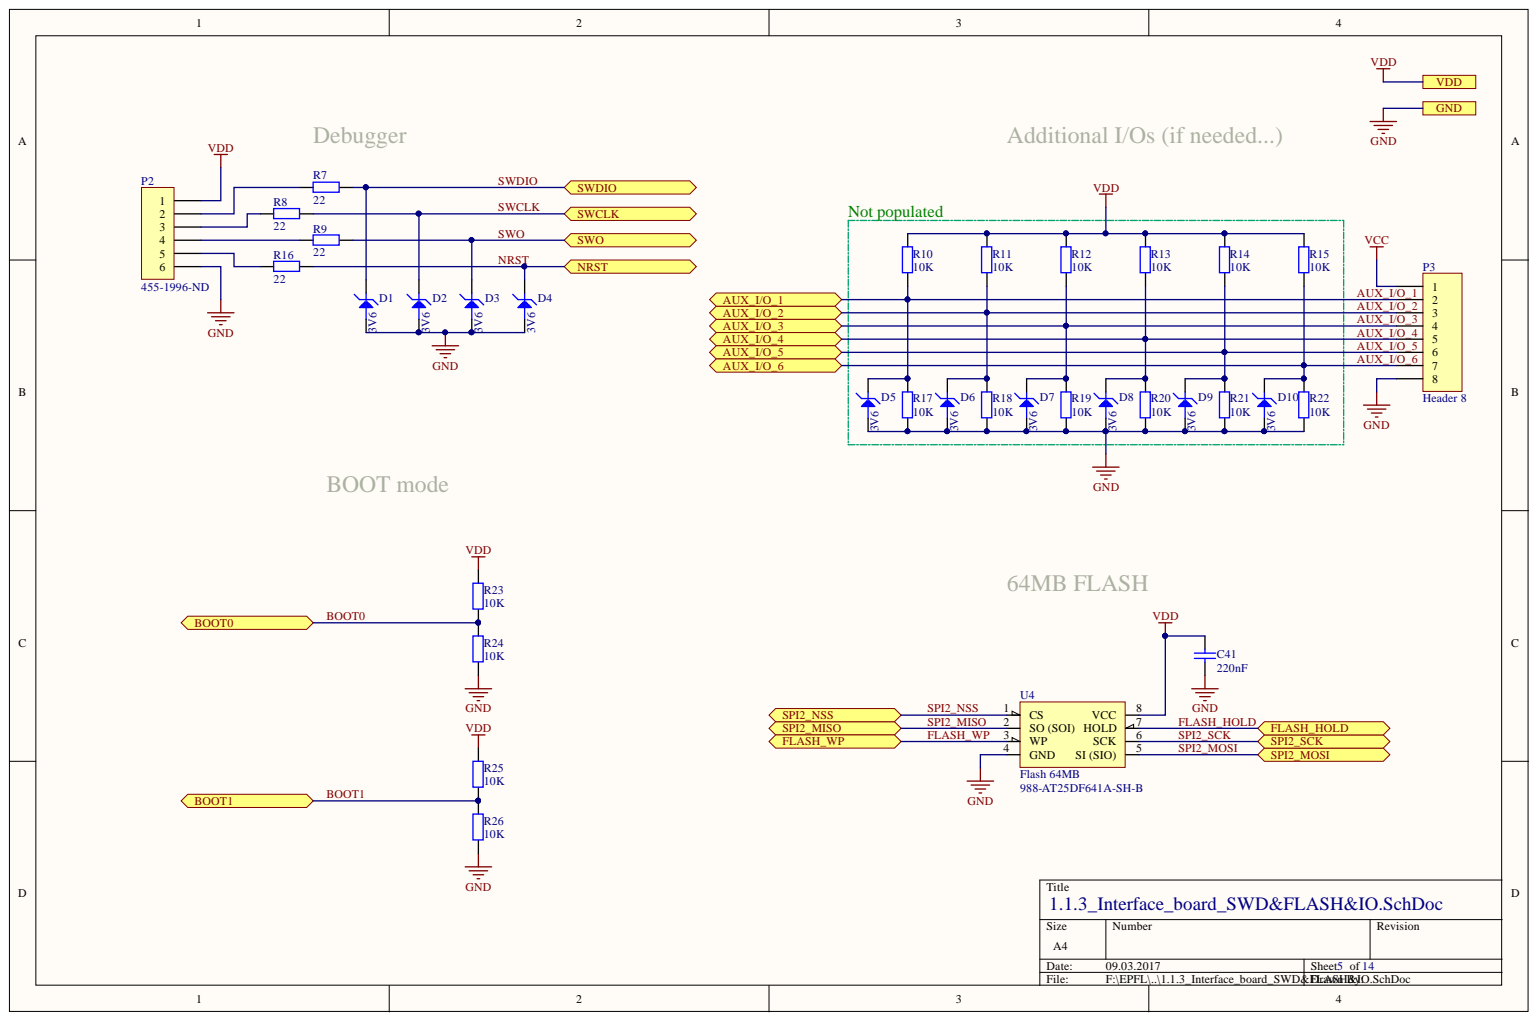
[picture p274: page 5]

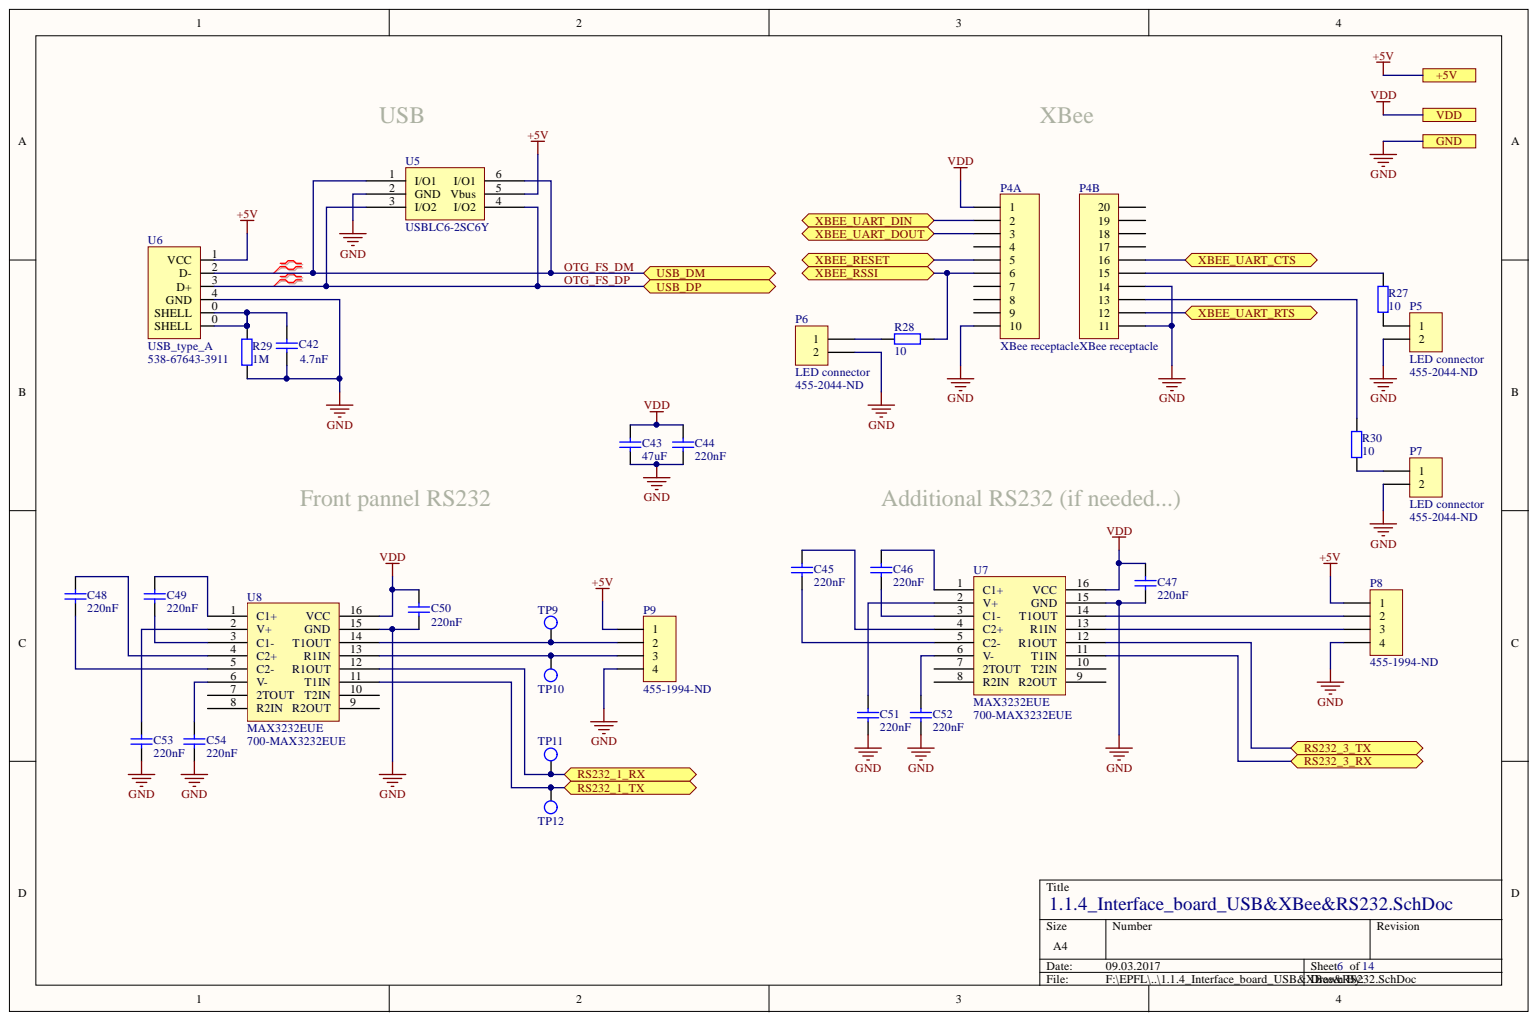
[picture p275: page 6]

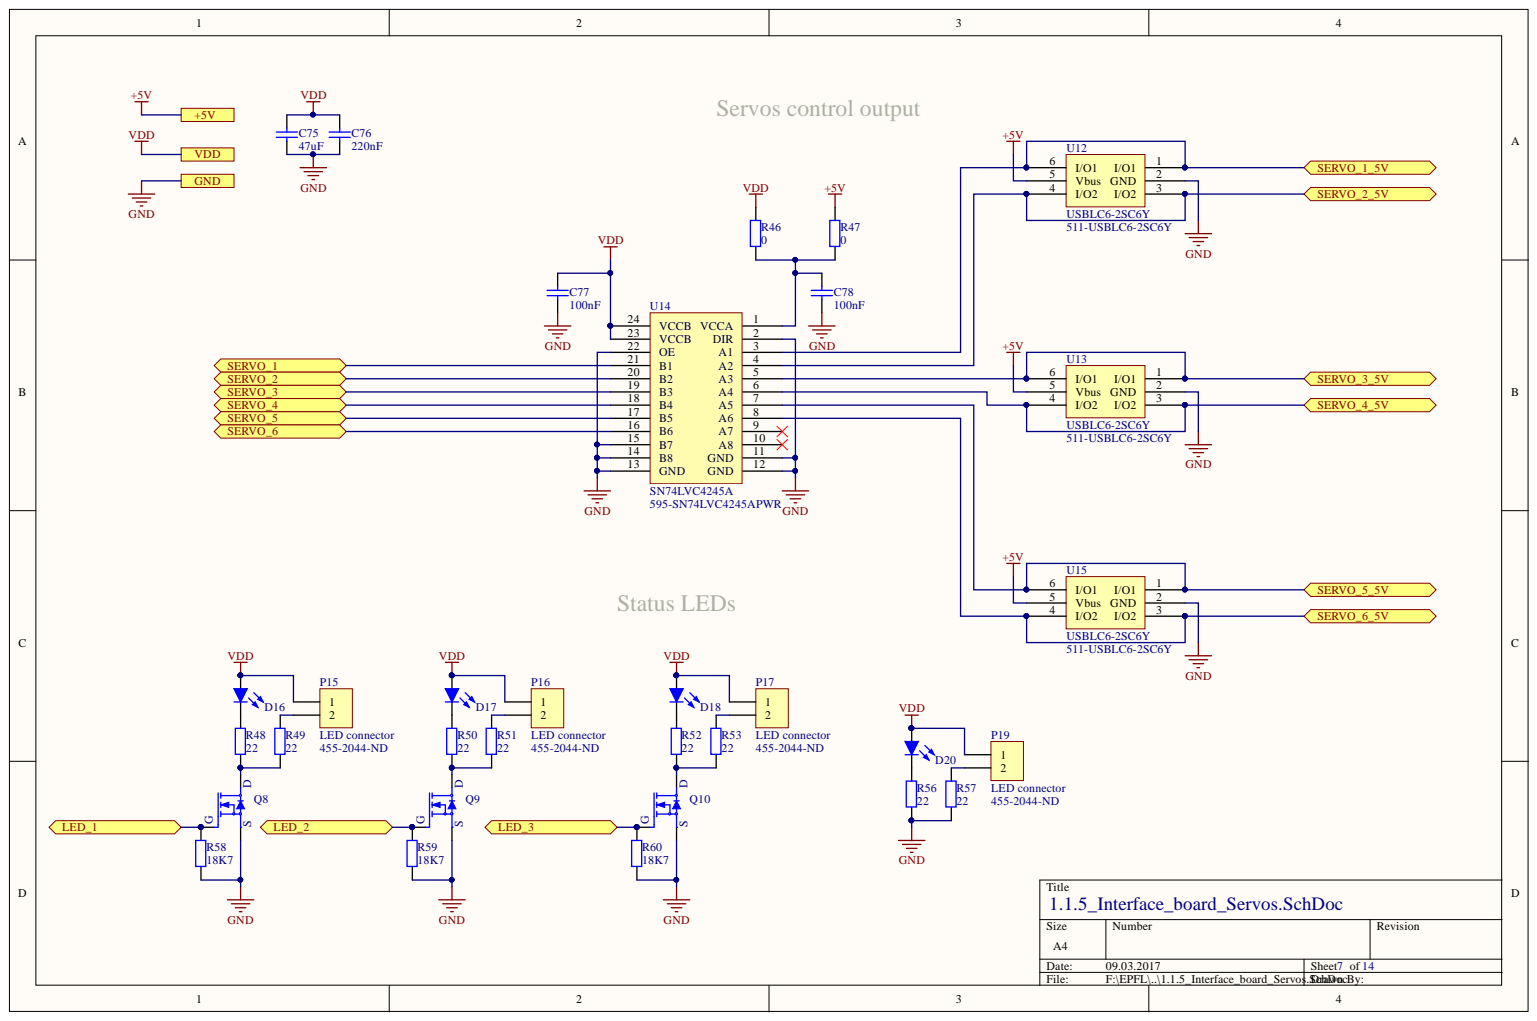
[picture p276: page 7]

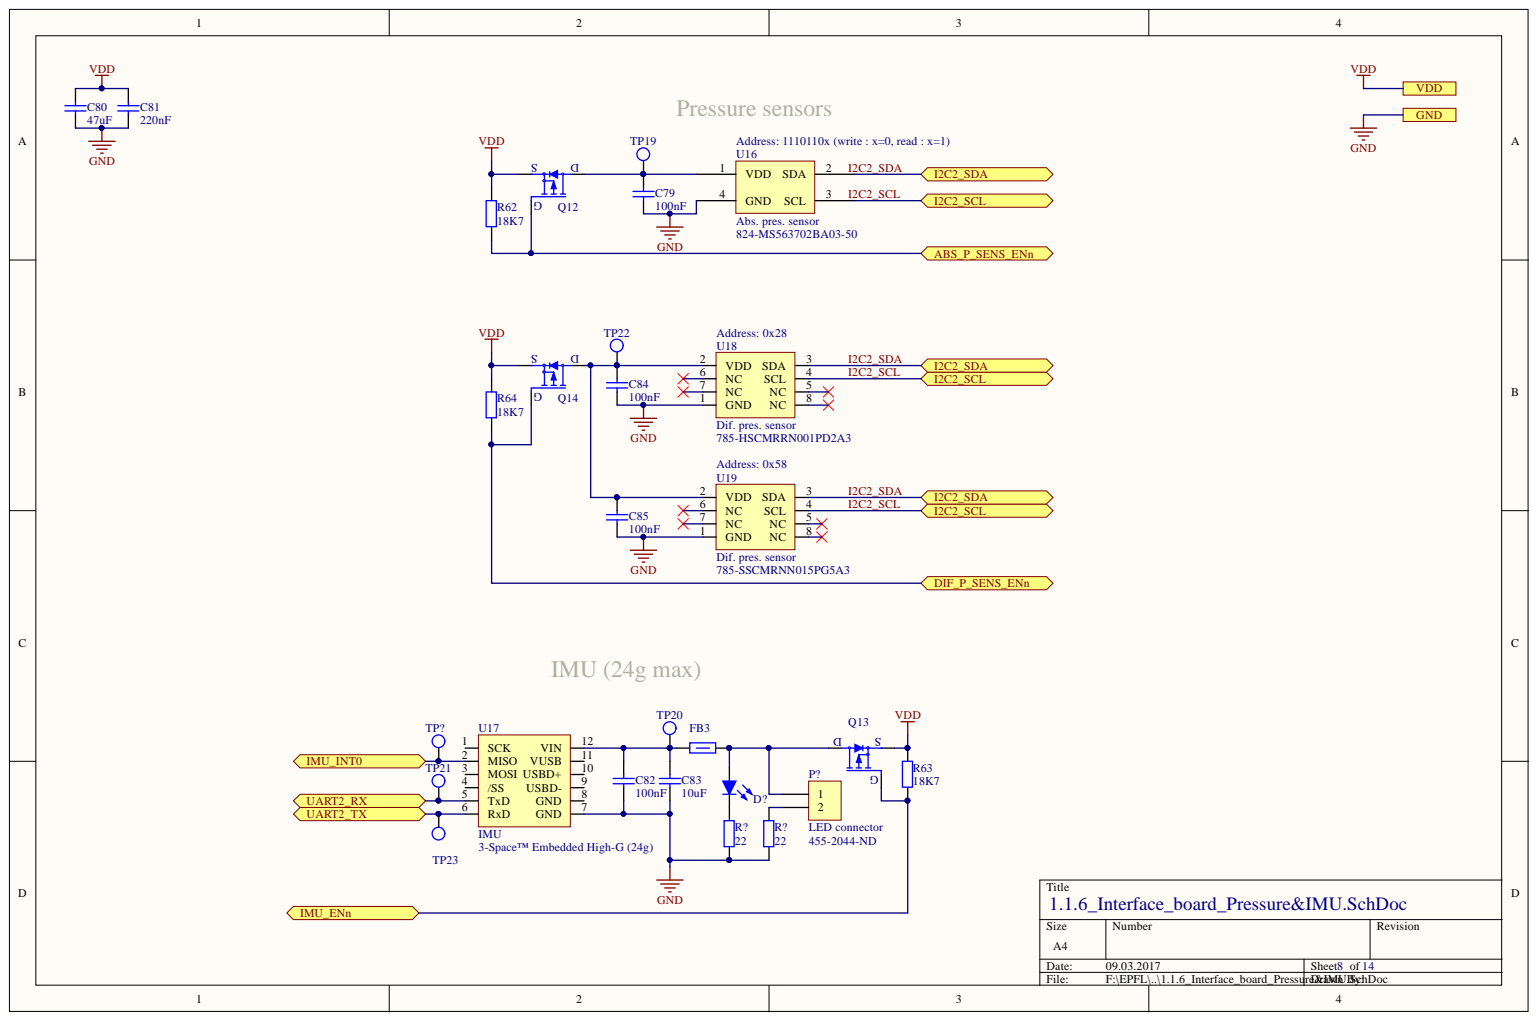
[picture p277: page 8]

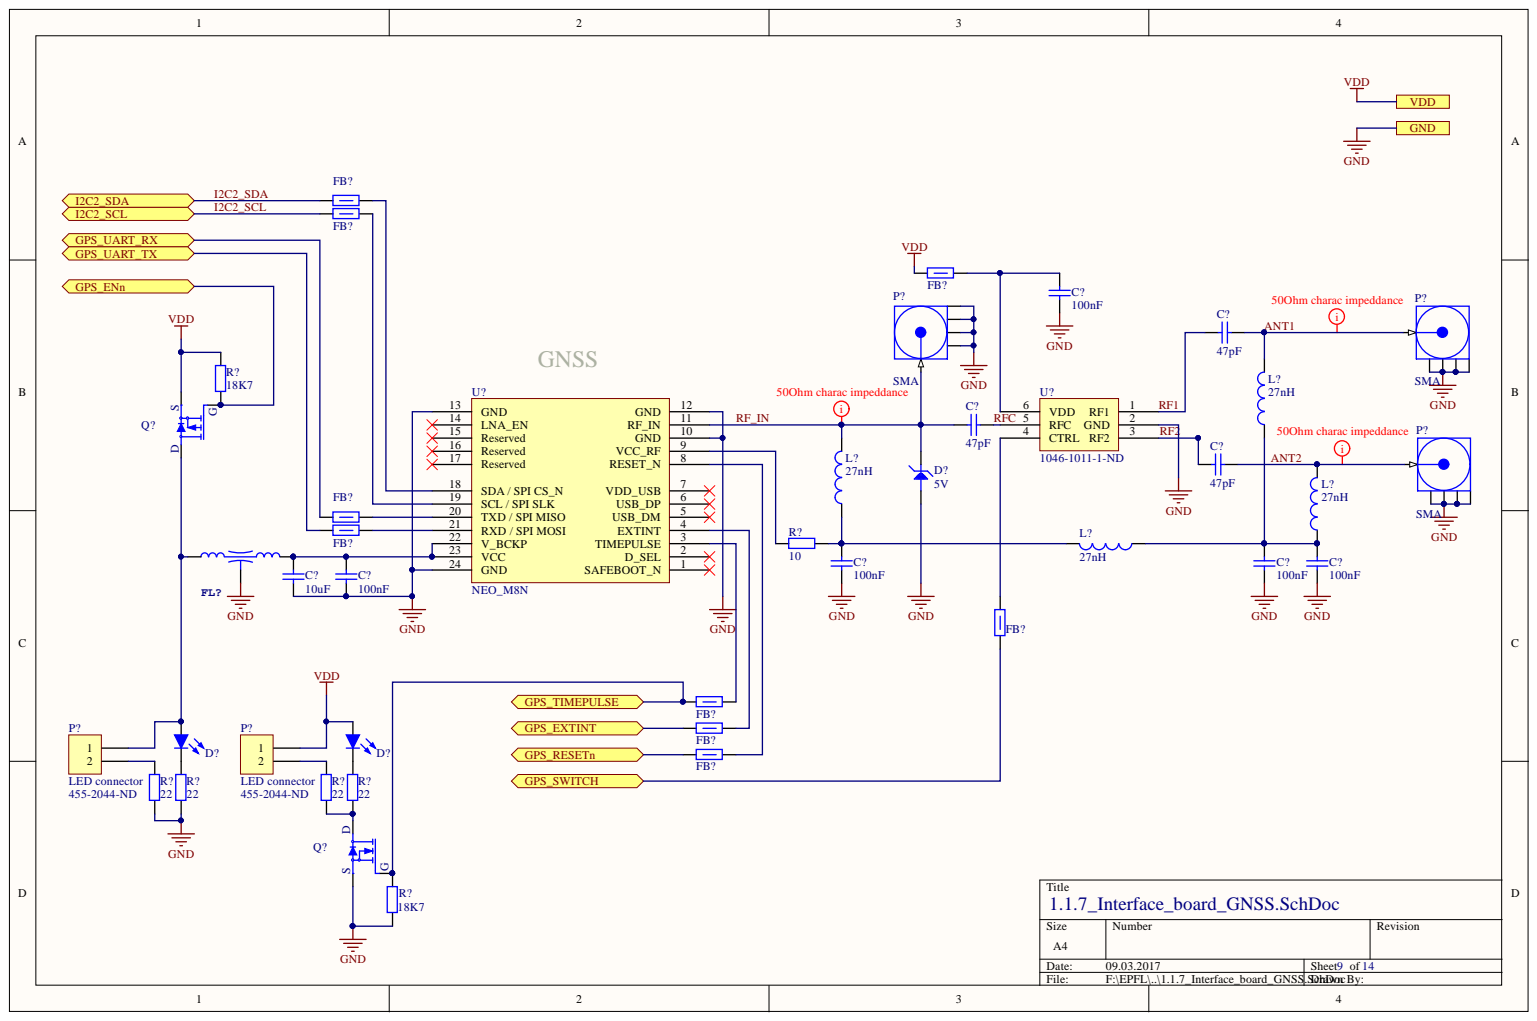
[picture p278: page 9]

SCL / SPI SLK 19

RXD / SPI MOSI 21

VCC 23 GND 24

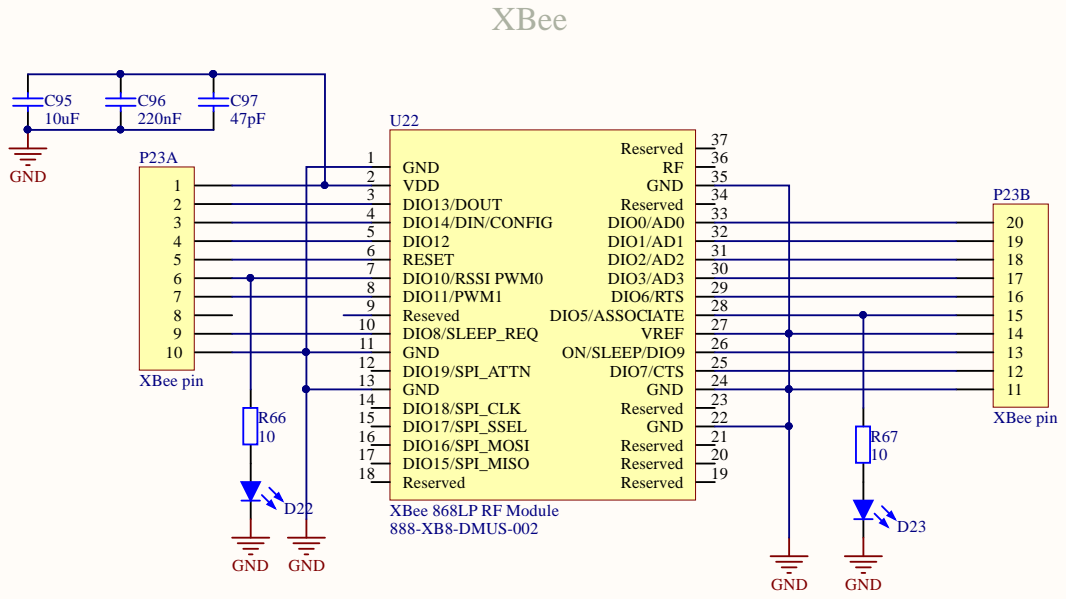
[picture p279: page 10]

5 | | 3 2
6 | | 3 1
7 | | 3 0
8 | | 2 9
1 | 9 0 | | 2 8

1 | 1 | | 2 6
1 1 | 2 | | 2 5

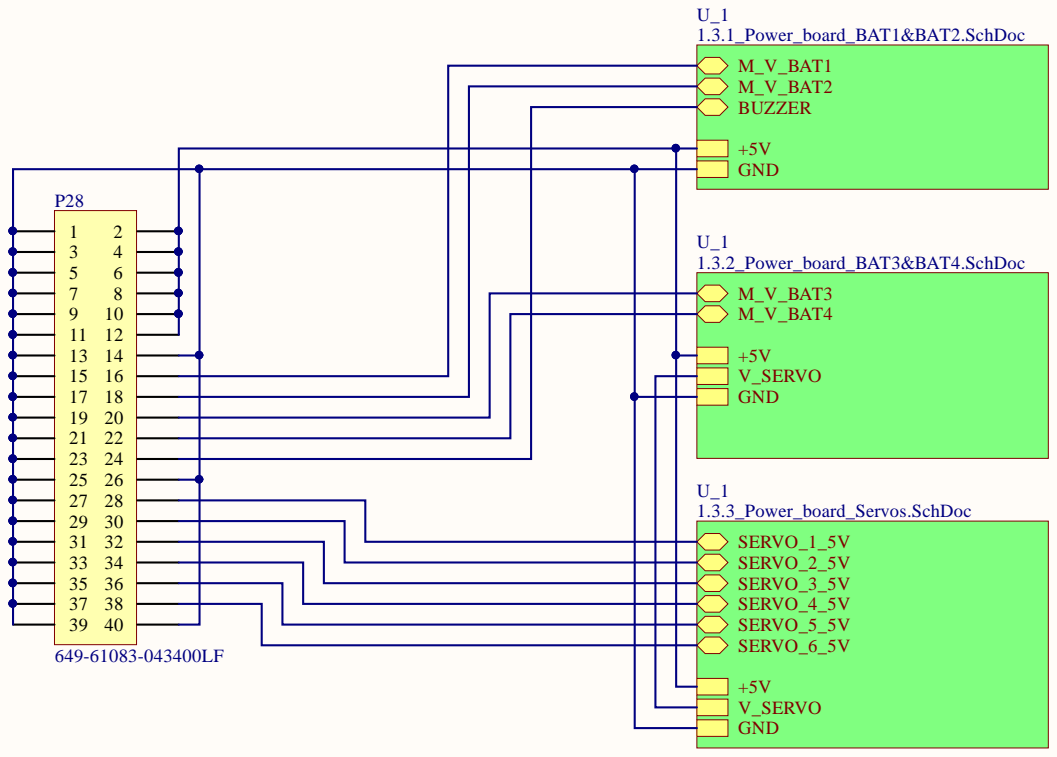
[picture p280: page 11]

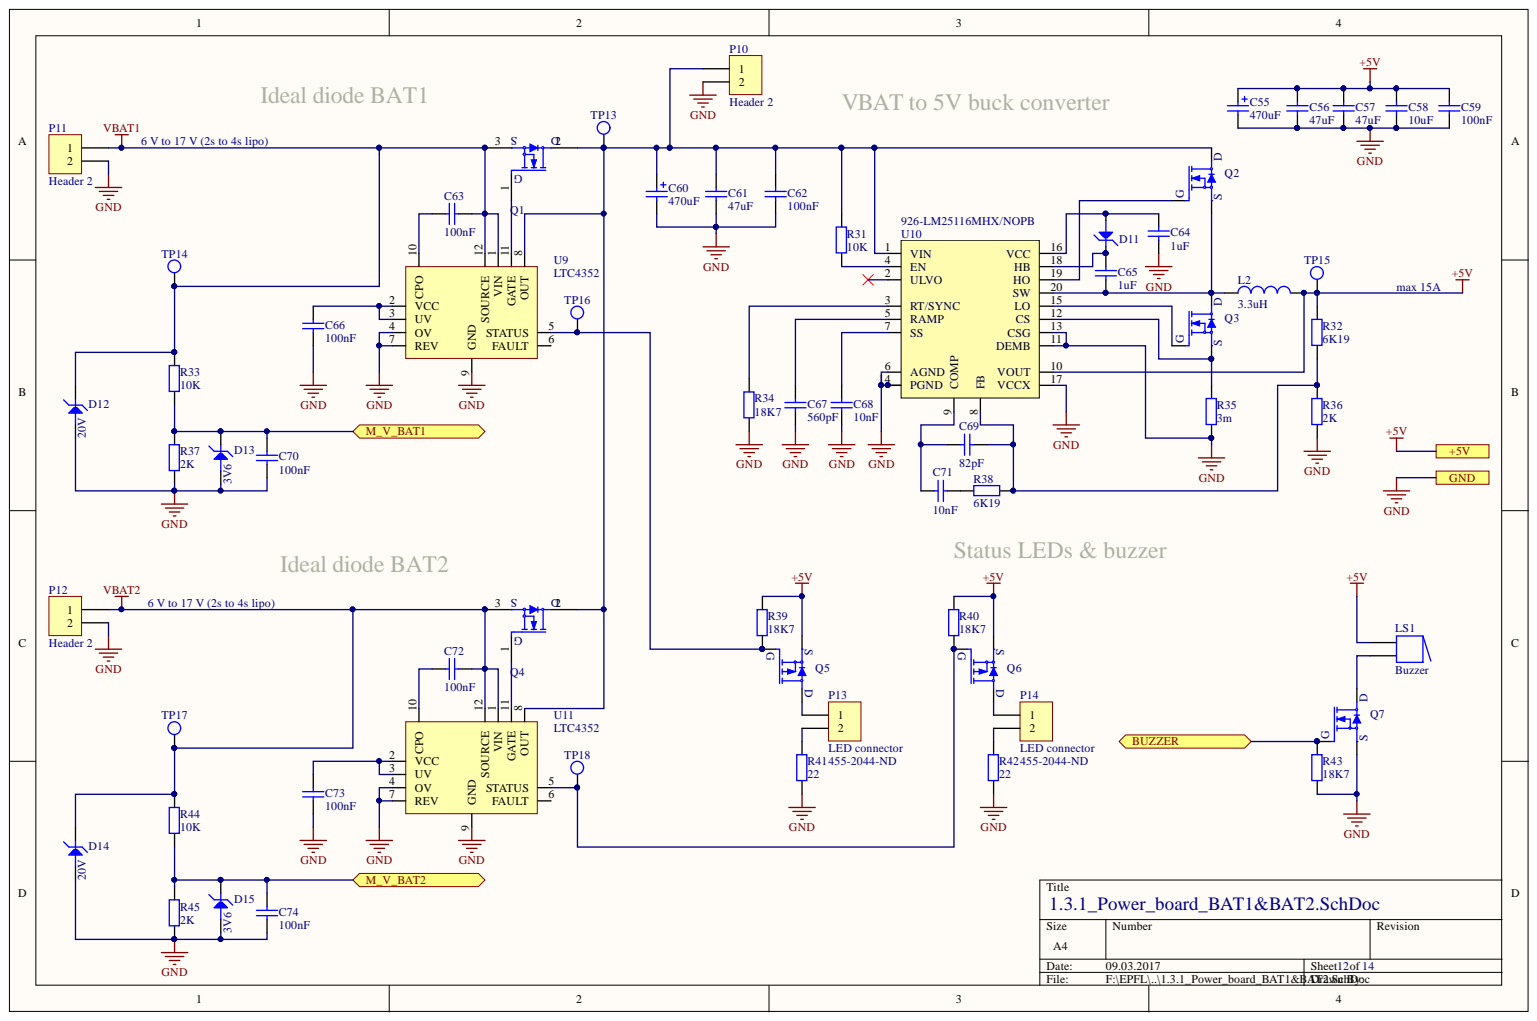
[picture p281: page 12]

VBAT to 5V buck converter

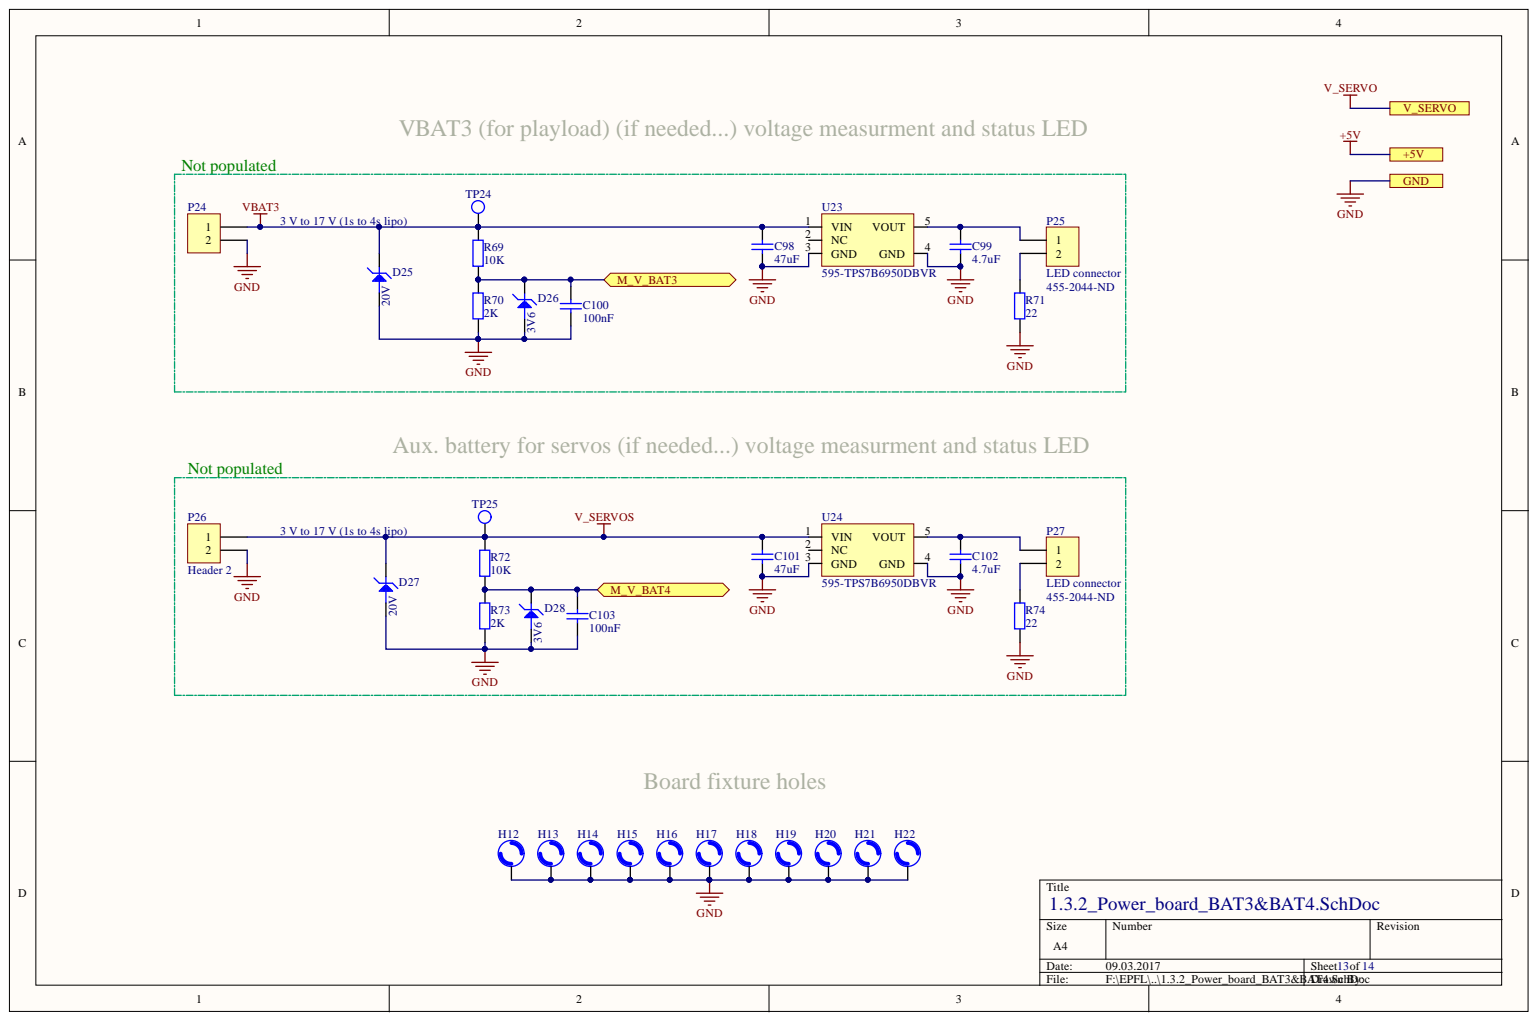
[picture p282: page 13]

VBAT3 (for playload) (if needed...) voltage measurment and status LED

Aux. battery for servos (if needed...) voltage measurment and status LED

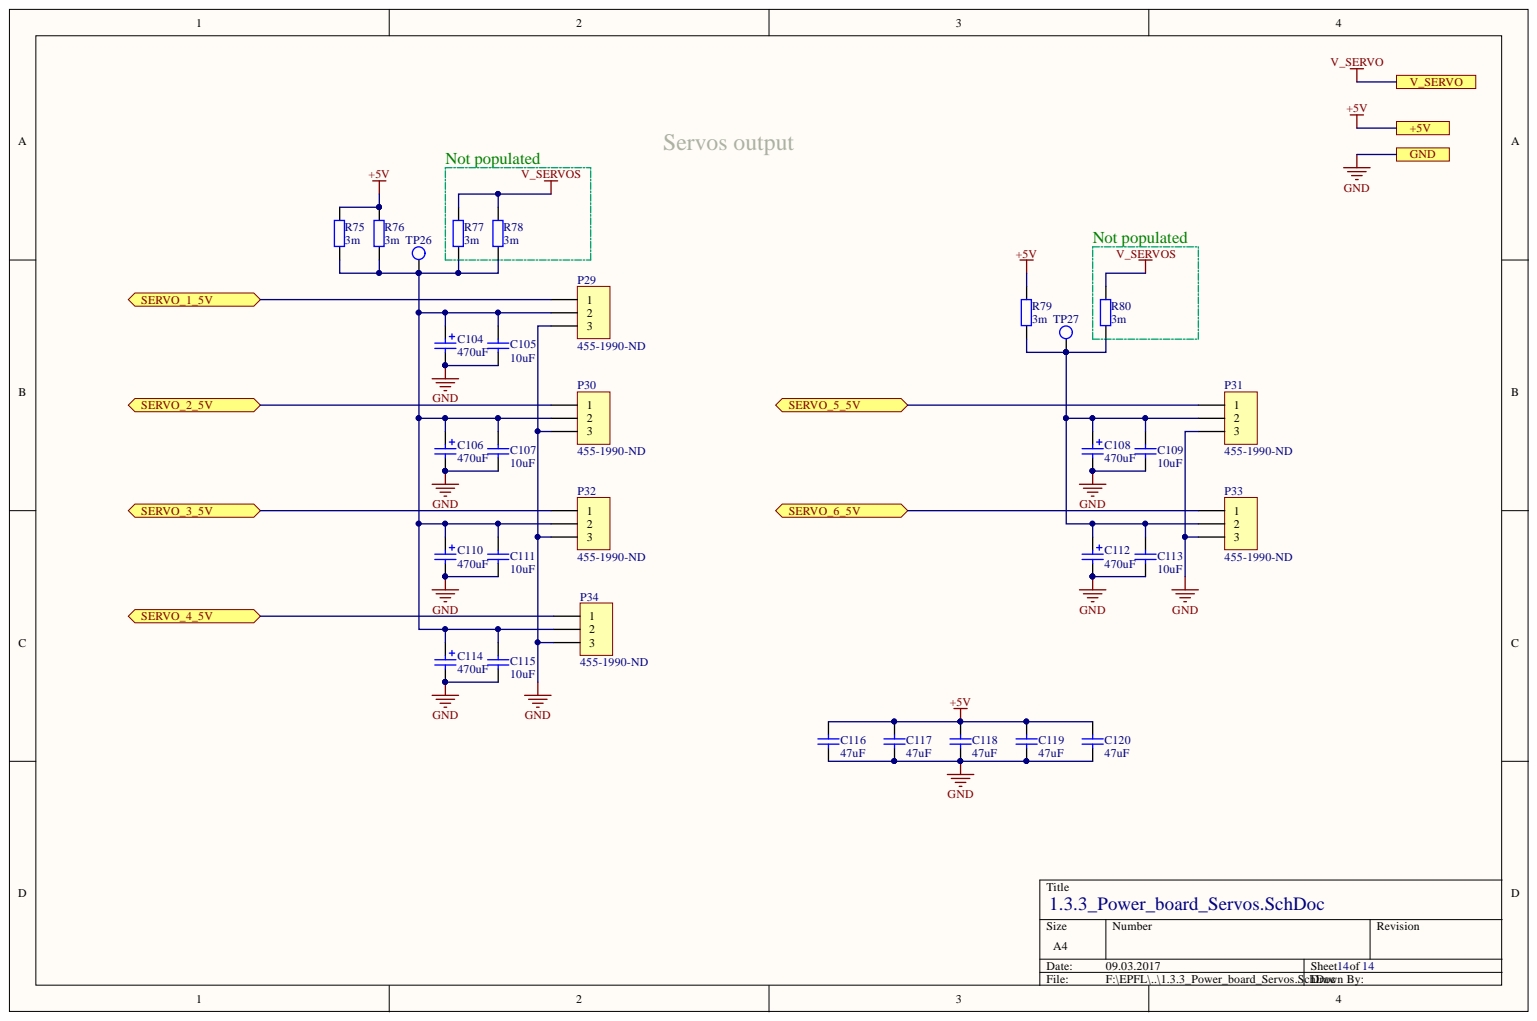
[picture p283: page 14]
