irec-duster/RORO/Avionics_RORO/Altium/Project/Rocket_PCB_Project_2017/Rocket_PCB_Project_2017_v090417.pdf

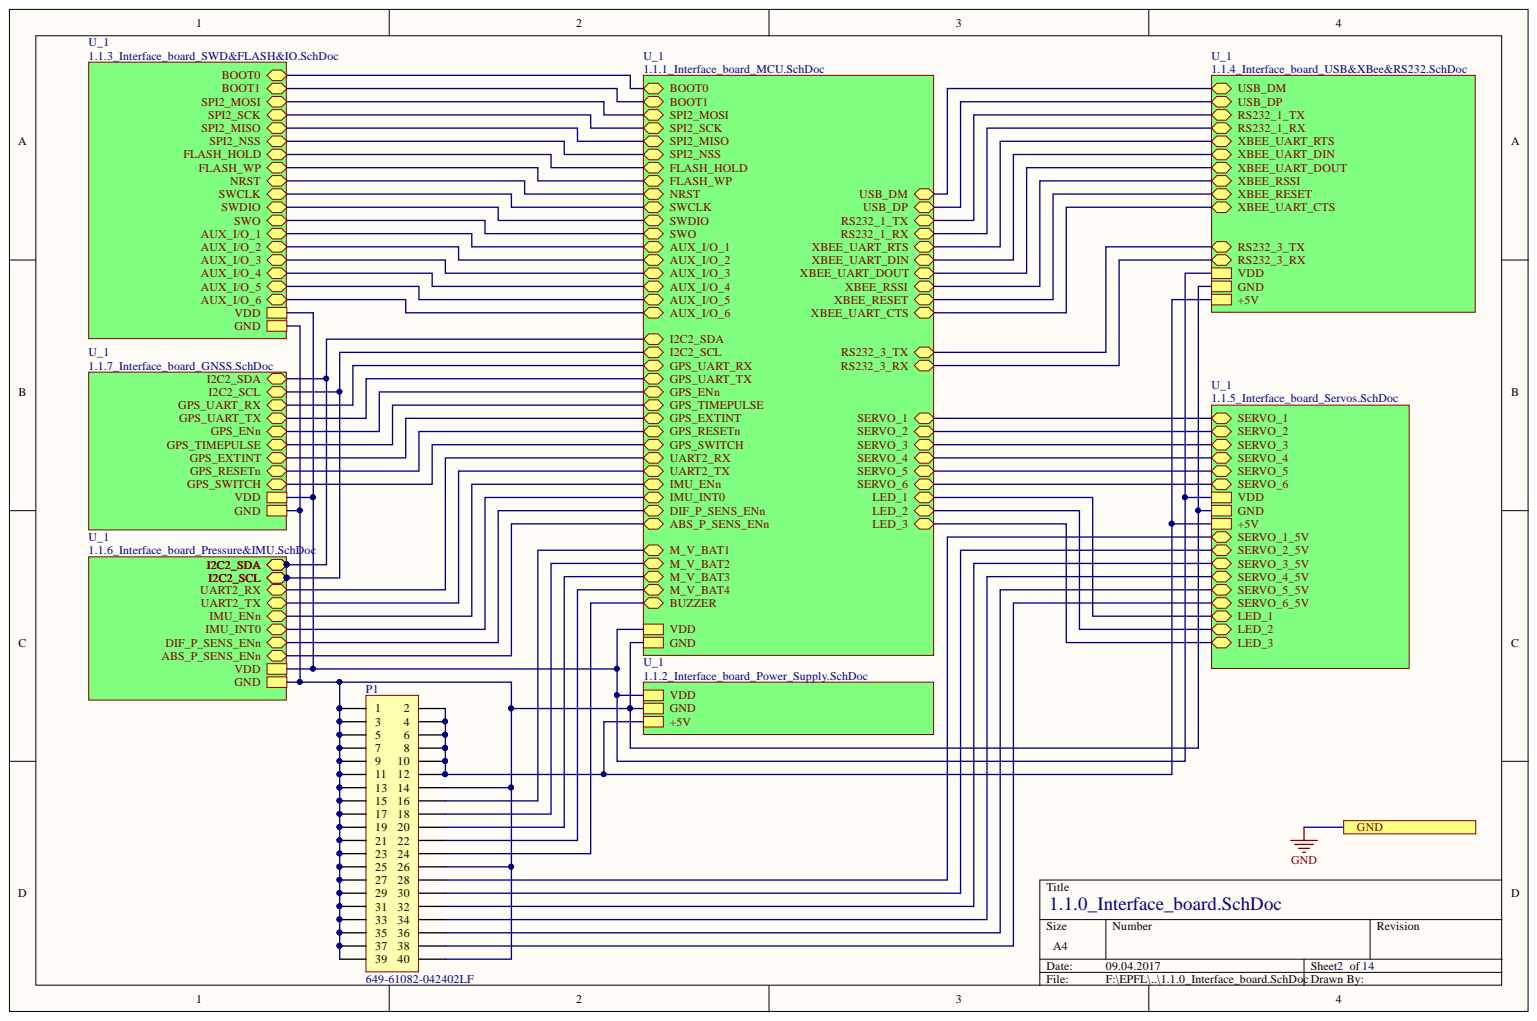
[picture p284: page 2]

DIF_P_SE NS_ E N n L E D _ 2

D | o | c | | | ABS_P_SE NS_ E N n L E D _ 3

M_ V _BAT 1
M_ V _BAT 2
M_ V _BAT 3
M_ V _BAT 4
BU Z Z E R

U _ 1 1.1.2 _In terface_ b oard _Po wer_Su p p l y.Sch D o c

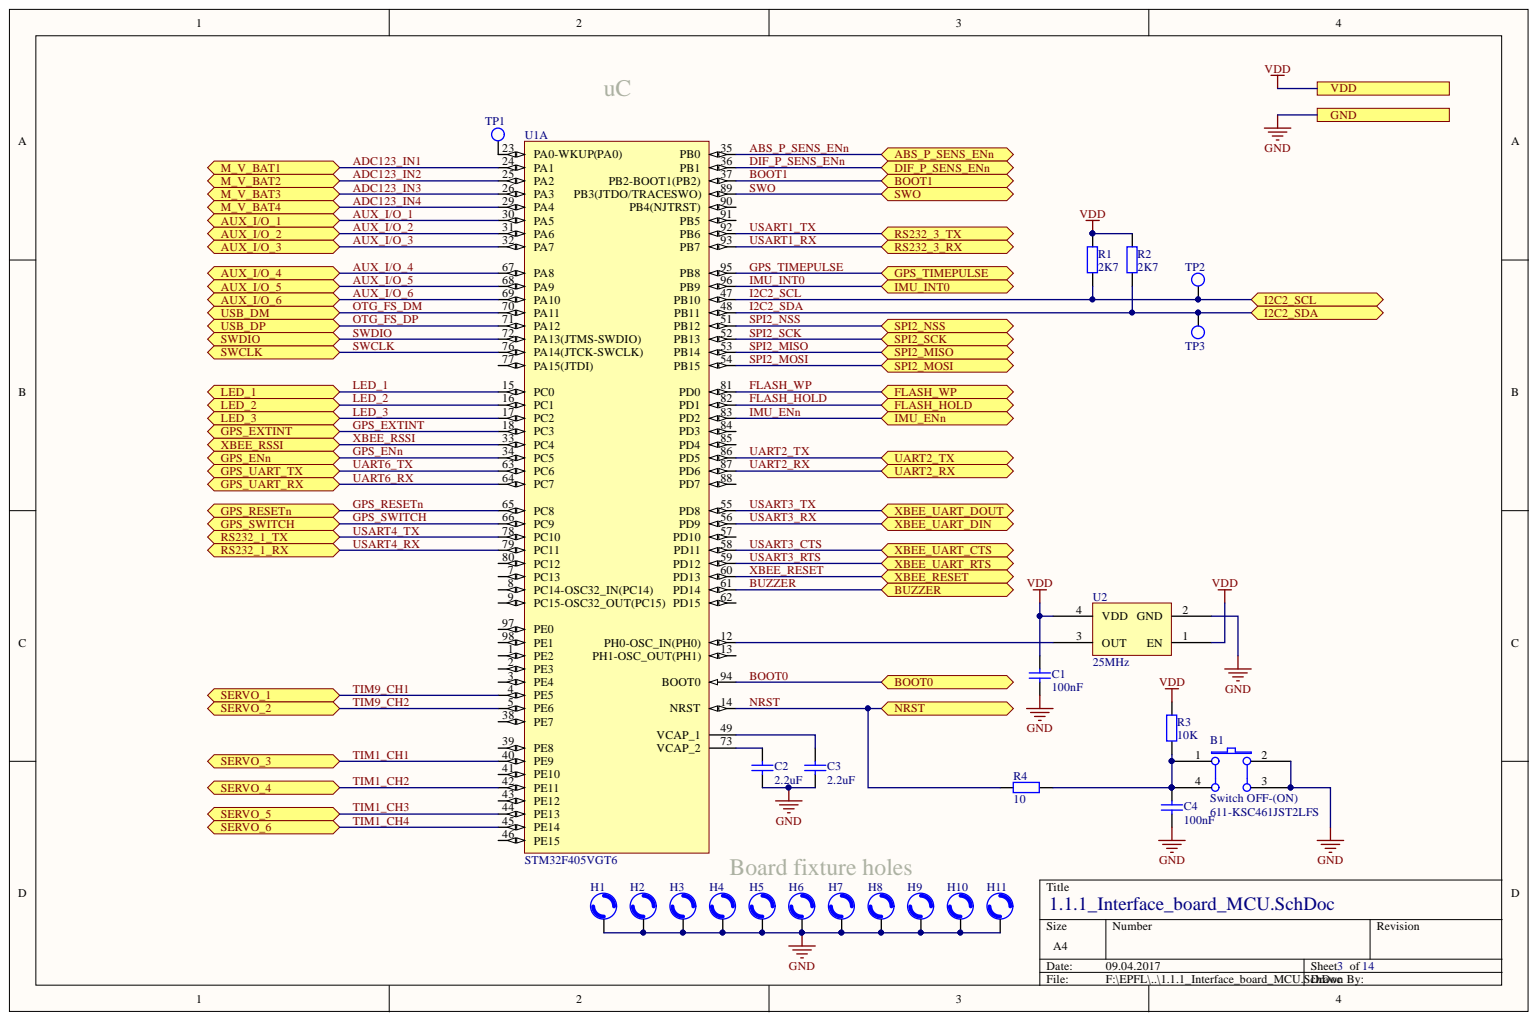
[picture p285: page 3]

4 9
7 3

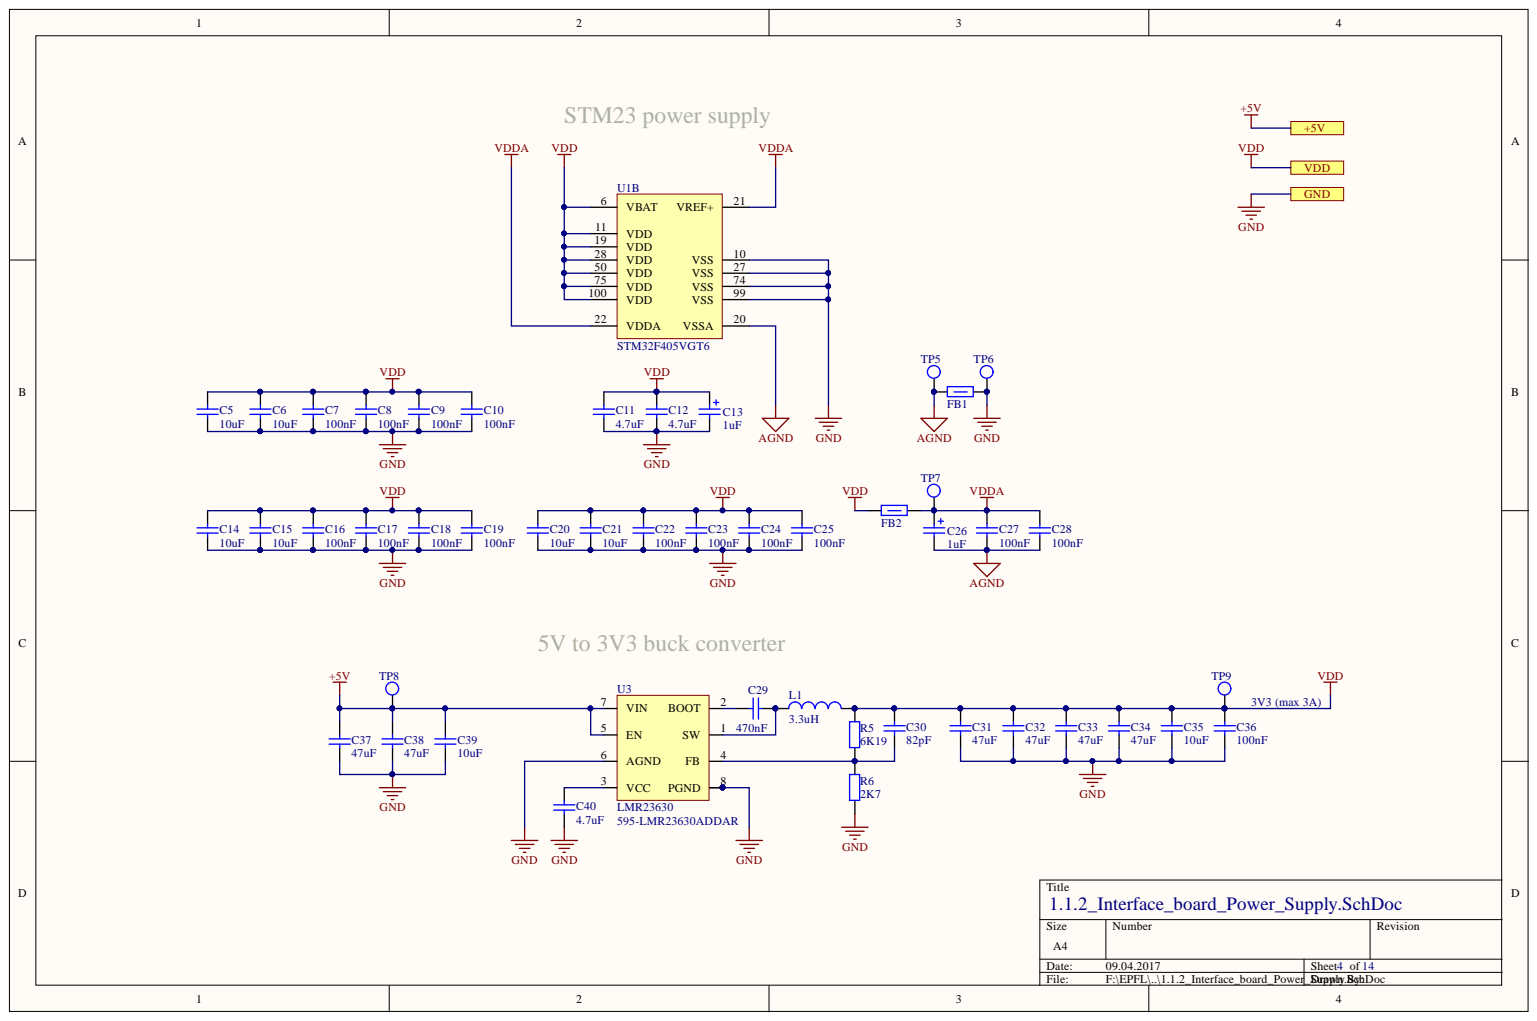
[picture p286: page 4]

VDD 19

VDD 50

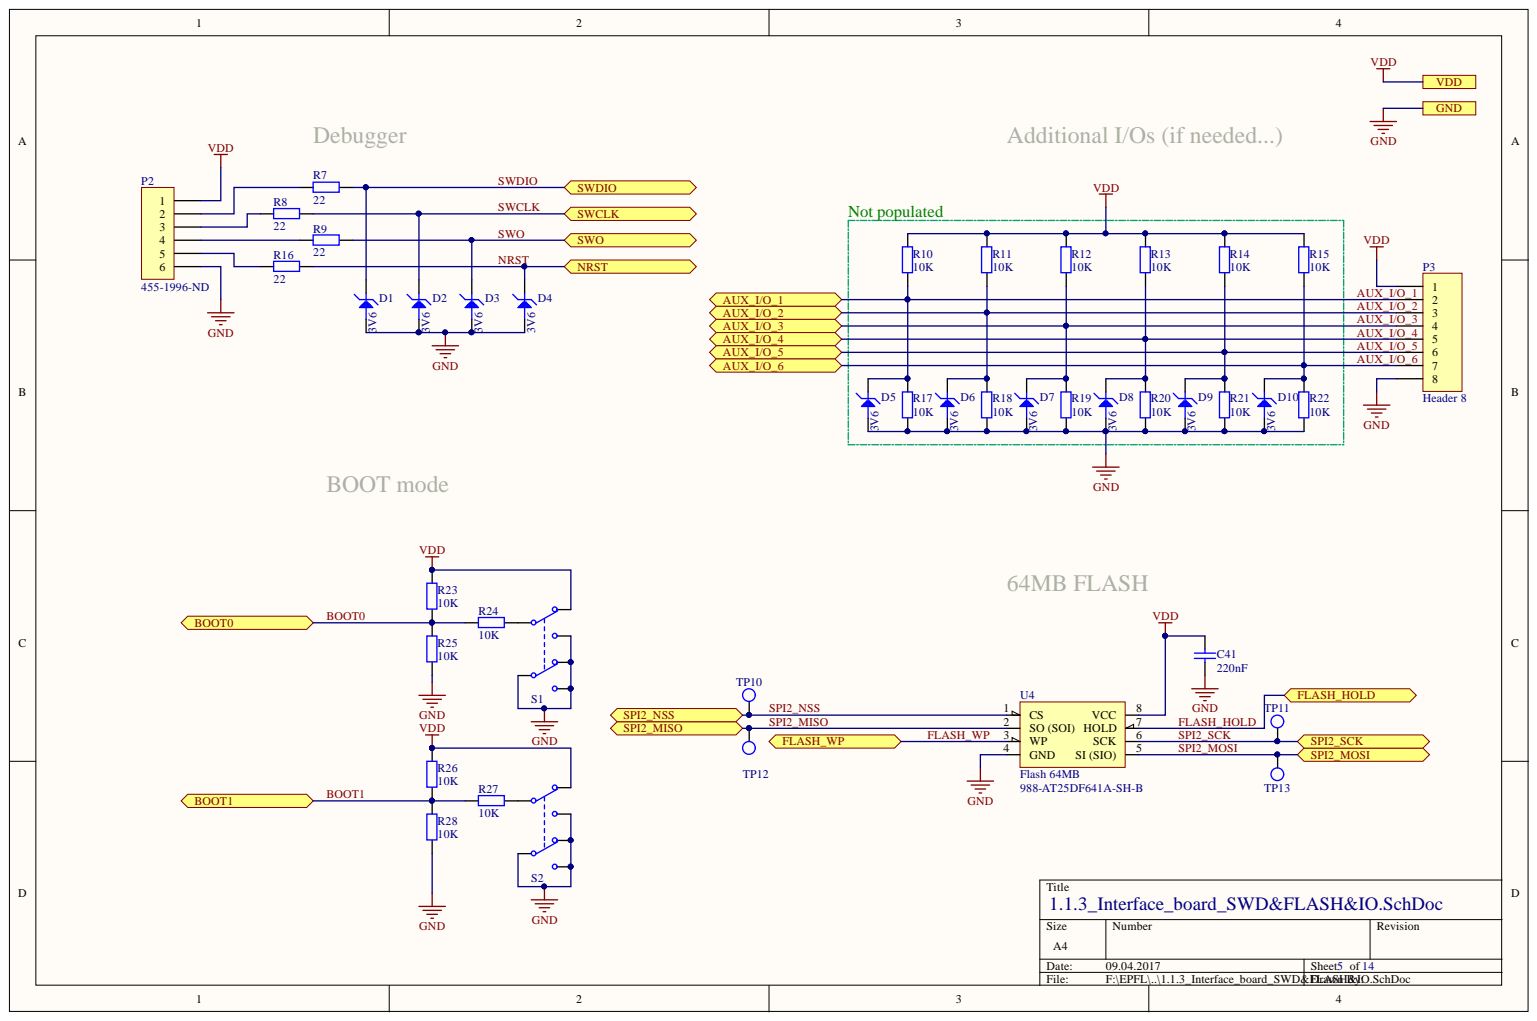
[picture p287: page 5]

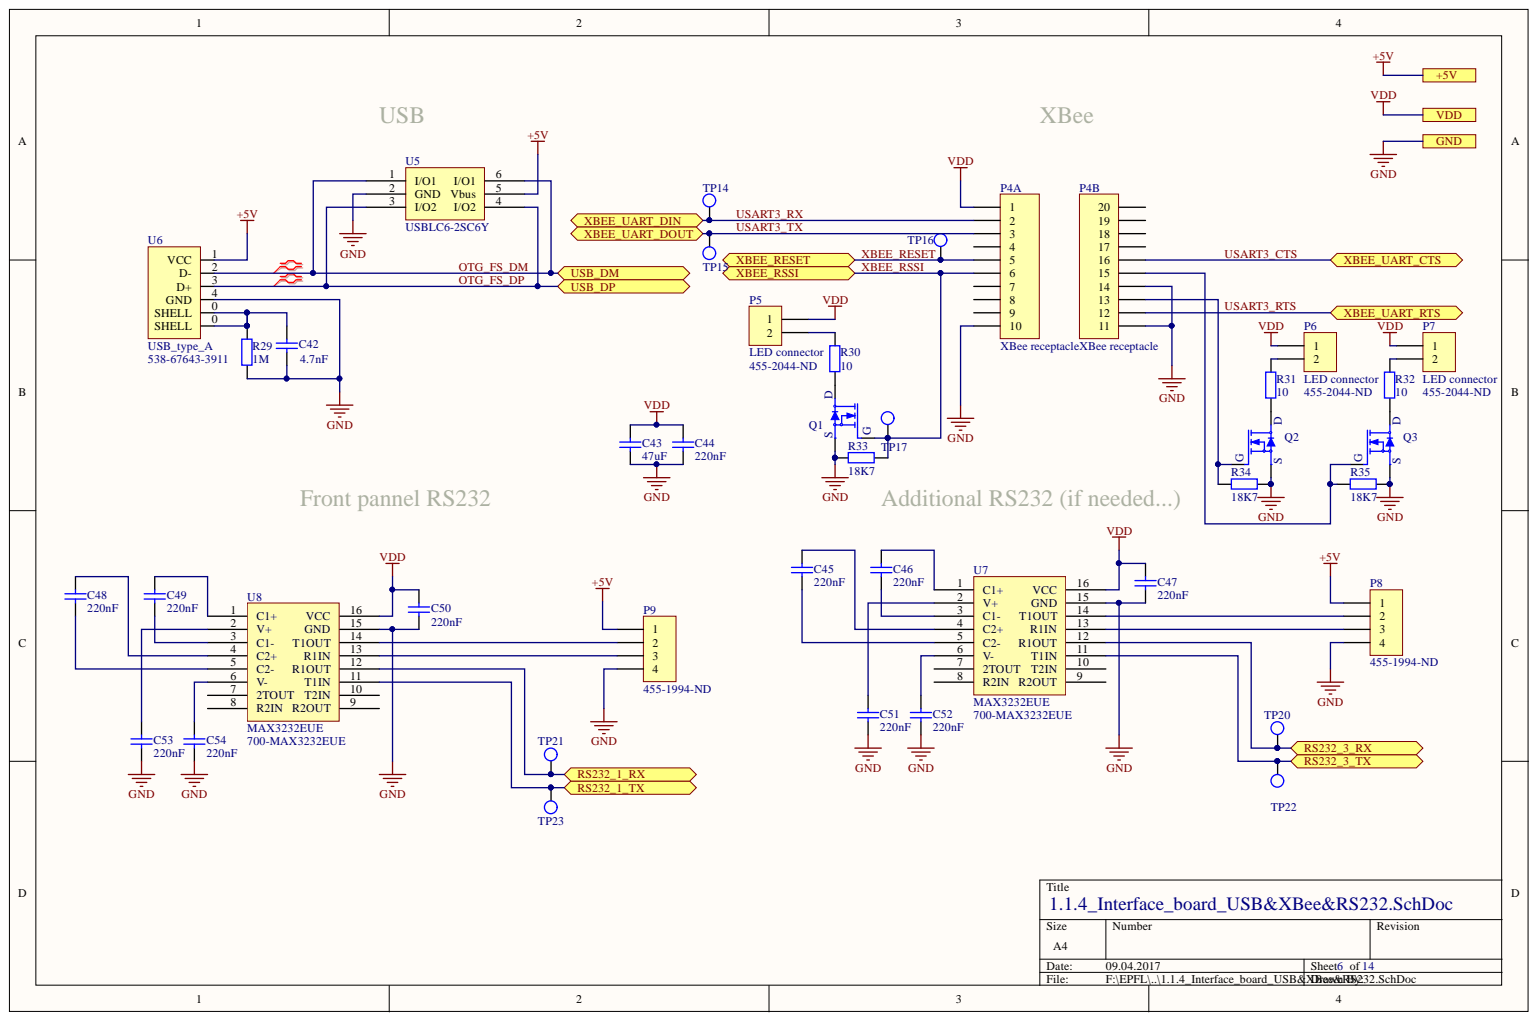
[picture p288: page 6]

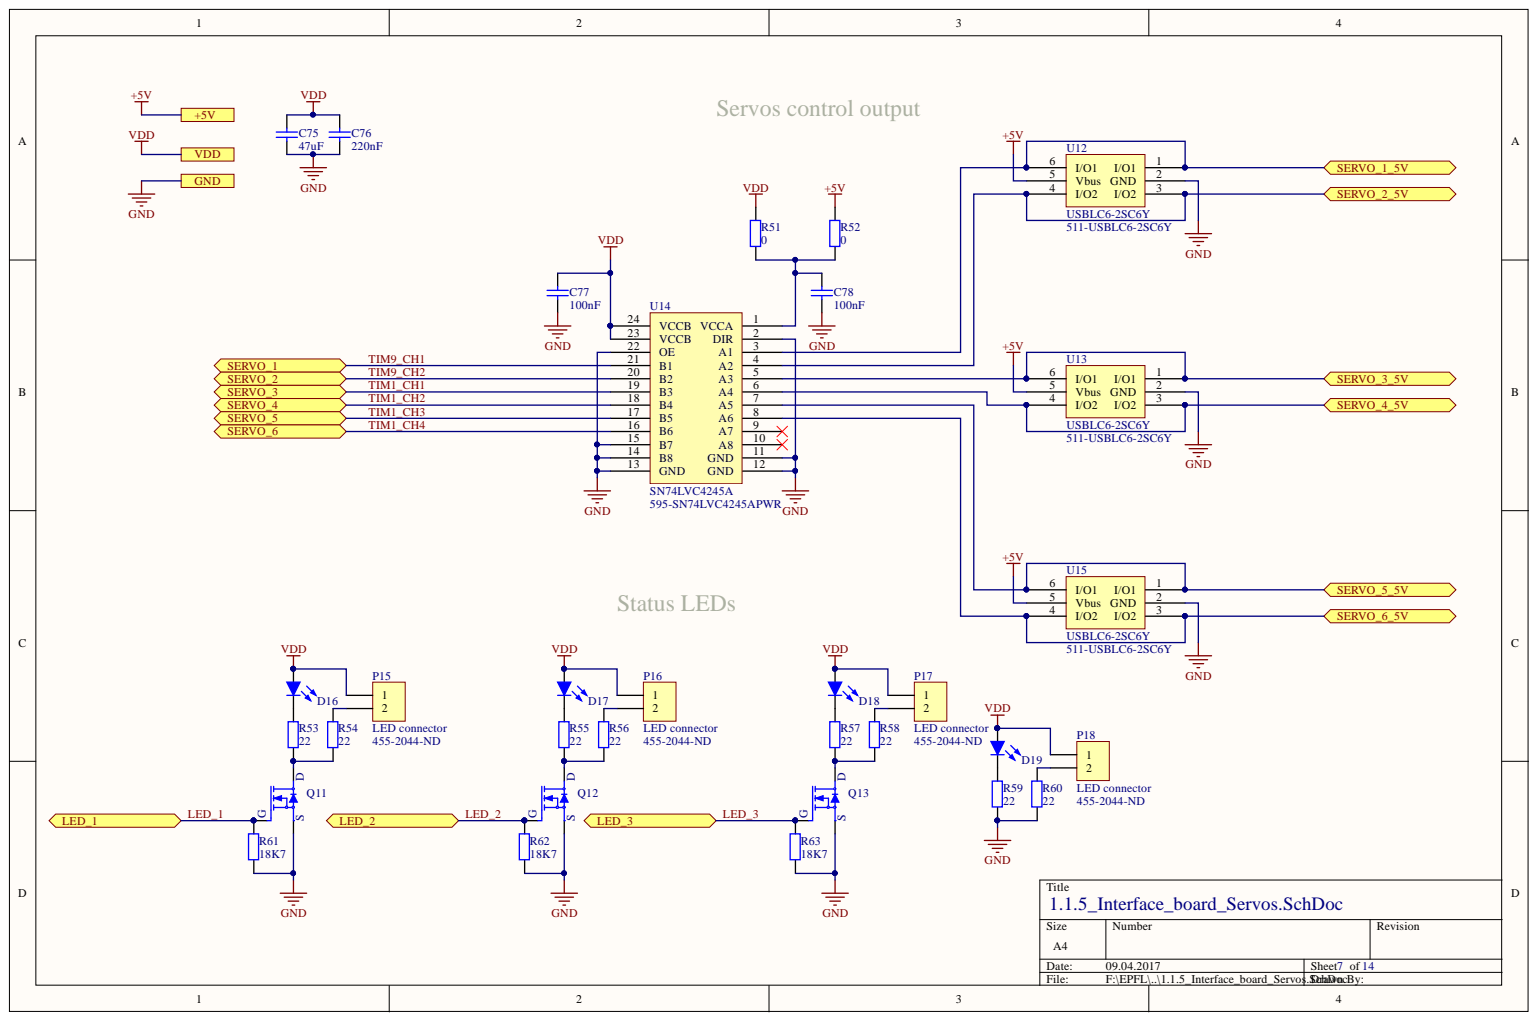
[picture p289: page 7]

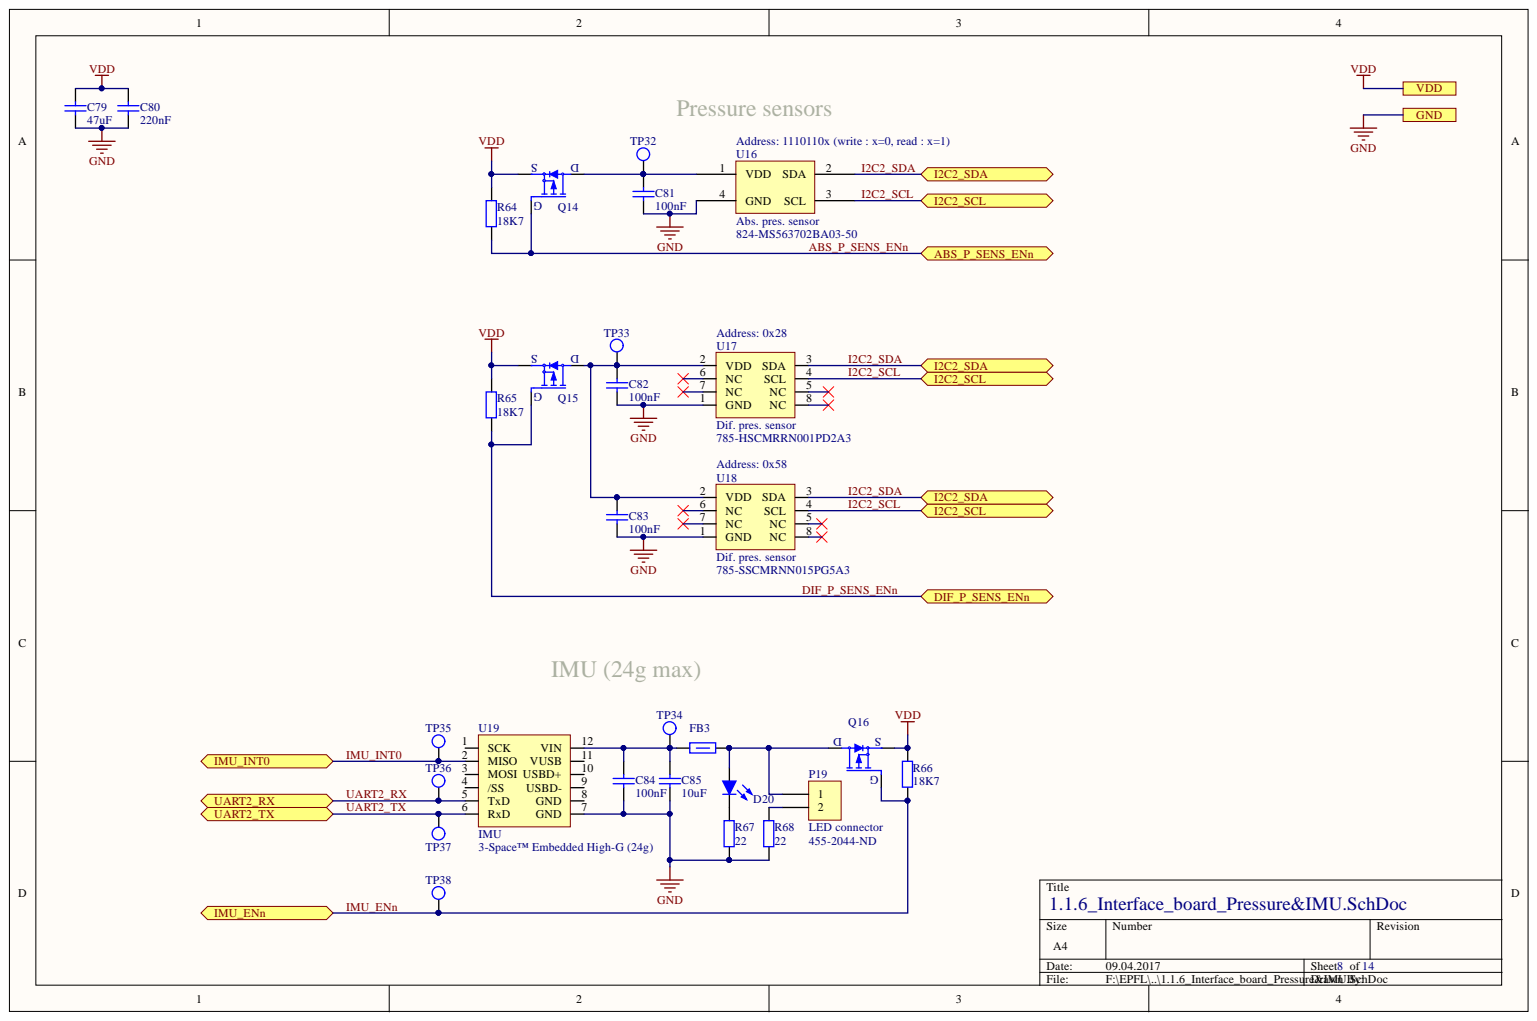
[picture p290: page 8]

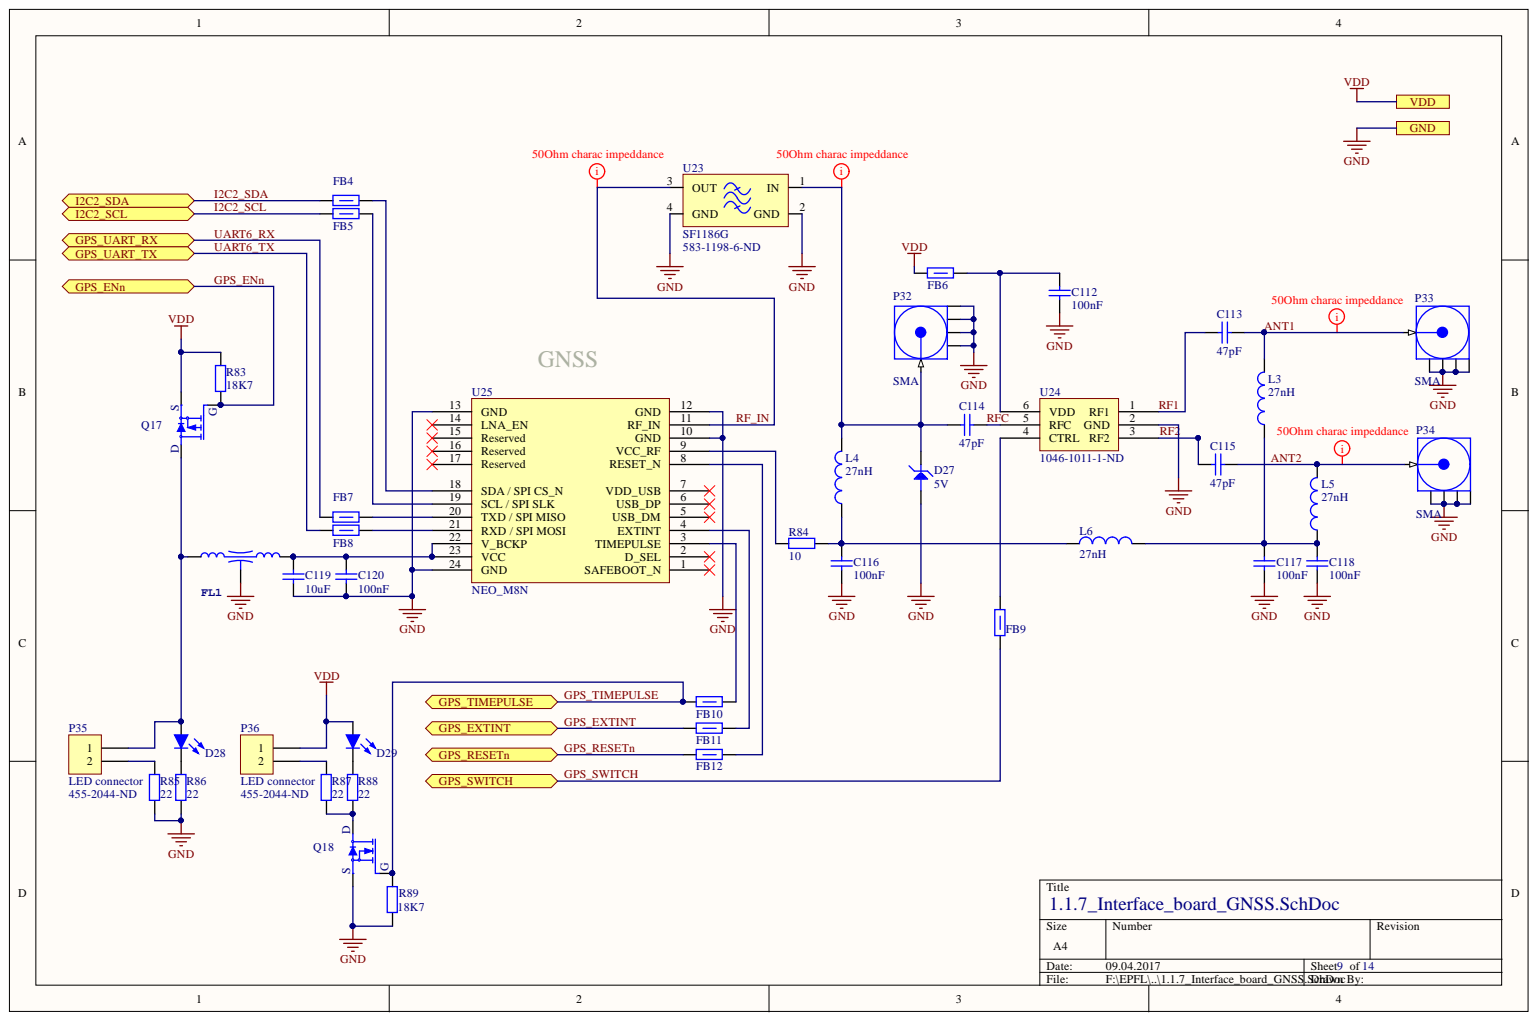
[picture p291: page 9]

SCL / SPI SLK 19

RXD / SPI MOSI 21

VCC 23 GND 24

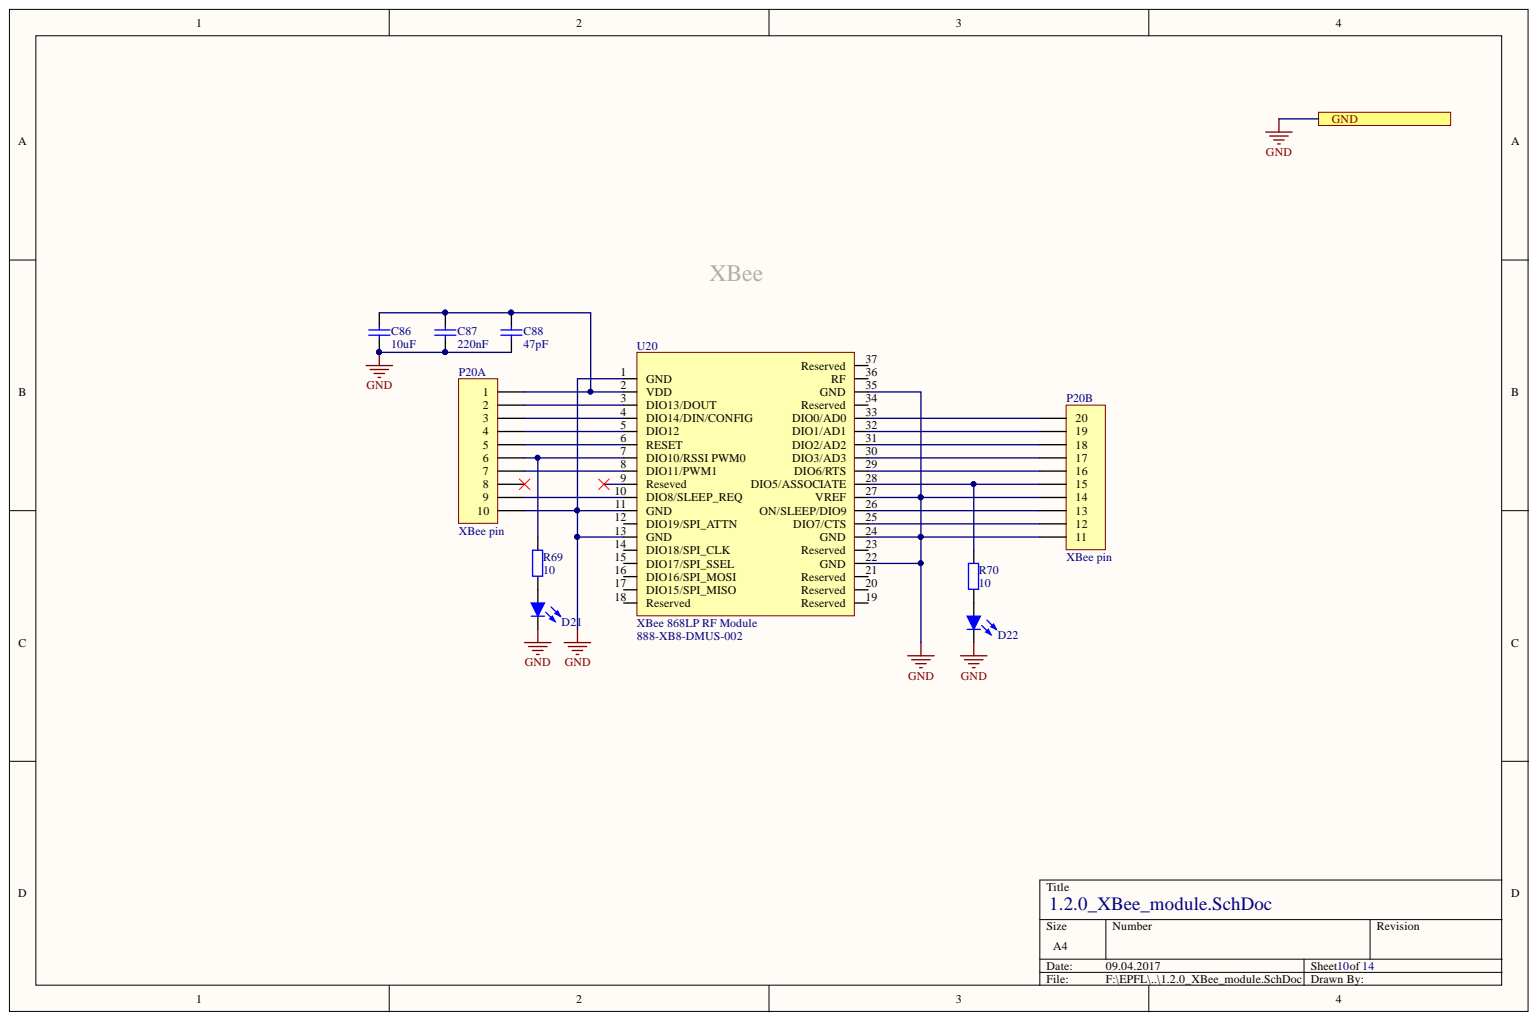
[picture p292: page 10]

5 | | 3 2
6 | | 3 1
7 | | 3 0
8 | | 2 9
1 | 9 0 | | 2 8

1 | 1 | | 2 6
1 1 | 2 | | 2 5

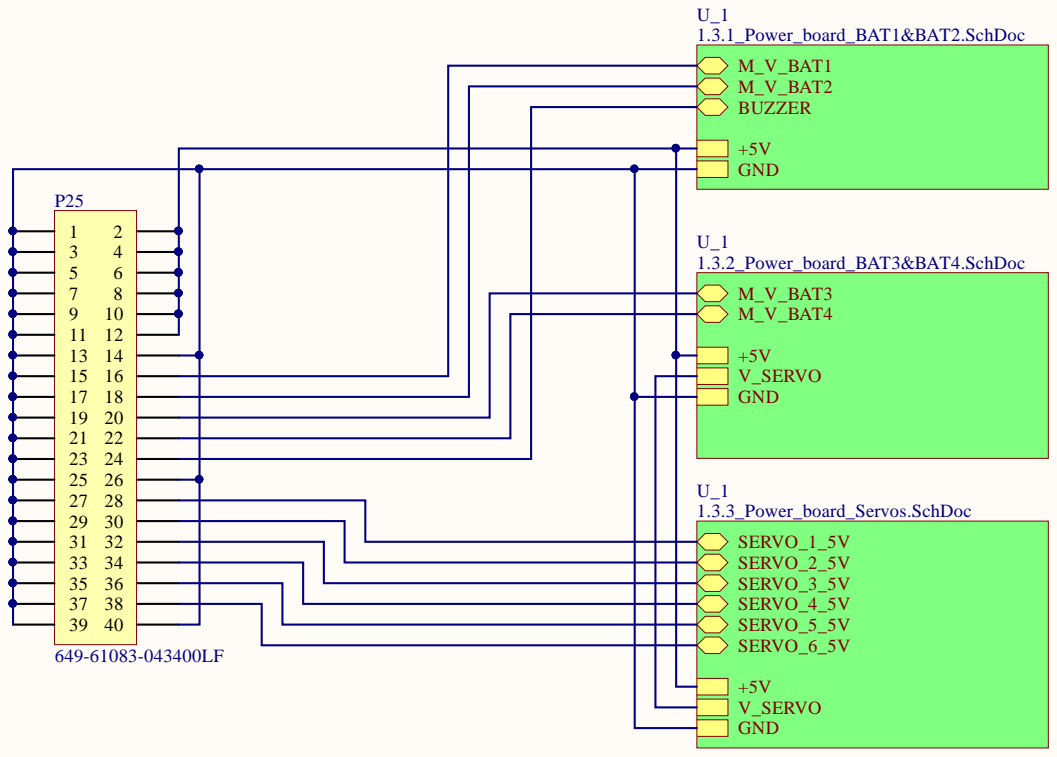
[picture p293: page 11]

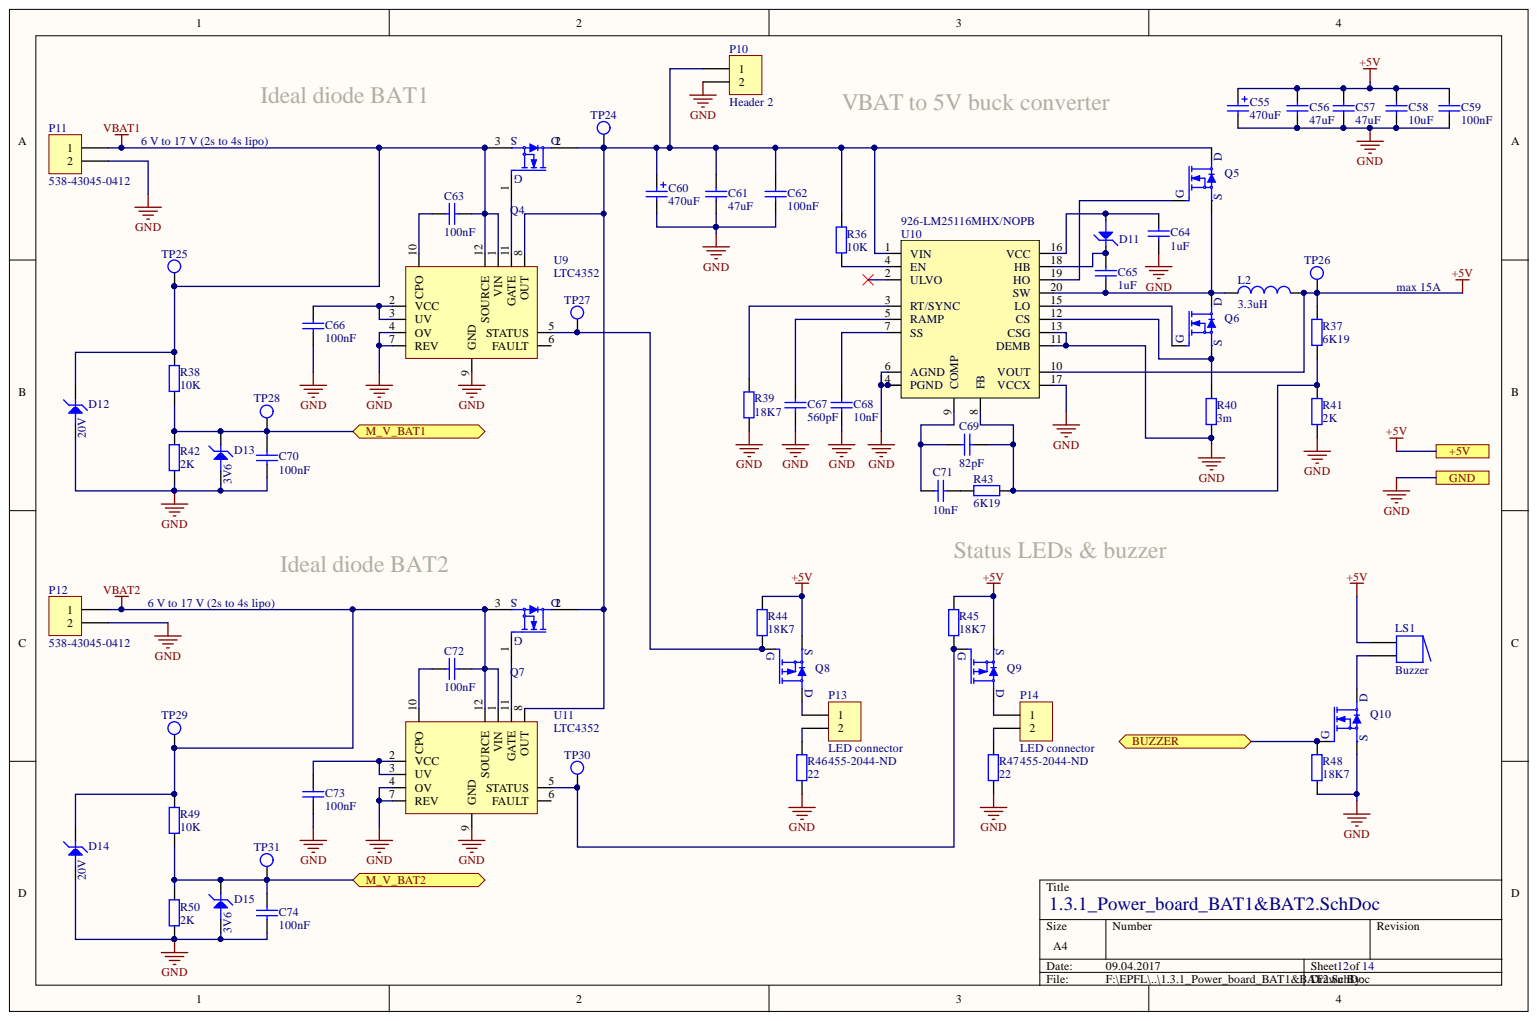
[picture p294: page 12]

VBAT to 5V buck converter

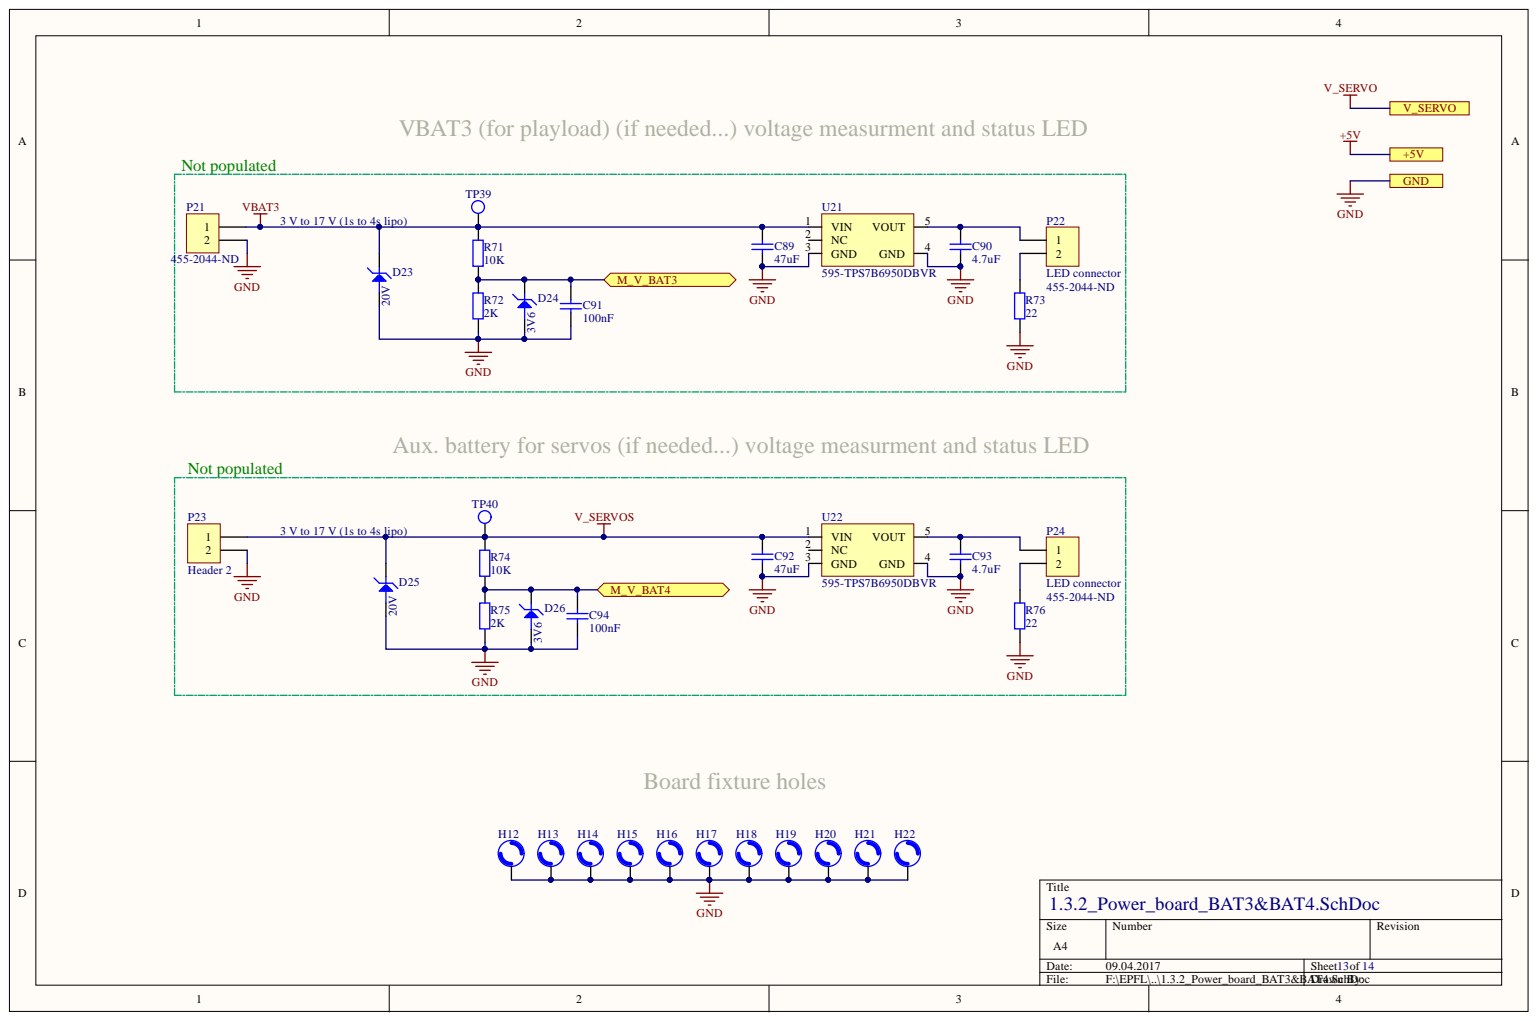
[picture p295: page 13]

VBAT3 (for playload) (if needed...) voltage measurment and status LED

Aux. battery for servos (if needed...) voltage measurment and status LED

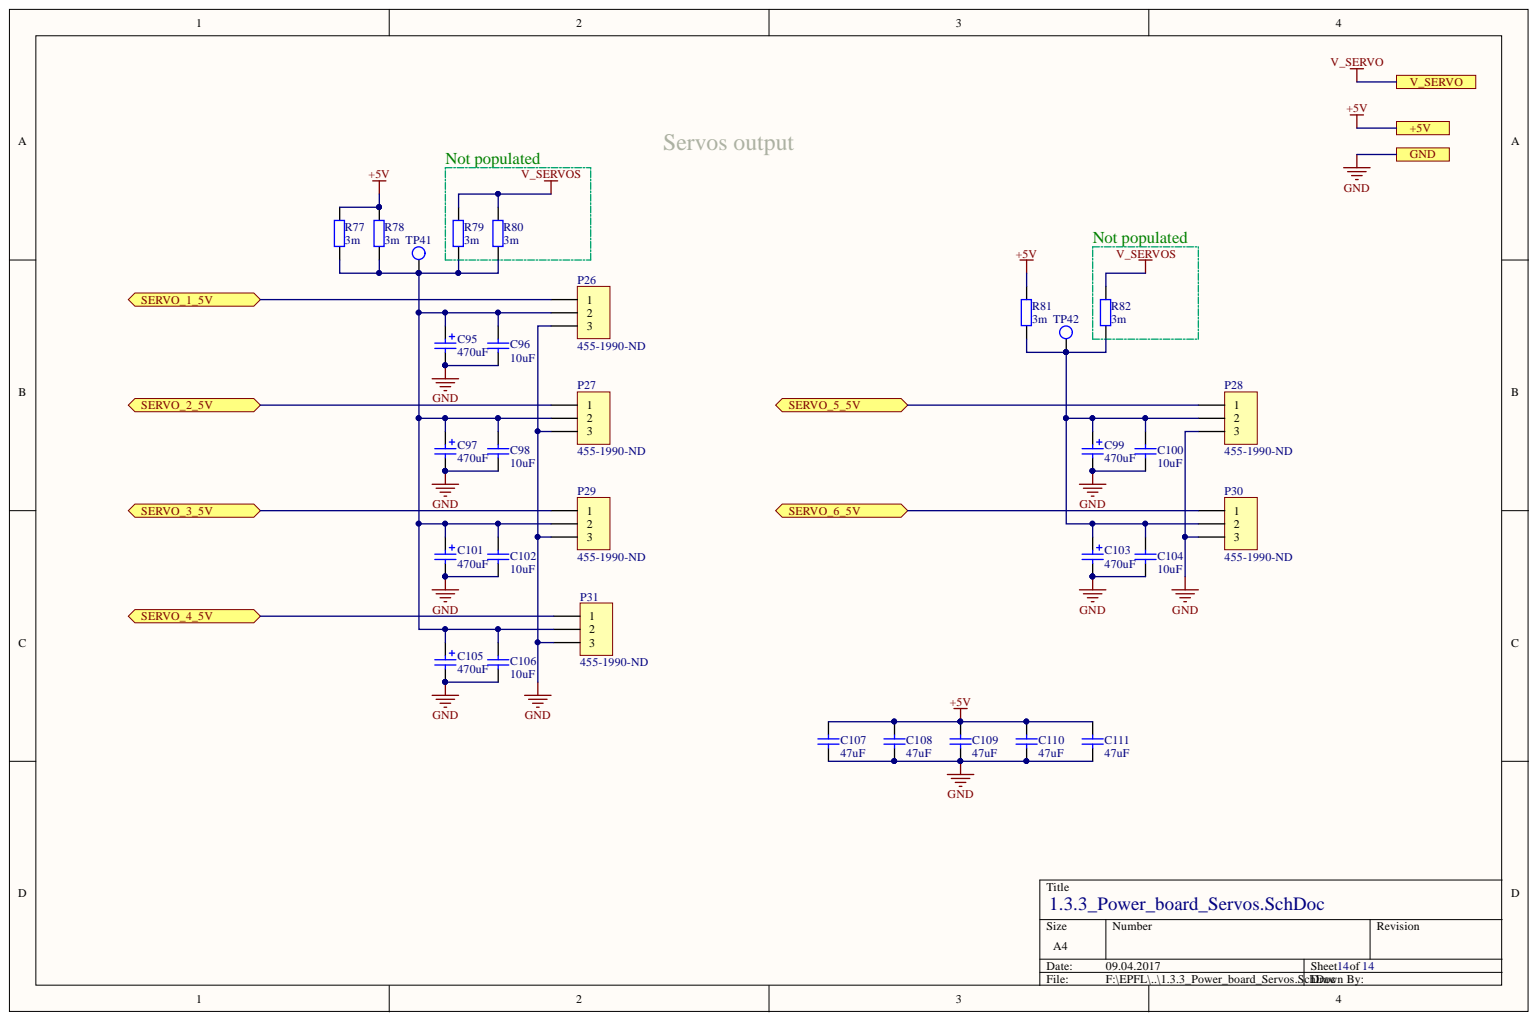
[picture p296: page 14]
