irec-duster/RORO/Avionics_RORO/Altium/Project/Rocket_PCB_Project_2017_Power_board/Rocket_PCB_Project_2017_Interface_board.pdf

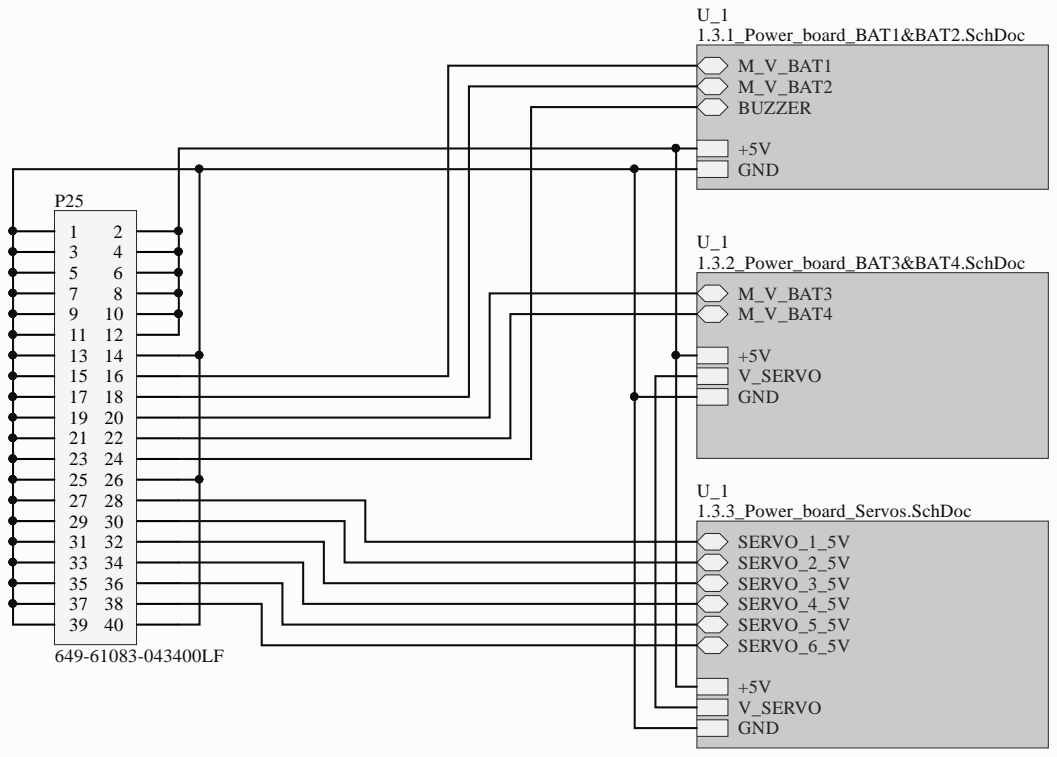
[picture p297: page 1]

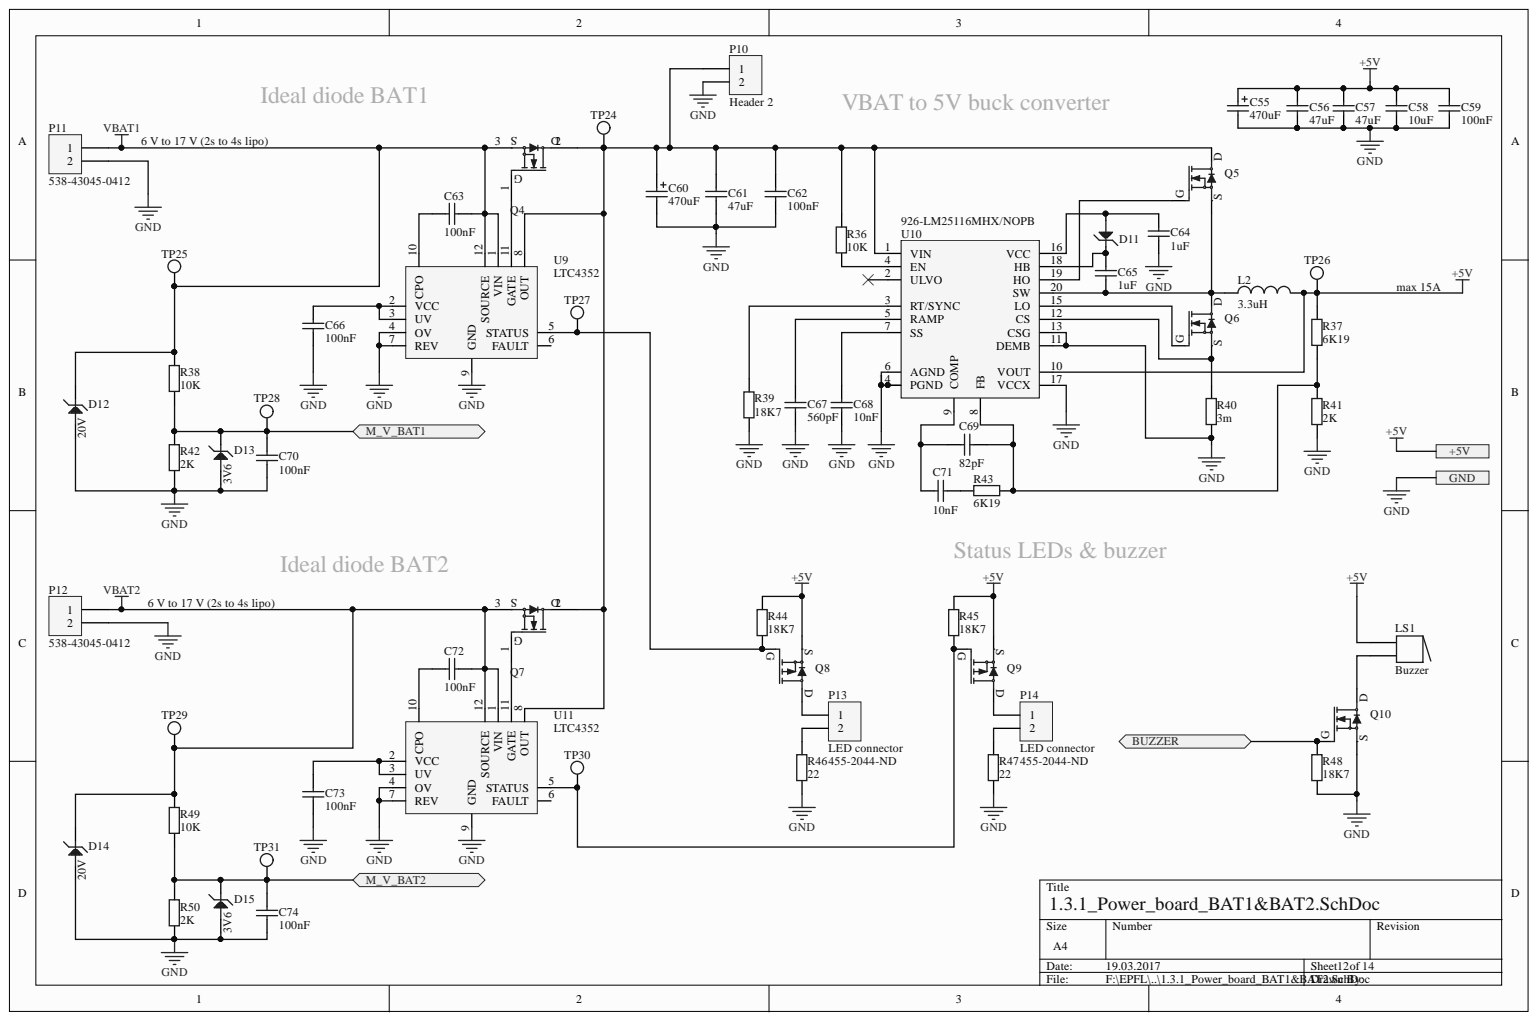
[picture p298: page 2]

VBAT to 5V buck converter

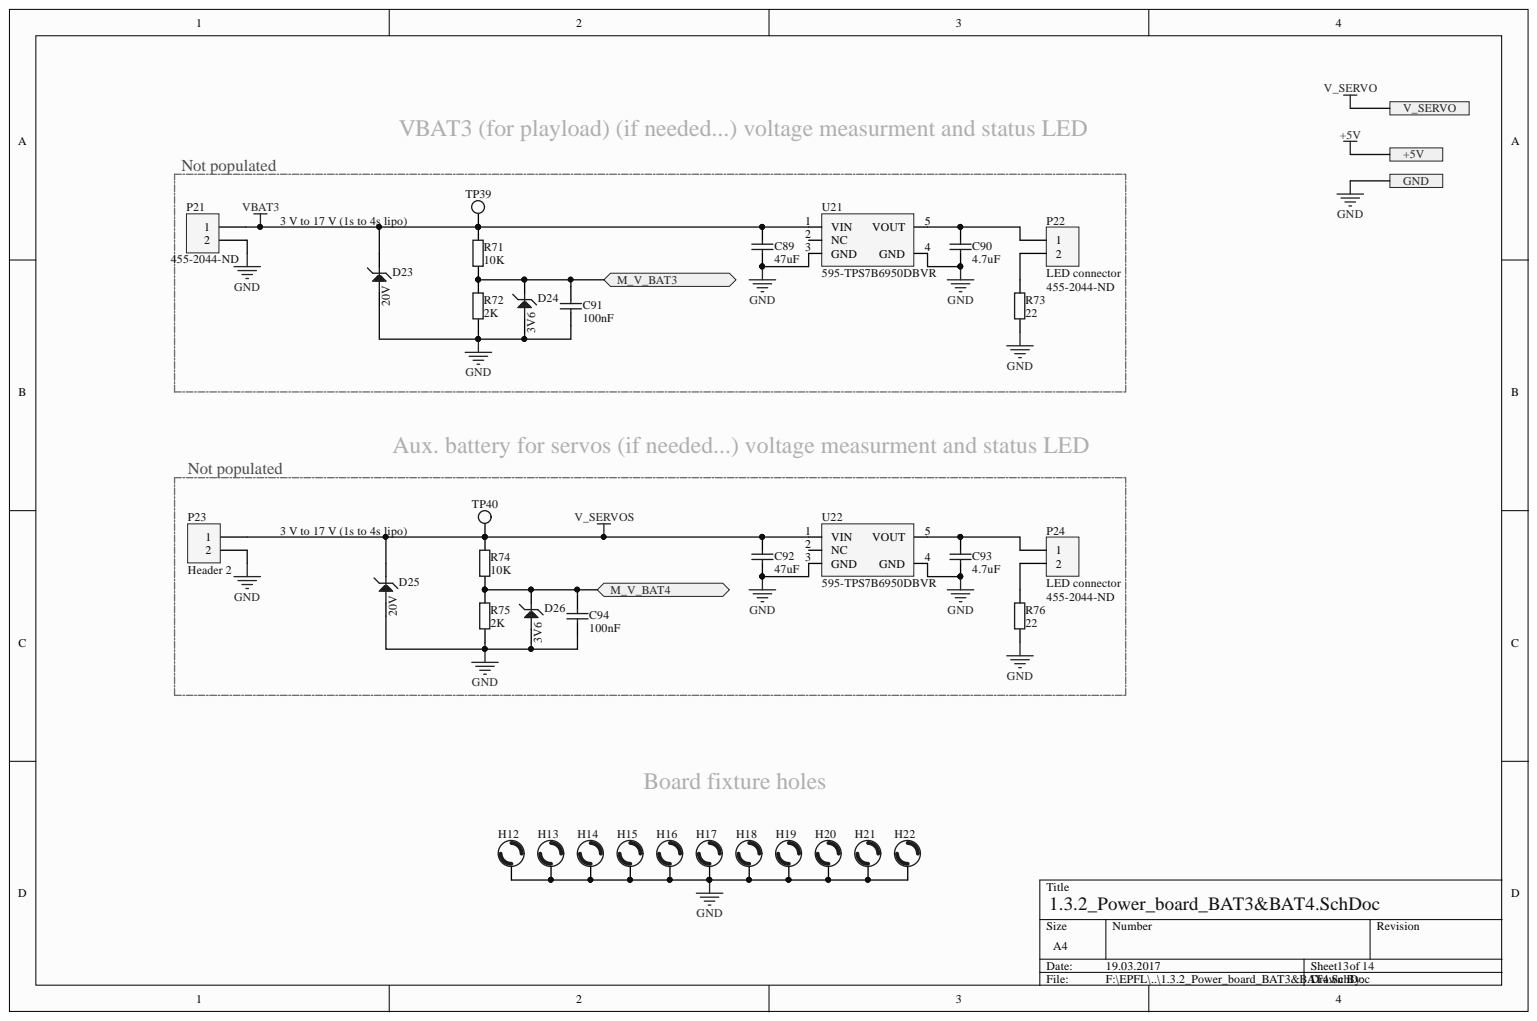
[picture p299: page 3]

VBAT3 (for playload) (if needed...) voltage measurment and status LED

Aux. battery for servos (if needed...) voltage measurment and status LED

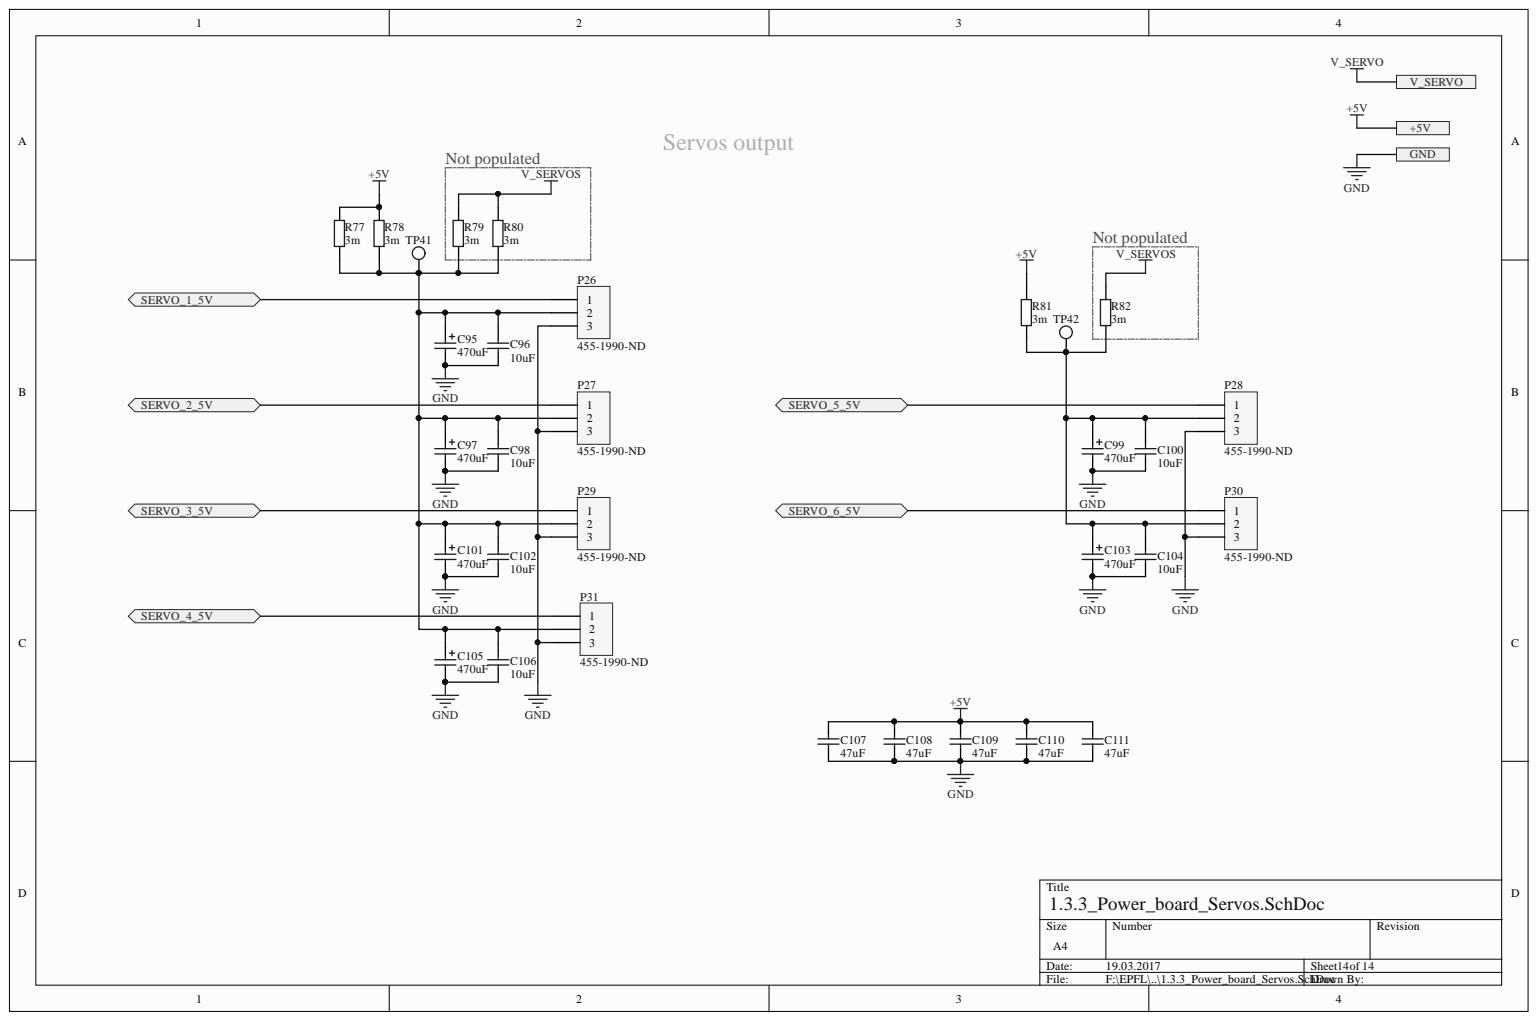
[picture p300: page 4]

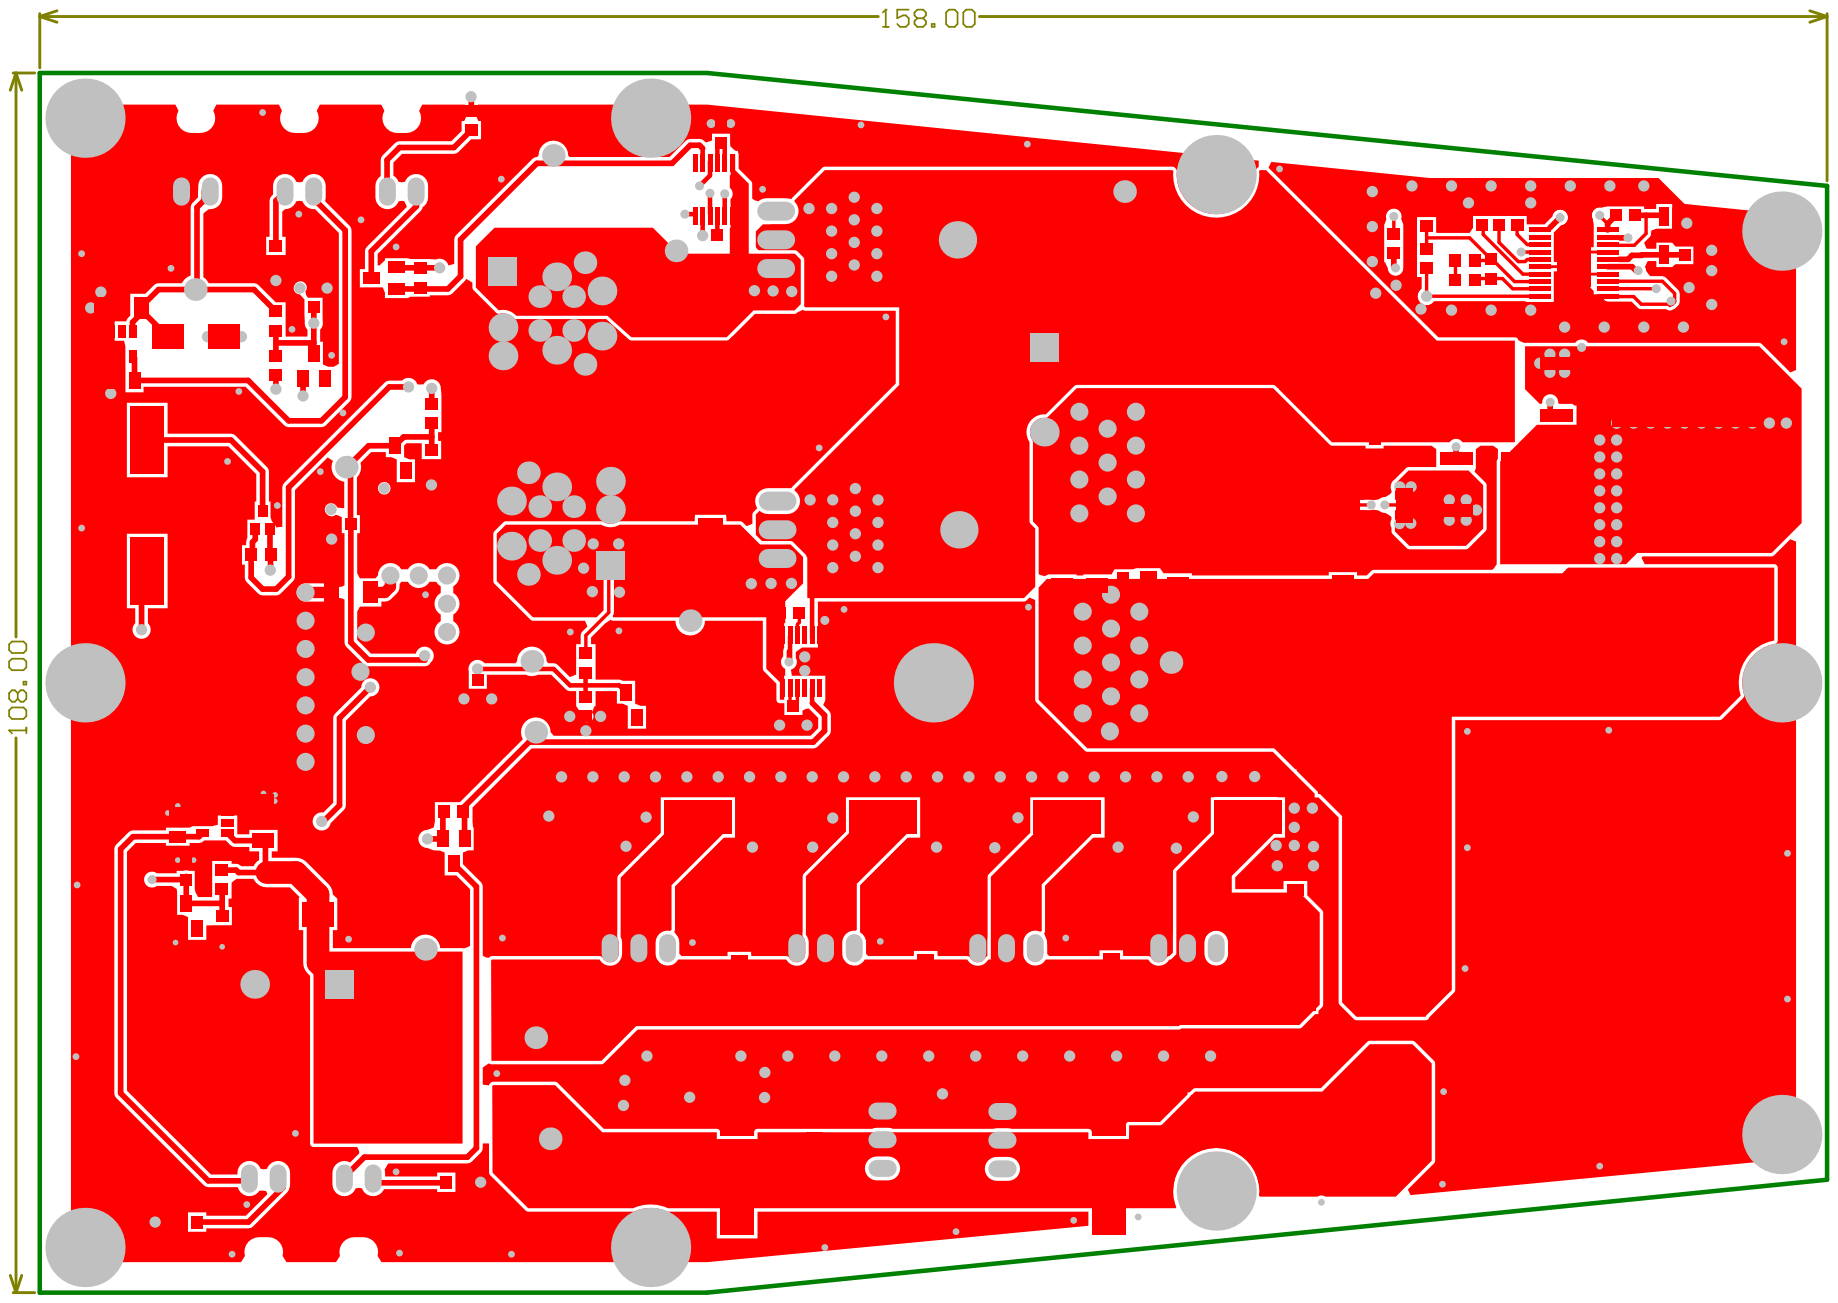
[picture p301: page 5]

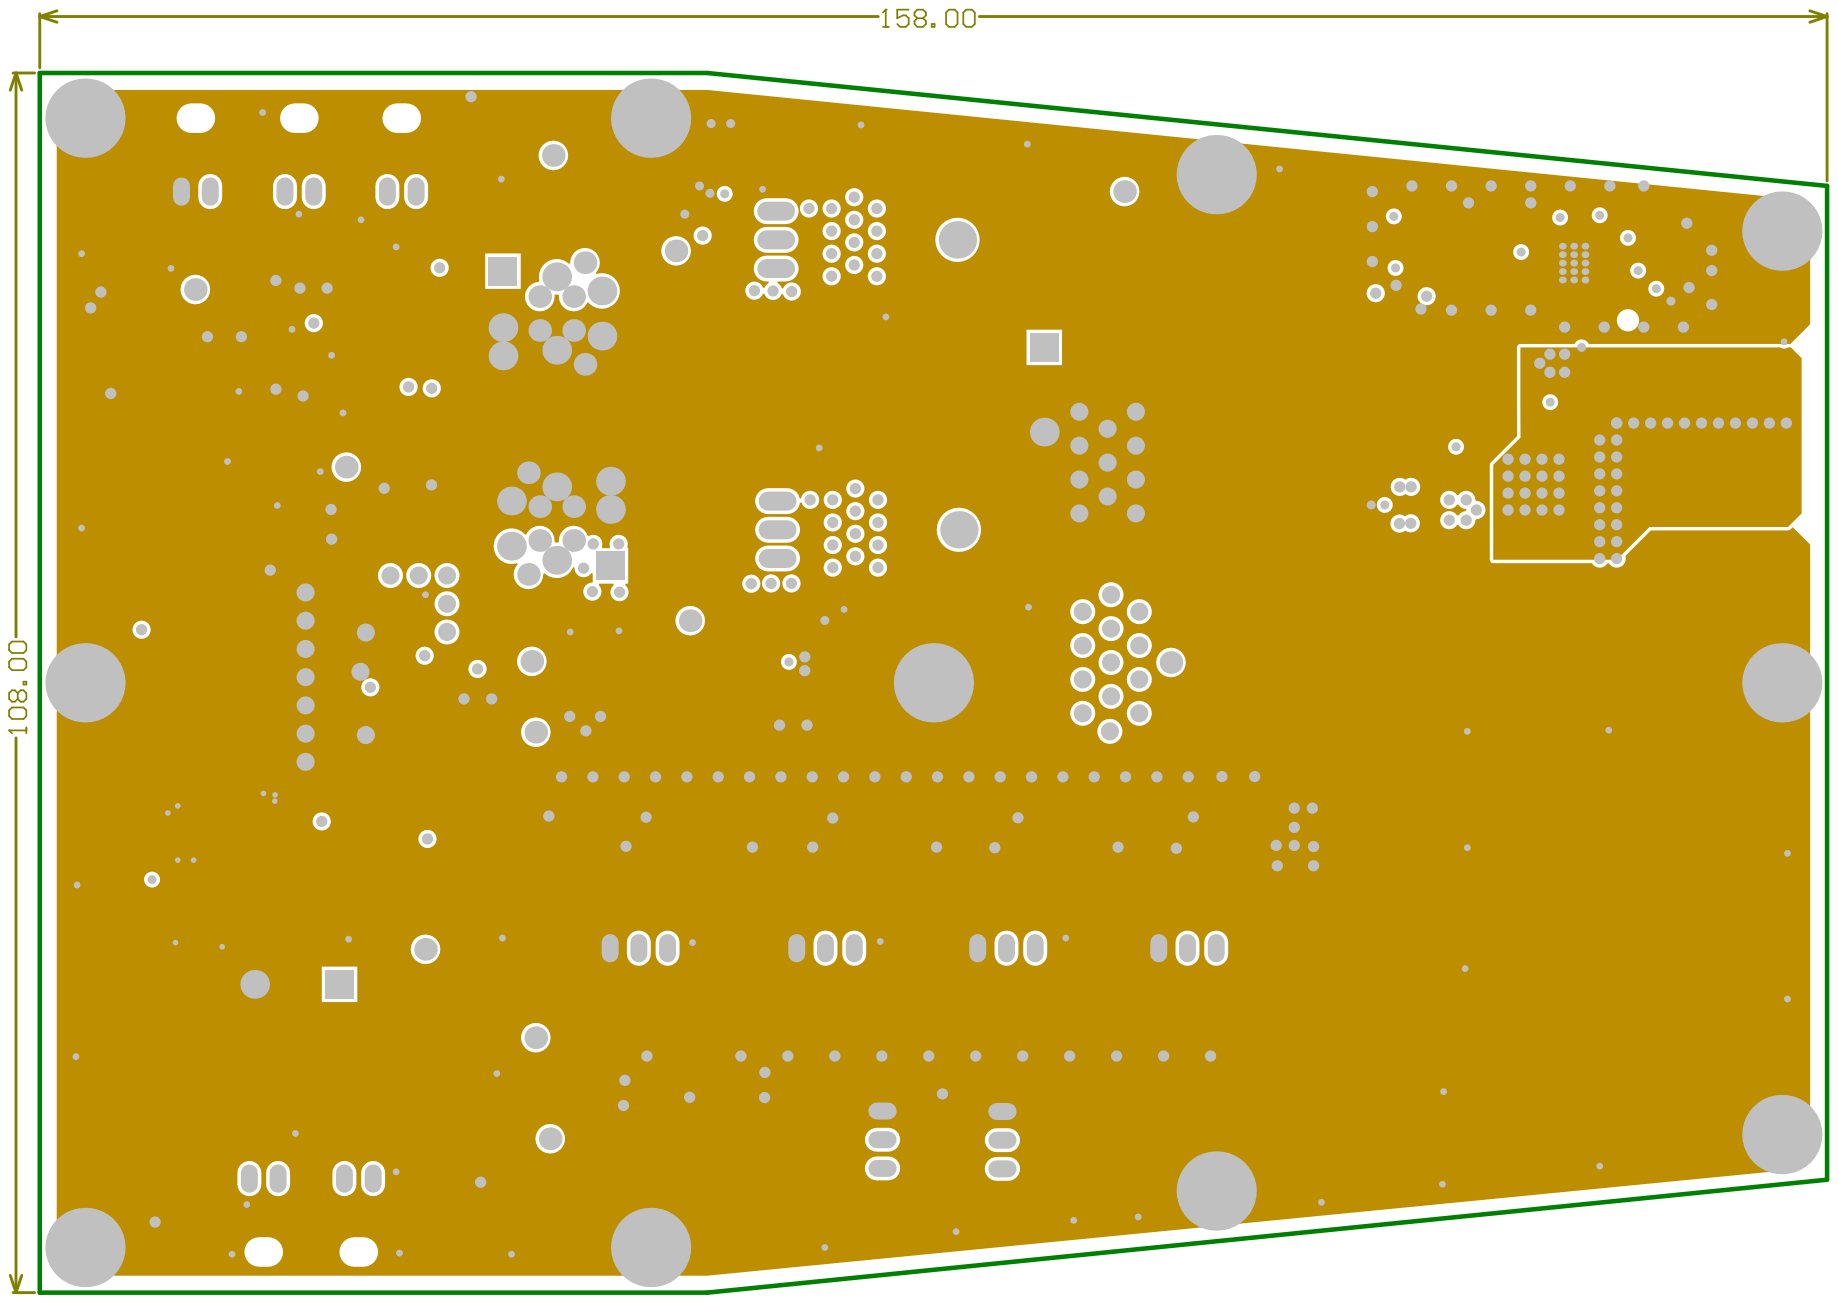
[picture p302: page 6]

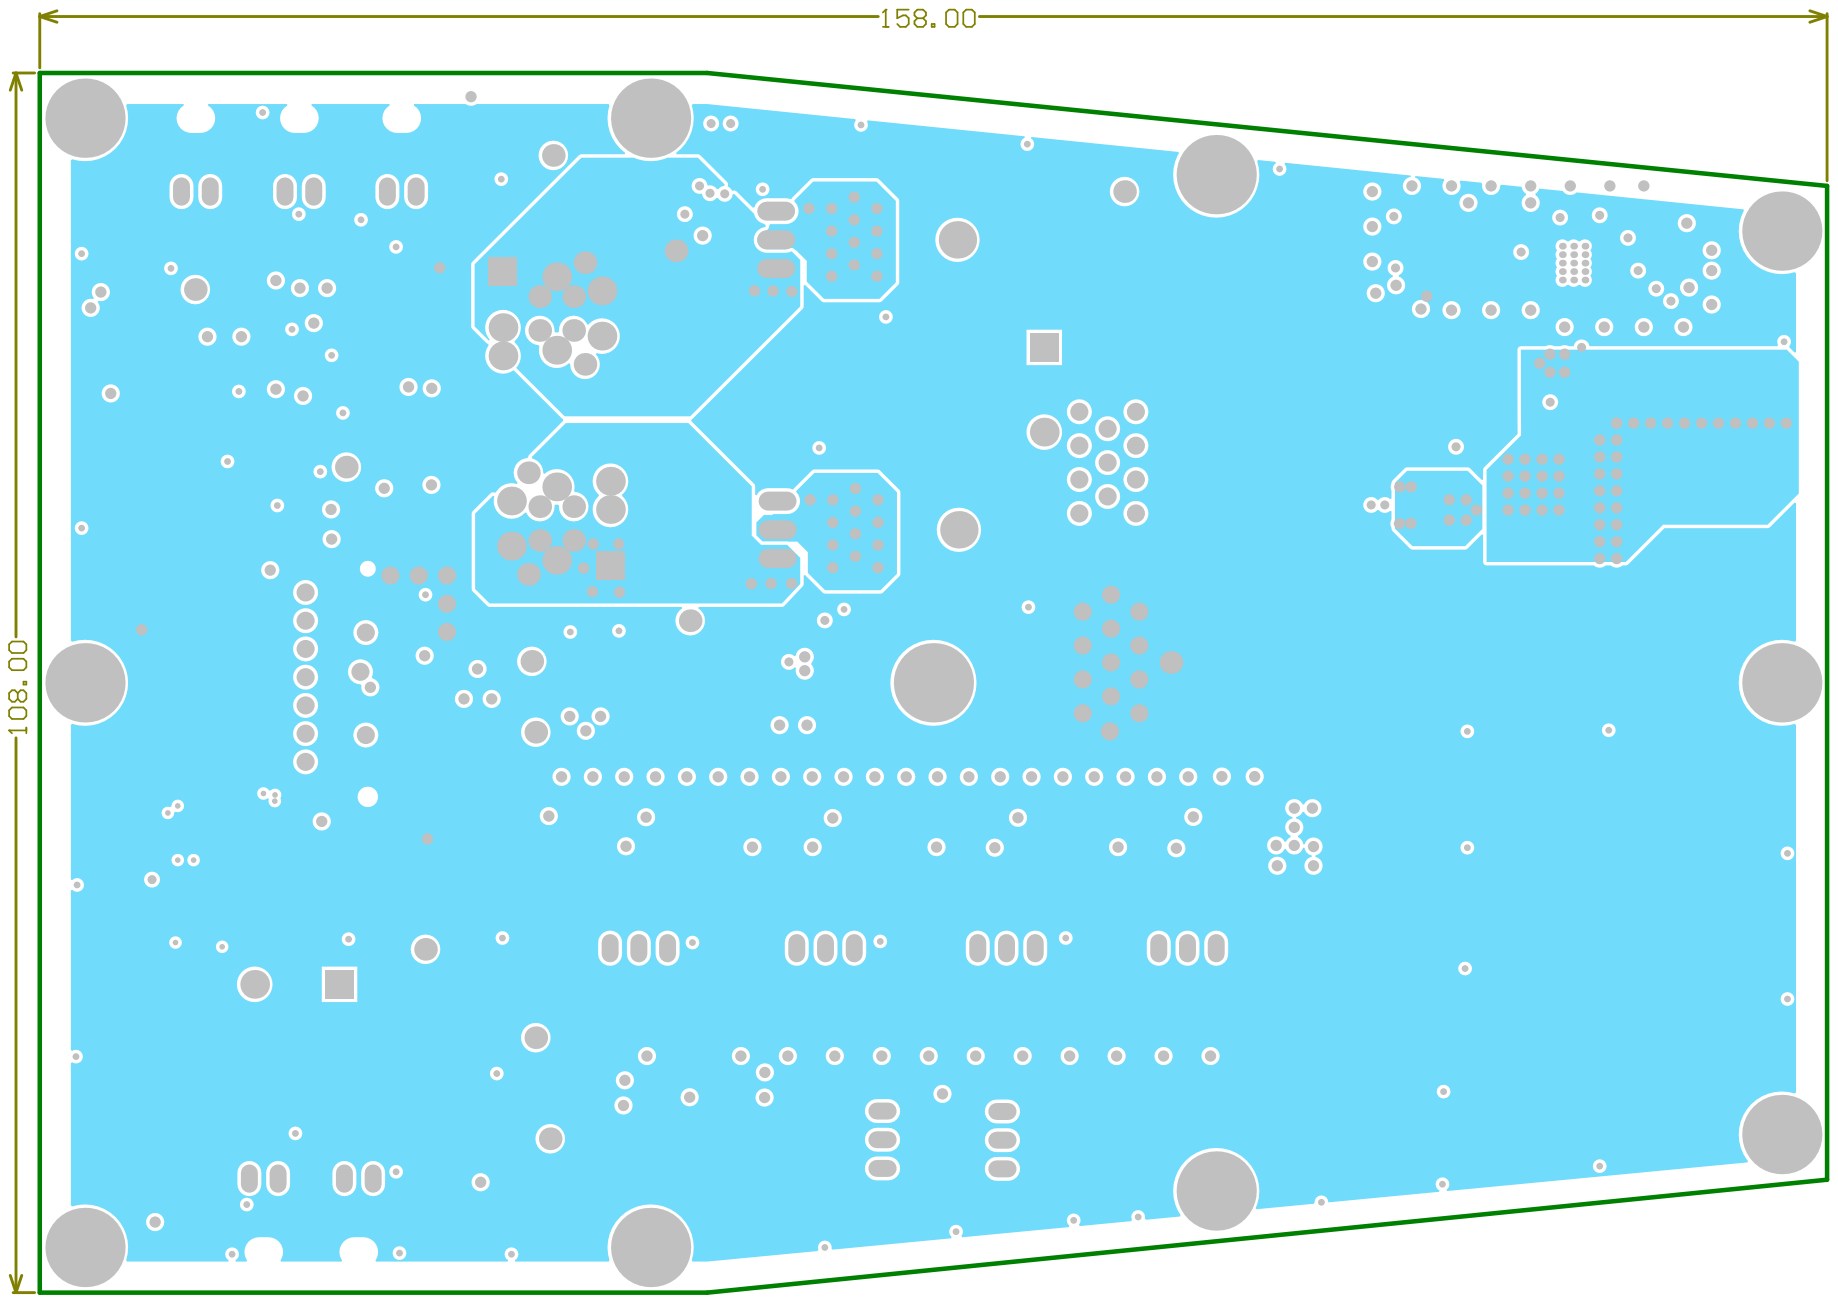
[picture p303: page 7]

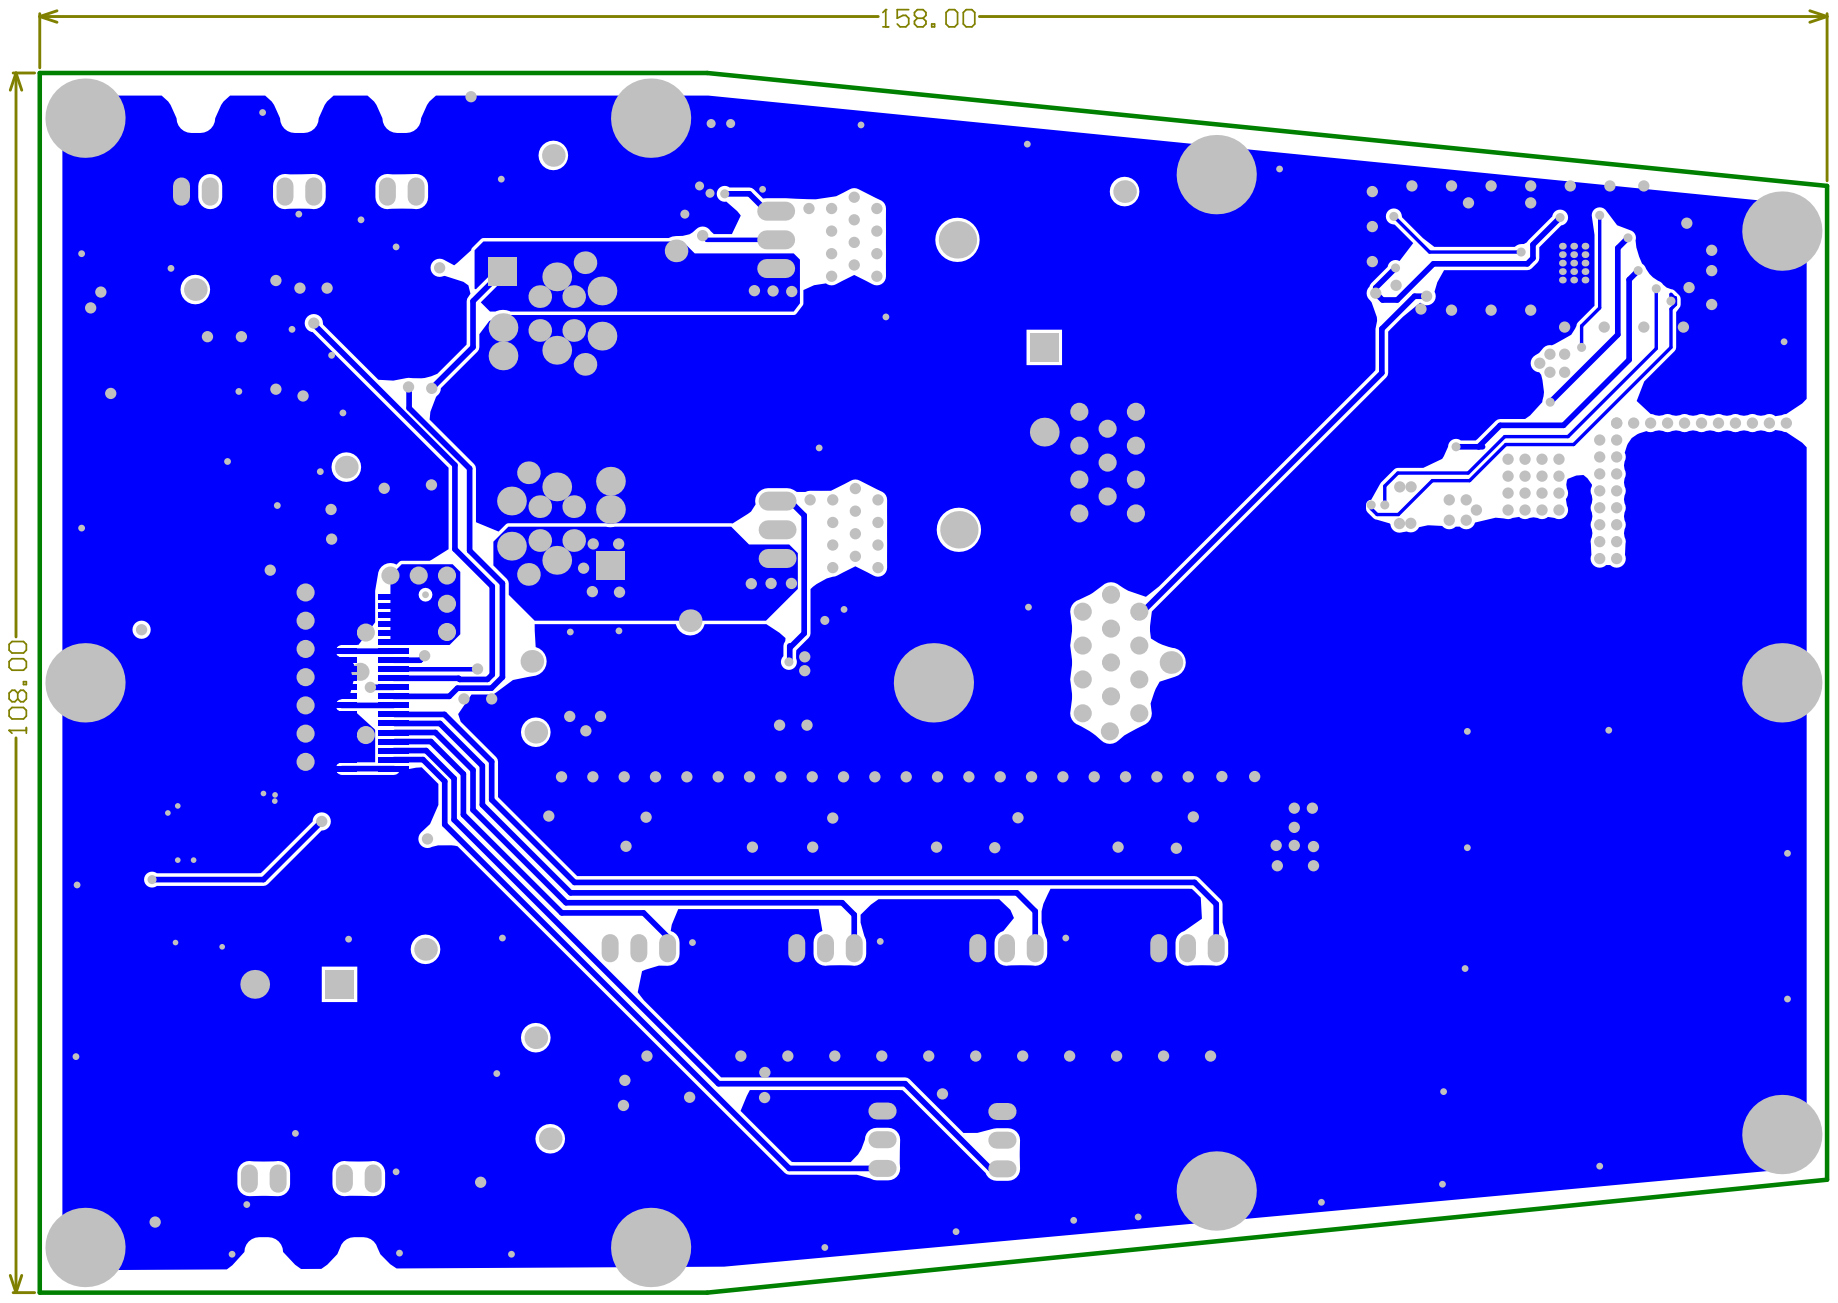
[picture p304: page 8]

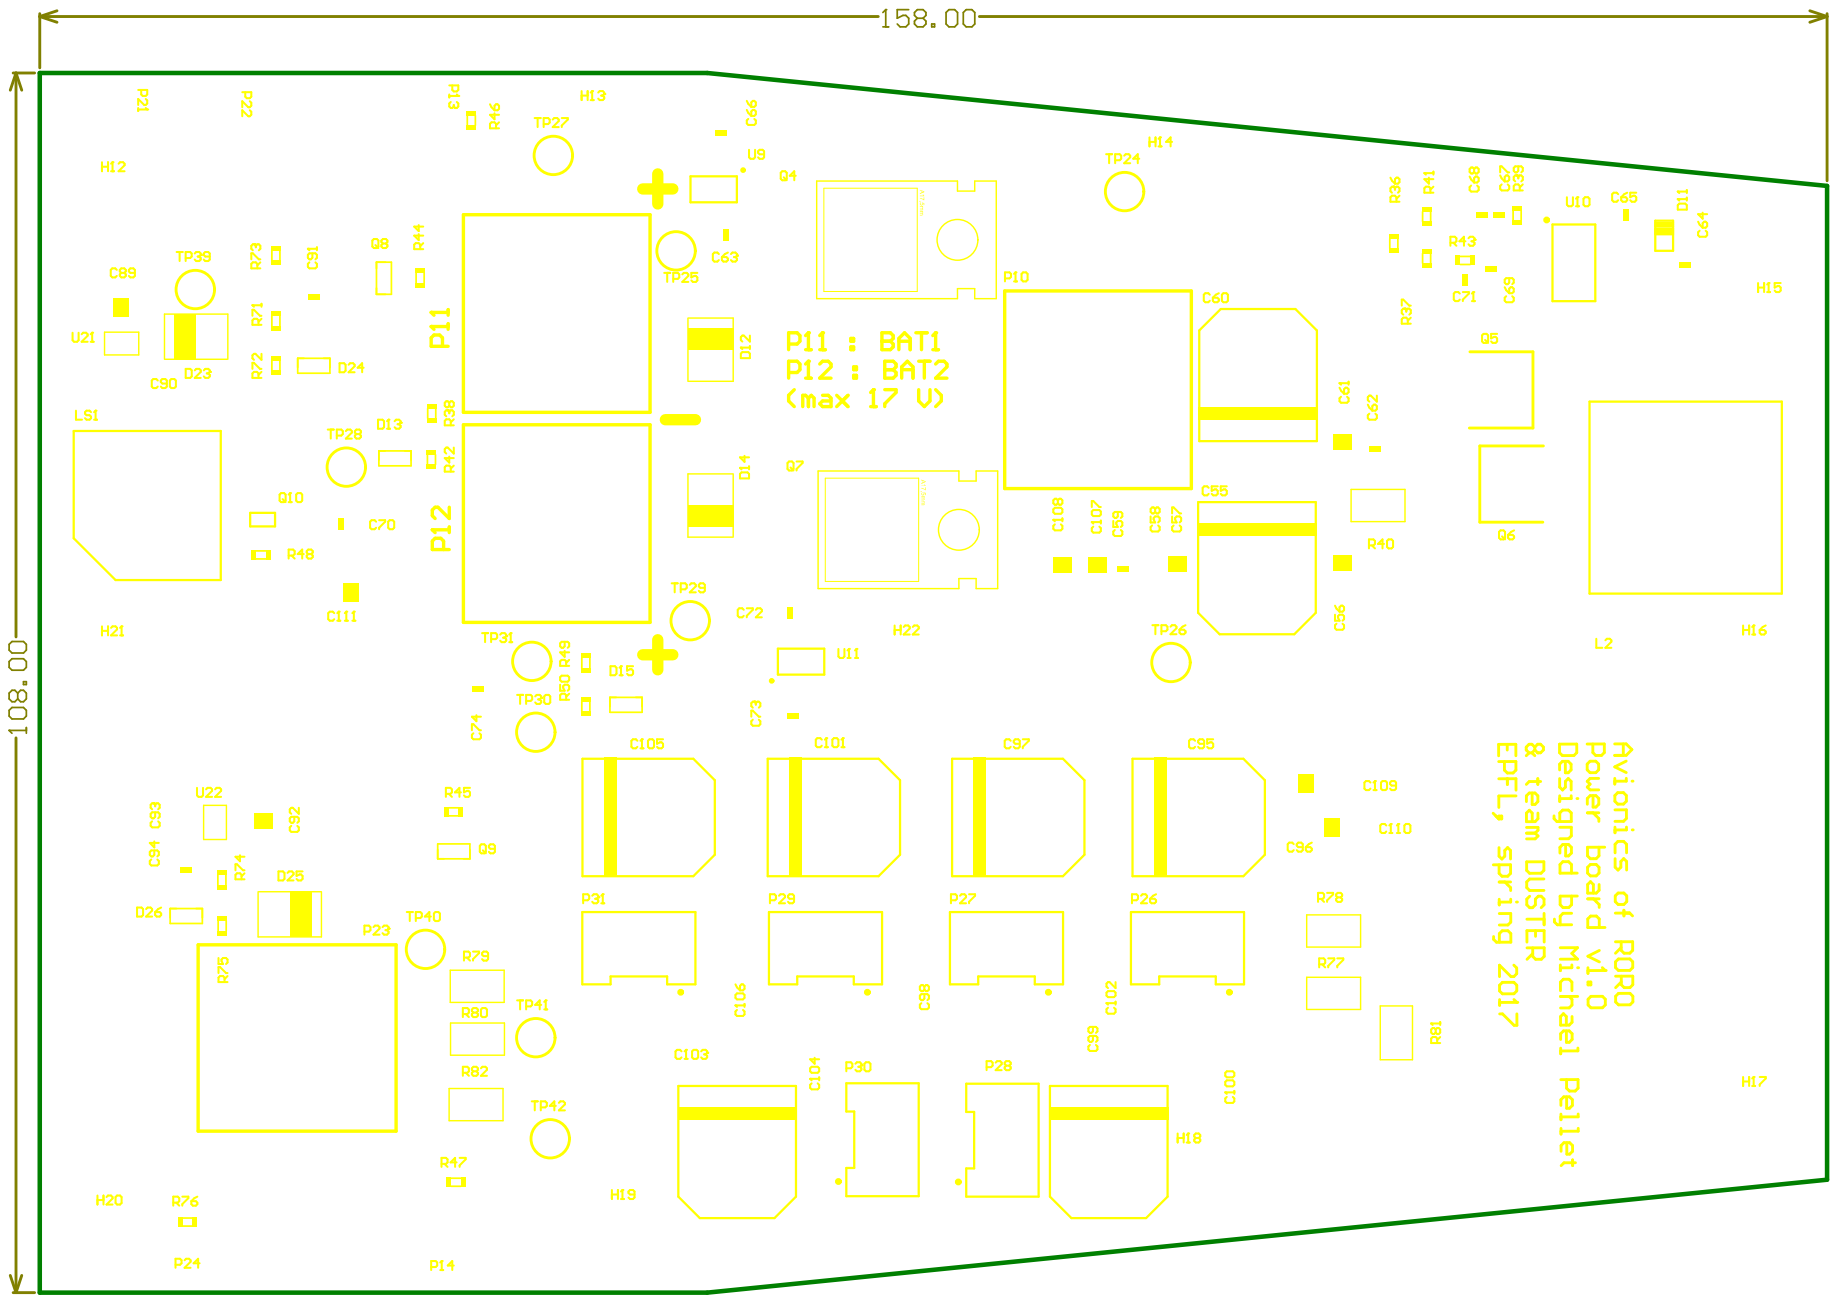
[picture p305: page 9]

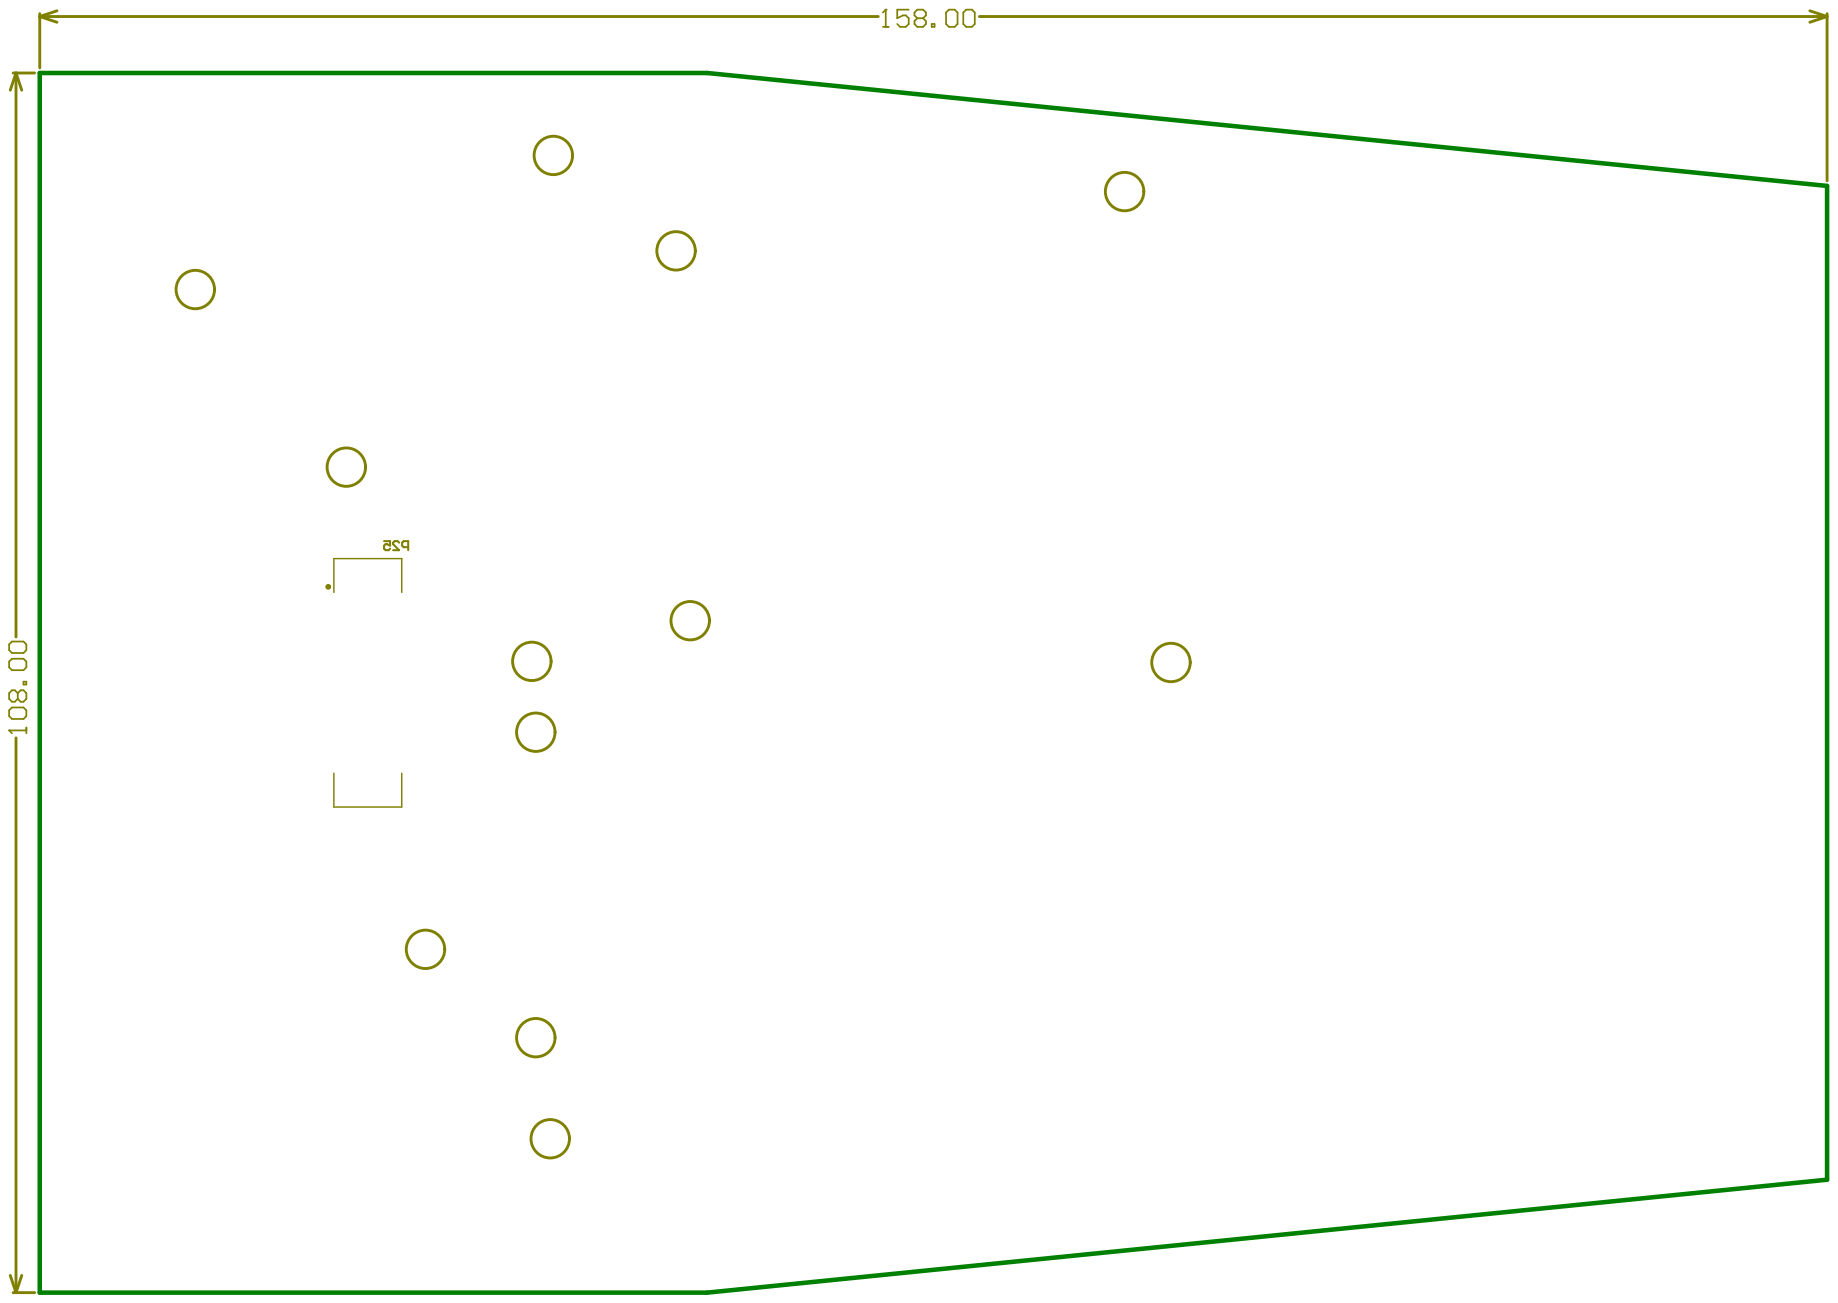
[picture p306: page 10]

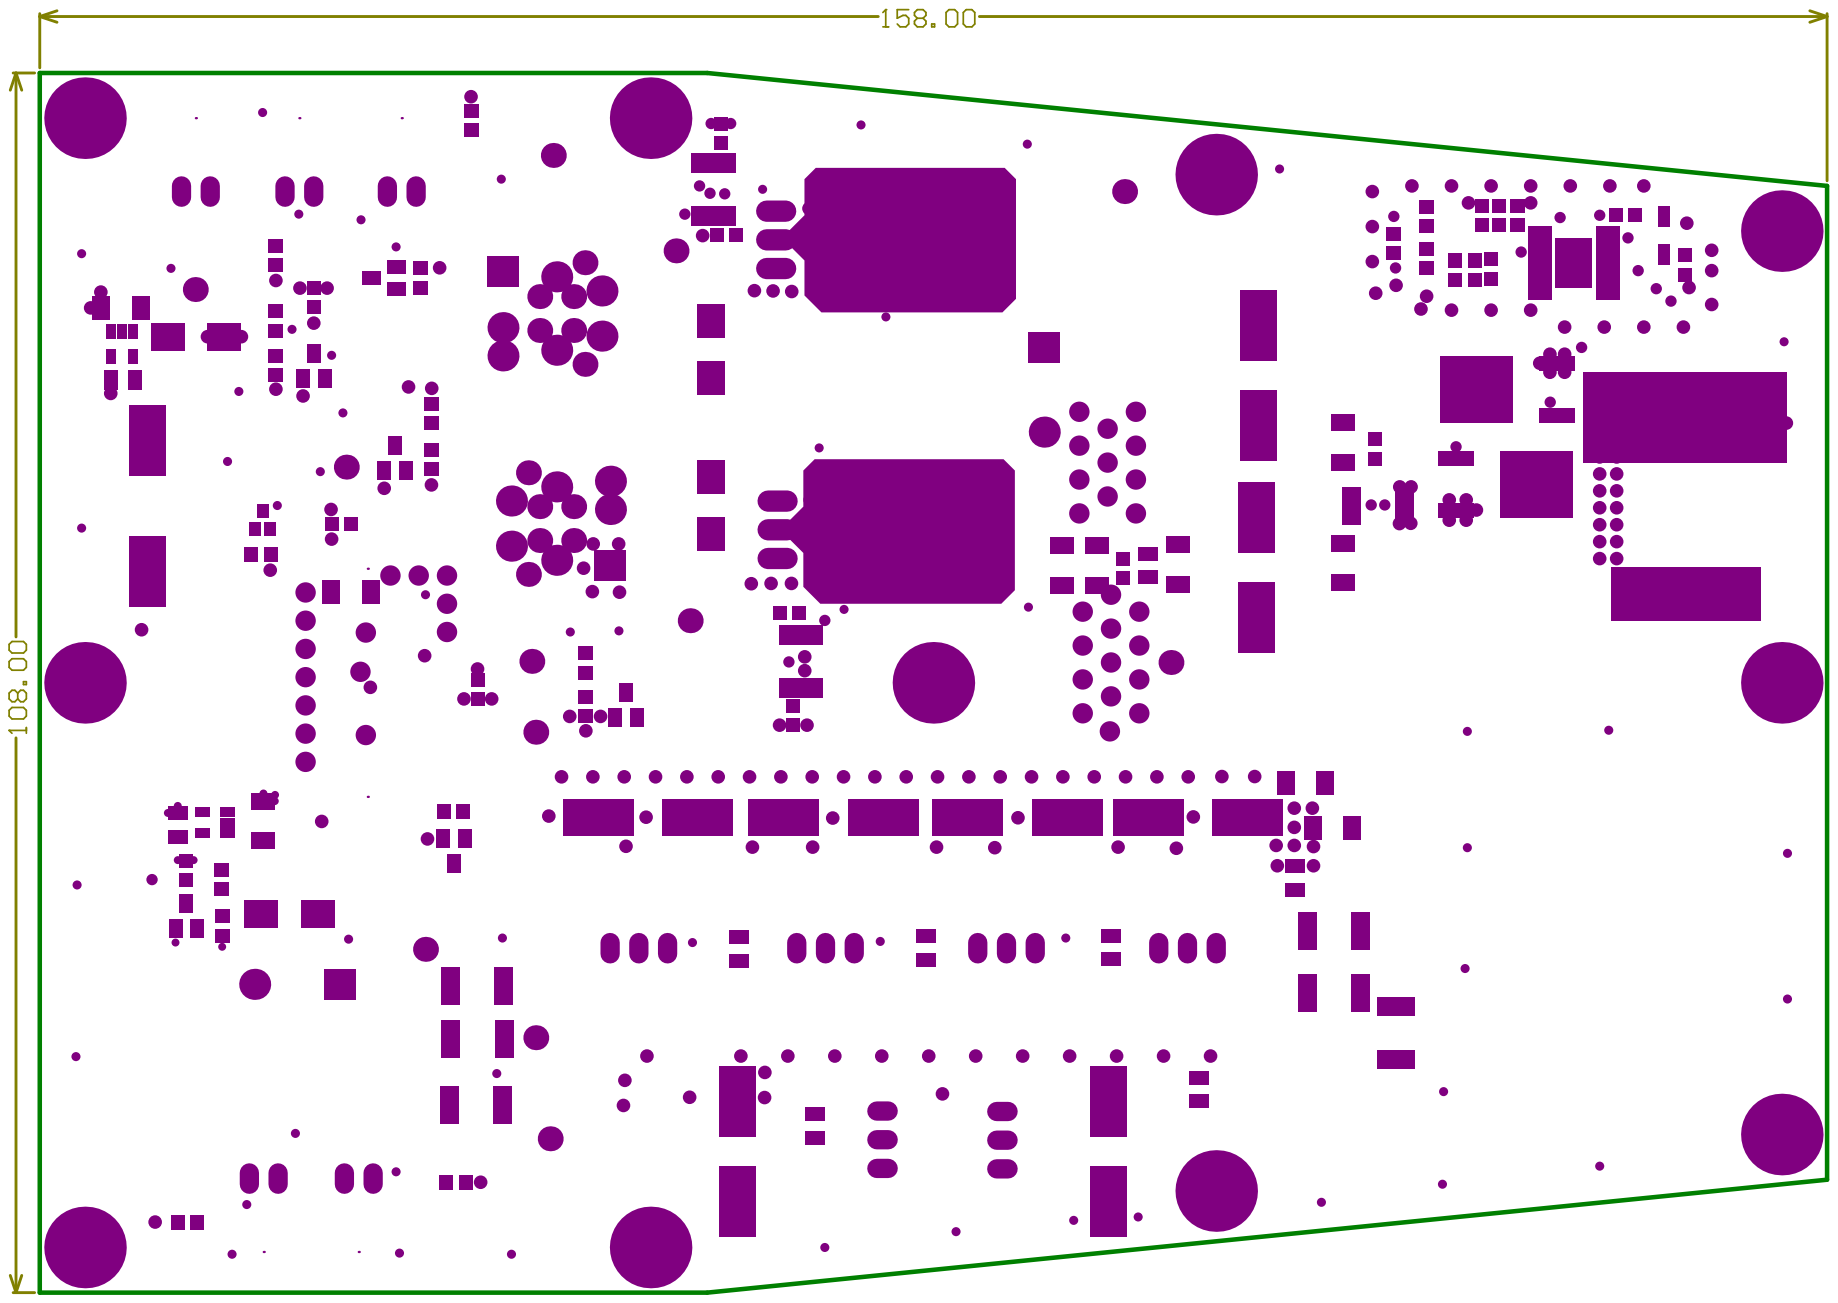
[picture p307: page 11]

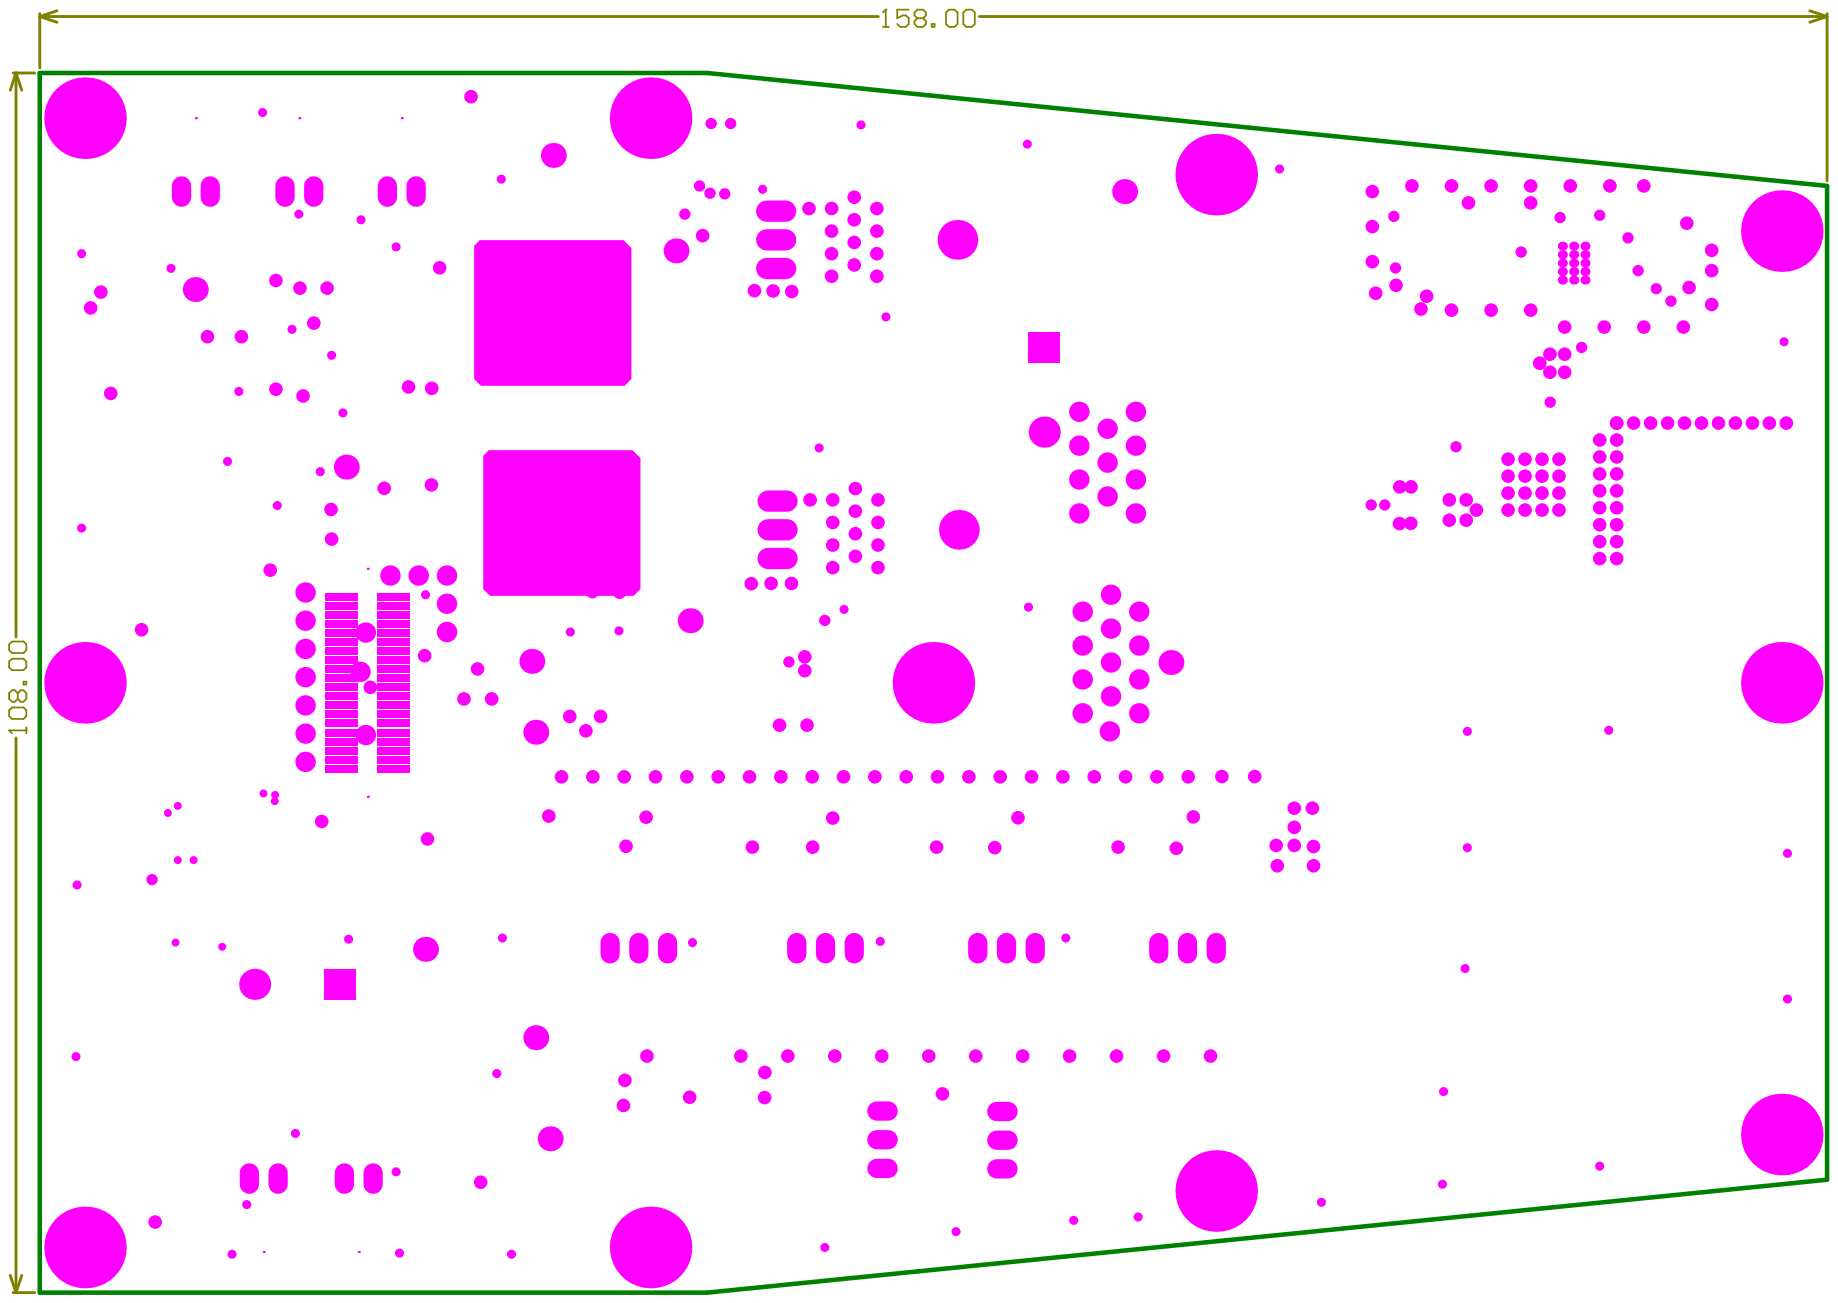
[picture p308: page 12]

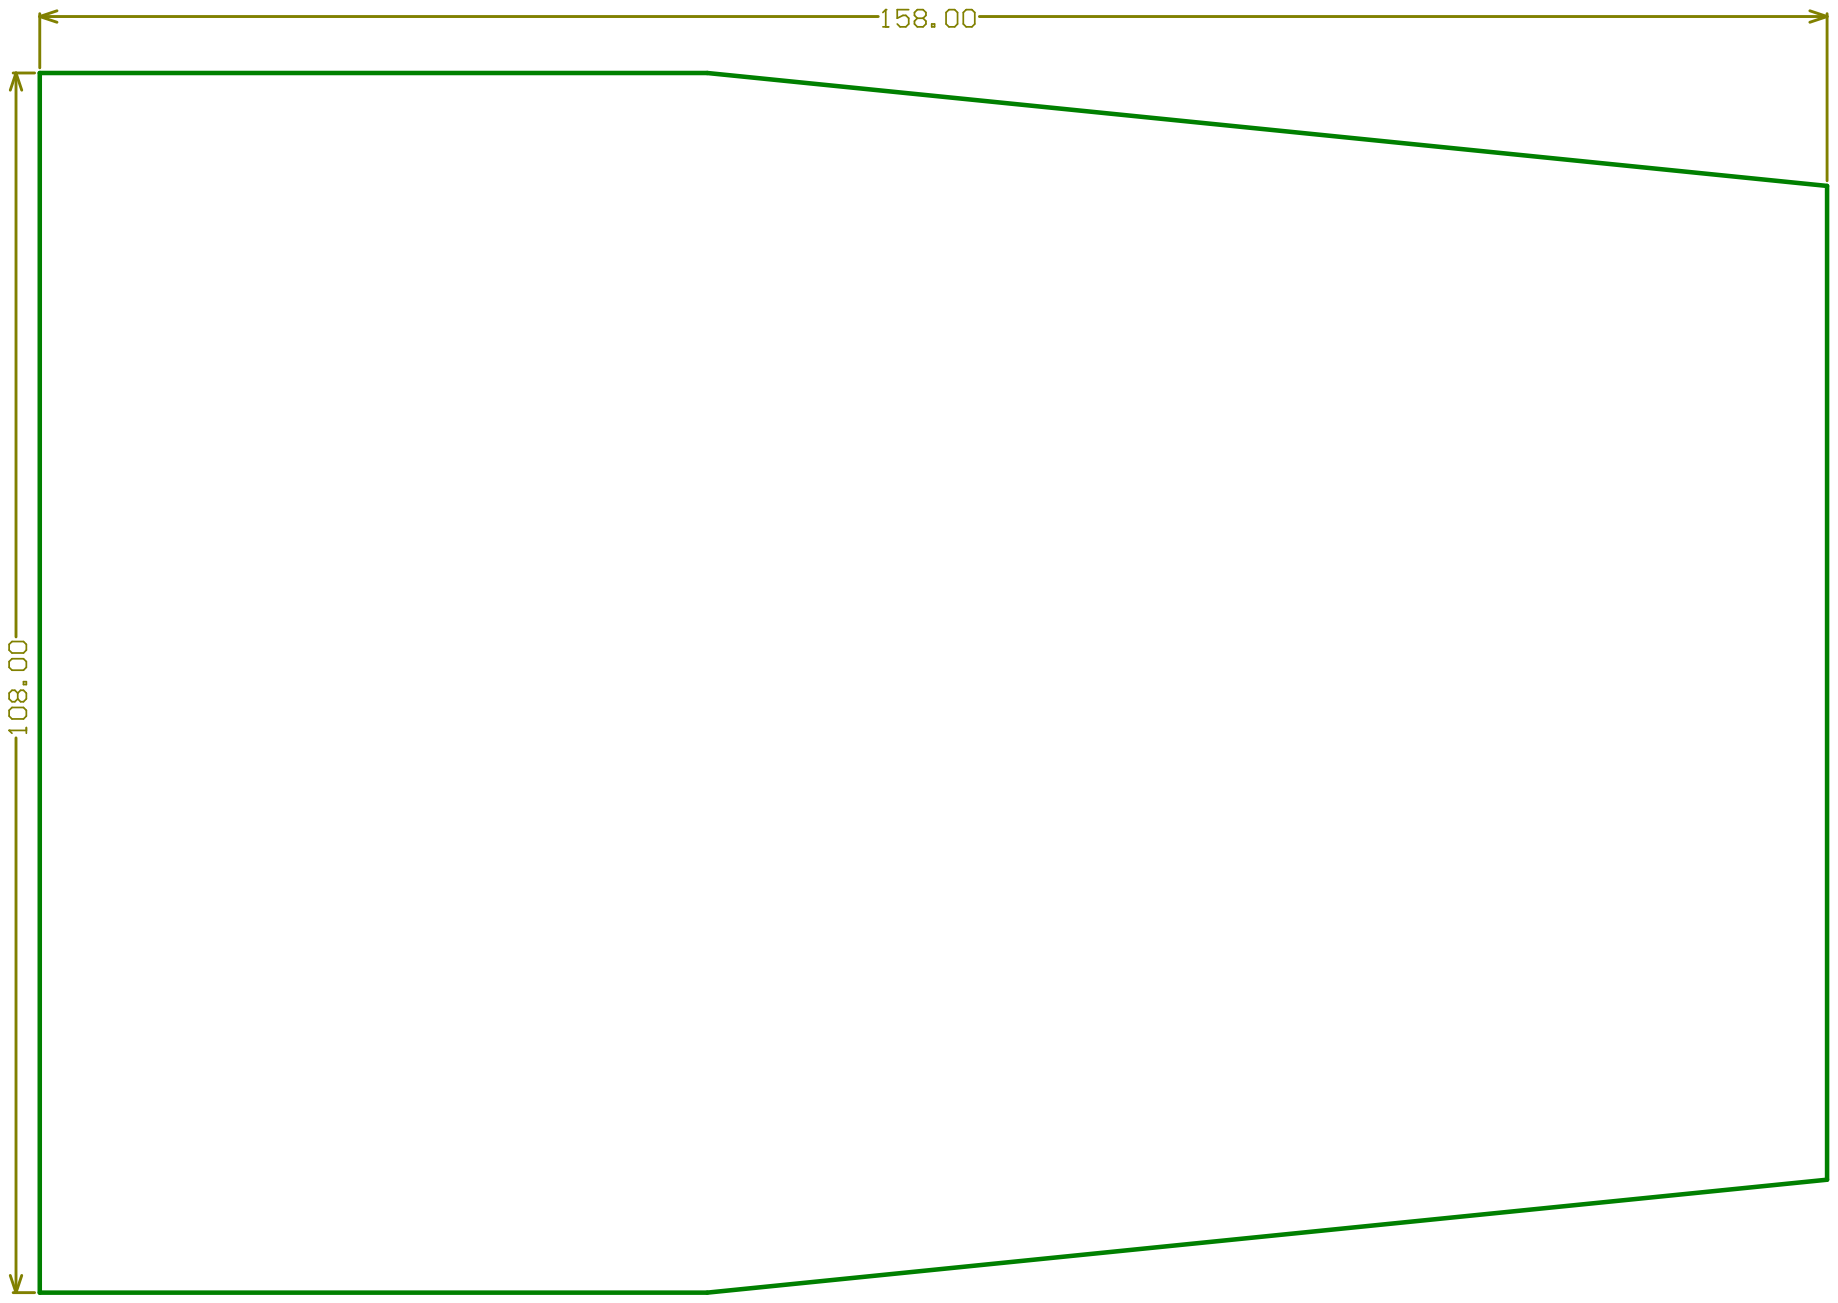
[picture p309: page 13]

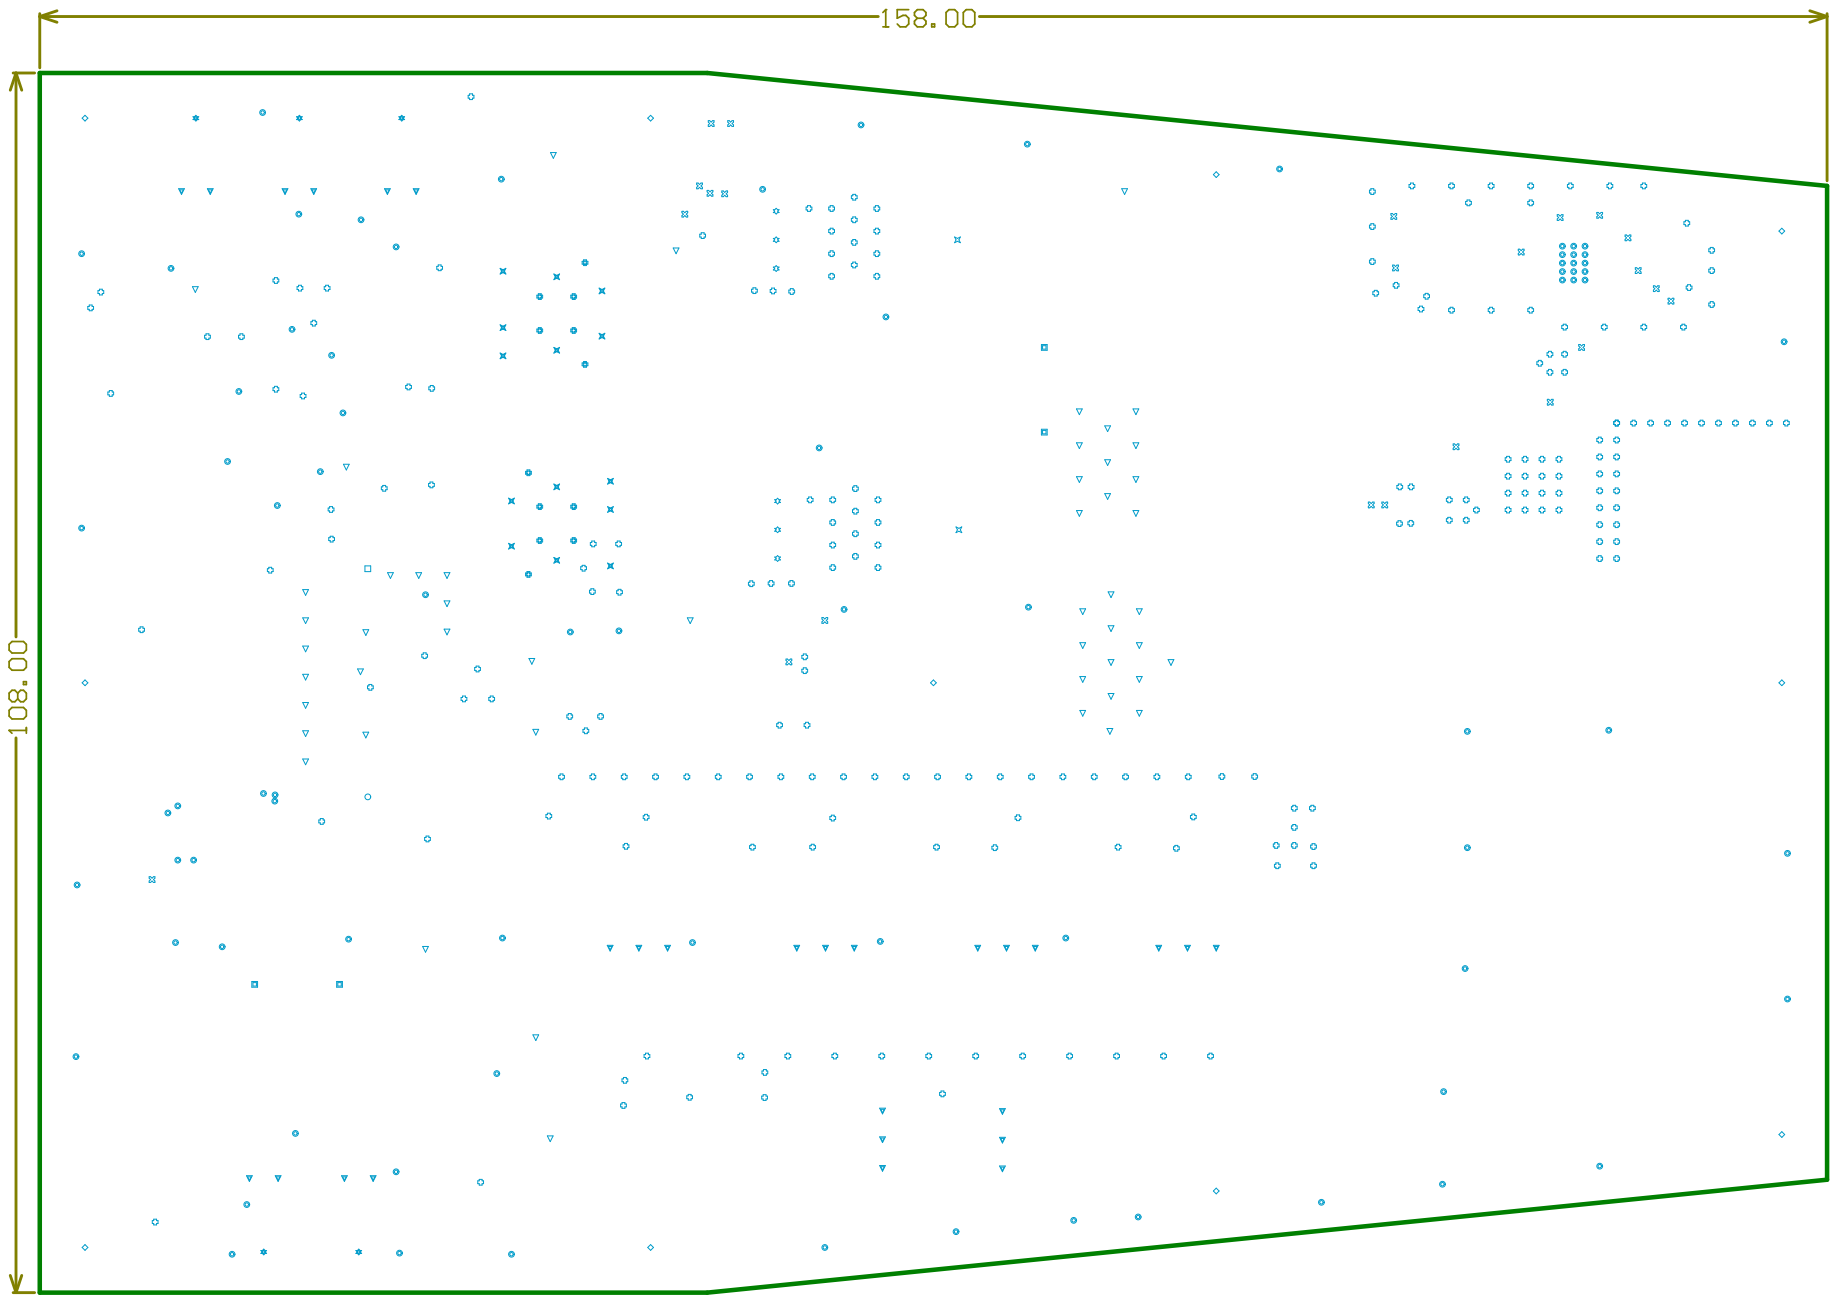
[picture p310: page 14]
