irec-duster/RORO/Avionics_RORO/CAD/Nosecone/Drawing/3003_Control_panel.PDF

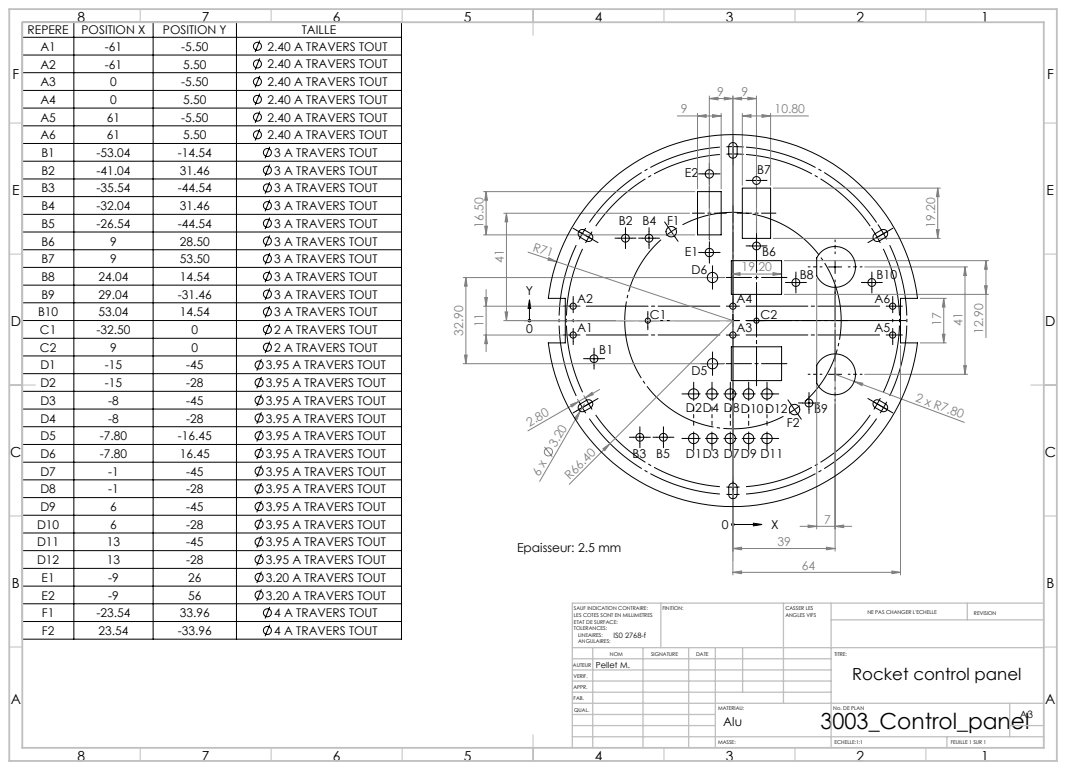
[picture p311: page 1]

REPERE | POSITION X | POSITION Y | TAILLE | | 9 9
A1 | -61 | -5.50 | 2.40 A TRAVERS TOUT
A2 | -61 | 5.50 | 2.40 A TRAVERS TOUT
A3 | 0 | -5.50 | 2.40 A TRAVERS TOUT
A4 | 0 | 5.50 | 2.40 A TRAVERS TOUT
A5 | 61 | -5.50 | 2.40 A TRAVERS TOUT
A6 | 61 | 5.50 | 2.40 A TRAVERS TOUT
B1 | -53.04 | -14.54 | 3 A TRAVERS TOUT
B2 | -41.04 | 31.46 | 3 A TRAVERS TOUT
B3 | -35.54 | -44.54 | 3 A TRAVERS TOUT
B4 | -32.04 | 31.46 | 3 A TRAVERS TOUT
B5 | -26.54 | -44.54 | 3 A TRAVERS TOUT
B6 | 9 | 28.50 | 3 A TRAVERS TOUT
B7 | 9 | 53.50 | 3 A TRAVERS TOUT
B8 | 24.04 | 14.54 | 3 A TRAVERS TOUT
B9 | 29.04 | -31.46 | 3 A TRAVERS TOUT
B10 | 53.04 | 14.54 | 3 A TRAVERS TOUT
C1 | -32.50 | 0 | 2 A TRAVERS TOUT
C2 | 9 | 0 | 2 A TRAVERS TOUT
D1 | -15 | -45 | 3.95 A TRAVERS TOUT
D2 | -15 | -28 | 3.95 A TRAVERS TOUT
D3 | -8 | -45 | 3.95 A TRAVERS TOUT

D4 | -8 | -28 | 3.95 A TRAVERS TOUT
D5 | -7.80 | -16.45 | 3.95 A TRAVERS TOUT
D6 | -7.80 | 16.45 | 3.95 A TRAVERS TOUT
D7 | -1 | -45 | 3.95 A TRAVERS TOUT
D8 | -1 | -28 | 3.95 A TRAVERS TOUT
D9 | 6 | -45 | 3.95 A TRAVERS TOUT

E1 | -9 | 26 | 3.20 A TRAVERS TOUT
E2 | -9 | 56 | 3.20 A TRAVERS TOUT

SAUF INDICATION CONTRAIRE:
LES COTES SONT EN MILLIMETRES
ETAT DE SURFACE:
TOLERANCES:
LINEAIRES:
ANGULAIRES:

NOM | SIGNATURE | DATE | | | | TITRE: Rocket control panel

AUTEUR | Pellet M.
VERIF.
APPR.
FAB.
QUAL. | | | | MATERIAU: 3003_Control_panel Alu | No. DE PLAN | A3
