irec-duster/RORO/Avionics_RORO/Altium/Project/Rocket_PCB_Project_2017_Power_board/Rocket_PCB_Project_2017_Power_board_DRAFT.pdf

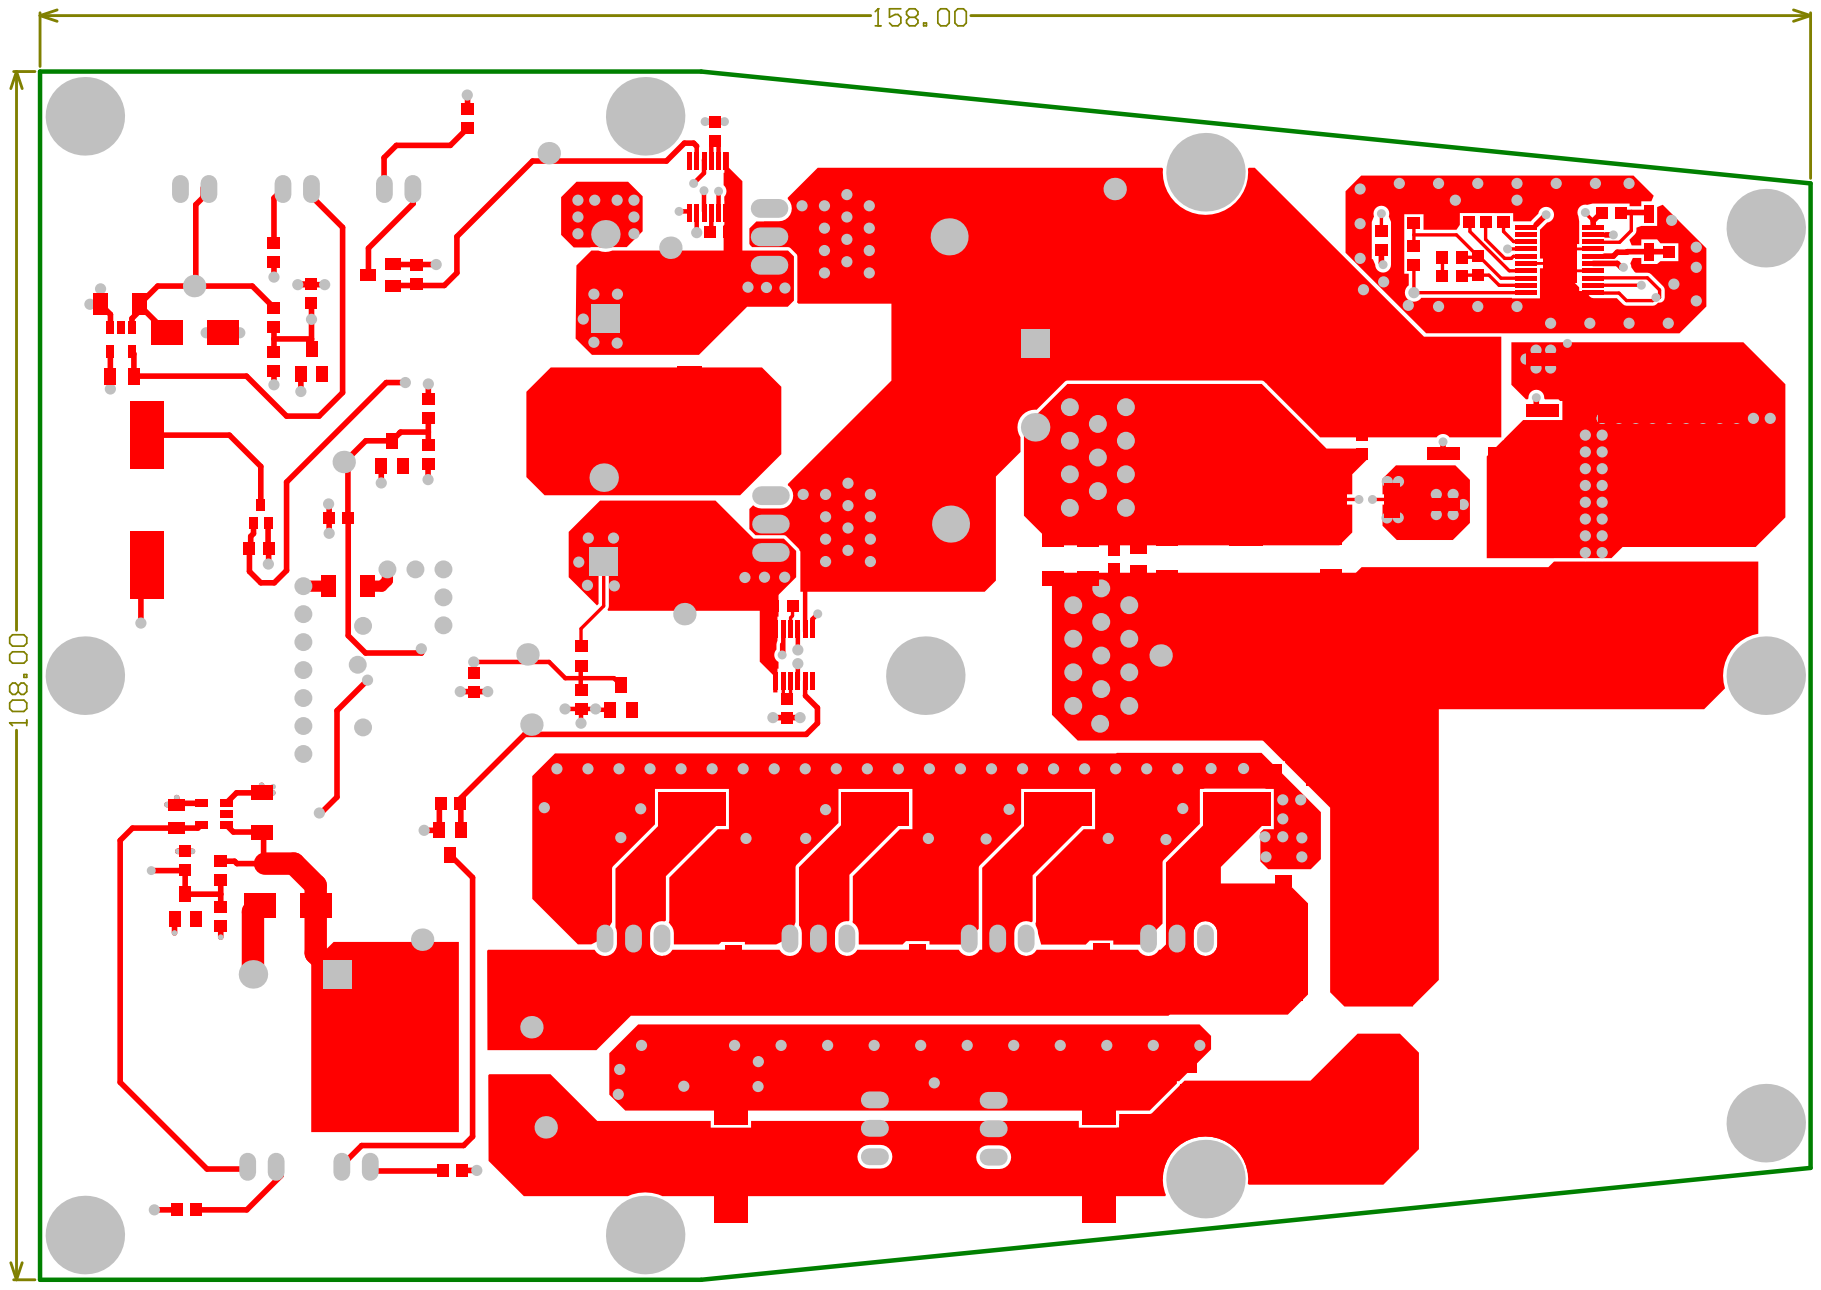
[picture p312: page 1]

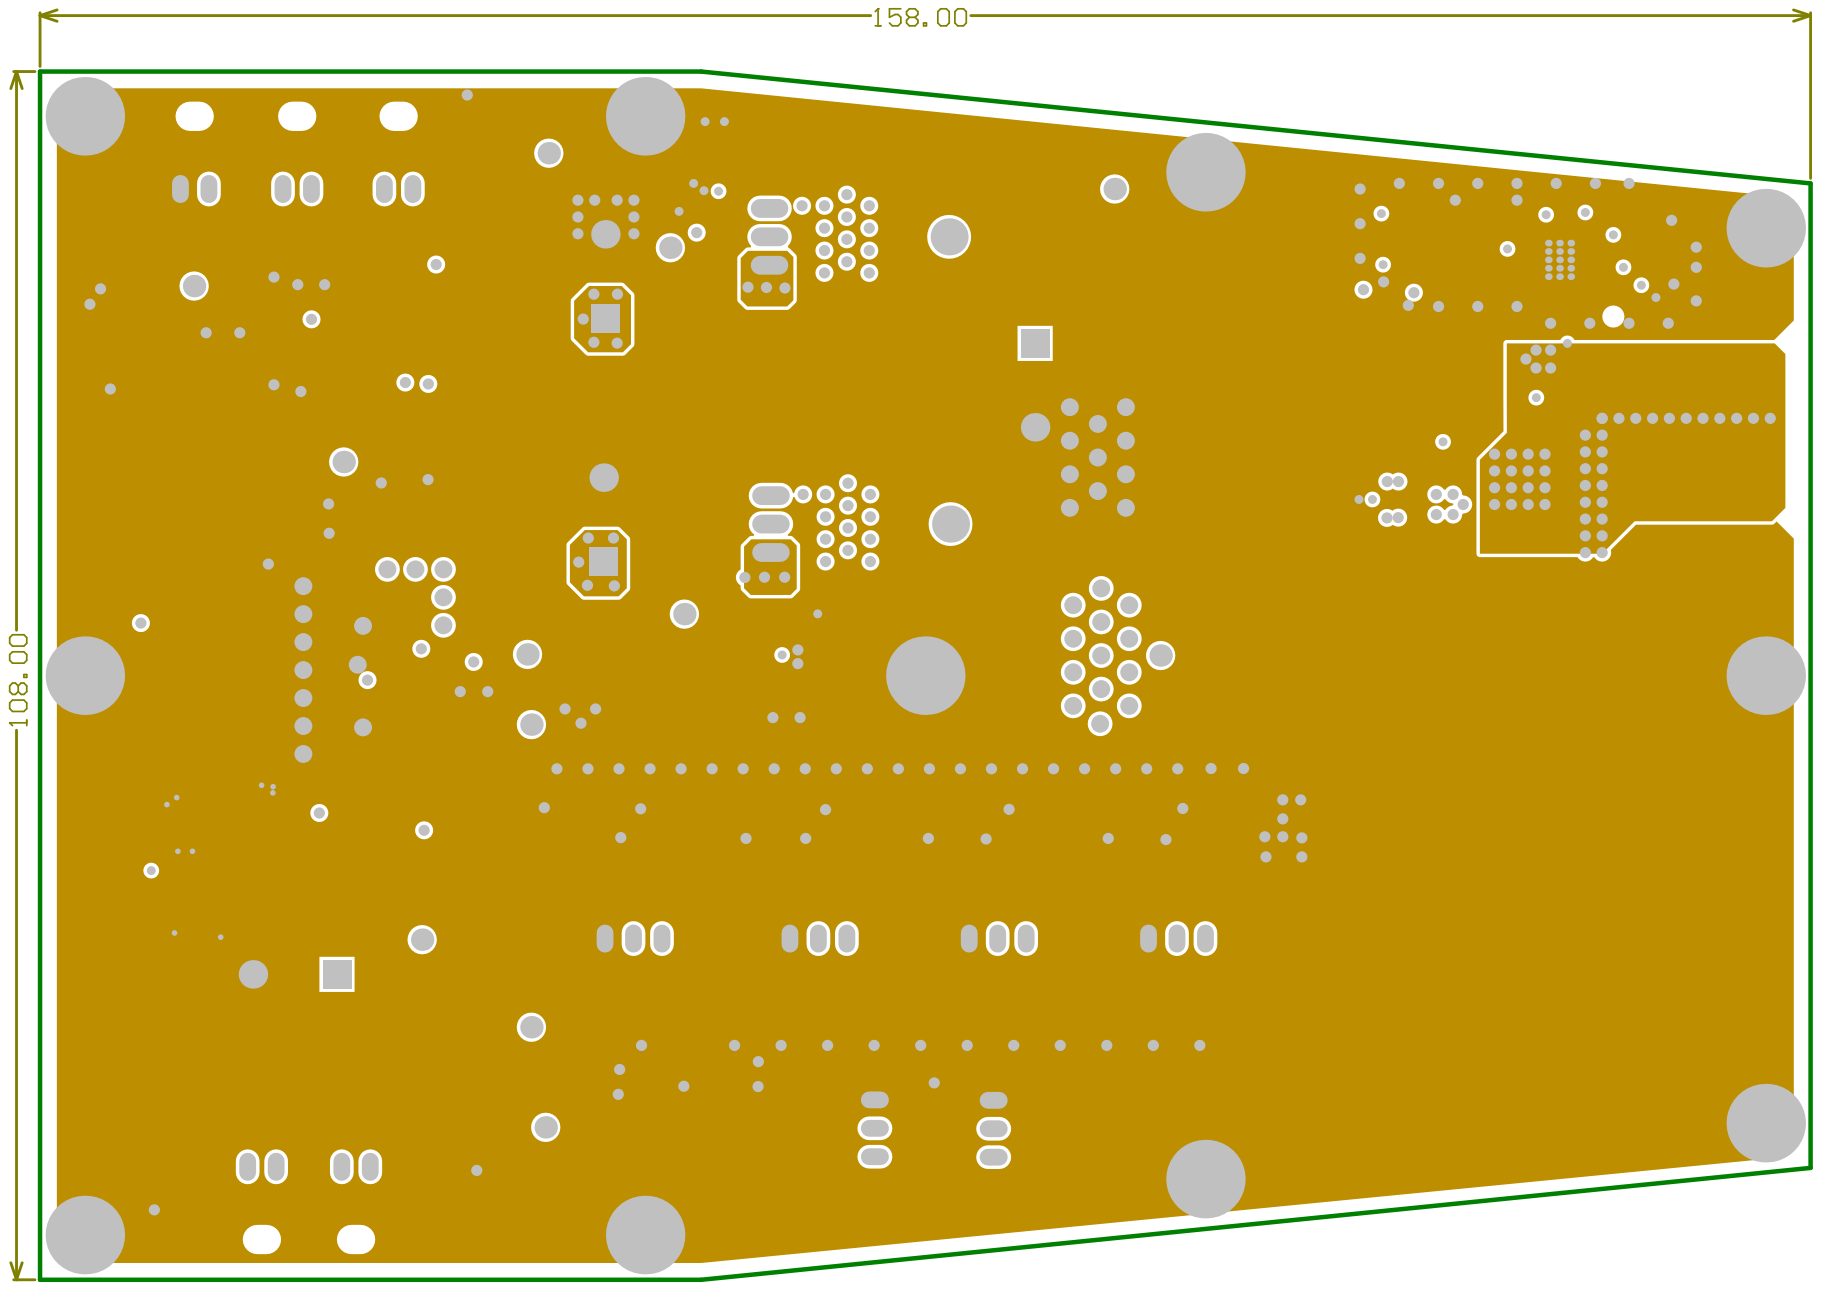
[picture p313: page 2]

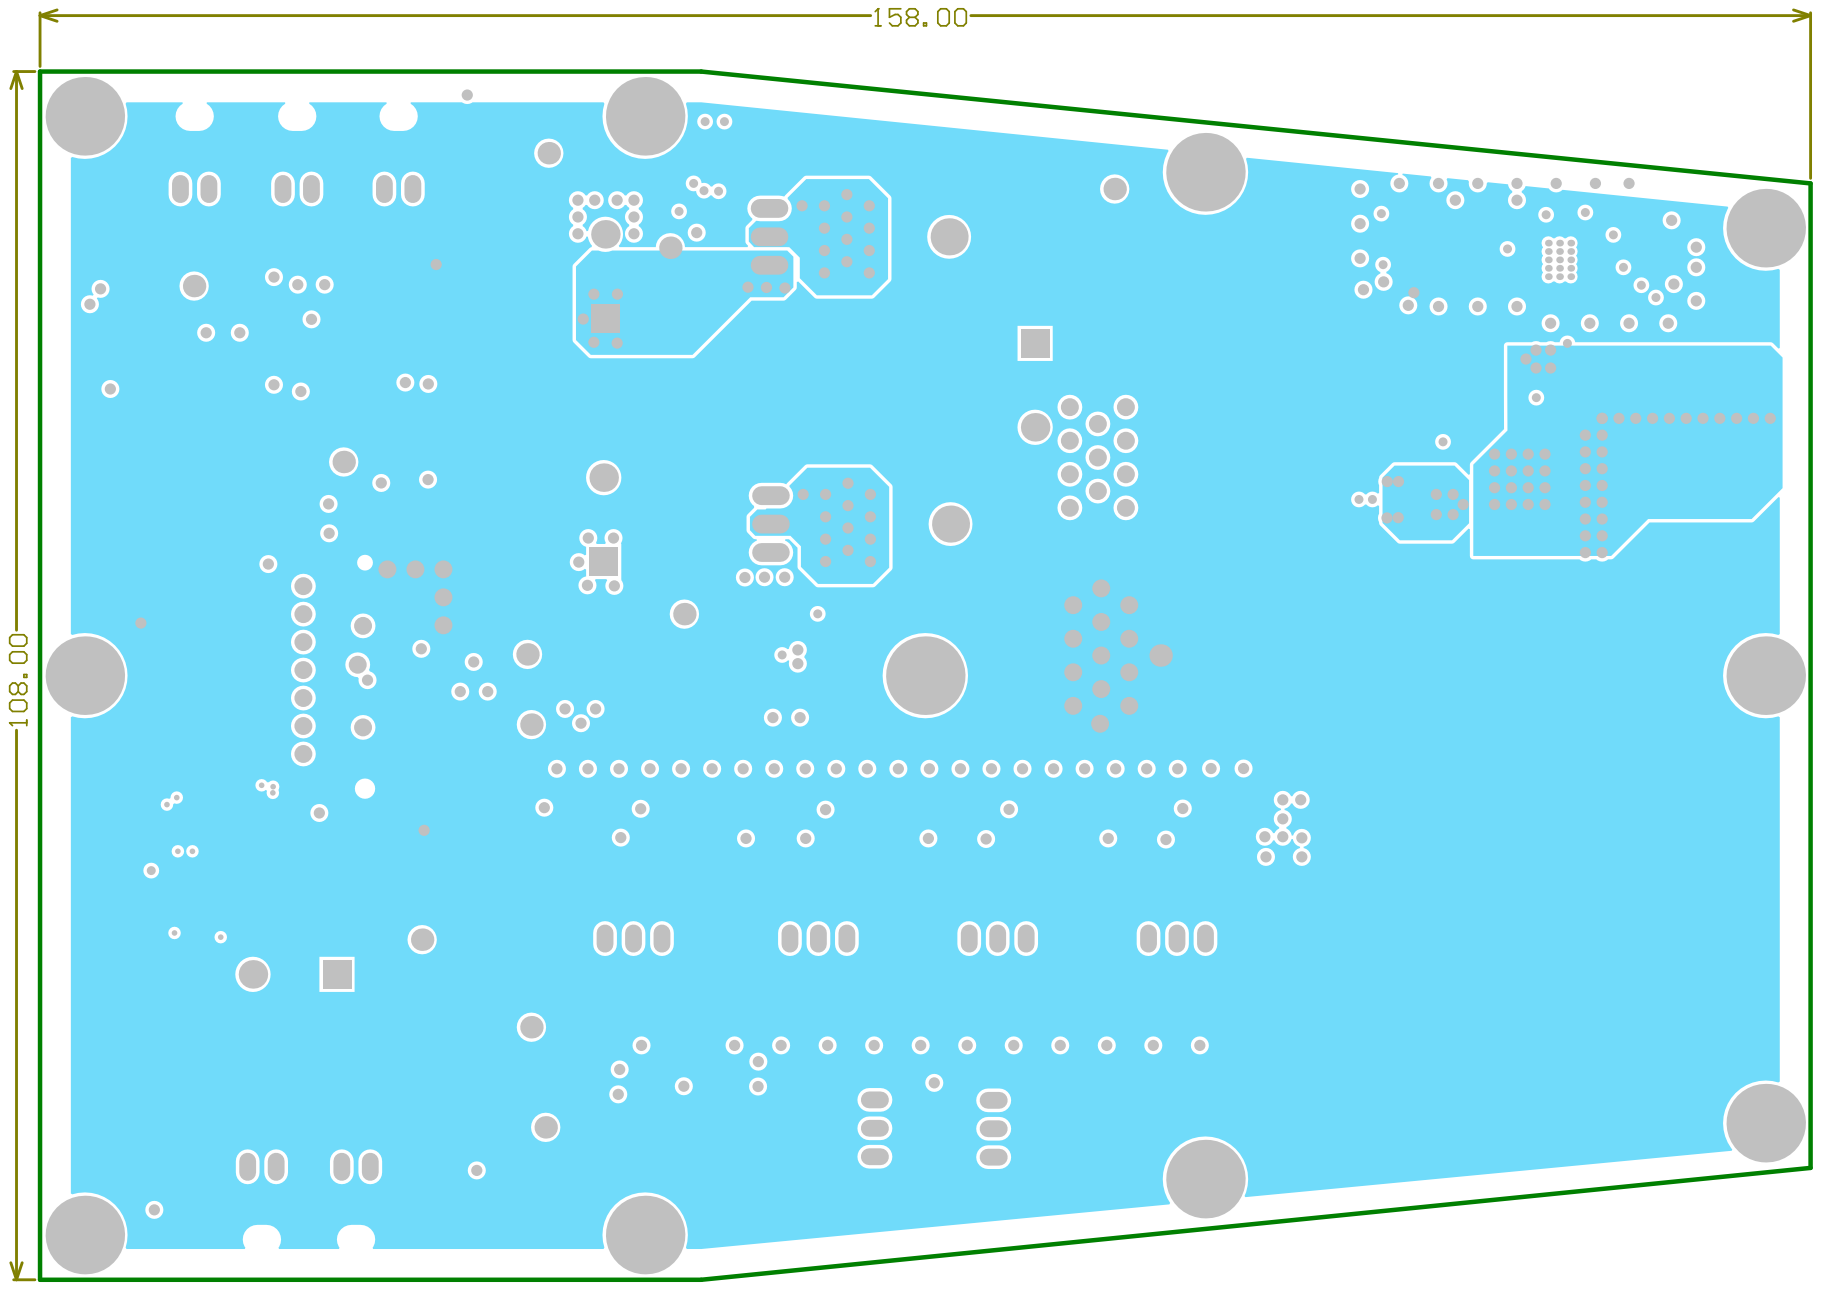
[picture p314: page 3]

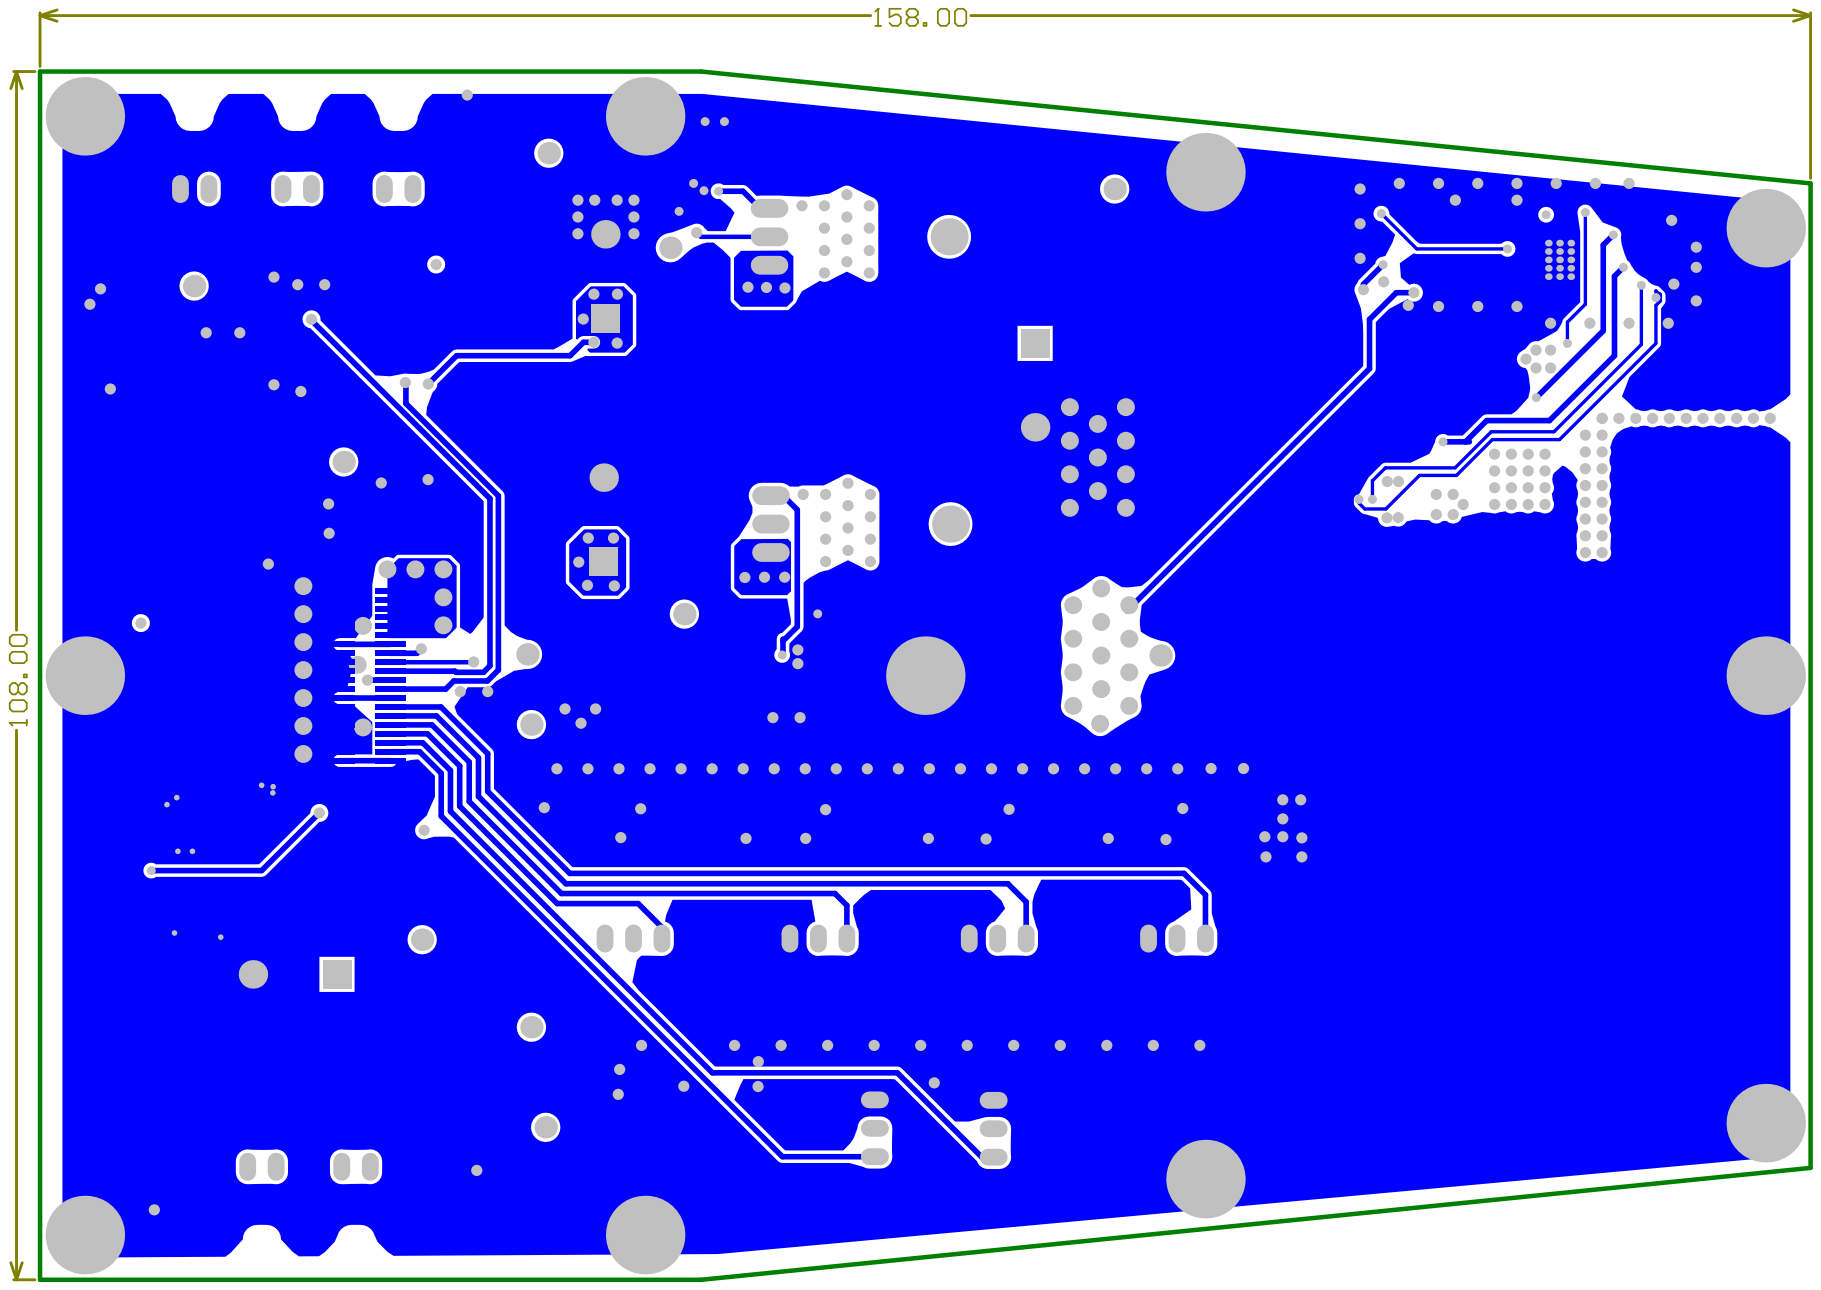
[picture p315: page 4]

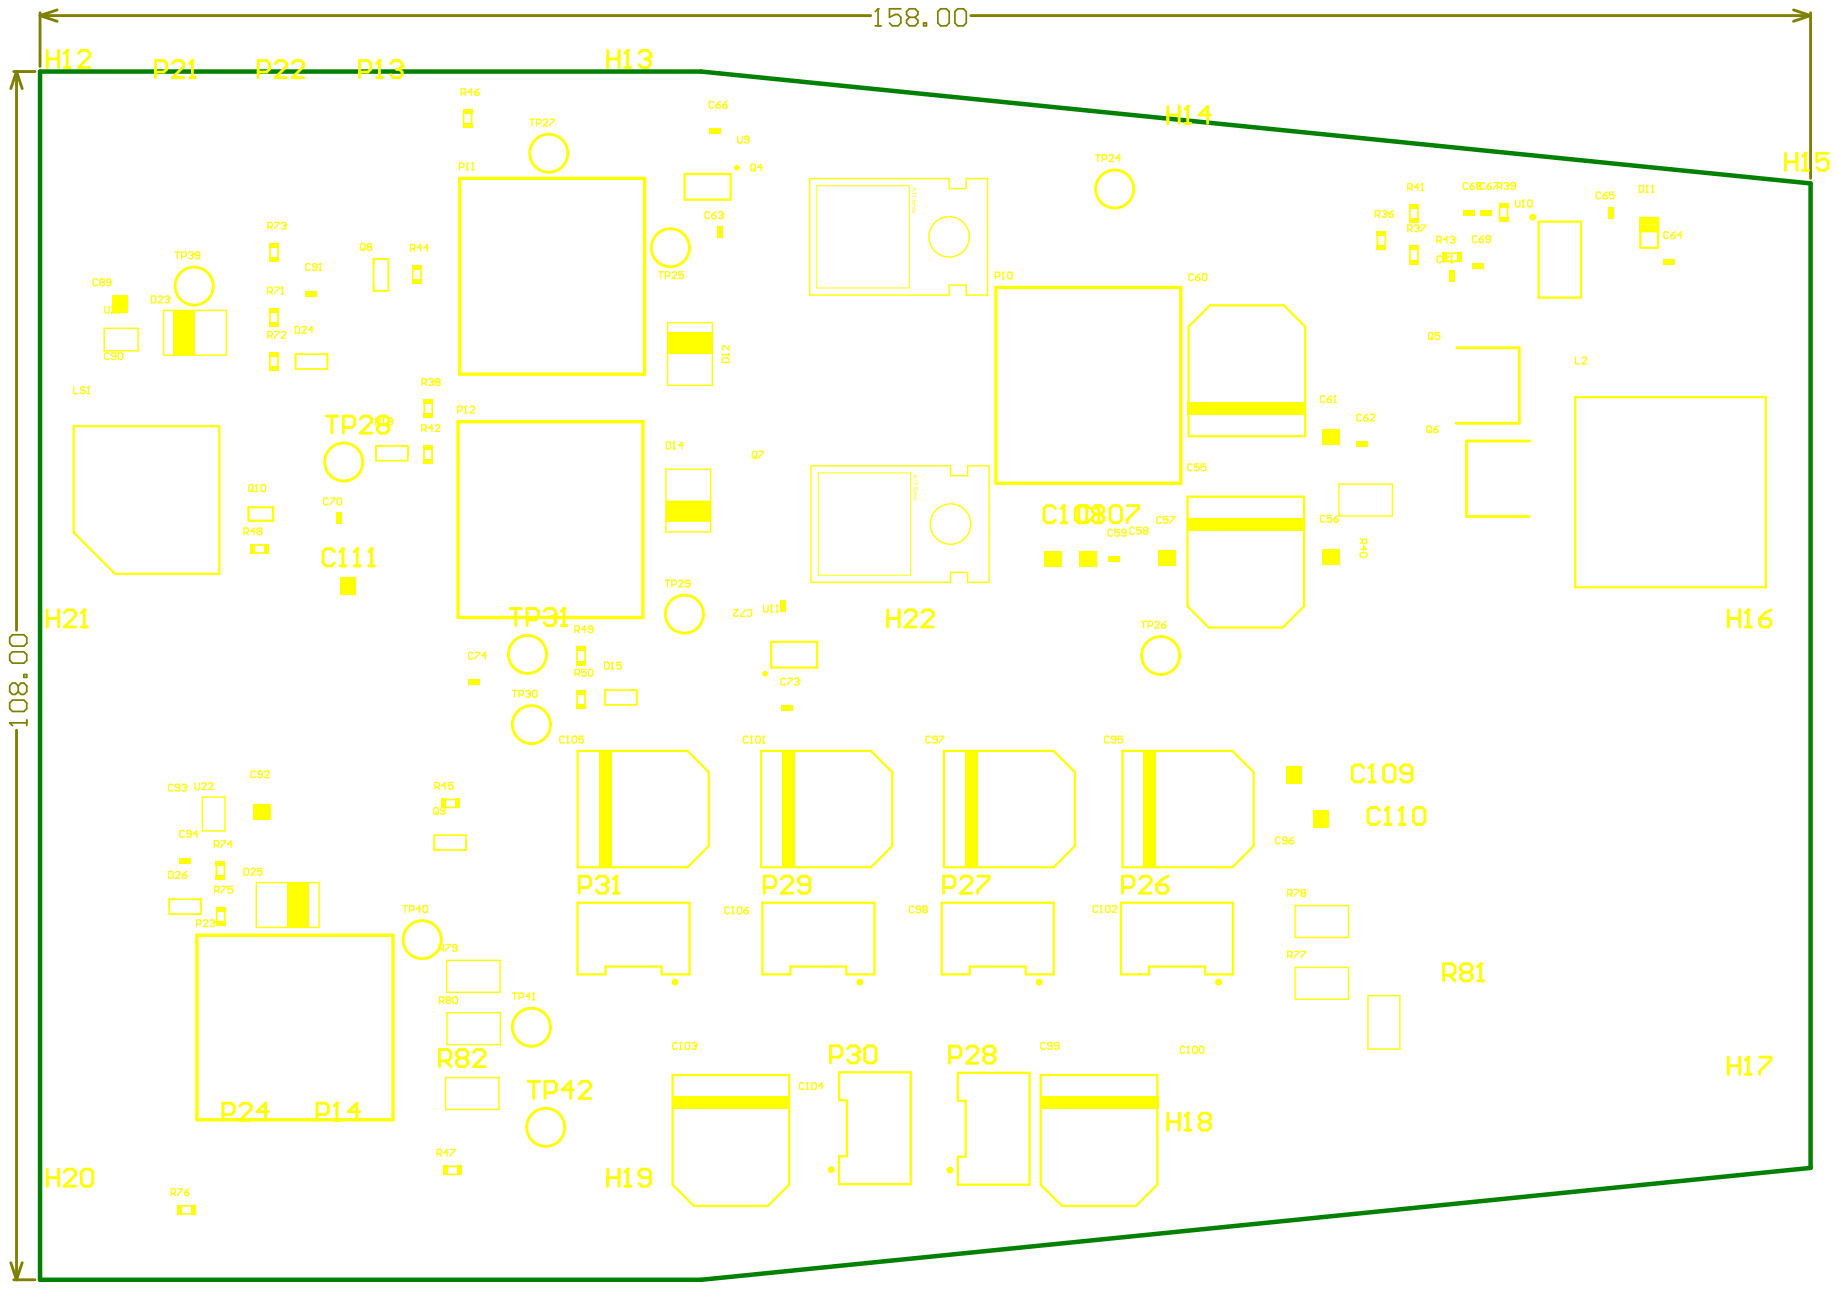
[picture p316: page 5]

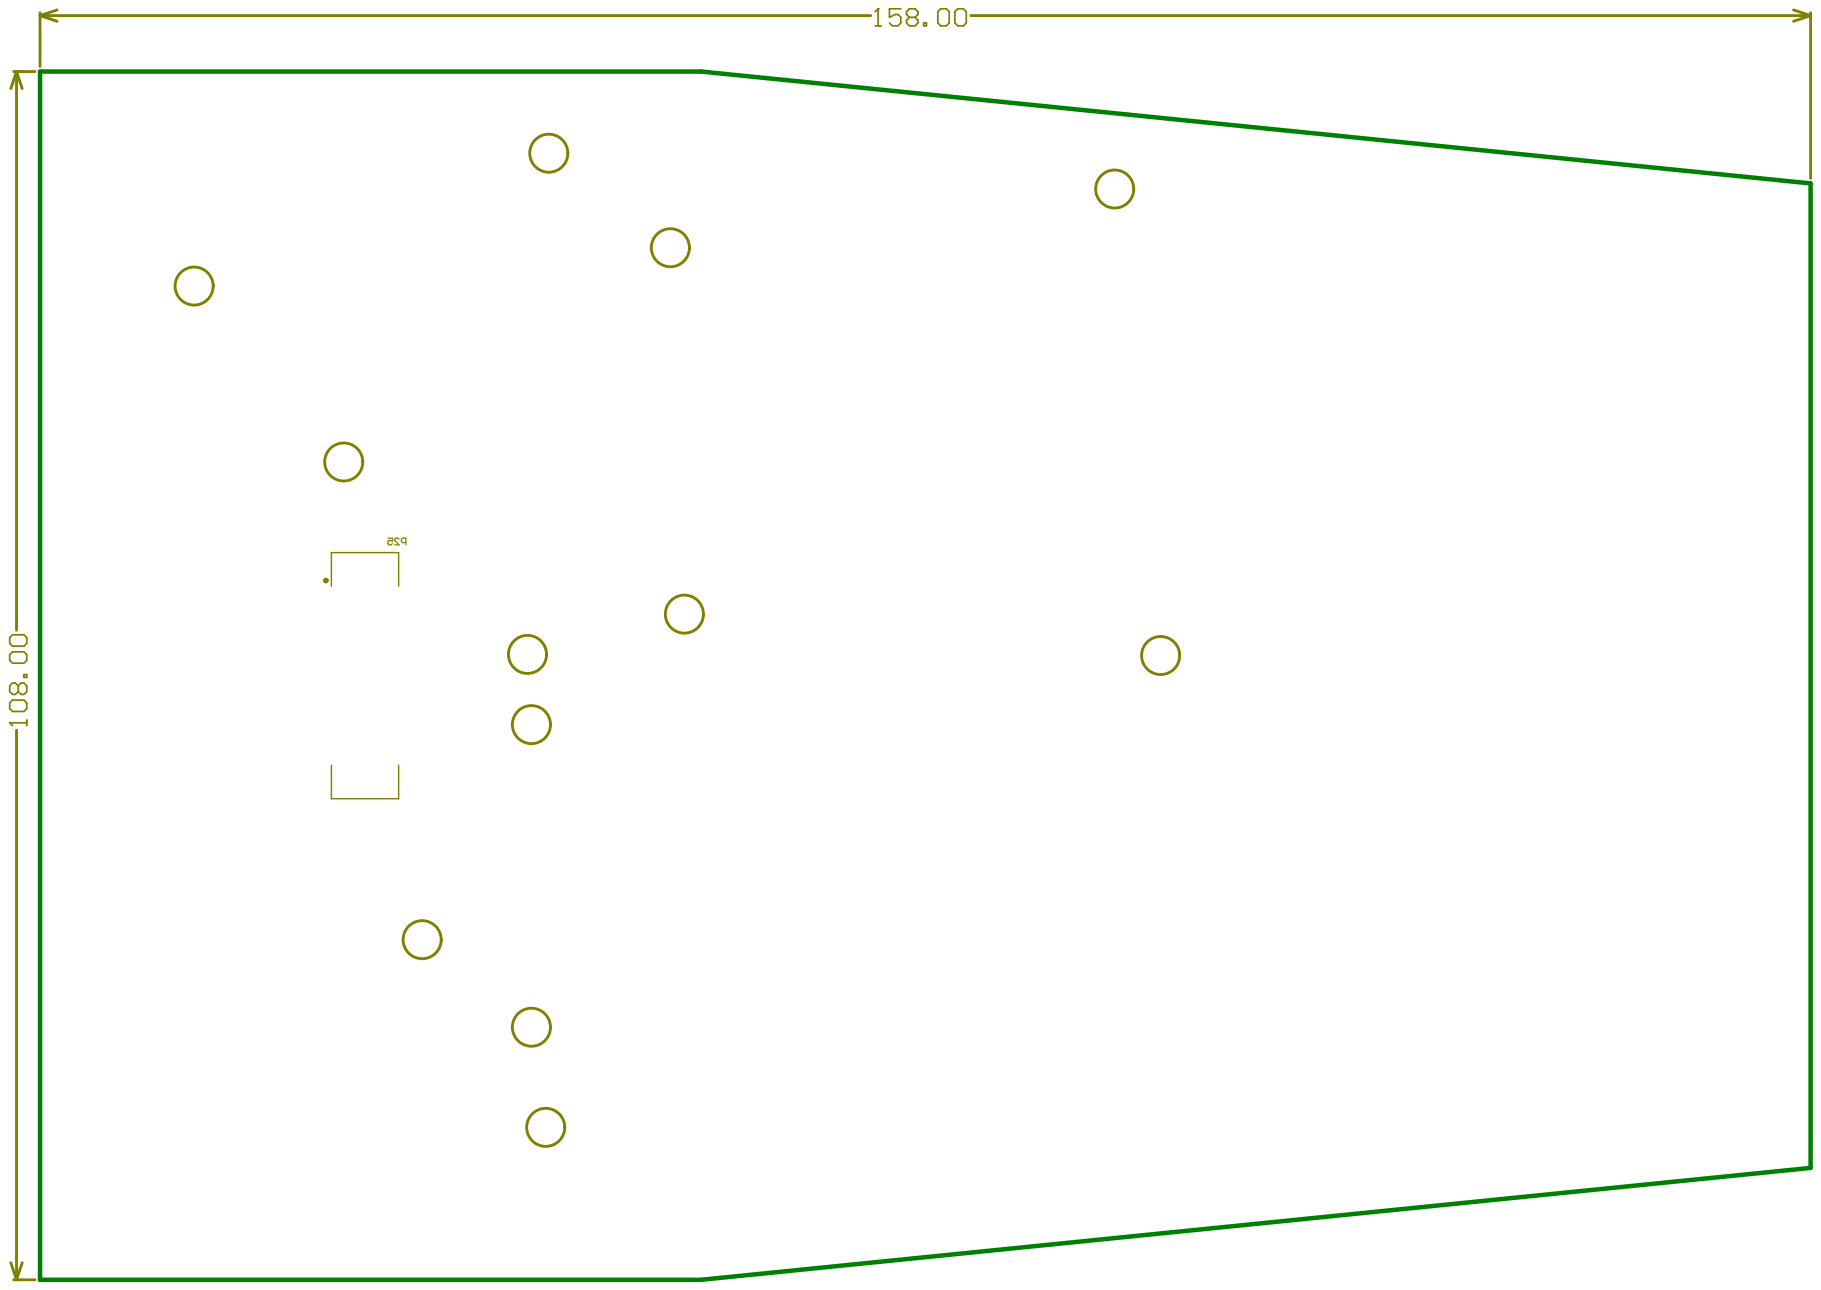
[picture p317: page 6]

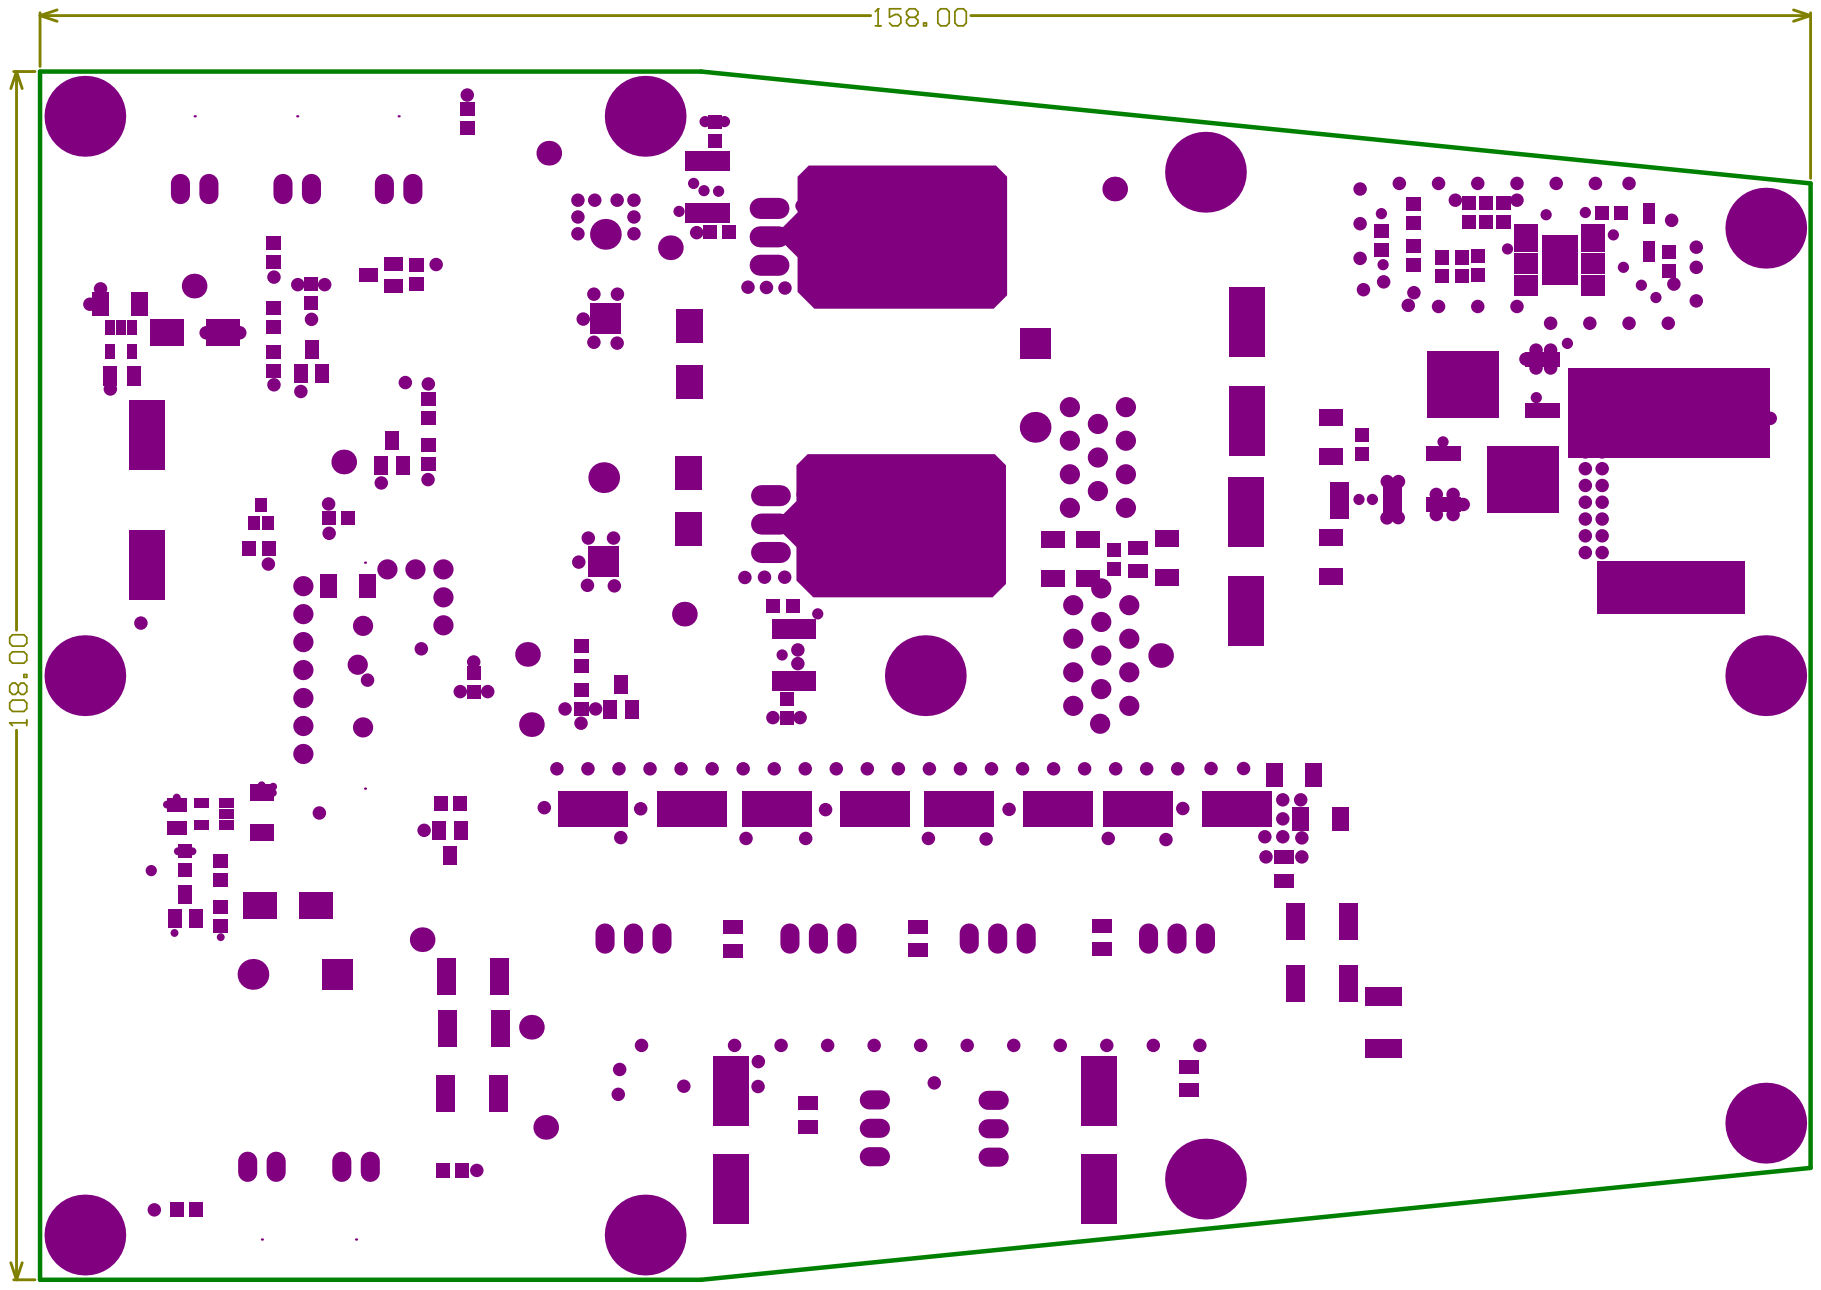
[picture p318: page 7]

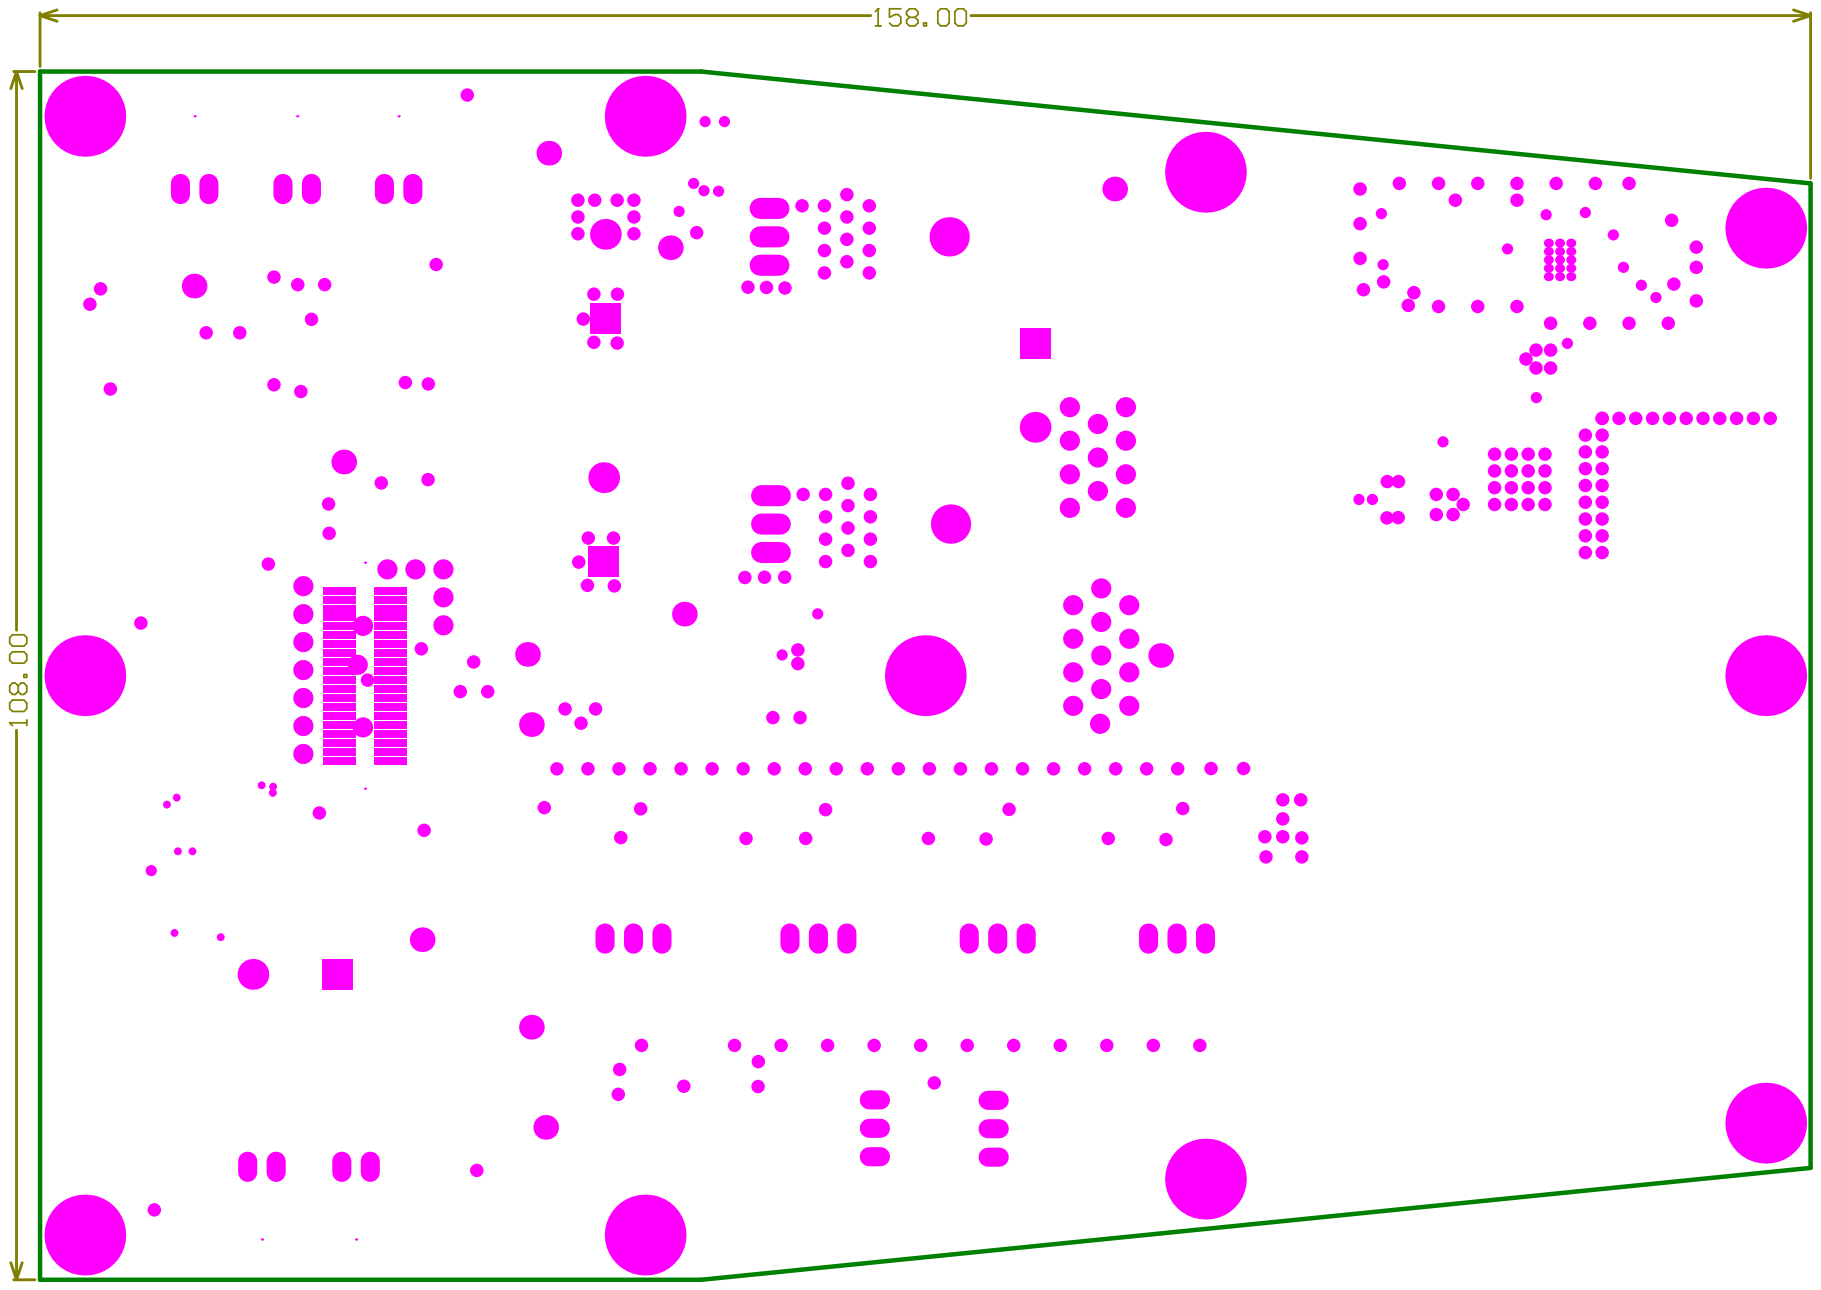
[picture p319: page 8]

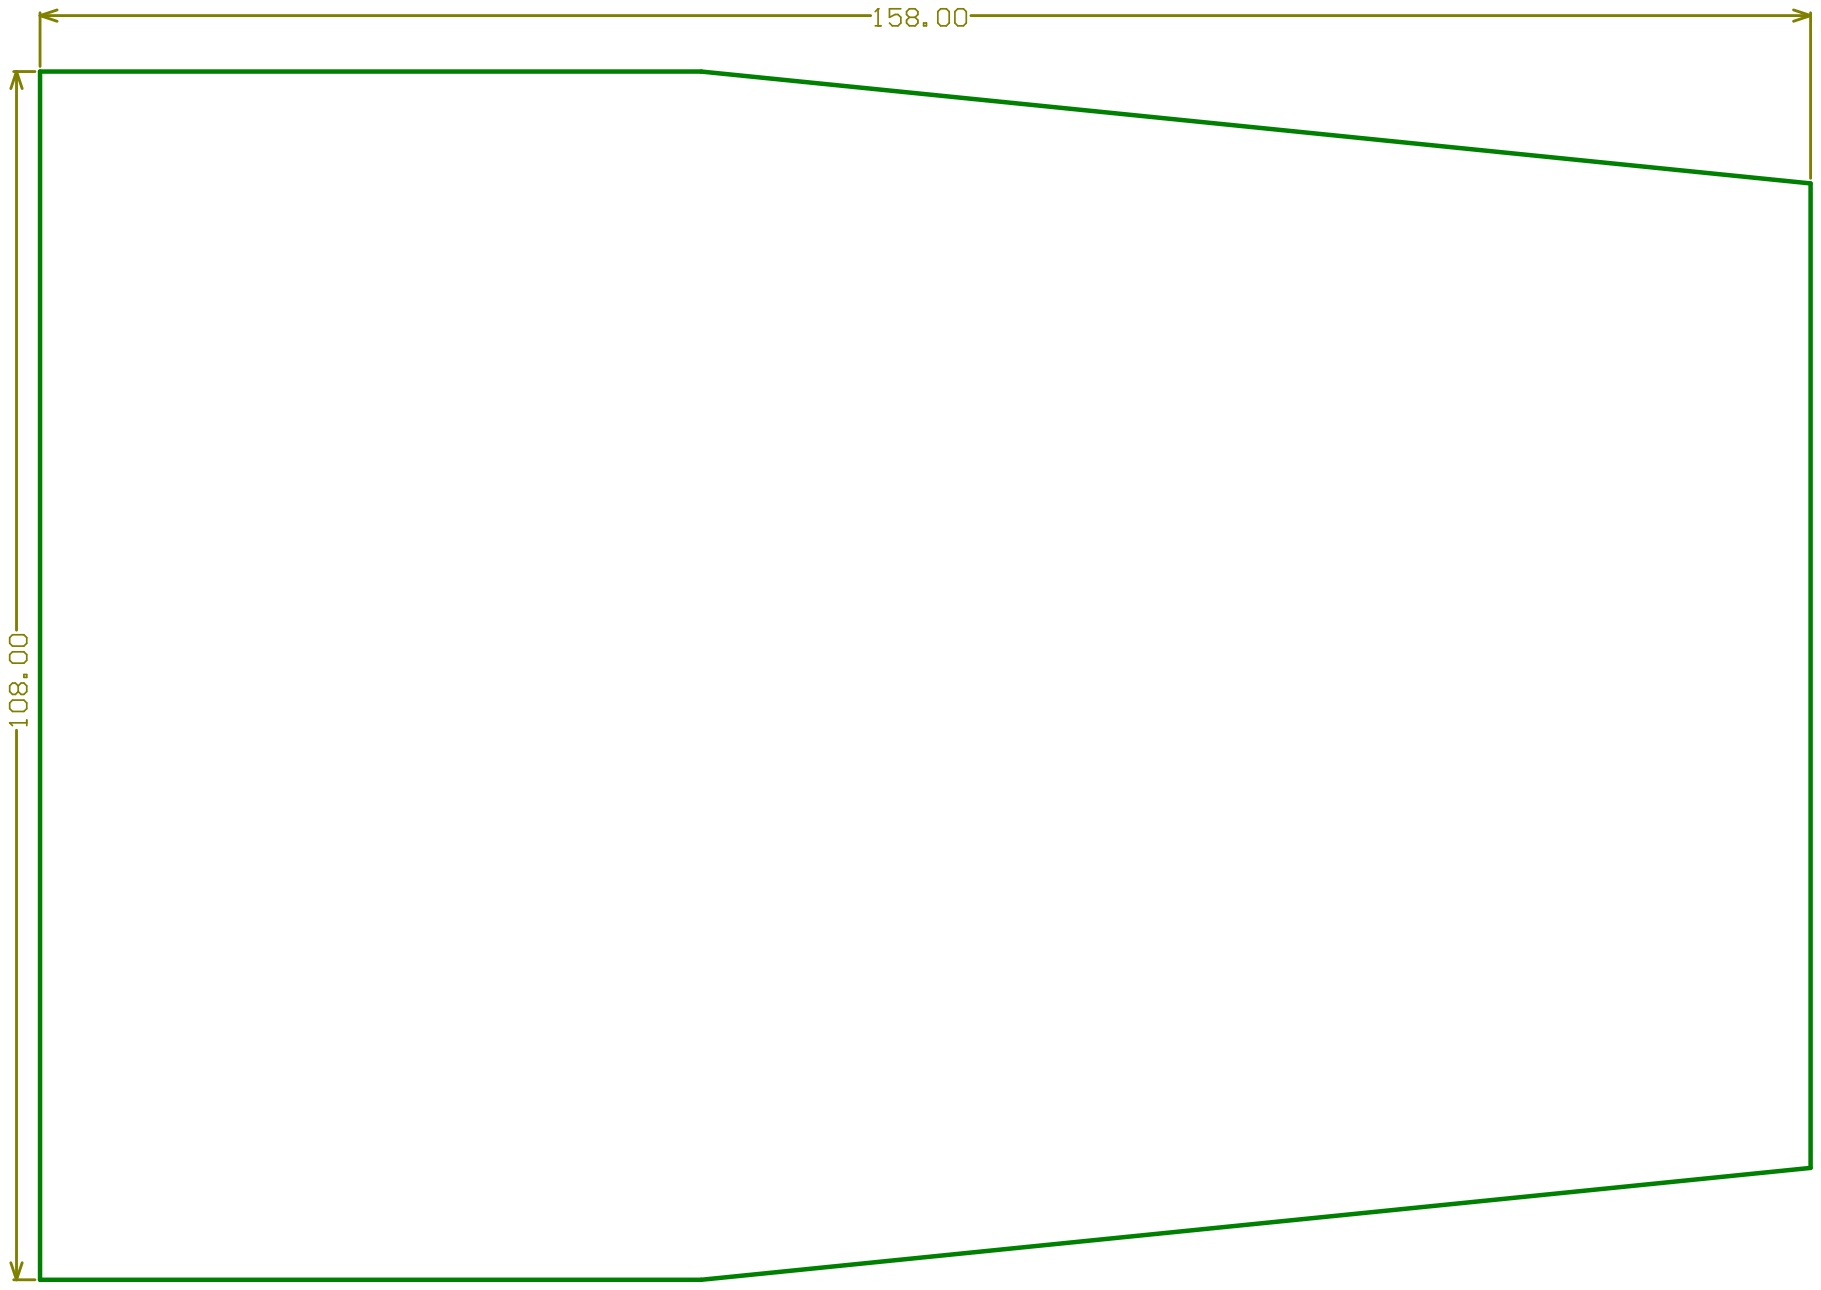
[picture p320: page 9]

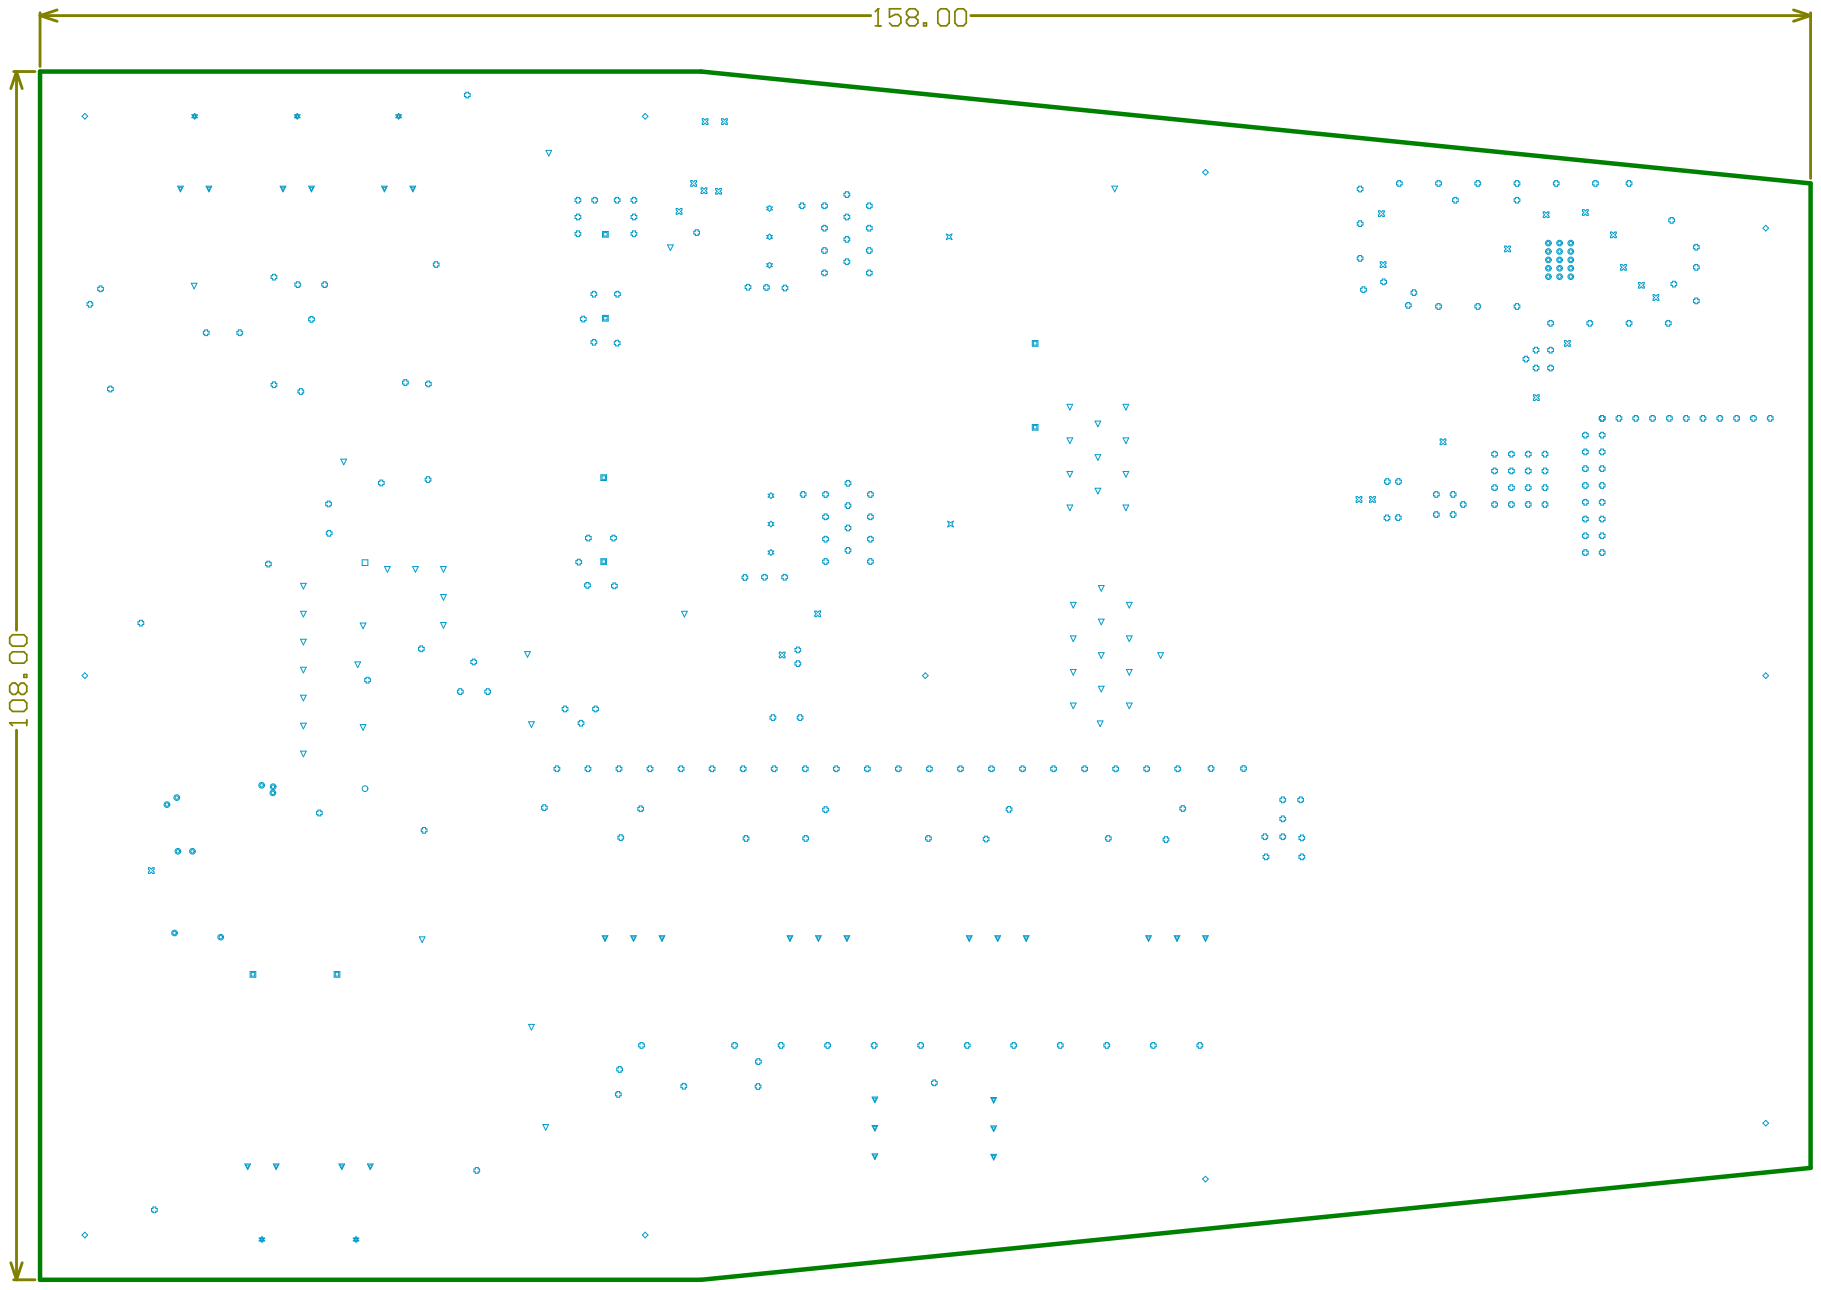
[picture p321: page 10]
