irec-duster/RORO/Avionics_RORO/Altium/Project/Rocket_PCB_Project_2017_XBee_module/Rocket_PCB_Project_2017_XBee_module_DRAFT.pdf

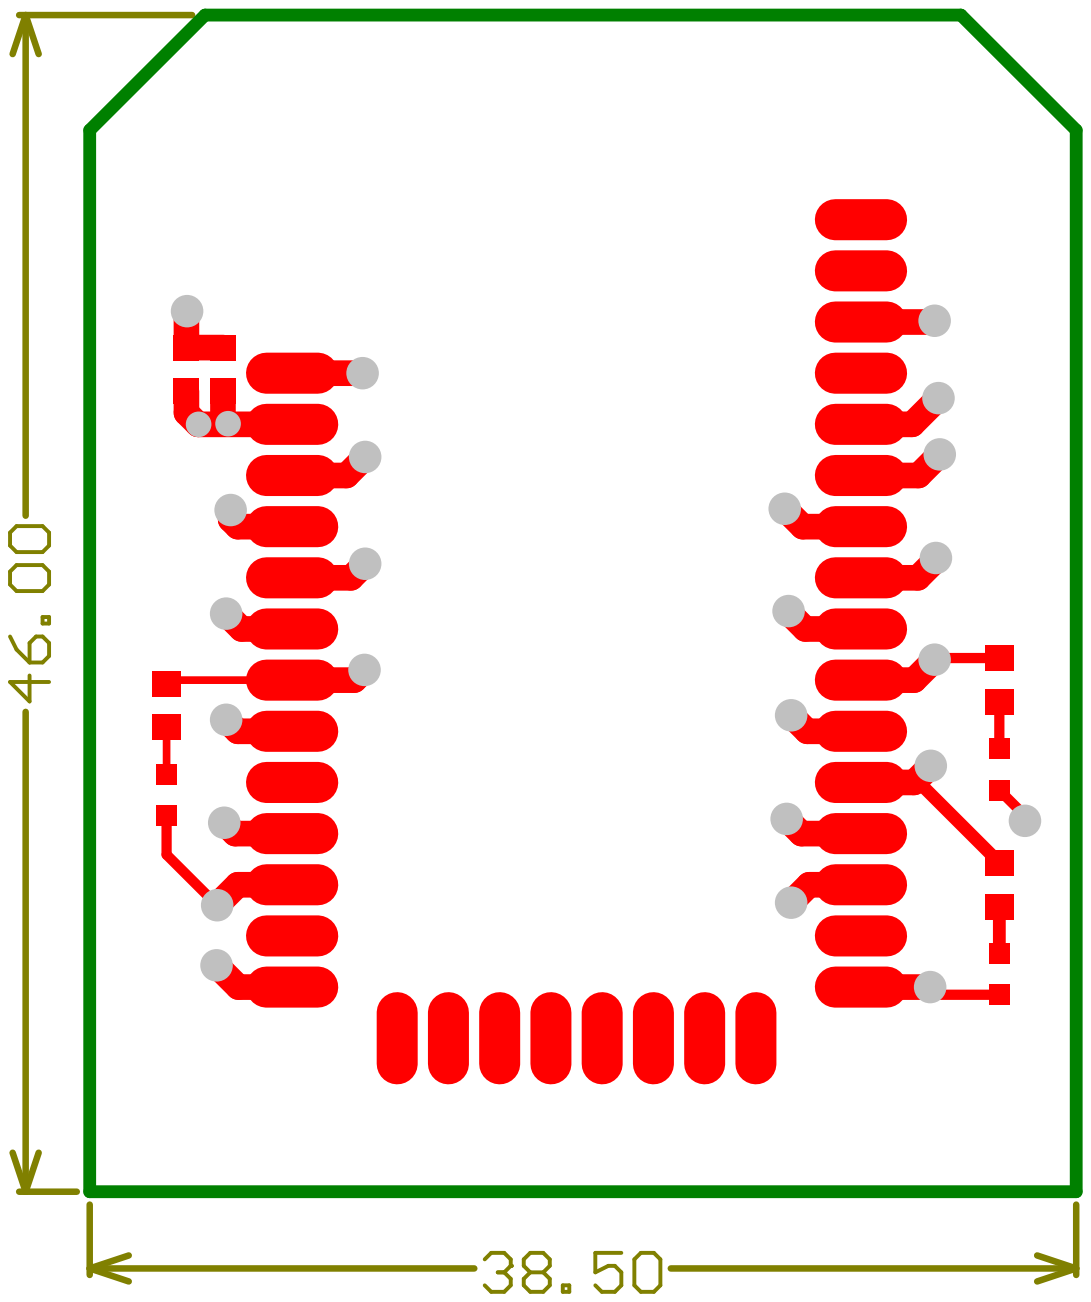
[picture p322: page 1]

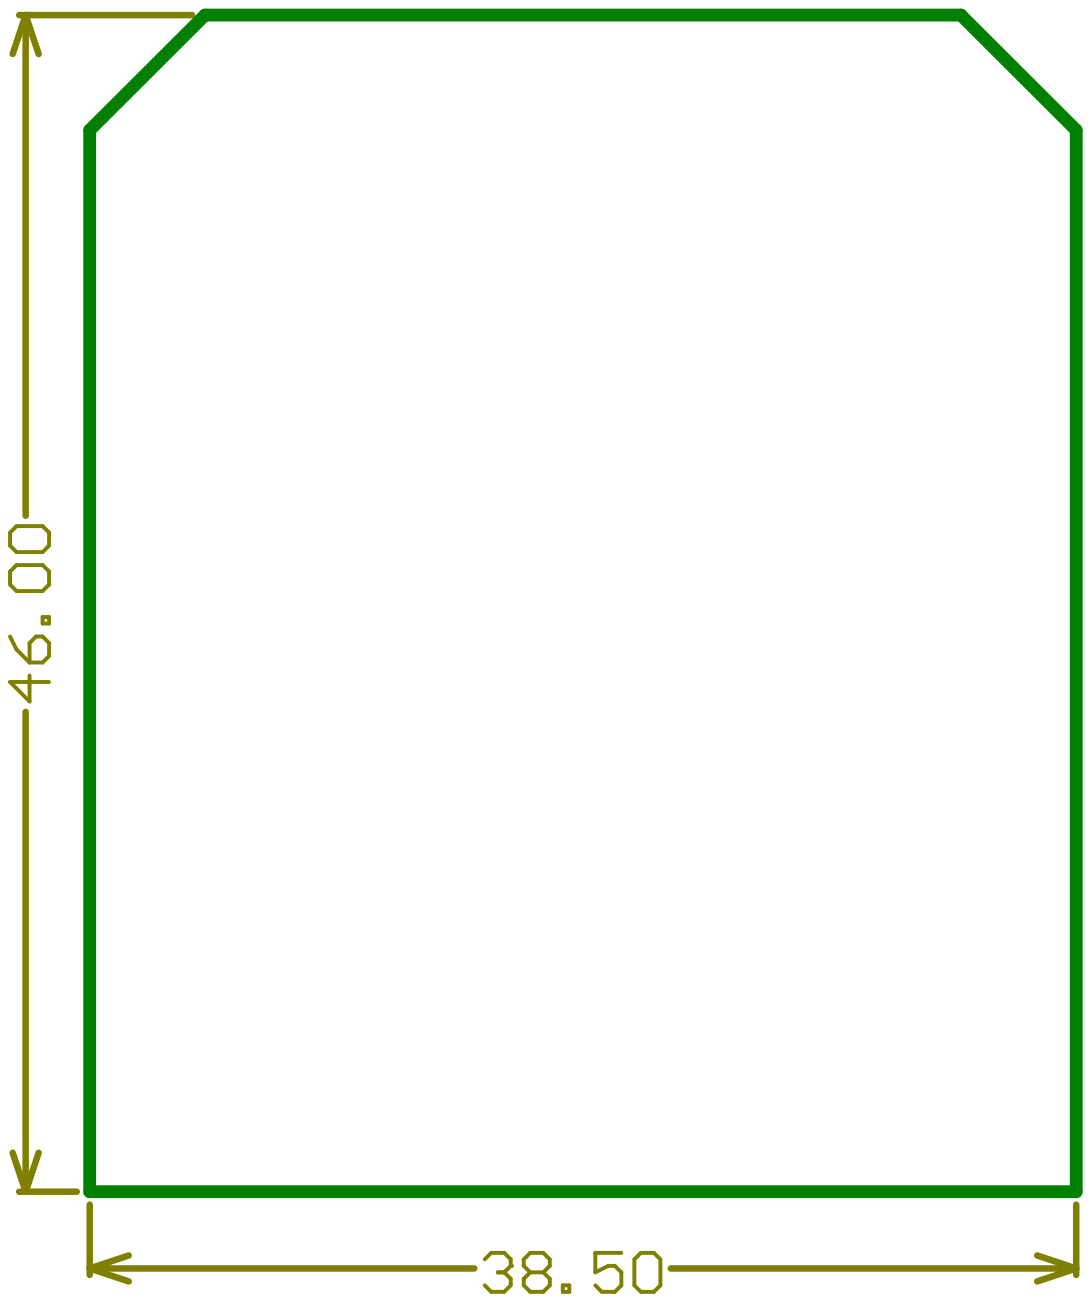
[picture p323: page 2]

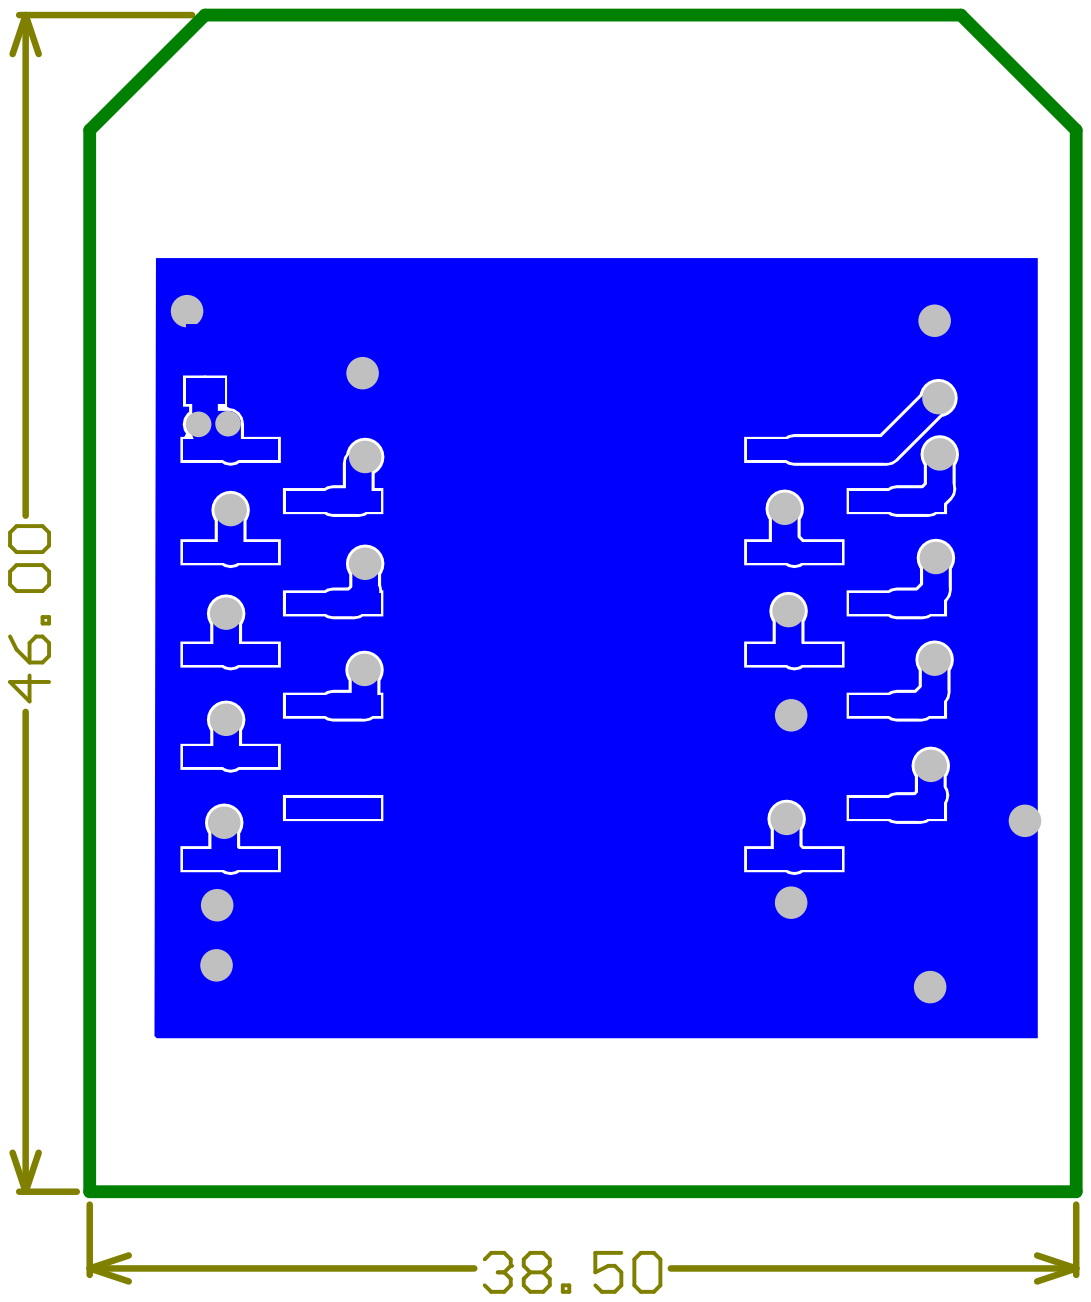
[picture p324: page 4]

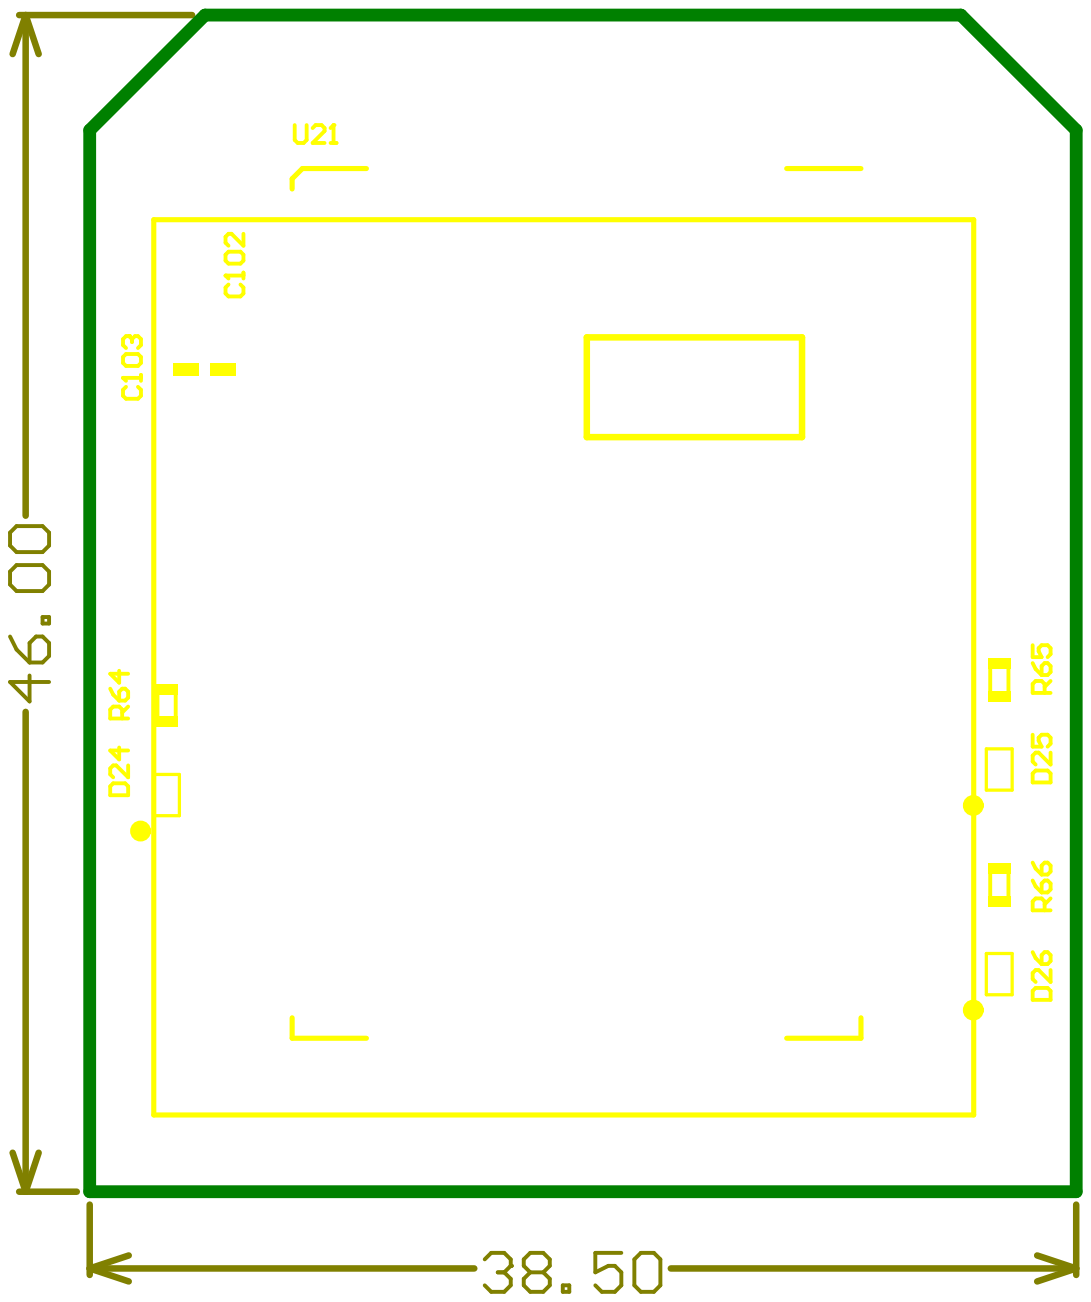
[picture p325: page 5]

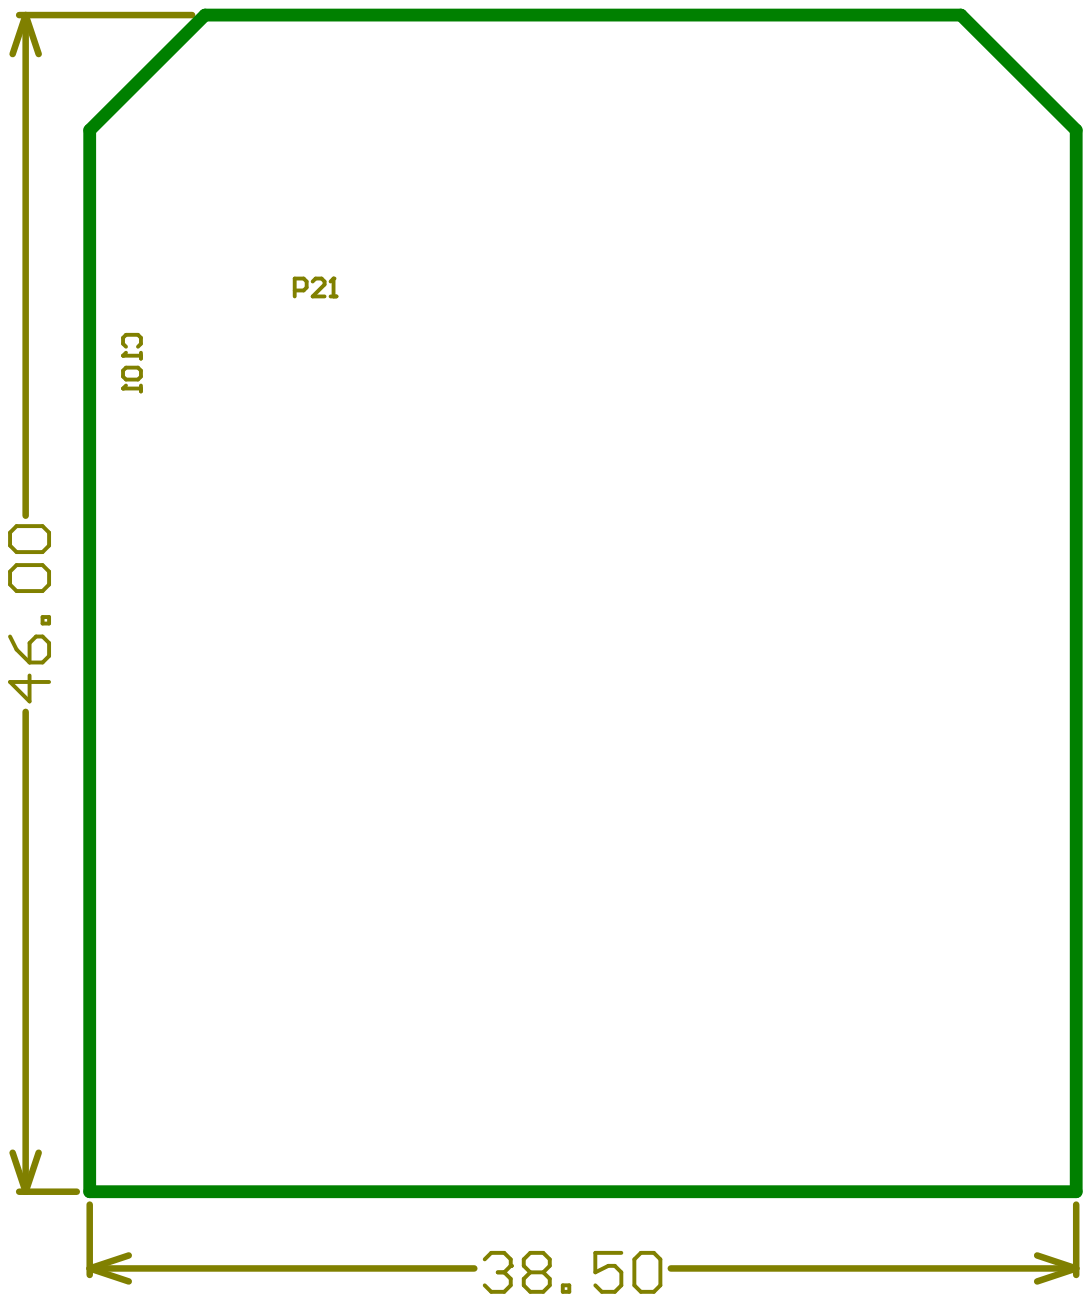
[picture p326: page 6]

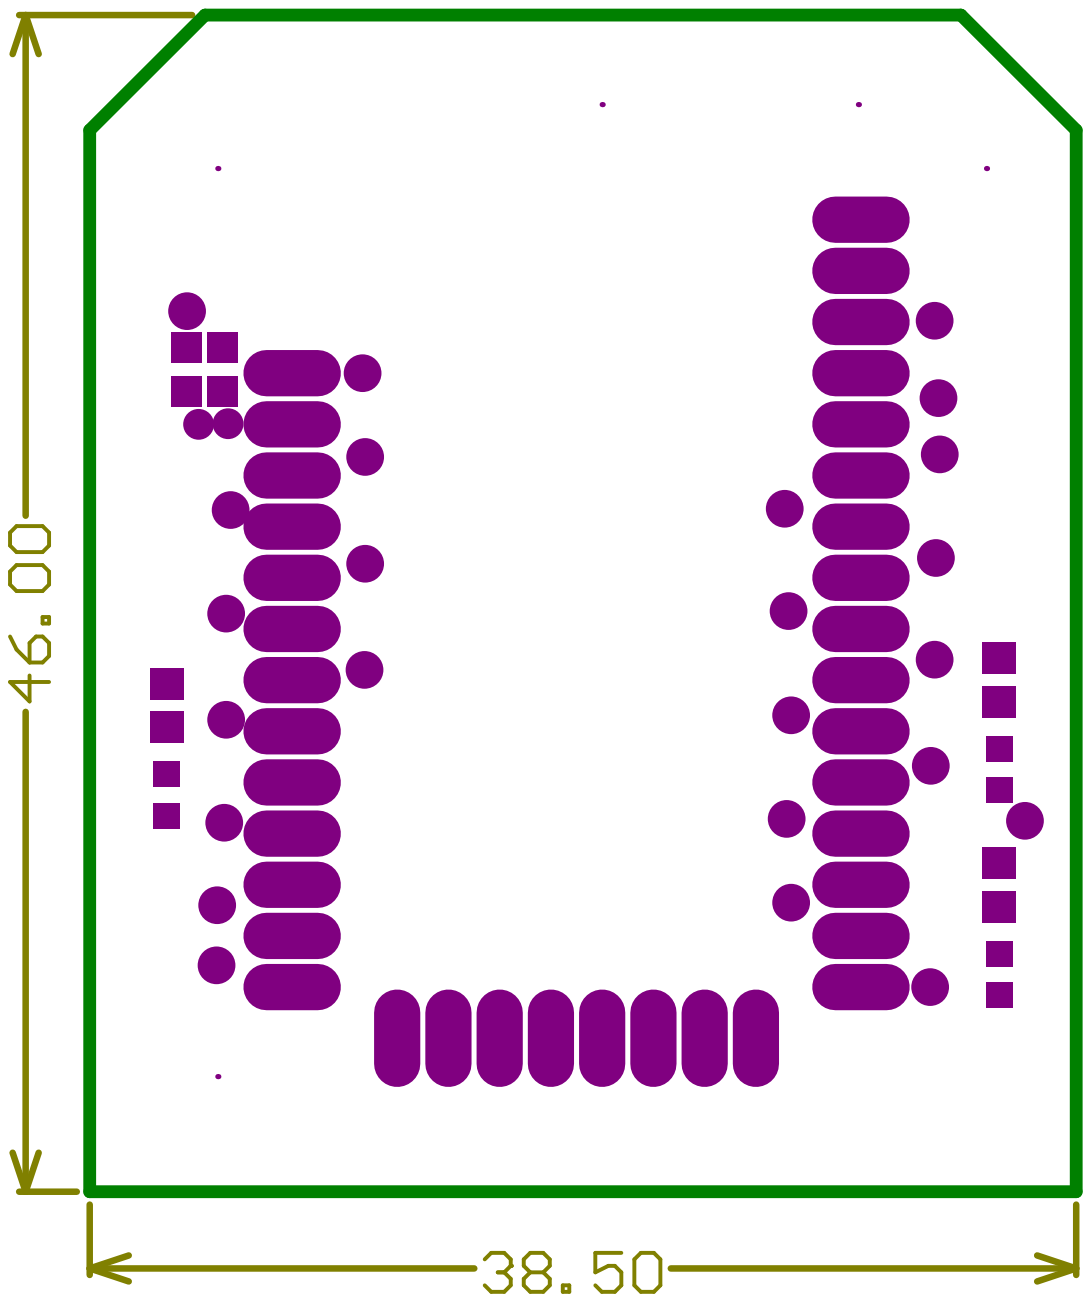
[picture p327: page 7]

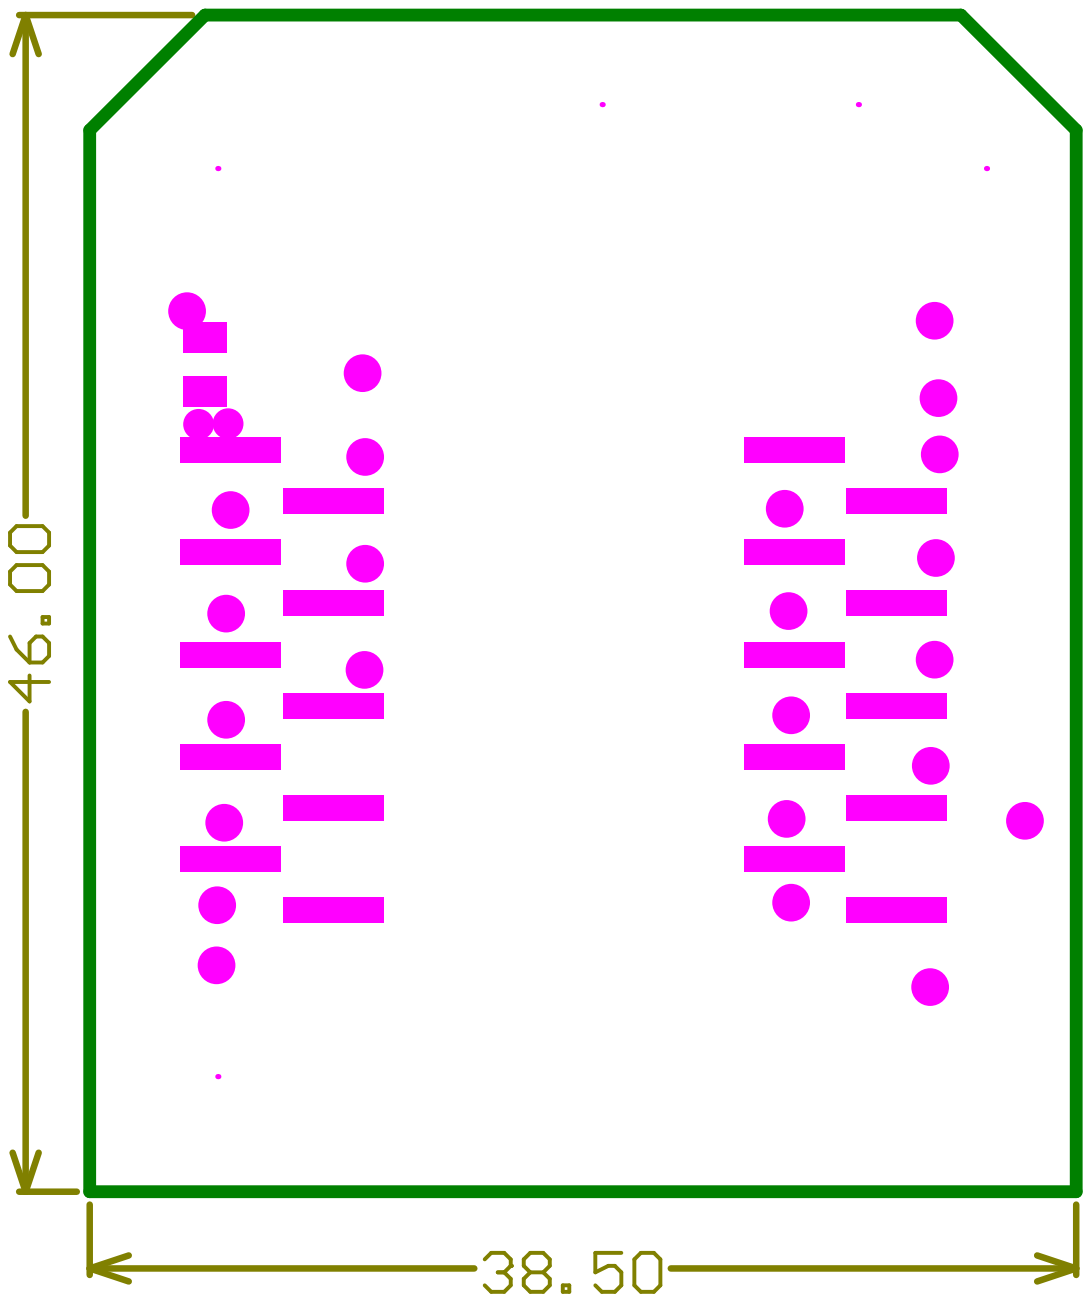
[picture p328: page 8]

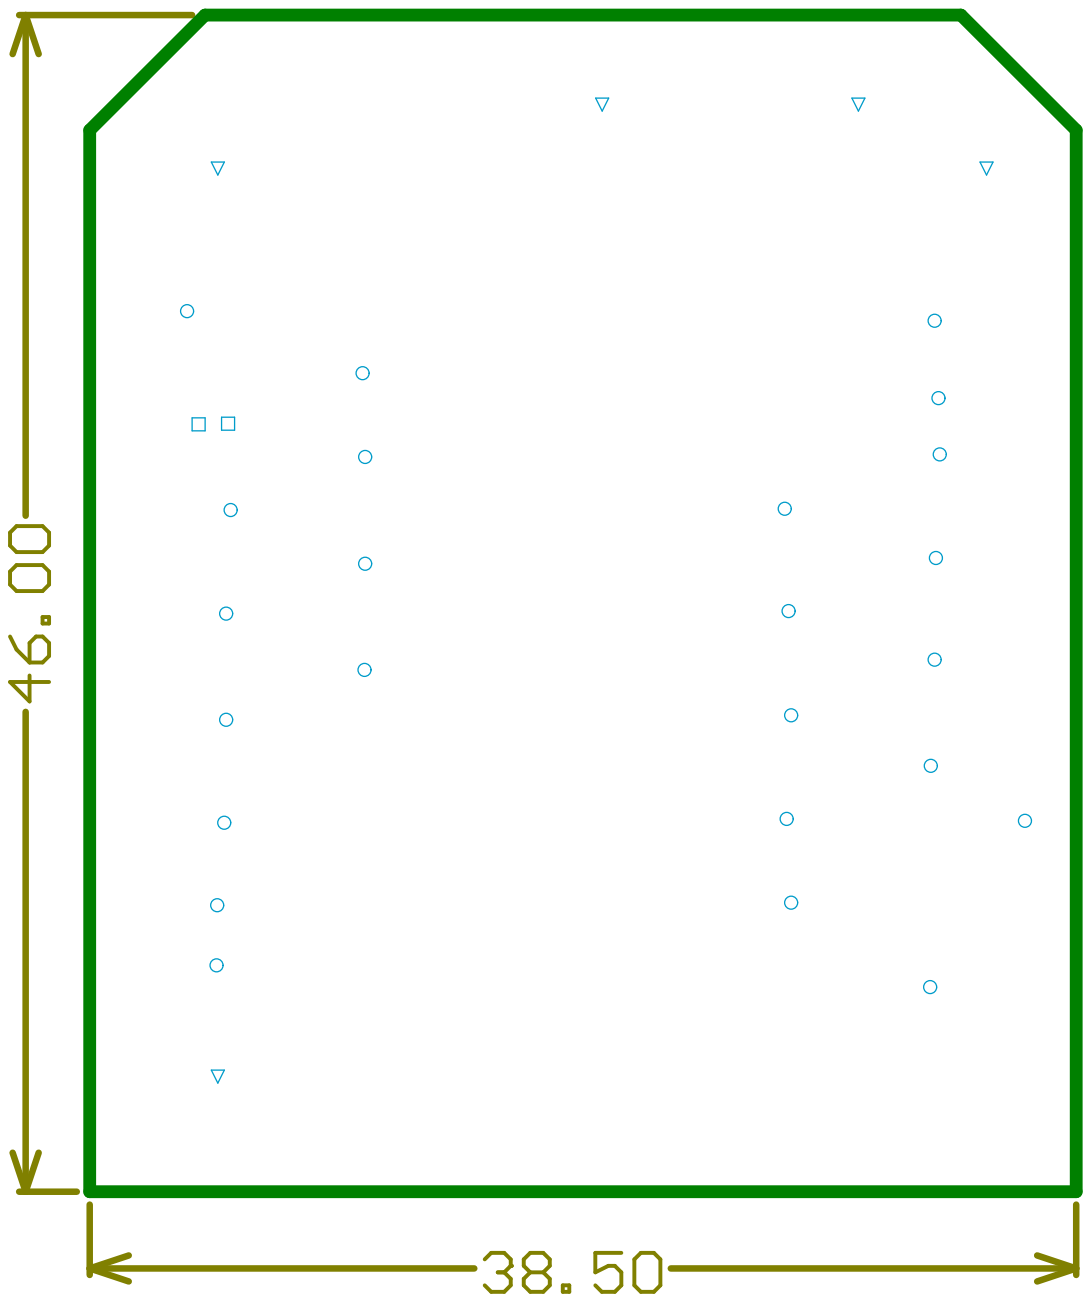
[picture p329: page 10]
