irec-duster/RORO/(list of files, drawings)

Other design files:
Avionics_RORO/Altium/Project/OLD THINGS.SchDoc
Avionics_RORO/Altium/Project/Rocket_PCB_Project_2017/PCB_Rocket_panelized.PcbDoc
Avionics_RORO/Altium/Project/Rocket_PCB_Project_2017/Rocket_PCB_Project_2017.PrjPcb
Avionics_RORO/Altium/Project/Rocket_PCB_Project_2017/Shematic/1.0.0_Overall_Rocket_Eletrical.SchDoc
Avionics_RORO/Altium/Project/Rocket_PCB_Project_2017/Shematic/1.1.0_Interface_board.SchDoc
Avionics_RORO/Altium/Project/Rocket_PCB_Project_2017/Shematic/1.1.1_Interface_board_MCU.SchDoc
Avionics_RORO/Altium/Project/Rocket_PCB_Project_2017/Shematic/1.1.2_Interface_board_Power_Supply.SchDoc
Avionics_RORO/Altium/Project/Rocket_PCB_Project_2017/Shematic/1.1.3_Interface_board_SWD&FLASH&IO.SchDoc
Avionics_RORO/Altium/Project/Rocket_PCB_Project_2017/Shematic/1.1.4_Interface_board_USB&XBee&RS232.SchDoc
Avionics_RORO/Altium/Project/Rocket_PCB_Project_2017/Shematic/1.1.5_Interface_board_Servos.SchDoc
Avionics_RORO/Altium/Project/Rocket_PCB_Project_2017/Shematic/1.1.6_Interface_board_Pressure&GNSS&IMU.SchDoc
Avionics_RORO/Altium/Project/Rocket_PCB_Project_2017/Shematic/1.1.6_Interface_board_Pressure&GNSS.SchDoc
Avionics_RORO/Altium/Project/Rocket_PCB_Project_2017/Shematic/1.1.6_Interface_board_Pressure&IMU.SchDoc
Avionics_RORO/Altium/Project/Rocket_PCB_Project_2017/Shematic/1.1.7_Interface_board_GNSS.SchDoc
Avionics_RORO/Altium/Project/Rocket_PCB_Project_2017/Shematic/1.2.0_XBee_module.SchDoc
Avionics_RORO/Altium/Project/Rocket_PCB_Project_2017/Shematic/1.3.0_Power_board.SchDoc
Avionics_RORO/Altium/Project/Rocket_PCB_Project_2017/Shematic/1.3.1_Power_board_BAT1&BAT2.SchDoc
Avionics_RORO/Altium/Project/Rocket_PCB_Project_2017/Shematic/1.3.2_Power_board_BAT3&BAT4.SchDoc
Avionics_RORO/Altium/Project/Rocket_PCB_Project_2017/Shematic/1.3.3_Power_board_Servos.SchDoc
Avionics_RORO/Altium/Project/Rocket_PCB_Project_2017_Interface_board/Rocket_PCB_Project_2017_Interface_board.PrjPcb
Avionics_RORO/Altium/Project/Rocket_PCB_Project_2017_Power_board/Rocket_PCB_Project_2017_Power_board.PrjPcb
Avionics_RORO/Altium/Project/Rocket_PCB_Project_2017_XBee_module/Rocket_PCB_Project_2017_XBee_module.PrjPcb
Avionics_RORO/Altium/Project/Rocket_PCB_Project_2017_XBee_module/XBee_module.PcbDoc
Avionics_RORO/Datasheet/stm32373C-eval_sch/MB988_rev_B/Audio.SchDoc
Avionics_RORO/Datasheet/stm32373C-eval_sch/MB988_rev_B/CAN&IR.SchDoc
Avionics_RORO/Datasheet/stm32373C-eval_sch/MB988_rev_B/ECG&PressureSensor.SchDoc
Avionics_RORO/Datasheet/stm32373C-eval_sch/MB988_rev_B/HDMI_CEC.SchDoc
Avionics_RORO/Datasheet/stm32373C-eval_sch/MB988_rev_B/I2C Peripherals.SCHDOC
Avionics_RORO/Datasheet/stm32373C-eval_sch/MB988_rev_B/JTAG&Trace.SchDoc
Avionics_RORO/Datasheet/stm32373C-eval_sch/MB988_rev_B/LCD_MicroSD.SchDoc
Avionics_RORO/Datasheet/stm32373C-eval_sch/MB988_rev_B/MB988.PrjPCB
Avionics_RORO/Datasheet/stm32373C-eval_sch/MB988_rev_B/MB988.SchDoc
Avionics_RORO/Datasheet/stm32373C-eval_sch/MB988_rev_B/MB988.SCHLIB
Avionics_RORO/Datasheet/stm32373C-eval_sch/MB988_rev_B/MCU.SchDoc
Avionics_RORO/Datasheet/stm32373C-eval_sch/MB988_rev_B/Peripherals.SchDoc
Avionics_RORO/Datasheet/stm32373C-eval_sch/MB988_rev_B/Power.SchDoc
Avionics_RORO/Datasheet/stm32373C-eval_sch/MB988_rev_B/RS232_IrDA.SCHDOC
Avionics_RORO/Datasheet/stm32373C-eval_sch/MB988_rev_B/ST_LINK.SCHDOC
Avionics_RORO/Datasheet/stm32373C-eval_sch/MB988_rev_B/TemSensor&CON.SchDoc
Avionics_RORO/Datasheet/stm32373C-eval_sch/MB988_rev_B/Touch Slider.SchDoc
Avionics_RORO/Datasheet/stm32373C-eval_sch/MB989_rev_B/MB989.PcbDoc
Avionics_RORO/Datasheet/stm32373C-eval_sch/MB989_rev_B/MB989.PrjPCB
Avionics_RORO/Datasheet/stm32373C-eval_sch/MB989_rev_B/MB989.SchDoc
Avionics_RORO/Datasheet/stm32373C-eval_sch/MB989_rev_B/MB989.SCHLIB
Avionics_RORO/Datasheet/stm32373C-eval_sch/NUCLEO-144pins_Altium_Schematics-Layout/Connectors.SchDoc
Avionics_RORO/Datasheet/stm32373C-eval_sch/NUCLEO-144pins_Altium_Schematics-Layout/Ethernet.SchDoc
Avionics_RORO/Datasheet/stm32373C-eval_sch/NUCLEO-144pins_Altium_Schematics-Layout/MB1137.PcbLib
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
