irec-duster/RORO/avionics-firmware/src/pitot.h

#ifndef PITOT_H
#define PITOT_H

extern float pitot_press_hi_res;
extern float pitot_temp_hi_res;
extern float pitot_press_low_res;
extern float pitot_temp_low_res;

void pitot_start(void);

#endif /* PITOT_H */
