irec-duster/RORO/avionics-firmware/src/msgbus/examples/chibios/STM32F302R8-Nucleo/main.c

#include "ch.h"
#include "hal.h"
#include "../../../messagebus.h"
#include "../messagebus_port.h"
#include <string.h>


messagebus_t bus;


int send_command(int command, void *message)
{
    int ret;
    asm volatile("mov r0, %[cmd];"
       "mov r1, %[msg];"
       "bkpt #0xAB;"
       "mov %[ret], r0;"
         : [ret] "=r" (ret)
         : [cmd] "r" (command), [msg] "r" (message)
         : "r0", "r1", "memory");
    return ret;
}

void print(const char *string)
{

    uint32_t m[] = {1/*stdout*/, (uint32_t)string, strlen(string)};
    send_command(0x05, m);
}

static THD_FUNCTION(button_thread, arg)
{

    (void)arg;
    chRegSetThreadName(__FUNCTION__);

    messagebus_topic_t *button_topic;
    button_topic = messagebus_find_topic_blocking(&bus, "/button_pressed");

    while (true) {
        while (palReadPad(GPIOC, GPIOC_BUTTON)) {
            chThdSleepMilliseconds(100);
        }
        messagebus_topic_publish(button_topic, NULL, 0);
        chThdSleepMilliseconds(100);
        while (!palReadPad(GPIOC, GPIOC_BUTTON)) {
            chThdSleepMilliseconds(100);
        }
    }
}

static THD_FUNCTION(led_thread, arg)
{
    (void)arg;
    chRegSetThreadName(__FUNCTION__);
    messagebus_topic_t *button_topic;

    button_topic = messagebus_find_topic_blocking(&bus, "/button_pressed");
    while (true) {
        messagebus_topic_wait(button_topic, NULL, 0);
        palTogglePad(GPIOB, GPIOB_LED_GREEN);
    }
}

static THD_FUNCTION(console_thread, arg)
{
    (void)arg;
    chRegSetThreadName(__FUNCTION__);
    messagebus_topic_t *button_topic;

    print("waiting for topic\n");
    button_topic = messagebus_find_topic_blocking(&bus, "/button_pressed");
    print("done\n");
    while (true) {
        messagebus_topic_wait(button_topic, NULL, 0);
        print("button pressed\r\n");
    }
}

int main(void) {
    halInit();
    chSysInit();
    print("==boot==");

    static messagebus_condvar_wrapper_t bus_condvar;
    messagebus_condvar_wrapper_init(&bus_condvar);
    messagebus_init(&bus, &bus_condvar, &bus_condvar);

    messagebus_topic_t button_topic;

    static messagebus_condvar_wrapper_t button_topic_condvar;
    messagebus_condvar_wrapper_init(&button_topic_condvar);
    messagebus_topic_init(&button_topic,
                          &button_topic_condvar, &button_topic_condvar,
                          NULL, 0);

    messagebus_advertise_topic(&bus, &button_topic, "/button_pressed");

    static THD_WORKING_AREA(button_thread_wa, 128);
    chThdCreateStatic(button_thread_wa, sizeof(button_thread_wa),
                      NORMALPRIO, button_thread, NULL);

    static THD_WORKING_AREA(led_thread_wa, 128);
    chThdCreateStatic(led_thread_wa, sizeof(led_thread_wa),
                      NORMALPRIO, led_thread, NULL);

    static THD_WORKING_AREA(console_thread_wa, 128);
    chThdCreateStatic(console_thread_wa, sizeof(console_thread_wa),
                      NORMALPRIO+1, console_thread, NULL);

    while (true) {
        chThdSleepMilliseconds(500);
    }
}
