irec-duster/RORO/payload/Software/Datalogging/pythonScript3dAnimation/mavlink_read.py

#!/usr/bin/env python
import sys
import os
from optparse import OptionParser
import rotation_integration
import sys
import time
from pymavlink import mavutil
import numpy as np

# tell python where to find mavlink so we can import it
sys.path.append(os.path.join(os.path.dirname(os.path.realpath(__file__)), '../mavlink'))


def handle_heartbeat(msg):
    mode = mavutil.mode_string_v10(msg)
    is_armed = msg.base_mode & mavutil.mavlink.MAV_MODE_FLAG_SAFETY_ARMED
    is_enabled = msg.base_mode & mavutil.mavlink.MAV_MODE_FLAG_GUIDED_ENABLED


def handle_rc_raw(msg):
    channels = (msg.chan1_raw, msg.chan2_raw, msg.chan3_raw, msg.chan4_raw,
                msg.chan5_raw, msg.chan6_raw, msg.chan7_raw, msg.chan8_raw)


def handle_hud(msg):
    hud_data = (msg.airspeed, msg.groundspeed, msg.heading,
                msg.throttle, msg.alt, msg.climb)
    # print "Aspd\tGspd\tHead\tThro\tAlt\tClimb"
    # print "%0.2f\t%0.2f\t%0.2f\t%0.2f\t%0.2f\t%0.2f" % hud_data
    # print "\n"


def handle_attitude(msg):
    attitude_data = (msg.roll, msg.pitch, msg.yaw, msg.rollspeed,
                     msg.pitchspeed, msg.yawspeed)
    # print "Roll\tPit\tYaw\tRSpd\tPSpd\tYSpd"
    # print "%0.2f\t%0.2f\t%0.2f\t%0.2f\t%0.2f\t%0.2f\t" % attitude_data
    # print "\n"


def handle_gyro(msg, rot):
    gyro_data = (msg.xgyro, msg.ygyro, msg.zgyro)

    # print "GyroX\tGyroY\tGyrY\t"
    # print "%0.2f\t%0.2f\t%0.2f\t" % gyro_data
    # print(gyro_data)
    # print time
    # print "\n"
    delta_t = 1/100
    rot.integration_step(np.array(gyro_data), delta_t)
    print('{},{},{},{}'.format(*rot.get_quaternion()))
    # print(delta_t)
    #time.sleep(0.1)
    sys.stdout.flush()


def read_loop(m, rot):
    time = 0
    while(True):
        # grab a mavlink message
        msg = m.recv_match(blocking=True)
        if not msg:
            return
        # handle the message based on its type
        msg_type = msg.get_type()
        if msg_type == "BAD_DATA":
            if mavutil.all_printable(msg.data):
                sys.stdout.write(msg.data)
                sys.stdout.flush()
        elif msg_type == "HIGHRES_IMU":
            handle_gyro(msg, rot)


def main():

    # read command line options
    rot = rotation_integration.Attitude()
    print("Start")
    parser = OptionParser("readdata.py [options]")
    parser.add_option("--baudrate", dest="baudrate", type='int',
                        help="master port baud rate", default=115200)
    parser.add_option("--device", dest="device", default=None, help="serial device")
    parser.add_option("--rate", dest="rate", default=4, type='int', help="requested stream rate")
    parser.add_option("--source-system", dest='SOURCE_SYSTEM', type='int',
                    default=255, help='MAVLink source system for this GCS')
    parser.add_option("--showmessages", dest="showmessages", action='store_true',
                    help="show incoming messages", default=False)
    (opts, args) = parser.parse_args()

    if opts.device is None:
        print("You must specify a serial device")
        sys.exit(1)
    # create a mavlink serial instance
    master = mavutil.mavlink_connection(opts.device, baud=opts.baudrate)
    # wait for the heartbeat msg to find the system ID
    master.wait_heartbeat()
    # request data to be sent at the given rate
    #master.mav.request_data_stream_send(master.target_system, master.target_component,
    #    mavutil.mavlink.MAV_DATA_STREAM_ALL, opts.rate, 1)
    print(master.messages , "\n")
    print("ceva")
    #print "\n"
    # enter the data loop
    read_loop(master, rot)


if __name__ == '__main__':
    main()
