irec-duster/RORO/(commit log)

2017-02-19 add mass budget
    [mass-budget.xlsx]
2017-03-07 Add solidworks files
    [1001_LOWER BODY TUBE.SLDPRT, 1002_COUPLING TUBE.SLDPRT, 1100_PROPULSION.sldasm, 1101_MOTOR.SLDPRT, 1102_THRUSTPLATE.sldprt, 1103_MOTOR RETAINER.SLDPRT, 1104 _MOTOR RETAINER LID.sldprt, 1201_MOTOR TUBE.sldprt]
2017-03-07 test changes
    [GA_RORO_1.SLDASM]
2017-03-07 Mass budget changes and fuel added
    [1100_PROPULSION.sldasm, 1101_MOTOR.SLDPRT, 1105_FUEL.sldprt, GA_RORO_1.SLDASM]
2017-03-10 Add of the nameparts file
    [NameParts.xlsx]
2017-03-10 custom Alu thrust plate
    [1100_PROPULSION.sldasm, 1106_thrust-plate-custom.SLDPRT, GA_RORO_1.SLDASM]
2017-03-12 major changes on the active control files
    [1400_ACTIVE CONTROL.SLDASM, 21000_LOWER BODY.SLDASM, 21001_LOWER BODY TUBE.SLDPRT, 21100_PROPULSION.SLDASM, 21101_MOTOR.SLDPRT, 21103_MOTOR RETAINER.SLDPRT, 21104 _MOTOR RETAINER LID.sldprt, 21106_thrust-plate-custom.SLDPRT]
2017-03-13 redimensionning of the inner parts lenghts
    [1001_LOWER BODY TUBE.SLDPRT, 1002_COUPLING TUBE.SLDPRT, 1400_ACTIVE CONTROL.SLDASM, 21000_LOWER BODY.SLDASM, 21002_COUPLING TUBE.SLDPRT, 21100_PROPULSION.SLDASM, 21101_MOTOR.SLDPRT, 21201_MOTOR TUBE.sldprt]
2017-03-14 airbrake amelioration
    [1400_ACTIVE CONTROL.SLDASM, 21000_LOWER BODY.SLDASM, 21401_BRAKE.SLDPRT, 21402_ACTIVE CONTROL INNER SUPPORT.SLDPRT, 21405_Screw Rod.SLDPRT, 21406_LINEAR SCREW.SLDPRT, 21407_LINEAR BOLT.SLDPRT, Fin assembly_2.SLDASM]
2017-03-17 Major changes on active control, the fin assembly and tubes
    [1400_ACTIVE CONTROL.SLDASM, 21000_LOWER BODY.SLDASM, 21001_LOWER BODY TUBE.SLDPRT, 21001_LOWER BODY TUBE.STEP, 21002_COUPLING TUBE.SLDPRT, 21100_PROPULSION.SLDASM, 21106_thrust-plate-custom.SLDPRT, 21401_BRAKE.SLDPRT]
2017-03-17 minor changes active control
    [1400_ACTIVE CONTROL.SLDASM, 21401_BRAKE.SLDPRT, 21405_Screw Rod.SLDPRT]
2017-03-18 clean up Roro1 assemblies & fix dimensions
    [0000_RORO1.SLDASM, 1000_lower_body.SLDASM, 1001_LOWER BODY TUBE.SLDPRT, 1002_COUPLING TUBE.SLDPRT, 1100_PROPULSION.sldasm, 1101_MOTOR.SLDPRT, 1103_MOTOR RETAINER.SLDPRT, 1104 _MOTOR RETAINER LID.sldprt]
2017-03-20 add logging avions CAD
    [40000_avionics.SLDASM, 40001_mounting_plate.SLDPRT, 40002_tube.SLDPRT, 40003_ins_board.SLDPRT, 40004_pixracer.SLDPRT, 40005_xbee_parallax_adapter.SLDPRT]
2017-03-20 RORO1 CAD correct masses, fin CNC drawing
    [0000_RORO1.SLDASM, 1000_lower_body.SLDASM, 1001_LOWER BODY TUBE.SLDPRT, 1100_PROPULSION.sldasm, 1103_MOTOR RETAINER.SLDPRT, 1104 _MOTOR RETAINER LID.sldprt, 1106_thrust-plate-custom.SLDPRT, 1200_fin.SLDASM]
2017-03-20 Electronics power switch drawing
    [Switch_SCHURTER_33-4504.dxf, Switch_SCHURTER_33-4504.stp]
2017-03-20 Add Recovery bay subassembly
    [2100_RECOVERY_BAY.SLDASM, 2101_Parachute_bay_separation_bulkhead.SLDPRT, 2102_Recovery_mounting_ring.SLDPRT, 2103_Peregrine_Raptor_CO2.SLDPRT, 2104_CO2_Cartrdige_23g.SLDPRT, 2105_AltimaxG3_avionics.SLDPRT, 2106_Raven3_avionics.SLDPRT, 2107_avionics_mounting_plate.SLDPRT]
2017-03-20 Add battery mount and power switch
    [2100_RECOVERY_BAY.SLDASM, 2107_avionics_mounting_plate.SLDPRT, 2108_battery_mounting_plate.SLDPRT, 2110_Switch_SCHURTER_33-4504.sldprt, Switch_SCHURTER_33-4504.dxf, Switch_SCHURTER_33-4504.stp]
2017-03-21 simulation with available motors for roro1 test launch
2017-03-21 Restore RORO2 propulsion asm, place in correct folder
    [21100_PROPULSION.SLDASM]
2017-03-21 form to round fins
    [FinsRoundingThingy.SLDPRT]
2017-03-21 add Recovery battery
    [2100_RECOVERY_BAY.SLDASM, 2108_battery_mounting_plate.SLDPRT, 2109_9V_battery.SLDPRT]
2017-03-22 improvement on the electronics mounting
    [40000_avionics.SLDASM, 40001_mounting_plate.SLDPRT, 40002_tube.SLDPRT, 40003_ins_board.SLDPRT, 40004_pixracer.SLDPRT, 40005_xbee_parallax_adapter.SLDPRT, 40006_battery.SLDPRT, 40007_mounting_plate_big.SLDDRW]
2017-03-22 remove backup files, rebuild avionics
    [40000_avionics.SLDASM]
2017-03-22 Add payload
    [3101_carrierGuide.SLDPRT, 3201_wingShape.SLDDRW, 3201_wingShape.SLDPRT, 3202_BigAirfoil.SLDPRT, 3202_SmallAirfoil.SLDPRT, 3202_WingletsAirfoilBase.SLDPRT, 3202_WingletsAirfoilTip.SLDPRT, Airfoils.SLDDRW]
2017-03-22 modification on the diameter to 98.5 mm
    [40009_bulkhead.SLDPRT]
2017-03-22 Specific bulkhead for small rocket Patriot
    [40009_bulkhead_Sorina_rocket.SLDPRT]
2017-03-22 Patriot down bulkhead modified
    [40009_bulkhead_Sorina_rocket.SLDDRW, 40009_bulkhead_Sorina_rocket.SLDPRT]
2017-03-22 diameter increase drawing and part
    [40009_bulkhead_Sorina_rocket.SLDDRW, 40009_bulkhead_Sorina_rocket.SLDPRT]
2017-03-23 start coupler avionics bulkheads
    [1000_lower_body.SLDASM, 1400_coupler.SLDASM, 1403_coupler_lid.SLDPRT, 1404_gopro_and_avionics_bulkhead.SLDPRT]
2017-03-23 orion bulkheads
    [40010_bulkhead_Orion.SLDDRW, 40010_bulkhead_Orion.SLDPRT, 40011_bulkhead_Orion_up.SLDDRW, 40011_bulkhead_Orion_up.SLDPRT]
2017-03-23 bulkhead orion up increase in diameter
    [40011_bulkhead_Orion_up.SLDDRW, 40011_bulkhead_Orion_up.SLDPRT]
2017-03-23 bulhead down for Miranda rocket
    [40012_bulkhead_Miranda_down.SLDDRW, 40012_bulkhead_Miranda_down.SLDPRT]
2017-03-23 Orion and Miranda bulkheads
    [40012_bulkhead_Miranda_down.SLDDRW, 40012_bulkhead_Miranda_down.SLDPRT, 40012_bulkhead_Orion_nosecone.SLDDRW, 40012_bulkhead_Orion_nosecone.SLDPRT]
2017-03-23 fix orientation of print
2017-03-23 fix fab output orientation
    [40012_bulkhead_Orion_nosecone.SLDDRW]
2017-03-23 fix orion rocket bulkhead
    [40000_avionics.SLDASM, 40010_bulkhead_Orion.SLDPRT, 40012_bulkhead_Orion_nosecone.SLDDRW, 40012_bulkhead_Orion_nosecone.SLDPRT]
2017-03-23 orion rocket adding of another hole
    [40012_bulkhead_Orion_nosecone.SLDPRT, 40013_bulkhead_Orion_down.SLDPRT]
2017-03-23 orion bulkhead down
    [40012_bulkhead_Orion_nosecone.SLDDRW, 40013_bulkhead_Orion_down.SLDDRW, 40013_bulkhead_Orion_down.SLDPRT]
2017-03-23 bullhead up for miranda
    [40012_bulkhead_Miranda_down.SLDPRT, 40012_bulkhead_Miranda_up.SLDDRW, 40012_bulkhead_Miranda_up.SLDPRT, 40013_bulkhead_Orion_down.SLDDRW]
2017-03-23 bulkhead for drilling holes
    [40009_bulkhead_Sorina_rocket.SLDDRW, 40009_bulkhead_Sorina_rocket.SLDPRT]
2017-03-23 gopro bulkheads
    [40009_bulkhead_Sorina_rocket.SLDDRW, 40014_Gopro_mount_bulkhead_down.SLDDRW, 40014_Gopro_mount_bulkhead_down.SLDPRT, 40015_GoproHero4.SLDPRT, 41000_gopro_mounting.SLDASM]
2017-03-23 bulkhead for gopro change of dimensions
    [40014_Gopro_mount_bulkhead_down.SLDDRW, 40014_Gopro_mount_bulkhead_down.SLDPRT, 41000_gopro_mounting.SLDASM]
2017-03-23 rename of gopro parts and improvement on mounting
    [40014_Gopro_mount_bulkhead_down.SLDPRT, 41000_gopro_mounting.SLDASM, 41001_mounting_vertical_wall.SLDPRT, 41002_GoproHero4.SLDPRT, 41003_Gopro_mount_bulkhead_down.SLDPRT, 41003_Gopro_mount_bulkhead_up.SLDPRT]
2017-03-23 Fin alignement
    [1000_lower_body.SLDASM, 1200_fin.SLDASM, 21000_LOWER BODY.SLDASM, GA_RORO2.SLDASM, MAN_FIN_AL.SLDDRW, MAN_FIN_AL.SLDPRT, MAN_FIN_ALIGNEMENT.sldprt]
2017-03-24 orion thrust plate
    [40014_thrust_plate_Orion.SLDDRW, 40014_thrust_plate_Orion.SLDPRT, 40015_thrust_plate_reinforcement_Orion.SLDDRW, 40015_thrust_plate_reinforcement_Orion.SLDPRT]
2017-03-24 orion thrust plate nuts
    [40016_thrust_plate_reinforcement_with_nuts_Orion.SLDDRW, 40016_thrust_plate_reinforcement_with_nuts_Orion.SLDPRT]
2017-03-24 Recovery mounting plates
    [2100_RECOVERY_BAY.SLDASM, 2107_AltimaxG3_mount.SLDPRT, 2107_avionics_mounting_plate.SLDPRT, 2108_Raven3_mount.SLDPRT, 2108_battery_mounting_plate.SLDPRT, 2109_9V_battery.SLDPRT, 2111_Switch_mount.SLDPRT, 2112_lower_mountign_plate.SLDPRT]
2017-03-25 AltimaxG3 mount, increase thickness of all mounts
    [2100_RECOVERY_BAY.SLDASM, 2101_Parachute_bay_separation_bulkhead.SLDPRT, 2107_AltimaxG3_mount.SLDPRT, 2108_Raven3_mount.SLDPRT, 2111_Switch_mount.SLDPRT, 2112_lower_mountign_plate.SLDPRT, 2113_upper_mountign_plate.SLDPRT]
2017-03-25 more compact recovery bay, add bulkhead
    [2100_RECOVERY_BAY.SLDASM, 2101_Recovery_bulkhead.SLDPRT, 2102_Recovery_bulkhead_mount.SLDPRT, 2107_AltimaxG3_mount.SLDPRT, 2108_Raven3_mount.SLDPRT, 2111_Switch_mount.SLDPRT, 2112_lower_mountign_plate.SLDPRT]
2017-03-25 Add Recovery bay to main assembly
    [2000_upper_body.SLDASM, 2100_RECOVERY_BAY.SLDASM, 2101_recovery_placeholder.SLDPRT, 2102_Recovery_bulkhead_mount.SLDPRT]
2017-03-26 retainer dimensions & weight, thrust plate drills for retainer
    [1000_lower_body.SLDASM, 1100_PROPULSION.sldasm, 1103_MOTOR RETAINER.SLDPRT, 1104 _MOTOR RETAINER LID.sldprt, 1107_thrust-plate-custom-with-retainer-holes.SLDPRT, 1200_fin.SLDASM, MAN_FIN_AL.SLDPRT, thrust_plate_retainer_drill_positioning.SLDDRW]
2017-03-26 nut fixation fin forward bulkhead
    [1303_fin_forward_bulkhead_nuts_fixation.SLDDRW, 1303_fin_forward_bulkhead_nuts_fixation.SLDPRT]
2017-03-26 xps try again
    [1303_fin_forward_bulkhead_nuts_fixation.SLDDRW]
2017-03-26 mounting bulkhead cutout
    [2100_RECOVERY_BAY.SLDASM, 2102_Recovery_bulkhead_mount.SLDPRT, 2111_Switch_mount.SLDPRT, 2113_upper_mountign_plate.SLDPRT]
2017-03-26 increase length of recovery bay, only one bulkhead
    [2100_RECOVERY_BAY.SLDASM, 2101_Recovery_bulkhead.SLDPRT, 2107_AltimaxG3_mount.SLDPRT, 2108_Raven3_mount.SLDPRT, 2114_mounting_reinforcement.SLDPRT]
2017-03-26 mounting cutouts
    [2100_RECOVERY_BAY.SLDASM, 2101_Recovery_bulkhead.SLDPRT, 2102_Recovery_bulkhead_mount.SLDPRT, 2107_AltimaxG3_mount.SLDPRT, 2108_Raven3_mount.SLDPRT, 2111_Switch_mount.SLDPRT, 2113_upper_mountign_plate.SLDPRT, 2114_mounting_reinforcement.SLDPRT]
2017-03-26 Recovery Lasercutter files
2017-03-27 Change size of fin front bulkhead (no 1302)
    [1302_CENTERING RING M.DXF, 1302_CENTERING RING M.sldprt]
2017-03-27 fin forward bulkhead assembly, lower body masses
    [0000_RORO1.SLDASM, 1000_lower_body.SLDASM, 1100_PROPULSION.sldasm, 1200_fin.SLDASM, 1202_CENTERING RING.sldprt, 1300_CENTERING FIN.SLDASM, 1303_fin_forward_bulkhead_nuts_fixation.SLDPRT, 2000_upper_body.SLDASM]
2017-03-27 drill holes in lower body bulkhead
    [1402_lower-body-bulkhead.SLDPRT, lower-body-bulkhead-drill-alignment.SLDDRW, lower-body-bulkhead-drill-alignment.SLDPRT]
2017-03-27 push missing lower body bulkhead
    [1402_lower-body-bulkhead.SLDPRT]
2017-03-27 new fin forward bulkhead nut fixation, fix assembly errors
    [0000_RORO1.SLDASM, 1000_lower_body.SLDASM, 1300_CENTERING FIN.SLDASM, 1303_fin_forward_bulkhead_nuts_fixation.SLDDRW, 1303_fin_forward_bulkhead_nuts_fixation.SLDPRT, 1400_coupler.SLDASM]
2017-03-27 1303_fin_forward_bulkhead_nuts_fixation only half side for lasercut
    [0000_RORO1.SLDASM, 1000_lower_body.SLDASM, 1300_CENTERING FIN.SLDASM, 1303_fin_forward_bulkhead_nuts_fixation.SLDDRW, 1303_fin_forward_bulkhead_nuts_fixation.SLDPRT]
2017-03-27 lower body bulkhead fixation
    [1405_lower-body-bulkhead-nut-fixation.SLDDRW, 1405_lower-body-bulkhead-nut-fixation.SLDPRT]
2017-03-27 modification of diameter for the nut
    [1405_lower-body-bulkhead-nut-fixation.SLDDRW, 1405_lower-body-bulkhead-nut-fixation.SLDPRT]
2017-03-27 drawing change
    [1405_lower-body-bulkhead-nut-fixation.SLDDRW]
2017-03-28 signs on the bulkhead for holes added
    [1405_lower-body-bulkhead-nut-fixation.SLDDRW]
2017-03-28 payload modif
    [0000_RORO1.SLDASM, 1000_lower_body.SLDASM, 1300_CENTERING FIN.SLDASM, 2000_upper_body.SLDASM, 2200_payload_dummy.SLDASM, 2201_alu_weight.SLDPRT, 2202_wood_separator_between_alu_weights.SLDPRT, 3000_nose.SLDASM]
2017-03-28 remove of the bulkhead on the electronics bay
    [40000_avionics.SLDASM]
2017-03-28 adding of the adapter in the assembly
    [0000_RORO1.SLDASM, 2000_upper_body.SLDASM, 2200_payload_dummy.SLDASM, 2203_adapter_3holes_to_4holes.SLDDRW, 2203_adapter_3holes_to_4holes.SLDPRT]
2017-03-28 wood marking for drill and part of the launch lug attachment
    [0000_RORO1.SLDASM, 1000_lower_body.SLDASM, 1002_lower_launch_lug_attachment.SLDPRT, 1300_CENTERING FIN.SLDASM, 1302_CENTERING RING M.sldprt, 2000_upper_body.SLDASM, 2200_payload_dummy.SLDASM, 2201_alu_weight.SLDPRT]
2017-03-28 drawing of the mold
    [2204_wood_mold_for_cutting.SLDDRW]
2017-03-28 wood separator xps
    [2202_wood_separator_between_alu_weights.SLDDRW, 2202_wood_separator_between_alu_weights.SLDPRT]
2017-03-28 update recovery mounting holes to M5
    [2100_RECOVERY_BAY.SLDASM, 2101_Recovery_bulkhead.SLDPRT, 2102_Recovery_bulkhead_mount.SLDPRT]
2017-03-28 change recovery bulkhead for milling
    [2100_RECOVERY_BAY.SLDASM, 2101_Recovery_bulkhead.SLDPRT]
2017-03-28 Recovery CNC files
    [2101_Recovery_bulkhead.DXF, 2102_Recovery_bulkhead_mount.DXF]
2017-03-28 increase of battery plate and xps for laser cutting
    [40000_avionics.SLDASM, 40001_mounting_plate.SLDPRT, 40007_mounting_plate_for_screwing.SLDPRT, 40008_mounting_battery.SLDPRT]
2017-03-28 drawing battery holder
    [40008_mounting_battery.SLDDRW]
2017-03-29 gopro mounting
    [1406_gopro_mounting.SLDDRW, 1406_gopro_mounting.SLDPRT]
2017-03-29 gopro mounting increase in diameter
    [1406_gopro_mounting.SLDDRW, 1406_gopro_mounting.SLDPRT]
2017-03-29 increase diam
    [1406_gopro_mounting.SLDDRW, 1406_gopro_mounting.SLDPRT]
2017-03-29 gopro mounting button diam fix
    [1406_gopro_mounting.SLDDRW, 1406_gopro_mounting.SLDPRT]
2017-03-29 Laser cutter parts for alignment
    [lower-body-bulkhead-center hole alignement.SLDDRW, lower-body-bulkhead-launch lug holder alignement.SLDDRW]
2017-03-29 fix of the assembly
    [0000_RORO1.SLDASM, 1000_lower_body.SLDASM, 1300_CENTERING FIN.SLDASM, 1400_coupler.SLDASM]
2017-03-29 xps for the gopro mounting
    [1403_coupler_lid.SLDDRW]
2017-03-29 payload design of the wing
    [3201_wingShape.SLDPRT, 3201_wingShapeFlat.SLDPRT]
2017-03-29 coupler lid and lip
    [1403_coupler_lid.SLDDRW, 1406_coupler_lip.SLDDRW, 1406_coupler_lip.SLDPRT]
2017-03-29 fix length of upper body tube
    [0000_RORO1.SLDASM, 1000_lower_body.SLDASM, 1300_CENTERING FIN.SLDASM, 1400_coupler.SLDASM, 1403_coupler_lid.SLDPRT, 2000_upper_body.SLDASM, 2001_upper-body-tube.SLDPRT]
2017-03-29 coupler tube lid design
    [0000_RORO1.SLDASM, 1000_lower_body.SLDASM, 1400_coupler.SLDASM, 1406_coupler_lid_mount.SLDPRT, 1406_coupler_lip.SLDPRT, 1407_GoPro_case.SLDPRT, 2100_RECOVERY_BAY.SLDASM, 2102_Recovery_bulkhead_mount.SLDPRT]
2017-03-29 coupler tube lid CNC files
    [1403_coupler_lid.DXF, 1406_coupler_lid_mount.DXF]
2017-03-29 final component placement
    [0000_RORO1.SLDASM, 1000_lower_body.SLDASM, 1300_CENTERING FIN.SLDASM, 1400_coupler.SLDASM, 2000_upper_body.SLDASM, 2002_parachutes.SLDPRT, 2100_RECOVERY_BAY.SLDASM]
2017-03-29 launch lugs
    [0000_RORO1.SLDASM, 1000_lower_body.SLDASM, 1002_lower_launch_lug_attachment.SLDPRT, 1003_upper_launch_lug_attachment.SLDPRT, 1400_coupler.SLDASM]
2017-03-30 thrust allignment
    [1108_thrust_plate_inner_alignment.SLDDRW, 1108_thrust_plate_inner_alignment.SLDPRT]
2017-03-30 change of outer diameter to 15.2 cm
    [1108_thrust_plate_inner_alignment.SLDDRW, 1108_thrust_plate_inner_alignment.SLDPRT]
2017-03-30 improvement on gopro mounting for lvl 1
    [41000_gopro_mounting.SLDASM, 41003_Gopro_mount_bulkhead_down.SLDPRT, 41004_Gopro_mount_bulkhead_up.SLDPRT, 41005_Gpro_lateral_wall.SLDPRT, 41006_Gpro_back_wall.SLDPRT, 41007_Gpro_wall_constraint.SLDPRT]
2017-03-30 gopro mounting laser
    [41003_Gopro_mount_bulkhead_down.SLDDRW]
2017-03-30 gopro xps
    [41000_gopro_mounting.SLDASM, 41003_Gopro_mount_bulkhead_down.SLDDRW, 41008_Gpro_top_without_hole.SLDDRW, 41008_Gpro_top_without_hole.SLDPRT]
2017-03-30 xps for thrust plate
    [1108_thrust_plate_inner_alignment.SLDDRW]
2017-03-30 wing design
    [3201_wingShapeFlat.SLDPRT]
2017-03-30 Recovery bulkhead nut alignment
    [2102_Recovery_bulkhead_mount.SLDPRT]
2017-03-30 gopro walls
    [41005_Gpro_lateral_wall.SLDDRW, 41007_Gpro_wall_constraint.SLDDRW]
2017-03-30 orion thrustplate change to M3
    [40014_thrust_plate_Orion.SLDDRW, 40014_thrust_plate_Orion.SLDPRT, 40015_thrust_plate_reinforcement_Orion.SLDDRW, 40015_thrust_plate_reinforcement_Orion.SLDPRT, 40016_thrust_plate_reinforcement_with_nuts_Orion.SLDDRW, 40016_thrust_plate_reinforcement_with_nuts_Orion.SLDPRT]
2017-03-30 bulkhead Patriot for the coupler
    [40017_bulkhead_inside_coupler_Patriot.SLDDRW, 40017_bulkhead_inside_coupler_Patriot.SLDPRT, 41008_Gpro_top_without_hole.SLDPRT]
2017-03-30 change of alignment for the gopro
    [41000_gopro_mounting.SLDASM, 41002_GoproHero4.SLDPRT, 41003_Gopro_mount_bulkhead_down.SLDDRW, 41003_Gopro_mount_bulkhead_down.SLDPRT, 41005_Gpro_lateral_wall.SLDDRW, 41005_Gpro_lateral_wall.SLDPRT, 41007_Gpro_wall_constraint.SLDDRW, 41007_Gpro_wall_constraint.SLDPRT]
2017-03-30 recovery handling holes
    [2100_RECOVERY_BAY.SLDASM, 2101_Recovery_bulkhead.SLDPRT]
2017-03-31 electronics for the lower body
    [1400_coupler.SLDASM, 1404_gopro_and_avionics_bulkhead.SLDPRT, 1408_gopro_and_avionics_bulkhead_with_hexagon_holes.SLDDRW, 1408_gopro_and_avionics_bulkhead_with_hexagon_holes.SLDPRT, 1500_logging_electronics_lower_body.SLDASM, 40018_battery_plate.SLDPRT]
2017-03-31 battery plate
    [40018_battery_plate.SLDDRW, 40018_battery_plate.SLDPRT]
2017-03-31 battery modif hexa
    [40018_battery_plate.SLDDRW, 40018_battery_plate.SLDPRT]
2017-03-31 improvement on avionics bulkhead
    [1400_coupler.SLDASM, 1404_gopro_and_avionics_bulkhead.SLDDRW, 1404_gopro_and_avionics_bulkhead.SLDPRT, 1408_gopro_and_avionics_bulkhead_with_hexagon_holes.SLDDRW, 1408_gopro_and_avionics_bulkhead_with_hexagon_holes.SLDPRT, 1500_logging_electronics_lower_body.SLDASM, 40018_battery_plate.SLDDRW, 40018_battery_plate.SLDPRT]
2017-03-31 gopro and avionics bulkhead
    [1404_gopro_and_avionics_bulkhead.SLDDRW, 1404_gopro_and_avionics_bulkhead.SLDPRT]
2017-04-06 prototype wing
    [mh60.SLDPRT, mh61_center.csv, plane.SLDASM, wing.DXF, wing.SLDPRT, wing_left_small.DWG, wing_left_small.DXF, wing_right_small.DXF]
2017-04-06 fabrication of left wing
    [wing.SLDPRT, wing_left_inside.DXF, wing_left_outside.DXF]
2017-04-06 wing sketch
    [plane.SLDASM, wing.SLDPRT]
2017-04-06 wing root stencil, clean up payload part numbering
    [31001_carrierGuide.SLDPRT, 32000_plane.SLDASM, 32001_wing.SLDPRT, 32002_wing_root_stencil.SLDDRW, 32002_wing_root_stencil.SLDPRT, 3201_wingShape.SLDDRW, 3201_wingShape.SLDPRT, 3201_wingShapeFlat.SLDPRT]
2017-04-06 wing tip stencil
    [32003_wing_tip_stencil.SLDDRW, 32003_wing_tip_stencil.SLDPRT]
2017-04-06 plane assembly
    [32000_plane.SLDASM]
2017-04-06 middle centre
    [32004_center.SLDDRW, 32004_center.SLDPRT]
2017-04-06 adding holes to the centre
    [32004_center.SLDDRW]
2017-04-07 increase wingspan from 200 mm to 360 mm
    [32001_wing.SLDPRT]
2017-04-07 wing control surface right
    [32000_plane.SLDASM, 32001_wing.SLDPRT, 32005_wing_right.SLDPRT]
2017-04-08 ailerons and pieces for 3d print
    [32000_plane.SLDASM, 32005_wing_right.SLDPRT, 32005_wing_right.STL, 32005_wing_right1.STL, 32005_wing_right2.STL, 32005_wing_right3.STL, 32005_wing_right4.STL, 32005_wing_right5.STL]
2017-04-09 Added Altium files for the avionics of RORO
    [0805.stp, 1.0.0_Overall_Rocket_Eletrical.SchDoc, 1.1.0_Interface_board.SchDoc, 1.1.1_Interface_board_MCU.SchDoc, 1.1.2_Interface_board_Power_Supply.SchDoc, 1.1.3_Interface_board_SWD&FLASH&IO.SchDoc, 1.1.4_Interface_board_USB&XBee&RS232.SchDoc, 1.1.5_Interface_board_Servos.SchDoc]
2017-04-11 folding wing
    [32000_plane.SLDASM, 32005_wing_right.SLDPRT, 32007_servomotor.SLDPRT, 32008_aileron_right_wing.SLDPRT, 32009_servomotor_horn.SLDPRT, 32010_control_horn.SLDPRT, 32011_central body.SLDPRT, 32100_right_wing.SLDASM]
2017-04-12 parametrization of wing and pieces for printing
    [32000_plane.SLDASM, 32005_wing_right.SLDPRT, 32011_central body.SLDPRT, 32100_right_wing.SLDASM, Cut-Extrude-Thin1[1].sldprt, root_chord_piece_3dprint.STL, root_chord_piece_3dprint.sldprt]
2017-04-12 for fabrication wing
    [32000_plane.SLDASM, 32005_wing_right.SLDPRT, 32100_right_wing.SLDASM, external_chord.DXF, root_chord.DXF]
2017-04-12 support for wing root
    [32005_wing_right.SLDPRT, root_chord_piece_3dprint.STL, root_chord_piece_3dprint.sldprt]
2017-04-12 external piece
    [32005_wing_right.SLDPRT, 32100_right_wing.SLDASM, Cut-Extrude-Thin7[1].sldprt, external_chord_piece_3dprint.STL, external_chord_piece_3dprint.sldprt]
2017-04-12 leading edge
    [32000_plane.SLDASM, 32001_wing.SLDPRT, 32001_wing_left.SLDPRT, 32005_wing_right.SLDPRT, 32100_right_wing.SLDASM, Cut-Extrude-Thin8[2].sldprt, aileron.SLDPRT, trailing_edge_middle.STL]
2017-04-14 wing assembly
    [32005_wing_right.SLDPRT, 32011_central body.SLDPRT, 32100_right_wing.SLDASM]
2017-04-15 twist of 3 degress on the right wing
    [32005_wing_right.SLDPRT]
2017-04-15 cleaning of the structure for the wing and parametrization in the assembly
    [32000_plane.SLDASM, 32005_wing_right.SLDPRT, 32011_central body.SLDPRT, 32100_right_wing.SLDASM]
2017-04-15 profile data
    [profiles.xlsx]
2017-04-15 components for the plane and integration of the gps sensor
    [32000_plane.SLDASM, 32005_wing_right.SLDPRT, 32100_right_wing.SLDASM, 33001_pixracer.SLDPRT, 33002_xbee_parallax_adapter.SLDPRT, 33003_GPS-50mm.stp, 33003_GPS_50mm.SLDPRT, 33004_pitottube.SLDPRT]
2017-04-15 removed central body right/left option
    [32000_plane.SLDASM, 32011_central body.SLDPRT]
2017-04-15 central body main
    [32011_main_central_body.SLDPRT]
2017-04-15 cleaning of assemblies and stencils
    [32000_plane.SLDASM, 32001_wing_left.SLDPRT, 32002_wing_root_stencil.SLDPRT, 32003_wing_tip_stencil.SLDPRT, 32005_wing_right.SLDPRT, 32011_main_central_body.SLDPRT]
2017-04-15 wing left assembly
    [32000_plane.SLDASM, 32002_wing_root_stencil.SLDPRT, 32003_wing_tip_stencil.SLDPRT, 32005_wing_left.SLDPRT, 32005_wing_right.SLDPRT, 32011_main_central_body.SLDPRT]
2017-04-15 cleaning of name
    [32001_wing_left.SLDPRT, 32002_wing_right.SLDPRT, 32003_main_central_body.SLDPRT, 32004_servomotor.SLDPRT, 32005_servomotor_horn.SLDPRT, 32006_control_horn.SLDPRT, 32007_pixracer.SLDPRT, 32008_xbee_parallax_adapter.SLDPRT]
2017-04-16 hinge construction
    [32000_plane.SLDASM, 32001_wing_left.SLDPRT, 32002_wing_right.SLDPRT, 32003_main_central_body.SLDPRT, 32007_pixracer.SLDPRT, 32011_battery_camera.SLDPRT, 32012_PCB_camera.SLDPRT, 32013_camera.SLDPRT]
2017-04-16 parametrization and carrier adding
    [30000_rocket_assembly.SLDASM, 31000_carrier.SLDPRT, 32000_plane.SLDASM, 32001_wing_left.SLDPRT, 32002_wing_right.SLDPRT, 32003_main_central_body.SLDPRT, 32012_PCB_camera.SLDPRT, 32014_shaft_for_rotation.SLDPRT]
2017-04-17 ball bearing
    [W 619_3-2Z.sldasm, W 619_3-2Z_PART1.sldprt, W 619_3-2Z_PART2.sldprt, W 619_3-2Z_PART3.sldprt]
2017-04-17 hinge refinement
    [32000_plane.SLDASM, 32001_wing_left.SLDPRT, 32002_wing_right.SLDPRT, 32003_main_central_body.SLDPRT, 32004_servomotor.SLDPRT, 32014_shaft_for_rotation.SLDPRT, 32015_battery.SLDPRT, 32100_central_body.SLDASM]
2017-04-17 Report template
    [aiaaenf.cfg]
2017-04-17 removal of fabrication and 3dprinting folders
    [30000_rocket_assembly.SLDASM, 32000_plane.SLDASM, 32002_wing_right.SLDPRT, 32002_wing_root_stencil.SLDDRW, 32002_wing_root_stencil.SLDPRT, 32003_wing_tip_stencil.SLDDRW, 32003_wing_tip_stencil.SLDPRT, 32004_center.SLDDRW]
2017-04-17 for 3d printing
    [32001_wing_left_for3dprint.SLDPRT, 32002_wing_right_for3dprint.SLDPRT, Aileron_left_wing.STL, Aileron_left_wing.sldprt, Aileron_right_wing.STL, Aileron_right_wing.sldprt, left_wing.STL, left_wing.sldprt]
2017-04-20 magnet added and some rocket assembly modif
    [30000_rocket_assembly.SLDASM, 32000_plane.SLDASM, 32001_wing_left.SLDPRT, 32016_magnet.SLDPRT]
2017-04-20 simplified plane for printing
    [Aileron_left_wing.STL, Aileron_left_wing.sldprt, Aileron_right_wing2.STL, Aileron_right_wing2.sldprt, right_wing_inner_part.sldprt, wing_left_inner_part.STL, wing_left_inner_part.sldprt, wing_left_outer_side_with_winglet.SLDPRT]
2017-04-20 plane without folding
    [32400_simplified_plane.SLDASM]
2017-04-20 MH45 profile for root profile
    [profiles.xlsx]
2017-04-20 wings modified
    [32000_plane.SLDASM, 32001_wing_left.SLDPRT, 32002_wing_right.SLDPRT, 32004_servomotor.SLDPRT, 32100_central_body.SLDASM, 32200_Assembly_Left_Wing.SLDASM, 32300_Assembly_Right_Wing.SLDASM]
2017-04-20 change name profile data
    [profiles.xlsx]
2017-04-20 cleaning of profile data and 3d printing folder
    [32001_wing_left_for3dprint.SLDPRT, 32002_wing_right_for3dprint.SLDPRT, Aileron_right_wing.STL, Aileron_right_wing.sldprt, left_wing.STL, left_wing.sldprt, profiles.xlsx, right_wing.STL]
2017-04-21 for 3d printing plane
    [Boss-Extrude2.sldprt, Cut-Extrude3.sldprt, wing_left_outer_side.STL, wing_left_outer_side.sldprt, wing_right_outer_side.SLDPRT, wing_right_outer_side.STL, winglet_left_wing.STL, winglet_right_wing.STL]
2017-04-21 symetric profile for the winglets
2017-04-21 update with the symetric profile for winglets
    [profiles.xlsx]
2017-04-21 update on assemblies after winglet modification
    [30000_rocket_assembly.SLDASM, 32000_plane.SLDASM, 32001_wing_left.SLDPRT, 32002_wing_right.SLDPRT, 32003_main_central_body.SLDPRT, 32014_shaft_for_rotation.SLDPRT, 32100_central_body.SLDASM, 32200_Assembly_Left_Wing.SLDASM]
2017-04-25 mass budget for the glider
    [mass-budget.xlsx]
2017-04-27 hinge prototype
    [hinge_left_wing.STL, hinge_right_wing.STL]
2017-04-27 update on dimensions in assemblies, modification of hinge size
    [30000_rocket_assembly.SLDASM, 32000_plane.SLDASM, 32001_wing_left.SLDPRT, 32002_wing_right.SLDPRT, 32003_main_central_body.SLDPRT, 32008_xbee_parallax_adapter.SLDPRT, 32014_shaft_for_rotation.SLDPRT, 32017_winglet_RW.SLDPRT]
2017-04-27 Added the CAD of the nosecone with the ejection system and right mass for CM (sorry the names are a bit messy)
    [0000_RORO1.SLDASM, 1000_lower_body.SLDASM, 1300_CENTERING FIN.SLDASM, 1400_coupler.SLDASM, 2000_upper_body.SLDASM, 3000_nose.SLDASM, 3001_Nosecone.SLDPRT, 3002_Crown.SLDPRT]
2017-04-27 hinge left/right
    [hinge_left_wing.STL, hinge_right_wing.STL]
2017-04-27 3dprinting for hinge
    [hinge_left_wing.STL, hinge_right_wing.STL]
2017-04-28 Added the support for the pitot tube
    [Support pitot tube.SLDDRW, Support pitot tube.SLDPRT]
2017-04-29 RORO1 adjust masses & CM to measured values
    [0000_RORO1.SLDASM, 1000_lower_body.SLDASM, 1001_LOWER BODY TUBE.SLDPRT, 1002_lower_launch_lug_attachment.SLDPRT, 1003_upper_launch_lug_attachment.SLDPRT, 1100_PROPULSION.sldasm, 1103_MOTOR RETAINER.SLDPRT, 1104 _MOTOR RETAINER LID.sldprt]
2017-04-30 RORO stl for hassan
    [0000_RORO1.STL]
2017-04-30 main central body
    [32003_main_central_body.STL]
2017-04-30 wings left right
    [32001_wing_left.STL, 32002_wing_right.STL]
2017-04-30 RORO1 lower body missing parts
    - logging avionics bulkhead
    - thrust plate centering
    - launch lugs
    [0000_RORO1.SLDASM, 1000_lower_body.SLDASM, 1001_LOWER BODY TUBE.SLDPRT, 1002_lower_launch_lug_attachment.SLDPRT, 1003_upper_launch_lug_attachment.SLDPRT, 1004_launch_lug.SLDPRT, 1100_PROPULSION.sldasm, 1103_MOTOR RETAINER.SLDPRT]
2017-04-30 central body modif holes
    [32003_main_central_body.STL]
2017-04-30 Avionics: test differential pressure sensor
2017-05-02 mass budget update with measured weights
    [mass-budget.xlsx]
2017-05-04 interface with the rocket
    [31001_rail.stp, 31002_slider.stp, 31003_carrier_interface_to_the_rocket.SLDPRT, 31004_tungsten_balas.SLDPRT]
2017-05-04 update on payload
    [mass-budget.xlsx]
2017-05-04 motor & propellant weight
    [1100_PROPULSION.sldasm, 1101_AeroTech_RM98_7680.SLDPRT, 1101_MOTOR.SLDPRT, 1105_AeroTech_M2400T.sldprt, 1105_FUEL.sldprt]
2017-05-04 Update of the gliding system
    [3006_Support_PCB_1.SLDPRT, 3100_Assembly_locking_system.SLDASM, 3101_Guide.SLDDRW, 3103_Rod_small.SLDDRW, 3400_Assembly_rail.SLDASM, 3406_Lower_link.SLDPRT, 3500_Gliding_structure_assembly.SLDASM, 3501_Coupler.SLDPRT]
2017-05-05 adaption of system to real rails
    + several small details
    [3100_Assembly_locking_system.SLDASM, 3400_Assembly_rail.SLDASM, 3401_U_rail.SLDPRT, 3403_Suport_hook.SLDPRT, 3404_Hook.SLDPRT, 3500_Gliding_structure_assembly.SLDASM, 3501_Coupler.SLDPRT, 3503_Support_2.SLDPRT]
2017-05-06 + wood spacer
    [3400_Assembly_rail.SLDASM, 3504_woodplate.SLDPRT, 3550_gliding_structure_assembly.SLDASM, Dim_Ressort_E03600456000S.SLDPRT]
2017-05-06 tube-rail coupler
    [3400_Assembly_rail.SLDASM, 3501_Coupler.SLDPRT, spacer_rail_tube.SLDPRT]
2017-05-07 modifications in the wing design
    [30000_rocket_assembly.SLDASM, 31000_carrier.SLDPRT, 32000_plane.SLDASM, 32001_wing_left.SLDPRT, 32002_wing_right.SLDPRT, 32003_main_central_body.SLDPRT, 32013_camera.SLDPRT, 32014_shaft_for_rotation.SLDPRT]
2017-05-07 rail design
    [30000_payload.SLDASM, 31001_rail_for_glider.SLDPRT, 31002_slider_for_rail.SLDPRT, 31005_servo_HS85MG.STL, 32019_brake.SLDPRT]
2017-05-07 3d print pulley
    [30000_payload.SLDASM, 31000_carrier.SLDPRT, 31001_carrier.SLDPRT, 31001_rail_for_glider.SLDPRT, 31004_tungsten_balas.SLDPRT, 31005_lower_block.SLDPRT, 31005_servo_HS85MG.STL, 31006_pulley.SLDPRT]
2017-05-07 increase pulley ball bearing fit
    [31006_pulley.SLDPRT, 31006_pulley.STL, 31007_rail_for_pulley.SLDPRT]
2017-05-07 2bb pulley
    [31006_pulley_two_bb.SLDPRT, 31006_pulley_two_bb.STL, 31008_side_wall.SLDPRT]
2017-05-07 pulley update bb dimensions
    [31006_pulley_two_bb.SLDPRT, 31006_pulley_two_bb.STL]
2017-05-07 blocking system + chanfreins
    [3400_Assembly_rail.SLDASM, 3401_U_rail.SLDPRT, 3403_Suport_hook.SLDPRT, 3404_Hook.SLDPRT, 3502_Support_1.SLDPRT, 3503_Support_2.SLDPRT, 3550_gliding_structure_assembly.SLDASM, nylon_bumper.SLDPRT]
2017-05-07 plate for spring slider
    [3109_spring_slider_plate.SLDDRW, 3109_spring_slider_plate.SLDPRT]
2017-05-07 3d print spring slider plate
    [31009_spring_slider_plate.SLDDRW, 31009_spring_slider_plate.SLDPRT, 31009_spring_slider_plate.STL, 3109_spring_slider_plate.SLDPRT]
2017-05-07 pulley support
    [31010_pulley_support.SLDPRT, 31010_pulley_support.STL]
2017-05-07 decrease pulley support size
    [31010_pulley_support.SLDPRT, 31010_pulley_support.STL]
2017-05-07 glider rail attachment
    [32020_rail_attachment.SLDPRT, 32020_rail_attachment.STL]
2017-05-07 resolution petits details
    [3400_Assembly_rail.SLDASM, 3401_U_rail.SLDPRT, 3404_Hook.SLDPRT, 3503_Support_2.SLDPRT, 3550_gliding_structure_assembly.SLDASM]
2017-05-07 adaption to real spring
    [3400_Assembly_rail.SLDASM, 3503_Support_2.SLDPRT]
2017-05-07 payload release servo holder
    [30000_payload.SLDASM, 31005_lower_block.SLDPRT, 31011_servo_holder.SLDPRT]
2017-05-08 motor mouting
    [motormounting.STL]
2017-05-08 motor mount
    [33000_motor_mount_assembly.STEP, 33000_motor_mount_assembly.STL]
2017-05-10 modification on simplified plane and ejection system
    [30000_payload.SLDASM, 31004_tungsten_balas.SLDDRW, 31004_tungsten_balas.SLDPRT, 32000_plane.SLDASM, 32001_wing_left.SLDPRT, 32002_wing_right.SLDPRT, 32004_servomotor.SLDPRT, 32015_battery.SLDPRT]
2017-05-10 deleted stp
    [31001_rail.stp, 31002_slider.stp]
2017-05-10 gps final dimensions
    [32009_GPS_50mm.SLDPRT]
2017-05-10 middle intersection
    [30000_payload.SLDASM, 32000_plane.SLDASM, 32001_wing_left.SLDPRT, 32002_wing_right.SLDPRT, 32002_wing_right_internal_structure.SLDPRT, 32003_main_central_body.SLDPRT, 32009_GPS_50mm.SLDPRT, 32100_central_body.SLDASM]
2017-05-10 leading edge wing left
    [32001_wing_left_leading_edge.SLDPRT, 32001_wing_left_leading_edge.STL]
2017-05-10 mate of angle for better fit in the 3dprinting
    [32001_wing_left_leading_edge.STL]
2017-05-10 modification leading edge
    [32001_wing_left_leading_edge2.SLDPRT, 32001_wing_left_leading_edge2.STL]
2017-05-10 new stl reference frame
    [32001_wing_left_leading_edge3.STL, Cut-Extrude10[1].sldprt]
2017-05-10 smaller leading edge
    [32001_wing_left_leading_edge4.STL, Cut-Extrude11.sldprt]
2017-05-10 coefficient functions attached to rocket
2017-05-10 thinner and longer
    [32001_wing_left_leading_edge5.STL, Cut-Extrude10[1].sldprt]
2017-05-10 leading edge improvement
    [32001_wing_left_leading_edge7.STL, Cut-Extrude14[1].sldprt, assembly_leading_edge.SLDASM]
2017-05-10 trailing edge
    [assembly_trailing_edge.SLDASM, assembly_trailing_edge.STL]
2017-05-11 Need to fix initial angle, Include rail and delta mass due to rocket
2017-05-11 thin walls plane
    [0-3mmthickoffsetwing.STL]
2017-05-11 Working on motor burn
2017-05-11 modification of offset
    [0-3mmthickoffsetwing.STL, assembly_trailing_edge.SLDASM]
2017-05-11 modif of offset
    [0-3mmthickoffsetwing.STL, Cut-Loft2.sldprt]
2017-05-11 offset correct plane
    [0-3mmthickoffsetwing2.STL]
2017-05-11 leading and trailing edge
    [Cut-Extrude16[1].sldprt, leading edge.STL, trailing edge.STL]
2017-05-11 motor mounting
    [motor_mounting.STL]
2017-05-11 roro1 fix motor & propellant mass, add trim mass for inertia moments
    [0000_RORO1.SLDASM, 1000_lower_body.SLDASM, 1100_PROPULSION.sldasm, 1101_AeroTech_RM98_7680.SLDPRT, 1105_AeroTech_M2400T.sldprt, 1400_coupler.SLDASM, 1410_trim_weight_coupler.SLDPRT, 2000_upper_body.SLDASM]
2017-05-11 laser cutter
    [deployingsystem.SLDDRW, deployingsystem_for_printing.SLDDRW]
2017-05-13 Its working, gives height. TODO, adjust rail angleinsert damping coefficients
2017-05-15 datalogging and python script for the autopilot data
    [export.csv, log14MayStaticTest_1.csv, log15MayStaticTest_1.csv]
2017-05-15 Integrated aerodynamic damping into Cn_alphaXcp.m Added damoing ratio, velociy and static stability margin to displayed output figures
2017-05-15 simplified plane stl
    [32400_simplified_plane.STL]
2017-05-15 simplified plane with correct origin
    [32400_simplified_plane.STL]
2017-05-16 Added Trim mass to rocket properties. Added output launch rail exit velocity
2017-05-16 centering ring for weight in the lower body
    [1600_centering_ring_for_weight_mounting.SLDPRT]
2017-05-16 xps for laser cutter
    [1600_centering_ring_for_weight_mounting.SLDDRW]
2017-05-16 CAD roro2 design freeze (from Oliver)
    [20000_RORO-II.SLDASM, 21000_LOWER BODY RORO-II.SLDASM, 21000_lower_body.SLDASM, 21001_LOWER BODY TUBE.SLDPRT, 21002_Lower launch lug attachment.SLDPRT, 21002_lower_launch_lug_attachment.SLDPRT, 21003_Upper Launch Lug Attachment.SLDPRT, 21003_upper_launch_lug_attachment.SLDPRT]
2017-05-17 support for the screw
    [31012_spring_support.STL]
2017-05-17 stl for spring mount
    [31013_spring_screw_mount.STL]
2017-05-17 Go Pro mount added
    [0000_RORO1.SLDASM, 1000_lower_body.SLDASM, 1400_ACTIVE CONTROL.SLDASM, 1400_coupler.SLDASM, 1403_coupler_lid.SLDPRT, 2100_RECOVERY_BAY.SLDASM, 2101_Recovery_bulkhead.SLDPRT, 21401_BRAKE.SLDPRT]
2017-05-17 changes on the Gopro Mount
    [1400_coupler.SLDASM, GoPro Mount.SLDASM, GoPro Under Mount_2.SLDPRT, GoPro Upper Mount_2.SLDPRT, lower go pro plate.SLDPRT, upper go pro plate.SLDPRT]
2017-05-17 holes for the square
    [31005_lower_block.SLDDRW]
2017-05-17 fix assembly errors in roro1
    [0000_RORO1.SLDASM, 1000_lower_body.SLDASM, 1403_coupler_lid.SLDPRT, 2100_RECOVERY_BAY.SLDASM, 2101_Recovery_bulkhead.SLDPRT]
2017-05-17 fix inertia of RM98_7680 motor case
    [1101_AeroTech_RM98_7680.SLDPRT]
2017-05-19 centering ring motor
    [1601_centering_ring_for_inside_the_motor_mount.SLDDRW]
2017-05-19 basic code for controlling the servo for attitude control
2017-05-20 roro1 20mai launch masses
    [0000_RORO1.SLDASM, 1000_lower_body.SLDASM, 1001_LOWER BODY TUBE.SLDPRT, 1002_lower_launch_lug_attachment.SLDPRT, 1003_upper_launch_lug_attachment.SLDPRT, 1004_launch_lug.SLDPRT, 1100_PROPULSION.sldasm, 1103_MOTOR RETAINER.SLDPRT]
2017-05-21 Finalized the nosecone assembly
    [3003_Control_panel.SLDPRT, 3006_Support_PCB_1.SLDPRT, 3007_Battery_Cover.SLDPRT, 3007_Support_Battery_1.SLDPRT, 3007_Support_Battery_2.SLDPRT, 3007_Support_PCB_2.SLDPRT, 3007_Support_PCB_3.SLDPRT, 3007_Support_PCB_4.SLDPRT]
2017-05-25 updating motor to K1275 for test launch
2017-05-25 Numerical instability if only motor damping is turned on. Does not work with adaptive time step of ode 45 thus a time step of 0.005s is sepecified. The ploting fuction now uses the raw log data to pl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
2017-05-25 data logging of flight and motion of the plane using quaterionons
    [log.csv, plane.STL]
2017-05-25 mavlink fix with python3
    [mavlink_read.py]
2017-05-29 definitive mass budget for report
    [mass-budget.xlsx]
2017-05-30 20 may launch IMU analysis
2017-05-31 stuff payload
    [1600_centering_ring_for_weight_mounting.SLDPRT, 30000_payload.SLDASM, 30000_rocket_assembly.SLDASM, 31001_carrier.SLDPRT, 31001_rail_for_glider.SLDPRT, 31004_tungsten_balas.SLDPRT, 31005_lower_block.SLDPRT, 31006_pulley_two_bb.SLDPRT]
2017-05-31 wing up down
    [wing_down.STL, wing_up.STL]
2017-05-31 Added corrective moment and damping moment to plotData.m, Changed air temperature to 35C, Added rocket_parameters_increasedFinSize according to Patricks proposal
2017-06-02 wing to print
    [32002_wing_right.STL]
2017-06-02 glider aileron angle & fix assembly errors, ball bearing proto
    [30000_payload.SLDASM, 32000_plane.SLDASM, 32001_wing_left.SLDPRT, 32002_wing_right.SLDPRT, 32100_central_body.SLDASM, 32200_Assembly_Left_Wing.SLDASM, 32300_Assembly_Right_Wing.SLDASM, ball_bearing_block.SLDPRT]
2017-06-03 Monte Carlo simulation added, its still glichy. But we really under shoot the target height withthe current confing
2017-06-06 cleaning ofthe stl parser and adding of plot
2017-06-06 ground station class
2017-06-06 fix the stupid and useless opengl shitty thing
    [3dgraph.py]
2017-06-07 solve issue with signal/emit for threading
    [3dgraph.py, stl_parser.py]
2017-06-08 dont track python cache
2017-06-08 ball bearing prototype
    [32000_plane.SLDASM, 32002_wing_right.SLDPRT, 32300_Assembly_Right_Wing.SLDASM, ball_bearing_block.SLDPRT, ball_bearing_block.STL, ball_bearing_spacer_tube.SLDPRT, ball_bearing_spacer_tube.STL]
2017-06-08 hinge added to the wing, assembly improvement
    [30000_payload.SLDASM, 31001_carrier.SLDPRT, 31008_side_wall.SLDPRT, 32000_plane.SLDASM, 32001_wing_left.SLDPRT, 32002_wing_right.SLDPRT, 32003_main_central_body.SLDPRT, 32100_central_body.SLDASM]
2017-06-08 modif on the hinge
    [32000_plane.SLDASM, 32001_wing_left.SLDPRT, 32002_wing_right.SLDPRT, 32200_Assembly_Left_Wing.SLDASM, 32300_Assembly_Right_Wing.SLDASM]
2017-06-08 ball bearing & gps integration
    [32000_plane.SLDASM, 32001_wing_left.SLDPRT, 32002_wing_right.SLDPRT, 32200_Assembly_Left_Wing.SLDASM, 32300_Assembly_Right_Wing.SLDASM]
2017-06-08 3d print wing
    [32002_wing_right.STL]
2017-06-09 Modified the file and added STEP file to be printed with 3qd printer.
    [2100_RECOVERY_BAY.SLDASM, 2100_RECOVERY_BAY.STEP, 2101_Recovery_bulkhead.SLDPRT, 2107_AltimaxG3_mount.SLDPRT, 2108_Raven3_mount.SLDPRT, 2113_upper_mountign_plate.SLDPRT, 2114_mounting_reinforcement.SLDPRT]
2017-06-09 small modification of plate
    [2100_RECOVERY_BAY.SLDASM, 2100_RECOVERY_BAY.STEP, 2113_upper_mountign_plate.SLDPRT]
2017-06-09 small modification of plate to correct error
    [2100_RECOVERY_BAY.SLDASM, 2100_RECOVERY_BAY.STEP, 2113_upper_mountign_plate.SLDPRT]
2017-06-09 small modification of plate to correct error with champfer
    [2100_RECOVERY_BAY.SLDASM, 2100_RECOVERY_BAY.STEP, 2108_Raven3_mount.SLDPRT, 2113_upper_mountign_plate.SLDPRT]
2017-06-09 right wing gps placement
    [32002_wing_right.SLDPRT]
2017-06-10 right wing xbee integration
    [32002_wing_right.SLDPRT]
2017-06-10 update CAD & simulation with new fins & masses
    [0000_RORO1.SLDASM, 0000_RORO1_simple.STL, 1000_lower_body.SLDASM, 1005_downward_camera_holder.SLDPRT, 1100_PROPULSION.sldasm, 1200_fin.SLDASM, 1204_FIN.SLDPRT, 1205_fin_core.SLDPRT]
2017-06-11 servo holder
    [31011_servo_holder.STL]
2017-06-11 with cutout
    [31011_servo_holder.STL]
2017-06-11 added hole for M8 in center of upper plate and did holes for cable from 5 to 7 mm diam and did 20mm wide square hole insted of 15mm in reinforcement plate
    [2100_RECOVERY_BAY.SLDASM, 2107_AltimaxG3_mount.SLDPRT, 2108_Raven3_mount.SLDPRT, 2113_upper_mountign_plate.SLDPRT, 2114_mounting_reinforcement.SLDPRT]
2017-06-11 Changed size of holes for diode
    [2100_RECOVERY_BAY.SLDASM, 2101_Recovery_bulkhead.SLDPRT, 2113_upper_mountign_plate.SLDPRT]
2017-06-11 Changed upper plate to allow the M8 long screw to go threw upper plate
    [2100_RECOVERY_BAY.SLDASM, 2107_AltimaxG3_mount.SLDPRT, 2113_upper_mountign_plate.SLDPRT]
2017-06-12 right wing adjustments
    [32002_wing_right.SLDPRT]
2017-06-12 Added dxf and drawing of bulkhead
    [2100_RECOVERY_BAY.SLDASM, 2100_RECOVERY_BAY.STEP, 2101_Recovery_bulkhead.SLDDRW, 2101_Recovery_bulkhead_v2.DXF]
2017-06-12 weight payload lower wood plate lasercut
2017-06-12 remove template aound lasercut shape
    [1602_lower_wood_plate.SLDDRW]
2017-06-12 add a step file for recovery bay
    [2100_RECOVERY_BAY.STEP, 2101_Recovery_bulkhead.SLDDRW]
2017-06-13 finalize right wing
    [32002_wing_right.SLDPRT]
2017-06-13 conflight repaired and weight added
    [32002_wing_right.SLDPRT]
2017-06-13 servo weight overwrite
    [32004_servomotor.SLDPRT]
2017-06-13 weight override
    [32009_GPS_50mm.SLDPRT]
2017-06-13 right wing finalized and mass added
    [31005_lower_block.SLDPRT, 31009_spring_slider_plate.SLDPRT, 31011_servo_holder.SLDPRT, 31013_spring_screw_mount.SLDPRT, 31014_string_mount.SLDPRT, 32000_plane.SLDASM, 32001_wing_left.SLDPRT, 32002_wing_right.SLDPRT]
2017-06-13 right wing stl files
    [32002_wing_right_aileron.STL, 32002_wing_right_gps_lid.STL, 32002_wing_right_hinge.STL, 32002_wing_right_inner_leading.STL, 32002_wing_right_inner_trailing.STL, 32002_wing_right_outer_leading.STL, 32002_wing_right_outer_trailing.STL, 32002_wing_right_xbee_lid.STL]
2017-06-14 left wing
    [32001_wing_left_magic_happens_aileron.SLDPRT, 32001_wing_left_magic_happens_aileron.STL, Part10.SLDPRT, aileron.STL, aileron.sldprt, outer_leading.STL, outer_leading.sldprt, outer_trailing.STL]
2017-06-15 left wings
    [32001_wing_left.SLDPRT, 32001_wing_left_magic_happens.SLDPRT]
2017-06-15 mirrored recovery bulkhead
    [2101_Recovery_bulkhead_v2_mirrored.DXF]
2017-06-15 USB serial not working
    [main.c, usbcfg.c]
2017-06-15 debug uart shell
2017-06-15 select upper gps antenna per default
2017-06-16 payload and winglet
    [32003_main_central_body.SLDDRW, 32003_main_central_body.STL, Cut-Extrude13.sldprt, winglet_left_wing.SLDDRW]
2017-06-16 winglet right
    [Cut-Extrude1.sldprt, winglet_right_wing.SLDDRW]
2017-06-16 yagi connection
    [YAGI-connection.SLDPRT]
2017-06-16 adjust size
    [YAGI-connection.SLDDRW, YAGI-connection.SLDPRT]
2017-06-17 fix USB input, activate shell over USB
    [board.h, main.c]
2017-06-18 servo default locked, atomic pulse generation
2017-06-18 start with imu driver
2017-06-18 IMU quaternion readout test
2017-06-20 print quaternions over xbee
2017-06-20 divide subsystem into threads
2017-06-20 xbee thread
2017-06-20 threads debugging command
2017-06-22 imu publish raw data
2017-06-22 glider servo
2017-06-22 glider servo testing
2017-06-22 GNSS antenna switch
2017-06-22 increase IMU update frequency
2017-06-22 increase imu read frequency for deployment
2017-06-23 trim payload servo points
2017-07-04 competition flight analysis & update final masses
    [0000_RORO1.SLDASM, 1000_lower_body.SLDASM, 1100_PROPULSION.sldasm, 1101_AeroTech_RM98_7680.SLDPRT, 1105_AeroTech_M2100G.sldprt, 1105_AeroTech_M2400T.sldprt, 1407_GoPro_case.SLDPRT, 1506_payload_1U_weight.SLDPRT]
2017-07-04 croped imu flight data
    [ms5611_crop.csv]
